xiaweiyi0423/me5412-bedexit-proposal/presentation/video/panels/R6.jpg

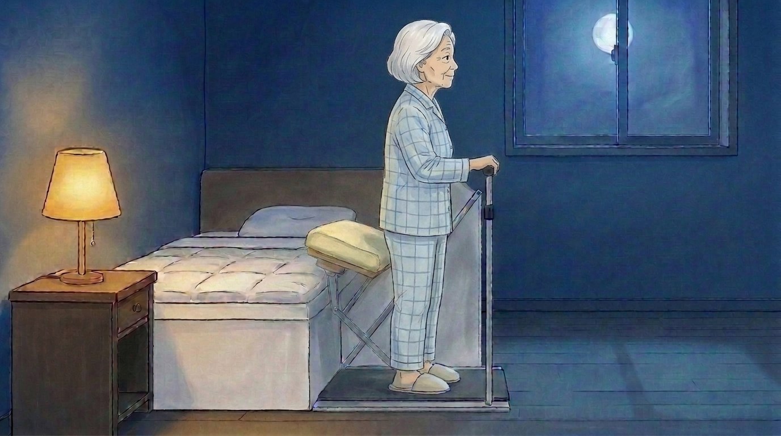
presentation/video/panels/R6.jpg
