xiaweiyi0423/me5412-bedexit-proposal/presentation/video/panels/S9a.jpg

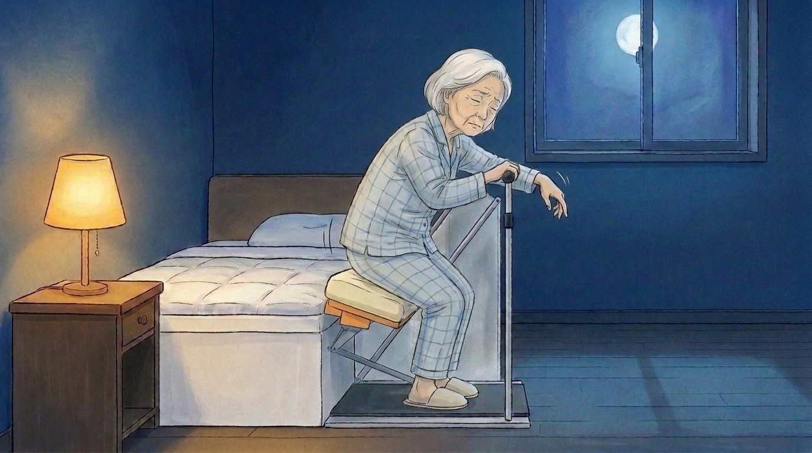
presentation/video/panels/S9a.jpg
