xiaweiyi0423/me5412-bedexit-proposal/README.md

# ME5412 Robotics for Healthcare：夜间床边起身辅助（小组 proposal）

问题：住在家里、还能独立生活但腿部力量下降的老人，夜里从床沿坐→站→站稳→第一步这一段容易出事。

目标用户：从普通高度的床（约 0.42 m）站起来困难或不安全，但从更高的座面、手有扶的地方能站起来；能独立行走或借助助行器行走；能独立坐在床沿、握住扶手、操作按住式开关。不适用于需要完全协助转移的人和中重度认知障碍的人。设计工况：60 kg、1.60 m。

两个候选方案：

- **方案甲 · 动态扶手**：装在床上，平时当床栏；坐到床沿后轻推，扶手转到工作角度，承重时锁死。只作为对照。
- **方案乙 · 床边起身台（已定）**：床不改造，台架和床固定（床垫下钩板或床腿夹）。老人坐在床沿、脚踩台架踏板，往前挪到与床齐平的短座板上；握紧横杆握把上的“起”开关后，座板**竖直**升到 0.66 m，L 形扶手随座板升高。
  - 速度跟着人走：速度 = k ×（推力上限 − 座板测到的力），封顶为个人最快速度。推力上限约为体重的一半，人要自己承担一部分体重。
  - 松手或出现任何故障，立即停住并制动；只有确认有人坐着才下降；离座后座板停在原高度、保持水平，万一坐回去能接住人。
  - 座板、踏板下各 4 个测力单元（压力中心），横杆测力；各传感器的竖直力之和与体重对不上就锁住。

核心模型结论（2D 准静态坐→站线性规划，effort = 最吃力关节用掉的力量比例；范围覆盖四种手臂假设和两种脚下空间假设）：

| 情形 | 结果 |
|---|---|
| 起身台升到 0.66 m vs 抬高床（0.58 m）+ 扶手 | 低 13–20% |
| 起身台升到 0.66 m vs 低床（0.42 m）撑床垫 | 低 26–40% |
| 不用手：0.66 m vs 0.58 m | 低 16–22% |
| 起身台只升到 0.60 m vs 抬高床 | 差不多（−5% 到 +4%） |

“脚下空间”指脚跟至少在髋前多远：`compare_v11` 对起身台用 8 cm、对床用 10 cm（17–20%）；`heel_sensitivity_v12` 把起身台也改成 10 cm（13–16%）。

所以起身台存在的理由是：只在起身那一刻，升到固定床设不到的高度。

## 第 12 版设计改动（2026-10-26）

- 取消座板前倾，改为竖直升降。一个推杆驱动的四连杆只有一个自由度，倾角由高度决定，做不到“离座后停在高处、座板水平”；而模型本来就没有计入前倾的好处，数字不变。
- 台架和床固定。不固定时，前后方向只能承受约 178 N（设计载荷 177 N，安全系数 1.0），扶手高位侧向约 129 N。人完全在台架上（坐在座板上、脚踩踏板）时，手上的力是内力；人的重心横向要偏出约 0.5 m 才会侧翻，而座板半宽只有约 0.22 m。载荷工况按安全系数 1.5 校核。
- 控制规则改为：松手即停、有人坐着才降，速度随座板卸载自适应，握把式开关（至少一只手）。
- 报告中的降幅写成范围（见上表）。

## 第 13 版（2026-10-26，按六角度审计修订）

审计报告在 `presentation/audit/`。这一版对方案的改动：

- **起步计算**（`model/calc_v13/seat_support.py`）：起身模型加入座板向上托人的力。推力上限 0.5 倍体重时，在 0.42 m 起步的 effort 为 0.155–0.166，低于在 0.66 m 离座的 0.233–0.251；上限 0.3 时起步反而更吃力，所以可设范围收窄到 0.4–0.6。座板托力为 0 时逐个高度复现 v12 结果。
- **目标人群按能力定义**：离座高度由用户能力决定（effort 0.25 的人约在 0.62–0.64 m 离座）；抬高床站不起来、起身台能站起来的人，effort 约 0.23–0.29（另一种手臂假设为 0.25–0.30）。
- **控制器 v13**（`model/calc_v13/controller_v13.py`）：力之和自检只在离开床面后的运动中做；取消空载复位，座板空着时留在原高度，回床时坐上去按“降”；坐在高处无操作 20 s 下降（17 s 提示音）；两柱高差 > 5 mm 锁定；最快速度 1.5–3 cm/s；“人已离开”改为座板 < 5% 体重且脚离开踏板。12 个场景，其中压床垫、迈下踏板两个场景在 v12 规则下误锁。
- **固定方式**：按 1112 N 设计，床架夹为主，床垫下钩板只定位。
- **13.1（Gemini 审计 v13 后，`page/v13/audit/`）**：起步省力的前提是上身基本坐直（前倾 ≥ 20° 时起步 effort 0.23–0.27，和离座差不多）；留出速度余量后推力上限改为 0.5–0.6；回床改为先按住“降”把空座板降到回床高度（默认床面）再坐；横杆按带正负号的竖直分力计入自检；“有人坐着”加迟滞（0.40 / 0.15 倍体重）；带人下降按住才动；两柱不同步时锁死；立柱移到 L 形扶手转角，开口一侧敞开。仿真 15 个场景。
- 方案网页 v13：`page/rise_station_v13.html`（新链接发布，由 `page/v13/build.py` 从 `page/v13/template.html` 生成）。

## 目录

```
page/
  bedexit_proposal.html   最终网页（单文件，直接用浏览器打开）
  build_v12.py            先运行 build_v11.py，再按第 12 版设计修改输出 → bedexit_proposal.html
  build_v11.py            读 v10_body.html + 模型数据 → bedexit_proposal.html、v11_body.html
  build_v10.py            上一版构建脚本（build_v11 会读取其中的 CSS 片段；它本身依赖 archive/v9_body.html）
  v10_body.html           build_v11 的输入
  v2_template.html, v3_extra.css   页面头部和样式
  archive/                更早的构建脚本、中间版本和截图脚本
model/
  model.py                坐→站准静态模型（scipy HiGHS 线性规划）
  compare_v11.py          低床 / 抬高床 / 方案甲 / 方案乙，四种手臂假设，按图纸几何 → compare_v11.json
  heel_sensitivity_v12.py 起身台也按床的脚下空间（脚跟在髋前 10 cm）重算 → heel_sensitivity_v12.json
  seat_height_v11.py      座高 0.40–0.70 m 扫描（横杆按设计位置）+ 敏感性 → seat_height_v11.json
  export_explorer_v10.py  方案甲扶手位置热力图数据 → explorer_v10.json
  tipping_v11.py          台架不固定时的倾翻：设计载荷 177 N → tipping_v11.json
  calc_v12/               第 12 版设计的计算起点（英文图，可直接放进 slides）
    lift_sizing.py        座板下空间、几种机构（剪叉水平推 / 剪叉斜推 / 单节推杆 / 双三节升降柱）的推杆力和行程
    stability.py          人完全在台架上时各姿态的合重心；人部分离开时拉扶手的承载力和固定件压紧力
    controller_sim.py     状态机 + 速度规则 v = k(F_cap − F_seat)，8 个场景仿真；用 graphviz 自动画状态图
  compare_v10.py, seat_height_v10.py, tipping_v10.py   上一版（扶手位置自由优化）
  archive/                更早的脚本和结果（含已弃用的“手上最多 10% 体重”假设）
docs/
  prior-art-bed-exit-assist.md   现有技术和文献检索
plan/
  plan.html               组内分工页（单文件，直接用浏览器打开）：每个角色要说明什么、建议做法、资料、示意图
  figs.py                 生成分工页里的示意图（侧视图、受力图、执行器、倾翻）→ figs.json；图已嵌入 plan.html
```

注意：`compare_v11.json` 里的键 `none57` 实际是 0.58 m 的床（`int(0.58*100)` 等于 57）。

## 复现

```bash
pip install numpy scipy
cd model
python compare_v11.py         # 约 2 分钟，多进程
python heel_sensitivity_v12.py
python seat_height_v11.py
python export_explorer_v10.py
python tipping_v11.py
cd calc_v12 && python lift_sizing.py && python stability.py && python controller_sim.py && cd ..
cd ../page
python build_v12.py           # 生成 bedexit_proposal.html
```

## 模型的主要假设与局限

- 2D 侧视、准静态，只分析离座那一瞬间；受试者模型为 60 kg、1.60 m，关节力量是假设值。
- “手臂弱”用四种方式表示：手力上限 25% 体重（以 Schultz/Alexander 1992 的实测为锚）、肩肘力量只剩 50%、只剩 35%、手臂正常（手力上限 30% 体重）。
- 床垫按刚性计算，对两种床的基线有利。
- 结果对脚下空间的假设敏感（见上表）。
- 没有包括起身的动态过程、往前挪 25–30 cm 的代价，以及阈值的实测校准；这些列入局限与后续工作。本项目只做概念、设计和仿真，不做实物和实验。

截至 2026-10-26。
