xiaweiyi0423/me5412-bedexit-proposal/presentation/audit/audit_report.md

# 汇报 slides 和讲稿审计报告（Gemini 4 六角度 + Claude 复核）

审计对象：`presentation/slides/*.html`（21 页 slides 和讲稿备注）、`presentation/tools/talk_guide.html`（讲稿指南）。日期 2026-10-26，10/27 见老师之前。

## 结论

1. 整体结构、叙事和数字出处都扎实：六个角度都认为主线清楚；脚本核对的 20 多个数字和模型输出一致（见 `consistency_check.md`）。
2. 最大的问题不在“没做完”，而在**各角色的拼接处**：控制规则、传感自检、起身模型和使用流程各自成立，放在一起有几处互相矛盾。最严重的两处会被懂行的人直接问住：
   - **“力之和对不上就锁住”在正常使用中会误触发。** 座板只有 14 cm 深，人刚坐上时大腿压在床垫上；站起后一只脚还在踏板上时，力之和也只有约半个体重。按代码，这两种情况都会锁住。
   - **“0.66 m 才是价值所在”这条论证缺了一环。** 速度规则要求人先把座板力降到 0.5 倍体重以下座板才会升，这一步在 0.42 m 有多吃力没有算过；而仿真里的正常用户在 0.61 m 就离座了，第 7 页又说 0.60 m 和抬高床差不多。
3. 使用流程只讲了“起床”这一半：**站起后怎么走出台架、助行器放哪、回来怎么上床**都没讲，第 13 页的文字和状态机图在这里还互相矛盾。
4. 老师邮件里点名要的 **CAD 模型和运动动画**还没有，而讲稿指南的“时间紧版本”把第 9 页运动演示删掉了。

## 怎么读这份报告

- 每条问题标了来源角度（A–F，见文末）和**核实结果**：
  - **已核实**：回到 slides 原文、代码或模型输出确认成立。
  - **部分成立**：问题存在，但 Gemini 的说法有夸大或细节错误，已注明。
  - **未核实**：合理，但需要组里判断或查资料。
- Gemini 的原始输出在 `gemini_<角度>.md`，被驳回的意见见文末。

---

## 一、10/27 见老师前（明天）值得做的事

这些不需要改计算，只需要改几句话或准备回答。

| # | 做什么 | 为什么 |
|---|---|---|
| 1 | 第 13 页“有人坐着才降”卡片：删掉“座板上没人时不动”，改成“人离开台架 5 s 后空载慢慢降回床面；途中有人踩上就停”。 | 现在的文字和同页状态机图（`STANDING_HOLD → RESET_EMPTY`）直接矛盾。**已核实**（E3、B4、D、F3）。 |
| 2 | 第 21 页加一问：“回床和走出台架的流程，需要在主 slides 里讲吗？” | 这是六个角度里被提到最多的空白（见二-4、二-5）。先问老师要不要讲、讲到什么程度，免得在 11/3 前被追问。 |
| 3 | 第 21 页第 4 问拆开，先问**正式展示时长**。 | 19 页、约 16 分钟只是组里自定的目标；5 人交接和动画播放还要 1–2 分钟（E6）。时长决定后面删哪些页。 |
| 4 | 第 21 页的问法从“够不够？”改成“我们计划这周补 X 和 Y，作为终稿是否符合您的预期？” | 开放式的“够不够”容易让老师顺口加活，最后一周加活风险大（E7）。属于建议，**未核实**。 |
| 5 | 准备“t = 0 握紧开关时座板怎么开始动”的回答（见二-2）。 | Gemini 扮演老师时把它列为最想问的 3 个问题之一（D）。 |

---

## 二、11/3 前最该改的 10 项（按严重度）

### 1. 【高】“各力之和与体重对不上就锁住”会在正常使用中误锁 — 已核实

- **来源**：A5、B2、C4、D3、F1（五个角度都提到），加代码核实。
- **机制**：`controller_sim.py` 里，只要座板上有人或踏板受力超过 0.3 倍体重，就检查“座板 + 踏板 + 横杆”的竖直力之和，偏离体重超过 15% 就进入 LOCKED。实际使用中至少有两个时刻这个和必然对不上：
  - 刚坐上时：座板只有 14 cm 深（`lift_sizing.py` 的 `SEAT_DEPTH = 0.14`），大腿和部分臀部还压在床垫上，这部分重量不经过任何传感器。
  - 站起后迈步时：一只脚已经踩在地上、一只脚还在踏板上，踏板受力约半个体重，仍超过 0.3 的门槛，检查继续生效，和只有约 0.5 倍体重。
- **为什么仿真没暴露**：仿真里 `F_feet = BW − F_seat − F_bar`，即假设体重全部落在台架上。
- **怎么改**：自检只在“座板已离开床面、人完全在台架上”的抬升阶段做；或者和“坐定时的基线”比较而不是和体重比较；加持续时间过滤，避开坐回时的冲击峰值。第 12、13 页的说法同步修改。

### 2. 【高】核心论证缺一环：起步要先卸掉多少体重、多吃力，没有算 — 部分成立

- **来源**：A1、B1、D2、F6，加一致性检查第 1 条。
- **机制**：速度规则 v = k ×（推力上限 − 座板力）意味着，只有座板力降到推力上限（0.5 倍体重）以下，座板才会升；如果 2 s 内降不下来，状态机停住（代码里的 `stall_t`）。仿真假设人坐着时座板承担约 0.8 倍体重（`controller_sim.py` 的 `s0 = 0.79`），按这个假设，人必须先在 0.42 m 把约 0.3 倍体重转到脚和手上。第 7 页的 effort 只算了“完全离座那一刻”，没算这一步。
- **它和 0.61 m 的问题连在一起**：同一条规则让人能站起时座板就停住，所以座板升多高取决于人在哪里能离座。仿真里的正常用户在 0.61 m 就离座了（`controller_sim.json`），而第 7 页说 0.60 m 的省力和抬高床差不多。仿真的用户模型是假设的，不能证明真实用户在 0.61 m 离座，但这两页放在一起，提问者一眼就能连起来。
- **Gemini 说过头的地方**：B 和 D 称之为“启动死锁”，B 还说“能卸掉一半体重就不需要这台机器”。这不对：坐着把一部分重量移到脚上，比完全离座容易得多（0.42 m 完全离座的 effort 是 0.39）。真正的问题是**没算过**，不是**一定不行**。
- **怎么改**：
  1. 用现有 2D 起身模型加一个约束“座板最多承担 0.5 倍体重”，算 0.42 m 到 0.66 m 各高度下的 effort。这是成本最低、信息量最大的一步：如果整段都不高于 0.23，论证就闭环了；如果起步段更吃力，就要改推力上限的设定（例如起步段允许更高）。
  2. 第 7 页或第 18 页把 13–20% 说成“升到 0.66 m 时”的收益，并说明实际收益取决于离座高度。
  3. 讲稿指南补上“t = 0 时座板怎么开始动”的回答。

### 3. 【高】只讲了起床，没讲回床 — 已核实

- **来源**：B4、C2、D（最想问的问题 1）、E3、F3。
- **事实**：第 6 页“一次完整的使用”在“站稳”就结束。状态机里人离开台架 5 s 后座板空载降回床面（`RESET_EMPTY`）。从洗手间回来时，人面对的是一块 0.42 m 高、14 cm 深的窄座板和一个 0.66 × 0.80 m 的台架。是绕开台架上床，还是坐上座板再往后挪回床上，slides 里没有交代。
- **怎么改**：第 6 页加第 6 步“回床”，或在讲稿指南里准备回答。C 角度提了一个值得考虑的方案：人离开时座板留在高位，回来时坐上高座板（省膝盖的力），再按“降”回到床面。但这和“空载复位”以及夜里走动时的绊倒风险有取舍，需要组里决定。**未核实**哪种更好。

### 4. 【高】站起后怎么走出台架、助行器放哪 — 已核实

- **来源**：C1、E2，加 `stability_top.png` 俯视图核实。
- **事实**：俯视图里 L 形扶手沿一侧（y = −0.28 m）和身前（x ≈ 0.69 m，从 y = −0.28 延伸到 +0.13 m）布置。人站在中间时，正前方被横杆挡住，只能往开口一侧斜着或横着走出去，还要跨下踏板。第 4 页把“借助助行器行走”列为目标用户，但哪里放助行器、怎么从扶手换到助行器，没有讲。
- **说过头的地方**：C 说“三面封闭的笼子”。实际上开口一侧和前方开口一角都是敞开的，但动线确实别扭。
- **怎么改**：画一张俯视动线图（站起 → 从开口侧走出 → 助行器位置）。如果要改设计，可以考虑横杆可旋开，或开口侧加长。偏瘫用户的健侧在哪边、扶手能否左右对调安装（F4④），也可以在同一张图里交代。

### 5. 【高】CAD 模型和运动动画缺失；“时间紧版本”删了第 9 页 — 已核实

- **来源**：D1、E2。
- **事实**：老师邮件第 4 条要求“展示 CAD 模型和运动动画”。现在所有配图都是 2D 侧视示意图，第 9 页是待补。`build_guide2.py` 里的 `SHORT` 列表不含 `motion`，也就是时间紧时第 9 页被删掉。
- **为什么重要**：这是老师唯一点名要“展示”的东西；而且没有 CAD，角色 4 的真实质量复核和 FEA 都没法做。
- **怎么改**：把第 9 页加回时间紧版本；时间紧时可以把第 6 页和第 9 页合成一页（用 CAD 动画讲五步）。封面或第 6 页放一张 3D 轴测图，让听众一开始就知道它长什么样（E2）。

### 6. 【中】固定方式口径不一：床垫下钩板，还是 2 kN 的床腿夹 — 已核实

- **来源**：B6、D4、F4②。
- **事实**：第 6 页写“床垫下的钩板或床腿夹”；第 11 页正文说压紧力 90–180 N 就到安全系数 1.5，同页小字又说按 ADA 扶手标准 1112 N 设计时固定件要约 2 kN、需要床腿夹。两个设计载荷都出现了，但没说按哪个设计。
- **怎么改**：在第 11 页写明设计载荷选哪个、为什么，并据此定固定方式。如果按 ADA 的 1112 N，钩板就不够（靠床垫自重压住的钩板能提供的力远小于 2 kN，这一点是推断，未计算）。

### 7. 【中】图里的字太小，第 10 页“每根”和“两根合计”对不上 — 已核实

- **来源**：E1、E5、D5，截图核实。
- **事实**：第 13 页状态机图的转移条件、第 14 页 8 个小图的坐标轴，在 1920×1080 截图里只有十来个像素高，投影后后排看不清。讲稿指南只标了第 10、14 页要重画，漏了第 11、13 页。第 10 页文字说“每根推约 0.23 kN”，图里绿线画的是两根合计（约 0.45 kN），图例小字写着 `total of both`。
- **怎么改**：第 13 页重画成只含核心状态的大字版，完整转移表放附录；第 14 页主 slide 只放 2–3 个典型场景，8 个放附录；第 10 页图改成单根力，或在讲稿里说明。

### 8. 【中】第 7 页的图和讲稿对不上 — 已核实

- **来源**：E4、A3、F2。
- **事实**：标题写“四种起身方式”，图里有 5 根柱子；第 5 根“起身台，脚下空间按床算 0.24”讲稿没提。“动态扶手（组里最初的方案）”在第 7 页之前从没介绍过。
- **深一层的问题（部分成立）**：起身台 0.23 用的是“脚跟在髋前 8 cm”，床用的是 10 cm。A 和 F 质疑：座板下有升降柱，第 15 页还要用裙板封住座板下方，起身台的脚下空间凭什么比床更好？这需要一张尺寸图回答。如果答不出，主 slide 用两边都按 10 cm 算的结果（13–16%）更稳。
- **怎么改**：主 slide 删掉第 5 根柱子或在讲稿里一句话解释；“动态扶手”加一个半句话的注释；8 cm 的依据放附录。

### 9. 【中】速度和推力上限的数字口径 — 已核实

- **来源**：一致性检查第 3 条和小不一致表、D2。
- **事实**：
  - 第 14 页个人最快速度“1.5–4 cm/s”，但讲稿指南引用的推杆空载速度只有约 3.26 cm/s，带人更慢。4 cm/s 做不到。
  - 推力上限：第 4 页“约半个体重”，第 10 页选型按 0.6 倍，第 14 页可设 0.3–0.6 倍，仿真用 0.5 倍。
  - 讲稿指南说“每根实际负载约 300 N”，第 10 页是 0.23 kN。
- **怎么改**：速度上限改成不超过 3 cm/s（或换更快的柱型）；统一写成“默认 0.5 倍体重，可设 0.3–0.6 倍，选型按 0.6 倍校核”。

### 10. 【中】有人坐在高处时“10 s 没操作就自动下降”，和“按住才动”的原则要讲清楚 — 部分成立

- **来源**：B3、F7。
- **事实**：代码里这条只在座板升高时生效（`self.h > H0`），所以第 6 页“握住握把，想坐多久都行”（在床面高度）并不矛盾，F 说的冲突不成立。但是：人升到一半头晕、松手停住，10 s 后座板会在没有指令的情况下带人下降。这是有意的安全设计（晕倒时把人降低），还是违反“按住才动”的非预期运动，两种看法都说得通。
- **怎么改**：在第 13 页说明为什么这样设计，并考虑加提示音、延长等待时间。状态机图上把条件写成 `seat raised + 10 s no input`，免得被误读。

### 其他值得处理的（中、低）

| 问题 | 来源 | 核实 | 建议 |
|---|---|---|---|
| 往前挪 25–30 cm 和“防滑座面、低挡边”互相掣肘；现在的回答“这是最大的不确定”太被动 | A2、C3、F4① | 部分成立 | 讲清挪动时手扶哪里借力；不要编造座板尺寸来缩短挪动距离（见驳回意见） |
| 两根升降柱不同步时怎么检测、怎么停，风险页没有 | B5、F4③ | 未核实 | 风险页或第 8 页加一句“同步偏差超过阈值即停” |
| 中文转英文后文字会变长，19 页放不下；英文版要删掉所有“待补”和第 21 页 | D5、E6、E7 | 合理推断 | 先定时长，再决定删哪些页 |
| 按住开关可能要持续 8–25 s（仿真慢速用户 25 s 才离座），握力弱的手会累；状态灯在握把上会被手挡住 | C5 | 部分成立（时长来自仿真） | 考虑整个握把感应，状态灯移到视线内 |
| 第 14 页没提已有的加速度限制 | F5 | 部分成立：代码里有 `a_max = 0.05 m/s²`，但没有力信号滤波 | 讲稿里补半句 |
| 0.66 m 是按 1.60 m 身高定的；最高高度也可以按人设定 | A4 | 未核实（Gemini 给的人体尺寸未核对） | 第 14 页的“个人设置”里加一项最高高度 |
| LOCKED 状态允许慢速下降，不检查是否有人坐着，和“有人坐着才降”不完全一致 | Claude 读代码发现 | 已核实 | 第 13 页注明“锁定时只允许按住‘降’慢速下降” |

---

## 三、六个角度各自最突出的发现

| 角度 | 视角 | 最突出的发现 | 原文 |
|---|---|---|---|
| A 核心论证 | 坐→站生物力学审稿人 | 起步段的 effort 没算；脚下空间 8 cm 的假设和机构布置冲突 | `gemini_A_argument.md` |
| B 安全与故障 | 医疗设备安全评审员 | 自检误锁；有人时自动下降；两柱不同步没有对策 | `gemini_B_safety.md` |
| C 真实使用 | 作业治疗师 | 站起后走不出去、助行器没地方放；回床流程缺失 | `gemini_C_real_use.md` |
| D 评分要求 | 任课老师 | CAD 和动画缺失且时间紧版本删了第 9 页；固定件载荷口径不一 | `gemini_D_grading.md` |
| E 现场可讲性 | 第一次听的同学和版面顾问 | 图字太小；第 7 页 5 根柱子和陌生词；第 10 页单根和合计对不上 | `gemini_E_delivery.md` |
| F 答辩拷问 | 最刁钻的提问者 | 逐条评估预备问答；回床、偏瘫健侧、同步方式的回答都偏弱 | `gemini_F_qa.md` |

六个角度之间有一处明显分歧：D（老师）说“第 7 页的模型完美支撑了为什么要升到 0.66 m”，A（审稿人）和 F 认为这条论证缺环。核对代码和仿真后，A 的判断更有依据（见二-2）。

---

## 四、被驳回或需要打折扣的 Gemini 意见

| 意见 | 来源 | 为什么不采纳 |
|---|---|---|
| “座板深约 22–25 cm，只需挪 10–15 cm”，建议把局限页改成 10–15 cm | F4① | 数字是编的：`lift_sizing.py` 里座板深 0.14 m。按这个建议改会引入错误 |
| “主 slides 19 页”算错了 | F7.1 | 没错：21 页去掉附录目录和问题页正好 19 页，讲稿指南合计 15.9 分钟 |
| “如果能在 0.42 m 卸掉一半体重，就根本不需要这台机器” | B1 | 坐着转移一部分重量和完全离座不是一回事；问题是没算，不是一定不行（见二-2） |
| “离开 5 s 后座板降下去，6 s 时头晕坐回会坐空” | B4、D、E3 | 空载复位要求踏板上也没人（人已经离开台架），下降途中有人踩上就停（`RESET_EMPTY → STOPPED`）。风险小；真正的问题是文字和图矛盾、回床流程没讲 |
| “控制律没有加速度限制，会一顿一顿” | F5 | 代码已有加速度限制；只是没有力信号滤波，且 slides 没写 |
| 第 19 页数字 1、2 指着火柴人的臀部和膝盖“看着滑稽” | E5 | 角色 2 负责人体起身模型，指向人体关节是有意的 |
| “配厂家同步控制盒（如 TC15P），偏差 < 2 mm” | F4③ | 型号和精度未经核实，用之前要查厂家资料 |
| D 对第 21 页四个问题的“回答” | D | 这是 Gemini 模拟老师的猜测，不代表老师的真实意见；明天以老师的回答为准 |
| “床垫 20–30 kg，钩板最多一两百牛” | B6 | 量级合理但没有计算；结论（钩板扛不住 2 kN）方向对，具体数字不要直接引用 |

---

## 五、方法和局限

- **模型**：`gemini-4-argon`（Gemini 4 Argon），通过会话代理调用。6 个角度各一次独立调用，输入相同，只有角色说明不同；提示词按要求写得开放，只给角色和关注方向，不列检查项。脚本：`run_audit.py`。
- **输入**：21 页 slides 的文字和讲稿备注、讲稿指南的要点/问答/待补（`build_bundle.py` 抽取）；每页 1920×1080 渲染截图（`render_slides.js`，缩到 1600×900 发送）；7 页带照片的 slides 另附讲稿指南里的真实缩略图；课程背景（老师 10/26 邮件要点、交付要求、README 设计摘要，见 `context.md`）。
- **局限**：
  - 截图里上传的配图（blob）用本地同名计算图替换；示意图和动画只能看到 560×315 的缩略图，所以对示意图细节（例如第 8 页立柱画法）的意见可信度较低。
  - 截图用文泉驿字体渲染，和实际的思源字体字宽略有差别，判断字号时只看量级。
  - Gemini 的意见都经过 Claude 回到原文和代码核对，但“未核实”的建议（设计取舍、产品型号）仍需组里判断。
  - 本次只审计，没有修改 slides 和讲稿。

## 复跑

```bash
SP=<任意临时目录>; mkdir -p $SP/img
python3 presentation/audit/build_bundle.py $SP
node presentation/audit/render_slides.js $SP
python3 presentation/audit/run_audit.py $SP            # 全部六个角度
python3 presentation/audit/run_audit.py $SP B_safety   # 只跑一个
```

模型较慢，单次调用可能要几分钟；脚本用流式接收，单次最长等 30 分钟，失败自动重试 6 次。
