xiaweiyi0423/me5412-bedexit-proposal/presentation/audit/v4/audit_report.md

# 第四轮 Gemini 审计：开放审计 + 针对性核查（2026-10-27）

## 做法

1. **开放审计。** 不给 Gemini 指定角度。它看到的材料包括：
   - slides、讲稿和讲稿指南；
   - 设计网页的文字；
   - 设计总结文档；
   - 产生数字的 13 个模型代码文件。

   同一提示独立跑三次，结果在 `gemini_open_1.md`、`gemini_open_2.md`、`gemini_open_3.md`。工具是 `../run_audit_open.py` 和 `../context_v4.md`。

2. **挑出重点。** 三次都提到、或经核实会改变设计的问题，作为重点。

3. **仔细审计。**
   - 先自己回到代码和数据核实；必要时写新的计算。
   - 再把新计算（`seat_1dof_cantilever3d.py`）和控制器改动单独交给 Gemini 做一次针对性核查（`gemini_focus.md`，工具 `../run_audit_focus.py`）。

## 重点问题和处理

| 问题（出现次数） | 核实 | 处理 |
|---|---|---|
| 单侧悬臂的滑块受力算法过于简化（3/3）；偏载力矩要先经过铰点 1（1/3） | 成立，而且第二点是关键。<br>旧 `forces()` 默认偏载力矩直接到了滑块板，也漏了导轨平面内的力。<br>按关节逐个列三维静力后：铰点 1 要传约 611 N·m 和 3.2 kN。如果它是普通销轴，连杆就要面外受弯，和否掉单侧四连杆的理由一样。 | 新写 `seat_1dof_cantilever3d.py`。<br>结论：铰点 1 用能承受力矩的轴承（薄型交叉滚子轴承，或穿过竖槽、相距约 14 cm 的双轴承），连杆两端用球铰。<br>滑块合力 3.8 kN（原 3.1 kN）。<br>四连杆对比改为和铰点 1 比：约 3 倍（原来写“8 倍”，比错了对象）。<br>改了：slides 选型页和机构页、讲稿、网页第 13 节和新增的第 16 节、CAD 尺寸表。 |
| 载荷只沿座面法向（针对性核查） | 成立。人竖直落到前倾的座板上、或在座板上蹭动，都有沿座面的力。 | 载荷方向加上竖直向下、法向 ± 0.3 倍沿座面，取最不利。<br>丝杠 1.77 → 2.0 kN，连杆 1.31 → 1.6 kN，制动器 ≥ 6.3 N·m。 |
| 悬臂刚度没校核（针对性核查） | 成立。悬臂约 54 cm，根部转 1.5° 外缘就下沉约 14 mm。 | FEA 待补里加变形目标（≤ 5 mm）和组合工况（猛坐 + 拉横杆）。 |
| 控制器没有实现“座板力下降要伴随踏板力上升才提速”（2/3） | 成立。文字（网页第 13 节、第二轮审计报告）写了，代码里只有踏板 ≥ 0.3 倍体重的门槛。人往后靠回床垫时，旧规则座板会升 8 cm。 | 实现：v = k·min(F_cap − F_seat, F_feet − (BW − F_cap) + 0.15 BW)。<br>新增场景“往后靠回床垫”：座板不动。其余场景结果不变。 |
| 自检 15% 会被座面摩擦和小腿、脚跟接触误触发，把人锁在半空（1/3，针对性核查） | 成立。摩擦能让和偏差到座板力的 (1 − cos φ) + 0.5 sin φ，16° 时约 17%。 | 分级处理：15–35% 只限速并语音提示，第一档容差随座板力和倾角放宽；> 35% 才锁定。<br>带人下降时出现提示也减半速；踏板力先滤波。<br>16 个场景都落到安全状态。 |
| 应急拨杆“给家属用、老人等人来”说不通：控制器坏了，自动呼叫也没了（1/3） | 成立，是我们自己回答里的逻辑漏洞。 | 拨杆改到横杆与立柱拐角下方、带翻盖：坐着够得到，又不在握把下面。需要 CAD 和真人核对。 |
| 网页第 9、12 节和总结 5.2 节残留旧做法（握把旁拨杆、底座称重、空载复位、10 cm/s）（3/3） | 成立。第 9 节是交给 CAD 的清单，会误导。 | 第 9 节改成现行做法；第 12 节各行加“已改”标注；总结文档开头加阅读说明；代码注释同步改。 |
| 81 人体重都是 60 kg、关节力量相同（2/3） | 属实。 | 讲稿、网页第 16 节说明：个子之间的比较不可信。但 effort 是比值，同一个人在不同方案之间的比较不受体重缩放影响。 |
| 最吃力的时刻在放手那一下，分区坐垫不改变它（1/3） | 成立：放手 effort 中位 0.262、最差 0.362；托着那段最差约 0.26。 | 讲稿补上回答。 |
| “体重”用个人设置值：设错会让互锁失效或起步困难（针对性核查） | 成立。 | 讲稿、网页写明风险；建议每次离座站稳时用踏板 + 横杆核对体重，差得多就提示更新（未仿真）。 |
| 对照项“普通销轴时连杆侧向力”的算式错误（针对性核查） | 成立：原来是 \|Mx\| / Δz，Δz 趋近 0 时会发散。 | 改为力矩模长除以 x–z 平面距离（下限估计）：5.2 kN。 |

## 没有照做的

- **松手时也按加速度斜坡减速**（针对性核查）：松手即停是第一条安全规则；3 cm/s 下立即制动，冲击很小。
- **摔倒模型的座板后缘按倾角修正**（open_2）：影响约 0.6 cm，比臀部本身的尺寸小。
- **把控制仿真里手上的 60 N 改成 0.25 倍体重**（open_2）：仿真只用来检查规则的逻辑，不影响结论。
- **把滑块载荷乘 1.3–1.5 的弹性偏载系数写进计算**（针对性核查）：作为选型建议写在 CAD 尺寸表里，不改算法。
- **讲稿压缩、英文版、CAD、FEA**：都是已知的待补工作，留给 11/3 前。

## 产出

- 新计算：`model/calc_v13/seat_1dof_cantilever3d.py` → `seat_1dof/cantilever3d.json`
- 控制器：`model/calc_v13/controller_seat.py`（16 个场景）
- CAD 尺寸表：`model/calc_v13/seat_1dof_cad_sheet.py`、`cad/build_sheet.py` → `cad/cad_sheet.html`、`cad/travel_table.csv`、`cad/key_poses.csv`
- 网页第 16 节、slides（机构、选型、状态机、速度、风险、验证）、讲稿
