xiaweiyi0423/me5412-bedexit-proposal/page/seat1dof/audit/audit_report.md

# 单自由度坐板 · Gemini 审计综合报告

审计对象：`page/seat_1dof.html`（第四版），以及背后的 `model/calc_v13/seat_*.py`。
- 模型：gemini-4-argon，5 个角度：A 建模与推理、B 机构与结构、C 安全与人因、D 代码与数字、E 老师与答辩。原文在 `gemini_*.md`。
- 复核：Claude 逐条回到代码和网页核对，涉及数字的都用脚本重算。另外自查了两项：夹手间隙和抗倾翻。

## 结论

运动学这条链本身经得住检查：用户集 → 设计曲线 → 四连杆 → 81 人验证。几个看上去严重的代码指控，重算后都不改变结论。

真正的问题出在**机构接进整机以后**，有三件事需要先拍板，再改机构：

1. **放手时座板大多还是前倾的。** 81 人里 64 人放手时座板前倾超过 20°，中位数 24°，只有 5 人低于 15°。此时人往回坐，座面摩擦（布料对坐垫 μ ≈ 0.4–0.5，对应 22–27°）可能拉不住，人会顺坡下滑。单自由度机构的倾角由高度决定，自锁推杆只有 10–30 mm/s，跟不上 0.3–0.5 s 的跌坐。这正是 README 第 12 版改回竖直升降的理由。
2. **扶手怎么动没有定义。** 模型里扶手随髋竖直上升；但四连杆带不动一个竖直升降的扶手。
3. **两侧连杆和立板会挡住回床时腿的转动。** README 13.1 已定“开口一侧敞开”，现在两侧都有连杆，与之冲突。

## 前 10 项（按严重度）

| # | 问题 | 来源 | 复核 | 复核依据 | 处理 |
|---|---|---|---|---|---|
| 1 | 放手时座板仍前倾，坐回会顺坡下滑；“控制器迅速放平”在单自由度加自锁推杆上做不到；与 README 第 12 版冲突 | A3 C1 E1 B5 | 已核实，比 Gemini 说的更普遍 | 放手前倾：中位 24.2°，最大 26.7°，64/81 人 > 20°，76/81 人 > 15° | **需拍板**：把前倾上限压到约 15° 重新综合，或回到竖直升降，或前倾机构加坐回时能自动放平的被动铰；页面上的错误说法已删 |
| 2 | 扶手如何随机构运动未定义；模型按竖直升降的扶手计算 | B4 E7 | 已核实 | `bar_at(hz)` 按髋高竖直上移 | **需拍板**：扶手固定在底座（然后重算费力），或用连杆带动 |
| 3 | 两侧连杆、立板挡住回床时腿的横向转动；与 13.1“开口一侧敞开”冲突 | C3 | 已核实（几何推理） | 立板在 x 22–30 cm、高约 34 cm，在两腿外侧 | **需拍板**：连杆改单侧悬臂（另一侧敞开），或接受“先退回床面再转腿”的流程 |
| 4 | 横管穿过摇杆 A 所在平面，起始位置相撞 | B1 | 已核实 | 横管与摇杆 A 的侧视间隙 −0.1 cm；横管横跨 ±28.5 cm，摇杆 A 在 ±25.5 cm | 设计修改：摇杆 A、B 内外对调（B 在内侧，横管只跨 ±25.5 cm），或横管只连推杆一侧 |
| 5 | 夹手、剪切点：横管–座板底面最小 1.1 cm，横管–立柱 A 3.2 cm，两摇杆平面相距 3 cm，座板与床垫侧面 5 mm | C2 E5 + 自查 | 已核实 | 手指安全间隙一般取 ≥ 25 mm，手 ≥ 100 mm | 设计修改：座板下加整圈软护罩（裙边），护住摇杆、立板、推杆；座板刚性部分后移，与床留 ≥ 15 mm；能拉开的间隙拉到 ≥ 25 mm |
| 6 | 推杆推力计算只用了座板中心的力，漏了转动项；座板上两铰点只距 41 mm，铰点受力大，间隙会被放大成晃动 | B2 D1 | 已核实 | 载荷偏到前缘时推杆 3.6–3.8 kN（中心载荷 2.8 kN）；铰点最大 6.0 kN；0.2 mm 的销孔间隙会让座板晃约 0.6° | 设计修改：重新综合时限定两铰点间距 ≥ 80 mm；推杆按 ≥ 4 kN 静载选型；推力按偏心包络给出 |
| 7 | 座垫：60 kg 坐着下陷 3.9 cm，接近 5 cm 坐垫的压到底点（4 cm）；“空载要比床高 4 cm”的说法错 | B6 C5 C6 E2 | 已核实 | `sitdown`：中硬 38.5 mm；网页原文 | 文字已改为“空载与床垫齐平”；坐垫改 6–7 cm 或双密度，用 100 kg 复算 |
| 8 | 网页数字过时：前倾差写 9°（实为约 12°）、推杆上端写成“末端外侧 60 mm”（实为距 B 点 60% 处、偏置 −30 mm）、页脚数据来源、坐垫一节用的是旧连杆 | D2 D8 E4 | 已核实 | 网页源码和 JSON | 已修正；坐垫一节已用第四版连杆重算，推荐方案托不住 0/3 人，与其他章节一致 |
| 9 | 座板前倾时，座下测力单元测的是法向力，“各力竖直分量之和 = 体重”的自检要按倾角修正 | E3 | 已核实 | 倾角由推杆位置唯一确定 | 交给控制组：用推杆位置换算倾角，修正竖直分量；或把测力单元放在底座下 |
| 10 | “大腿近端 4 cm 最好”部分是模型 4 cm 硬分界造成的；凸圆弧座面“不如平座面”说得过头 | A1 A6 E6 | 部分成立 | 4 cm 点仍按推骨盆算且力臂最大；理想轨迹下圆弧座面 81/81 合格 | 文字已改：可靠的结论是“越靠近坐骨越好”；圆弧座面改为“在我们的综合方法下没找到更好的四连杆” |

其余被核实或部分成立、但不改变结论的问题：
- **横管弯矩。** 推杆在中点推 2.8 kN、跨 0.57 m 时弯矩约 404 N·m；Ø40×4 钢管约 109 MPa，要做校核。
- **推杆需要手动应急下降。** 自锁推杆断电后会停在原位，所以要带手动应急下降。另外，最不利处推杆每走 1.3 mm 髋才升 1 mm，推杆速度要按这个比例给。
- **腿的横向宽度。** 现在按臀宽估算，没有考虑膝外展；建议立板外扩到 |y| ≥ 0.30 m 并加软垫，再用老年人测量数据核对。
- **抗倾翻。** 扶手（x = 0.69 m）在底座前端（0.66 m）之外，100 kg 的人整个挂在扶手上时，压力中心离底座前端只剩 7 cm；侧推约 0.34 倍体重就会翻。底座前端建议伸到 ≥ 0.75 m；台架与床固定后风险更小。
- **体重和肌力不随身高缩放。** 1.75 m 用户费力偏高，部分来自这一点；已写入局限。
- **皮肤剪切。** 前滑的净值很小，但支撑全程皮肤累计受到的剪切位移中位数约 10 cm，最大 13.5 cm；建议坐垫表层用可滑动的面套。

## 被驳回的意见

| 意见 | 来源 | 复核 |
|---|---|---|
| 竖直方案只用了 12 cm 托腿范围、2 cm 前缘圆角，对比不公平 | A4 D3 | 给竖直方案同样的 18 cm 和 3 cm 后重算：23/81 合格，前滑 11.5 cm，坐回余量 −5.1 cm，费力中位 0.273。结论不变。 |
| 前滑指标先负后正会互相抵消，可能漏判 | D4 | 用“从最低点起算的最大反弹”重算：最大 1.8 cm，没有人超过 2 cm。指标定义确有漏洞，但这组结果不受影响；已在报告中补上累计剪切位移。 |
| 支撑过程中的费力可能高于放手时 | A4 | 按真实接触点和力方向重算：支撑段最大费力中位 0.237、最差 0.319，放手时是 0.251 / 0.331。 |
| “到顶回平 4.7° 能接住坐回的人”，应作为卖点 | A3 B7 | 只有放手发生在行程顶端的少数人能用上：81 人中只有 5 人放手时前倾 < 15°。 |
| 坐垫模型用人体轮廓弧长而不是座面长度积分，高估了接触 | D6 | 压缩区内两个表面近乎平行，差别在 cos(几度) 量级，可忽略。 |

## 方法与局限
- 输入：
  - 课程背景（含老师 10/26 要点）、设计总结、网页源码、8 个计算脚本、`model.py` 节选、结果 JSON 摘要；
  - 16 张截图：各节截图，机构在起身 0 / 35 / 70% 时的画面，以及三视图。
  - 每个角度约 13 万输入 token。
- 复核脚本（`audit/checks/`，在 `model/calc_v13` 目录下运行）：
  - `own_checks.py`：夹点间隙、抗倾翻；
  - `verify.py`：横管与摇杆 A、偏心推力和铰点受力、放手时前倾、前滑最大反弹、支撑段费力、推杆速度比、竖直方案公平对比。
  - `verify.json` 是 `verify.py` 的输出。
- Gemini 关于摩擦系数、推杆速度、组织压迫的数字属于常识量级，没有查证文献；结论只用了方向性判断。
