xiaweiyi0423/me5412-bedexit-proposal/docs/prior-art-bed-exit-assist.md

# 现有技术检索：床边起身辅助（2026-10-26，第五轮审计后更新）

检索范围：通过床或座面抬升帮人站起；与床结合的把手（含可移动、自动展开的把手）。来源包括产品页、专利和论文。除另有注明外，每条都打开原页核对过。

## 床 / 座面抬升

| 方案 | 类型 | 家用？ | 怎么帮人站起 | 自动 / 传感 | 来源 |
|---|---|---|---|---|---|
| France Bed 离床支援多姿态床（2020） | 产品（日本） | 是，居家护理 | 床变成椅子，坐在床沿时脚能踩实；「站立姿态」时座面抬起帮助站立 | 一键完成躺→站，没有提到传感。审计称日本护理保险租赁约 ¥1,650/月（10% 自付），「价格高」的说法要谨慎 | https://www.francebed.co.jp/release_pdf/marupoji_200522.pdf |
| EZ Lift Sleep-to-Stand Bed | 产品（美国，约 2,200 美元） | 是 | 一键把人「抬到接近站立」；具体机构未公开 | 遥控器，未提传感 | https://ezliftbed.com/products/ez-lift-sleep-to-stand-bed |
| **UpEasy Seat Assist（Carex）** | 产品，约 120 美元 | 是 | 气弹簧座垫，**不需要电、没有按钮**，老人开始起身时慢慢释放；厂商称提供「70% lift」；用于带扶手的椅子和沙发，页面没提床 | 纯机械，靠起身动作触发 | https://www.1800wheelchair.com/product/upeasy-seat-assist |
| Hill-Rom chair-egress 医院床 | 专利 | 否，医院 | 座面段绕脚端转轴把后端抬起（egress boost）；**没有扶手，也不判断患者状态** | 按钮或触摸屏 | US8640285 |
| 椅式床 + 可收起的站立支撑 | 专利 | 否，医院 | 椅式床两侧的支撑可手动或自动升起，顶端是把手 | 只写「可由传感器、监测电路电子控制」，没有具体规则 | US9265677 |
| **电动如厕抬升座** | 产品 / 专利 | 是 | 座面升高、后高前低倾斜；扶手随座面升并保持水平 | 开关或脚踏 | US6360382（Karding） |
| **家具旁抬升座（1997）** | 专利 | 是 | 放在椅子或沙发旁，人挪到座上，螺杆把座面升到站立高度；立柱带扶手，站起后可当助行器 | 手持开关 | US5619762（Mein）。**思路与方案乙最接近**（挪上去、抬起来、扶手在旁），但靠开关、没有互锁，不在床边 |
| 马桶旁抬升前倾座 | 专利 | 是 | 座面升高并快速前倾，带扶手 | 开关 | US8556347（Fu Burg, 2013） |
| 起身时床垫气囊充气 | 专利 | 否 | 气囊把人顶起 | — | US10238566 |
| Kreg 倾斜站立床 | 专利 | 否 | 整床倾斜约 75°，人从床尾站着离开 | 有限位开关和互锁 | US11458056 |
| 可充气抬升座垫（Mangar Raiser 等） | 产品 / 专利 | 是 | 座垫充气把人抬到站姿；1990 年的专利写明可用于床 | 手动开关；部分专利用压力传感判断「已站起」 | US4905329、US20140346836、US20170071805 |
| Wissner-Bosserhoff 把手控制床高 | 专利 | 医院 / 护理 | 用户坐在床沿，用把手上的开关升降床面 | 无源无线开关 | US10869795 |
| Panasonic 生活支援系统 | 专利 | 椅子 + 机器人 | 根据把手拉力，按比例控制座面前倾速度 | 把手测力、座面测力、相机 | US9962305 |
| **Panasonic 起身辅助系统** | 专利（2015 优先权） | 椅子 | 检测到把手受力后座面升高。实施例 2：要求「把手受力 + 座面受力下降」才升；实施例 7：座面前倾并前移；实施例 9：检测到身体动作就自动开始；实施例 17：把机器人换成测力手杖或肘托 | 把手测力、座面测力、动作传感 | https://patents.google.com/patent/US10022284 |

## 把手

| 方案 | 怎么动 | 来源 |
|---|---|---|
| HealthCraft SuperPole + SuperBar | 落地杆 + 横把手，可旋转，每 45° 自动锁定，「一根始终在你身前的扶手」 | https://www.1800wheelchair.com/product/superbar |
| HealthCraft Smart-Rail、Arcorail | 手动摆出 / 旋转后锁定 | 产品页（未打开核对） |
| Rehastage 床边助手 | 棘轮把手：人起身时可以向外摆、向内锁死，被动跟随；纯机械 | US10272005、EP3085348B1 |
| MIT Handle Anywhere | 机械臂按算出的位置摆放把手 | arXiv 2209.15169 |
| MIT E-BAR（2025） | 可移动的扶杆机器人，帮人坐下、站起，摔倒时弹出气囊 | https://news.mit.edu/2025/eldercare-robot-helps-people-sit-stand-catches-them-fall-0513 |
| KIT 移动把手（JNER 2026） | 起身过程中把手沿轨迹移动：髋部力矩降 >70%，膝部降 >50%，但手上竖直力最高达体重的 60%；受试者为 15 名年轻人 | https://publikationen.bibliothek.kit.edu/1000190346 |

## 老人床高与手力研究

| 研究 | 对象 | 结果 | 来源 |
|---|---|---|---|
| Merryweather et al. 2015, Work 52:707–713 | 12 名 56–90 岁老人（多数行动受限） | 离床（38 cm 对 58 cm 床）：髋部力矩 48.2 vs 27.5 N·m（p = 0.03，完成该分析的有 6 人）；**一半人不借助明显协助，无法从 38 cm 的床上站起**。上床（坐下）：**58 cm 也更省力**，髋部力矩 43.8 vs 58.3 N·m（p = 0.017）。作者认为最佳床高「尚未确定」。力矩为静态建模估算 | https://stacks.cdc.gov/view/cdc/231426/cdc_231426_DS1.pdf |
| Christman et al. 2015, Procedia Manufacturing 3:280–287 | 65 名有跌倒史的老人 | 床高设为小腿长度的 95% / 110% / 125%；起身行走用时：低床 6.3 s，中床 3.9 s，高床 3.7 s | https://stacks.cdc.gov/view/cdc/230760/cdc_230760_DS1.pdf |
| NCOA, Bedroom Safety Tips（2026） | 指南 | 建议床面离地 **20–23 in（0.51–0.58 m）**；经验法则：坐在床沿时脚平踩、膝约 90°；床太高脚踩不实，床太低站起费力 | https://www.ncoa.org/article/bedroom-safety-guide/ |
| Anderson, Boshier, Hanna 2012, Cochrane CD008931 | 1 项整群随机试验（18 个病房，22,036 名患者） | 低床对因跌倒受伤：RR 1.35（95% CI 0.68–2.68），无显著差别；两组因床导致的受伤都是 0；用上低床的不到一半，可能检验力不足 | https://www.cochrane.org/evidence/CD008931_interventions-designed-prevent-healthcare-bed-related-injuries-patients |
| Schultz, Alexander, Ashton-Miller 1992, J Biomech 25(12)（手力数据引自 Alexander 1991） | 11 名不用手站不起来的老年女性 | 双手合力峰值约 159 N（水平 129 N、竖直 82 N），并非严格在离座瞬间测得；**体重原文未报告** | https://deepblue.lib.umich.edu/bitstream/2027.42/29713/1/0000047.pdf |

## 需求侧

日本厚生劳动省 2021 年需求清单把「低成本、小型、简单的坐→站辅助装置」列为居家照护需求，痛点是「护理者无法配合被照护者的动作时机」。来源：https://www.mhlw.go.jp/kaigoseisansei/ns/needs/page/n0022.html

## 结论（第五轮审计后修正）

- **最强的对手是「抬高床」**：用床脚垫把床抬到 0.55–0.58 m，再装床边扶手，成本最低。本组模型显示：
  - 起身台如果只升到 0.60 m，和抬高床差不多（−5% 到 +4%）。
  - 起身台升到 0.66 m 时，比 0.58 m 的床再省 13–20%（四种手臂假设；下端是起身台也按床的脚下空间算），不用手时省 16–22%。
  - 所以起身台存在的理由是：**只在起身那一刻，升到固定床设不到的高度**。
- **「床太高不好」证据很弱**：
  - 坐着时脚要踩实：只有 NCOA 的经验法则和人体尺寸推算支持。
  - 滚下床时落差更大：0.42 → 0.58 m，落差多约 38%。这是物理推断，但低床能减少受伤并没有被证实（见 Cochrane 2012），而且滚下床主要见于认知受损的人。这一条只作次要理由：起身台让床整夜保持低位。
  - Merryweather 的数据里，58 cm 的床连上床都更省力。
- **不构成差别的点**：
  - 「不需要按按钮」：UpEasy 本身就靠起身动作触发。
  - 「握住 + 座面卸载才抬升」、座面前倾前移、不用机器人：Panasonic US10022284 都已出现。
  - 「按把手受力比例调速」：Panasonic US9962305 已出现；我们的“速度 = k ×（推力上限 − 座板测到的力）”要引用它。
  - 「挪上去、抬起来、扶手在旁」：US5619762（1997）已出现。
- **方案乙能诚实宣称的组合**：
  - 用在床边、不换床，只在起身时升到 0.66 m；
  - 台架和床固定，床本身不改；
  - 握把式开关 + 力分布互锁（座板、踏板压力中心，传感器之和与体重校验）；
  - 推力上限和自适应速度是同一条规则，不把人整个推起来；
  - 松手即停、只有确认有人坐着才下降；离座后座板停在原高度、保持水平，接住坐回的人。

## 第五轮补充（2026-10-26）：类似项目、标准、零件、工具

标 ✓ 的已打开原页核对；其他来自调研摘要，引用前请再核对。

### 类似项目

| 项目 | 做了什么 | 我们借鉴什么 | 来源 |
|---|---|---|---|
| Kogami 等，东京大学 ✓ | 辅助椅在臀下抬高座面 160 mm、约 2 s，两个气缸；座下 6 个压力传感器算压力中心，前移超过“静坐均值 + 10 × 标准差”（约 10 mm）就开始抬；3 名健康老人；作者承认抬升太慢，速度应能按人调整 | 压力中心前移作为第二个起身确认条件；评价指标；“速度因人自适应”的出处 | http://robot.t.u-tokyo.ac.jp/~yamashita/paper/B/B233Final.pdf |
| Xin、An、Kurazume，九州大学 2021 | 座面压力中心换算成目标推力，测力反馈控制推臀单元 | “由座面力决定助力”的先例（日文，系数不一致，只借思路） | https://robotics.ait.kyushu-u.ac.jp/kurazume/papers/ROBOMECH21-6.pdf |
| Chugo & Takase | 起身分 4 阶段，抬升阶段力控制、其余位置控制；输出饱和；蜗轮自锁 | 分阶段状态机、力上限、断电自锁 | https://www.intechopen.com/chapters/8624 |
| SEALE，底特律仁慈大学 2010 | 5 名研究生；按住电容传感器才动；限位开关；自锁蜗轮电机 | 安全需求页的结构 | https://asee-ncs.org/wp-content/uploads/2021/12/proceedings/2010/papers/144.pdf |
| UConn 2020 ME Team 26 马桶升降座 | 推杆 + 气弹簧；ANSYS；应变片多工况 | 需求清单和多工况校核的结构 | https://seniordesignday.engr.uconn.edu/seniorprojectpt/senior-design-2020-me-team-26/ |

### 可引用的标准和数字

| 来源 | 数字 | 来源 |
|---|---|---|
| ADA 2010 §609 扶手 | 任意方向 1112 N（250 lbf）；管径 32–51 mm | https://www.corada.com/documents/2010ADAStandards/609 |
| ISO 10535 移位机测试报告 | 全部按住才动；停止距离 < 10 mm；前后 10°、侧向 5° 不倾覆；150% 额定负载 20 min；带载上升约 36 mm/s | https://hmi-basen.dk/en/blobs/testrapporter/71846_9.pdf |
| IEC 60601-2-52 护理床测试报告 | 侧边 2200 N；力矩最大处、≤ 1 m 高度向下 1100 N 不倾覆；2 × 额定负载 1 min | https://hmi-basen.dk/blobs/testrapporter/117460_28.pdf |
| ISO 17966 / EN 12182 | 座面 1.5 × 体重；扶手 950 N；脚托 1200 N；静载 = 额定 × 1.5 | https://www.hmi-basen.dk/blobs/testrapporter/113520_58.pdf |
| Wilson & Nicol | 起身开始约 80% 体重在座面，离座时降到 0 | https://strathprints.strath.ac.uk/8363/1/0217.pdf |
| 同类产品抬升用时 | 马桶升降座 15–20 s；跌倒起身椅 20–30 s | 见调研摘要 |

### 零件

| 零件 | 参数 | 来源 |
|---|---|---|
| TiMOTION TL8 三节升降柱 ✓ | 2000 N；满载 9.6 mm/s、空载 32.6 mm/s；行程 250–750 mm；缩回 ≥ 行程/2 + 150 mm；Ø124 mm；弯矩动态 500 N·m、静态 1000 N·m；只能成对使用 | https://www.timotion.com/en/products/lifting-columns/tl8-series |
| TiMOTION TA6 升降椅推杆 | 6000 N；缩回 ≥ 行程 + 163 mm；占空比 10%；自锁、安全螺母；UL962 | https://mmintercom.com/upload/publish/277/TIMOTION%20DataSheet_TA6-AG.pdf |
| 剪叉推力 | F = W / tanθ；剪叉角 < 15° 不实用 | https://www.firgelliauto.com/blogs/engineering-calculators/scissor-lift-force-calculator-actuator-sizing |

### 结论更新

- 座板下折叠后约 0.30 m 高：单节推杆放不下；两根三节升降柱（如 TL8，缩回约 0.275 m）放得下且推力不放大，建议为主方案；剪叉作对比（齐平附近推杆力放大约 3–4 倍）。
- 稳定性载荷可直接引用 ADA 1112 N、ISO 17966 / EN 12182 的 1.5 × 体重；按 1112 N 设计时必须和床固定（床腿夹）。
