xiaweiyi0423/me5412-bedexit-proposal/model/calc_v13/seat_1dof_summary.md

# 单自由度坐板设计（轨迹规划 → 助力位置 → 坐垫位置 → 机构）

> **怎么读这份文档。** 本文按时间顺序记录第一版到 5.6 版的演进，前面各节是当时的结论，有些已被后面推翻（例如双曲线导轨、30° 前倾、握把旁的拨杆、底座称重、空载复位）。**当前方案以文末 5.2–5.7 节为准**，最新的数字见 5.6–5.7 节和设计网页第 15–16 节。

网页：`page/seat_1dof.html`（由 `page/seat1dof/build.py` 生成）。计算：`seat_1dof_design.py` → `seat_1dof/design.json`。

## 流程与结果

1. **用户集**：81 人 = 身高 1.50/1.60/1.75 m × 臀部厚度 7/9/11 cm × 起身习惯（髋早/匀速/晚前移）× 脚位 25/29/33 cm；驼背（躯干 ≥30°）只在放手点复算费力。
2. **姿势轨迹**：每人髋从床沿前 10 cm 走到踝上方。到髋高 0.70 m 时，髋早前移的人已在 20 cm 以外，竖直坐板（前缘 14 cm）跟不上。
3. **助力位置**：在 1.60 m、一般体型的用户里比较 5 个点，起身 30% 时的费力：
   - 大腿近端 4 cm（臀腿交界）：0.200，最好；
   - 臀部后下方：0.245；
   - 大腿 10 cm：0.225；
   - 不推：0.334。
   结论依赖一个模型假设：交界 4 cm 内的力算作推在骨盆上。
4. **坐垫位置**：每人的理想坐板跟着大腿走，前倾不超过 30°。用 18 位“髋早前移”的候选人各自的曲线去服务全部 81 人，选中曲线来自 H1.50 r0.09 p0.6 xa0.33。三次多项式平滑后，与原曲线的偏差为 2.8 mm / 1.07°。全程前移 14 cm、上升 21 cm、前倾 30.7°。前缘托腿垫覆盖大腿后侧约 18 cm。
5. **机构**：
   - 先试了四连杆：在床前、小腿后的空间内，最好的方案仍有 16 mm 的偏差，没有采用。
   - 采用**双曲线导轨**：坐板支架上两个滚轮，滚轮 1 在 [0.04, -0.06]、滚轮 2 在 [-0.04, -0.2]（坐板坐标，单位 m），各走一条侧板曲线槽，最小曲率半径 [0.083, 0.052] m。
   - 一个电动推杆从底座 [0.0, 0.04] 推滚轮 1：行程 218 mm，长度 334→552 mm。
   - 推杆力：起身（60 kg，坐板推 0.5 倍体重）285–436 N；静载（100 kg，1.5 倍体重）1138–1771 N。静载要靠自锁丝杠承受。
   - 槽的最大法向力 708 N。
6. **验证（81 人）**：

| | 新坐板 | 竖直升降 |
|---|---|---|
| 全部合格 | 80/81 | 24/81 |
| 最大前滑 | 2.1 cm | 11.3 cm |
| 最小坐回余量 | 0.4 cm | -5.3 cm |
| 放手费力 中位 / 最差 | 0.256 / 0.348 | 0.273 / 0.415 |

唯一不合格的是 1.50 m、偏胖、髋早前移、脚 33 cm 这一位：前滑 2.1 cm，只比 2 cm 的合格线多 0.1 cm。

## 局限

- 人体后侧轮廓按刚体处理，骨盆保持直立；骨盆与大腿的受力分界（4 cm）是估计值。
- 起身习惯只有 3 种，需要真实起身动作数据核对。
- 托腿垫的压强和舒适度没有验证。
- 前倾 30° 时人往回坐，要靠控制器放平座面。
- 静力学模型，不含冲击；杆件和槽按静载复核强度。

## 第二版：四连杆藏在座板下 + 坐垫刚度

脚本：`seat_1dof_fourbar.py` → `seat_1dof/fourbar.json`；`seat_cushion.py` → `seat_1dof/cushion.json`；`seat_1dof_page_data.py` → `seat_1dof/page.json`（网页数据）。

**四连杆重新判定为可行。** 上一版要求四连杆精确复刻理想曲线（位置和角度同时对上），所以判定不可行。这次改为：
- 合成时只要求座板中心走对路径，前倾角留一定余量；
- 合成后直接用 81 人的前滑、坐回余量、放手费力来检查。

平座面四连杆的结果：
- 中心路径误差 3.4 mm，前倾角最多差 9°；
- 81/81 合格，前滑最大 1.7 cm，坐回余量至少 +0.4 cm；
- 放手费力中位 0.251、最差 0.331，驼背时中位 0.258。

机构参数：
- 两个底座铰点 A (181, 261) mm、B (253, 282) mm，摇杆长 177 / 208 mm；
- 座板支架上两铰点在 (−26, −250)、(−1, −201) mm（座板坐标）；
- 电机装在 A，转 101.5°；起身时扭矩 44–68 N·m，100 kg 坐下静载时 180–277 N·m；
- 传动角 70–138°；
- 机构占用空间 x 0–25 cm、z 17–47 cm，全部在座板下方；
- 行程延长到 0.66 m（前倾在 0.6 m 左右达到 25°，到顶时回到 17°），多出的约 3 cm 用来补偿坐垫下陷。

**凸圆弧座面没有帮上忙。** 半径 40 / 25 / 18 cm 的圆弧座面，四连杆只能做到 74 / 68 / 78 人合格。原因是四连杆要追的目标变成了圆弧圆心的路径，这条路径比座板中心的路径更难追。

**坐垫刚度**（独立弹簧床模型；81 人 × 起身 15 / 35 / 55 / 70% 四个时刻；坐板推 0.5 倍体重）：
- 越软：峰值压强越低（硬 27 → 软 10 kPa）、合力越靠近骨盆，但下陷越深（1.4 → 6.3 cm）。下陷会吃掉行程，起身到 55% / 70% 时托不住的人数从 8 / 25 增加到 35 / 52；响应时间也从 0.19 s 变慢到 1.1 s。
- 推荐：中硬，约 6 kPa/cm、厚 5 cm，配合行程加到 0.66 m。起身时下陷 2.8 cm，峰值压强 17 kPa，响应时间 0.39 s，托不住的只剩 1 / 9 人。
- 对机构的两点要求：坐着时坐垫下陷约 4 cm，座板未受压时应比床面高出这么多；力跟随控制的增益按这个刚度来定。
- 局限：人体软组织按刚体处理，接触宽度固定为 24 cm；所以压强和下陷的绝对值只能用来比较不同坐垫，具体数值要用样件测。

## 第三版：连杆布置与动力源（`seat_1dof_fourbar2.py` → `seat_1dof/fourbar2.json`）

| 连杆布置 | 合格 | 轨迹误差 | 前倾误差 | 传动角最小 | 占用空间 | 离小腿（同一平面） |
|---|---|---|---|---|---|---|
| 收在起始座板正下方，支架 ≤ 12 cm | 59/81 | 54 mm | 36° | 1° | x −3–14，z 28–49 cm | +13 cm |
| 收在起始座板正下方，支架 ≤ 20 cm | 81/81 | 8 mm | 22° | 8°（接近死点） | x −5–14，z 22–49 cm | +15 cm |
| 支架向前伸 6 cm，支架 ≤ 12 cm | 58/81 | 47 mm | 29° | 11° | x −3–20，z 28–55 cm | +8 cm |
| 第二版（支架深 25 cm） | 81/81 | 3 mm | 9° | 70° | x 0–25，z 17–47 cm | +3 cm |
| 铰点在座板走过的范围内，支架 ≤ 20 cm | 81/81 | 4 mm | 10° | 92° | x −3–29，z 22–52 cm | −0.4 cm |
| **铰点在座板走过的范围内，支架 ≤ 15 cm（采用）** | 81/81 | 9 mm | 11° | 88° | x −3–30，z 27–56 cm | −0.8 cm |

**为什么收不进去。** 座板全程要前移 17 cm、上升 24 cm，摇杆转 70–100° 才能走完，所以摇杆至少约 20 cm 长。把底座铰点限制在起始座板的正下方，就会轨迹偏差大，或者接近死点。座板加长、让支架往前伸也没用，因为瓶颈在摇杆长度，不在座板上两个铰点的间距。

**采用的折中。** 底座铰点放在座板走过的范围内（床沿前 0–30 cm），起身时座板一直盖在连杆上方；支架从 25 cm 浅到 15 cm。
- 这样铰点会落在小腿的前后位置上，所以连杆必须两侧各一套，装在腿的外侧。
- 81 人验证：前滑 ≤ 1.7 cm，坐回余量 ≥ +0.7 cm，放手费力中位 0.251。
- 配中硬坐垫时，起身到 55% / 70% 托不住的分别是 1 / 8 人。

**动力源：两端带转动副的电动推杆**（丝杠式、可自锁、带位置反馈）。
- 不建议在铰点 A 装电机：100 kg 的人坐下时，A 点静载约 397 N·m，需要大速比、能自锁的减速器。
- 推杆装在两套连杆之间的中间平面：下端铰在底座 (125, 40) mm，上端铰在摇杆 B 末端外侧 60 mm 处，两侧摇杆用横管连成一体。
- 行程 209 mm，长度 343 → 552 mm。
- 推力：起身时（60 kg）297–684 N，100 kg 用户约是这个数的 1.7 倍；100 kg 的人坐下静载 1.2–2.8 kN。
- 离小腿最近 7.5 cm。

## 第四版：支撑结构、不进床体、干涉检查（`seat_1dof_layout.py` → `seat_1dof/layout.json`）

**发现的问题。** 第三版在起始位置，座板支架的后铰点位于 x = −2.7 cm、z = 27 cm，伸进了床体。

**新约束。** 床按实心块处理：x < 0 且 z < 0.42 m 的区域都是床。座板后缘 3.5 cm 的软唇边可以搭在床垫上，其余刚性零件全程不得进入床体。在这个约束下重新合成四连杆，结果如下：
- 几何：A (220, 315) mm，B (298, 308) mm；摇杆 200 / 244 mm；座板上两个铰点 (−29, −150)、(−2, −119) mm（座板坐标）。
- 性能：轨迹误差 10.5 mm，前倾误差 11.7°，传动角 64–140°；前倾最大 26.7°，到顶时回到 4.7°。
- 81 人全部合格：前滑 ≤ 1.8 cm，坐回余量 ≥ +0.6 cm，放手费力中位 0.251。配中硬坐垫时，起身到 55% / 70% 托不住的分别是 0 / 3 人。

**支撑结构。**
- 底座：两根贴地纵轨，y = ±0.27 m，x 从 3 cm 到 66 cm；后横梁在 x = 5 cm（推杆底座在这里），前横梁在 x = 66 cm；脚踏板在两轨之间。
- 立板：每侧一块，焊在纵轨上，承载 A、B 两个销轴。摇杆 A 在内侧平面 |y| = 25.5 cm，摇杆 B 在外侧平面 |y| = 28.5 cm。
- 座板支架：左右各一块。
- 推杆：在中间平面，下端铰在后横梁 (5, 5) cm，上端铰在一根连接左右两根摇杆 B 的横管上。行程 168 mm，长度 301 → 469 mm；推力起身时 0.42–0.69 kN（60 kg），静载 1.7–2.8 kN（100 kg，1.5 倍体重）。

**矢状面干涉检查**（全行程，81 人，取各自实际的座板位置）：

| 零件 | 对象 | 最小间隙 |
|---|---|---|
| 刚性零件 | 床、地面 | 0.5 cm（坐着时座板刚性部分与床垫侧面的设计间隙） |
| 推杆 | 床 | 2.0 cm |
| 推杆 | 小腿 / 脚 | 9.2 / 6.2 cm |
| 横管 | 大腿 / 小腿 / 脚 | 2.8 / 11.7 / 24.6 cm |
| 座板支架 | 小腿 / 脚 | 17.6 / 24.8 cm |

**三维说明**（见网页里的正视图和俯视图）：
- 摇杆和立板在腿的外侧。坐姿臀宽假设约为 0.235 × 身高（偏胖 +4 cm、偏瘦 −4 cm），座面以下的腿按外缘比臀宽每侧窄 2 cm 估算；对 1.60 m、一般体型的用户，腿外缘到内侧摇杆还有 7.2 cm。
- 摇杆和座板支架始终在座面以下至少 11 cm，比座板宽的臀部和大腿压不到它们。
- 推杆和横管在正视图上与腿重叠，但这只是投影：它们在腿的后方，侧视图中有上表所列的间隙。

**局限。**
- 横管离大腿只有 2.8 cm，余量偏小，需要在 CAD 里确认，必要时把横管下移。
- 腿的横向宽度是按臀宽估的假设，需要用人体测量数据核对。
- 床按实心块处理；床下有空间的床，限制会更宽松。

## 第五版：前倾上限 15°、固定扶手立杆、单侧斜导轨 + 倾角连杆（`seat_1dof_v5.py`、`seat_1dof_slider.py`、`seat_1dof_v5_checks.py` → `seat_1dof/{v5,slider,v5_checks}.json`）

起因是 Gemini 审计（`page/seat1dof/audit/`）指出第四版有三件事没定：放手时座板前倾中位 24°，往回坐会顺坡下滑；扶手怎么动没有定义；两侧连杆挡住回床转腿。

**三个决定**
1. 前倾上限 30° → 15°。往回坐不滑所需的摩擦系数从 tan 24° ≈ 0.45 降到 tan 15° ≈ 0.27。81 人仍全部合格。
2. 扶手固定在底座上，做成竖直立杆（x 0.69 m，可抓 0.75–1.10 m）。放手费力按立杆上最省力的抓握点计算：中位 0.233（第四版随动横杆 0.251），最差 0.340（第四版 0.331）。
3. 机构比较了三种（都约束座板上两铰点间距 ≥ 80 mm、刚性件离床 ≥ 1.5 cm、全程前倾 ≤ 16°）：

| 机构 | 合格 | 最大前滑 | 最小坐回余量 | 轨迹误差 | 驱动力（100 kg×1.5） | 回床转腿 |
|---|---|---|---|---|---|---|
| 中间平面四连杆 | 55/81 | +7.4 cm | −1.9 cm | 64 mm | 3.4 kN | 连杆与小腿同平面 |
| 两侧四连杆 | 81/81 | +1.9 cm | +1.2 cm | 14 mm | 3.7 kN | 两侧都被挡 |
| **单侧斜导轨 + 倾角连杆（采用）** | 81/81 | +1.9 cm | +2.1 cm | 6 mm | 1.8 kN | 床尾一侧敞开 |

**采用的机构**：座板支架上铰点 1 (8, −89) mm 装在滑块上，沿与竖直成 33.2° 的直导轨走（丝杠驱动，行程 290 mm）；铰点 2 (−23, −220) mm 用 361 mm 的连杆拉到底座铰点 B (393, 149) mm。座板中心前移 17 cm、上升 24 cm；前倾先增后减，最大 15.8°（座高约 0.55 m），到顶 5°。放手时前倾中位 15.1°。丝杠推力：起身 ≤ 442 N（60 kg）/ 665 N（100 kg），静载 ≤ 1776 N；连杆 1017 N；单侧悬臂扭矩 368 N·m。

**结构与安全检查**（`v5_checks.json`）
- 离床：导轨（含滑块余量）1.5 cm，连杆 1.5 cm，座板和支架 2.0 cm，后立柱 1.0 cm（要前移 0.5 cm）。支架离 81 人小腿、脚 ≥ 15.6 cm。
- 夹手点：连杆–前立柱、支架–立柱在侧视图交叉、横向间隔不足 25 mm → 固定护板 + 导轨风琴罩。
- 抗倾翻：底座 x 0.03–0.78 m，y −0.27（床尾）… +0.33 m（床头一侧侧梁外移，才托得住连杆铰点 B）。100 kg 全挂在立杆上侧向余量 12.9 cm；60 kg 的人在 1.06 m 高横推约 276 N 会翻。是否够用取决于和床是否相连。（更正：上一轮脚本把两个横推方向标反了，现已改正并改成不对称底座。）
- 应急下降：丝杠螺母手动快速释放。座板上每 N 压力沿导轨向下 0.6–1.14 N，全行程、任意受力位置都只会下沉；途中前倾 ≤ 15.8°。线性阻尼按 100 kg×1.5 限速 0.1 m/s 时，45 kg 轻坐要 23 s 才降完 → 用恒流（压力补偿）阀，约 2.9 s 全行程。只能手动复位；不做“跌坐自动触发”（正常坐下的载荷本来就最大，会误触发）。

**坐垫**（`CUSH_MECH=slider python3 seat_cushion.py`）：推荐中硬 6 kPa/cm、5 cm、行程到 0.66 m，起身 70% 时 4/81 托不住，下陷中位 3.4 cm，峰值压强中位 20 kPa。
网页第 5 步动画新增坐垫接触区（`seat_1dof_page_data_v5.py` 对每一帧求解：坐板沿机构曲线压坐垫直到 0.5 倍体重）：1411 个时刻中，接触长中位 12 cm（按 24 cm 宽约 290 cm²），峰值压强中位 18、最大 41 kPa；压强最高点中位在臀腿交界往膝 10 cm，只有 2% 的时刻落在骨盆段（≤ 4 cm）。即坐垫的力主要压在大腿近端，与第 3 步“推骨盆最好”的目标有差距；分区坐垫（后硬前软）是改善方向。

**还没收尾**：单侧悬臂（双导轨 / 宽滑块，支架刚度）；侧向稳定；两处剪切夹点护罩；后立柱前移 0.5 cm；恒流阻尼阀与释放手柄位置；15° 下防滑要样件实测摩擦系数。

### 5.1 分区坐垫（`seat_cushion_zoned.py` → `seat_1dof/cushion_zoned.json`）

问题：后硬前软的坐垫能不能把坐板的推力从大腿移到骨盆？同一坐垫模型（独立弹簧床、宽 24 cm、0.5 倍体重），斜导轨实际轨迹，81 人 × 起身 15/35/55/70%。费力按“骨盆段（臀腿交界 4 cm 内）的力帮髋和膝、大腿段的力只帮膝”拆开算（`seat_trajectory.effort` 新增分布载荷输入），手抓固定立杆；托不住的情况按导轨末端还能给的力算。

| 坐垫 | 骨盆段受力占比 15/35/55/70% | 费力 中位 / 最差 | 托不住 | 起身峰值压强 中位/最大 kPa | 坐着峰值压强 kPa |
|---|---|---|---|---|---|
| 均匀 6/6，5 cm（现推荐） | 29 / 2 / 0 / 0 % | 0.210 / 0.285 | 0/324 | 20 / 47 | 22.5 |
| 后 10 / 前 3，分界 -2 cm | 52 / 20 / 0 / 0 % | 0.202 / 0.263 | 1/324 | 16 / 33 | 22.8 |
| 后 15 / 前 2，分界 -2 cm | 67 / 36 / 0 / 0 % | 0.199 / 0.258 | 1/324 | 24 / 47 | 41.0 |
| 后 30 / 前 1，分界 -2 cm | 85 / 67 / 0 / 0 % | 0.187 / 0.284 | 1/324 | 41 / 62 | 76.0 |
| 后 15 / 前 2，分界 0 cm | 72 / 24 / 0 / 0 % | 0.192 / 0.250 | 1/324 | 26 / 47 | 44.5 |
| 后 15 / 前 2，分界 -2 cm，前区顶面低 1 cm | 76 / 48 / 0 / 0 % | 0.192 / 0.264 | 2/324 | 26 / 48 | 44.7 |
| 后 15 / 前 2，分界 -2 cm，前区顶面低 2 cm | 86 / 59 / 2 / 0 % | 0.185 / 0.275 | 3/324 | 29 / 47 | 49.2 |
| 后 15 / 前 2，分界 -2 cm，前区顶面低 3 cm | 95 / 70 / 4 / 0 % | 0.177 / 0.281 | 3/324 | 32 / 47 | 52.2 |

结论
- 前半程能移过去，后半程移不过去。起身中大腿倾角 24° → 35° → 46° → 53°，座板被 15° 上限限制在 12–16°，夹角 12° → 39°；后半程骨盆离开座面，刚度分区推不到它。要推必须让座板跟着大腿倾到 40–50°，与坐回安全冲突。
- 省力真实存在，且与“骨盆段”分界取 3 / 4 / 6 cm 无关（费力 0.184 / 0.185 / 0.183），推断来自压力中心后移、离膝更远，未单独验证。
- 软前区要多走行程：导轨末端加长 3 cm（`slider.json` 的 `rail_ext` 0.06 → 0.09，行程 324 mm，顶 0.688 m，末段后仰 −3.4°）。81/81 仍合格；丝杠静载 1.9 kN；应急下降线性阻尼下最慢 39 s（恒流阀仍必要）。不加长时激进方案 70% 时 19/81 托不住。
- 推荐：后 10 / 前 3 kPa/cm，分界在座板中心后 2 cm，后区厚 5 cm、前区厚 8 cm（骨架前区下沉 3 cm）。费力 0.210 → 0.202、最差 0.285 → 0.263，起身峰值压强 20 → 17 kPa，坐着峰值压强不变（23 kPa）。
- 样件可试：后 15 / 前 2，前区顶面再低 2 cm。费力中位 0.185，起身 15% 时 86% 的力在骨盆段；但坐着峰值压强 49 kPa（均匀坐垫 22.5 kPa），26 个情况比均匀坐垫费力（最多 +0.055，集中在 1.75 m、偏瘦、髋早前移、后半程），需压力垫实测。

## 第五版 5.2：第二轮 Gemini 审计后的修订（`page/seat1dof/audit/v5/`，网页第 12 节）

**说明：**下面的数字取代第五版正文和 5.1 中对应的数字。第五版正文里的行程 290 mm、末端 5°、丝杠 1.67 kN、立杆放手费力 0.233、恒流阻尼等，是当时的结果，保留作为记录。

**设计改动**
- **重新综合斜导轨**（`seat_1dof_slider.py`）：要求升到 0.69 m、末端前倾 0–8°。
  - 结果：铰点 c1 (8, -70) mm、c2 (-24, -182) mm，B (487, 126) mm，连杆 465 mm，导轨与竖直 34.1°，丝杠行程 331 mm；
  - 中心前移 18 cm、上升 27 cm，前倾 ≤ 15.7°，到顶 0.0°；轨迹误差 7.8 mm / 0.8°。
  - 5.1 的“外推旧导轨、末端后仰 −3.4°”弃用。
- **L 形固定扶手**（`seat_1dof_handrail.py`）：横杆在人正前方，握把开关在横杆上，双手从坐到放手只握一个点；求解时排除会让躯干或头碰到横杆的角度。
  - 在 x 0.40–0.70、z 0.80–1.05 的网格上选。规则：高度不超过 0.95 m（常见扶手高度）的位置里，放手费力中位最低者，得 x 0.70、z 0.95 m。
  - 不限高度时最优在 1.05 m，放手更省力约 0.02，但支撑阶段的最大费力上升。
- **机构箱**（`seat_1dof_v5_checks.py`）：床头一侧全封闭（y 0.25–0.36 m）。
  - 箱体侧板上装双导轨（相距 150 mm），每轨两个滑块（相距 150 mm）；滚珠丝杠在两轨之间，电机 + 失电制动器在上端；
  - 支架从毛刷竖槽伸出；两根立柱取消。
- **应急下降**：滚珠丝杠 + 失电制动 + 离心限速（约 0.1 m/s），拉握把旁的拉索拨杆即降，松手即停，不用复位；另配电池慢降。
- **其他**
  - 台架必须和床固定；
  - 座板几何带分区坐垫的前区下沉台阶；
  - 表层改高摩擦面料（μ ≥ 0.5），删掉“可滑动面套”；
  - 体重自检改用底座四角测力；
  - 空载复位（人离开后座板降回齐平）交给控制组。

**代码修正**（审计 D）
- `sitdown()` 按力平衡求解，压到底的刚度计入；
- 坐垫求解的热启动越过目标时从头搜；
- 法向按带台阶的顶面算；
- 托不住的样本按导轨末端状态计入全部统计；
- 丝杠推力计入 10 kg 座板；
- 网页中位数改为标准算法；
- 干涉检查改为逐帧。

**结果**

| 项目 | 结果 |
|---|---|
| 81 人，刚体接触 | 81/81，最大前滑 1.9 cm，最小坐回余量 2.1 cm；放手费力中位 0.272、最差 0.362；支撑中最差 0.26 |
| 81 人，坐垫压下后（推荐分区坐垫，新增一致性检查） | 81/81，最大前滑 1.9 cm，最小坐回余量 5.5 cm；放手原因：托腿垫边界 33、行程 1、走完 47 |
| 竖直升降，同一扶手同一规则 | 19/81，最大前滑 11.5 cm，最小坐回余量 -5.1 cm；放手费力中位 0.294 |
| 分区坐垫（费力中位 / 坐着峰值压强） | 均匀 0.229 / 22.4 kPa；推荐后 10 / 前 3 为 0.218 / 23.1 kPa；激进方案 0.202 / 48.8 kPa，不采用 |
| 丝杠推力 | 起身 ≤ 664 N（100 kg），静载 ≤ 1773 N |
| 悬臂（载荷偏向敞开一侧 10 cm） | 力矩 659 N·m，导轨间力偶 2465 N，滑块间 3639 N，每滑块约 3052 N |
| 离床、离腿 | 机构箱离床 2.1 cm，座板与支架离床 2.1 cm、离小腿和脚 12.1 cm；座板侧缘到箱壁 3 cm |
| 应急下降 | 最轻用户下沉推力 267 N 对阻力 73 N（3.7 倍），全行程 3.3 s，制动 ≥ 5.7 N·m |
| 倾翻 | 人站在地上时，横推 107 N 就翻；固定件拉力按 2282 N 设计（ADA 1112 N × 1.5） |

## 5.3 机构空间、单侧四连杆、和抬高床同口径对比（2026-10-27）

脚本：`seat_1dof_bed_baseline.py` → `seat_1dof/bed_baseline.json`；`seat_1dof_fourbar_oneside.py` → `seat_1dof/fourbar_oneside.json`。网页第 13 节。

**双导轨占不占空间。** 在内存里改 `seat_1dof_v5_checks.housing()` 的参数重算：

| 方案 | 机构箱侧视面积 | 箱顶 |
|---|---|---|
| 双导轨，滑块间距 150 mm（现方案） | 2749 cm² | 0.80 m |
| 单导轨 | 2554 cm² | 0.82 m |
| 双导轨，滑块间距 100 mm | 2589 cm² | 0.76 m |

- 两根导轨在同一块侧板上，箱子横向厚度不变，前后范围也不变。箱子大是因为导轨本身长（约 0.58 m）。
- 第二根导轨去不掉：偏载时绕导轨轴线的扭矩约 370 N·m，15 号滑块的额定扭矩约 0.12 kN·m（第三方样本表）。
- 滑块间距可以减到 100 mm：每个滑块约 4 kN，额定静载约 17–23 kN（两份样本不一致，待查厂家样本）。暂未改设计。

**单侧四连杆（第五版没试过，只试了“中间平面”和“两侧”）。** 约束与斜导轨相同：

| 项目 | 斜导轨（采用） | 单侧四连杆 |
|---|---|---|
| 合格 | 81/81 | 75/81 |
| 最大前滑 | +1.9 cm | +2.7 cm |
| 轨迹误差 | 8 mm | 29 mm |
| 驱动静载 | 1.8 kN | 4.0 kN |
| 机构箱 | 2749 cm²，箱顶 0.80 m | 1450 cm²，箱顶 0.52 m |
| 悬臂支点力 | 每滑块约 3.1 kN | 地面铰点轴承对约 25 kN（轴承间距 80 mm） |
| 连杆应力（60×60×4 方管） | — | 128 MPa |

- 不合格的 6 人都是“髋早前移 + 脚靠前”（xa 0.33）。
- **结论：保留斜导轨。**
  - 主要原因是悬臂：四连杆只能靠座板上两个相距 80 mm 的铰点形成 y 向力偶，再靠连杆面外弯曲把力传到地面铰点；导轨则能把支点在侧板平面里拉开。
  - 箱子小一半是真的。若以后箱顶高度变成硬约束，单侧四连杆是备选。
  - 悬臂按“两铰点力偶 + 铰点弯矩”估算，没有计入箱体侧板的分担，是偏大的估计；但约 8 倍的量级差距不会消失。

**和抬高床同口径对比**：同一 effort 函数、同一 L 形扶手，抬高床取最有利的坐姿和 35 个扶手位置中最好的，比较的是能坐稳 0.58 m 床的 72 人。

| 起身方式 | effort 中位数 |
|---|---|
| 低床 0.42 m | 0.409 |
| 抬高床 0.58 m，L 形扶手 | 0.309 |
| 抬高床 0.58 m，最佳扶手 | 0.297 |
| 坐板放手时 | 0.287 |

- 每人的省力中位数：比低床省 32%（81 人都省）；比抬高床省 5–10%，19/72 人略费力。
- 另有 9 位 1.50 m、臀部厚的用户坐 0.58 m 的床脚踩不实，没有纳入比较。
- 原因：放手时前倾的中位数是 15°，多数人在导轨中段就离开坐垫，髋部只比坐在 0.58 m 床上高约 4 cm（中位数）。
- 旧的“比抬高床省 13–20%”来自竖直升到 0.66 m 的旧模型，作废；幻灯片已改。

## 5.4 防跌比较与坐板控制仿真（2026-10-27）

脚本与输出：

| 脚本 | 输出 |
|---|---|
| `seat_1dof_fall_catch.py` | `seat_1dof/fall_catch.json` |
| `seat_support_slider.py` | `seat_1dof/seat_support_slider.json` |
| `controller_seat.py` | `controller_seat.{json,png}`（全部场景）、`controller_seat_main.png`（slide 用） |
| `seat_1dof_release_height.py` | `seat_1dof/release_z.json` |

**腿一软往回坐，能不能接住。**

判定方法：起身中任一时刻，髋部直着往下落，臀部落点（髋后 4 cm）在座面前缘以内算接住。全程覆盖 81 人。

| 做法 | 接得住的起身阶段（中位 / 最少） | 全程接得住 | 站直时落点到前缘 |
|---|---|---|---|
| 低床 0.42 m，坐在床沿 | 14% / 3% | 0/81 | −24.8 cm |
| 抬高床 0.58 m，坐在床沿 | 15% / 3% | 0/81 | −24.7 cm |
| 抬高床，往里坐 5 cm | 28% / 9% | 0/75 | −24.6 cm |
| 竖直升降座板 | 62% / 24% | 19/81 | −3.8 cm |
| 曲线坐板 | 100% / 100% | 81/81 | +7.5 cm |

- 床的起身轨迹：模型里预设的髋部前移节奏后半段够不着，改为“取脚撑得住的最靠后位置”，这样轨迹覆盖完整的起身过程。
- 第二种摔法：直挺挺往后倒（绕脚踝转）。
  - 床都接得住：抬高床 73/81 全程接得住；
  - 坐板中位 40% 的时刻落在座板上，其余越过座板后缘落到床上，0% 落地，但会碰到后缘，所以后缘要软包。
- 哪种摔法更常见，没有数据。
- **结论**：起身台相对抬高床的主要优势是腿一软时接得住；省力和抬高床相当。

**坐板控制仿真。**

- **用户模型**：1.60 m 参考用户，沿坐板实际轨迹和倾角，扶手是固定 L 形扶手。
  - 在放手处（座高 0.571 m），不靠座板起身需要 effort 0.265；
  - 齐平处开始抬升需要 0.16（推力上限 0.5 倍体重）。
- **规则**：同 v5.3。
  - 没有自动带人下降，也没有空载复位；
  - 抬升中自检：三处力之和（座板力按倾角折算）约等于体重；
  - 人挂在横杆上（> 0.3 倍体重）时限速到 30%；
  - 不再检查双立柱同步。
- **14 个场景都落到安全状态**：
  - 最大发力 0.28 的用户，7.4 s 在 0.57 m 离座；
  - 最大发力 0.24 的用户站不起来：到顶停住，按住“降”回到床面；
  - 晕倒：停住，25 s 时提醒并呼叫家属，座板不动；
  - 断电：用电池按住“降”回到床面；
  - 踏板传感器卡住：锁定，按住“降”慢降。
- **参数修改**：“还坐着”的门槛从 0.15 降到 0.10 倍体重。坐板上的人在起身中途能把座板力降到 0.15；按原门槛，坐偏后重新握紧也不能继续升。

**更正。** 对比页脚注原写“手上最多出半个体重”。模型里两手合计上限是 0.25 倍体重（`HAND_CAP`）；0.5 是座板推力上限。已改。

## 5.5 横杆对夜间进出的阻碍：回床高度与横杆末端（2026-10-27）

用户担心 L 形横杆挡路：夜里回床要绕着走、慢慢坐上去，出去也不方便。按几何量过之后，决定做两件事，第三件写进局限页。

1. **横杆末端做圆头软包，并贴夜光条。** 末端在人回床时的走入路线上，夜里最可能撞到。
2. **回床高度默认 0.50 m，原来是降到与床齐平（0.41 m）。**
   - 回床时按住“降”，空座板停在 0.50 m；人坐上后再按住“降”，降到床面。
   - 刚坐下时的用力指标：0.50 m 为 0.317，齐平为 0.397，约少 20%。
   - 0.50 m 时座板前倾 13.3°。
   - 座板前缘到横杆之间的站立空间：0.50 m 时 0.46 m；齐平时 0.53 m；起身后的典型停位 0.42 m。
   - 控制仿真新增两个场景：return（停在 0.50 m）和 return_flush（回床高度设成床面）。场景共 15 个，都停在安全状态。
3. **横杆仍是固定的（写进局限页）。**
   - 回床时要从床尾一侧侧身走进约 0.46 m 深的空间，助行器进不去。
   - 备选方案是可掀起的翻转横杆。代价有三条：要加锁扣，要加“已锁住”检测，人可能忘了放下。

## 5.6 起身路径只算到约三分之二：修正与重算（2026-10-27）

### 发现

PPT 第三轮审计质疑摔倒的定义，补算第二种摔法时发现了这个问题。

`seat_relative_motion.solve_s` 要求小腿倾角 45° 那一端也有姿势，否则整个放弃。快站直时这一端必然没有姿势，所以每条路径都停在髋高 ≈ 踝高 + 0.71 × 小腿 + 大腿，大约起身的三分之二。

- 42/81 人在路径断掉时还坐在座板上；
- 离座后站直的一段没进入任何检查；
- 床那一侧（`bed_path`）不受影响。

### 修正

- 按几何算出可行的最大倾角作为上端，再二分。
- 机构不变：设计曲线冻结在 `seat_1dof/design_curve_v5.json`。
- 扶手位置不变：`seat_1dof_handrail_recheck.py` 只在选定的扶手位置上重算。

### 重跑

以下脚本都已重跑：

- `seat_1dof_slider.py eval`
- `release_height`
- `bed_baseline`
- `handrail_recheck`
- `vertical_v52`
- `fall_catch`（新增第三种摔法 `knee_*`）
- `seat_support_slider`
- `controller_seat`
- `cushion_zoned track`
- `v5_checks`
- `fourbar_oneside_recheck`
- `page_data_v5`
- 新增 `seat_1dof_bed_thigh.py`

### 主要变化（前 → 后）

- 合格人数：81 → 80（一人差 4 mm）。
- 竖直升降：19 → 11。
- 离座座高：中位 0.557 → 0.566 m，最高 0.663 → 0.680 m。
- 放手 effort：0.272 → 0.262。
- 和抬高床比：
  - 人数 72 → 81；
  - 比抬高床多省 5–10% → 10–14%；
  - 略费力的人 19/72 → 22/81；
  - “9 位矮个用户踩不实”是截断造成的，已删掉。几何结果：1.50 m 的人在 0.58 m 床沿大腿下倾约 41.5°，在 0.42 m 床沿约 14°。
- 腿一软直着落：
  - 坐板全程接得住 81/81 → 52/81；
  - 坐板接得住的阶段中位 100%，每人至少 86%；
  - 只在快站直时有人落在前缘外 2–7 cm；
  - 竖直升降接得住的阶段中位 62% → 43%；
  - 床不变（15%）。
- 第二种摔法（膝软、髋绕膝往后下落）：
  - 坐板中位 73% 的阶段落在座板上，81 人都不落到前面；
  - 床：低床 41%、抬高床 32%。
- 第三种摔法（直挺挺往后倒）：坐板 28% 落在座板上，72% 越过后缘落到床上。
- 座板 / 支架离小腿最近：12.1 → 2.0 cm（站直时，仍不碰）。
- 单侧四连杆：75 → 70/81，站直时连杆碰到小腿（−4 cm）。

### 控制器改动

空座板停在回床高度 0.50 m 后，松开再按住“降”就继续降到床面。原来到不了床面，是一个 bug。

### 审计处理

见 `presentation/audit/v3/audit_report.md`。

## 5.7 第四轮开放审计：单侧悬臂的传力路径、控制器互锁（2026-10-27）

### 做法

- 不给 Gemini 指定角度，给它全部材料和模型代码，独立跑三次（`presentation/audit/v4/gemini_open_*.md`）。
- 把新写的三维静力和控制器改动单独交给它核查一次（`gemini_focus.md`）。

### 三维静力（`seat_1dof_cantilever3d.py`）

旧的 `forces()` 默认偏载力矩直接到了滑块板。实际上座板挂在滑块板上，靠的是铰点 1（绕 y 轴的转动副），所以：

- 铰点 1 要传约 611 N·m 的力矩和 3.2 kN 的力。
  - 双轴承间距 6、8、10、14 cm 时，每个轴承分别约 11.3、8.9、7.4、5.8 kN。
  - 可以改用薄型交叉滚子轴承。
- 如果铰点 1 是普通销轴，铰点 2 至少要有 5.2 kN 的侧向力，连杆会面外受弯，和单侧四连杆是同一个问题。
- 连杆两端改用球铰，只受拉压 1.6 kN。
- 丝杠螺母 2.0 kN（原 1.77 kN，只算了法向载荷），制动器 ≥ 6.3 N·m。
- 每个滑块：垂直侧板方向 3.3 kN，导轨平面内 1.8 kN（原来漏算），合力 3.8 kN。

载荷方向含沿座面法向、竖直向下、法向 ± 0.3 倍沿座面。

和单侧四连杆比：同样 8 cm 间距，四连杆的地面铰点约 25 kN，这里约 8.9 kN。原来拿“每个滑块”去比，比错了对象。

### 控制器（`controller_seat.py`）

1. “卸掉的力要到脚上才提速”原来只写在文字里，代码里没有。现在补上了：

   v = k·min(F_cap − F_seat, F_feet − (BW − F_cap) + 0.15 BW)

   新场景“握着开关却往后靠回床垫”：旧规则座板会升 8 cm，新规则不动。
2. 自检分级：
   - 差 15–35% 时限速并语音提示；第一档容差随座板力和倾角放宽 (1 − cos φ + 0.5 sin φ) 倍座板力；
   - 差 > 35% 才锁定；
   - 带人下降时出现提示也减半速；
   - 踏板力先滤波再用。
3. 应急拨杆改到横杆与立柱拐角下方、带翻盖。原因：控制器坏了，自动呼叫也就没了，老人要能自己够到。

16 个场景都落到安全状态。

### 其他

- 81 人体重同为 60 kg、关节力量相同。所以个子之间的比较不可信；方案之间同一个人的比值不受影响。
- 最吃力的时刻在放手那一下。分区坐垫不改变它。
- 设计网页第 9、12 节的旧做法已加“已改”标注，本文档开头加了阅读说明。
- 5.4 节写的参考用户放手 effort 0.265，路径修正后为 0.247（`seat_support_slider.json`）。

### CAD 尺寸表

- `seat_1dof_cad_sheet.py` → `seat_1dof/cad_sheet.json`、`cad/travel_table.csv`、`cad/key_poses.csv`
- `cad/build_sheet.py` → `cad/cad_sheet.html`

## 第五版 5.8：零件、材料和铰点 1 的做法（`seat_1dof_parts.py` → `seat_1dof/parts.json`）

**说明：**本节取代 5.7 中“铰点 1 用交叉滚子轴承，或相距约 14 cm 的双轴承”。

**铰点 1 改为一对圆锥滚子轴承**
- 型号 32006 X，背对背，沿 y 相距 61 mm，装在 Ø75 的轴承座筒里；座筒焊在 20 mm 滑块板上，穿过内壁竖槽。
- 当量静载 10.8 kN，额定 44 kN。
- 不用交叉滚子轴承的原因：铰点 1 在齐平位离床侧面只有 69 mm。
  - RU85（外径 120）强度够，但离床只剩 9 mm。
  - RU66（外径 95）当量静载约 21 kN，和额定 22.3 kN 几乎相等，不够。

**载荷**
- 新增侧向 ± 0.3 倍设计载荷。
- 活动件质量按零件算：座板侧 6.4 kg，滑块座 8.1 kg。
- 铰点 1 力矩 590 N·m，螺母 2.0 kN，每个滑块 × 1.3 后 6.7 kN（HGH15CA 额定 16.97 kN）。

**截面（手算，应力 ≤ 屈服 / 1.5）**

| 零件 | 截面 / 材料 | 结果 |
|---|---|---|
| 横梁 | 50 × 30 × 4（S355） | 116 MPa，外缘下沉 1.7 mm |
| 铰点 1 轴 | Ø30（42CrMo4） | 208 MPa |
| 滑块板 | S355 20 mm | 190 MPa；15 mm 时 337 MPa，不够 |
| 连杆 | Ø20 × 2，M10 杆端 | — |
| 扶手立柱 | 60 × 60 × 4 | — |
| 横杆 | Ø38 × 4 | — |

座板外缘下沉预算合计 3.8 mm（目标 ≤ 5 mm）；轴承和滑块的刚度是假设值。

**机构箱外廓**
- 按零件实际外形重算，侧视面积 3029 cm²。
- 离床 12 mm（静止件），最近处是铰点 2 在齐平位的杆端。
- 换 M8 杆端可到约 15 mm。

**驱动**
- 同步带改为 1:3，电机只需 0.46 N·m @ 540 r/min。
- 应急下降余量从 2.6 降到 1.6。

**整机质量**
- 估约 80 kg（稳定性原按 45 kg 算），翻倒余量都变大。
- 人不在台上时横推约 150 N 就翻，仍必须和床固定。

**有限元重点（按优先级）**
1. 铰点 1 组件 + 滑块座焊件；
2. 横梁 + 节点板焊缝；
3. 带竖槽的机构箱盒体；
4. 扶手立柱根部和底座。

载荷向量、约束和合格线见 `cad/mechanism.html`（发布为“起身台机构与选型”）和 `cad/cad_sheet.html` 第 10–17 项。

## 第五版 5.9：CAD 合模后的修订（`cad/model/`，CadQuery）

**做了什么**
- 按 v5.7 的零件表建了 40 个零件的参数化三维模型，输出：
  - 每个零件的 STEP（零件坐标）；
  - 总装 STEP（齐平位、顶位）；
  - 23 张自制件三视图（第一角投影，含外形尺寸、关键尺寸表、标题栏）和 1 张总装图；
  - 网页用网格。
- 程序：`cad/model/build_cad.py`；输出：`cad/out/`；发布在“起身台机构与选型”页面第 8b 节。
- 在齐平、中间、顶位三个位置自动查零件干涉。

**合模查出、已改的冲突**
- **丝杠上端的驱动端**（固定支撑 BK12、带轮、失电制动器、限速器）：
  - 冲突：顶位时滑块板会撞上它。原来的二维外廓看不出这一点。
  - 修改：驱动端沿丝杠上移 94 mm；去掉下端浮动支撑，人坐着时丝杠受拉。
  - 代价：机构箱顶从 0.80 升到约 0.89 m，侧视面积 3652 cm²。
  - 电机放到丝杠靠导轨 1 一侧。
- **铰点 1 的两个轴承**：
  - 冲突：原来 A 轴承在滑块板外侧，轴端和锁紧螺母会撞上正后方的滑块。
  - 修改：两个轴承都装进座筒里，间距从 61 mm 改为 45 mm。
  - 结果：当量静载 13.6 kN，额定 44 kN，安全系数 3.2（原 4.1）。
- **B 支座**：底板穿过机构箱内壁和前壁；底板改小，放到箱底板上。
- **侧板 H1**：沿螺母行程开 64 宽、12 深的让位槽。
- **节点板 S8**：内移到 y 204 … 216，厚 12 mm；坐垫和底板在这里局部开槽。
- **称重单元和支臂**：移到 y ±180。

**改后结果**
- 三个位置只剩 3 处轻接触：轴承和轴、摆臂和杆端，都是网格误差级的配合面。
- 座板外缘下沉预算合计 4.0 mm（目标 ≤ 5 mm）。
- 整机估约 85 kg。

## 5.10 防跌倒第 1、2 步：侧向摔倒、离开踏板时摔倒（2026-10-27）

两个检验都是“能否排除”的便宜检验，不是完整分析。数字分别来自 `seat_1dof_lateral.py` → `seat_1dof/lateral.json`、`exit_fall_detect.py` → `seat_1dof/exit_detect.json`。

**第 1 步：侧向摔倒**

模型是准静态的，只看正面（额状面）。量的是“身体被侧向推到多快就会倒”：临界速度 = 重心到支撑边的距离 × √(g / 摆长)，也就是外推重心越过支撑边的条件。结果取 81 人的中位数。

| 情况 | 临界速度（m/s） |
|---|---|
| 坐在 0.42 m 床沿（对照） | 0.91 |
| 坐在 0.58 m 床沿（对照） | 0.98 |
| 起身台：坐着，刚开始 | 0.85 |
| 起身台：坐着最弱处（f ≈ 0.67，髋高 0.73 m） | 0.80 |
| 放开座板，只靠双脚站（床和起身台一样） | 0.47 |
| 坐着 + 双手握横杆（手按力算） | 1.27（放开后 0.90） |
| 横杆加长到 y −0.25（M1），坐着 | 1.20：敞开侧反而略差；还要换 Ø42.4×4 的管 |
| 敞开侧翻下式挡板（M2），坐着 | 2.40；3.5% 的帧根本倒不了 |

- 最弱的时刻是放开座板以后。这和从床上站起来一样，不是起身台带来的。
- 起身台特有的风险是从敞开侧摔下时的落差。坐着时髋部落差中位数 0.63 m，低床 0.41 m、0.58 m 的床 0.57 m；对应落地速度约 3.5 / 2.8 / 3.3 m/s。
- 床头一侧由机构箱挡住（箱壁离座板 3 cm）。
- 待定：用 M2 挡板，还是用座板测力单元发现压力中心侧偏就停、不抬（后者还没仿真）。

**第 2 步：离开踏板时摔倒能否检测**

方法：
- 不加新传感器，只用踏板 4 个测力单元和横杆测力，100 Hz。
- 用合成数据做蒙特卡洛：约 500 次正常离开、约 500 次摔倒（侧倒、前倒、腿软、脚滑、踩一步救回又摔）。
- 检测器两种：逻辑回归（7 个特征）和三条阈值规则。

| 场景 | 误报 5 次 / 100 时的检出率 | 其他 |
|---|---|---|
| 基本情况（逻辑回归） | 98% | AUC 0.996；误报 1 次 / 100 时 90%，10 次时 99.6% |
| 最坏情况（压力中心噪声加倍 + 正常人也快步、踩脚边 + 慢慢倒） | 80% | |
| 三条阈值规则 | 75%（误报 3.9 次 / 100） | |

- 单个信号都分不清，区分度（AUC）最高只有 0.79（压力中心离脚边多近）。
- 几个信号合起来才分得开：卸载时间 0.37 vs 0.54 s，压力中心离脚边程度 0.70 vs 0.24，再加上落地冲击。
- 认出来只能报警（开灯、语音、30 秒无回应呼叫家属），挡不住这一次摔倒。
- 双脚都离开踏板以后再摔，这些传感器看不到，不在本项目范围（需要雷达或可穿戴）。
- 局限：摔倒过程是我们自己生成的，检测器又在同类数据上训练，结果偏乐观。只能说明“现有信号里有区分信息”。
- 继续的条件：志愿者在软垫上做摔倒动作 + 录老人的正常离开，实测检出 ≥ 80%、误报 ≤ 5 次 / 100。

**同时修正**

- 稳定性页按 v5.7 零件估算的台架质量（84.6 kg）重算：
  - 人不在台上时，往床头方向推 156 N 就翻（旧值 107 N 按 45 kg 算）；
  - 固定件拉力 2211 N。
- `parts.json` 中两处旧文字已改：轴承座窗口 60° → 80°；丝杠下端 BF12 → 不支撑。
