xiaweiyi0423/me5412-bedexit-proposal/presentation/audit/context_v4.md

# 课程与交付背景
- 课程：ME5412 Robotics for Healthcare，小组项目（Group 16，5 人，按 5 个角色分工：1 问题与整合、2 模型与几何、3 机构与 CAD、4 结构与安全、5 控制与仿真）。
- 只做概念、设计和仿真，不做实物、不做实验。
- 时间线：10/27 和老师做一次 consultation（用这份中文草稿）；11/3 交一份**英文** slides（同时当报告用）并现场展示。主 slides 精简，设计和分析的细节、更多图、答问备用页放附录，附录不限页数。
- 老师 10/26 对方案邮件的回复要点：
  1. 目标用户的定义清楚；方案可以；只做概念、设计和仿真就够；验证方法够。
  2. 要考虑人坐上去、挪动时重心变化带来的台架稳定性。
  3. 用户界面和操作安全很关键：手握输入，加上压力和力分布传感；抬升速度要能个性化、自适应。
  4. 要展示 CAD 模型和运动动画。
  5. 把机构概念和状态机控制器讲清楚，工作量就够了。
  6. 主 slides 不要太多，细节可以放附录，附录不限页数。
- 讲稿按约 230 字/分钟写；课堂汇报时长约 15 分钟（小组自定目标，课程正式时限未在材料中给出）。

# 当前状态（v5.6，2026-10-27）

材料包括：21 页中文 slides 和讲稿、讲稿指南（每页要点、预备问答、待补）、一个单独的设计网页（15 节，下面附了它的文字）、设计总结文档，以及产生所有数字的 Python 模型代码。

本轮之前已做过三轮针对性审计（分角度），最近一轮还查出了模型 bug：起身路径求解在约三分之二处就停了。修正后重算的结论都已写进材料，见设计网页第 15 节和总结文档 5.6 节。

这一轮不指定角度，请你作为外部审阅者，自己判断什么最重要。
