xiaweiyi0423/me5412-bedexit-proposal/model/calc_v13/seat_trajectory_summary.md

# 坐板轨迹：人与坐板的相对运动（矢状面）

脚本：`seat_relative_motion.py`（计算）、`seat_relative_motion_fig.py`（出图）。结果在 `seat_trajectory/`：
`relative_motion.json`、`stages_typical.png`、`stages_leanfirst.png`、`users_27.png`。

## 1. 什么叫"朝不稳定方向的相对运动"

起身就是把体重移到脚上方；床边起身最怕的是**向后、向下**跌坐，落点在坐板上或坐板外。
所以只要相对运动让下面三件事变坏，就算朝不稳定方向：

| 量 | 定义 | 坏的方向 |
|---|---|---|
| 累计前滑 | 人体接触点相对坐板表面滑过的距离 | **+**：人在座面上往前滑出去。这时摩擦力把人往后拉，正好和起身方向相反，同时皮肤受剪切 |
| 坐回余量 | 坐板前缘到"此刻若坐回，臀部压力中心落点"（髋关节后 4 cm）的水平距离 | **−**：坐回时会落在前缘上或前缘外 |
| 接触长度 | 坐垫压缩 1.5 cm 以内、人体轮廓贴着座面的长度（代表接触面积） | 变短：支撑缩成一条边 |

前滑为 −（坐板相对人往前跑）方向是安全的：摩擦把人往前推，坐板也更多地垫在人下面。代价是接触点会往大腿下方移。

## 2. 结果（27 位用户：身高 1.50/1.60/1.75 m × 脚位 0.25/0.29/0.33 m × 3 种起身习惯）

| 方案 | 往前滑（最大） | 坐回余量（最小） | 放手前接触长度 | 放手时费力（中位 / 最差） |
|---|---|---|---|---|
| V 竖直升降、座面水平（现方案） | **+10.5 cm**（中位 +6.0） | **−3.5 cm** | ~3 cm | 0.267 / 0.378 |
| 1-DOF 曲线，按典型用户拟合 | +8.5 cm | −3.0 cm（6 人 < 0） | ~6 cm | 0.263 / 0.345 |
| 1-DOF 曲线，按"髋最早前移"的用户拟合 | +1.5 cm | +0.3 cm | ~6 cm | 0.309 / 0.413 |
| 同上 + 前缘托腿垫（接受大腿后侧 18 cm 内的接触） | **+1.5 cm** | **+0.3 cm** | ~6 cm | **0.251 / 0.33** |
| 1-DOF，按每人身材和脚位调一次（仍是一个电机） | +6.0 cm | −0.8 cm | ~6 cm | 0.256 / 0.345 |
| 实时跟随（3 自由度 + 传感，理论上限） | 0（全程 ≤ 0） | +2.1 cm | ~6 cm | 0.26 / 0.342 |

"费力"指放手那一刻、不再有坐板支撑时，最吃力关节的力矩占其力量的比例；人放手后可以自由调整姿势继续站起。

**读法**

- **V 的问题确实存在，但取决于起身习惯。**
  - 髋随起身往前移的人（早前移和匀速前移两类）：在座面上往前滑 4–10 cm，坐回余量变负，接触缩到约 3 cm 宽的前缘。早前移的人还会更早失去支撑（髋高最低 0.59 m），放手时的费力也因此最高。
  - 先直上、后前移的人：V 没有这个问题。
  - 也就是说，V 默认用户"直上直下"，这是一个对行为的隐含要求。
- **单自由度够用，关键在怎么拟合曲线。**
  - 让坐板像"粘在大腿上"一样走：前移、上升、前倾，最多 30°。这样同一条曲线下，往前滑基本消失，接触面积保持不变。
  - 只用一条曲线时，按"髋最早前移"的人去拟合。对其他所有人，相对运动都只会落在安全方向（坐板跑到人下面）。
  - 代价：对先直上的人，坐板跑得太靠前，接触点滑向大腿下方，放手提前，费力变差（最差 0.413）。
  - 加前缘托腿垫、把可接受的接触点放宽到大腿后侧 18 cm 后，这个代价消失：27 人的费力中位数 0.251、最差 0.33，比实时跟随还略好。
- **第二、第三自由度能多换来的不多。**
  - 实时跟随的优势只体现在：坐回余量从 +0.3 cm 提高到 +2 cm，以及不需要托腿垫。
  - 代价是要额外的执行器、要测量人体姿态，以及相应的安全逻辑。
- **身高 1.75 m 的用户，放手时的费力在所有方案下都在 0.31–0.34。** 这是行程顶点 0.66 m 相对高个子偏低造成的，任何轨迹都解决不了，要靠行程或起始高度。

## 3. 局限（未验证的假设）

- 人体后侧轮廓是刚性的：臀部是半径 9 cm、以髋为圆心的圆弧，加一条大腿后侧直线。骨盆假设保持直立。实际软组织会让接触面积更大。
- 髋的前移只用了 3 种代表性路径；真实人群的起身轨迹需要动作捕捉数据来核对。
- 托腿垫压在大腿后侧 18 cm 以内是否舒适、压强是否可接受（0.5 BW 分到约 8 × 24 cm²，约 15 kPa）没有验证。
- 放手前那一刻座面前倾约 30°。这时如果人往回坐，要靠摩擦（需要 μ ≳ 0.58）或控制器迅速把座面放平，否则人会顺坡往前下方滑。这部分按团队意见交给控制处理，这里没有计算。
- 静力学模型，不含速度和冲击。

## 4. 建议

1. 结构上用 1-DOF：一个电机，加一条固定曲线（四连杆或导轨加凸轮），让坐板前移、上升、前倾，前倾上限 30°；曲线按"髋最早前移"的用户拟合；坐板前缘做成加长、圆滑的托腿垫。
2. 用 `stages_*.png` 作为汇报的矢状面示意图：对比 V 和 1-DOF 在四个阶段的相对运动。
3. 待验证：托腿垫的压强和舒适度；30° 前倾时坐回的接住策略；用真实起身轨迹核对曲线。

## 5. 补充：允许用户自选最省力姿势时的费力（`seat_trajectory.py`，`seat_trajectory/results.json`）

前面的结果按 3 种固定起身习惯计算。这里换个问法：如果用户总能挑最省力的起身路线，各机构能做到多好？

方法：在"髋高 × 小腿前倾"网格上找一条路线，使全程最吃力时刻的费力最小。路线分两段：先是坐板支撑段，这段的姿势必须是机构够得着、接触点又可接受的；然后放手，自己站起来。

支撑段在搜索时用"推在骨盆上"作为近似。找到路线后，再按机构真实的接触点（骨盆或大腿）和力方向复算一遍，取两者中较大的那个。

样本：27 种情况 = 3 种身高 × 3 种脚位 × 3 种踝背屈上限（20/25/30°）。

| 方案 | 有可行路线的情况 | 费力 中位 / 最差 |
|---|---|---|
| 不升降（只坐床沿 0.42 m） | 27 | 0.401 / 0.474 |
| V 竖直升降（现方案） | 22 | 0.243 / 0.308 |
| V，行程加到 0.72 m | 22 | 0.243 / 0.285 |
| 1-DOF 摆臂 / 斜导轨 + 联动前倾 | 22–23 | 0.242–0.245 / 0.32–0.47 |
| 2-DOF（斜导轨 + 独立前倾） | 27 | 0.239 / 0.313 |
| 3-DOF（前移 + 上升 + 前倾） | 27 | 0.218 / 0.292 |
| 理想（接触点任意，且算作推在骨盆上） | 27 | 0.164 / 0.292 |

**读法**

- 用户能自选最省力姿势时，各机构的费力中位数都在 0.24 左右，3 自由度也只降到 0.22。
  - 所以轨迹和自由度主要影响的是第 1–2 节的相对运动和坐回安全，对费力影响不大。
- 真正拉开差距的是接触点在骨盆还是在大腿：推大腿只帮膝，推骨盆髋、膝都帮。
  - "理想"一行的 0.164 正是假设全程推在骨盆上得到的。
  - 我们用的人体轮廓是刚体，骨盆和大腿的分界线只是人为划的，所以这一点只能作为待验证的方向，不能当结论。
- V 有 5 种情况无可行路线，原因都是脚位靠后（0.25 m）加上踝背屈上限低：坐在座面上时小腿前倾已经超过踝关节活动范围。
  - 这是脚踏板位置的问题，和轨迹无关。
  - 有可行路线的情况增多的方案，是因为座板能往前、往下伸到人更靠前的坐姿下面。
- 最差值里的 0.47 来自这些情况：路线是按"推骨盆"近似选出来的，按真实接触复算后支撑段更吃力。这是近似带来的偏差，不代表这些机构真的差到这个程度。
