xiaweiyi0423/me5412-bedexit-proposal/presentation/audit/consistency_check.md

# 数字一致性检查（Claude 用脚本和源文件核对，不经 Gemini）

对照对象：`presentation/slides/*.html`（slide 文字和 `<aside>` 讲稿）、`presentation/tools/build_guide2.py`（讲稿指南的要点、问答、待补）、`README.md`、`model/compare_v11.json`、`model/heel_sensitivity_v12.json`、`model/calc_v12/*.json` 和 `controller_sim.py`。

## 结论

slides 上的大部分数字都能在模型输出里找到出处，而且换算正确。有 **3 处实质矛盾**和 **3 处小的不一致**。实质矛盾里最重要的是第 1 条：它会削弱“0.66 m 才是起身台的价值”这一核心论证。

## 实质矛盾

### 1. 仿真里的正常用户在 0.61 m 就站起来了，而第 7 页说“只升到 0.60 m 就和抬高床差不多”

- `controller_sim.json`：Normal user 最终高度 **0.611 m**，Slow user 0.606 m，Fast user 0.615 m。三个能站起的场景，座板都没到 0.66 m。
- 第 7 页：“只升到 0.60 m 就和抬高床差不多：省力来自固定床达不到的那段高度。”第 18 页结论：“升到 0.66 m，比抬高床再省 13–20%。”
- 为什么矛盾：速度规则 v = k(F_cap − F_seat) 的含义是，人一旦能把座板卸载到离座，座板就停住。所以座板升多高，取决于人在哪个高度能站起来，而不是固定升到 0.66 m。在这个（简化的）用户模型里，人在 0.61 m 就离座了。按第 7 页自己的说法，这个高度的省力和抬高床差不多。
- 边界：仿真里的用户模型是凭假设写的（`user_capacity` 随高度线性增加），讲稿也说它“只用来检验控制逻辑”。所以这不能证明真实用户会在 0.61 m 离座，但懂行的提问者一眼就能把两页连起来。
- 建议：(a) 讲清 13–20% 是“升到 0.66 m 时”的上限，实际收益取决于人在多高离座；(b) 或者调整仿真用户模型，让“需要 0.66 m 的人”恰好在 0.66 m 附近离座，并在第 14 页说明；(c) 第 7 页加一句“对腿力越弱的人，离座高度越接近 0.66 m，收益越大”。这句是推断，需要用起身模型验证（见第 2 条和 Gemini A 角度第 1 条）。

### 2. “力之和对不上就锁住”在正常使用的起步阶段很可能误触发

- `controller_sim.py`：`sum_tol = 0.15`，即座板 + 踏板 + 横杆的竖直力之和偏离体重超过 15% 就进入 LOCKED。`lift_sizing.py`：`SEAT_DEPTH = 0.14`，座板只有 14 cm 深。
- 第 6 页步骤 2–3：人从床沿往前挪到和床齐平的短座板上，握住握把，“想坐多久都行”。
- 为什么矛盾：座板只有 14 cm 深，人坐在上面时大腿和部分臀部大概率还压在床垫上，这部分重量不经过任何传感器。力之和会明显小于体重，于是在抬升前就锁住。仿真没有暴露这个问题，因为仿真里 `F_feet = BW − F_seat − F_bar`，体重被假设为全部落在台架上。
- 建议：自检只在座板已经离开床面以后做；或者改成和“坐定时的基线”比较，而不是和体重比较。第 12 页和第 13 页的说法要同步修改。（Gemini A 角度第 5 条也指出了这一点，但判为“低”；结合 14 cm 的座深，应该是“高”。）

### 3. 个人最快速度 4 cm/s 超出了讲稿指南里引用的推杆空载速度

- 第 14 页：“最快 1.5–4 cm/s”；仿真 Fast user 用 4 cm/s。
- 讲稿指南第 10 页的回答：“TL8 满载约 9.6 mm/s、空载约 32.6 mm/s……3 cm/s 左右可行。”
- 为什么矛盾：空载最快才约 3.3 cm/s，带人不可能到 4 cm/s。3 cm/s 也是临界值：按满载和空载之间线性插值，每根柱负载约 300 N 时约 2.9 cm/s。
- 建议：把可设上限改成 ≤ 3 cm/s（或注明“需要更快的柱型”），并按厂家力-速度曲线核对。这条已在待补清单里，但第 14 页的 4 cm/s 需要跟着改。

## 小的不一致

| 位置 | A 说 | B 说 | 建议 |
|---|---|---|---|
| 第 10 页 vs 讲稿指南第 10 页问答 | 每根推约 0.23 kN（`lift_sizing.json`：推到上限时每根 226 N） | “每根实际负载约 300 N” | 统一成 0.23 kN，或说明 300 N 包含了什么 |
| 第 4 页设计要求 vs 第 10、14 页 | “推人的力不超过约半个体重” | 推杆按 0.6 × 体重选型；个人设置 0.3–0.6 × 体重 | 写成“默认 0.5 × 体重，可设 0.3–0.6”，并在第 4 页注明 |
| `controller_sim.json` vs `controller_sim.py` | JSON 参数写 `k = vmax / (0.2 BW)` | 代码和讲稿指南是 `vmax / (0.35 BW)` | 改 JSON 生成代码里的标签（不影响 slides） |

## 已核对一致的数字

| slide 上的数字 | 来源 | 核对 |
|---|---|---|
| effort 0.39 / 0.29 / 0.23 / 0.24 | `heel_sensitivity_v12.json` P1 cap25：0.389 / 0.291 / 0.233 / 0.244 | 一致 |
| 比抬高床省 13–20% | 四种手臂假设 × 两种脚下空间：13.2%–19.9% | 一致 |
| 比低床省 26–40% | 26.3%–40.1% | 一致 |
| 不用手 16–22%（README） | `none`：15.7% / 21.8% | 一致 |
| 每根推 0.23 kN、保持 0.49 kN | 226 N / 491 N | 一致 |
| 剪叉起步 1.2–1.7 kN；放大 3–4 倍 | 1239 / 1748 N；2.7–3.9 倍 | 一致（“3–4 倍”略往上取整） |
| 合重心离后边缘 0.13–0.28 m | 0.134–0.282 | 一致 |
| 侧向偏出约 0.5 m 才翻 | 0.523 m | 一致 |
| 不固定时安全系数 0.73–1.0 | 0.73–1.01 | 一致 |
| 压紧力 90–180 N 到 1.5 | 86–182 N | 一致 |
| ADA 1112 N 时固定件约 2 kN | 2052 N | 一致 |
| 拉力 177 N = 30% 体重 | 0.3 × 588.6 N = 176.6 N | 一致 |
| 升 24 cm（0.42 → 0.66 m） | stroke 0.24 | 一致 |
| 主 slides 19 页约 16 分钟 | 讲稿指南合计 15.9 分钟 | 一致 |
| 8 个场景都落到安全状态 | 8 个场景的终态：3 个 STANDING_HOLD、3 个 SEATED、1 个 LOCKED、1 个 STOPPED；“腿力太弱”结束时是 LOWERING（正在带人下降） | 基本一致；“腿力太弱”在仿真结束时还在下降 |
