xiaweiyi0423/me5412-bedexit-proposal/presentation/audit/gemini_D_grading.md

<!-- model: gemini-4-argon; finishReason: STOP; usage: {"promptTokenCount": 42950, "candidatesTokenCount": 3539, "totalTokenCount": 46489, "cachedContentTokenCount": 40723, "promptTokensDetails": [{"modality": "TEXT", "tokenCount": 12150}, {"modality": "IMAGE", "tokenCount": 30800}], "cacheTokensDetails": [{"modality": "TEXT", "tokenCount": 11521}, {"modality": "IMAGE", "tokenCount": 29202}], "candidatesTokensDetails": [{"modality": "TEXT", "tokenCount": 3539}]} -->

作为这门课的老师，看到你们在 10/27 拿出这份结构完整、逻辑清晰的草稿，我是很满意的。你们很好地听取了我在 10/26 邮件里的建议：放弃了不切实际的单自由度前倾方案，老老实实把机构、稳定性和状态机控制做扎实。

但是，如果以 11/3 最终英文汇报和作为报告提交的标准来打分，这份材料目前还有几个**直接导致扣分、在答辩时会被我追问卡壳的硬伤**。我按严重程度从高到低列出来，同时直接回答你们第 21 页的四个问题。

---

### 1. 【严重度：高】CAD 模型与运动动画完全缺失，且在“时间紧版本”中被错误标为“可删”
* **位置**：第 8 页（机构）、第 9 页（运动演示）、第 16 页（验证表）。
* **原文证据**：
  * 第 8、9 页目前只有 2D 火柴人配几何方块的示意图。
  * 第 9 页明确写着“待补：SolidWorks 运动算例动画”，但在讲稿指南的标题栏里，第 9 页被标了 `状态=gap; 时间紧版本删去`。
  * 第 16 页验证表第 4、5 项状态为“进行中（待补 FEA / 真实质量复核）”。
* **为什么是问题（因果与事实）**：
  * **确定事实**：我在 10/26 邮件第 4 条明确要求“要展示 CAD 模型和运动动画”，因为这门课不做实物，CAD 和仿真就是证明你们做过工程设计的唯一证据。
  * **扣分点**：如果 11/3 终稿还是只有火柴人，或者因为汇报时间紧就把第 9 页（运动演示）删了，机构与 CAD 这部分（角色 3）会直接大额丢分。此外，没有 CAD，角色 4 的真实重心复核、固定件具体设计（床垫下钩板还是床腿夹？）和 FEA 就全是空中楼阁。
* **怎么改**：
  1. **绝不能删第 9 页**：把第 9 页改成 `时间紧版本保留`。如果要压缩时间，把第 6 页（火柴人五步图）和第 9 页（CAD 运动动画）**二合一**——直接用 SolidWorks 动画或渲染图展示五步使用过程，省掉第 6 页。
  2. **CAD 必须落地三个细节**：① 两根 TiMOTION TL8 升降柱怎么跟滑架、座板装配；② 随座板一起升的 L 形扶手怎么固定在滑架上、悬臂有多长；③ 台架到底怎么和床固定（把床腿夹或钩板画出来）。

---

### 2. 【严重度：高】自适应速度公式存在控制死锁漏洞：用“座板受力”直接算速度，把推杆自己的顶升力算漏了
* **位置**：第 14 页（速度随人自适应）、第 21 页问题 1。
* **原文证据**：
  * 第 14 页公式：`v = k ×（推力上限 − 座板测到的力）`，讲稿写“人自己卸掉的体重越多，座板上的力越小，座板就升得越快”。
  * 第 10 页写“推到推力上限（0.6 × 体重）”，第 14 页图注写 `force cap 0.5 BW`，README 写“约体重的一半”。
* **为什么是问题（因果与推演）**：
  * **回应第 21 页问题 1**：用简单的代数规则配合个人参数（上限、最大速度）来体现 personalised & adaptive，**这个思路我认可，不需要上复杂的机器学习**。
  * **但物理逻辑上有硬伤（会被我当场问住）**：老人刚坐稳、握紧开关准备起身的瞬间（t = 0），他还没有站起来，也没有拉扶手把半个身子悬空，此时座板测到的力就是他坐着的分担体重（约 70%–80% BW）。如果你们的“推力上限”设在 0.5 BW，那么在起步瞬间：`推力上限 (0.5 BW) − 座板测到的力 (0.8 BW) < 0`！按你们的公式，速度 v = 0，**台架根本不会启动！**
  * **推测与追问**：老人必须先自己用腿和手把座板卸载到 0.5 BW 以下，台架才开始动——但他在 0.42 m 低位恰恰是最发不出力的！更有甚者，一旦推杆开始向上加速顶人，座板和人之间的接触力是会短暂变大还是变小？你们的仿真里之所以能动起来（第 14 页右上角的橙色线在 5 秒时突然从 0.8 降到 0.5），是因为你们在仿真脚本里人为设定了“人在第 5 秒自己卸载了一半体重”。
* **怎么改**：
  1. **理清启动与调速逻辑**：在幻灯片或讲稿里说清楚起步条件。例如：握紧开关且身体前倾（踏板受力增加 / 座板压力中心前移）时，给一个基础起步速度 $v_0$，或者把公式里的阈值设为基线坐姿载荷（如 0.75 BW），而不是 0.5 BW。
  2. **统一全篇数字**：第 4 页/README 说“半个体重（0.5 BW）”，第 10 页推杆计算用“0.6 × 体重”，第 14 页写“0.3–0.6 × 体重”。请在主 slides 里统一成：“默认 0.5 BW（可按人在 0.3–0.6 BW 间调节），结构与推杆选型按最严苛的 0.6 BW 校核”。一句话就能展现工程严谨性。

---

### 3. 【严重度：中】传感器“自检条件”太绝对，一拉扶手或一抬升就会误触发锁定
* **位置**：第 12 页（传感与交互）、第 13 页（状态机）。
* **原文证据**：
  * 第 12 页：“自检：各处竖直力之和应约等于体重，对不上就锁住”。
  * 第 13 页状态机左上角：`any state ---> LOCKED: sensor sum != BW (only slow DOWN allowed)`。
* **为什么是问题（因果与事实）**：
  * **确定事实**：这是一个非常好的安全设计亮点，但如果写得这么绝对，在答辩时我会立刻问两个问题：
    1. **人还半坐在床上时**（第 6 页步骤 1、2），一部分体重在床垫上，台架上三个传感器的竖直力之和肯定小于体重（`sensor sum != BW`）。为什么状态机没在 `IDLE` 或过渡时直接跳进 `LOCKED`？
    2. **横杆测力怎么测？**老人在起身时，手对横杆既可能向下压，也可能向后/向上拉（第 11 页专门算了拉扶手 177 N）。如果横杆只装了单向测力计，或者在升降动态过程中存在惯性力和摩擦力，竖直力之和偏离体重多少算故障？
* **怎么改**：
  * 把第 12 页和第 13 页图上的条件改严谨：**仅在“人已完全转移到座板上（如 `SEATED` / `LIFTING` 状态）”时启用总重自检**，且写成容差带：$\sum F_z \in [0.85, 1.15]\,\text{BW}$。横杆传感器明确写为“双向（拉/压）测力”。

---

### 4. 【严重度：中】稳定性分析：静力框架够了，但漏了“从床沿挪到座板”这最危险的一步
* **位置**：第 6 页（使用步骤 1→2）、第 11 页（稳定性）、第 21 页问题 3。
* **原文证据**：
  * 第 6 页讲稿指南问答：“问：往前挪 25–30 cm，老人做得到吗？答：这是目前最大的不确定……列入局限”。
  * 第 11 页：只分了“人完全在台架上”和“人部分离开时拉扶手”，底部小字写“按扶手标准 ADA 609 的 1112 N 设计时，固定件约 2 kN，需要用床腿夹”，但正文写“压紧力约 90–180 N 就到 1.5”。
* **为什么是问题（因果与事实）**：
  * **回应第 21 页问题 3**：用“合重心投影 + 抗倾覆力矩安全系数 1.5”的静力学分析，对这门课来说**完全够用**，不需要做多体动力学仿真。
  * **但分析场景有缺口**：我在邮件第 2 条专门提醒“要考虑人坐上去、挪动时重心变化带来的台架稳定性”。老人在第 6 页从步骤 1（坐床沿）往前挪 25–30 cm 到步骤 2（上座板）的过程中，手一定会撑或拉身前的横杆，同时臀部对座板后缘产生很大的向前的水平摩擦力/推力。这个“挪动过程”在你们第 11 页右图的 5 个柱子里没有明確体现。
  * 此外，第 11 页正文说固定件只需“90–180 N（可用钩板）”，底部小字又说按 ADA 标准要“2 kN（需用床腿夹）”，听众会困惑你们到底选了哪个设计载荷。
* **怎么改**：
  1. 在第 11 页右图或文字里明确交代：那 5 种外力工况已经覆盖了“从床沿抓扶手往座板上挪动”的过程。
  2. 明确固定件方案：正文中直接敲定“常规工况（30% BW 拉力）需 180 N 锚固力；为防老人跌倒猛拽（极限工况），我们采用**床腿夹 + 床垫下钩板**双重固定”。

---

### 5. 【严重度：中】主 slides 页数偏多、图表字号过小，且即将面临中译英的排版膨胀
* **位置**：全篇（特别是第 2、5、10、11、13、14 页）、第 21 页问题 2 和 4。
* **原文证据**：
  * 主 slides 共 19 页，计划讲 15–16 分钟。
  * 第 10、11、13、14 页的仿真图和工程图已经是英文，但截图里坐标轴和图例字号极小，后排根本看不清（你们自己在讲稿指南里也标了待补）。
* **为什么是问题（因果与事实）**：
  * **确定事实**：11/3 必须交**英文** slides。中文是非常紧凑的语言，一旦把第 3、4、5、7、15、16 页的中文表格和要点翻译成英文，字数和占用的面积会膨胀 30%–50%，现有的排版一定会爆，或者字号被迫缩得很小。
  * **回应第 21 页问题 2 和 4**：
    * **问题 2（机构深度）**：双升降柱为主、剪叉为对比，加上选型计算、力-速度核对、尺寸包络和 CAD 动画，**工作量完全够了**。但必须一句话说清两根柱怎么防卡死（例如：自带霍尔编码器通过厂家控制盒同步 + 滑架导轨刚性连接）。
    * **问题 4（精简与时间）**：15 分钟讲 19 页太赶（平均每页不到 50 秒）。我在邮件第 6 条说过“主 slides 不要太多，细节放附录”。
* **怎么改**：
  * **主 slides 砍到 14–15 页**：
    * 删掉第 2 页（目录页，口头带过即可）。
    * 合并第 6 页和第 9 页（直接用 CAD 动画讲五步使用过程和状态切换）。
    * 把第 5 页（现有方案大表格）精简为第 7 页（方案比较）左侧的引子，完整对比表放附录。
  * **立刻重绘第 10、11、13、14 页的英文图**：字号放大一倍，去掉冗余图例；第 14 页的 8 个小图在主 slide 里只放最核心的 3–4 个（正常、慢/快对比、半途坐回、传感器故障），其余 4 个放进附录。这样观众才能看清你们漂亮的仿真结果。

---

### 现场答辩我最想问你们的 3 个问题（请提前准备）：
1. **关于使用闭环**：“老人站起来去上完厕所回来，座板还停在 0.66 m 的高处（或者因为空载 5 秒自动降回去了？第 13 页状态机写 `seat + footplate empty 5 s -> RESET_EMPTY`）。如果老人回来想直接回床上睡觉，这个占了床边 0.66 × 0.80 m 的台架和 L 形扶手，会不会挡住他上床的路？”（注意：你们第 13 页状态机里有 `RESET_EMPTY` 5秒空载自动复位，但第 6、13 页文字又强调“离座后停在原高度接住人”，这两者是矛盾的！停 5 秒就降下去，那 6 秒后头晕坐回来不就坐空了吗？必须想清楚！）
2. **关于人体工学**：“老人在夜里迷迷糊糊坐起来，要从软床垫往前挪 25–30 cm 坐到一块只有 22 cm 半宽的硬座板上，座板和床垫交界处如果因为床垫下陷卡住屁股怎么办？”
3. **关于速度控制**：“给我讲讲 t = 0 刚握紧开关时，座板受力和速度是怎么从零开始变化的？”

---

### 总体判断与最值得先做的一件事

**总体判断**：这是一份可以冲击 A 档的优秀草稿。问题定义精准，生物力学建模（第 7 页）完美支撑了“为什么要升到 0.66 m”这一核心价值，状态机和安全边界考虑得很周全。目前阻碍你们拿高分的不是思路，而是**工程具象化（CAD/FEA 缺位）**和**控制逻辑里的两处细节自相矛盾（起步死锁、离座保持 vs 5秒空载复位）**。

**最值得先做的一件事**：**今天之内把 SolidWorks 装配体和运动动画做出来（角色 3 牵头，角色 4 配合定下固定件和滑架尺寸）**，用这套真实的 3D 模型替换掉第 1、6、8、9、19 页简陋的 2D 火柴人方块图——这不仅直接满足我的核心给分点，也是角色 4 完成重心复核与 FEA 的唯一前提。
