xiaweiyi0423/me5412-bedexit-proposal/presentation/audit/v4/gemini_open_1.md

<!-- model: gemini-4-argon; finishReason: STOP; usage: {"promptTokenCount": 148738, "candidatesTokenCount": 4987, "totalTokenCount": 153725, "promptTokensDetails": [{"modality": "TEXT", "tokenCount": 125638}, {"modality": "IMAGE", "tokenCount": 23100}], "candidatesTokensDetails": [{"modality": "TEXT", "tokenCount": 4987}]} -->

作为外部审阅者，在通读了你们的全部 slides、讲稿、设计网页、总结文档和 Python 代码后，我必须先肯定：这在一个大学课程项目里是非常少见的扎实工作。你们不仅把几何、静力学、坐垫刚度和状态机串成了一条完整的工具链，而且在经过前几轮审计后，已经把大部分常见的设计漏洞（如单侧偏载、断电自锁、人不在台上的倾翻、路径截断 bug）补上了。

正因为主体框架已经很严密，现在最可能让你们在答辩或终稿里失分的，不再是宽泛的概念问题，而是**代码实现与幻灯片承诺之间的不一致、力学计算里的漏项，以及网页/文档中残留的旧版本自相矛盾**。

以下是我判断目前最重要的 6 个问题，按重要性从高到低排列。

---

### 1. 【严重度：高】控制器代码与汇报核心承诺矛盾：“体重转到脚上才提速”和“启动前自检”根本没写进代码

- **在哪里：**
  - Slide 12（传感与交互）：文字与讲稿。
  - 网页第 13 节（PPT 第二轮审计后改的控制和安全规则）。
  - 代码文件 `model/calc_v13/controller_seat.py` 中的 `Controller.step()` 和 `run()`。
- **原文与代码证据：**
  - Slide 12 写：“4 踏板测力：脚踩实了没有；体重是不是真的转到了脚上”、“自检：空着时查零点”。
  - 网页第 13 节明确写：“速度规则加互锁。速度限在 0 到最快速度之间；**座板力下降要伴随踏板力上升才提速**，人挂在横杆上时限速。”
  - 但看 `controller_seat.py` 第 62–72 行的 `LIFTING` 状态代码：
    ```python
    elif s == "LIFTING":
        if not z["grip"] or bar_mag < P.grip_thr or not z["cop_ok"] or z["F_feet"] < P.feet_thr:
            self.go("STOPPED", "松手或条件不满足：停住并制动")
        else:
            v_cmd = float(np.clip(P.k * (P.F_cap - self.fs_f), 0, P.vmax))
            if z["F_bar"] > P.hang: v_cmd = min(v_cmd, 0.3 * P.vmax); self.limited = True
    ```
    以及第 54 行的自检激活条件：
    ```python
    check = ((self.state == "LIFTING") or (self.state == "LOWERING" and occupied)) and self.h > H0 + 0.03
    ```
- **为什么是问题：**
  - **已确认的事实 1：** 速度公式 `v_cmd = clip(P.k * (P.F_cap - self.fs_f), 0, P.vmax)` 只看座板力 `fs_f` 的下降，**完全没有检查踏板力 `F_feet` 是否相应上升**（只检查了 `F_feet > 0.30 BW` 这个静态门槛）。
  - **已确认的事实 2：** 在你们设计的第 7 个仿真场景 `mattress`（坐上时大腿还压在床垫上 0.2 BW）中，当座板刚开始从 `H0` 抬升时，由于 `self.h <= H0 + 0.03`，三力之和自检 `check` 是**关闭**的。此时如果老人不是靠双腿发力踩踏板，而是把身体往后缩、把重量移回床垫上，座板力 `fs_f` 同样会降到 `0.5 BW` 以下，机器就会误以为老人在发力起身而盲目加速抬升！这直接违背了网页第 13 节的承诺和老师邮件第 3 条对安全互锁的看重。
- **怎么改 / 怎么确认：**
  - 在 `Controller` 里记录进入 `SEATED` 时的基准踏板力 `F_feet_0`，在 `LIFTING` 算速度时，用 `min(P.F_cap - self.fs_f, z["F_feet"] - F_feet_0 + margin)` 或要求 `d(F_feet)/dt` 与 `-d(F_seat)/dt` 匹配；或者把三力之和自检从 `SEATED` 准备进入 `LIFTING` 的那一刻（`h >= H0`）就开启，而不是等到升起 3 cm 以后。改完重跑 `controller_seat.py` 只需 2 秒钟。

---

### 2. 【严重度：高】单侧悬臂滑块的受力计算漏掉了“座板前后偏载（俯仰力矩）”，且力合成方式不符合导轨样本规范

- **在哪里：**
  - Slide 8 讲稿指南、Slide 10（驱动选型）、网页第 5、6 节。
  - 代码文件 `model/calc_v13/seat_1dof_slider.py`（第 83–95 行）和 `seat_1dof_v5_checks.py`（`forces()` 函数，第 95–105 行）。
- **原文与代码证据：**
  - Slide 10：“双导轨、每轨两个滑块：偏载悬臂 659 N·m，每个滑块约 3.1 kN”。
  - 在 `seat_1dof_slider.py` 第 92 行算平面内受力时，代码写的是：
    ```python
    # choose fl so the carriage moment is zero if possible (link takes the rotation)
    fl = -m2(C - X, Fv) / m2(Y - X, uL)
    rest = -(Fv + fl * uL); fs = rest @ d_; fn = rest @ nr
    ```
    算出了导轨平面内的法向力 `fn` 最大为 **2080 N**（网页第 5 节表格：“滑块法向力 2080 N”）。
  - 但在 `seat_1dof_v5_checks.py` 的 `forces()` 里算每个滑块的受力时：
    ```python
    Mx = F * (Y["rail"] - yl); Me = Mx * abs(e[0]); Mn = Mx * abs(nf[0])
    Fr = Me / RAIL_GAP; Fc = Mn / CARR_SPAN
    ... per_carriage_lateral_N=round(Fr / 2 + Fc / 2)
    ```
- **为什么是问题：**
  - **已确认的事实 1（方向与分量搞混）：** `Fr`（2465 N）是两根导轨分担侧倾力矩产生的**垂直于侧板平面（y 方向）**的拉压力；而 `Fc`（3639 N）是同一导轨上两个滑块分担偏航力矩产生的**导轨平面内（nf 方向）**的力。这两个力互相垂直，而且 `Fc` 所在的平面内本来还有 `seat_1dof_slider.py` 算出的 2080 N 平面法向力 `fn`！`forces()` 函数既把互相垂直的 `Fr/2` 和 `Fc/2` 直接标量相加，又把平面内的 `fn = 2080 N`（分到 4 个滑块每个约 520 N）漏掉了。
  - **已确认的事实 2（铰点位置不一致导致的附加俯仰力矩）：** 在 `seat_1dof_v5_checks.py` 的 `carriages()` 函数里，4 个滑块分布中心在 `P1 + 0.075 * e`（即铰点 `c1` 往导轨上方偏移 75 mm 处），而铰点 `c1` 在滑块板下端 `P1`。平面内的力 `fn`（2080 N）和丝杠推力作用在 `P1` 上，对滑块群中心会产生约 $2080\text{ N} \times 0.075\text{ m} \approx 156\text{ N}\cdot\text{m}$ 的俯仰力矩，这会让上下滑块承受一正一负的附加法向力（约 $\pm 520\text{ N}$）。
  - **影响：** 虽然 15/20 号导轨的额定静载荷很大（>15 kN），不会因此颠覆“双导轨可行”的结论，但如果老师或助教懂机械设计、细看你们的自由体图，会立刻发现平面内法向力 2080 N 在滑块校核时凭空消失了。
- **怎么改 / 怎么确认：**
  - 在 `seat_1dof_v5_checks.py` 的 `forces()` 中，明确写出每个滑块的两个正交分量：垂直于侧板的力 $F_y = F_r / 2 \approx 1.23\text{ kN}$，导轨平面内的法向力 $F_n = F_c / 2 + F_{\text{normal, in-plane}} / 4 + \Delta F_{\text{pitch}} \approx 1.82 + 0.52 + 0.52 \approx 2.86\text{ kN}$，合力或等效载荷约 3.1–4.1 kN。这样物理逻辑完全闭合，而且最终数字（约 3–4 kN）几乎不用改。

---

### 3. 【严重度：中】网页与总结文档多处残留旧方案（v5.2），与 Slides（v5.5/v5.6）的核心安全逻辑直接打架

- **在哪里：**
  - 设计网页第 6、9、12 节 vs. 第 13、14 节及 Slides 10、12、13。
  - 设计总结文档 5.2 节 vs. 5.3–5.6 节。
- **原文证据：**
  - **矛盾 A（拉索拨杆位置）：** Slide 10 和网页第 6 节写拨杆在“**立柱侧带护盖**”（防止误触）；但网页第 9 节“交给 CAD / 仿真”的清单第 3 条写：“**拉索拨杆在握把旁**”，第 12 节表格 B3 也写“拉握把旁的拉索拨杆就降”。
  - **矛盾 B（回床与空载自动复位）：** Slide 4、13 反复强调核心安全原则是“**只有人按住‘降’才往下动，不自动下降**”；但网页第 12 节表格 C3 写：“人离开、踏板也空了几秒后，**座板降回与床齐平（空载复位）**”，网页第 12 节末尾“还没收尾的事”第 3 条还在写“控制组：空载复位的条件和时间”。
  - **矛盾 C（底座四角称重）：** Slide 12 明确写“**不用底座称重**：台架和床固定后，一部分力经固定件传给床，底座测不准”；但网页第 12 节表格 B6 写：“**体重自检改用底座四角的测力单元**（对地总反力减去自重）”。
  - **矛盾 D（总结文档开头）：** 设计总结文档第 1–2 页（“流程与结果”）没有任何历史版本提示，直接写“采用**双曲线导轨**……前倾不超过 30°……前倾 30° 时人往回坐，要靠控制器放平座面”。第一次打开这份文档的审阅者会以为你们做的是 30° 双曲线槽。
- **为什么是问题：**
  - 你们在 Slide 20（附录目录）里把“单自由度坐板设计”作为答辩备用材料。如果老师在 consultation 或终稿审阅时点开网页第 9、12 节或总结文档，会看到和主 slides 完全相反的设计决定，显得团队内部信息没有同步。
- **怎么改：**
  - 全局搜索网页和总结文档中的 `握把旁`、`空载复位`、`底座四角`，全部替换或加上“（v5.3 已改为……）”的注记；在总结文档最开头加一行醒目的说明：“本文档按时间顺序记录第 1–5.6 版的演进，当前最终方案见文末 5.2–5.6 节”。

---

### 4. 【严重度：中】生物力学模型里“81 位用户”共用同一个 60 kg 体重和同一套绝对肌力，身高 1.75 m 用户的“高费力”很大程度是模型假象

- **在哪里：**
  - 代码 `model/model.py`（`Subject` 类，第 54–86 行）、`model/calc_v13/seat_1dof_design.py`（`path_of` 等）。
  - 网页第 8 节（81 人验证大表）。
- **代码与数据证据：**
  - 在 `model.py` 中，`Subject(H=H)` 改变了身高 `H`，因此小腿、大腿、躯干长度和重心高度都按 `H` 放大了（力臂变长 $\propto H$），但默认质量 `M: float = 60.0` 和所有关节最大肌力 `knee_ext: float = 75.0` 等**全部是固定常数**。
  - 在 `seat_1dof_design.py`、`seat_1dof_slider.py` 等所有 81 人脚本里，创建用户都是 `Subject(H=H)`，从未传入随身高或胖瘦（`r_b`）缩放的 `M` 或肌力。
  - 看网页第 8 节验证表：1.50 m 用户的放手费力（`effort`）在 `0.07–0.28` 之间；而 1.75 m 用户的放手费力普遍在 `0.28–0.36` 之间。
- **为什么是问题：**
  - **已确认的事实：** 在你们的代码里，一个 1.75 m、偏胖（`r_b = 11 cm`）的人，和一个 1.50 m、偏瘦（`r_b = 7 cm`）的人，体重都是 60 kg，膝关节最大伸展力矩都是 75 N·m。1.75 m 的人费力大，纯粹是因为腿长了 17%、重力力臂大了 17%。
  - 虽然网页第 10、12 节角落里有一句“体重和肌力没有随身高缩放”，但在 Slide 7、8、16 里，你们把“81 人（三种身高 × 三种胖瘦 ×……）”当作覆盖不同体型人群的核心验证证据。如果老师问：“偏胖（11 cm）和偏瘦（7 cm）在力学模型里体重差多少？”答案是“一斤不差，只改了臀部画圆的半径 `r_b`”。这在答辩被追问时会非常被动。
- **怎么改 / 怎么确认：**
  - **最便宜的确认/话术修正：** 在 Slide 16 讲稿指南的问答里（“问：81 个用户是怎么来的？”），不要笼统说“三种胖瘦”，要诚实说明：“这 81 个组合主要是**几何与运动学包络检验**（身高改变各段长度，臀厚改变坐姿髋高和后侧轮廓）；力学上由于关节力矩和体重同比例缩放会互相抵消，我们统一按 60 kg 基准比相对值。”（注：如果把肌力按体重同比例缩放，effort 其实只随身高 H 线性变化，不会随体重变化，把这个物理道理讲出来反而能加分）。

---

### 5. 【严重度：中】待补的 SolidWorks CAD 运动动画和 FEA 是 11/3 终稿的最大交付风险

- **在哪里：**
  - 老师 10/26 邮件要点第 4 条（“要展示 CAD 模型和运动动画”）。
  - Slide 8、9、10、11、16 的“待补”框。
- **证据：**
  - 目前 Slide 1、6、8、9、12、15 的所有图全部是 Python（matplotlib / 2D 坐标投影）生成的示意图。Slide 8 的三维图明确标了“由二维模型的坐标画出，截面尺寸为估计值，不是 CAD”。
  - Slide 8 讲稿指南待补第 2 条甚至有一处文字截断：“FEA：除了应力，算悬臂座板在 150 kg 偏载下外端的下沉（目标 · 角色 4 · 11/3”。
- **为什么是问题：**
  - 距离 11/3 交英文终稿只剩 7 天。你们在算法和 2D 模型上投入了极高的精力（写了几千行 Python），但角色 3（CAD 与运动动画）和角色 4（FEA 与真实质量复核）的交付物在当前 slides 里几乎是空白。
  - 特别是悬臂座板：单侧支撑、悬臂长约 45–50 cm、承受 1500 N 偏载（659 N·m），如果支架截面设计得不够高或箱体侧板太薄，座板外端下沉很容易超过 1–2 cm，这会直接影响你们在 2D 模型里算得极其精细的“前倾角 $\le 15.7^\circ$”和“离床间隙 2.1 cm”。
- **怎么改：**
  - 在 10/27 consultation 后，建议立刻冻结 Python 模型（不要再改轨迹和坐垫代码了），把人力集中到 CAD 建模、SolidWorks Motion 导出视频、以及悬臂支架 + 机构箱侧板的静力 FEA 上。先把 Slide 8 指南里截断的目标写完整（例如：外端竖直下沉 $\le 5\text{ mm}$，折合侧倾角 $\le 0.6^\circ$）。

---

### 6. 【严重度：低】汇报节奏与英文转换：内容密度过高，且有轻微的数据笔误

- **在哪里：**
  - Slide 2（汇报结构）vs. 各页计划时长之和。
  - Slide 14 讲稿指南 vs. 网页第 8 节。
- **证据：**
  - **时长矛盾：** Slide 2 写“主 slides 19 页，约 16 分钟”，背景说明目标约 15 分钟；但把第 1–19 页标注的“计划时长”加起来是 $0.3+0.3+1.0+0.8+1.0+1.0+1.3+1.0+0.7+0.8+1.3+0.9+1.0+1.2+1.0+1.0+0.5+0.5+0.3 = 15.9$ 分钟，且中文讲稿非常紧凑。翻译成英文后，同样信息量的口语耗时通常会增加 15%–20%，5 个人轮流上台交接还会吃掉约 1 分钟，极大概率会超时。
  - **数字笔误：** Slide 14 讲稿指南第 4 个问答写：“参考用户做到这一步的 effort 约 0.16，比放手时（**0.25**）还低”；但网页第 8 节表、第 14 节正文以及 `seat_support_slider.py` 算出的 1.60 m 参考用户（`H1.60 r0.09 p1.0 xa0.29`）放手费力都是 **0.247**（或 `slider.json` 中位数 0.262），网页 5.4 节文档又写成了 **0.265**。
- **怎么改：**
  - 转英文 slides 时，主 slides 的文字量至少要砍掉 30%（尤其是 Slide 6、7、10、15 的大段中文句子，改成短语词组）。
  - 把 1.60 m 参考用户的放手 effort 统一核对为 `0.25`（0.247 四舍五入）并在文档 5.4 节同步改掉 `0.265`。

---

### 总体判断

这是一个**分析深度远超一般本科/硕士课程要求的优秀项目**，尤其是从人体起身轨迹反推单自由度斜导轨机构、再结合坐垫压缩和防跌落三种边界摔法的定量对比，逻辑非常有说服力。

明天（10/27）和老师 consultation 时，这份草稿完全能拿得出手；你们在第 21 页准备的 4 个问题也很准。但在 10/27 到 11/3 的最后一周里，请务必完成三件事：**① 把控制器代码里缺失的“踏板力上升互锁”和“起始位自检”补上；② 清理网页与文档中残留的旧版矛盾说法（拨杆位置、空载复位、底座称重）；③ 停止在 2D Python 模型上继续内卷，全力保住 SolidWorks CAD 动画、悬臂 FEA 和精炼的英文 Slides。**
