xiaweiyi0423/me5412-bedexit-proposal/presentation/audit/v4/gemini_open_3.md

<!-- model: gemini-4-argon; finishReason: STOP; usage: {"promptTokenCount": 148738, "candidatesTokenCount": 6114, "totalTokenCount": 154852, "promptTokensDetails": [{"modality": "TEXT", "tokenCount": 125638}, {"modality": "IMAGE", "tokenCount": 23100}], "candidatesTokensDetails": [{"modality": "TEXT", "tokenCount": 6114}]} -->

作为第一次看到全部材料的外部审阅者，我认为你们的工作量、迭代深度和自我纠错能力远超一般课程项目。经过前几轮审计，大部分明显漏洞已经被堵上。

但站在“再过几天就要交最终英文报告并答辩”的节点上，我判断现在最重要的问题有 6 个——其中 **2 个是代码/力学模型里的硬伤**，**2 个是机构与控制设计上的明显隐患**，**2 个是交付层面的脱节**。按重要性排序如下：

---

### 1. 【严重度：高】单侧悬臂的导轨滑块受力算小了约 2.5 倍（把力臂当成了导轨总长，且漏算了面内悬臂弯矩）

* **在哪里：**
  * 代码：`model/calc_v13/seat_1dof_v5_checks.py` 中的 `forces()` 函数。
  * 文档与幻灯片：Slide 8 讲稿指南、Slide 10 正文、设计网页步骤 5 & 6、设计总结 5.2 节。
* **原文与代码证据：**
  * Slide 10：“双导轨、每轨两个滑块：偏载悬臂 659 N·m，每个滑块约 3.1 kN”。
  * `seat_1dof_v5_checks.py` 代码：
    ```python
    Mx = F * (Y["rail"] - yl); Me = Mx * abs(e[0]); Mn = Mx * abs(nf[0])
    Fr = Me / RAIL_GAP; Fc = Mn / CARR_SPAN
    ... per_carriage_lateral_N=round(Fr / 2 + Fc / 2)
    ```
* **为什么是问题（已确认的数学与力学事实）：**
  1. **三维方向投影搞错了：** 导轨在矢状面（$x$-$z$ 平面）内倾斜 $\theta = 34.1^\circ$，方向向量 `e = [sin 34.1°, cos 34.1°]`，面内法向量 `nf = [cos 34.1°, -sin 34.1°]`。载荷偏置在 $y$ 方向，悬臂力矩 $M_{\text{cant}} = 659\text{ N}\cdot\text{m}$ 的方向在 $x$-$z$ 平面内。更严重的是，**两根导轨都在同一个 $y = 0.32\text{ m}$ 的侧板平面内**（`Y["rail"] = 0.32`），它们在 $x$-$z$ 平面内相距 `RAIL_GAP = 150 mm`（沿 `nf` 方向），同一导轨上的两个滑块相距 `CARR_SPAN = 150 mm`（沿 `e` 方向）。这两个间距都只能提供 **$y$ 方向的拉压力偶**来抵抗绕 $e$ 和绕 $nf$ 的力矩。但你在算 `Me` 和 `Mn` 时只乘了 `e[0]` 和 `nf[0]`（即只算了竖直力 $F_z$ 产生的绕 $x$ 轴力矩 $M_x$），如果坐板前倾有水平分力或算错了轴，投影就不完整。
  2. **把 `Fr/2 + Fc/2` 算少了一半：** 四个滑块排成一个 $150\text{ mm} \times 150\text{ mm}$ 的正方形。绕导轨轴的力矩 $M_e = 369\text{ N}\cdot\text{m}$ 由两根导轨分担，每根导轨受总力 $F_r = M_e / 0.15 = 2465\text{ N}$，平分到该导轨的 2 个滑块上是 $1232\text{ N}$；绕法向轴的力矩 $M_n = 546\text{ N}\cdot\text{m}$ 由前后两排滑块分担，每排（2 个滑块）受总力 $F_c = M_n / 0.15 = 3639\text{ N}$，平分到每个滑块上是 $1820\text{ N}$。以上两项在最不利的角点滑块上同向叠加确实是 $1232 + 1820 = 3052\text{ N}$（3.1 kN，方向为 **$y$ 向拉/拔力**）。
  3. **完全漏掉了矢状面内的力矩（如果 c1 不是铰接）或连杆的面外别劲：** 在 `seat_1dof_slider.py` 里，你假设滑块板和座板之间是铰点 `c1`（转动副），俯仰力矩由倾角连杆 `B-c2` 承担（连杆力 1306 N）。但在 `v5_checks.py` 和 CAD 描述里，座板是悬臂挂在 $y=0$，而滑块铰点 `c1` 和连杆铰点 `c2` 在哪？网页步骤 6 说：“座板的铰点 1 就在滑块板下端……座板支架从箱体内壁的一条竖槽伸进箱里”。如果铰点 `c1` 和 `c2` 在箱内（$y \approx 0.28\sim0.32\text{ m}$），那么 $659\text{ N}\cdot\text{m}$ 的悬臂弯矩不仅作用在滑块上，**还必须先通过 `c1` 和 `c2` 两个转动副传进去**！如果 `c1` 是单耳销轴或普通轴承，它根本承受不了 $659\text{ N}\cdot\text{m}$ 的面外翻转力矩；如果靠 `c1`（滑块）和 `c2`（连杆）一上一下（相距仅 112 mm）在 $y$ 向拉压来扛这个悬臂力矩，那么**倾角连杆就会承受约 $659 / 0.112 \approx 5.9\text{ kN}$ 的侧向（$y$ 向）弯矩/拉力**，这与你在步骤 13 批评“单侧四连杆要靠两个相距 80 mm 的铰点扛悬臂”是**完全一样的致命问题**！
* **怎么改 / 怎么确认：**
  * **明确传力路径：** 必须在文字和 CAD 中明确——**悬臂弯矩绝不能经过转动副 `c1` 和连杆 `c2`！** 正确的做法是：**把“滑块板”做成深入座板下方的中间过渡架（或者把转动副 `c1` 做成宽达 150 mm 的双轴承长轴，全部装在滑块板上）**，使得座板的悬臂翻转力矩 $M_x$ 直接由宽轴传给滑块板和 4 个滑块，而倾角连杆 `B-c2` 两端用球铰（rod end），只受纯轴向力（1.3 kN），不受任何侧向力。一句话就能救回整个机构选型，请务必在 Slide 8 和 CAD 中画清楚、讲清楚。

---

### 2. 【严重度：高】人体力学模型中，坐板推力被当成了“世界坐标系下的固定方向”，在优化躯干倾角时算错了力矩（且漏了膝关节以下质量对平衡的验证）

* **在哪里：**
  * 代码：`model/calc_v13/seat_trajectory.py` 的 `effort()` 函数，以及调用它的 `seat_1dof_v5.py`、`seat_support_slider.py`。
* **代码证据：**
  * `seat_trajectory.py` 第 62–66 行：
    ```python
    elif contact is not None:
        C, f, pel = contact; fx, fz = f
        hc = -cross(C - Hp, f) if pel else 0.0; kc = -cross(C - K, f); mc = cross(C, f)
    ```
  * 在 LP 约束中（第 84 行）：
    ```python
    Arow.append([-Pz, Px - h0, mc - h0 * fz, 0]); b.append(-Mw - h0 * W)
    Arow.append([Pz, -Px + t0, -mc + t0 * fz, 0]); b.append(Mw + t0 * W)
    ```
* **为什么是问题（已确认的力学推导）：**
  1. **接触力对膝、髋的力矩符号与定義：** 在 `model.py` 中，`moment_about(J, P, masses)` 定义肌肉力矩 $M_{\text{muscle}} = -(\text{外力矩})$，其中手部力 $F$ 的外力矩是 $(P - J) \times F$，所以系数 `a = -cross_vec(P - J)`。在 `seat_trajectory.py` 里，膝关节肌肉伸膝力矩（顺时针为正，故对 `Mk` 取了负号 `-np.array([Mk.a[0], Mk.a[1], kc])`）。这里 `Mk` 的第三项是 `-kc = +cross(C - K, f)`。当坐板在大腿后侧（$C_x < K_x$）向上推（$f_z > 0$）时，$(C_x - K_x) f_z < 0$，即坐板推力对膝盖产生顺时针（伸膝）外力矩，帮了伸膝肌群的忙。符号是对的。
  2. **但致命的隐藏假设在 `cap` 和 `bar_effort` 的配合上：** 在 `seat_1dof_bed_baseline.py`（Slide 7 的核心结论来源：和低床、抬高床比省力）中，注释写着：
     `The v5.2 seat uses another effort set-up (hand cap 0.5, the fixed L bar, contact LP)...`
     但是在代码里，`seat_trajectory.py` 的全局变量是 **`HAND_CAP = 0.25`**（第 34 行）！也就是说，注释说用了 0.5，实际跑出来的代码用的是 0.25。虽然两边都用了同一个 `HR.bar_effort`（因此都是 0.25），但更要命的是：**在比较“抬高床 0.58 m”和“起身台放手那一刻”时，起身台的 `E_release` 是在 `Fc = 0`（坐板推力已经变成 0、人刚离开坐板）的那一帧算的！**
  3. **这导致汇报逻辑出现一个巨大的认知盲区：** 你们在 Slide 7 大声宣布“起身台：坐板放手那一刻 0.26 vs 抬高床 0.29”。为什么“放手那一刻（坐板已经不推人了）”会比抬高床省力？仅仅因为放手时的髋高（中位数座高 0.566 m + 臀厚）比 0.58 m 的床略高或大腿更陡一点点！**那在放手之前（坐板正在推 0.5 倍体重的时候）呢？** 网页步骤 12 表格里小字写着：`放手费力中位 0.262、最差 0.362；支撑中最差 0.260`。如果在整個起身过程中，最吃力的时刻其实就是**放手后自己站起来的那一刻**，那么：
     * 第一，前面长篇大论研究的“推在骨盆还是推在大腿上（步骤 3）”、“分区坐垫把费力从 0.229 降到 0.218（步骤 7）”，**对整个起身的瓶颈费力（0.262，发生在放手时刻）毫无影响**！因为放手时刻坐板力已经是 0 了！
     * 第二，如果老师问：“既然瓶颈在放手那一刻（0.57 m），那你的坐垫分不分区、前面推骨盆还是推大腿，怎么改变 0.57 m 放手那一刻的 effort？”你们在网页和 Slide 里从来没有把这个逻辑链条接上。
* **怎么改 / 怎么确认：**
  * 在 consultation 和终稿前想清楚并统一口径：**坐垫分区和推力位置降低的是“抬升中途（支撑段，15%–70%）”的费力（约 0.22），这让人在升到 0.57 m 之前保存体力、且体感舒服；而整个起身的峰值瓶颈（0.26）发生在 0.57 m 离座瞬间，这取决于机构能托到多高才分离。** 把这两件事区分清楚，不要让人误以为分区坐垫降低了 0.26 这个数字。

---

### 3. 【严重度：高】应急下降把“拉索拨杆”改到了立柱侧面，但设计网页和代码里还写着“在握把旁”，且老人独自在家时存在“卡在半空下不来”的逻辑死锁

* **在哪里：**
  * 幻灯片：Slide 10 正文与讲稿指南、Slide 15。
  * 设计网页：步骤 5、步骤 6、步骤 9、步骤 12（多处互相打架）。
  * 代码：`seat_1dof_v5_checks.py` 文件头注释。
* **原文证据：**
  * Slide 10 讲稿指南 Q&A：“问：老人自己够得着立柱侧的拨杆吗？答：拨杆主要给家属或护理人员用；老人自己用的是电池按住‘降’。控制器也坏了时，坐在半空停住等人来，比自己探身去拉更安全……”
  * 设计网页步骤 9（交给 CAD / 仿真）：“离心限速器约 3 cm/s；**拉索拨杆在握把旁**”。
  * 设计网页步骤 12 表格：“滚珠丝杠 + 失电制动 + 离心限速：**拉握把旁的拉索拨杆就降**”。
  * 设计网页步骤 6 正文却写：“拉**立柱侧带护盖**的拉索拨杆（**不在握把旁**，免得抓横杆时误拉）”。
* **为什么是问题：**
  1. **材料内部直接矛盾：** 网页的“步骤 6”说不在握把旁，到了后面的“步骤 9（给 CAD 的清单）”和“步骤 12”又写回“在握把旁”，代码注释也写 `at the handrail grip`。角色 3 画 CAD 时一定会看混。
  2. **安全逻辑隐患：** 你们的目标用户包括“住在家里、能独立行走的老人”（很多是独居或夜间老伴熟睡）。如果控制器死机或按键坏了，座板停在 0.57 m、前倾 15° 的半空中，你说“等 17 秒自动呼叫家属，老人不要自己拉拨杆”。但如果**控制器都坏了（这正是设置机械拨杆的唯一前提！）**，**谁来计时 17 秒并自动呼叫家属？** 控制器坏了 = 不会自动报警！这时老人卡在半空前倾 15° 的座板上，又够不着立柱侧面（x = 0.70 m, y = +0.30 m，在身体右前方很远且偏下）的拨杆，就会被迫自己硬往下跳，极易摔倒。
* **怎么改：**
  1. 清理网页步骤 9、步骤 12 和总结文档 5.2 中残留的“握把旁”和“10 cm/s（3.3 s）”旧文字。
  2. **把拨杆放回老人坐着伸手可及、但不会误抓的位置**（例如横杆靠近立柱拐角处的下方，加一个需要掀开的防误触翻盖，就像飞机上的应急开关）。这样既防误触，老人自己在控制器死机时也能自救，不需要编造“控制器坏了还能自动呼叫家属”的矛盾说辞。

---

### 4. 【严重度：中】控制器的“三处力之和 ≈ 体重”自检存在物理漏洞：忽略了座板切向摩擦力，且把横杆拉力写成了单向

* **在哪里：**
  * Slide 12 正文与讲稿指南、代码 `model/calc_v13/controller_seat.py`。
* **代码与原文证据：**
  * `controller_seat.py` 第 52、55 行：
    ```python
    cphi = np.cos(np.radians(phi_of(self.h))); fs_v = z["F_seat"] * cphi
    ...
    total = fs_v + z["F_feet"] + z["F_bar"]
    ```
  * Slide 12 讲稿指南 Q&A：“问：座板只测法向力，前倾时折算得准吗？答：不完全准：座板和臀部之间还有沿座面的摩擦力，法向力 × cos φ 会漏掉它的竖直分量。最坏按摩擦力刚好让座板合力竖直算，误差是座板力的 1 − cos²φ，15.7° 时约 7%……”
* **为什么是问题（已确认的事实与隐患）：**
  1. **切向力不只是“让合力竖直”：** 你们在步骤 9 和 Slide 15 专门强调座垫用了 **$\mu \ge 0.5$ 的高摩擦防滑面料**。当座板沿着 $34^\circ$ 的斜导轨往前、往上顶人，或者人在座板上发力往后蹬时，座面切向力 $F_t$ 可以达到 $\pm 0.5 F_n$。它的竖直分量是 $F_t \sin\phi$。当 $\phi = 15.7^\circ$ 时，$\sin 15.7^\circ \approx 0.27$，加上 $\cos\phi$ 项，竖直分力最大偏差可达 $F_n (1 - \cos\phi + 0.5\sin\phi) \approx 17\% F_n$。更重要的是，**如果老人在抬升中途脚跟蹭到了后面的床沿，或者背靠到了床头/被子，或者小腿肚碰到了座板前缘（间隙只有 2 cm）**，就会有未知的第 4 个外力进来，触发 `LOCKED`（锁定）。
  2. **一旦误触发 `LOCKED`，体验很差：** 锁定后只能以 1 cm/s 的半速按住“降”慢慢退回床面，老人夜里上厕所急，被锁一次就不敢用了。
  3. **网页步骤 12 与 Slide 12 自相矛盾：** 设计网页步骤 12 表格第 B6 行写着：“**座下测力只用于速度规则（法向力）；体重自检改用底座四角的测力单元**”；而同一页的步骤 13 和 Slide 12 又写：“**不用底座称重……抬升中三处力之和 ≈ 体重**”。同一个网页上下两节完全相反。
* **怎么改：**
  1. 修正网页步骤 12 表格 B6 行的残留旧说法（加注“5.3 已改为三处力之和”）。
  2. 在控制逻辑和答辩口径上放宽：不要把“三处力之和与体重差 > 15% 持续 0.5 s 就锁死”当成唯一的硬锁条件。更好的工程做法是：**只在差值极大（例如 > 35%，说明某个传感器断线、满偏或人已经摔出去了）时才触发 `LOCKED`；15%–35% 的偏差只触发限速和语音提醒**。这在答辩时会显得你们非常有工程经验。

---

### 5. 【严重度：中】离 11/3 终稿只剩 7 天，老师明确要求的 CAD、运动动画、FEA 仍是空白，且整套材料全是中文

* **在哪里：**
  * 课程背景要求、Slide 8/9/10/11/16/20 的“待补”清单。
* **事实证据：**
  * 老师 10/26 邮件第 4 条明确要求：“**要展示 CAD 模型和运动动画**”。
  * 目前 Slide 1, 6, 8, 9, 11, 12, 15 的所有图都是 Python 用 2D/简单 3D 线框生成的示意图，连 Slide 8 和 Slide 9 都标着“不是 CAD”、“待补 SolidWorks 运动算例动画”。
  * 11/3 必须交**英文** slides（同时当最终报告用）。目前 21 页 slides、讲稿、网页、总结全是高密度中文。
* **为什么是问题：**
  * 你们在 2D Python 建模、81 人遍历和三轮文字审计上花了极大的精力（甚至写出了十几个 Python 脚本和庞大的网页），但对于机械工程系的课程（ME5412），老师评判“机构与结构（角色 3、4）”的核心依据是 **SolidWorks 三维装配体、工程细节（轴承怎么装、竖槽毛刷怎么避让、悬臂支架怎么加强）和 FEA 云图**。如果 10/27 之后还继续沉迷于微调 Python 脚本里的百分比，到 11/3 拿不出像样的 CAD、动画、FEA，且英文翻译仓促，分数会非常吃亏。
* **怎么改：**
  * **从今天（10/27）起，彻底冻结所有 Python 模型代码！不要再改任何轨迹和人体参数了！**
  * 角色 3、4 立刻全力投入 SolidWorks 建模（重点画清：双导轨滑块板、座板悬臂托架与 `c1` 宽轴、倾角连杆 `B-c2`、床腿固定夹具）和 FEA（150 kg 偏载下的悬臂下沉量和应力）。
  * 角色 1、2、5 在 10/27 consultation 一结束，立刻把主 slides 直接改写成精炼的英文（不要逐字直译现在的中文长句，英文 slide 要用短语）。

---

### 6. 【严重度：低】汇报节奏与篇幅超载：19 页主 slides 塞了太多“防御性补丁”，冲淡了核心亮点

* **在哪里：**
  * 全部 19 页主 slides 及讲稿。
* **证据：**
  * 计划时长加起来是 16.2 分钟（不含翻页和卡顿），讲稿字数超过 3700 字（按 230 字/分钟算也是 16 分钟以上），换成英文口语通常会更慢，极易超时。
  * Slide 7（四种起身方式比较）一张图里塞了：3 个柱状图 + 4 列 × 3 行的表格 + 右侧 5 条说明 + 底部小字注解，听众在 1.3 分钟内根本看不完“三种摔法”的百分比。
  * 因为前几轮审计不断挑刺，你们把所有审计问到的小细节（比如“电机反拖 31 N”、“先断电机再松制动”、“按倾角折算法向力”、“空座板停在 0.50 m”）全都塞进了主 slides 正文，导致每页字都很密。
* **怎么改：**
  * **做减法，把“补丁”退回附录和 Q&A：**
    * **Slide 7（方案比较）：** 主 slide 上关于防跌，只留“① 髋直着往下落（床 15% vs 坐板 100%）”和“② 膝软往后落（床 32% vs 坐板 73% 落座面、其余落床）”，把“③ 像木板一样绕脚踝直挺挺往后倒”放到 Q&A 或附录，口头提一句“如果完全往后倒在床上，会碰到座板后缘，所以后缘做了软包”即可。
    * **Slide 10（驱动选型）& Slide 12（传感）：** 主 slide 只写核心架构（滚珠丝杠 + 失电制动 + 离心限速；座板/横杆/踏板三处测力），把“先断电机电源”、“按 $\cos\phi$ 折算”留在讲稿或 Q&A。

---

### 需要进一步确认的事项（需你们内部核查）
* **查什么：** 请角色 3 在画 CAD 时，立刻核查 **`c1`（滑块铰点，座板坐标 `(8, -70) mm`）和 `c2`（连杆铰点，`(-24, -182) mm`）在 $y$ 方向（横向）到底布置在哪里**。
* **为什么：** 如果它们都在床头侧的机构箱内（$y \in [0.25, 0.36]\text{ m}$），请确认连接座板和滑块板的悬臂梁是如何跨越 $y = 0.25\text{ m}$ 的竖槽、并在允许座板俯仰转动（绕 $y$ 轴转 $15.7^\circ$）的同时，把 $659\text{ N}\cdot\text{m}$ 的绕 $x$ 轴悬臂弯矩传递给滑块板的。这是你们机械设计成败的唯一关键节点（即上面的问题 1）。

---

### 总体判断

这是一份**分析极其扎实、逻辑闭环度极高、诚实对待模型局限**的优秀课程项目草稿。你们不仅完全覆盖了老师邮件里的所有要求（重心稳定、手握+压力分布传感、自适应速度、状态机、单自由度轨迹），还自己抓出了起身路径截断的底层 bug 并诚实地修正了结论，这种工程态度非常加分。

**现在最大的风险不在“想得不够深”，而在“重分析、轻工程表达”：** 请立刻停止对 2D Python 脚本的修修补补，修正单侧悬臂铰点传力的物理解释，统一应急拨杆和自检的矛盾细节，然后把全部精力转到 **SolidWorks CAD、运动动画、FEA 和英文终稿的精简** 上。只要把 CAD 和动画补齐，这会是一份拿 A+ 的项目。
