xiaweiyi0423/me5412-bedexit-proposal/page/seat1dof/audit/gemini_A_model.md

<!-- model gemini-4-argon, finish STOP, usage {"promptTokenCount": 130468, "candidatesTokenCount": 6508, "totalTokenCount": 136976, "cachedContentTokenCount": 128239, "promptTokensDetails": [{"modality": "TEXT", "tokenCount": 113026}, {"modality": "IMAGE", "tokenCount": 17442}], "cacheTokensDetails": [{"modality": "TEXT", "tokenCount": 111096}, {"modality": "IMAGE", "tokenCount": 17143}], "candidatesTokensDetails": [{"modality": "TEXT", "tokenCount": 6508}]} -->

从**坐→站生物力学建模与推理逻辑**的角度，我对你们的单自由度坐板设计、计算代码和网页进行了审计。以下按严重程度从高到低排列，指出模型假设如何直接制造了部分“核心结论”，以及在汇报中极易被老师问住的逻辑漏洞。

---

### 1. 【严重度：高】“大腿近端 4 cm 是最佳助力点”是人为设置 0/1 阶跃分界线造成的伪影（Artifact）
* **在哪里**：网页步骤 3（助力位置），以及 `seat_trajectory.py` 中的 `effort()` 和 `body_points()` 函数，`seat_1dof_design.py` 的 `assist_job()`。
* **代码与原文证据**：
  ```python
  # seat_trajectory.py
  PELVIS_A = 0.04
  kind_line = np.where(a <= PELVIS_A, 0, np.where(a <= A_MAX, 1, 2))
  ...
  if contact is not None:
      C, f, pel = contact; fx, fz = f
      hc = -cross(C - Hp, f) if pel else 0.0; kc = -cross(C - K, f); mc = cross(C, f)
  ```
  网页步骤 3 结论写：“四个阶段里，最好的位置都是‘大腿近端 4 cm’……结论：助力点放在臀部和大腿交界处（坐骨正下方到大腿近端 4 cm）。”
* **为什么是问题**：
  这是一个典型的**“把建模简化当成了物理规律”**。
  1. 在真实生物力学中，无论外力推在骨盆还是大腿近端，只要在髋关节前方产生向上的力，都会改变大腿段的受力平衡，进而影响髋关节反力和力矩；如果忽略大腿软组织变形，推在大腿上对髋关节力矩的贡献其实只取决于髋关节如何传递载荷。
  2. 而在你们的代码里，用了一个硬性的布尔开关 `pel`（`a <= 0.04`）：当接触点在大腿近端 4.0 cm 时，`pel = True`，外力全部计入髋关节力矩 `hc = -cross(C - Hp, f)`。因为 $a=4\text{ cm}$ 比 $a=0\text{ cm}$（坐骨下方）离髋关节更远、力臂更大，所以算出来的省力效果比坐骨下方还好（0.200 vs 0.235）。而一旦到了 $a=4.01\text{ cm}$，`pel` 突变为 `False`，`hc` 瞬间归零！
  3. 换句话说，“大腿近端 4 cm 最好”完全是因为**它在你们人为划定的 4 cm 悬崖边上蹭到了最大力臂**。如果老师问：“为什么推在大腿 4 cm 比推在坐骨上还省髋关节的力？”你们无法用解剖学解释，因为坐骨结节才是骨盆真正的承重骨点，大腿后侧近端 4 cm 已经是腘绳肌和臀大肌软组织了。
* **怎么改 / 怎么验证**：
  * **改法 1（最诚实、改网页文案）**：不要把“大腿近端 4 cm 最好”当成工程结论。在步骤 3 中直接说明：“骨盆承重区（坐骨附近）能同时帮髋和膝，进入大腿中段后主要只帮膝；4 cm 只是模型里骨盆与大腿的简化分界，平滑过渡后，结论是**越靠近坐骨结节越好**。”
  * **改法 2（改代码）**：把布尔开关 `pel` 改为从 $a=0$ 到 $a=6\text{ cm}$ 的线性衰减权重 $w(a) \in [1, 0]$，即 `hc = -w * cross(C - Hp, f)`。你会发现“4 cm 处的凹坑”立刻消失，最佳点回到坐骨下方（$a \approx 0$）。

---

### 2. 【严重度：高】“81/81 全部合格”与第 7 步“坐垫压缩后托不住、仅 21% 推在骨盆”在同一网页内自相矛盾
* **在哪里**：网页顶部 KPI、步骤 5、步骤 8（验证） vs 步骤 7（坐垫刚度）；代码 `seat_1dof_page_data.py` vs `seat_cushion.py`。
* **代码与原文证据**：
  * 网页开头大字 KPI 和步骤 8 宣称：**“81 / 81 全部指标合格的用户”**，放手费力中位数 0.251。这组数字来自 `track_user()`，使用的是**刚体点接触**（`first_touch` 只要刚体轮廓碰到座面就算完全支撑）。
  * 但紧接着在步骤 7（及 `cushion.json`）里，引入推荐的“中硬坐垫（厚 5 cm）+ 行程到 0.66 m”后，数据显示：
    * `cop_pelvis_share: 0.21`（`cop_a_med_cm: 8.1 cm`）——意味着**79% 的情况下，合力中心落在大腿后侧（中位数 8.1 cm 处），根本没推在步骤 3 所说的“骨盆区（≤4 cm）”**！
    * 在起身 70% 阶段，有 **9/81 人“托不住”**（坐垫下陷吃掉行程，升到顶也压不出 0.5 BW；在 v4 `layout.json` 中也有 3 人托不住）。
* **为什么是问题**：
  逻辑链条断裂。步骤 3 证明“必须推在 ≤4 cm 的骨盆区才省力”，步骤 7 却算出“加上真实坐垫后，压力中心中位数在 8.1 cm，只有 21% 落在骨盆区”；步骤 8 却又退回刚体无下陷模型，宣布“81/81 全部合格，最后支撑髋高 0.69~0.80 m”。
  事实上，坐垫下陷约 2.8 cm，意味着真实放手高度（`release_hz`）会比步骤 8 算出的低约 2.5~3 cm，高个子或晚前移用户的真实放手费力会明显恶化。老师只要把步骤 7 和步骤 8 的表对照看，就会质疑“81/81 合格”的含金量。
* **怎么改 / 怎么验证**：
  * 在步骤 8 和顶部 KPI 中，明确标注“81/81 为刚体几何检验（不计坐垫下陷）”，或者直接把计入中硬坐垫下陷（2.8 cm）后的放手高度与合格率（例如 78/81）报出来。在工程汇报里，78/81 比完美但有漏洞的 81/81 可信得多。
  * 解释清楚为什么 `cop_a_med_cm = 8.1 cm` 是可以接受的：因为对于“髋晚前移”的人，单自由度曲线超前于人体，接触点必然往大腿移（用牺牲一部分髋部省力，换取不前滑和机构单自由度简化）。

---

### 3. 【严重度：高】与主方案 README 的核心安全需求直接冲突（前倾坐回滑脱 vs 离座水平接住）
* **在哪里**：项目 README（第 12 版改动） vs 网页步骤 5、步骤 8、步骤 9。
* **原文与数据证据**：
  * README 明确写：“**取消座板前倾，改为竖直升降。一个推杆驱动的四连杆只有一个自由度，倾角由高度决定，做不到‘离座后停在高处、座板水平’**……离座后座板停在原高度、保持水平，万一坐回去能接住人。”
  * 而在本子设计中，四连杆在行程中段（座面高约 0.52~0.60 m）前倾角高达 **26.7°**（见 `layout.json` `"phi_max": 26.7` 及截图 `05_mech.png` 中 35% 进度时座面前倾 26.5°）。
  * 同时，你们的“坐回余量（catch margin）”定义为：`front_x - (Hp[0] - 0.04)`（`seat_relative_motion.py` 第 108 行），只算了**水平 x 坐标投影**有没有超出座板前缘！
* **为什么是问题**：
  1. **力学上接不住**：当老人在起身中途（比如 35%~60% 进度，此时最容易力竭跌坐）坐回时，单自由度四连杆**卡在 25°~26.7° 的前倾角**。一个 26.7° 的斜面，需要静摩擦系数 $\mu > \tan(26.7^\circ) = 0.503$ 才能不滑（如果算上向下跌坐的冲击动量，需要的摩擦系数更高）。普通居家裤子与坐垫的摩擦系数通常在 0.3~0.45 之间。这意味着即使水平投影余量有 `+0.6 cm`，老人一屁股坐在一个近 27° 的斜坡前缘上，也会**顺着斜坡直接滑到地上**。
  2. **把锅甩给控制器不成立**：网页步骤 9 写“前倾 30° 时如果人往回坐，需要控制器迅速放平座面”。但这是**单自由度机构**！要让座面放平，唯一的办法是让推杆快速缩回（降低高度）。可丝杠自锁推杆的满载缩回速度通常只有 10~30 mm/s，走完 168 mm 行程要 5~15 秒，而老人力竭跌坐只需要 0.3~0.5 秒！控制器在物理上根本来不及通过降高度来放平座面。
* **怎么改 / 怎么验证**：
  * 这是老师在 Consultation 时最可能一针见血指出的安全漏洞（老师邮件第 2、3 点特别强调稳定性和操作安全）。
  * **不要宣称“控制器能迅速放平座面”**（这违反单自由度 + 慢速丝杠推杆的物理事实）。
  * **诚实的辩护逻辑**：
    1. 指出本四连杆设计在行程终点（0.66 m，即真正离座放手的位置）前倾角已经回落到了 **4.7°**（`"phi_end": 4.7`），接近水平！因此**“离座后跌坐”是安全的（4.7° 远小于摩擦角）**。这个亮点你们在网页里居然完全没提，一定要大声讲出来！
    2. 在中途（26.7°）时，老人还没有离座（臀腿一直贴在坐垫上，手握着横杆），此时若停住，靠的是双脚踏板反力 + 手握横杆 + 坐垫摩擦三者共同静平衡，而不是从空中掉下来砸在 27° 斜面上。
    3. 把“坐回余量”的合格线从 `0 cm` 结合斜面倾角做个说明，或者明确规定坐垫表面必须采用高摩擦防滑面料（如硅胶纹理/防滑氯丁橡胶，$\mu \ge 0.6$）。

---

### 4. 【严重度：中】“放手那一刻（Release）”的定义和费力评估忽略了支撑期与放手期的切换断层
* **在哪里**：网页步骤 4、步骤 8；`seat_relative_motion.py` 的 `track()` 和 `summarize()`。
* **代码证据**：
  ```python
  # seat_relative_motion.py
  ok = kind[j] < 2   # kind 2: a > A_MAX (18 cm) or back of buttock
  ...
  if not ok: break
  ```
  `E0_release` 是在上述循环结束前的最后一个 `ok` 点（或者坐板到达 0.66 m 行程终点）处，计算**完全无坐板支撑（`contact=None`）**时的关节费力 `E0`。
* **为什么是问题**：
  1. **只看放手后，不看放手前**：在网页主流程（`seat_1dof_design.py`）中，选曲线和验证 81 人时，**只算了放手那一刻的 `E0_release`**，完全没有校核在坐板支撑阶段（`f = 0` 到 `release`）有没有哪一刻费力比放手时更大！而在你们上一轮的 `seat_trajectory.py`（总结文档第 5 节）里，明明发现过：“按真实接触复算后支撑段更吃力，最差值到 0.47”。这是因为当接触点滑到大腿 15~18 cm 处时，坐板推力只帮膝不帮髋，且法向力向前推人，可能导致支撑段的髋关节或手臂费力反而高于放手点。
  2. **18 cm 断崖式放手**：对竖直升降（V），`A_MAX` 设为了 `12 cm`，而对新坐板设为了 `18 cm`（`seat_1dof_design.py` 第 160 行：`[(u, cv, PAD_AMAX, {}) ...] + [(u, curve_vertical(), 0.12, {}) ...]`）。**给新方案放宽了 6 cm 的接触容差（18 cm vs 12 cm），却和 12 cm 容差的竖直方案同台比合格率（81/81 vs 24/81）**，这在对比实验设计上是不公平的（Confounded comparison）。如果竖直升降也加上 6 cm 圆角托腿垫（你们在 `seat_trajectory.py` 里其实算过 `V deep+bolster`），竖直方案的合格率会大幅上升。
* **怎么改 / 怎么验证**：
  * 在 `track_user()` 中，顺手把支撑段全程的最大费力 `max(Ea_actual, E0_release)` 算出来，确认全行程最大费力真的发生在放手点（或者把全行程最大费力作为指标）。
  * 在对比表旁注明：“竖直方案为现方案（无加长托腿垫，$a \le 12\text{ cm}$）；新方案含前缘托腿垫（$a \le 18\text{ cm}$）”，避免老师质疑你们用了双重标准。

---

### 5. 【严重度：中】“前倾差 11.7° 无害”的结论掩盖了它是如何改变轨迹特性的，且网页文字数字未同步
* **在哪里**：网页步骤 5、步骤 8；`seat_1dof_layout.py` vs `template.html`。
* **原文与数据证据**：
  * 网页步骤 8 正文写：“四连杆走出的轨迹和设计曲线不完全一样（**前倾角最多差约 9°**）”。那是第二版（`fourbar.json`）的数字！到了第四版（`layout.json`），实际采用机构的 `centre_err_mm = 10.5 mm`，`tilt_err_deg = 11.7°`，最大前倾 `26.7°`，到顶时回到 `4.7°`（设计曲线到顶是 `30.7°`！也就是说**在终点处前倾角差了整整 26°，而不是 11.7°**！）。
  * 为什么差了 26° 代码却算出 `tilt_err_deg = 11.7°`？看 `seat_1dof_fourbar.py` 第 88 行：
    ```python
    d = np.hypot(*(Qs[None, :, :] - QT[:, None, :]).transpose(2, 0, 1)); j = d.argmin(1)
    tilt_err_deg = np.abs(ph[j] - PT).max()
    ```
    代码只拿设计曲线 `QT`（最高只到 `0.6285 m`）去匹配四连杆轨迹 `Qs`（最高延长到了 `0.66 m`）的前半段！四连杆在 `0.60 m -> 0.66 m` 这最后 6 cm 行程里，摇杆越过极值点，座板角度从 `26.7°` 迅速回平到 `4.7°`，这一段根本不在 `QT` 的比对范围内！
* **为什么是问题**：
  1. 网页多处文字（如步骤 8 的“差约 9°”、步骤 9 的“前倾 30° 时往回坐”）还停留在旧版本，与图表和 JSON 数据（26.7° 峰值、4.7° 终点、11.7° 误差）对不上。
  2. 更重要的是，**四连杆在顶部从 26.7° 回平到 4.7°，歪打正着解决了一个大问题（顶部放手后座面接近水平，能接住坐回的人），但也带来了一个新问题**：在 0.60 m 升到 0.66 m 的过程中，人的大腿在继续变陡（前倾变大），而座板却在反向回平（前倾变小）！这意味着在这最后 6 cm 里，接触点会加速向座板前缘滚动，前缘托腿垫的局部挤压会加剧。
* **怎么改 / 怎么验证**：
  * 把网页步骤 8 的“9°”和步骤 9 的“30°”更新为第四版真实数据。
  * 把“终点回平到 4.7°”从“轨迹拟合误差”变成你们的**设计卖点**：“我们故意利用四连杆后半程的连杆转角回摆，让座面在支撑中段前倾 26.7° 跟住大腿，而在 0.66 m 顶点自动回平到 4.7°，从而兼顾了中途跟进与顶点水平防跌坐！”——这样解释，原本的拟合误差就变成了精妙的机构设计。

---

### 6. 【严重度：中】“凸圆弧座面不如平座面（74/68/78 vs 81）”是优化器陷入局部最优造成的结论偏差
* **在哪里**：`seat_1dof_summary.md` 第二版总结，`seat_1dof_fourbar.py`。
* **代码与数据证据**：
  * 总结写：“凸圆弧座面没有帮上忙。半径 40/25/18 cm 的圆弧座面，四连杆只能做到 74/68/78 人合格。原因是四连杆要追的目标变成了圆弧圆心的路径，这条路径比座板中心的路径更难追。”
  * 看 `fourbar.json`（及结果摘要 `seat_shapes`）：在理想曲线下（`exact R0.4`、`exact R0.25`），圆弧座面也是 **81/81 合格**，且接触长度从平座面的 `6.0 cm` 增加到了 `7.0 ~ 8.0 cm`！
  * 为什么四连杆（`fourbar R0.4`）掉到了 74/81？看 `seat_1dof_fourbar.py` 的 `cost()` 函数：
    * 对平座面（`R >= 1e2`）：代价函数直接追踪座面中心 `Q`，角度误差权重是 `0.10 * |dphi|`。
    * 对圆弧座面（`R = 0.4`）：代价函数去追踪 `Q - R * n`（座面下方 40 cm 处的虚拟圆心 `Cs`），且差分进化只跑了 `maxiter=220, popsize=15, 3 seeds`。
* **为什么是问题**：
  这是一个**数学建模谬误**：当 $R \to \infty$ 时，圆弧座面在物理上平滑收敛于平座面；如果平座面的四连杆参数 $(A, B, c_1, c_2)$ 直接拿去装上一个微凸的 $R=0.4\text{ m}$ 座面，表现绝不可能突然崩盘。之所以算出来更差，是因为你们把优化目标换成了远在 40 cm 外的曲率中心 $C_s$（放大了角度与位移的耦合非线性），导致短时间运行的差分进化优化器没找到好解！把“优化器没收敛好”归结为“凸圆弧座面在物理上不如平座面”，在学术上是站不住脚的。
* **怎么改 / 怎么验证**：
  * 如果老师不问圆弧座面，主 slides 里干脆不要提“凸圆弧座面不好”，直接用平座面 + 3 cm 前缘圆角即可。
  * 如果放进附录，理由应改为：“理想轨迹下凸圆弧座面能增加 1~2 cm 接触长度，但平座面配圆角托腿垫已能满足 81/81 合格，且加工和铺设测力传感器更简单，故选用平座面。”

---

### 7. 【严重度：中】人体后侧刚体轮廓与“骨盆保持直立”假设低估了起身初期的后滑与剪切
* **在哪里**：网页步骤 1、步骤 2、步骤 9；`seat_trajectory.py` 的 `body_points()`，`seat_relative_motion.py` 的 `body_frame_point()`。
* **代码证据**：
  ```python
  # seat_trajectory.py
  g = np.radians(np.linspace(-90.0, -th, 40))
  arc = Hp + rb * np.stack([np.sin(g), -np.cos(g)], 1)
  ```
  臀部被建成了以髋关节 `Hp` 为圆心、半径 `rb`（7/9/11 cm）的圆弧，且规定骨盆全程不随躯干或大腿旋转（保持竖直）。
* **为什么是问题**：
  1. **解剖学偏差**：真实人体的坐骨结节（Ischial tuberosity）并不以股骨头（髋关节中心）为圆心旋转，它长在骨盆上。当人起身前倾躯干（比如前倾 40°~55°）时，骨盆会伴随发生 15°~25° 的前倾旋转（Pelvic anterior tilt）。骨盆一前倾，坐骨结节就会相对髋关节**向后、向上移动**。
  2. **对结论的影响**：因为你们假设骨盆不转、臀部是以髋为圆心的光滑圆球，所以在模型里大腿抬起时，球面在座板上原地纯滚动，算出来的“前滑（slip）”非常小。如果考虑真实的骨盆前倾，坐骨结节在起身初期会往后蹭，而当座板前倾跟进时，相对滑动量会比刚性圆球模型算出来的 `+1.8 cm` 大。
* **怎么改 / 怎么验证**：
  * 不需要重写解剖模型，但在步骤 9（局限）和口头汇报中，要把“骨盆保持直立”的具体影响讲透：“真实起立中骨盆会随躯干前倾约 15°~20°，这会让坐骨结节略微后移；这其实有利于增大坐回余量，但会增加坐垫表面的剪切变形，因此坐垫表层需要有一定的剪切顺应性。”老师听到这种深度的生物力学反思会非常加分。

---

### 8. 【严重度：低】81 人用户集的构造忽略了“体重与肌力随身高/体型变化”以及“初始坐姿的个体差异”
* **在哪里**：网页步骤 1；`seat_1dof_design.py`、`model.py`。
* **代码证据**：
  * `Subject(H=H)`：无论身高是 `1.50 m` 还是 `1.75 m`，无论臀部是 `偏瘦 7 cm` 还是 `偏胖 11 cm`，体重 `M` 永远固定为 `60.0 kg`，所有关节最大肌力（`knee_ext = 75 Nm`, `hip_ext = 80 Nm`）永远固定不变！
  * `rise()` 中 `hip0 = 0.10`：所有 81 人坐着时，髋关节永远固定在床沿前 `10 cm`。
* **为什么是问题**：
  1. **1.75 m 的人更吃力是因为“杠杆长但力气没变”**：在 `model.py` 中，身高 1.75 m 的人腿长和躯干长按比例放大了 $1.75/1.60 = 1.094$ 倍，重力力臂变长了约 10%，但关节肌力上限却和 1.50 m 的人完全一样（75 Nm）。这就是为什么你们算出 1.75 m 的人费力全在 0.30 以上。如果按生物力学常规缩放（体重 $\propto H^2$ 或 BMI，肌力 $\propto M \cdot H$），或者固定 BMI，身高带来的差异主要是**行程高度不够（0.66 m 对 1.75 m 偏低）**，而不是力臂除以固定肌力。
  2. **初始坐姿 `hip0 = 10 cm` 写死**：偏胖（$r_b = 11\text{ cm}$）、腿长（1.75 m）或脚靠后（$x_a = 25\text{ cm}$）的人，坐在座板上时的自然深度和初始大腿倾角是不同的。把 `hip0 = 10 cm` 写死，导致 `H=1.75, xa=0.25` 的人初始坐姿膝盖极其靠前、小腿初始就已经前倾很大。
* **怎么改 / 怎么验证**：
  * 在 Slides 附录或讲解中说明：“为了剥离肌力假设的干扰、纯粹检验几何尺寸对机构的挑战，81 人测试中将体重除以肌力的比值做了归一化固定；1.75 m 用户费力较高主要反映了 0.66 m 行程上限对高个子用户的几何限制。”

---

### 总体判断与最值得先做的一件事

**总体判断**：
这份单自由度坐板子设计的工作量非常扎实，从用户轨迹包络、助力位置分析、四连杆尺度综合、坐垫弹簧床模型到三维空间干涉检查，逻辑链条完整、可视化水准极高，远超一般研究生课程项目的深度。但目前的薄弱点在于**“把简化模型的边界效应吹成了精确结论”**（如 4 cm 阶跃分界线、81/81 刚体满分、凸圆弧座面无效），以及**“中途 26.7° 前倾坐回滑脱 vs 顶点 4.7° 自动回平”这一关键安全逻辑没有梳理清楚**。

**最值得先做的一件事（准备 10/27 Consultation 和 11/3 汇报）**：
**立刻统一“前倾角与坐回安全”以及“刚体 vs 软坐垫”的叙事口径**：
1. 在网页和讲稿中，把四连杆后半程**“从 26.7° 自动回平到 4.7°”**提炼为核心设计亮点，直接回应 README 中“离座后座板需接近水平以接住跌坐老人”的安全要求，不要再写“靠控制器迅速放平 30° 座面”；
2. 弱化“大腿近端 4 cm 最佳”的绝对表述，改为“推力应尽量落在坐骨与大腿交界区”，并坦诚展示计入中硬坐垫下陷后（78/81 合格）的真实表现。做到这两点，你们的建模与推理在答辩时将几乎无懈可击。
