xiaweiyi0423/me5412-bedexit-proposal/page/seat1dof/audit/gemini_B_mech.md

<!-- model gemini-4-argon, finish STOP, usage {"promptTokenCount": 130445, "candidatesTokenCount": 5713, "totalTokenCount": 136158, "promptTokensDetails": [{"modality": "TEXT", "tokenCount": 113003}, {"modality": "IMAGE", "tokenCount": 17442}], "candidatesTokensDetails": [{"modality": "TEXT", "tokenCount": 5713}]} -->

从机械与结构审稿人的角度来看，这份单自由度坐板的迭代非常扎实（从双导轨到四连杆，再到避开床体与小腿的立体布置），数据链条完整。但正因为你们把几何尺寸、受力和结构布置具体化了，几个**机械原理上的硬伤、受力计算的漏项以及三维空间里的物理干涉**也暴露了出来。

下面是按严重程度排序的审计意见，重点标出了会被老师在答辩时一针见血问住的地方。

---

### 1. 【严重度：高】三维空间里的“幽灵穿过”：连杆 B 的横管直接撞断立板 A
- **位置**：`seat_1dof_layout.py`（第 24 行 `Y` 平面定义、第 147 行 `user_check`），网页“步骤 6：支撑结构与干涉检查”及正视图 `30_svgFront.png`、侧视图 `30_svgSag.png`。
- **证据**：
  - 代码定义横向平面：`Y = dict(seat=0.22, rockA=0.255, rockB=0.285, rail=0.27, act=0.0)`。
  - 电动推杆在正中间（`y = 0`），通过一根横管（cross tube，半径 2 cm）连接左右两侧在外侧平面的摇杆 B（`y = ±0.285 m`）。因此，这根横管是一个横跨 `y = -0.285 m` 到 `+0.285 m` 的实心零件。
  - 与此同时，承载销轴 A 的两块立板（pivot posts）和摇杆 A 位于内侧平面 `y = ±0.255 m`，从地面纵轨（`z = 0.04 m`）一直向上伸到 `A = (0.220, 0.315) m`。
- **为什么是问题（确定的事实）**：
  - 在侧视图（矢状面投影）里，横管中心 `E` 从起始位置大约 `(0.119, 0.254) m` 运动到终点 `(0.260, 0.453) m`。
  - 在运动过程中，当横管经过 `x = 0.220 m` 时，它的高度约为 `z = 0.39 m`，这倒是高于 A 点（`0.315 m`）；**但是，摇杆 A（连接 `A(0.220, 0.315)` 和 `P1`）在上升过程中一直处在 `z = 0.27~0.50 m` 的区域内**！
  - 因为 `0.255 m < 0.285 m`，连接两侧摇杆 B（`±0.285 m`）的横管**必须穿过**摇杆 A 和立板 A 所在的 `±0.255 m` 平面。你们的干涉检查函数 `user_check` 只检查了横管与人腿、床的碰撞，**完全没有检查横管（以及推杆）与四连杆自身内侧构件（摇杆 A、立板 A、座板支架）的碰撞**。看侧视图 `30_svgSag.png`，代表横管的圆圈轨迹直接从摇杆 A 的扫掠区域中间穿了过去。
- **怎么改 / 怎么验证**：
  1. **最简单的改法（对调内外平面）**：把被推杆驱动的摇杆 B 放在**内侧**（`|y| = 0.255 m`），把从动的摇杆 A 放在**外侧**（`|y| = 0.285 m`），并且立板 A 从外侧绕开。这样横管只需横跨 `[-0.255, +0.255]`，完全在摇杆 A 和立板 A 的内侧，永远不会相撞。
  2. 在 `seat_1dof_layout.py` 里补上 3 行代码：检查全行程中点 `E`（半径 2 cm）到线段 `A-P1`（半径 1.5 cm）和线段 `A_base-A`（半径 2 cm）的距离。

---

### 2. 【严重度：高】连杆长度差 6 倍（41 mm vs 244 mm），把铰链力放大了数倍，且虚功法漏算了偏心弯矩
- **位置**：`seat_1dof_fourbar2.py` 第 100–106 行 `actuator_search`，`seat_1dof_page_data.py` 第 38–43 行，`page.json` 中的机构参数。
- **证据**：
  - 选用的四连杆尺寸：摇杆 A `L1 = 199.5 mm`，摇杆 B `L2 = 244.3 mm`，而座板支架上的两个动铰点 `c1 = (-29.1, -149.9) mm`、`c2 = (-1.6, -119.0) mm`，**连杆（coupler）长度 `P1-P2` 只有 `41.3 mm`（4.1 厘米）**！
  - 虚功法计算推杆力：
    ```python
    n_ = rot(sim[i][1]) @ np.array([0.0, 1.0]); Fx = -Fs * n_ + np.array([0, -10 * G])
    dW = -(Fx @ (sim[i + 1][0] - sim[i - 1][0])); dL = Ls[i + 1] - Ls[i - 1]
    out.append(dW / dL)
    ```
- **为什么是问题（确定的事实）**：
  1. **虚功方程漏了旋转项（力矩做功）**：代码假设外力 `Fs` 始终作用在座板中心 `Q`（`sim[i][0]`），所以只算了 `Fx · dQ`。但你们自己在第 4、7 步证明了：对于髋晚前移的用户，接触点会沿着托腿垫往前移到距中心 `8~14 cm` 处；或者 100 kg 的人重重坐下时可能坐在前缘（偏心 `e ≈ 0.085 m`）。当坐板发生转动 `d_phi` 时，偏心力产生的力矩 `M = Fs * e` 会做功 `M * d_phi`！在行程前半段坐板快速前倾（`d_phi/dL` 很大），漏掉这一项会显著低估或高估推杆力。
  2. **41 mm 的超短连杆是机械设计大忌**：座板支架相当于一根长悬臂梁，底端只有相距 `41.3 mm` 的两个销轴 `P1`、`P2` 来抵抗整个座板上的翻转力矩。如果 100 kg 的人（1.5 倍静载 = 1470 N）坐在离 `P1/P2` 水平距离 100 mm 的地方，光是为了平衡这个力矩，`P1` 和 `P2` 两个销轴上就会产生 `1470 N × 100 mm / 41.3 mm ≈ 3560 N` 的内部对顶力，叠加原有载荷后，**单个销轴的剪切力会突破 4~5 kN**。
  3. **间隙放大效应**：连杆只有 41.3 mm，如果 `P1`、`P2` 两个销轴各有常见的 `0.2 mm` 配合间隙（或磨损），座板倾角就会有 `0.4 / 41.3 ≈ 0.01 rad ≈ 0.6°` 的自由晃动，延伸到座板前缘和相连的扶手上就会变成明显的松垮感。
- **怎么改 / 怎么验证**：
  - **立刻补算**：在虚功法里加入力矩项 `dW = -(Fx @ dQ + M_ext * d_phi_rad)`，测试载荷作用在座板后缘和前缘两个极限位置时的推杆力包络线，并写出此时销轴 `A, B, P1, P2` 的最大反力。
  - **优化合成约束**：在 `seat_1dof_fourbar2.py` 里，连杆最小长度被放宽到了 `np.hypot(*(c1 - c2)) < 0.04`（所以优化器刚好卡着下限选了 `0.0413 m`）。如果时间允许，把下限改回 `0.08 m`（像第一版代码那样），哪怕稍微牺牲一点点轨迹误差或支架深度，结构刚度和销轴寿命也会好一倍。

---

### 3. 【严重度：高】推杆经由细长横管单点推两侧，横管受 2.8 kN 弯曲 + 摇杆承受近 100 N·m 扭矩
- **位置**：网页“步骤 6：支撑结构与干涉检查”及 `seat_1dof_layout.py` 第 23 行。
- **证据**：
  - 横管半径 `R_TUBE = 0.02 m`（直径 40 mm），跨度 `L = 2 × 0.285 = 0.57 m`。
  - 推杆在正中间推横管，静载最大推力 `F = 2834 N`。
  - 推杆上端作用点 `E` 并不在摇杆 B 的轴线上，而是：`t = 0.6, o = -0.03 m`（沿着摇杆 B 在 60% 处，再垂直偏置 30 mm）。
- **为什么是问题（确定的事实与力学推算）**：
  1. **横管既是简支梁又是扭力杆**：当中间推杆出力 `2834 N` 时，横管中点承受的弯矩为 $M = \frac{F L}{4} = \frac{2834 \times 0.57}{4} \approx 404\text{ N}\cdot\text{m}$。更糟的是，如果老人坐偏了（比如单侧臀部先坐下，或者单手死死撑住一侧扶手），左右两侧四连杆受力不对称，全部不平衡扭矩都要靠这根横管以及它与摇杆 B 的焊接处传递。
  2. **偏置耳片（`o = -30 mm`）带来的焊接根部撕裂风险**：横管不是直接焊在摇杆 B 的杆身上，而是焊在摇杆 B 侧面伸出 30 mm 的耳片上。单侧高达 `1417 N`（对称时）到 `2000+ N`（偏载时）的力通过这个耳片传给摇杆 B，如果摇杆 B 只是普通扁钢（代码里厚 `24 mm`），单侧悬臂销轴和耳片根部的弯曲应力极高。
- **怎么改 / 怎么验证**：
  - 在网页“步骤 9：交给 CAD / 仿真”或附录里，给出一组哪怕最简单的**材料力学手算校核**（老师要求 Role 4 负责结构与安全）：例如横管选用 $\Phi 40 \times 4\text{ mm}$ 无缝钢管（截面模量 $W \approx 3.7\text{ cm}^3$，在 $404\text{ N}\cdot\text{m}$ 下弯曲应力 $\sigma = M/W \approx 109\text{ MPa}$，选 Q345 钢安全系数约 3.1），证明你们算过而不是随便画了个圆。
  - 建议在 CAD 中将两侧摇杆 B 加上双耳夹持（clevis joint），拒绝单剪悬臂销轴。

---

### 4. 【严重度：高】整台装置与扶手的运动耦合矛盾，以及台架抗倾翻校核缺失
- **位置**：项目 `README.md`（方案乙与第 12 版改动）对比网页 `seat_1dof.html` 全文。
- **证据**：
  - `README.md` 写明：“取消座板前倾，改为竖直升降。一个推杆驱动的四连杆只有一个自由度，倾角由高度决定，做不到‘离座后停在高处、座板水平’……L 形扶手随座板升高。”
  - 但这份网页展示的恰恰是**重新引入前移 18.2 cm + 前倾 26.7° 的单自由度四连杆坐板**！
  - 老师邮件明确要求：“2. 要考虑人坐上去、挪动时重心变化带来的台架稳定性。”
- **为什么是问题（会被老师当场问住的两个致命矛盾）**：
  1. **L 形扶手到底装在哪里？**
     - 在竖直升降方案里，L 形扶手直接固连在座板上跟着竖直升，水平位置不变（`BAR_X = 0.69 m`）。
     - 现在座板变成四连杆驱动，不仅往前走 18.2 cm，中间还**前倾 26.7°**！如果扶手还固连在座板上，扶手立柱也会跟着前倾 26.7°，握把会往前下方栽出去 25 cm 以上，人根本没法扶！
     - 反之，如果扶手不连在座板上（固定在底座上），那 তোমাদের代码 `seat_trajectory.py` 第 45 行 `bar_at(hz): return np.array([BAR_X, min(hz - R_B, TOP) + 0.40])` 算出来的费力就全错了——因为代码里假设扶手是**保持水平姿态、只随髋高纯竖直升高**的！**一个单自由度四连杆机构，怎么同时驱动一个前倾 26.7° 的坐板和一个纯竖直升降的扶手？**
  2. **座板载人前移 18 cm 后的台架抗倾翻**：
     - 底座纵轨从 `x = 3 cm` 到 `x = 66 cm`。坐板前移 18.2 cm 后，座面中心到了 `x ≈ 24 cm`，前缘到了 `x ≈ 32 cm`。
     - 虽然前横梁在 `x = 66 cm`（往前翻有余量），但**往后翻和侧翻呢**？起始坐下瞬间，如果一个偏胖老人（100 kg）坐在座板后半部（`x ≈ 0 cm` 甚至搭在床沿的 `-3 cm` 唇边上），脚还没踩实踏板，此時重心在底座前端支点 `x = 3 cm` 的**后方**！如果不靠床钩死死拉住，台架前端会直接翘起来。
     - 另外，摇杆 B 在外侧 `|y| = 28.5 cm`，已经**超出了**底座纵轨中心 `|y| = 27 cm`。如果人在高处（`z ≈ 1.06 m` 的扶手）施加侧向力，有效倾覆支点是纵轨外缘（`|y| = 29 cm`），这些在网页里只字未提。
- **怎么改 / 怎么验证**：
  - **必须明确扶手的机构方案**：要么声明扶手是固定的双层握把（但这需要修改 `bar_at(hz)` 重算，或者说明误差不大）；要么设计一套由摇杆通过拉杆带动、沿前立柱竖直导轨滑动的联动扶手。绝不能在报告里对扶手怎么动避而不谈。
  - **补一张台架整体抗倾翻的静力学图**：标出纵轨前后端点 `x = 0.03 ~ 0.66 m`、床下钩板的拉紧力/压紧力位置，算出人在坐下、起身、单手侧推扶手三种极限工况下的支反力和安全系数，直接回应老师邮件的第 2 点要求。

---

### 5. 【严重度：中】丝杠自锁的副作用：断电或故障抱死在半空（26.7° 斜坡）时怎么救人？
- **位置**：网页“步骤 5：机构”（选用自锁丝杠推杆）与“步骤 9：待验证”（前倾 30° 时人往回坐，需要控制器迅速放平座面）。
- **证据**：
  - 网页强调：“推杆本身能自锁、断电能停住……100 kg 坐下静载 1708–2834 N 靠自锁承受。”
  - 同时又说：“前倾 30° 时如果人往回坐，需要控制器迅速放平座面，否则会顺坡下滑。”
- **为什么是问题（安全与机构原理矛盾）**：
  1. **丝杠自锁 = 慢速**：能承受 2834 N 静载且自锁的梯形丝杠电动推杆（如常见的 Linak LA31/LA40 医疗推杆），在负载下的线速度通常只有 **15–30 mm/s**。你们的推杆从最高点（或最大倾角 `z = 0.56 m, phi = 26.7°`）退回水平位置，行程需要走约 `100~168 mm`，这意味着**放平座面至少需要 4 到 8 秒钟**！
  2. 人体力不支往回跌坐（sit-back）是一个 **0.3–0.5 秒** 的动态过程。指望自锁丝杠推杆“靠控制器迅速放平座面来接住跌坐的人”，在物理上是绝对不可能做到的。
  3. **断电困人**：如果升到一半（`phi = 26.7°`）停电或控制器死机触发急停锁死，老人卡在一个 27° 的滑梯上，推杆又因为自锁推不动，怎么下来？
- **怎么改 / 怎么验证**：
  - **不要吹嘘“靠控制器迅速放平接住跌坐”**，老老实实承认：由于自锁推杆速度有限（约 20 mm/s），一旦中途停止，座面是靠**高摩擦坐垫面套 + 双手握住前方扶手 + 脚踩防滑踏板**构成的三角支撑来防止老人滑落的；随后老人保持坐姿，按住或触发下降模式，推杆以安全速度（5–6 秒）平稳降回床高。
  - 在机构选型上补充一句：选用带**机械应急快拆 / 手动旋转泄放（Mechanical Emergency Lowering / Quick Release）**功能的医用推杆，断电时护理人员或本人拉动拉环即可缓慢降下。这在医疗机器人课上是非常加分的工程细节。

---

### 6. 【严重度：中】坐垫下陷 4 cm 的“垫高补偿”会毁掉与床齐平的初衷，并改变四连杆工作段
- **位置**：网页“步骤 7：坐垫刚度”底部的黄色提示框，以及 `seat_cushion.py`。
- **证据**：
  - 原文：“坐垫刚度还牵动两个机构参数：一是坐着时会下陷约 4 cm，**座板未受压时的高度应比床面高出这么多**，这样坐上去后才和床面齐平……”
- **为什么是问题（推理漏洞）**：
  1. **老人挪不上去了**：方案的核心前提是老人从床沿**横向/向前平移（scoot）**到坐板上。如果未受压时坐板比床垫高出 4 cm（像一道 4 cm 高的台阶），腿部无力的老人根本无法把屁股平移跨过这道坎！而且床垫本身在人坐床沿时也会下陷 3–5 cm，如果坐板再抬高 4 cm，实际高度差会达到 7–9 cm。
  2. **四连杆不能纯竖直垫高**：除非你把整个底座垫高 4 cm（那样脚踏板也高了 4 cm，脚位全变了；立板和刚性座板也会在 `z = 0.42 m` 以上，但起始位置刚性底板离床只有 0.5 cm），否则如果你是让四连杆沿着轨迹预先升起 4 cm，座板在没坐人时就已经**前移并前倾了约 8°**，不再是水平座面。
- **怎么改 / 怎么验证**：
  - 修改这段话的工程解释：**刚性座板的起始顶面就是和未受压的床垫平齐（或略低 2–3 cm，使 5 cm 厚的坐垫顶面自由状态下与床垫自由顶面平齐）**。人从床沿挪过来时，床垫和坐垫都在受压状态下，两者刚度相近，自然齐平过渡，不需要把机构额外架高 4 cm。这也是为什么你们在行程末端把顶点从 `0.63 m` 延长到 `0.66 m`——补偿是在**终点**多走 3 cm，而不是在**起点**垫高 4 cm。

---

### 7. 【严重度：低】表格与文字的几处数据打架，容易在展示时显得粗糙
- **位置**：网页各节文字与 JSON / 表格对比。
- **证据与问题**：
  1. **前倾角差值**：网页“步骤 8：验证”正文写着“四连杆走出的轨迹和设计曲线不完全一样（前倾角最多差约 **9°**）”，但这是第二版（`prev`）的数字；第四版采用的 `layout` 方案在步骤 5 表格里明明写着前倾误差 **12°**（精确值 `11.7°`），中心路径误差 **11 mm**（精确值 `10.5 mm`）。
  2. **前倾角上限**：网页标题和步骤 9 写“前倾 30° 时如果人往回坐……”，但实际采用的四连杆全行程最大前倾角只有 **26.7°**，到顶（0.66 m）时更是回平到了 **4.7°**！**“到顶时座面自动回到接近水平（4.7°）”明明是你们这个四连杆相对于斜导轨的一个巨大机械优势**（它顺手解决了 README 里担心的“离座后停在高处、座板不水平没法接住人”的问题！），结果你们在验证和局限里还在按旧的 30° 检讨自己。
  3. **离小腿间隙显示为 `— cm`**：在“步骤 5”的连杆布置对比表最后一行（采用的方案），“离小腿（同一平面）”一栏显示为 `— cm`（因为 `page.json` 里设为了 `null`）。虽然你们的本意是“摇杆移到了腿外侧，不在同一平面所以不用填”，但读者看到上面两行是红字的 `-0.4 cm`、`-0.8 cm`，最后一行变成 `— cm`，会以为你们算出来也是负数故意藏起来了。建议直接写成文字 `在腿外侧（横向余量 7.2 cm）`。

---

### 总体判断与最值得先做的一件事

**总体判断**：
这是一个远超普通本科/研究生课程深度的机构综合工作——从 81 人运动学包络、坐垫弹簧床模型，一直推演到四连杆尺度综合、推杆虚功计算和三视图干涉检查，逻辑链条非常漂亮。但目前的设计处在“2D 运动学很完美，3D 结构与系统整合有硬伤”的状态，尤其是**横管穿过内侧摇杆的干涉**和**扶手如何与前倾坐板共存**这两个问题，一旦被懂机械的老师看到三视图，会直接质疑机构的可行性。

**最值得先做的一件事（今天就能改完）**：
**把摇杆 A 和摇杆 B 的内外侧平面位置对调**（让连接推杆横管的摇杆 B 在内侧 `|y| = 25.5 cm`，摇杆 A 在外侧 `|y| = 28.5 cm`），彻底消除横管撞击内侧摇杆/立板的 3D 物理干涉；同时在汇报中**把“四连杆在行程顶点（0.66 m）自动回平到 4.7°”作为核心亮点讲出来**，并明确交代 L 形扶手是固定在底座上还是如何独立引导的。先把这两个物理自洽性漏洞堵上，10/27 的 consultation 就能非常从容。
