xiaweiyi0423/me5412-bedexit-proposal/page/seat1dof/audit/gemini_C_safety.md

<!-- model gemini-4-argon, finish STOP, usage {"promptTokenCount": 130446, "candidatesTokenCount": 5004, "totalTokenCount": 135450, "promptTokensDetails": [{"modality": "TEXT", "tokenCount": 113004}, {"modality": "IMAGE", "tokenCount": 17442}], "candidatesTokensDetails": [{"modality": "TEXT", "tokenCount": 5004}]} -->

作为医疗设备安全评审员兼作业治疗师（OT），我从**临床使用场景、人体工程学和机械安全（IEC 60601-1 医疗电气设备安全标准）**的角度审计了你们的“单自由度坐板”设计。

你们在纯二维矢状面的几何与力学推导上做得非常扎实，页面可视化也很清晰。但是，当把这套裸露的连杆机构放到一个**夜间半梦半醒、下肢无力、穿着宽松睡衣的老人**双腿周围时，存在几个致命的安全与人因漏洞。这也是老师在邮件里特别强调“操作安全很关键”的原因。

以下按重要性从高到低排列我发现的问题：

---

### 1. 【严重度：高】前倾 26.7° 时中途力竭跌坐：单自由度机构天然做不到“迅速放平”，会导致老人顺坡滑落跪地

*   **位置**：
    *   `README.md` 第 12 版改动说明 vs `template.html` 第 9 节（局限与下一步）及 `seat_1dof_layout.py` 结果。
*   **原文/代码证据**：
    *   `README.md`：“取消座板前倾，改为竖直升降。一个推杆驱动的四连杆只有一个自由度，倾角由高度决定，做不到‘离座后停在高处、座板水平’……松手或出现任何故障，立即停住并制动；只有确认有人坐着才下降；离座后座板停在原高度、保持水平，万一坐回去能接住人。”
    *   `layout.json` / 网页第 5 节：采用的单自由度四连杆在座面高约 0.52–0.60 m 时，前倾角达到 **26.7°**（`phi_max: 26.7`）。
    *   `template.html` 第 9 节：“前倾 30° 时如果人往回坐，需要控制器迅速放平座面，否则会顺坡下滑。”
    *   `seat_relative_motion.py` 注释：“with cloth on cushion friction about 0.4-0.5 the slope should stay below about 20-25 deg at the moment of a sit-back.”
*   **为什么是问题**：
    1.  **物理矛盾（事实）**：你们在 README 里自己证明了单自由度四连杆“倾角与高度死锁”，但在这个子设计里又改回了单自由度前倾四连杆，并把安全问题甩锅给控制器去“迅速放平”。**单自由度机构要放平，就必须下降高度！**
    2.  **控制规则冲突（事实）**：控制规则写明“松手即停并制动，只有确认有人坐着才下降”。如果老人在起身到一半（座面高度 0.55 m，前倾 26.7°）时突然头晕或腿软，松手向后跌坐：此时老人还没坐稳，传感器没确认坐好，座板锁死在 26.7° 的陡坡上；就算控制器检测到冲击开始下降，丝杠推杆（自锁型，通常满载速度仅 10–30 mm/s）走完 10 cm 行程来放平座面需要 **3–5 秒**，而人体跌坐滑出只需 **0.3 秒**。
    3.  **临床后果（确定）**：老人夜间穿丝质或纯棉睡裤，摩擦系数 $\mu \approx 0.3\text{–}0.4$（$\arctan(0.4) = 21.8^\circ < 26.7^\circ$）。网页算出的“坐回余量 $\ge +0.6\text{ cm}$”只代表臀部第一落点在座板前缘内侧 6 毫米，碰到 26.7° 的斜面后会立刻像滑梯一样往前下方溜出去，双膝直接跪撞在电动推杆和后横梁上。
*   **怎么改 / 怎么验证**：
    *   **话术与系统对齐**：必须和第 5 角色（控制）统一口径，决不能在汇报时一边说“采用竖直升降”，另一边展示“前倾 26.7° 四连杆”。
    *   **设计修改**：如果坚持用 1-DOF 四连杆，必须在合成时把最大前倾角硬约束在 **18°–20° 以内**（靠高摩擦坐垫面层 $\mu \ge 0.45$ 自锁防滑），或者在座板支架与连杆之间加一个被动单向弹簧铰链/棘轮（向上推人时顺应大腿前倾，一旦承受垂直向下跌坐冲击则压平锁死）。

---

### 2. 【严重度：高】全套运动机构暴露在双腿内外侧，存在极高风险的“剪刀口”夹手、夹肉与睡衣卷入隐患

*   **位置**：
    *   `seat_1dof_layout.py`（全行程干涉检查）、`template.html` 第 6 节（正视图 `30_svgFront.png`、侧视图 `30_svgSag.png`）。
*   **原文/代码证据**：
    *   `layout.json` / 网页第 6 节表格：`tube-thigh`（横管离大腿）最小间隙 **2.8 cm**（出现在 1.50 m 偏胖用户，髋高 0.53 m 时）；`rigid_vs_bed_floor_cm`（座板刚性部分与床垫侧面）仅 **0.5 cm**。
    *   `seat_1dof_layout.py`：摇杆 A 在 $|y|=25.5\text{ cm}$，摇杆 B 在 $|y|=28.5\text{ cm}$，立板焊在底座上，推杆静载力达 **2834 N**，起身推力近 **700 N**。
*   **为什么是问题**：
    1.  **大腿后侧与横管的挤压（事实+推导）**：代码里的 2.8 cm 间隙是按“坐板刚体接触”算的！而在第 7 节你们算出：坐着时坐垫下陷 **3.9 cm**，起身时下陷 **2.8 cm**。此外，老人坐姿时大腿后侧软组织受压会向下、向两侧显著膨出（非刚性圆柱），且夜间常穿宽松睡袍/睡裤。把 **2.8 cm 坐垫下陷** 扣掉后，大腿后侧软组织和衣物实际上已经贴在甚至包裹住那根随摇杆向上摆动的横管上了。
    2.  **两侧四连杆的剪刀口（事实）**：摇杆 A、摇杆 B 与固定立板之间在 $|y|=25.5\text{–}28.5\text{ cm}$ 处形成典型的机械剪刀口（Scissor point）。老人在从床沿挪向座板、或坐回时，双手极易本能地向下摸索抓握座板边缘来稳定身体，手指一伸进座板下方（支架深 15 cm）就会被高达数百牛顿的连杆剪断。
    3.  **座板与床沿的 0.5 cm 缝隙（事实）**：座板刚性底板与床垫侧面仅留 5 mm 间隙，虽有 3.5 cm 软唇边盖在上面，但座板**下降回位**时，如果老人的手、被角或睡衣搭在床沿，会被下拉的座板直接卡进这 5 mm 的刚性缝隙中。
*   **怎么改 / 怎么验证**：
    *   **工程防护（CAD 必加）**：在 CAD 和汇报中明确声明增加**风琴罩/柔性织物防尘防夹裙边（Bellows / Shroud）**，将座板下方到纵轨之间的四连杆、立板、横管和推杆全部罩住，实现物理隔离（符合 IEC 60601-1 运动部件防护要求）。
    *   **结构微调**：将连接两侧摇杆 B 的横管改成**下凹的 U 型横梁**，或者将推杆上铰点往下移（减小 `act["t"]`），把大腿后侧间隙从 2.8 cm 扩大到至少 6–8 cm（扣除坐垫下陷后仍留余量）。

---

### 3. 【严重度：高】缺少完整的“回床（Stand-to-Sit）与夜间二次上下床”人因闭环

*   **位置**：
    *   `README.md` 与 `template.html` 全文（仅模拟了单向 Sit-to-Stand）。
*   **原文/代码证据**：
    *   `README.md`：“只有确认有人坐着才下降；离座后座板停在原高度、保持水平，万一坐回去能接住人。”
    *   `layout.json`：座板升到顶（$z=0.66\text{ m}$）时，中心前移了 $dx = 18.2\text{ cm}$，前倾角 $\phi_{\text{end}} = 4.7^\circ$。
*   **为什么是问题**：
    *   **作业治疗（OT）流程断裂（事实）**：老人夜里起夜去完洗手间回来，面对的是一个**停在 0.66 m 高处、且悬在床沿前方 18.2 cm 处**的座板（见俯视图 `30_svgTop.png` 橙色虚线框）。
    *   **如何坐上去？（推导）**：身高 1.50 m 的老人，腿长（踝到膝+大腿）总共约 $0.79\text{ m}$，臀高根本够不到 0.66 m 高的座面！老人回来时根本坐不上这个高高翘在前面的座板；如果硬爬上去，脚会悬空，极其危险。
    *   **如果先降下来再坐？（推导）**：如果提供按钮让座板先空载降回 0.42 m，那么老人站在脚踏板上操作时，向后下方退回的座板、连杆和立板会不会撞到老人的小腿肚？回床坐下后，由于两侧立板在 $x=20\text{–}32\text{ cm}$ 处（高约 33 cm），老人怎么把双腿抬过立板放回床上躺下？**双腿根本转不回床上去！**
*   **怎么改 / 怎么验证**：
    *   **补充回床状态机**：老师明确要求“把机构概念和状态机控制器讲清楚”。必须定义回床流程：例如老人回来站在踏板上、扶住横杆，按“下降”键将空座板降到适合坐下的高度（或床面高度），坐稳后再松开安全锁转身上床。
    *   **检查回床转腿空间（致命点）**：在俯视图和正视图中，立板高达 33.5 cm（`A[1]=0.315` + 半径 2 cm），挡在床沿前 $x=22\text{–}30\text{ cm}$ 的两侧。老人坐在床沿（$z=0.42\text{ m}$）要把腿旋回床上时，小腿必须抬高超过 34 cm 才能跨过床外侧的那块立板！建议**单侧布置连杆（仅在床头侧/非下床侧装一套粗壮四连杆+扭力管）**，或者确保立板高度绝对低于小腿旋回的路径。如果来不及改机构，必须承认“老人是从座板向后退回床面，再在床面上转腿”。

---

### 4. 【严重度：中】腿部横向宽度假设过于理想化，未考虑老年人坐姿“双腿外展（外八字）”特征

*   **位置**：
    *   `template.html` 第 6 节（`hipB(u)` 函数与正视图 `30_svgFront.png`）。
*   **原文/代码证据**：
    *   `template.html`：`function hipB(u){return 0.235*u.H+2*(u.r_b-0.09)}` ... `legOut=B/2-0.02, rockIn=Y.rockA-z.R_ROCK`。
    *   正文：“座面以下的腿按外缘比臀宽每侧窄 2 cm 画。腿外缘到内侧摇杆的横向间隙 7.2 cm。”
*   **为什么是问题**：
    1.  **人体测量学与生物力学偏差（事实）**：代码假设双腿像两根笔直平行的柱子，外缘比臀部还窄 4 cm（1.60 m 用户臀宽 37.6 cm，算出来双膝外侧宽仅 33.6 cm）。实际上，老年女性（尤其偏胖或有膝骨关节炎者）坐姿臀宽第 95 百分位可达 **42–46 cm**；更重要的是，老人在准备发力起身时，为了扩大支撑面（Base of Support），**双脚和双膝会自然分开（髋外展、外旋），双膝外侧间距往往大于臀宽，达到 40–48 cm**。
    2.  **摩擦与碰撞风险（推导）**：内侧摇杆 A 的内表面在 $|y| = 25.5 - 1.5 = 24.0\text{ cm}$ 处（总净宽 48 cm）。一旦老人起身时膝盖稍微外展，膝关节外侧（腓骨小头，此处有腓总神经浅表经过，极怕受压）就会直接顶在正在旋转的钢制摇杆 A 和立板上，根本没有所谓的 7.2 cm 间隙。
*   **怎么改 / 怎么验证**：
    *   把縱轨和立板的横向位置 $|y|$ 从 27 cm 往外扩到 **30–32 cm**（总宽 60–64 cm，依然比普通助行器窄），并在正视图的内侧立板表面加装软质护垫（Padding）。
    *   在报告中替换掉自创的 `0.235 * H` 公式，直接引用标准老年人体测量数据（如中国/欧美老年人坐姿臀宽及双膝间距 95th percentile）来标定横向净空。

---

### 5. 【严重度：中】坐垫初始高度补偿的逻辑矛盾，以及前缘托腿垫对腘窝血管神经的压迫

*   **位置**：
    *   `template.html` 第 7 节（坐垫刚度）与第 3、4 节（托腿垫 18 cm）。
*   **原文/代码证据**：
    *   `template.html` 第 7 节：“坐着时会下陷约 4 cm，坐板未受压时的高度应比床面高出这么多，这样坐上去后才和床面齐平。”
    *   `template.html` 第 4 节：“对髋晚前移的人，接触点会落到大腿更下方，所以坐板前缘要做成加长的软托腿垫（覆盖大腿后侧 18 cm）。”
*   **为什么是问题**：
    1.  **4 cm 台阶障碍（事实+推导）**：如果未受压时坐垫比床面高出 4 cm（即处在 0.46 m），而老人坐在床垫边缘时，床垫本身还会下陷 3–5 cm（实际臀底高约 0.38 m）。这就意味着老人从床沿往前挪上座板时，**屁股要往上爬一个 7–8 cm 的台阶**！对于下肢无力的老人，往前平移（Scooting）本来就难，还要往上爬台阶是根本做不到的，而且那 3.5 cm 搭在床上的软唇边也会悬空翘起。
    2.  **大腿远端 18 cm 处的压迫（临床经验）**：以 1.50 m 的老人为例，大腿总长 `L_thigh = 0.245 * 1.50 = 36.8 cm`，减去臀部半径 9 cm（或 11 cm），大腿后侧直线段总共只有 **25–27 cm**。接触点推到距离臀腿交界 **18 cm** 处，意味着已经直接顶到了**大腿下 1/3 甚至接近膝窝（腘窝）**的位置！在这个位置集中施加 0.5 倍体重（约 300 N，峰值压强 17–23 kPa），不仅会在腘绳肌腱上造成剧烈酸痛，还会压迫浅表的胫神经和腘静脉。
*   **怎么改 / 怎么验证**：
    *   **修正初始高度逻辑**：不要把机械零点垫高 4 cm。应该让**未受压的坐垫顶面与未受压的床垫顶面齐平（0.42 m）**，因为老人坐在床沿时床垫也在下陷，挪到座板上时坐垫同样下陷，两者刚好平齐过渡；被吃掉的 3–4 cm 行程，靠推杆向下多留 4 cm 行程（代码里的 `pre` 前缀已经算了 3 cm，刚好吻合）来补足。
    *   **修正托腿垫描述**：不要在报告里宣称“托腿垫覆盖大腿后侧 18 cm”。座板总深其实只有 17 cm（`-0.03` 到 `0.14` m），之所以代码算出 `a_max = 17.5 cm`，是因为座板往前跑到了大腿下方。在汇报中应说明：通过坐垫“后硬前软”的分区设计（你們第 7 节算过），让前缘软海绵在接触大腿中下段时大幅让位，把主力承重点留在大腿近端和坐骨下方。

---

### 6. 【严重度：低】前滑（Skin Shear）指标只算了“净位移”，掩盖了来回搓动的皮肤剪切，且未考虑体重上限用户

*   **位置**：
    *   `seat_relative_motion.py` 的 `track()` 函数；`seat_cushion.py` 的负载设定。
*   **原文/代码证据**：
    *   `seat_relative_motion.py`：`slip += float(loc_now[0] - prev["seat_x"])`；网页第 5 节截图显示“累计前滑 `-4.7 cm`”。
    *   `seat_cushion.py`：仅按 60 kg 用户计算坐垫下陷（3.9 cm）和压到底比例（0%），而机构强度校核按 **100 kg** 用户计算。
*   **为什么是问题**：
    1.  **负向滑动也是剪切（事实）**：你们认为 `slip < 0`（坐板相对于人往前跑 4.7 cm）是安全的，但对于老年人脆弱的臀部皮肤，无论是人往前滑 5 cm，还是坐板在屁股下面往前蹭 5 cm，**皮肤和软组织承受的摩擦剪切位移是一样的**。此外，如果先正滑再负滑，代数相加会互相抵消，低估总摩擦行程。
    2.  **100 kg 用户必然压到底（推导）**：中硬坐垫（厚 5 cm，80% 即 4.0 cm 算压到底）在 60 kg 用户坐下时就已经下陷 **3.85 cm**（`sitdown: 38.5 mm`），距离压到底只有 1.5 毫米余量！任何超过 65 kg 的用户坐上去都会直接**压到底（Bottoming out）**，坐骨结节直接硌在钢板上。
*   **怎么改 / 怎么验证**：
    *   如果目标用户体重上限包含到 80–100 kg，推荐坐垫厚度必须从 5 cm 增加到 **6–7 cm**（或采用非线性复合海绵：底层硬防触底、表层软分散压力）。
    *   汇报时把“累计前滑 -4.7 cm”解释为“由于前缘软垫滚动接触，实际为坐垫弹性变形与大腿滚动，而非刚性刮擦”。

---

### 总体判断与最值得先做的一件事

**总体判断**：
这是一份工程计算深度远超普通本科/研究生课程要求的优秀作业，从人体轨迹反推机构合成的逻辑链条非常漂亮。但从医疗设备安全和临床落地的视角看，**它目前是一个“夹在两腿之间的裸露剪刀机”，且单自由度 26.7° 的前倾角与团队在 README 里定下的安全准则（水平接住跌坐、取消前倾）直接冲突**。老师在 10/27 答疑和最终答辩时，极大概率会追问“前倾时坐回去怎么办”和“老人怎么回到床上”。

**最值得先做的一件事（今天就能改完，为 10/27 咨询兜底）**：
**立刻统一团队口径并修改安全边界**：与负责控制和总体整合的同学对齐——如果保留这套 1-DOF 四连杆，**必须（1）在 CAD 与三视图上加画一个包裹连杆和横管的“柔性防夹护罩”，（2）在合成代码中把最大前倾角限制到 $\le 20^\circ$（靠坐垫摩擦即可自锁防滑，彻底解决单自由度无法快速放平的死穴），（3）补画一张“老人回床时如何避开立板把腿放回床上”的说明。**
