xiaweiyi0423/me5412-bedexit-proposal/page/seat1dof/audit/v5/gemini_B_mech.md

<!-- model gemini-4-argon, finish STOP, usage {"promptTokenCount": 198674, "candidatesTokenCount": 6306, "totalTokenCount": 204980, "promptTokensDetails": [{"modality": "TEXT", "tokenCount": 161939}, {"modality": "IMAGE", "tokenCount": 36735}], "candidatesTokensDetails": [{"modality": "TEXT", "tokenCount": 6306}]} -->

作为机械设计审稿人，我重点审查了第五版（含 5.1）的“单侧斜导轨 + 倾角连杆”机构、受力分析、三维空间布置以及应急与传感子系统。

第五版通过引入斜导轨机构，漂亮地解决了上一版的“两侧挡腿”和“前倾角过大”两大痛点，运动学综合非常简洁有效。但当这套机构转化为单侧悬臂的实体结构、并加入 5.1 的加长导轨与分区坐垫后，暴露出几个严重的**机械干涉、结构受力和机构实现漏洞**。这些问题在答辩时极易被机械背景的老师一眼看穿。

以下按重要性和严重度排序列出审计发现的问题：

---

### 1. 【严重度：高】电机安装位置与床体及后立柱发生严重实体干涉（运动学模型漏检）
* **位置**：网页“步骤 5”、“步骤 6”的侧视图（见截图 `05_mech.png`、`06_layout.png`、`30_svgSag.png`）；源码 `template.html` 中的 `railFixed()` 函数；`seat_1dof_v5_checks.py` 中的 `check_bed()`。
* **证据**：
  1. 在 `v5_checks.py` 中，导轨下端坐标 `RAIL[0]` 为 `(3.5, 27.8) cm`，后立柱从 `(3.5, 4.0) cm` 竖直向上连到 `(3.5, 27.8) cm`。代码只检查了 `RAIL` 线段和 `COLUMN` 线段与床（$x<0, z<42\text{ cm}$）的距离，得出导轨离床 $1.5\text{ cm}$、立柱离床 $1.0\text{ cm}$ 的结论。
  2. 但在 `template.html` 的 `railFixed()` 画图函数中，电机（橙色块 `mo`）被画在导轨下端沿着导轨方向再往下延伸 $2\sim 10\text{ cm}$ 的位置：
     `const mo=[[-0.10,-0.026],[-0.02,-0.026]...].map(([a,b])=>[lo[0]+a*e[0]+b*n[0]...])`
  3. 导轨方向向量 `e = [0.548, 0.837]`。电机下端坐标算出来是：$x = 0.035 - 0.10 \times 0.548 = -0.020\text{ m}$（即 **$-2.0\text{ cm}$，深入床体内部 $2\text{ cm}$**），$z = 0.278 - 0.10 \times 0.837 = 0.194\text{ m}$。
* **为什么是问题（事实）**：
  截图 `06_layout.png` 和 `30_svgSag.png` 中可以肉眼清晰看到：**橙色的“电机”块一头直接插进了灰色的“床（实心处理）”里，另一侧与灰色的后立柱完全重叠（穿模）！** 你们在表格里强调“刚性件不进床体”、“后立柱前移 0.5 cm 即可”，但画出来的图里电机直接撞穿了床和立柱。老师看图一眼就能发现这个低级穿模。
* **怎么改**：
  * **结构上**：把电机移到导轨**顶端**（`rail_hi` 位于 $x=27.8\text{ cm}, z=65\text{ cm}$，远离床体且空间开阔），或者采用折返式同步带传动将电机平行布置在导轨后上方；
  * **代码与视图上**：把电机包络盒加入 `v5_checks.py` 的干涉检查中，并修改 `template.html` 中电机块的绘制坐标。

---

### 2. 【严重度：高】单侧悬臂对导轨产生复杂的三维力矩，且偏载估算偏保守；单根导轨滑块极易卡死
* **位置**：`seat_1dof_slider.py` 第 88–103 行；网页“步骤 5”尺寸表及“步骤 11”未收尾事项。
* **证据**：
  1. 代码计算扭矩：`info["torsion_hold100_Nm"] = round(1.5 * 100 * G * 0.25)` $\rightarrow$ $368\text{ N}\cdot\text{m}$。这里假设载荷作用在座板中心（$y=0$），离导轨平面（$y=0.28\text{ m}$）距离取了 $0.25\text{ m}$。
  2. 网页写着：“导轨承受侧翻力矩 $\ge 368\text{ N}\cdot\text{m}$：双导轨或宽型滑块”。
* **为什么是问题（事实 + 工程推理）**：
  1. **偏载力臂算小了**：老人坐在床沿往座板上挪移（transfer）或回床转腿时，重心会偏向床尾一侧（例如 $y = -0.10\text{ m}$）。此时到导轨（$y = +0.28\text{ m}$）的横向力臂是 $0.38\text{ m}$ 而不是 $0.25\text{ m}$，极限静载扭矩会达到 $1471.5\text{ N} \times 0.38\text{ m} \approx \mathbf{560\text{ N}\cdot\text{m}}$。
  2. **导轨承受的是复合力矩，不仅是绕导轨轴线的侧翻（Roll）**：因为导轨倾斜了 $33.2^\circ$，竖直向下的偏心载荷分解到导轨坐标系后，同时产生**绕导轨轴线的横滚力矩 $M_{\text{roll}} = M \sin 33.2^\circ \approx 306\text{ N}\cdot\text{m}$** 和**绕滑块法向轴的偏航力矩 $M_{\text{yaw}} = M \cos 33.2^\circ \approx 468\text{ N}\cdot\text{m}$**。此外，倾角连杆在 $y=0.31\text{ m}$ 平面，与滑块（$y=0.28\text{ m}$）有 $30\text{ mm}$ 偏置，连杆轴力（$1283\text{ N}$）还会附加平面外弯矩。
  3. **丝杠偏载卡死风险**：普通工业直线导轨（如 HIWIN HGR20/25）单滑块的额定静力矩 $M_R, M_Y$ 通常在 $100\sim 300\text{ N}\cdot\text{m}$ 量级，单轨单滑块必死无疑；而且如果支架发生微小的弹性下垂（哪怕 $0.5^\circ$），丝杠螺母就会承受巨大的倾覆力矩，导致梯形自锁丝杠直接卡死（binding）甚至憋停电机。
* **怎么改**：
  * **明确机构构型**：不要只写“双导轨或宽滑块”一笔带过。在 CAD 交接清单中明确采用**上下（或前后）平行布置的双导轨 + 每轨双滑块（共 4 滑块）**结构，或者带外置高刚性导向柱的箱式滑台，将力矩转化为滑块间的纯拉压对偶力（例如两轨间距 $100\text{ mm}$ 时，$560\text{ N}\cdot\text{m}$ 转化为 $5.6\text{ kN}$ 的滑块正压力，20 规格导轨即可轻松承受）。
  * **丝杠解耦**：丝杠螺母与滑块之间必须设计**浮动接头（Floating Coupling / 十字滑块或球面垫圈）**，只传递沿导轨的轴向推力，彻底隔离横向力与倾覆弯矩。

---

### 3. 【严重度：高】“丝杠螺母快速释放 + 恒流阻尼器”在机械上自相矛盾且几乎不可行
* **位置**：网页“步骤 5 驱动和应急”、“步骤 6 应急下降”；`seat_1dof_v5_checks.py` 中的 `emergency()`。
* **证据**：
  网页：“拉下释放手柄，丝杠螺母与滑块脱开，滑块只受导轨约束……用恒流（压力补偿）阀的阻尼器，下沉速度基本不随体重变……复位只能手动：把滑块推回丝杠螺母处重新啮合。”
* **为什么是问题（工程推理）**：
  这个方案在文字上听起来很合理，但在机械设计上有三个致命漏洞：
  1. **带载脱扣锁死（Friction Locking）**：在紧急情况（如断电且 100 kg 老人正坐在座板上）下，滑块通过丝杠螺母承受高达 $1200\sim 1900\text{ N}$ 的轴向力。无论是用插销（Pin）连接螺母与滑块，还是用开合螺母（Split Nut），在近 $2\text{ kN}$ 的正压力下，静摩擦力也有好几百牛，护理人员或老人根本拉不动释放手柄（或者需要极大的杠杆机构）。
  2. **恒流液压阻尼器的挂接悖论**：阻尼器装在哪里？
     * 如果阻尼器**常连在滑块与底座之间**：那么在正常电动升降时，电机每一趟都必须克服恒流阻尼器的阻尼力（设计为托住 $100\text{ kg}\times 1.5$ 的力，即约 $1.8\text{ kN}$）！这会让丝杠推力翻倍，电机完全推不动。
     * 如果阻尼器要等“脱开瞬间”才接入，或者自带单向阀（上升无阻尼、下降有极大阻尼）：那正常电动下降时电机又会被阻尼器顶住。
  3. **手动复位不可操作**：应急下降后，丝杠螺母还停在导轨上方，而连着全宽重型钢支架和座板的滑块（总重估计 $15\sim 20\text{ kg}$）沉到了导轨底端。让护理人员甚至老人弯腰把十几公斤的悬臂滑块沿着 $33.2^\circ$ 的斜轨**徒手往上推回原位**去对准螺母销孔，既不现实，又有极高的松手砸伤风险。
* **怎么改（更专业、低成本的替代方案）**：
  放弃“脱开丝杠螺母 + 外挂液压恒流阻尼器”的复杂设想。在医疗护理床和移位机行业，标准做法是：
  1. **方案 A（最简）**：保留丝杠螺母常啮合，在梯形丝杠末端（或电机后轴）配置**内六角手动摇把接口 / 手轮 + 蓄电池备用电源（UPS）**。断电时由备用电池一键慢降；电路故障时用摇把手动摇下，无需复位机构。
  2. **方案 B（若坚持快速释放）**：改用**滚珠丝杠（非自锁，可逆驱动）+ 断电常闭电磁制动器 + 离心限速器（Centrifugal Brake，像逃生缓降器一样）**。应急时只需拉动机械拉线松开电机尾部的刹车片（力臂长、所需拉力极小），重力反推滚珠丝杠旋转，离心摩擦片自动将转速恒定限制在对应 $0.1\text{ m/s}$ 的线速度；松开拉线即刻恢复刹车，**完全不需要手动推回啮合复位**！

---

### 4. 【严重度：中】5.1 分区坐垫要求“骨架前区下沉 3 cm”，但座板厚度只有 4.5 cm，且改变了机构铰点空间与座板前缘轮廓
* **位置**：网页“步骤 7 分区坐垫”底部说明、“步骤 9 交给 CAD/仿真”；`seat_cushion_zoned.py` 与 `seat_1dof_layout.py`。
* **证据**：
  1. 网页步骤 7：“后区厚 5 cm、前区厚 8 cm……座板骨架在前区要做成下沉 3 cm 的台阶，两区顶面齐平。”
  2. `seat_1dof_layout.py` 中定义座板刚性板厚 `PLATE_T = 0.045`（$4.5\text{ cm}$），铰点 1 位于座板坐标 `c1 = (0.8, -8.9) cm`（在中心前方 $0.8\text{ cm}$，正好处于前区 `x >= -2 cm` 的范围内！）。
* **为什么是问题（事实）**：
  1. **几何与代码不一致**：在 `seat_cushion_zoned.py` 中，作者只是把前区的泡棉厚度变量 `tf` 改成了 `0.08`（后区 `tr = 0.05`），用来放宽“压到底（$0.8 t$）”的阈值，**并没有修改 `seat_polys()` 中的座板和支架包络几何**。
  2. **结构冲突**：原本座板底面在 $z_{\text{local}} = -4.5\text{ cm}$。如果前区海绵往下增厚 $3\text{ cm}$，那么前区海绵底面就已经到了 $z_{\text{local}} = -3.0\text{ cm}$（甚至如果基准面是座板顶面，下沉 $3\text{ cm}$ 意味着前区骨架底面要降到 $-7.5\text{ cm}$）。而滑块铰点 `c1` 在 $z_{\text{local}} = -8.9\text{ cm}$，扣除滑块和销轴耳座高度（约 $3\sim 4\text{ cm}$），**下沉的座板前区台阶会直接撞上滑块铰点 `c1` 的安装耳座**！
  3. **大腿托垫几何矛盾**：步骤 4 强调“座板前缘做成加长的软托腿垫，覆盖大腿后侧 18 cm”，而座板总深才 $17\text{ cm}$（$-8.5\sim +8.5\text{ cm}$），这 $18\text{ cm}$ 的大腿接触是怎么在 $17\text{ cm}$ 深的座板上实现的？（代码中是因为人体轮廓点沿着大腿算 $a\le 18\text{ cm}$，但在座板局部坐标里被限制在 `[-seat.h, seat.h]` 即 $17\text{ cm}$ 宽内，文字表述“覆盖大腿后侧约 18 cm”容易让读者以为座板前缘另外伸出了一块 $18\text{ cm}$ 长的垫子）。
* **怎么改**：
  * 核对座板局部坐标系的基准面定义：明确“座板顶面 $z=0$ 是未受压泡棉顶面，还是刚性底板顶面”。如果泡棉装在刚性板上，坐着时下陷 $5.4\text{ cm}$，未受压泡棉顶面与床齐平（$0.42\text{ m}$），那刚性骨架其实在 $0.37\sim 0.34\text{ m}$ 的高度，需重新确认前区下沉 $3\text{ cm}$ 后与滑块铰点 `c1 (0.8, -8.9) cm` 的净空。
  * 澄清“覆盖大腿后侧 18 cm”的表述：说明座板总长仍为 $17\text{ cm}$，只是在起身过程中接触点最远会滑到大腿距臀腿交界 $18\text{ cm}$ 处，并非座板前缘悬空伸出 $18\text{ cm}$。

---

### 5. 【严重度：中】连杆与前立柱、支架与后立柱存在实体交叉（负间隙），所谓“加固定护板”在几何上无法成立
* **位置**：网页“步骤 6 夹手点表”及俯视图 `30_svgTop.png`；`seat_1dof_v5_checks.py` 中的 `pinch()`；`v5_checks.json`。
* **证据**：
  1. `v5_checks.json` 中：`"连杆—导轨立柱": -4.5`（即 $-4.5\text{ cm}$），`"支架—导轨立柱": -2.5`（即 $-2.5\text{ cm}$）。
  2. 网页夹手点表写着：“连杆扫过前立柱（侧视图交叉，两者横向只隔约 1 cm） $\rightarrow$ 需护罩：立柱外侧加固定护板，或连杆外移到 $|y| \ge 0.34\text{ m}$”。
  3. 网页同样对“支架—导轨立柱（$-2.5\text{ cm}$）”写着：“导轨加风琴罩，立柱与支架之间加固定护板”。
* **为什么是问题（事实）**：
  1. **支架与立柱在同一个横向区间，负间隙意味着真撞上了，不是加护板能解决的**：代码假定导轨在 $y=0.28\text{ m}$，立柱半径 $2.5\text{ cm}$（占据 $y = 0.255\sim 0.305\text{ m}$）。而座板支架必须从座板（$y=0.22\text{ m}$）往外伸到 $y=0.28\text{ m}$ 才能抱住滑块，甚至还要往外伸到 $y=0.31\text{ m}$ 去连接倾角连杆的上铰点 `P2`！这意味着在 $y=0.255\sim 0.31\text{ m}$ 这个区间里，运动支架和固定立柱在矢状面重叠了 $2.5\text{ cm}$。如果不把立柱做成向床头外侧绕行的 C 型结构，支架在升降过程中会**直接把立柱撞断**，根本塞不进什么“固定护板”。
  2. **连杆与前立柱横向仅隔 $5\text{ mm}$**：立柱外表面在 $y = 0.28 + 0.025 = 0.305\text{ m}$，连杆中心在 $y=0.31\text{ m}$（若连杆厚 $20\text{ mm}$，内表面在 $0.300\text{ m}$），两者其实已经发生横向刮擦（$-5\text{ mm}$ 干涉），更没有空间塞入一块有厚度的固定护板。
* **怎么改**：
  * **取消导轨下方的两根直立柱，改为整体式侧立板（Side Gusset Plate）或外置龙门框**：将支撑导轨的立柱移到导轨**背面/外侧**（例如 $y = 0.32\text{ m}$），滑块朝向用户内侧（$y = 0.26\text{ m}$）安装支架，彻底打通支架悬臂的内侧通道。
  * 或者直接采纳你们自己在表格里写的备选方案：把连杆外移到 $y = 0.34\text{ m}$ 并用全封闭外壳包住整个床头侧机构（只留一条滑块伸出槽，配毛刷密封条或风琴罩），这比局部打补丁式的“固定护板”干净得多。

---

### 6. 【严重度：中】座板下的 4 个测力传感器在“单侧悬臂 + 分区厚坐垫 + 倾角变化”下存在严重测量失真与布置冲突
* **位置**：项目 README 方案乙说明；网页“步骤 10 审计表第 9 项”。
* **证据**：
  1. README：“座板、踏板下各 4 个测力单元（压力中心），横杆测力；各传感器的竖直力之和与体重对不上就锁住。”
  2. 网页步骤 10 第 9 项：“座板前倾时座下测力单元测的是法向力，体重自检要修正 $\rightarrow$ 倾角由丝杠位置唯一确定，可查表换算。”
* **为什么是问题（工程推理）**：
  1. **只修倾角 $\cos\phi$ 不够，漏了切向摩擦力**：当座板倾斜 $15^\circ$ 时，防止人顺坡下滑的静摩擦力 $F_t$ 沿着座面方向（在坐回或起身时可达法向力的 $20\%\sim 30\%$）。这个切向力也有竖直分量 $F_t \sin\phi$！单轴测力单元（Load Cell）只测垂直于座板表面的法向力 $F_n$，即使乘以 $\cos 15^\circ$，也会因为漏掉 $F_t \sin 15^\circ$（约占体重的 $5\%\sim 8\%$）导致“竖直力之和 = 体重”的自检误报并锁死机器！
  2. **单侧高刚度悬臂梁会“旁路”或扭曲测力单元读数**：如果把 4 个单轴测力传感器装在刚性座板和悬臂支架之间，由于悬臂支架在承受 $368\sim 560\text{ N}\cdot\text{m}$ 扭矩时会产生挠曲变形，四个传感器会受到极强的寄生弯矩（Parasitic Moment）和侧向剪切力，普通悬臂梁式称重传感器读数会严重漂移。
* **怎么改**：
  * 在网页和报告中明确：4 个座下测力传感器用于测**座面法向合力与压力中心（COP）**以驱动速度自适应控制（$v = k(F_{\text{cap}} - F_n)$ 本来就只需要法向力！）；
  * 而用于安全自检的“总重校核”，建议如上一轮审计所提，**直接将全身总重传感器放在整个底座四角下**，或者将全身自检的容差放宽到 $\pm 10\sim 15\%\text{ BW}$（用来检测“有没有人倒在地上/挂在外面”，而不是做高精度天平称重）。

---

### 7. 【严重度：低】导轨加长 3 cm 后末段座板后仰（$-3.4^\circ$）及角速度加快，网页对负倾角的物理解释有误导
* **位置**：网页“步骤 5 机构文字”及右下图“座板前倾随座板高度”；`seat_1dof_slider.py`。
* **证据**：
  1. 网页步骤 5：“导轨末端为分区坐垫加长了 3 cm：这一段座板继续升到 0.69 m，并略后仰到 $-3^\circ$。后仰时人坐回不会往前滑。”
  2. `slider.json` 中 `tilt_curve`：座面从 $0.65\text{ m}$ 升到 $0.685\text{ m}$（仅 $3.5\text{ cm}$ 高度变化）的过程中，倾角从 $+7.2^\circ$ 急剧反转到 $-3.4^\circ$（变化了 $10.6^\circ$）。
* **为什么是问题（事实 + 推理）**：
  1. **机构接近曲柄滑块的外死点/大角度区**：当滑块沿着导轨走到最高点 $P_1 \approx (24.5, 60.0)\text{ cm}$ 时，连杆拉着 $P_2$ 绕 $B (39.3, 14.9)\text{ cm}$ 旋转。此时滑块继续往上走，而长 $36.1\text{ cm}$ 的连杆已经接近竖直极限，无法再提供足够的向上行程，导致座板后部被连杆死死拉住，前部被滑块强行顶起，产生快速的**向后翻转（Pitch-up）**。
  2. **人机交互隐患**：在起身最后阶段（70% 以后），人体大腿前倾达 $53^\circ$，正在努力把重心往前送（移向脚踝上方）。此时座板不仅不再前倾配合大腿，反而**以较快的角速度往后仰、前缘往上翘**，座板前缘会像铲子一样顶在大腿后侧，把人**往后推（推回床的方向）**！这也是为什么在步骤 7 的分区坐垫表里，后半程会出现多达 26~69 个情况“比均匀坐垫更费力”。
* **怎么改**：
  * 如果决定保留 $324\text{ mm}$ 行程，不要只从“坐回不往前滑”美化这个 $-3.4^\circ$ 的后仰，应在“局限”中坦诚说明：直接延长现有导轨末端会导致连杆拉住座板后部、产生末段后仰（$-3.4^\circ$）；若将 $0.69\text{ m}$ 的加长目标直接放进 `seat_1dof_slider.py` 的差分进化综合函数 `cost()` 里重新优化一次 `c1, c2`（耗时仅几秒钟），完全可以让机构在 $0.69\text{ m}$ 处平滑停在 $+3^\circ\sim +5^\circ$，避免末段反翘。

---

### 总体判断与最值得先做的一件事

* **总体判断**：
  第五版的设计迭代逻辑非常清晰，从“人体运动学 $\rightarrow$ 助力点 $\rightarrow$ 轨迹包络 $\rightarrow$ 单侧滑块连杆综合 $\rightarrow$ 坐垫耦合”形成了一个完整且有深度的工程故事，完全满足甚至超出了 ME5412 课程对概念设计与仿真的要求。目前最大的薄弱点在于**三维结构落地的自洽性**：单侧悬臂的力矩承载、立柱与运动件的穿模干涉、以及电机撞床的画图错误，容易让原本扎实的运动学工作在机械细节上失分。

* **最值得先做的一件事（高回报、低耗时）**：
  **立即修正网页“步骤 5”和“步骤 6”SVG 图中的电机位置与立柱布局（改 `template.html` 中的 `railFixed()` 和 `v5_checks.py` 中的 `COLUMN`）**——把电机移到导轨上端，把支撑立柱移到导轨外侧/后方，消除“橙色电机插进床里、支架和连杆撞穿立柱”的视觉穿模；同时在文字中把“单轨滑块 + 丝杠螺母脱扣”修正为“双导轨四滑块（浮动螺母）+ 滚珠丝杠配电磁制动与离心限速器”。这只需要改几十行代码和文字，就能把所有机械硬伤堵死。
