xiaweiyi0423/me5412-bedexit-proposal/page/seat1dof/audit/v5/gemini_C_safety.md

<!-- model gemini-4-argon, finish STOP, usage {"promptTokenCount": 198664, "candidatesTokenCount": 6986, "totalTokenCount": 205650, "promptTokensDetails": [{"modality": "TEXT", "tokenCount": 161929}, {"modality": "IMAGE", "tokenCount": 36735}], "candidatesTokensDetails": [{"modality": "TEXT", "tokenCount": 6986}]} -->

我是医疗设备安全评审员，同时有临床作业治疗师（OT）的背景。我看完第五版（含 5.1）的设计和网页后，认为你们对第四版审计指出的核心问题响应得非常快、思路也很清晰：把机构挪到单侧腾出转腿空间、把前倾压到 15°、换用斜导轨降低驱动力，这些都是工程上立竿见影的改进。

但从**安全评审和老年人实际使用（人因与临床生物力学）**的角度看，这三次大改（单侧机构、固定立杆、加长导轨配分区坐垫）在解决旧问题的同时，制造了几个新的、甚至更棘手的临床安全漏洞。有几处如果老师在答辩时追问“老人在真实场景里怎么用”，你们现在的代码和文字是圆不过去的。

以下按重要性从高到低排列我发现的问题：

---

### 1. 【严重度：高】固定立杆改在单侧且远在床沿前 69 cm：坐姿根本够不着，且单手侧拉会引起躯干旋转失衡

* **位置**：网页步骤 5、步骤 6（正视图/俯视图 `svgFront`/`svgTop`）、`seat_1dof_v5.py` 中的 `POLE` 与 `pole_effort` 函数。
* **原文与代码证据**：
  * 网页与 JSON：`pole: {x: 0.69, z: [0.75, 1.10]}`；俯视图和正视图中，立杆画在 `y = +0.25 m`（床头一侧）。
  * 代码 `seat_1dof_v5.py`：计算费力时只把 `x=(0.62, 0.69, 0.76), z=0.75..1.10` 代入 2D 模型 `effort(sub, pz, np.array([x, z]))`，**完全没有传入横向偏置（`lateral` 参数）**，且只在“放手时”和“支撑段”算，**没算刚坐下（起身 0%）时手能不能抓到**。
* **为什么是问题**：
  1. **确定事实（几何够不着）**：刚坐在床沿/座板上时（`f = 0`），髋关节在 `x = 0.10 m, z ≈ 0.51 m`。以 1.50 m 的小个子老人为例（`model.py`：躯干长 $0.288 \times 1.5 = 0.432\text{ m}$，全臂长 $(0.186+0.200) \times 1.5 = 0.579\text{ m}$），如果不先大幅度俯身，肩膀在 `(0.10, 0.94)`，到立杆最低握点 `(0.69, 0.75, y=0.25)` 的三维直線距离是 $\sqrt{(0.69-0.10)^2 + (0.75-0.94)^2 + 0.25^2} \approx 0.67\text{ m} > 0.579\text{ m}$（手臂总长）。也就是说，**老人坐在座板上准备按“起”开关时，手根本够不到这根立杆**，除非他先在毫无保护的情况下把上身猛探出去 20 cm。你们在网页步骤 2 和步骤 5 的动画里，代码发现够不着（`if(E)... else...`），就直接画了一根悬空的断手（见截图 `02_posture.png`），但正文里完全没提。
  2. **人因与临床风险（单侧抓握 + 无横杆）**：README 里原方案是“L 形扶手横杆”，双手可以放在身前对称发力。现在改成床头一侧（`y = +0.25 m`）的一根竖直独杆。老人如果用双手抓，靠近床尾的左臂必须横跨整个胸前去抓右前方的杆，身体被迫向床头侧扭转；如果只用右手单手拉，25% 体重的拉力会在水平面产生巨大的旋转力矩。夜里迷糊、下肢无力的老人最怕边起身边扭转，极易向开口侧（床尾）摔倒。
  3. **操作安全冲突**：老师在 10/26 邮件第 3 条专门强调了“手握输入（dead-man switch）很关键”。在竖直圆管上边起身、手还要从 0.75 m 往上滑换握到 1.05 m（否则起身前后半程高度不对），老人怎么一边在圆管上滑手、一边死死按住“起”开关不松开？
* **怎么改 / 怎么验证**：
  * **设计上**：不要用远在 `x = 0.69 m` 的纯竖直独杆。立柱可以从底座 `(0.69, +0.28)` 立起来，但在上部（比如 `z = 0.80–0.90 m`）**向后（朝床方向，到 `x ≈ 0.35–0.45 m`）并向内折出一个 L 形或 U 形水平扶手段**。这样坐着时手一抬就能握住开关，站起来时再往前抓立杆，且双手能对称发力。
  * **计算上**：在 `seat_1dof_v5.py` 中调用 `sts_effort` 时，如果扶手偏在一侧，必须计入横向距离折减手臂展长，并检查 `f = 0`（刚坐上时）全员 81 人的手臂可达性。

---

### 2. 【严重度：高】应急下降的人因盲区：“人在台上怎么拉手柄”与“15.8° 斜坡无动力滑落”

* **位置**：网页步骤 6 `#emergNote`、步骤 11 未收尾事项第 5 条、`seat_1dof_v5_checks.py` 的 `emergency()` 函数。
* **原文与代码证据**：
  * 网页：“拉下释放手柄，丝杠螺母与滑块脱开……在全行程、座板上任意受力位置都朝下，所以座板只会往下沉……下沉途中前倾不超过 15.8°……恒流阀约 0.1 m/s、全行程约 3.2 s。复位只能手动：把滑块推回丝杠螺母处重新啮合。”
  * 未收尾事项：“释放手柄放在哪里（护理人员和用户都够得到）。”
* **为什么是问题**：
  1. **谁来拉、怎么拉（临床场景矛盾）**：README 明确定义目标用户是“住在家里、独立生活的老人”，夜里起夜时**身边是没有护理人员的**。当设备升到一半（比如座高 0.55 m，前倾 15.8°）突然断电或卡死时，老人正处于“半蹲半站、大腿悬空斜靠在 15.8° 的座板上、双手死死抓着前方 0.69 m 处的立杆维持平衡”的极度脆弱姿势。这时候，你让他松开一只救命的手，弯腰去座板底下/侧面摸一个机械快速释放手柄，还要用力拉脱处于 1800 N 载荷下的丝杠螺母——**他一松手就会摔下来，而且机械式螺母在千牛级静载下根本拉不动（或者拉开的瞬间有巨大的机械弹跳冲击）**。
  2. **下沉途中的滑落风险**：正常升降时，老人是脚蹬地、手拉杆，主动配合座板。而应急下降是老人已经体力不支或慌乱，整个人瘫坐在座板上。座板在 3.2 秒内边往后退（`dx = -17 cm`）边保持最高 **15.8° 的前倾角**往下沉。老人的脚还踩在前面的踏板上，座板带着屁股往后下方撤，而座面又是往前倾斜 15.8° 的——老人极容易在后退下沉的过程中直接顺着 15.8° 的斜坡从座板前缘滑脱到地板上。
  3. **手动复位不切实际**：座板加支架重约 10 kg，脱开后沉到底。一个腿脚不便的独居老人，怎么蹲到地上把十几公斤的悬臂滑块沿着 33° 斜导轨往上推、再对准丝杠螺纹咔哒一声扣回去？
* **怎么改 / 怎么验证**：
  * **改方案（强烈建议，也更符合机电课要求）**：既然丝杠要自锁，不如采用**带断电抱闸（常闭电磁制动器）的滚珠丝杠/高效梯形丝杠 + 小型备用电池（或超级电容）**，或者用液压/气弹簧支撑配合常闭电磁阀（按钮/拉索开启阀门泄压慢降）。这样“应急下降”只需要在扶手手边放一个受保护的红色大按钮或鲍登线（自行车刹车线）拨杆，老人手不离开扶手就能触发；而且也不存在“丝杠螺母脱开后老人推不回去”的问题。
  * 如果坚持用机械脱开：手柄必须通过**拉索（Bowden cable）引到扶手握把旁边**，绝对不能放在导轨或座板下；并且要在报告里算清楚带载脱开所需的拉手力。

---

### 3. 【严重度：高】回床转腿通道的隐藏陷阱：座板停在 0.69 m 高处，老人怎么坐回 0.42 m 的床上？

* **位置**：网页步骤 6 俯视图 `svgTop`、README、以及第 5.1 节导轨加长。
* **原文与代码证据**：
  * README：“只有确认有人坐着才下降；离座后座板停在原高度、保持水平，万一坐回去能接住人。”
  * 网页步骤 6 俯视图：“回床时人坐在床沿把腿转向床尾，腿扫过的区域（虚线扇形）在座面高度以上没有任何零件。”（图上画了一个以 `(0.05, 0)` 为圆心、半径 52 cm 的绿色扇形，直接扫过整个座板所在区域）。
  * 第 5.1 节：导轨加长 3 cm 后，座板升到顶时 `top = 0.688 m`，前移 `17.1 cm`，末段倾角 `-3.4°`（后仰）。
* **为什么是问题**：
  1. **确定事实（空间完全冲突）**：俯视图的图注说“回床时人坐在床沿把腿转向床尾”，并且把绿色扇形画在了 `x = 0 ~ 0.57 m, y = 0 ~ -0.52 m` 的区域。但是！老人上完厕所回来，**座板还停在床沿正前方（`x = -0.03 ~ 0.31 m, y = -0.22 ~ +0.22 m`）！** 它占住了床沿整整 44 cm 的宽度。
  2. **人因流程走不通**：老人夜里从卫生间走回来，面对的是一个升在半空中（离地 0.65–0.69 m，比普通餐桌还高一点）、或者即使降回 0.42 m 也挡在床沿外 14 cm 的座板。
     * **情况 A（按 README，离座后座板停在高处）**：座板停在 0.66–0.69 m 高。一个 1.50 m 的老人（髋高才 0.72 m），根本没法把屁股抬到 0.69 m 高的座板上去“坐下再降下来”；如果他想绕过座板直接坐到床尾的床沿上，座板和底座占了床边 60 cm 宽、78 cm 深的地方，他得在床尾侧跨越或绕开 4 cm 高的底座纵梁和脚踏板，极易绊倒。
     * **情况 B（老人先坐回高处的座板，让机器降回 0.42 m，再转腿回床）**：这也是个死胡同——你们在步骤 8 表里算过，像 `H1.60 p2.5` 这样的人，放手时座板才升到約 0.55 m，此时座板**前倾 15.8°**！老人回来时怎么往一个前倾 15.8° 的斜坡上坐？反过来，如果座板在他离座后自己升到顶（0.688 m，后仰 -3.4°）去等他，那他又够不着坐上去。
* **怎么改 / 怎么验证**：
  * **必须把“回床（Bed Entry）状态机和动作流程”补齐**，老师在 10/26 邮件第 5 条明确要求“把机构概念和状态机控制器讲清楚”。
  * 最安全的临床流程是：老人起身离座、双脚离开踏板后，座板在原地等待几秒（防立刻跌坐）；确认人走远后，**座板自动降回 0.42 m（与床齐平、水平 0°）待机**。老人上完厕所回来，像坐普通椅子一样坐到 0.42 m 的水平座板上，然后把屁股往后挪 10 cm 到床垫上，最后向床尾敞开侧转腿上床。
  * 如果采用这个流程，就要修改 README 里“离座后停在原高度”的说法（或者加一个“回床按键”让座板先降下来），并承认：**回床时老人必须踩上 4 cm 高的底座/踏板再坐下**——底座边缘必须做斜坡过渡（beveled ramp）并贴夜光防滑条，防止夜里踢脚绊倒（trip hazard）。

---

### 4. 【严重度：中高】坐回 15.8° 斜坡的防滑计算过于乐观：漏算了“向后坐下的水平冲量”和“可滑动面套”的自相矛盾

* **位置**：网页步骤 9“待验证”、步骤 10、步骤 11 第 1 条和表格最后一行。
* **原文与代码证据**：
  * 步骤 11：“放手后人往回坐，座板前倾 φ 时，沿座面向下的分力与压力之比是 tan φ……15° 只要 ≥ 0.27。”
  * 步骤 11 表格最后一行：“皮肤剪切：中位 10.2 cm、最大 14.1 cm，**坐垫表层仍建议用可滑动面套**。”
* **为什么是问题**：
  1. **直接自相矛盾**：为了防止老人在起身失败往回坐时从 15.8° 的座板上滑下去，你们要求坐垫与衣物的摩擦系数 $\mu \ge 0.27$（如果考虑安全系数 1.5，需要 $\mu \ge 0.40$）；但在同一张表的最后一行，为了减少 10–14 cm 的皮肤剪切，你们又建议“坐垫表层用可滑动面套（low-friction slip cover）”。在康复工程里，低摩擦防剪切面套的 $\mu$ 通常在 $0.15\text{–}0.20$ 左右——**一旦用了滑动面套，老人在 15° 座板上坐回时必滑无疑**。
  2. **物理模型漏项**：$\mu \ge \tan 15.8^\circ \approx 0.28$ 只是**纯竖直轻放**在斜面上的静力学下限。人起身到一半没力气往回跌坐时，重心不仅往下掉（竖直冲击力 $1.5\text{–}2.0\text{ BW}$），而且膝盖一软，大腿还会推着座板产生滑移；更重要的是，老人的丝绸/化纤睡裤（夜间起床的真实穿着！）在普通 PU 皮革或海绵布套上的动摩擦系数经常只有 $0.20\text{–}0.25$。
* **怎么改 / 怎么验证**：
  * **删掉“可滑动面套”的建议**。对于每天只用几秒钟的起身辅助台（而不是一坐几小时的轮椅），10 cm 的衣物-座面相对移动根本不会造成压疮；相反，跌坐滑脱是致命的。应当改用**高摩擦防滑表层（如带纹理的氯丁橡胶或硅胶防滑垫，$\mu \ge 0.5$）**，让滑移发生在宽松睡裤与皮肤之间，或靠坐垫表层海绵的剪切变形吸收前 2 cm 的位移。
  * 在网页上明确写出：考虑睡衣材质和坐回动载，坐垫表面设计指标定为 $\mu \ge 0.5$，前缘托腿垫微微上翘或做成防滑凸起。

---

### 5. 【严重度：中】单侧悬臂受偏载时的侧倾（Roll）与滑块卡死风险未做人因评估

* **位置**：网页步骤 5、步骤 11 未收尾事项第 1 条、`seat_1dof_slider.py`。
* **原文与代码证据**：
  * `seat_1dof_slider.py`：`info["torsion_hold100_Nm"] = round(1.5 * 100 * G * 0.25)`（得出 368 N·m）。
  * 步骤 11：“100 kg 猛坐时导轨要承受约 368 N·m 的侧翻力矩，座板支架也是悬臂……支架的下垂和刚度要在 CAD 里算。”
* **为什么是问题**：
  1. **力臂算小了（偏载工况）**：代码中算 368 N·m 用的是座板中心（`y = 0`）到导轨平面（`y = 0.28 m`）的距离 `0.25 m`。但老人从床上往座板上挪、或者回床往床尾侧转腿时，臀部重心会偏到床尾侧（比如 `y = -0.10 m` 甚至 `-0.15 m`）。这时悬臂力臂不是 0.25 m，而是 $0.28 - (-0.12) = 0.40\text{ m}$，**扭矩会达到 $580\text{ N}\cdot\text{m}$**。
  2. **人因安全感（侧倾角）**：哪怕金属支架不断，只要悬臂端（床尾侧，`y = -0.22 m`）在人坐上去时往下弹性变形或因导轨间隙下沉 **5–8 mm**（对应约 $1^\circ\text{–}1.5^\circ$ 的横向侧倾），老人在感官上就会觉得“椅子往没扶手的那边塌了”，引发强烈的坠落恐惧和防御性肌紧张。
  3. **丝杠与滑块伴生卡死（Binding）**：单根导轨上的单个滑块（長 9 cm，见代码 `carriage` `[-0.045, 0.045]`）承受 368–580 N·m 的倾覆力矩，滚珠滑块两端的等效法向力高达 $368 / 0.09 \approx 4.1\text{ kN}$。这不仅会让丝杠承受弯矩，还会在应急下降脱开螺母时，因为巨大的导轨摩擦阻滞力导致滑块卡死不下沉（你们在 `emergency()` 里算下沉力时完全没算导轨受倾覆力矩后的摩擦阻力！）。
* **怎么改 / 怎么验证**：
  * 在文字和图里明确：**必须使用上下（或前后）双导轨 + 四滑块结构，或者滑块跨距拉长到 $\ge 150\text{ mm}$**，并且丝杠用浮动接头（只传轴向力、不承受倾覆弯矩）。
  * 在 `emergency()` 的下沉验算中，补一句说明：滚珠直线导轨摩擦系数 $\mu \approx 0.005$，即使在 5 kN 倾覆反力下摩擦力也只有约 25 N，小于最轻用户下沉推力（$45\times 0.8\times 9.81\times 0.43 \approx 152\text{ N}$），所以不会卡死——把这笔账算出来，老师会非常认可。

---

### 6. 【严重度：中】侧向抗倾翻与项目主设定冲突：横推 276 N 就翻，到底连不连床？

* **位置**：网页步骤 6 抗倾翻表及图注、步骤 11 未收尾事项第 2 条、README。
* **原文与代码证据**：
  * README 第 12 版：“台架和床固定。不固定时……扶手高位侧向约 129 N。”
  * 网页步骤 6：“60 kg 的人约 276 N（约 28 kg 力）就会翻……这是‘底座加人’自身的抗翻能力，起身台和床是否连在一起会改变结论，需要和整机一起核。”
* **为什么是问题**：
  * **确定事实（前后矛盾）**：README 里全组已经拍板“台架和床固定”，而且老师 10/26 邮件第 2 条专门叮嘱“要考虑人坐上去、挪动时重心变化带来的台架稳定性”。结果到了子设计网页里，又退回去按“独立不连床”算，还留下一句“是否够用取决于和床是否相连”的悬念。
  * **临床危险工况漏算**：你们算的 276 N 是“人已经双脚踩在底座踏板上（人的 60 kg 帮着压住底座）”。但**最危险的时刻是老人刚站直、迈出第一步离开踏板，或者从卫生间回来还没踩上踏板，脚在地板上、手却用力扶/拽了一下 1.06 m 高的立杆**！这时候底座上只有设备自重 40 kg，没有人的体重压着。按你们的公式算：向床尾侧推翻只需要 $40 \times 9.81 \times (0.27 + 0.08) / 1.06 \approx \mathbf{130\text{ N}}$（仅 13 kg 力），向床头侧推翻只需要 $40 \times 9.81 \times (0.33 - 0.08) / 1.06 \approx \mathbf{92\text{ N}}$（不到 10 kg 力）！老人回床时伸手一扶立杆，整个 40 kg 的铁架子就会朝他迎面砸下来。
* **怎么改 / 怎么验证**：
  * 别再摇摆了，**直接锁定“台架必须与床架刚性拉结（床腿夹或床垫下压板）”**。在步骤 6 抗倾翻一节中把“人不在踏板上、单手扶立杆（仅靠 40 kg 自重）”的 92 N 算出来，作为**为什么必须固定在床上**的铁证！这样既呼应了 README，又完美回答了老师邮件的第 2 点。

---

### 7. 【严重度：中】剩下的两处剪切夹点（-4.5 cm 和 -2.5 cm）就在床头侧立杆下方，简单“加护板”会干涉运动

* **位置**：网页步骤 6 夹手点表（`#pinchTable`）、`seat_1dof_v5_checks.py`。
* **原文与代码证据**：
  * `v5_checks.json`：`"pinch_cm": {"连杆—导轨立柱": -4.5, "支架—导轨立柱": -2.5}`。
  * 网页处理方案：“立柱外侧加固定护板，或连杆外移到 |y| ≥ 0.34 m；导轨加风琴罩，立柱与支架之间加固定护板。”
* **为什么是问题**：
  * 间隙为负值（-4.5 cm 和 -2.5 cm）意味着在侧视图上，这两个零件是**完全交叉扫过的（剪刀口，scissoring action）**。
  * 机械结构上，座板支架是从内侧（`y = -0.22..+0.255`）伸过来抱住滑块（`y = +0.28`）的，而导轨立柱也在 `y = +0.28` 托着导轨上下两端。你不可能在两个必须在同一空间连接的地方“塞一块固定护板”而不撞上支架。
  * 从人因上看，床头一侧正是老人躺着伸手摸眼镜/水杯、或者坐着时右手自然下垂的地方。一旦手指伸进连杆与前立柱之间，丝杠 1900 N 的推力通过连杆放大后是标准的断指剪切机。
* **怎么改 / 怎么验证**：
  * 既然整个传动机构（导轨、丝杠、电机、两根立柱、倾角连杆）全都在床头一侧（`y = +0.25 ~ +0.33 m`）的窄盒子里，最彻底、最符合医疗器械标准（IEC 60601-1 机械防护）的做法不是东贴一块护板西贴一块，而是**把床头侧整套机构装进一个全封闭的薄型立式外壳（shroud/casing）里**，只在内侧壁开一条竖直窄槽（配毛刷条或风琴帘）让座板悬臂支架伸出来。这样所有剪切点一次性全部物理隔离。

---

### 8. 【严重度：低】分区坐垫在 5 cm 厚度下几乎压到底，且台阶分界处会对大腿根产生局部棱边压迫

* **位置**：网页步骤 7 分区坐垫、`seat_cushion_zoned.py`。
* **原文与代码证据**：
  * 推荐方案（后 10 / 前 3，前区厚 8 cm、后区厚 5 cm）：`sitdown: {sink_mm: 54.0, bottom: false, p_peak_kPa: 22.8}`；起身时 `sink_mm` p90 达到 `62.2 mm`，最大 `64.9 mm`。
  * 样件可试方案（后 15 / 前 2，前区顶面低 2 cm）：坐着峰值压强 `49.2 kPa`。
* **为什么是问题**：
  1. 推荐方案坐着时下陷 `54.0 mm`（发生在 8 cm 厚的前区，接近 64 mm 的压到底线），而 5 cm 厚的后区在起身时的压陷也经常逼近 40 mm（`0.8 * t`）。如果换一个 80–100 kg 的用户，坐上去的瞬间后区就会直接触底（bottom out），骨盆直接磕在那个“前区下沉 3 cm 的座板金属骨架台阶”上。
  2. 独立弹簧床（Winkler 模型）没有相邻弹簧的剪切耦合，所以算出来的压强在分界处（`x = -2 cm`）是一个干净的跳变（见截图 `21_cush_z1_15pct.png` 中压强曲线的尖峰）。在真实人体上，两块刚度相差 3–7.5 倍的海绵拼在一起，外加底下金属骨架有个 3 cm 的直角台阶，老人的坐骨结节或大腿根部压在分界线上会有明显的“硬棱感”。49 kPa（约 368 mmHg）虽然只是短时承受，但对老年人脆弱的皮下组织已经会引起明显的压痛，导致老人不敢往后坐实。
* **怎么改 / 怎么验证**：
  * 坚持采用温和的推荐方案（后 10 / 前 3，23 kPa），**放弃 49 kPa 的激进方案**（收益只有 0.017 的费力降低，却有 26 个工况变差和翻倍的压强，临床上得不偿失）。
  * 在 CAD 要求里注明：座板骨架的 3 cm 台阶必须做成斜坡过渡，且两区海绵采用斜切粘接（scarf joint）加一层 1 cm 整体高弹面层覆盖，消除分界硬棱。

---

### 总体判断与最值得先做的一件事

**总体判断**：
第五版在运动学和机构精简上做得非常漂亮，单侧斜导轨方案完全立得住脚。但目前的设计把注意力全放在了“起身那几秒的矢状面轨迹”上，而在**“人怎么握扶手、怎么回床坐下、断电怎么自救、人没踩上踏板时架子会不会被拽翻”**这四个完整的临床使用闭环上存在明显的安全漏洞。11 月 3 日答辩时，机械系的老师看机构，医疗机器人方向的评审一定会问这四个场景。

**最值得先做的一件事（今天就能改完，对答辩帮助最大）**：
**把“固定竖直独杆 + 离座停在高处”改成“带向后延伸水平握把的 L 形扶手 + 离座后自动回落待机 + 扶手边的拉索/按钮式应急慢降”**，并在网页第 6 步补算一句“人站在地上伸手拉立杆时（无体重压底座）仅需 92 N 就会拉翻台架，因此台架必须与床固定”。这一下就能同时堵住“坐姿手够不着”、“单手拉扭转”、“回床被高座板挡路”、“独居老人拉不到底下的释放柄”和“侧翻矛盾”五个最大的问题。
