xiaweiyi0423/me5412-bedexit-proposal/page/seat1dof/audit/v5/gemini_E_teacher.md

<!-- model gemini-4-argon, finish STOP, usage {"promptTokenCount": 198609, "candidatesTokenCount": 5595, "totalTokenCount": 204204, "promptTokensDetails": [{"modality": "TEXT", "tokenCount": 161874}, {"modality": "IMAGE", "tokenCount": 36735}], "candidatesTokensDetails": [{"modality": "TEXT", "tokenCount": 5595}]} -->

站在课程老师和答辩最刁钻提问者的角度，我先给一个定调：**你们的平面运动学和坐垫接触建模做得非常扎实，但把这套机构放到三维空间、接上控制系统和真实的人体操作后，出现了几个致命的“系统级脱节”。** 

对照老师 10/26 邮件里的明确要求（台架稳定性、手握输入与传感安全、状态机控制器、CAD与动画、主 slides 精简），第五版虽然解决了上一轮的三个问题，却在“改扶手”和“改单侧机构”时挖了新的大坑。

以下是按重要性排序的审计问题、答辩追问及修改建议：

---

### 1. 【严重度：高】单侧竖直立杆让人无法单手发力，且破坏了操作界面（UI）与整机逻辑
* **位置**：网页第 5 步、第 6 步（`06_layout.png` 正视图/俯视图），以及 `seat_1dof_v5.py` 的 `POLE` 定义、`model.py` 的 `_sts_one`。
* **证据**：
  1. 在 `06_layout.png` 正视图和俯视图中，扶手被改成了一根立在**床头一侧**（$x = 0.69\text{ m}, y = +0.25\text{ m}$）的竖直圆杆。
  2. 但在 `seat_trajectory.py` 的 `effort()` 计算中，手部最大出力能力写的是 `HAND_CAP = 0.25`（0.25 倍体重，60 kg 即 147 N），关节力矩上限用的是 **`2 * sub.sh_flex`、`2 * sub.el_flex`（双臂力量之和）**。
  3. 项目 README 明确规定：“握紧**横杆握把**上的‘起’开关……握把式开关（至少一只手）”。
* **为什么是问题（确定的事实与因果）**：
  * **力学与人因脱节**：一根偏在身体右侧 25 cm 的竖直立杆，老人怎么用两只手同时发力？如果左手跨过胸前去抓右侧立杆，不仅左臂力臂极差，还会产生把身体往右侧拧的躯干扭矩；如果只用右手单手抓，那模型里按“双臂关节力矩上限（`2 * sub.sh_flex`）”算的费力就完全不成立（单手力量减半，上肢可能先超限）。更糟糕的是，在没有横杆的情况下，要在光滑的竖直圆管上往下压/往后拉出 150 N 的力，手必须死死攥紧管子靠摩擦力防滑，而目标用户是虚弱老人，根本握不住。
  * **UI 无处安放**：老师特别强调“手握输入很关键”。以前是固定高度的横杆握把，上面有按住式开关（Dead-man switch）。现在变成了 $0.75\text{--}1.10\text{ m}$ 任意高度可抓的竖直光杆，你的“起”开关装在哪里？总不能让老人在 35 cm 长的管子上到处摸开关，或者做一根 35 cm 长的条形微动开关吧？
* **老师会怎么问**：
  > “看你们的俯视图，扶手只有床头一侧的一根竖管。老人起身时是单手抓还是双手抓？如果是单手，为什么代码里肩膀和手肘的力矩上限乘了 2？而且你在竖管上让人怎么操作按住式开关？手出汗往下一滑，开关松了急停，人岂不是直接闪了腰？”
* **更好的回答 / 怎么改**：
  * **改设计（最推荐）**：不要用单纯的竖直立杆！在床头一侧立柱的基础上，在 $z \approx 0.85\text{--}0.95\text{ m}$ 处向内（$-y$ 方向，即人胸前）悬臂伸出一根**固定横杆（或带多个高度横档的梯形扶手）**。横杆末端（$y \approx 0$）既不会挡住床尾一侧回床转腿（因为转腿在座面高度 $0.42\text{ m}$ 附近，而横杆在 $0.9\text{ m}$ 高处，人在坐姿转腿时头和胸在床沿上方，只要横杆在 $x=0.69\text{ m}$ 就完全碰不到），又能恢复双手抓握、向下撑压和固定握把开关的所有优点。

---

### 2. 【严重度：高】新旧对照组“双重标准”，导致核心省力结论失真
* **位置**：网页抬头 KPI（`00_header.png`）、第 8 步验证表（`08_check.png`）、第 10 步审计笔记（`10_audit.png`），以及 `seat_1dof_page_data_v5.py` 第 108 行 `vertical=D["check"]["vertical"]`。
* **证据**：
  * 网页到处在比：“放手费力中位数：新坐板 **0.233** vs 竖直升降 **0.273**”。
  * 第 8 步表格下方小字承认：“竖直升降一列仍是旧的对照数据（手抓随座板升降的扶手）”。
  * 第 10 步小字写着：“固定在底座上，做成竖直立杆……重算后放手费力中位 **0.233**，比随动横杆的 **0.252** 还低。”
* **为什么是问题（确定的事实）**：
  * 这违反了控制变量法的基本科学原则。新坐板比竖直升降省力（0.233 vs 0.273，降了 0.040），里面有一半的功劳（0.252 → 0.233，即 0.019）是因为**把随动横杆换成了允许在 0.75–1.10 m 寻找最优抓握点的固定立杆**！如果给竖直升降方案也配上同样的固定立杆，它的费力也会大幅下降。拿“新坐板+新扶手”去打“旧坐板+旧扶手”，在答辩时会被认为是在凑数字。
* **老师会怎么问**：
  > “你们说新机构把放手费力从 0.273 降到了 0.233。但你们同时改了扶手。如果我保持竖直升降坐板不变，只把扶手也改成你们现在的固定立杆，费力是多少？新机构本身到底贡献了多少？”
* **怎么改**：
  * 在 `seat_1dof_v5.py` 里用 `pole_effort`（固定立杆）把 `curve_vertical()` 的 81 人重跑一遍（只需几行代码、几秒钟），更新 `vertical` 对照列的数据。哪怕差距变小了（因为核心优势本来就是防前滑 1.9 cm vs 11.3 cm 和防坐空 +2.1 cm vs -5.3 cm，而不是那点放手费力），也比被老师当场抓出对比不公要强得多。

---

### 3. 【严重度：高】传感器闭环与状态机缺失：座板前倾 + 悬臂扭转 + 海绵迟滞，怎么测力、怎么防误判？
* **位置**：网页第 7 步、第 10 步第 9 项，对照老师邮件要求 3（压力与力分布传感、自适应速度）和要求 5（状态机控制器）。
* **证据**：
  1. README 规定：“速度 = $k \times (\text{推力上限} - \text{座板测到的力})$……座板、踏板下各 4 个测力单元（压力中心），横杆测力；各传感器的竖直力之和与体重对不上就锁住。”
  2. 第 10 步表格第 9 项写：“倾角由丝杠位置唯一确定，可查表换算”。
  3. 第 7 步新增了前 8 cm 软海绵 + 后 5 cm 硬海绵，且座板在单侧 $368\text{ N}\cdot\text{m}$ 扭矩下工作。
* **为什么是问题（事实与工程推理）**：
  * **切向摩擦吞掉分力**：当座板前倾 15° 时，人为防下滑，臀部对坐垫不仅有法向力 $N$，还有沿座面向下的静摩擦力 $f_s$。如果你只在座板和支架之间装单轴（法向）测力单元，你只能测到 $N$，测不到 $f_s$。那么真实竖直力 $F_z = N \cos\phi - f_s \sin\phi$ 就永远算不准，“竖直力之和 = 体重”的安全自检一定会报错锁死！
  * **单侧悬臂卡死测力单元**：座板支架悬臂承受 $368\text{ N}\cdot\text{m}$ 的翻滚力矩，普通单轴称重传感器（Load cell）极怕侧向力和弯矩，装在座板下会产生严重的寄生读数。
  * **离座判定与海绵回弹打架**：前区海绵厚 8 cm、下陷高达 5–6 cm。人起身加速往上走时，海绵回弹有粘弹性滞后，且“速度 = $k(F_{\text{cap}} - F_{\text{seat}})$”本身就是看到力变小就加速追上去。控制器怎么区分**“人在正常起身（我要加速追上去托他）”**和**“人已经站起来离座了（我要立刻停下保持当前高度，不能一直追到 0.69 m 顶死）”**？网页里完全没有状态机（State Machine）的切换条件。
* **老师会怎么问**：
  > “老师邮件里明确要看状态机和传感器融合。现在你们座板前倾 15°，人衣服和坐垫有切向摩擦力，单向测力传感器怎么算出真实的竖直力来做体重自检？另外，按你们的速度公式，力越小速度越快，那人刚离开座面的瞬间力变成 0，座板岂不是以最大速度往上猛冲？”
* **更好的回答 / 需要补的材料**：
  * **传感器位置回答**：把“体重自检”的 4 个测力传感器移到**整机底座四个角与地面之间**！这样不管座板怎么倾、连杆怎么传力、手怎么抓，整机对地的总竖直反力减去自重永远等于人的真实体重，彻底绕开内力耦合与倾角换算。座板下只用薄膜压力阵列垫（Pressure mat，正好呼应老师要求的“压力和力分布传感”以及你们第 5 步画的接触压强分布！）来测接触面积和法向合力，用于控制速度。
  * **补状态机图（必须在主 slides 里有一页）**：画出状态机：`[Idle/Seated]` →（握把开关按下 & 底座总重=体重 & 座面有压力）→ `[Lifting (Force-following)]`。切换出 `[Lifting]` 的条件必须区分：
    1. 松开开关 → `[Paused/Hold]`；
    2. **脚踏板承重 > 90% 体重 且 座面接触面积/压力 < 阈值**（证明人已站稳离座，而不是正在起身中）→ `[Standby Hold]`（立即停止丝杠，不再往上追，留在原高度防跌坐）；
    3. 在 `[Standby Hold]` 下检测到座面压力突增 → 确认有人坐回，允许按键进入 `[Lowering]`。

---

### 4. 【严重度：中高】导轨加长 3 cm 导致末端后仰 $-3.4^\circ$，引发“硬前缘硌大腿”和高度超标
* **位置**：网页第 5 步（`05_mech.png` 右下角倾角曲线）、第 7 步 5.1 节，以及 `slider.json`（`top: 0.688`, `phi_end: -3.4`）。
* **证据**：
  * 为了配合 5.1 的软前区坐垫，你们把导轨末端延长了 3 cm（`EXT` 从 0.06 改到 0.09），座板中心最高升到 **0.688 m**，此时前倾角从 $+15.8^\circ$ 一路掉头变成了 **$-3.4^\circ$（向后仰）**。
  * 网页第 5 步正文辩解说：“后仰时人坐回不会往前滑”。
  * 但第 7 步紧接着说：起身到 70% 时，人的大腿倾角高達 **$53^\circ$**！
* **为什么是问题（确定的事实与几何冲突）**：
  * 当高个子用户在起身末段（座板接近 $0.688\text{ m}$）还靠在座板上时，他的大腿是往前下方倾斜 $53^\circ$ 的，而你的座板居然在**往后仰（$-3.4^\circ$）**！两者夹角高达 $56.4^\circ$。这会导致座板像一个翘起的铲子，只有最前端的边缘顶在大腿后侧（看截图 `21_cush_z2_70pct.png`，压强在 18 cm 处出现了一个极尖锐的 30 kPa 刺峰！）。
  * 如果这个高个子用户在 $0.68\text{ m}$ 处力竭往回坐，座板停在 $0.688\text{ m}$ 且后仰，他的臀部还没碰到座板中心，大腿后侧就会先重重地砸在翘起的座板前缘上。
* **老师会怎么问**：
  > “看第 5 步右下角的图，座板升到 0.66 m 以上时角度变成了负的（后仰 3.4°），而且截图 21 里 z2 坐垫在 70% 时压强曲线裂成了两半，大腿远端有个巨大的尖峰。为什么会这样？后仰的座板顶着 53° 的大腿，不会硌伤人吗？”
* **更好的回答 / 怎么改**：
  * **为什么裂成两半**：在 `21_cush_z2_70pct.png` 中，5 cm 处的小尖峰是硬后区（15 kPa/cm）与软前区（2 kPa/cm）交界处的台阶造成的，18 cm 处的大尖峰是因为座板前区压缩超过了 6.4 cm（$0.8 \times 8\text{ cm}$），触发了代码里的**压到底惩罚（`50 * k`，即直接顶到了底下的硬钢板）**！
  * **怎么改**：这就是为什么**绝对不能选 z2（激进方案）**，甚至连导轨加长 3 cm 都要谨慎。如果答辩被问到，要立刻指出：“这正是我们仿真发现的边界效应——导轨不能无限延长，因为单侧连杆机构的圆弧约束会让延长段发生后仰（$-3.4^\circ$）；同时 z2 方案在 70% 处把前区海绵压穿触底了（所以有尖峰）。因此我们最终推荐的是折中的 z1 方案，并且在实际控制器里可以把软上限设在 $\phi \ge 0^\circ$（约 $z=0.67\text{ m}$）处停止。”

---

### 5. 【严重度：中】单侧悬臂 368 N·m 扭矩的机械常识漏洞与“应急释放手柄”的人因盲区
* **位置**：网页第 5 步尺寸表、第 6 步应急下降说明（`06_layout.png`）、第 11 步未收尾事项（`11_v5.png`）。
* **证据**：
  1. 网页写：“单侧悬臂扭矩 $368\text{ N}\cdot\text{m}$……导轨用双导轨或宽型滑块”。
  2. 网页写：“拉下释放手柄，丝杠螺母与滑块脱开，滑块只受导轨约束……座板上每 1 N 的压力，沿导轨向下的推力是 0.43–1.23 N……只会往下沉”。
* **为什么是问题（机械工程事实）**：
  * **滑块静力矩与摩擦力矩自锁（Binding）**：一根中心距几厘米的普通宽型滑块（如 HIWIN HGW20/25），其额定滚动力矩 $M_R$ 通常只有 $100\text{--}300\text{ N}\cdot\text{m}$。承受 $368\text{ N}\cdot\text{m}$（还没乘安全系数！）的偏心弯矩时，滑块内部滚珠会产生极大的接触正压力，极易发生**偏载卡死（Binding/Jamming）**。你在 `emergency()` 里算的“每 1 N 压力产生 0.43 N 沿导轨向下的力”是**理想无摩擦、无倾覆力矩**的虚功！实际上加上 $368\text{ N}\cdot\text{m}$ 偏载力矩带来的导轨摩擦阻力后，45 kg 的老人坐在上面拉下释放柄，滑块很可能会因为偏载摩擦力直接卡在导轨上不下沉！
  * **带载脱开丝杠螺母的力学矛盾**：人在跌坐或卡在半空时，丝杠螺母上正承受着 $500\text{--}1900\text{ N}$ 的轴向死载荷。你让一个坐在上面的虚弱老人手动去拉脱一个承受着上千牛顿压力的开合螺母（Split nut）？摩擦力会大到根本拉不动，除非是过死点凸轮机构（Over-center latch）。
* **老师会怎么问**：
  > “你们把机构全放单侧，算出来 368 N·m 的翻滚扭矩。你们查过几号直线导轨能抗住这个扭矩还不卡死吗？如果在这么大的偏载扭矩下，老人拉应急手柄，滑块被别住滑不下来怎么办？而且丝杠压着上千牛的力，老人手拉得动那个脱开机构吗？”
* **更好的回答 / 怎么改**：
  * **关于导轨抗扭**：不要说“宽型滑块”，在机械设计上这是外行话。标准做法是**拉开距离的双导轨（或主导轨 + 侧向支承滚轮）**：在床头侧立板上，上下（或内外）布置两根间距 $\Delta d = 150\text{ mm}$ 的平行导轨（或一导轨一滚轮槽），把 $368\text{ N}\cdot\text{m}$ 的纯扭矩转化为两根导轨上一拉一压的纯径向力 $F = 368 / 0.15 \approx 2.45\text{ kN}$。径向力 2.5 kN 对任何 15/20 号导轨来说都是小菜一碟（额定动载荷都在 10 kN 以上），且彻底消除了滑块偏载卡死的风险！
  * **关于应急释放**：回答老师时明确说明，快速释放不是去硬拔受压的螺纹，而是采用**滚珠丝杠 + 蜗轮蜗杆电机 + 电磁失电制动器（或棘轮偏心释放销）**，或者滑块与螺母外套之间用**过死点连杆锁扣（Over-center toggle latch）**，机械增益 > 20:1，只需 < 20 N 的力即可解锁，且手柄装在床头侧扶手立柱旁（老人左手/右手顺手一拨的位置）。

---

### 6. 【严重度：中】网页可读性与 Consultation / 最终汇报的呈现问题（对照老师要求 4 和 6）
* **位置**：网页整体结构（步骤 1–11）、第 4 步表格（`04_seat.png`）、第 5 步接触区放大图（`21_cush_*.png`）、第 6 步正视图（`30_svgFront.png`）。
* **问题诊断**：
  1. **网页把“设计历史账”和“当前最终方案”混在一起，外人看得很累**：比如第 4 步右边的表格（`04_seat.png`），标题叫“候选曲线比较”，结果小字写着“这张表是第四版（30°上限）选曲线时的比较”；第 7 步上半部分花大篇幅讲均匀坐垫并标了绿色“推荐”，括号里又写“（5.1 改为下面的分区坐垫）”；最后还有第 10 步审计、第 11 步修订。作为开发日志很好，但如果明天（10/27）拿这个给老师做 consultation，或者直接转成 11/3 的英文 slides，老师会觉得逻辑反复横跳。
  2. **新加的接触区放大图（`21_cush_*.png`）有两个视觉困惑**：
     * 左边的放大窗口（`窗口宽 30 cm`）里，橙色的坐板是刚体未变形轮廓，肉色的大腿直接**穿模（陷进）**了橙色坐板里，上面盖了一条红色粗线。不仔细读图注的人会以为“怎么大腿骨头切进钢板里了？”（因为你没把未受压的 5 cm / 8 cm 海绵轮廓画出来，只画了底板或把整个坐板画成实心块）。
     * 右边的压强分布图，横轴是“沿身体后侧，距臀腿交界 (cm)”，左绿右白分界在 $4\text{ cm}$。但坐垫本身的分界是在**座板中心后 2 cm**。读者在看 `z1` 和 `z2` 的双峰压强曲线时，不知道曲线上那个突变折角到底是因为走出了骨盆区，还是因为跨过了坐垫的软硬分界线。
  3. **正视图（`30_svgFront.png`）里的扶手立杆画得像“锯齿尺”**：因为用了粗虚线（`stroke-dasharray: 6 4`, `stroke-width: 0.03*s`），立杆在正视图里变成了一串密集的横向灰色小方块，非常像梯子或标尺，而且正好和导轨滑块重叠在一起，视觉上极易混淆。
  4. **老师明确要求的 CAD 模型还没有影**：网页全是 2D 矢量图（SVG），虽然画得很精美，但老师邮件第 4 点明确要求“**要展示 CAD 模型和运动动画**”。

---

### 总结判断与最值得先做的一件事

**总体判断**：
这套单自由度坐板的**运动学综合与坐垫力学分析已经达到了远超本科/硕士课程项目的深度**，81 人全覆盖的论证闭环非常漂亮。目前的软肋完全在于**“单侧化改造”带来的三维工程后遗症**（单侧立杆没法双手发力/装开关、单侧滑块抗扭、倾角与力传感器的耦合），以及网页里残留的版本迭代痕迹。

**最值得先做的一件事（在 10/27 找老师 consultation 之前）**：
**把那个“光秃秃的床头侧竖直立杆”改成“从床头侧立柱伸向人正前方的固定高度横杆（带按住式开关握把）”，并用一行文字定下“双导轨上下拉开 15 cm 抗扭 + 底座四角测力做体重自检”的方案。** 只要把这三句话补齐，明天老师能问住你们的所有物理与控制死穴就全被堵上了；随后由角色 3（机构与 CAD）立刻按第 9 步的尺寸表把三维 CAD 装配体建出来，准备 11/3 的英文汇报。
