xiaweiyi0423/me5412-bedexit-proposal/presentation/video/pulse/README.md

# 床边起身台 · 脉动版（技术向短片）

**成片：`bedexit_pulse.mp4`**（46 秒，1080p30，无旁白；中文字幕为主，每个镜头的主标题下面一行灰色英文小字，小标签不配英文；有配乐和音效）

这一版和 v3（鹤的故事）并列，作为另一种风格：不讲故事，不煽情，按产品发布会的节奏讲清楚：问题是什么、产品是什么、凭什么这样设计、人怎么用。设计过程只用画面带过，不讲推导。

只有一处“心理描写”，并在片尾呼应：
- **雨夜（0:08）**：起不来以后，冷蓝色的房间、窗外下雨。他想站起来，眼前浮现一个淡淡的“站着的自己”和一条通往那里的虚线；髋部那条青色的线只走到一半就塌下来，碎成水珠落下去，接上窗外的雨（雨也是一条条落下的线）。人低着头坐回床沿。
- **呼应（0:40）**：同一扇窗、同一张床、同一个机位，床边多了起身台。握紧开关，他站起来，髋部这次画出一条完整的线；雨停，窗外天亮。然后人和床淡出，只留起身台；镜头拉远转成 3/4 视角并缓慢旋转，深色网格背景，一束顶部冷白光打亮样机，地面每拍从起身台脚下扩散一圈光环（青色为主、每第四拍一圈琥珀色），鼓点同时回来；那条青色的起身线留在空中，片名在左上。

视觉母题是**点和线**：开场人由关节点连成，起身时髋部画出一条线；轨迹段里座板跟着大腿走、81 条线铺开、导轨和连杆从轨迹里长出来。

背后的事实（片中不讲，答辩时可用）：
- 81 个人 = 3 种身高 × 3 种体型 × 3 种起身习惯 × 3 种脚的位置；
- 每人一条线：座板贴在大腿下面随大腿转（倾角不超过 30°），座板中心走过的路；
- 设计曲线是从候选里**挑**出来的：每条都拿给 81 个人试，选最吃力的人也够用的那条（“1.50 m、先前倾、脚放得远”那位）。

- **节奏**：配乐 120 BPM，每拍 0.5 秒，镜头切换、零件落位和文字出现都对在拍点上。
- **画面**：
  - 全部由代码生成，没有用 AI 生成的画面；
  - 装置用 CAD 零件（`cad/out/mesh.json`）按真实运动学驱动；
  - 人物是扁平的标识小人，姿态来自起身模型（参考用户 1.60 m）。
- **配色**：深色段落讲结构和运动，浅色段落讲问题和用法；青色代表机构，琥珀色代表握把开关。全片只用这一套颜色，片尾也不换色（曾试过多巴胺色光晕，评审认为像潮玩、破坏医疗设备的可信感，已撤掉）。问题段用偏暗的冷灰底，避免从黑底切过去时刺眼。

| 时间 | 段落 | 内容 |
|---|---|---|
| 0:00 | 开场 | 关节点按拍出现，连成人；起身时髋部画出一条线；字幕只有“夜里，老人从床沿站起来”（“线”只用画面表达，不写成字）|
| 0:04 | 问题 | 床低 → 站不起来；床高 → 脚踩不实 |
| 0:08 | 雨夜 | 失落：站不起来的线碎成雨；字幕“平时，和床一样低。起身时，跟着你升起来。”；片名重拍时雨停住 |
| 0:11 | 片名 | 床边起身台 / BED-EXIT SEAT |
| 0:13 | 轨迹 | 座板跟着大腿走（人起身，座板托着走）→ 座板怎么走，按 81 种身体算出来（81 条线 + 设计曲线；数字 81 从 0 计到 81，下面一枚小标签“身高 1.50–1.75 m”，停留约 2 秒）|
| 0:17 | 轨迹 | 只用一条导轨 + 一根连杆（座板沿曲线上下一趟，导轨和连杆亮出；小标签“轨迹误差 ≤ 8 mm”）|
| 0:19.5 | 轨迹 | 不是直上直下，而是一路贴着大腿：“直上直下”和“斜导轨 + 倾角连杆”两张大图并排循环；标题下一行琥珀色字带过三种四连杆（会碰小腿、回床挡腿，或受力太大）|
| 0:22 | 结构 | CAD 零件按 16 分音符快速拼装（8 组）；“一个电机，一个自由度”，铰点画圆圈、滑块画方块，一行字“3 个铰点 + 1 个滑块 = 1 个自由度”；两条关键标签：“双导轨 + 滚珠丝杠：扛住偏载”“握把开关：握紧才升” |
| 0:26 | 床边（手绘 3D） | 一条条线从画面外飞来，落成一张线稿的床；一条青线从床沿出发，镜头跟着它爬上斜导轨到握把开关，起身台在它身后从线稿填成实物；标注“机构全在床头一侧”；“床尾一侧敞开，回床时腿能转过去”配地面排线、手绘箭头，以及一个半透明人形从床上转身、把腿从床尾一侧放下来、最后坐在床沿；镜头推到斜 30° 的 2.5D 角度，背景同时淡成深色网格。这一帧和下一段第一帧是同一个机位、同一个姿势，所以两段接成一个连续镜头，人接着从床沿挪上座板 |
| 0:29.5 | 起身四步（2.5D → 2D） | 01 挪上座板（2.5D，半透明立体人形）· 02 握紧开关（握把随拍发琥珀色脉冲，镜头转到正侧面变 2D）· 03 一起起身（轨迹、每拍座板残影、前移 / 上升 / 前倾箭头；座板旁一条水平虚线和座面线，实时读数“前倾 N°”；副标题“托住臀部和大腿，人不往前滑”）· 04 松手即停（座板被框住、STOP，音乐抽空，只留电磁抱闸的“咔哒—咚”）|
| 0:36 | 传感 | 起身之前，四处确认：座下测力、横杆测力、握把开关、踏板测力；人坐在座板上、手扶横杆，准备起身；当前这个点亮、之前的变暗；最后右侧三行“握紧才升 / 松手即停 / 失电制动”。最后 0.7 秒是转场：镜头缓到雨夜的机位，一个光点在墙上画出窗框，窗里下起雨，线框人形填成实心；雨声提前 0.5 秒进来。这一段最后一帧就是下一段第一帧 |
| 0:40 | 呼应 + 结尾 | 同一扇窗、同一张床，用起身台站起来，完整的线；雨停、天亮；人和床淡出，只留起身台在深色网格上旋转，顶部冷白光，每拍一圈光环；片名 +“帮老人自己，从床边站起来” |

“松手即停”那一拍（0:34.5），音乐整段静音约 1.5 秒，只留低沉的电磁抱闸声（“咔哒—咚”），用声音表现“稳稳停住”；不用高频提示音，避免像医院报警。

## 和设计一致的地方
- 座板前倾不超过约 15°。
- 人离开座板后，座板停在放手的位置，不会把人推下去，也不会自己回落。
- 握紧才升、松手就停。
- 传感点与幻灯片“传感与交互”一页一致。
- 设计过程的数据都来自 `model/calc_v13/seat_1dof/`（page.json、v5.json、fourbar_oneside.json），和幻灯片“机构设计”三页是同一套数字；五种机构的淘汰理由与“选机构”一页一致。
- 采用的机构有 3 个转动副 + 1 个移动副，可以看作把四连杆的一根杆换成导轨（滑块）；它不是四个铰链的四连杆。片中在结构段直接画出 3 个铰点和 1 个滑块。
- 片中只出现 3 个数字，都来自同一套模型：81 种身体（身高 1.50–1.75 m）、轨迹误差 ≤ 8 mm、起身时的实时前倾角（最大约 15.6°，人离开座板时约 12.9°）。
- 人物头部按模型画（头心在肩上方约 12 cm，半径约 8.5 cm），和扶手横杆保持至少 5 cm 间隙；上一版看起来“撞头”是画法问题，已改。

## 文件
| 路径 | 内容 |
|---|---|
| `bedexit_pulse.mp4` | 成片 |
| `styleframes.jpg` | 6 张效果图 |
| `src/pulse.html`、`src/pulse.js` | 画面（three.js + Canvas），`renderAt(t)` 逐帧绘制 |
| `src/prep_design.py` | 把设计过程数据打包成 `design.js`、`design_demo.js`（5 个示例用户的起身姿态和对应座板位置） |
| `review_gemini.md` | Gemini 对剧本的意见和我们的处理 |
| `src/render.js` | Playwright 逐帧截图 |
| `src/music.py` | 配乐和音效合成（numpy/scipy，不用采样） |
| `src/music_rain.py` | 雨夜和片尾呼应两段的声音（雨声、孤单的下行音、“叹气”般的上扬又落下的音、雨停后的大调和弦），拼进主配乐 |
| `src/music_ctx.py` | 床边镜头 3.5 秒的声音（线飞入的划空声、床合拢的和弦、线爬导轨的上行音、碰到开关的“叮”），插到 25 秒处 |
| `src/music_merge.py` | 合并后“起身四步”6.5 秒的声音（每步一个落点、握把的拨弦音、上升音、三个箭头音、电磁抱闸声） |
| `src/music_v11.py` | 46 秒版：在 16 秒处插入 1 拍和弦（81 停留），把传感段换成 4 秒，结尾鼓点减弱、雨声提前进入 |
| `review_director_notes.md` | 一份导演视角的点评和逐条处理 |
| `src/encode.sh` | 帧 + 音频 → mp4（响度 −14 LUFS） |

重新生成：
1. 在 `src/` 放好 `three.min.js`（three r150，`https://cdn.jsdelivr.net/npm/three@0.150.1/build/three.min.js`）、`data.js`（运行 `python3 prep_data.py`，从 page.json、`cad/travel_table.csv`、`cad/out/mesh.json` 重建；原来的 prep.py 没有提交）和字体目录 `fonts/`（在 `src/fonts/` 里运行 `python3 ../get_fonts.py`）。
2. 运行 `python3 prep_design.py`，再运行 `node render.js video 0 1380`（断点续渲：已存在的帧会跳过，改了画面要先删掉对应帧）。
3. 运行 `python3 music.py music_core42.wav`，再运行 `python3 music_rain.py music_core42.wav music.wav`（把雨夜和呼应两段音乐拼进去，得到 44.5 秒版本，存为 music_v6_445.wav），最后运行 `python3 music_ctx.py music_v6_445.wav music.wav`（插入床边镜头的 3.5 秒，得到 music_v9_49.wav），最后运行 `python3 music_merge.py music_v9_49.wav music.wav`（把运动段和用法段的声音换成合并后的四步，得到 44 秒，存为 music_v10_44.wav），最后运行 `python3 music_v11.py music_v10_44.wav music.wav`（得到 46 秒）。
4. 运行 `./encode.sh`。

## 英文版
**`bedexit_pulse_en.mp4`**（46 秒，同一条音轨）：画面、时间、动画都和中文版相同，英文是主字幕，画面里没有中文。
- `pulse.js` 有语言开关：`pulse.html?lang=en`（或 `window.LANG='en'`）。英文文本在 `ENT`（按字幕 id）和各数组的 `L(zh, en)` 里，个别位置微调在 `ENP`。默认仍是中文，中文渲染逐像素不变。
- 渲染：`node render.js video 0 1380 --lang=en --out=<帧目录>`（可分 4 段并行）；编码时视频用新帧，音频直接从 `bedexit_pulse.mp4` 复制。
- 片段和静帧在 `presentation/assets_en/`（`clip_motion_en.mp4`、`clip_sensing_en.mp4`、`still_*_en.jpg`），截取方式和 `assets_v6` 的中文版相同。

## 待确认
- 音效和配乐都是代码合成的，没有人耳试听过，请戴耳机听一遍。
