xiaweiyi0423/me5412-bedexit-proposal/presentation/slides_en/NOTES_TIMING.md

# English notes — speaking time (slides cover … fall_side)

Estimate: spoken words ÷ 130 words/min. Chinese reference: note characters ÷ 230.

| Slide | Note words | Est. min (EN) | Chinese est. min |
|---|---:|---:|---:|
| cover | 33 | 0.25 | 0.23 |
| film (46 s film + one spoken line) | 6 | 0.81 | 0.83 |
| agenda | 27 | 0.21 | 0.19 |
| problem | 95 | 0.73 | 0.67 |
| prior | 98 | 0.75 | 0.64 |
| whynot | 145 | 1.12 | 1.00 |
| mech_path | 99 | 0.76 | 0.74 |
| mech_select | 84 | 0.65 | 0.54 |
| mechanism | 120 | 0.92 | 0.86 |
| motion | 67 | 0.52 | 0.48 |
| stability | 135 | 1.04 | 0.99 |
| sensing | 101 | 0.78 | 0.67 |
| statemachine | 128 | 0.98 | 0.90 |
| risk | 83 | 0.64 | 0.57 |
| fall_side | 109 | 0.84 | 0.73 |
| **Total** | **1330** | **11.00** | **10.04** |

Total ≈ 11.0 min for these 15 slides including the 46 s film (≈ 10.2 min of speech). The Chinese notes for the same slides come to ≈ 10.0 min.
