xiaweiyi0423/me5412-bedexit-proposal/presentation/video/STORYBOARD.md

# 床边起身台 · 概念短片分镜（约 70 s，1920×1080，30 fps）

故事：凌晨三点，一位奶奶要起床去洗手间。先看她从低床站起来有多吃力；再看起身台怎么帮她：挪上座板 → 握杆按开关 → 座板托着她慢慢起来 → 中途头晕松手，座板停住接住她 → 站稳后走开。
基调：安静、温暖、夜里的暖光；不煽情，不出现任何屏幕文字（文字由剪辑统一加）。
**画风（用户决定）：动画，不用写实。** 温暖的风格化三维动画短片质感：圆润造型、简化材质、夜里暖色台灯光；奶奶是亲切的动画角色，每个镜头同一造型。

## 统一设定（所有 AI 画面必须一致）
- **人物**：中国老奶奶，约 78 岁，偏瘦，短的灰白头发，浅蓝色棉质格子睡衣，赤脚或穿浅色拖鞋。动作缓慢、谨慎。
- **房间**：普通家庭卧室，夜里；床头一盏暖黄小台灯是主光；木地板；双人床较低（床垫面约 42 cm 高），白/浅灰床品；背景简洁。
- **装置（起身台）**：落地放在床的长边，紧贴床沿，不是放在床头柜上。参照 CAD 截图：
  - 座板：一块带软垫的座板（米黄色坐垫），平时上表面和床垫面齐平，紧挨床沿向外伸出，人从床沿往前挪 10–20 cm 就坐在它上面；
  - 机构箱：在座板靠床头的一侧，一个竖立的半透明 / 浅灰色斜顶箱体，高约 0.9 m，里面隐约可见斜导轨；
  - L 形扶手：底座前端一根竖直立柱（约 1 m 高），顶部一根水平横杆伸到人的正前方，横杆上有握把开关（小灯）；
  - 脚踏板：人脚下的一块深色踏板（底座）；
  - 床尾一侧是敞开的。
- **座板怎么动（关键，不能画错）**：起身时座板**往前、往上、微微前倾**（最多约 15°），一直托在臀部和大腿下面，跟着大腿走；不是竖直升降，也不是把人弹起来。速度很慢（全程约 10 秒）。人松手，座板立刻停住。
- 参考图：`/home/user/me5412-bedexit-proposal/presentation/assets_v57/3d_a_shell.png`（外形），`3d_c1_flush.png` / `3d_c2_mid.png` / `3d_c3_top.png`（座板三个位置），`/home/user/me5412-bedexit-proposal/presentation/animations/seat_step1.png` … `seat_step5.png`（人和座板的姿势，二维示意）。

## 分镜（时长为目标值）
| # | 来源 | 时长 | 画面 | 旁白（中文） |
|---|---|---|---|---|
| S1 | AI | 5 s | 黑暗卧室，床头电子钟 03:07 发着微光（钟面数字可以有），镜头慢慢移到床上，奶奶醒来、慢慢坐起。 | 凌晨三点，她要起来去洗手间。 |
| S2 | AI | 7 s | 普通低床（这一镜**没有**起身台）：她坐在床沿，双手撑床垫想站起来，起到一半腿发软、晃了一下，又重重坐回床上。 | 床太低，腿没力气。最难的，就是从床沿站起来的那一下。 |
| S3 | 图形 | 3 s | 片名卡：“床边起身台”，黑底，柔光。 | （无） |
| S4 | AI | 6 s | 同一间卧室，起身台在床边，座板和床面齐平；镜头缓慢推近，暖光。 | 平时，它和床一样低。 |
| S5 | AI | 6 s | 奶奶坐在床沿，往前挪了一点，臀部移到座板上；脚踩在踏板上。 | 往前挪一点，就坐上了座板。 |
| S6 | AI | 5 s | 特写：双手握住身前的横杆，拇指按住握把上的开关，一个琥珀色小灯亮起。 | 双手握住身前的横杆，按住开关。 |
| S7 | AI | 8 s | 中景侧面：她身体前倾，座板托着她往前、往上、微微前倾地升起，她慢慢站起来。 | 座板跟着她的大腿，往前、往上、微微前倾，一路托着她。 |
| S8 | 模型动画 | 9 s | 透视（X 光）转场：深色背景，侧视；人体剪影 + 座板沿真实轨迹上升，导轨、连杆发光；座板中心轨迹被一条亮线画出来；数字：前移 18.5 cm · 上升 27.4 cm · 前倾 ≤ 16°。 | 她卸掉多少体重，座板就升多快——座板、踏板和横杆里的测力单元，一直在感受她用了多少力。 |
| S9 | AI | 6 s | 起身到一半，她闭眼、晃了一下，手松开横杆；座板停住；她顺势坐回座板上，被稳稳接住。 | 一松手，它就停；头一晕坐回去，座板还在身后接着。 |
| S10 | AI | 6 s | 她站稳，松开横杆，从踏板上迈下来，走向门口的小夜灯；座板停在原处。 | 站稳了，再走。 |
| S11 | 图形 | 5 s | 结尾卡：“平时和床一样低 · 起身时一路托着 · 松手就停”，下方 “ME5412 Robotics for Healthcare · Group 16”。 | 床边起身台——让夜里的每一次起身，都有东西托着。 |

剪辑规则（由主会话完成）：AI 画面右下角标“AI 生成动画（概念示意）”；S8 标“按设计尺寸的模型动画”；中文字幕；配音 + 轻音乐；AI 片段自带的声音只保留很轻的环境声或去掉。

## 修订（用户：不必写实，二维三维切换更自然）
- S1、S2、S10：AI 生成的**二维手绘插画动画**（故事开头和结尾）。
- S4–S7、S9、S10a：自己的 three.js **三维**场景（CAD 网格 + 由模型姿态驱动的风格化人偶），真实机构轨迹。
- 转场：S4 由扁平侧视蓝图“立”成三维；S7 末尾转回正侧面、压平成 S8 的 X 光二维；S9 再“立”回三维。
- S8 优先用三维引擎里的 X 光版本（与 S7 无缝衔接），matplotlib 版作备选。

## 修订 2（用户：漫画形式；人体三维不要；时长压短，约 48 s）
| # | 形式 | 时长 | 旁白 |
|---|---|---|---|
| S1 | 二维手绘（AI） | 4 s | 凌晨三点，她要起床。 |
| S2 | 二维手绘（AI） | 5.5 s | 床太低，最难的是站起来那一下。 |
| S3 | 片名卡 | 2.5 s | — |
| S4 | 三维装置登场（无人），末尾压平成钢笔速写 | 5 s | 平时，它和床一样低。 |
| K5 | 动态漫画 | 4 s | 往前挪一点，就坐上了座板。 |
| K6 | 动态漫画 | 3.5 s | 握住横杆，按住开关。 |
| K7 | 动态漫画（翻页式起身） | 6 s | 座板跟着大腿，往前、往上，一路托着她。 |
| S8 | 二维 X 光蓝图 | 6.5 s | 她卸掉多少体重，座板就升多快。 |
| K9 | 动态漫画 | 5 s | 一松手就停，坐回去也接得住。 |
| K10a | 动态漫画 | 2.5 s | 站稳了，再走。 |
| S10 | 二维手绘（AI） | 4 s | （无） |
| S11 | 结尾卡 | 5 s | 床边起身台，让夜里的每一次起身都有依靠。 |

## 修订 3（用户：X 光人体也吓人 → 机构用漫画形式展示，和人体连接）
- K7 和 S8 合并为一页漫画 K78（约 9.5 s）：左大格是 AI 漫画奶奶起身翻页（R1–R6），右侧放大镜小格是代码画的手绘机构动画（只画机构，不画人），两格用漫画放大引线连起来，座板状态同步。
- 小格里座板停在放手高度 0.57 m，计数器到放手时的值；小字注明全行程 18.5 cm / 27.4 cm / ≤ 16°。
- 旁白：N7 + N8 连读（座板跟着大腿……；她卸掉多少体重，座板就升多快）。

## 修订 4（用户：要有想象力；不展示数据）——贯穿意象：墙上的影子
台灯把她的影子投在墙上；座板托起她时，起身台的影子变成一只温柔的大手托住她的影子。机构讲“怎么托”，影子讲“被托住的感觉”。全片不出现任何数字。

| # | 形式 | 约时长 | 旁白 |
|---|---|---|---|
| S1 | 二维手绘视频 | 4 s | 凌晨三点，她要起床。 |
| S2 | 二维手绘视频 | 4.5 s | — |
| K2 | 漫画夸张：床沿像悬崖 | 3 s | （N2 跨 S2–K2）从床沿到站直，只有半米，却是夜里最远的一段路。 |
| S3 | 片名卡（水彩） | 2.5 s | — |
| S4 | 速写 → 三维装置（无人）→ 压平成速写 | 5 s | 平时，它和床一样低，安安静静。 |
| K5 | 漫画 | 3.5 s | 往前挪一点，就坐上了。 |
| K6 | 漫画「咔哒」 | 3 s | 握住横杆，按住开关。 |
| K78 | 漫画翻页起身 + 墙上影子手 + 机构放大镜小格 | 10 s | 座板跟着她的腿……托着她。／她快一点…… |
| K9 | 漫画「晕…」「停」+ 影子手心 | 5 s | 一松手就停。坐回去，还有它接着。 |
| K10a | 漫画 | 2.5 s | 站稳了，再走。 |
| S10 | 二维手绘视频（走廊） | 3.5 s | — |
| KE | 漫画：天亮，她安睡，座板和床一样低 | 3.5 s | — |
| S11 | 结尾卡 | 4.5 s | 床边起身台——夜里起身，有它托着。 |

## 修订 5（用户：抓细节、抓环境；“手托”不好 → 找回年轻时的自己）
意象：她自己站起来，像年轻时一样。现实里的她始终是老人；只有墙上的影子和床头的老照片是年轻的她（25 岁，麻花辫）。
- 铺垫 KD：床头柜特写（闹钟 03:07、老花镜、水杯、药盒、年轻时的老照片）+ 月光下的拖鞋。音效：滴答。
- K78：起身翻页 R1、R2 → Y3–Y6（墙上是年轻的她，同步轻快地站起来）+ 机构放大镜小格；说明框“她自己，慢慢站了起来”。
- K9：头晕松手“停”，坐回；墙上年轻的影子也安静坐下（Y9）。
- KE：天亮，阳光照在老照片上，她安睡带笑，座板和床一样低。
- 结尾卡：平时和床一样低 / 起身由她做主 / 松手就停 / 让她，自己站起来。
- 音效：滴答、咔哒、轻嗡、拖鞋脚步、鸟叫。旁白 N7、N11 改。

## 修订 6（用户：抓神态；机构像什么、一帧一帧变成什么；不用数据、不冰冷）
- 机构的形象：仙鹤（导轨=鹤颈，连杆=鹤腿，座板随鹤首往前上扬起；松鹤延年；crane 双关）。备选：摇椅、海浪。
- K78 放大镜小格：先是精确的手绘机构在动（滑块滑、连杆转、坐垫贴腿），再一帧帧长出羽毛 → 水墨仙鹤扬颈站直（M2m–M5m）。
- 墙上影子成“皮影戏双人舞”：她的影子是年轻的自己，机构的影子是扬颈的仙鹤（Y3–Y6、Y9）。
- 神态特写 F_worry / F_struggle / F_curious / F_press / F_rise / F_proud / F_sleep 穿插。
- N7：座板跟着她，像一只仙鹤，慢慢扬起脖子——她自己，站了起来。

## 修订 7（用户选定：善意的回响 + 零件大拆大卸；参考 Gemini 4 评审 presentation/video/review_gemini4.md）
故事：许多年前，她在雪地里扶起过一只受伤的鹤；如今，鹤陪她自己站起来。鹤始终是站在地上的陪伴者：不飞走、不驮她、不在她身下（避开“驾鹤西去”）。
删去：悬崖、红章“停”、“晕…”、年轻的影子、放大镜变鹤、麻雀。照片用暖色，不用黑白。
| # | 约时长 | 画面 | 旁白 |
|---|---|---|---|
| S1 | 4 | 醒来 03:07 | 凌晨三点。 |
| KD | 5 | 担心的脸 → 床头老照片（年轻的她扶起丹顶鹤）→ 照片“活”过来，雪花飘 | 许多年前，她在雪地里，扶起过一只受伤的鹤； |
| S2 | 5 | 低床起身失败 | 如今，从床沿到站直，成了夜里最难的一段路。 |
| S3 | 3 | 片名（宣纸暖光） | — |
| S4 | 3.5 | 速写 → 三维卧室 → 速写 | — |
| S_crane | 8 | 零件大拆大卸 → 拼成丹顶鹤（按钮=丹顶）→ 低头致意 → 收回成起身台 | （末尾）平时，它和床一样低，安安静静。 |
| K5 | 4 | 挪上座板 | 往前挪一点，就坐上了。 |
| K6 | 3.5 | 握杆按键“咔哒” | 握住横杆，按住开关。 |
| K78 | 11 | 起身翻页；墙上鹤影在她身侧扬颈 | 它像一位老朋友，慢慢扬起脖颈——／她快一点…… |
| K9 | 5.5 | 松手 → 按钮灯灭、座板停住 → 坐回，鹤影半蹲护持 | 一松手，就稳稳停住；坐回去，也有它接着。 |
| K10a | 3 | 站稳迈下 | 站稳了，再走。 |
| S10 | 3 | 走廊夜灯 | — |
| KE | 5 | 天亮，阳光照在老照片上 | 曾经，她扶起过一只鹤； |
| S11 | 5 | 结尾卡 | 如今，它陪她，自己站起来。 |
零件→鹤：丹顶=琥珀按钮；头=电机+制动器；喙=倾角连杆；颈=斜导轨+丝杠；身=坐垫+滑块板；翼=两块侧板；尾=黑色 L 形扶手；腿=两根底座纵梁；落脚=脚踏板。
注意（纠正 Gemini 的一处）：坐回时座板不会后退或下降，只是停住接住（只有按住“降”才往下动）。
