xiaweiyi0423/me5412-bedexit-proposal/presentation/video/review_gemini35flash.md

model gemini-3.5-flash video=True

这是一份直接、有建设性的专业评审意见。

---

### 1. 现在的片子哪里“怪”？

核心问题在于：**“符号过载，逻辑脱节”**。

*   **具体镜头与意象解析（第 20–38 秒）：**
    1.  **分镜信息打架（第 30 秒）：** 画面左侧是老人的现实姿态，背景影子里叠加了“年轻的她 + 仙鹤”，右侧放大镜格里又是“机械结构变水墨鹤”。**一个画面里塞了 4 层不同时空/性质的意象**，观众不知该看机构演示，还是看情感隐喻。
    2.  **影子逻辑相悖：** 影子里展示“年轻的她”站立，但年轻女人并不需要仙鹤辅助；老人现在是因为高龄/体弱站不起来，这种对比反而强化了“衰老的无力感”，破坏了产品带来的尊严感。
    3.  **仙鹤出现得太硬：** 仙鹤在中国传统中极具美感，但片中机械突然变成水墨仙鹤，既没有交代“为什么是仙鹤”（缺乏前因），又像为了强行贴合“国风/养老”符号而硬加的元素。

---

### 2. 故事方向对比与明确推荐

*   **方案 a / b 评价：** 
    *   **a（送树枝）与 b（送花）：** 均偏向儿童童话，缺少现实共鸣。“树枝/花”与“帮老人托起身体”的物理力学及心理支撑感毫无关联。
*   **方案 c（你提出的“年轻扶起伤鹤，老了鹤陪伴站立”）评价：**
    *   **优点：** 具有极强的**因果逻辑**与**情感回报感**（“善意的回响”），将“扶起”这一核心动作贯穿一生，非常具有诗意和力量感。
    *   **缺点：** 50 秒内若要完整交代“冬日湿地救鹤”的闪回，易导致信息量过大；如果直接让机械“变形”成鹤，画风容易偏向科幻/变形金刚，破坏温馨氛围。

#### 【资深导演推荐：方案 D（方案 c 的精炼版）】
**无需复杂的救鹤闪回，聚焦于“双手”与“姿态的重叠”：**
*   **情节：** 
    1.  **开篇：** 深夜起身艰难。
    2.  **隐喻切入（2秒极简闪回）：** 记忆中年轻的她，曾温柔地在湿地里**双手扶起**一只受伤展翅的仙鹤（画面定格在“双手扶托”的姿态）。
    3.  **现实映照：** 画面切回现在，老人双手握住起身台的横杆，按下按键。起身台上升的轨迹、侧板的张开、导轨的倾斜，在灯光下**自然投影出一只侧立支撑、缓缓展翅的仙鹤影子**。
    4.  **情感升华：** 影子不是年轻的她，而是**如今的她与仙鹤重叠**。它像一位老友人，用翅膀贴心地托住她的身体。
*   **推荐理由：** 删繁就简，保留了 c 方案最核心的“扶起”因果，同时摒弃复杂的科幻变形，把仙鹤保留在**光影与动态拟物**层面上，最自然也最动人。

---

### 3. 装置零件拆解与仙鹤解剖学对应（自然拟物方案）

如果要将机构机械自然地拟物化（利用**光影/结构展开**过程），对应关系建议如下：

| 仙鹤部位 | 机械部件对应 | 拟物原理与视觉表现 |
| :--- | :--- | :--- |
| **丹顶（头顶）** | **握把上的琥珀色按钮** | 点睛之笔。按压发亮时，如同仙鹤头顶的一点朱红。 |
| **鹤喙 & 头** | **横杆与顶端电机/制动器箱体** | 横杆为喙，顶部控制箱为头部，构筑起上方稳定的抓握点。 |
| **鹤颈（优雅姿态）** | **竖直扶手立柱 + 倾角连杆** | 随着起身升起，细长的连杆与立柱形成拉伸的角度，如同仙鹤扬起脖颈。 |
| **躯干与羽翼** | **座板坐垫（米黄）+ 两块半透明侧板** | 米黄色坐垫为鹤身；两块侧板在上升过程中随斜导轨张开，如同**半合拢的翅膀在向上护持**。 |
| **鹤腿（支柱）** | **斜导轨（34°）+ 滚珠丝杠** | 细长强韧，斜向 34° 伸展的姿态与仙鹤站立准备起飞时的后腿角度完全一致。 |
| **鹤爪（根基）** | **底座与脚踏板** | 稳稳抓紧地面，给予老人安全感。 |

---

### 4. 必须避开的中国文化“雷区”

在中国传统文化中，仙鹤虽代表长寿，但与老人在夜间、病榻结合时，**极易触碰“驾鹤西去”（暗示去世）的禁忌**。

*   **画面绝对不能出现：**
    1.  **仙鹤带人飞走：** 切勿出现仙鹤拉着老人、或者老人的灵魂/影子跟着仙鹤飞向夜空/白光的镜头。
    2.  **冷色调阴间氛围：** 避免过冷、飘渺的纯蓝/纯白迷雾背景，这像魂魄出窍。
    3.  **突然脱离地面的悬空感：** 老人的脚必须全程或最终**稳稳踩在脚踏板/地面上**。
*   **正确做法：** 
    *   仙鹤的角色永远是**“地面上的陪伴者与支撑者”**，而非“带离者”。
    *   影片结尾必须**明确过渡到清晨阳光（晨光熹微、鸟鸣）**，老人独自走进温暖的客厅或阳台，展现“生机与长寿”，彻底破除暗喻。

---

### 5. 完整旁白修改案（配音时长：约 50 秒）

**基调：** 缓慢、温润、如叙家常，富有沉静的力量感。

---

**（00:00 - 00:12｜黑夜·困局）**
凌晨三点，黑夜正深。
从床沿到站直，不过半米，
却是她此刻，最远的一段路。

**（00:13 - 00:23｜闪回·契约）**
*（画面：极简线条闪过年轻时她双手扶起飞鸟，切回当下握紧横杆，琥珀按钮微微发光）*
许多年前，她曾温柔地扶起过生命；
如今，这份温柔，在黑夜里如期而至。

**（00:24 - 00:38｜起身·拟物）**
*（画面：上升过程，墙上光影如仙鹤舒展翅膀托举座板）*
握紧，微倾。
它如仙鹤抬颈，优雅伸展，
顺着大腿的起伏，安稳地将她托起。
快一点，慢一点，松手即停——
节奏，全由她自己做主。

**（00:39 - 00:49｜保护·站立）**
*（画面：老人短暂停顿，机构稳稳承接；随后脚踏实地，独立迈步）*
哪怕一时眩晕，也有这份依托牢牢接住。
站稳了，再从容迈步。

**（00:50 - 00:57｜天亮·主题）**
*（画面：晨光照进房间，老人安睡或独立站在窗前，旁白出品牌/主题名）*
床边起身台——
不替代她的力量，只守护她的尊严。
让她，自己站起来。
