xiaweiyi0423/me5412-bedexit-proposal/presentation/video/review_gemini4.md

作为动画导演兼编剧，我直接给结论：**你的诊断非常精准，你提出的方案（c）和修改方向整体上是对的，但在“叙事体量”和“意象克制”上还有三处硬伤，必须砍掉或调整，否则会从“怪”变成“满”。**

下面逐一直接回答，并严格挑出你当前方案里的问题。

---

### 1. 现在的片子哪里“怪”？（具体到镜头与意象）

核心病根：**三个互不统属的隐喻在 10 秒内打架，且缺乏前因。**

1. **00:05 床头相框（伏笔落空）**：给了年轻时的单人照特写，观众以为故事和“青春/故人”有关，但后面突然蹦出仙鹤，照片没起到任何叙事勾连作用。
2. **00:11 悬崖意象（调性断裂）**：床沿突然变成万丈深渊，这是极其惊悚的恐怖片/焦虑症视觉语言，和后面温情的水墨仙鹤画风完全割裂。
3. **00:28–00:38 视觉超载与逻辑打架（最“怪”的地方）**：
   - **空间与生理怪异**：左格里，墙上的鹤影正好叠在老人的臀部与后腰处，长长的鹤嘴从她胸前穿出去，像身体里长出一只鸟，视觉上不舒服。
   - **双重隐喻冲突**：墙上的影子变成了“年轻扎马尾的她 + 仙鹤”，右边放大镜里又是“冷冰冰的机械连杆强行渐变成写实水墨仙鹤”。观众在短短 6 秒内要处理：**老人、年轻影子、鹤影、机械结构、水墨真鹤**五个图层。
   - **隐喻选错本体**：右格把“斜导轨上升”比作“仙鹤扬起脖子”，但实际上座板是在托举臀部，机械结构硬套动物解剖结构（滑块还在鹤胸口滑动），看起来像把鹤钉在标本架上，产生了机械恐怖谷效应。
4. **00:40 红章“停”（画风跳戏）**：在蓝调夜景里突然盖一个鲜红的公文章“停”，像交通宣传片或搞笑漫，瞬间破坏了深夜的静谧感。
5. **00:49 窗台麻雀**：前面大讲仙鹤，最后窗台落了一只小麻雀，意象不统一。

---

### 2. 故事方向对比（a / b / c / 升级版 d）

- **(a) 鹤送树枝**：**淘汰**。树枝对应的是“拐杖”，是外力支撑；且在文化里缺乏典故，像随便编的童话。
- **(b) 鹤送花**：**淘汰**。花是易碎、观赏性的，人不可能“靠着一朵花站起来”，物理逻辑和产品核心（托举、稳定）完全脱节。
- **(c) 你的方案（雪地扶鹤 → 如今鹤陪她起）**：**目前三个里最好**。好在动作同构——**“扶稳，但让对方靠自己的力量站起来”**，精准命中产品卖点（人机共融、自己做主、松手即停）。

**【严格挑错你的方案 c】**
你在 57 秒的功能概念片里，既要加“3秒雪地闪回”，又要加“零件拆解重组成鹤、低头致意、再收回”，还要讲完所有产品功能——**太满了，会喧宾夺主，变成奇幻神话片。**
具体有三个问题：
1. **闪回太具象会抢戏**：如果塞进一段“年轻姑娘在雪地救鹤”的动态戏，观众会以为这老太太以前是自然保护区护林员，注意力被拉到“人和野生动物的报恩故事”上，削弱了普世的衰老共鸣。
2. **“爆炸图重组变鹤 + 低头致意”违背了你自己的克制原则**：底座、立柱、导轨全拆散飞起来拼成一只鹤，还要做拟人动作“低头致意”，这依然是变形金刚/机甲变身的逻辑，和“平时安安静静、不打扰”的产品气质相悖。
3. **“鹤影单腿站立”对应错了**：00:40 她头晕坐回，需要的是**千钧一发的稳固托底**。丹顶鹤“单腿独立”在视觉上是纤细、孤傲、考验平衡感的，无法传递“稳稳接住、绝对安全”的厚重感。

**【更好的方案 d（导演推荐版：轻闪回 + 呼吸重影）】**
- **不加独立闪回镜头，用“一张照片 + 一句旁白”完成前史**：00:05 看床头时，相框里就是**年轻的她在芦苇雪地里，双手虚扶着一只刚站稳的鹤**（照片局部微动1.5秒即可，像记忆泛起）。省下时间留给呼吸感。
- **不把机器炸碎重组，而是“原位抽离重影”**：斜导轨本来就是34°，不需要大拆大卸。零件只在原位轻轻错位展开半寸（像深呼吸），线条以斜导轨为轴，自然晕染叠化出一只**收翅伫立的折纸/水墨几何鹤**，与起身台原位重合。
- **头晕坐回时**：鹤影不是单腿站，而是**微张双翼、稳稳半蹲托住她**（护巢/托举姿态）。

---

### 3. 零件拆解与鹤身部位的最佳对应（修正你的方案）

**【挑错你的对应】**
你把“两条腿 = 扶手立柱 + 滚珠丝杠”放在一起是不对的！
在你的三维结构里，**滚珠丝杠和斜导轨是平行重合的（34°斜向）**，而**扶手立柱是垂直的（90°）**。如果丝杠当一条腿、立柱当另一条腿，这只鹤的两条腿是劈叉成三角形的；而且如果斜导轨当脖子（向上），丝杠当腿（向下），它们本来是一体的，拆开后空间运动轨迹会非常乱。

**【更自然、符合原机几何结构的对应方案】**
保持机器原有的**“右高左低、34°斜向”**姿态，让鹤**面向右侧（朝向床外/站立方向）**，几乎不用大幅搬移零件就能自然成鹤：

*   **丹顶（点睛之笔）** ＝ **握把上的琥珀色按钮**（唯一的一点暖橙色光晕，移至最高处）。
*   **头（鹤首）** ＝ **顶部电机与制动器壳体**（位于斜导轨最顶端，敦实小巧）。
*   **喙（鹤嘴）** ＝ **细长的倾角连杆**（从顶部向前斜伸出去，线条锐利修长）。
*   **颈（修长鹤颈）** ＝ **34°斜导轨 + 滚珠丝杠（合二为一）**（丝杠的螺纹刚好形成水墨鹤颈的纹理与骨骼感，34°仰角完美对应仙鹤昂首的弧度）。
*   **身体（胸腹与背部）** ＝ **米黄色座板坐垫 + 滑块板**（温润的米黄色对应鹤白羽的主体，斜切面即鹤背）。
*   **双翼（护翼）** ＝ **机构箱的两块半透明侧板**（在身体两侧微微张开15°，半透明材质如蝉翼/宣纸羽翼，拢在座板两侧）。
*   **黑色尾羽（垂尾）** ＝ **黑色横杆握把**（移至坐垫左后方斜垂，丹顶鹤收翅时尾部刚好是醒目的黑色羽簇）。
*   **双腿（长腿）** ＝ **两根竖直的扶手立柱管**（或是立柱主杆与内部套管一前一后微错开，笔直修长，垂直立于地面）。
*   **足与大地（落脚处）** ＝ **白色底座与脚踏板**（化作水面涟漪或薄雪地面，稳稳生根）。

---

### 4. 中国文化雷区与画面禁忌（生死红线！）

在中国老年产品中，“鹤”是一把双刃剑（既是“松鹤延年”，又是“驾鹤西去”）。为了**绝对避开“去世/送终”的联想**，必须严格执行以下 6 条视觉铁律：

1. **严禁“展翅高飞 / 破窗飞走”**：整支片子里，鹤**绝对不能离开地面飞向天空**。鹤的脚必须像起身台的底座一样，死死钉在地板上。结尾窗外也不要有飞远的鹤，改成晨光即可。
2. **严禁“骑跨”视觉**：这就是为什么00:30原片很忌讳——墙上的鹤影千万不能再叠在老人的胯下或臀部正下方（像骑鹤上天）。**鹤影必须移到老人的身侧偏前（扶手立柱的位置），与她是“并肩扶持”关系，绝不是“坐骑”关系。**
3. **严禁“向西（向左）走入白光/云雾”**：走道镜头（00:46），老人走去的方向必须是温暖的橙色人间烟火光（夜灯），不能是刺眼的白光；片头片尾字幕底图那团像“魂魄/祥云”的橙色烟雾（00:14, 00:53）建议改成**温暖的台灯光晕或宣纸水彩晕染**。
4. **严禁在老人照片上做黑白/灰调处理**：00:05 床头的年轻照片，哪怕是老照片，也必须带**暖棕/淡彩（米黄与暖红）**，绝不能做成黑白框照（夜里床头放黑白照极像遗像）。
5. **去掉悬崖（00:11）和红章“停”（00:40）**：床边变万丈深渊太不吉利（像掉下黄泉）；红章像判词。
6. **老人不能闭眼被抬起**：起身全过程，老人的眼睛要看向前方，双脚始终踏实在脚踏板上，强调生命力与自主权。

---

### 5. 全新旁白（约 55 秒，无数据、温暖克制）

**【修改说明】**
- 砍掉了原片“只有半米”这种说明书式的尺寸词。
- 把“扶鹤”的前史融进开头，让仙鹤的出现名正言顺，首尾形成完整的文学闭环。
- 语速放慢，留白给呼吸和音乐。

> **【完整新旁白】**
> 凌晨三点。
> 许多年前，她在雪地里，扶起过一只受伤的鹤；
> 如今，从床沿到站直，成了夜里最难的一段路。
>
> **（片名：床边起身台）**
>
> 平时，它和床一样低，安安静静。
> 往前挪一点，就坐上了。
>
> 握住横杆，按住开关。
> 它便如故友一般，慢慢扬起脖颈——
> 她快一点，它就快一点；她慢下来，它也跟着慢。
> 一松手，就稳稳停住；哪怕坐回去，也有它托着。
>
> 站稳了，再走。
>
> 曾经，她扶起过一只鹤；
> 如今，它陪她，自己站起来。

---

### 6. 最终推荐版：逐镜分镜表（总长 58 秒）

| 镜号 | 时长 | 画面（钢笔淡彩+温暖水彩风） | 旁白 / 字幕 | 声音设计（SFX / BGM） |
| :--- | :--- | :--- | :--- | :--- |
| **01** | 00:00-00:04 (4s) | 蓝色静谧的卧室。凌晨 03:07，老奶奶醒来，掀开被子一角，望着床边发怔。 | **旁白**：凌晨三点。 | 夜色环境音，极轻的被褥摩擦声。单音钢琴轻轻落下。 |
| **02** | 00:04-00:08 (4s) | **【特写推镜】** 床头柜暖灯亮起。旁边相框里是一张淡彩旧照：年轻的她在雪地芦苇间，双手虚扶着一只刚站起来的丹顶鹤（照片里的雪花与鹤羽微动1秒）。 | **旁白**：许多年前，她在雪地里，扶起过一只受伤的鹤； | 清脆的一声台灯拉绳声“咔哒”，伴随一声悠远极轻的鹤鸣泛音。 |
| **03** | 00:08-00:13 (5s) | **【中景】** 奶奶坐在低矮的床沿，双手撑膝，用尽力气想站起来，腿一软又跌坐回床沿。**（去掉原片悬崖，改为床沿在深蓝阴影里显得格外低陷孤立）**。 | **旁白**：如今，从床沿到站直，成了夜里最难的一段路。 | 沉重的呼吸声，床垫下陷的闷响。弦乐低音进入。 |
| **04** | 00:13-00:16 (3s) | 深蓝底色上，一圈温暖的琥珀色台灯光晕晕开，浮现书法衬线字体。 | **字幕**：床边起身台<br>Bedside Sit-to-Stand Seat | 温暖的木管乐过渡。 |
| **05** | 00:16-00:22 (6s) | **【核心镜：拆解变鹤】**（详见下方逐秒设计）。床边起身台静立，零件如呼吸般轻舒展，线条晕染成一只收翅伫立的折纸水墨鹤，向床沿微低头，随即收回成与床齐平的起身台。 | **旁白**：平时，它和床一样低，安安静静。 | 宣纸舒展的沙沙声，极轻柔的机械精密啮合声，融合成一声温润的金属风铃音。 |
| **06** | 00:22-00:26 (4s) | **【漫画双格】** 左格：奶奶从床沿自然往外平移半步；右格特写：稳稳坐上米黄色软垫，双脚平踩在脚踏板上。 | **旁白**：往前挪一点，就坐上了。 | 衣料摩挲声，踏实落座的轻柔声。 |
| **07** | 00:26-00:29 (3s) | **【特写】** 苍老的手握住黑色横杆，拇指按下琥珀色按钮，按钮亮起呼吸般的暖光。 | **旁白**：握住横杆，按住开关。 | 清脆温和的按键音“嗒”。 |
| **08** | 00:29-00:38 (9s) | **【单幅大画格，去掉右格放大镜】** 座板沿34°斜轨缓缓前倾上托。**墙上只有现在的她，与身侧前方的鹤影并肩**。鹤影随着斜导轨的上升慢慢扬起长颈，仿佛用背部和双翼托着她的起身轨迹。右下角小格：奶奶从容微笑的脸。 | **旁白**：它便如故友一般，慢慢扬起脖颈——<br>她快一点，它就快一点；她慢下来，它也跟着慢。 | 极安静的低频电机柔音，大提琴与钢琴如水流般上扬，节奏完全跟随她的动作。 |
| **09** | 00:38-00:44 (6s) | **【双格递进】** 左格：奶奶起身到一半微感头晕，拇指一松，琥珀灯灭，座板瞬间稳稳停住（**去掉红章“停”**）；右格：她顺势往后一靠，座板温柔退回半寸稳稳托住她，墙上的鹤影微张双翼呈半蹲护持状。 | **旁白**：一松手，就稳稳停住；哪怕坐回去，也有它托着。 | 音乐轻顿，一声极其沉稳的制动锁止声（安心感），随后弦乐温暖包裹。 |
| **10** | 00:44-00:49 (5s) | 奶奶缓过神，再次按住开关，完全站直。双脚稳稳踩在地板上，松开扶手，迈步走出卧室，走向走廊尽头温暖的夜灯。 | **旁白**：站稳了，再走。 | 稳健、踏实的拖鞋脚步声，一步一步。 |
| **11** | 00:49-00:54 (5s) | **【清晨】** 金色晨光洒进卧室。奶奶安详地熟睡，起身台安静地守在床边，与床齐平。晨光刚好照亮床头那张“雪地扶鹤”的旧相框（**窗台不画鸟**）。 | **旁白**：曾经，她扶起过一只鹤； | 清晨微风声，温暖明亮的钢琴尾奏。 |
| **12** | 00:54-00:58 (4s) | 画面叠化为温暖的宣纸米色光晕，浮现定版字幕。 | **旁白**：如今，它陪她，自己站起来。<br>**字幕**：平时和床一样低 / 起身由她做主 / 松手就停<br>**让她，自己站起来** | 余音绕梁，温暖收束。 |

---

### 7. 专项设计：第 05 镜“拆解变鹤”逐秒动作表（共 6 秒）

**美术与动态总则**：
拒绝“变形金刚式”的碎裂与硬拼。采用**“钢笔建筑速写 + 宣纸折纸 + 淡彩晕染”**风格。零件移动幅度控制在 **5–15 厘米** 的“微呼吸”范围内，保持整体重心在原地不动。

*   **第 1 秒（00:16–00:17）｜静立与微光唤醒**
    *   画面从三维白模渐变为温暖的钢笔淡彩线稿，起身台静静立在床边。
    *   扶手上的**琥珀色按钮**率先亮起一点暖光，像心脏跳动了一下。
*   **第 2 秒（00:17–00:18）｜呼吸式微展开（原位错位）**
    *   整体机构像吸了一口气，沿着 34° 斜轴轻轻向上舒展：
    *   两块**半透明侧板**向两侧微张开 15°，化作两片半透明的折纸羽翼；
    *   **黑色横杆**向后下方轻旋滑落至坐垫尾端，化作一簇墨色垂尾；
    *   **扶手立柱**向下稳稳扎入底座，线条拉长成一双笔直的鹤腿。
*   **第 3 秒（00:18–00:19）｜昂首成鹤（水墨叠化）**
    *   **34°斜导轨与丝杠**向上轻扬，淡墨顺着金属导轨晕开，化作修长的鹤颈；
    *   **顶部电机壳**化作鹤首，**琥珀色按钮**落于头顶化作一抹丹砂（丹顶），**细长的倾角连杆**向前轻点，化作修长的鹤喙；
    *   **米黄色坐垫**柔化成饱满的鹤身白羽。一只几何折纸感与水墨感兼具的丹顶鹤，双脚稳稳立在底座上（绝不离地）。
*   **第 4 秒（00:19–00:20）｜低首致意（建立连接）**
    *   这只立在床边的“折纸机械鹤”，朝着床沿的方向，极其克制、温顺地**微微俯首（前倾约 10°）**——这既是故友的致意，也正好预示了座板“前倾托举”的机械轨迹。
*   **第 5–6 秒（00:20–00:22）｜归位守候**
    *   水墨羽翼与线条如潮水般向内收拢、贴合，顺滑地退回成严谨、温和的工业产品形态。
    *   米黄色座板轻轻落回最低点，与床垫表面严丝合缝地齐平，安静等待奶奶坐上来。
