xiaweiyi0423/me5412-bedexit-proposal/model/calc_v13/pelvic_push_summary.md

# 臀部后靠垫与前倾座板：模型验证（2026-10-26）

脚本：`pelvic_push.py`，结果：`pelvic_push.json`。模型同 `seat_support.py`（2D 准静态，髋、膝、肩、肘），新增：

- 靠垫：从身后水平往前推的力，最多 0.05 / 0.10 / 0.15 倍体重，作用在髋下方 5 cm（臀部、骶骨）或髋上方 10 cm（腰部）。
- 前倾座板：座板托力带一个往前的分量（tan 倾角），无摩擦。

无靠垫、无倾斜时复现原结果（0.66 m 离座 0.233，0.42 m 起步 0.155）。effort = 最吃力关节用掉自身最大力量的比例。
P1 = 手上 ≤ 25% 体重；P2 = 肩肘力量 ×0.5。

## A. 离座那一刻（座板不再托人）

| 座高 | 无靠垫 P1 / P2 | 臀部 0.10 | 臀部 0.15 | 腰部 0.10 | 腰部 0.15 |
|---|---|---|---|---|---|
| 0.58 m | 0.291 / 0.334 | 0.252 / 0.304 | 0.242 / 0.287 | 0.261 / 0.311 | 0.259 / 0.311 |
| 0.62 m | 0.258 / 0.297 | 0.225 / 0.279 | 0.207 / 0.259 | 0.242 / 0.284 | 0.235 / 0.272 |
| 0.66 m | 0.233 / 0.251 | 0.202 / 0.218 | 0.181 / 0.195 | 0.211 / 0.219 | 0.195 / 0.211 |

推臀部在每个高度都比推腰部更省力。0.10 倍体重（约 59 N）的臀部推力在 0.66 m 让离座省 13%；在 0.62 m 加推力，比不加推力升到 0.66 m 还省力。

## B. 离座以后：从半蹲到站直（0.66 m 离座，横杆停在离座时的位置）

| 髋高 | 0.75（离座） | 0.77 | 0.79 | 0.81 | 0.83（接近站直） |
|---|---|---|---|---|---|
| 无靠垫 P1 | 0.233 | 0.215 | 0.191 | 0.162 | 0.103 |
| 臀部 0.10 P1 | 0.201 | 0.171 | 0.145 | 0.116 | 0.058 |
| 无靠垫 P2 | 0.251 | 0.232 | 0.205 | 0.174 | 0.111 |

离座后越往上越省力：最难的是离座那一下，不是站直。

## C. 上身前倾固定在 30° 以上（粗略代替驼背），靠垫推力固定为 0.10 倍体重

| 情况 | 无靠垫 | 推臀部 | 推腰部 |
|---|---|---|---|
| P1，离座时 | 0.242 | 0.210 | 0.231 |
| P1，起身一半 | 0.232 | 0.214 | **0.246（更吃力）** |
| P2，离座时 | 0.296 | 0.283 | **0.316（更吃力）** |
| P2，起身一半 | 0.306 | 0.291 | **0.335（更吃力）** |

- 上身前倾时，离座后不会越来越轻松（P1 0.242 → 0.232，P2 0.296 → 0.306）：瓶颈在髋部扛着前倾的上身。
- 推腰部让前倾的人更吃力，推臀部仍有帮助但幅度小（−5% 到 −13%）。
- 有靠垫往前推时，前倾的人要用手往后拉横杆才能平衡（手的水平力变成负值）：松手就可能被推向前方。
- 上身直立时推腰部也会把足底压力中心推到离脚尖 4 cm 的约束边界（无靠垫时 5.8 cm）。

## D. 前倾座板（起步时，座板最多托 0.5 倍体重）

| 倾角 | 0° | 5° | 10° | 15° |
|---|---|---|---|---|
| 坐直起步 P1 / P2 | 0.155 / 0.166 | 0.155 / 0.163 | 0.152 / 0.164 | 0.148 / 0.162 |
| 前倾 ≥ 20° 起步 P1 / P2 | 0.229 / 0.267 | 0.222 / 0.259 | 0.214 / 0.251 | 0.207 / 0.242 |

前倾座板只在起步阶段起作用，而且收益小（坐直时几乎为 0；习惯性前倾时约 −10%）。离座那一刻座板不再受力，准静态模型里倾斜不可能改变最难的那一步。可能的动态好处（借惯性、带动骨盆前转）不在模型里。

## 局限

- 准静态，没有动态、平衡控制和踝关节；推力被当成可以精确控制的水平力。
- 靠垫的作用点高度相对髋固定；真实靠垫在人起身时会沿身体滑动。
- “驼背”只用躯干前倾角下限粗略代替，没有改脊柱形状和质心分布。
