xiaweiyi0423/me5412-bedexit-proposal/presentation/audit/gemini_A_argument.md

<!-- model: gemini-4-argon; finishReason: STOP; usage: {"promptTokenCount": 42968, "candidatesTokenCount": 3444, "totalTokenCount": 46412, "cachedContentTokenCount": 40741, "promptTokensDetails": [{"modality": "TEXT", "tokenCount": 12168}, {"modality": "IMAGE", "tokenCount": 30800}], "cacheTokensDetails": [{"modality": "TEXT", "tokenCount": 11539}, {"modality": "IMAGE", "tokenCount": 29202}], "candidatesTokensDetails": [{"modality": "TEXT", "tokenCount": 3444}]} -->

从“坐→站生物力学建模与核心论证逻辑”的审稿人角度来看，你们用一个简单的 2D 准静态模型抓住了“座高是决定关节力矩的第一要素”这一物理本质，并用来指导方案取舍（放弃动态扶手、转向升降座面），这个大方向非常扎实。

但在从“模型数字”走向“工程方案结论”的推理链条中，存在几处明显的**物理矛盾、代价漏算和假设黑箱**。如果在答辩时被懂行的老师追问，很容易被问住。按严重程度排序如下：

---

### 1. 【高】生物力学模型与控制策略在物理上直接打架（核心论证自相矛盾）
* **在哪里**：第 7 页（模型结论）vs 第 4、10、14 页（控制规则与推力上限）。
* **原文证据**：
  * 第 7 页讲稿：“算**离座那一刻**最吃力的关节用掉了自己最大力量的几成……起身台升到 0.66 m 是 0.23……比抬高床再省 13 到 20%。”（此时假设座高 $h = 0.66\text{ m}$，且臀部刚要离开座面，座面支持力 $F_{\text{seat}} \approx 0$）。
  * 第 14 页控制规则：“$v = k \times (\text{推力上限} - \text{座板测到的力})$……个人设置：推力上限 $0.3\text{–}0.6 \times \text{体重}$。”第 4 页要求：“推人的力不超过约半个体重：辅助，不把人整个抬起。”
* **为什么是问题**：
  * **确定的事实**：如果推力上限设为 $0.5 \times \text{体重}$，那么座板在从 $0.42\text{ m}$ 往上走的过程中，**只要它还在升，老人就必须自己用腿和手承担至少 $0.5 \times \text{体重}$ 的垂直力**（再加上动态控制所需的卸载量）。
  * **因果推导**：在 $0.42\text{ m}$ 的低位，老人要想让座板动起来，他的膝关节和髋关节就必须先发出能撑起大半个体重的力矩！而你们在第 7 页算“起身台省力”时，只算了座板**已经升到 $0.66\text{ m}$ 且完全离座那一瞬间**的受力，完全忽略了在 $0.42\text{ m} \to 0.66\text{ m}$ 抬升途中老人为配合“推力上限”所承受的关节负荷。换句话说：如果老人腿力弱到在 $0.42\text{ m}$ 处撑不起 $60\%\text{–}70\%$ 的体重，按第 14 页的控制律，座板根本不会升，他永远到不了 $0.66\text{ m}$；如果他能撑起，那他在最低位时就已经承受了巨大的关节力矩，第 7 页宣称的“0.23 的低 effort”就不再是全过程的最大吃力值。
* **怎么改**：
  1. 在第 7 页或附录中，补充一条曲线或说明：**在“座板分担 $50\%$ 体重”的条件下，人在 $0.42\text{ m}$ 处的关节 effort 是多少？** 只要证明“在 $0.42\text{ m}$ 处自己承担半个体重的 effort”依然小于或等于“在 $0.66\text{ m}$ 处自己承担全部体重（离座瞬间）的 effort（0.23）”，这条逻辑链就彻底闭环了。
  2. 如果算出来在 $0.42\text{ m}$ 处承担半个体重比 $0.66\text{ m}$ 离座还吃力，就必须把推力上限调高（例如起步时允许承担 $70\%\text{–}80\%$ 体重，随高度上升递减），或者修正第 14 页的公式说明。

---

### 2. 【高】为换取 13–20% 的起身省力，引入了“往前挪 25–30 cm”的新任务，但未评估其生物力学代价与几何畸变
* **在哪里**：第 6 页（使用流程与问答备注）、第 8 页（机构空间）、第 17 页（局限）。
* **原文证据**：
  * 第 6 页步骤 2：“往前挪上和床齐平的短座板”；讲稿指南问答：“问：往前挪 25–30 cm，老人做得到吗？答：这是目前最大的不确定。”
  * 第 6 页图 1、图 2 及第 9 页动画截图（1/5）：火柴人坐在床沿时，由于身前横着一块宽约 $25\text{–}30\text{ cm}$ 的座板和下方的升降柱机构箱，小腿被迫向前斜伸，脚踩在很远的踏板上。
* **为什么是问题**：
  * **确定的事实**：正常从床沿（或抬高床 $0.58\text{ m}$）起身，人直接坐在床沿，脚可以自然收到膝盖正下方甚至微向后收。而用了你们的起身台，老人在步骤 1（坐在床沿）时，膝盖后方（腘窝）与踏板之间隔着整个机构区（第 8 页左图紫色“机构区”），脚根本收不回来；他必须用双手撑床垫、靠核心和上肢力量把臀部往前平移 $25\text{–}30\text{ cm}$ 跨过床沿与座板的交界。
  * **审稿人质疑（代价与收益倒挂）**：为了在坐→站（Sit-to-Stand）阶段省 $13\text{–}20\%$ 的腿力，却在前面强加了一个对上肢、核心稳定性和臀部摩擦极其严苛的“坐姿前移（Seated Scooting）”动作。对于半夜刚醒、腿软且可能有体位性低血压的老人，往前挪动半个臀部深度的距离，跌落或卡在床沿与硬座板缝隙里的风险，可能远大于那 $13\%$ 的省力收益。
* **怎么改**：
  1. **不能只把“挪动是否可行”丢给第 17 页的局限**。既然第 6 页已经画出了几何关系，至少要在讲稿或附录里给出**坐姿前移的力学/几何解释**：比如老人此时双手已经可以扶住台架的侧边扶手（L 形扶手的侧段）往前提拉身体，而不是干撑软床垫往前挪。
  2. 修改第 6 页图 1 和第 9 页图 1/5 的示意图：明确标出座板的前后深度到底是多少（例如只有 $20\text{ cm}$），并让老人在步骤 1 时手就已经搭在侧扶手上借力挪动。

---

### 3. 【中】“脚下空间（Heel Clearance）”的几何定义与机构布置存在冲突，且在汇报中成了黑箱
* **在哪里**：项目 README、第 7 页（方案比较）、第 8 页（机构侧视图）。
* **原文证据**：
  * README：“‘脚下空间’指脚跟至少在髋前多远：`compare_v11` 对起身台用 8 cm、对床用 10 cm（17–20%）；`heel_sensitivity_v12` 把起身台也改成 10 cm（13–16%）。”
  * 第 7 页条形图：“起身台 0.66 m：0.23；起身台，脚下空间按床算：0.24。”
  * 第 8 页左图：座板正下方是紫色的“机构区”（装双升降柱），机构区正前方才是绿色的“脚的空间”。
* **为什么是问题**：
  * **确定的事实**：坐→站生物力学中，脚跟越往后收（越靠近臀部/髋关节投影），重心前移距离越短，膝关节力臂越小，起身越省力。
  * **逻辑矛盾**：在第 8 页左图里，座板正下方被立柱和底座占满了（紫色区域），脚只能放在紫色区域前方的绿色区域里；而普通床（尤其是用床脚垫抬高到 $0.58\text{ m}$ 的床）床沿下方往往是空的，脚跟反而能往床底收。为什么你们的模型里假设起身台的脚跟能比床收得更近（$8\text{ cm}$ vs $10\text{ cm}$）？这与第 8 页的机械布局是反着的。
  * 此外，第 7 页スライド上突然出现一行“起身台，脚下空间按床算 0.24”，但讲稿里**只字未提**，听众看图会一头雾水，不知道什么叫“脚下空间按床算”。
* **怎么改**：
  1. **统一采用保守数字**：既然起身台座板下方有立柱挡着脚跟，脚下空间绝不可能比床更好。建议在主 slides（第 7 页）直接删掉 $8\text{ cm}$ 的乐观假设，**只放同为 $10\text{ cm}$ 的公平对比结果（即 0.24 vs 0.29，省力约 13–16%）**，既消除了机械干涉的质疑，又省去了在主汇报里解释“脚下空间”的时间。
  2. 在第 8 页左图上标出具体尺寸：髋关节中心在哪、立柱前表面在哪、脚跟极限位置在哪，证明 $10\text{ cm}$ 的脚跟位置不会踢到升降柱。

---

### 4. 【中】0.66 m 的身高适应性边界未交代（把 1.60 m 的单点结论当成了普适结论）
* **在哪里**：第 4 页（用户定义）、第 7 页（模型结论）。
* **原文证据**：
  * 第 4 页：“设计工况 $60\text{ kg}$、$1.60\text{ m}$……只在起身时升到约 $0.66\text{ m}$。”
  * 第 7 页：“只升到 $0.60\text{ m}$ 就和抬高床差不多：省力来自固定床达不到的那段高度。”
* **为什么是问题**：
  * **确定的事实**：人体测量学中，$1.60\text{ m}$ 身高的人，小腿加足高（腘窝高）大约在 $0.38\text{–}0.40\text{ m}$，大腿长约 $0.38\text{–}0.40\text{ m}$。当座面升到 $0.66\text{ m}$ 且臀部还在座板上、脚还踩在踏板上时，髋关节高度约 $0.66\text{ m}$，这意味着大小腿几乎已经被拉直了（见第 1 页和第 6 页步骤 4 的火柴人）。
  * **推测与反例**：如果用户身高是 $1.52\text{ m}$（老年女性中非常普遍），在座面升到 $0.66\text{ m}$ 之前，她的双脚就已经被悬空吊起来了（或者大腿被座板前缘死死顶住）；反之，如果用户身高是 $1.72\text{ m}$，对他而言固定床垫高到 $0.60\text{ m}$ 脚也能踩实，那 $0.66\text{ m}$ 带来的额外收益就没有这么大。
* **怎么改**：
  * 不需要重做复杂模型，只需在第 7 页或第 14 页补充一句非常体现工程严谨性的话：**“0.66 m 是针对 1.60 m 身高的上限（约为小腿长的 1.6 倍）；实际使用时，最高抬升高度和速度一样，在安装时按老人的身高（腿长）设定上限。”** 这样既解释了 $0.66\text{ m}$ 的由来，又完美呼应了老师要求的“personalised（个性化）”。

---

### 5. 【低】“自检：各处竖直力之和等于体重”在静坐和起身时会被床垫分流破坏
* **在哪里**：第 12 页（传感与交互）、第 13 页（状态机）。
* **原文证据**：
  * 第 12 页：“自检：各处竖直力之和应约等于体重，对不上就锁住。”
  * 第 13 页状态机图：`sensor sum != BW` 直接从 `any state` 跳进 `LOCKED`。
* **为什么是问题**：
  * **确定的事实**：座板是很短的“短座板”（紧贴床沿）。老人在刚挪上去（步骤 2、3）或者往回坐（步骤 5）时，大腿后侧、臀部后缘甚至后背很可能还挨着软床垫，或者手撑在床垫上。
  * **因果**：只要有一部分重量被床垫分担了，台架上“座板 + 踏板 + 横杆”的竖直力之和就会明显小于体重（比如只有 $70\%\text{ BW}$）。按第 13 页的状态机，机器会误判为传感器故障，直接进入 `LOCKED` 锁死。
* **怎么改**：
  * 把第 12、13 页的判据表述修改得符合力学实际：不要写死“在任何状态下各力之和等于体重”，改为**“离床抬升后（座板高于床面，人与床脱离接触），各传感器竖直力之和应与坐定基线一致（允许动态误差 $\pm 15\%$）；或采用双通道冗余校验传感器失效”**。

---

### 总体判断与最值得先做的一件事

**总体判断**：
这份材料结构非常清晰，工程闭环意识很强（从问题、建模、选型、稳定到状态机和验证表一气呵成），完全达到了课程高分汇报的骨架标准。目前的薄弱点不在于工作量不够，而在于**角色 2（起身模型）与角色 3/5（机构空间、推力上限控制）在接口上存在几处物理假设的错位**。

**最值得先做的一件事**：
立刻让角色 2 和角色 5 对一下账——**把“座板最多出半个体重的推力”代入到 2D 起身模型里，算一下老人在 $0.42\text{ m}$ 刚起步时的关节 effort 是多少**，并在第 7 页把“脚下空间”统一成和床一样的 $10\text{ cm}$。把这几句话补进讲稿或附录，你们的核心立论就无懈可击了。
