xiaweiyi0423/me5412-bedexit-proposal/presentation/audit/gemini_B_safety.md

<!-- model: gemini-4-argon; finishReason: STOP; usage: {"promptTokenCount": 42934, "candidatesTokenCount": 3280, "totalTokenCount": 46214, "cachedContentTokenCount": 40707, "promptTokensDetails": [{"modality": "TEXT", "tokenCount": 12134}, {"modality": "IMAGE", "tokenCount": 30800}], "cacheTokensDetails": [{"modality": "TEXT", "tokenCount": 11506}, {"modality": "IMAGE", "tokenCount": 29201}], "candidatesTokensDetails": [{"modality": "TEXT", "tokenCount": 3280}]} -->

作为医疗设备与个人护理机器人的安全评审员，我重点审查了你们在老师特别强调的“操作安全、力传感、自适应速度、状态机、稳定性”五个维度的逻辑闭环。

你们的汇报框架非常清晰，但从安全工程和故障逻辑来看，有几处**底层物理逻辑矛盾**和**控制死锁漏洞**。如果在答辩时被老师或评委顺着公式和状态图往下深究，很容易当场被问住。

以下按重要性从高到低排列：

---

### 1. 自适应速度公式存在启动死锁：老人坐在上面根本升不起来
- **严重度：高**
- **位置**：第 14 页（速度随人自适应）、第 4 页（设计要求 2）
- **原文证据**：
  - 第 14 页公式：`v = k ×（推力上限 − 座板测到的力）`，“个人设置：推力上限 0.3–0.6 × 体重”，“人往回坐，座板力超过上限，速度自然变成 0”。
  - 第 14 页右图（仿真曲线）：所有场景在初始静坐时，橙线（seat load / BW）都在 0.85 左右。
- **为什么是问题**：
  - **确定的事实**：当老人坐在齐平的座板上（0.42 m）准备起身时，臀部承受约 80%–85% 的体重。此时“座板测到的力”（0.85 BW）远大于你们设定的“推力上限”（0.3–0.6 BW）。代入你们的公式，括号内为负数（速度截断为 0）。这意味着老人握紧“起”开关后，**必须先靠自己的腿和手发力，把臀部抬离座面、卸掉至少 25%–55% 的体重，电机才会开始动**。
  - **因果与推测**：这与第 3、4、7 页的立项前提直接冲突——目标用户正是因为“在 0.42 m 低位发不出这么大的力”才需要起身台。如果他能在 0.42 m 靠自己卸掉近一半体重，他根本不需要这台机器。至于第 14 页的仿真图为什么能升起来，是因为你们在仿真输入里硬编码了一个“假定人自己在第 5 秒顺利把座板力卸到 0.5 BW 以下”的时间函数，掩盖了这个死锁。
- **怎么改**：
  - 把“启动/低位辅助阶段”和“高位跟随阶段”分开，或者修改控制律：例如起步时给一个基础慢速（如 1 cm/s）先帮人突破最吃力的 0.42–0.50 m 区间（推杆实际出力由电机电流限制兜底），随着座面升高、人更容易发力时，再切换到按卸载量加速的跟随模式；或者将公式中的基准力改为“初始静坐座板力（~0.85 BW）”而非“0.5 BW”，只要人开始发力卸载（哪怕只卸掉 10% BW），座板就开始慢速响应。

---

### 2. “竖直力之和 = 体重”的自检规则在真实物理下会频繁误触发 LOCKED（锁死）
- **严重度：高**
- **位置**：第 12 页（传感与交互）、第 13 页（状态机）、第 15 页（风险和对策）
- **原文证据**：
  - 第 12 页：“自检：各处竖直力之和应约等于体重，对不上就锁住”。
  - 第 13 页状态机图：`any state --[sensor sum != BW (only slow DOWN allowed)]--> LOCKED`。
- **为什么是问题**：
  - **确定的事实**：这个等式 $F_{\text{座板}} + F_{\text{踏板}} + F_{\text{横杆}} \approx BW$ 只有在**人100%处于台架上、且处于静态（无加速度）**时才成立。
  - **因果**：在你们定义的正常使用流程（第 6 页）中，有三个必然阶段这个等式不成立：
    1. **坐上/挪动阶段（步骤 1→2）**：老人臀部一半在床垫上、一半在座板上，脚在踏板上。此时床垫分担了重量，传感器总和远小于体重。按第 13 页的 `any state` 规则，老人还没坐好，机器就直接进 `LOCKED`（红灯锁死）了。
    2. **动态起身/往回坐阶段**：人加速向上或頭晕重重坐回时（你们在第 11 页提到坐回冲击是 2–3 倍体重），由于惯性力（$ma$），竖直力之和会瞬间远大于体重，直接触发 `LOCKED`。
    3. **离座走出阶段（步骤 5）**：人站稳迈出第一步，一只脚踩在房间地面上、一只脚在踏板上，总和变成半个体重，机器又会误判为传感器故障而锁死，无法正常进入 `RESET_EMPTY`。
- **怎么改**：
  - 严格限定这条自检的生效状态和容差：不能是 `any state`，**只能在 `SEATED`（确认完全坐稳、准备抬升前）的静态窗口期内做一次总重核对**，或者在 `IDLE` 空载时做零点自检（各传感器应为 0）。在运动和转移过程中，应靠双通道冗余或单传感器超量程/断线检测来防失效，而不是靠总和恒等于体重。

---

### 3. “10 秒无操作自动下降”与“随时可停、想坐多久都行”存在人机安全冲突
- **严重度：高**
- **位置**：第 6 页（方案）、第 13 页（状态机）
- **原文证据**：
  - 第 13 页状态机图：从 `STOPPED` 到 `LOWERING` 的转移条件是 `occupied and (DOWN or 10 s no input)`；从 `SEATED` 到 `LOWERING` 的条件也是 `DOWN (seat raised) or 10 s no input`。
  - 第 6 页文字：“3 握住握把，想坐多久都行”；第 3 页提到 22% 的老人有体位性低血压，需要缓一缓。
- **为什么是问题**：
  - **确定的事实**：如果老人在抬升到一半（例如 0.55 m）时感到头晕，松开开关停下喘口气（进入 `STOPPED`），或者升到顶后坐着缓一缓。按照状态机，只要他 10 秒钟不按开关，座板就会在**没有他主动指令的情况下自动开始往下掉（`LOWERING`）**。
  - **因果**：对于体位性低血压头晕通常需要几十秒恢复的老人，10 秒后脚下或臀下突然自动移动，极易引发恐慌和二次跌倒。这直接违反了医疗设备“非预期运动（Unintended motion）”的安全禁忌，也和你们主打的“按住才动（Hold-to-run）”原则自相矛盾。
- **怎么改**：
  - 删掉有人状态下的 `10 s no input` 自动下降逻辑。只要座板上有人（`occupied`），**必须由人主动按“降”开关（或握把反向操作）才允许下降**。超时自动复位只应该在**空载**（`STANDING_HOLD` 无人保持一段时间后）时触发。

---

### 4. 回床（Bed Return）流程缺失，且高处“空载自动复位”造成夜间返床踏空风险
- **严重度：中**
- **位置**：第 6 页（一次完整的使用）、第 13 页（状态机图）
- **原文证据**：
  - 第 13 页状态机图：`STANDING_HOLD --[seat + footplate empty 5 s]--> RESET_EMPTY --[flush]--> IDLE`。
  - 第 6 页和第 13 页反复强调：“离座后座板停在原高度、保持水平，坐回去也接得住”。
- **为什么是问题**：
  - **确定的事实**：两个问题叠加：
    1. 状态机图里写了人离开踏板 5 秒后（`empty 5 s`），座板就会自动降回 0.42 m（`RESET_EMPTY`）。如果老人站起来后在床边站了 6 秒（或者往前迈了一步离开踏板去拿助行器），突然头晕往后一坐，他以为座板还在 0.66 m 接住他（如你们讲稿所吹嘘的），实际上座板已经在往下走了或者已经降到底了，导致**踏空重摔**。
    2. 老人去完洗手间回来怎么上床？如果座板已经降回 0.42 m，L 形扶手也降到了最低位，而且整个直径 0.66×0.80 m 的台架挡在床长边，老人要怎么越过短座板坐回床上？整份材料只讲了“起床”，完全没提“回床”。
- **怎么改**：
  - 第一，把 5 秒空载复位改长（比如离开 1–2 分钟，或者走远后再降），或者在下降过程中配有明显的蜂鸣/灯光提示。
  - 第二，在第 6 页或预备问答里补一句“回床怎么用”：老人从洗手间回来时，座板已在齐平位（或停在高位先接住老人，老人按“降”坐回 0.42 m），再向后挪回床垫。这恰恰能体现你们“有人坐着才降”的双向价值。

---

### 5. 双升降柱不同步卡死（Racking）与机械防夹的传感器滞后
- **严重度：中**
- **位置**：第 8 页（机构）、第 10 页（推杆选型）、第 11 页（稳定性）、第 15 页（风险）
- **原文证据**：
  - 第 8 页讲稿指南问答：“两根柱怎么同步？答：可以用厂家控制器做同步（升降柱带霍尔信号输出）”。
  - 第 11 页：老人会侧向偏倚、单手拉侧边扶手。
  - 第 15 页：防夹靠“控制缝宽，座板下用伸缩裙板封住；边缘触感开关”。
- **为什么是问题**：
  - **因果**：老人偏瘫或单侧发力时，两根立柱受力极不均匀（一侧受压、一侧甚至受拉或受较大弯矩）。如果其中一根柱的霍尔传感器丢步或单柱卡阻，两根柱出现高度差，座板就会瞬间倾斜，把老人往侧向掀翻。此外，第 12 页的自检（测力单元装在座板下、立柱上方）是**测不到立柱下方的夹手/夹异物力**的（因为夹住异物是立柱外壳和底座之间的力，或者座板下降时被异物顶住——在空载复位时座板上没人，测力单元在座板与立柱之间，只有座板边缘压到异物且顶起座板才会产生负值）。
- **怎么改**：
  - 在第 8/10 页和第 15 页风险表中加半句话：**两柱同步偏差超过阈值（如 > 5 mm）立即停机锁死**；空载下降复位（`RESET_EMPTY`）时，如果座板测力单元测到**负向力（座板被下方异物顶住）**或电机电流异常升高，立即停止并回退。

---

### 6. “床垫下钩板”扛不住你们算出来的极端载荷（前后矛盾）
- **严重度：低**
- **位置**：第 6 页（方案）、第 11 页（稳定性）
- **原文证据**：
  - 第 6 页正文：“用床垫下的钩板或床腿夹和床固定”；第 8、9、12、15 页的所有配图画的都是紫色的“床垫下钩板”。
  - 第 11 页底部小字：“按扶手标准 ADA 609 的 1112 N 设计时，固定件约 2 kN，需要用床腿夹”。
- **为什么是问题**：
  - **确定的事实**：普通单人床垫重约 20–30 kg（200–300 N），插在床垫下的一块钩板，靠床垫自重压住能提供的竖直抗拔力最多也就一两百牛，根本不可能提供 2 kN（约 200 公斤）的抗倾覆力。你们在第 11 页小字里自己推翻了前面所有图里画的“床垫下钩板”。
- **怎么改**：
  - 统一口径：主推**床腿夹（Bed-frame clamp）或绕过床架的绑带（Securing strap）**作为标准固定方式，把图里的图注从“床垫下钩板”改成“床架固定夹/绑带”，避免评委指着图问“床垫怎么压得住 2000 N”。

---

### 总体判断与最值得先做的一件事

**总体判断**：
这份材料的结构、视觉表达和工程工作量在课程项目中属于上乘，紧扣了老师的邮件要求。但在控制与安全部分，存在**“为了把故事讲圆而简化物理规律，导致控制公式和状态机经不起极端工况推敲”**的问题。好在这些都是逻辑和规则层面的问题，不需要重做 CAD，只需要在 10/27 找老师 consultation 前把公式和状态切换条件改严谨即可。

**最值得先做的一件事**：
**立刻修改第 13 页的状态机转换条件和第 14 页的速度公式解释**——把 `any state` 下的体重总和自检改为“仅在静坐准备阶段自检”，删掉有人时的 `10 s no input` 自动下降，并修正速度公式在初始静坐（座板力 > 0.5 BW）时的启动死锁问题。把这三处逻辑漏洞堵上，你们的“控制与安全”章节就真正站得住脚了。
