xiaweiyi0423/me5412-bedexit-proposal/presentation/audit/gemini_C_real_use.md

<!-- model: gemini-4-argon; finishReason: STOP; usage: {"promptTokenCount": 42935, "candidatesTokenCount": 2991, "totalTokenCount": 45926, "cachedContentTokenCount": 40708, "promptTokensDetails": [{"modality": "TEXT", "tokenCount": 12135}, {"modality": "IMAGE", "tokenCount": 30800}], "cacheTokensDetails": [{"modality": "TEXT", "tokenCount": 11507}, {"modality": "IMAGE", "tokenCount": 29201}], "candidatesTokensDetails": [{"modality": "TEXT", "tokenCount": 2991}]} -->

作为一名经常去老人家里做夜间防跌和床边转移评估的作业治疗师（OT），我非常认可你们抓住了“床高两难（坐着要低、起身要高）”和“体位性低血压需要停留支撑”这两个非常真实的痛点。

但如果把这个设备放到真实的老人卧室里，顺着“夜里醒来→起床→站稳→迈步去厕所→回来上床”的完整动线走一遍，有几个致命的环节被机械和控制的逻辑掩盖了。以下是按重要性排序的问题审计：

---

### 1. 站起来之后怎么走出去？“身前横杆”和“助行器”把人困在了台架里
* **严重度：高**（会在答辩时被直接问住，动摇方案的机械布局）
* **位置与证据：**
  * 第 4 页（目标用户）：“能独立行走，或借助助行器行走”。
  * 第 6 页（方案）：“L 形扶手（侧边一段 + 身前横杆）跟着座板一起升”；配图 5 显示老人站立时，身前有一根竖直立柱和水平横杆挡在正前方。
  * 第 11 页（稳定性）左图（俯视图）：清晰画出底座长 0.80 m、宽 0.66 m，黑色粗线表示的 L 形扶手包围了底座的**前侧和右侧**，后侧是床和座板。
* **为什么是问题：**
  * **确定的事实：** 根据第 11 页的俯视图和第 6 页的侧视图，老人站在踏板上时，身后是 0.66 m 高的座板，身前是横杆，右侧是侧边扶手。他唯一的出口是**向左侧横着挪步（侧移）**走出底座。
  * **临床与场景推演：** 
    1. 腿力弱、刚睡醒且可能头晕的老人，侧向跨步是最容易绊倒的动作（还要跨下具有一定厚度的测力踏板边缘）。
    2. 你们明确把“用助行器（walker）的人”列为目标用户。如果出口在侧面，助行器只能停在台架左侧；但老人站在台架里时，必须先松开面前的横杆、侧身跨出踏板，才能去够助行器——这中间会出现极其危险的“无支撑空白期”。更糟的是，床边放了一个 $0.66 \times 0.80\text{ m}$ 的大台子后，普通的卧室通道根本塞不下展开的助行器。
* **怎么改：**
  * **改设计（推荐）：** 在 CAD 阶段把身前的横杆改成**可向外旋开（swing-away）并带锁扣的门式结构**，或者改为**双侧平行扶手（中间留出往前走和放助行器的通道）**。
  * **改表述（若来不及大改 CAD）：** 在第 6 页明确画出“第 6 步：侧步走出 / 衔接助行器”的俯视动线，并在第 4 页把目标用户收窄为“室内能扶墙/手杖行走，或助行器停在敞开侧的老人”，千万不要让听众觉得老人站在一个三面封闭的笼子里结束动作。

---

### 2. 上完厕所回来怎么躺回床上？状态机把“回床”做成了高危动作
* **严重度：高**（暴露设计只考虑了“出床”单向流程，忽略了完整的夜间闭环）
* **位置与证据：**
  * 第 6 页标题写着“一次完整的使用”，但 5 步到“站稳”就结束了，完全没提怎么回床。
  * 第 13 页（状态机）图中：`STANDING_HOLD` 之后，只要 `seat + footplate empty 5 s`（离座且离开踏板 5 秒），就会进入 `RESET_EMPTY`，然后回到 `flush`（降回与床齐平的 0.42 m）。
* **为什么是问题：**
  * **确定的事实：** 老人去趟洗手间回来（肯定超过 5 秒），此时座板已经自动降回了 0.42 m 的低位，挡在床沿正前方（深 25–30 cm）。
  * **临床与场景推演：** 老人回来要上床，面临两个选择：
    1. **绕过台架从床尾/另一侧上床：** 但床边只有 1.9–2.0 m 长，台架占了 0.80 m，剩下的位置要么靠近枕头要么靠近床尾，且没有扶手，老人坐下去时因为床低（0.42 m）极易发生“失控跌坐（plopping）”。
    2. **直接往台架上坐，再退回床上：** 因为座板已经降回 0.42 m，老人必须直接往一个**只有 0.42 m 低、且只有 44 cm 宽（半宽 0.22 m）的窄硬板**上坐！你们在第 3 页刚证明了老人无法控制自己在低位起坐，在黑暗中对准一个窄板往下坐，坐偏滑落的风险极高（你们在第 11 页讲稿也承认“更现实的风险是人从窄座板上滑下来”）。
* **怎么改：**
  * **改控制逻辑（零成本，最有效）：** 修改第 13 页状态机的 `RESET_EMPTY` 逻辑！不要在人走开 5 秒后就降回 0.42 m。**人离开去厕所期间，让座板一直停在 0.66 m（或微降到 0.58 m）的高位等待！** 等老人从厕所回来，直接扶着高扶手、坐在高座板上（省力、安全、不用深蹲），然后按“降”键，由机器慢速把他降回 0.42 m，最后他再往后退回柔软的床上躺下。
  * 在第 6 页加上一句：“去洗手间期间座板保持高位；回来坐稳后，按键慢速降回床高再躺下”，这会让你的设计瞬间从“半截子工程”变成“真正懂老人的闭环设计”。

---

### 3. 从软床垫往前“挪 25–30 cm”到硬座板上，在生物力学上是个悖论
* **严重度：中**（你们自己意识到了，但准备的 Q&A 回答太单薄，容易被追问）
* **位置与证据：**
  * 第 6 页步骤 2：“往前挪上和床齐平的短座板”；预备问答：“问：往前挪 25–30 cm，老人做得到吗？答：这是目前最大的不确定……列入局限”。
  * 第 15 页（安全对策）：“从窄座板滑落 → 防滑座面；开口一侧低挡边”。
* **为什么是问题：**
  * **确定的事实：** 你们给座面加了“防滑座面”和“低挡边”（第 15 页），却要求老人坐在上面完成 25–30 cm 的向前平移（第 6 页）。
  * **临床与场景推演：** 老人怎么在坐姿下往前挪 30 cm？只有两种办法：一是**用双手撑起屁股往前跳（scooting）**，但这需要极强的上肢三头肌和核心力量，且他身后是下陷的软床垫，根本撑不起来；二是**左右扭动骨盆往前蹭（weight-shifting）**，但此时老人的大腿被你们第 15 页设计的“防滑座面”和“低挡边”卡住，且夜间老人多穿宽松睡裤或纸尿裤，高摩擦力的防滑面会把裤子扯住，导致根本挪不动，或者皮肤受剪切力擦伤。
* **怎么改：**
  * **解决自相矛盾：** 第 15 页的座面材质不能简单写“防滑座面”。要改成“**单向纹理或低摩擦过渡边缘 + 坐定后靠骨骼贴合（微凹座面）防滑**”，并说明老人挪动时可以**抓握前方的横杆借力往前拉（pulling to scoot）**——但注意，这要求横杆在低位时距离床沿不能太远（身高 1.60 m 的老人坐床沿时手臂前伸极限约 50–55 cm，请在 CAD 里核对这个尺寸！）。

---

### 4. “各传感器竖直力之和 = 体重”的自检规则，在实际使用中会频繁误锁死
* **严重度：中**（控制逻辑过度理想化，工程与临床常识冲突）
* **位置与证据：**
  * README 及第 12 页（传感与交互）：“自检：各处竖直力之和应约等于体重，对不上就锁住”。
  * 第 13 页（状态机）：`sensor sum != BW -> LOCKED`。
* **为什么是问题：**
  * **确定的事实：** 测力单元只装在座板、踏板和横杆上，**床垫上没有传感器**。
  * **临床与场景推演：** 
    1. 老人刚从床沿往前挪到短座板上时（状态从 `IDLE` 切到 `SEATED`），他的**屁股后半部分、或者大腿后侧很可能还搭在床垫边缘上**，甚至一只手还撑在床垫上保持平衡。此时床垫分担了 10%–30% 的体重，台架上的传感器总和绝对小于体重（BW）。如果这时候系统判定 `sensor sum != BW` 直接进 `LOCKED`（锁死），老人就再也用不了了。
    2. 老人夜里起床前后的体重本身就会变（比如刚排空膀胱、冬天披了一件厚睡袍、或者手里拿着尿壶/拐杖）。
* **怎么改：**
  * 在第 12 页和第 13 页中，把“各处竖直力之和约等于体重”修正为：**“在抬升离座阶段（大腿已离开床垫），总力应在预设体重的合理宽容度内（如 80%–115%），用于检测传感器卡死或断线故障”**，不要在静坐准备阶段（`SEATED`）用总体重去锁死机器。

---

### 5. “松手即停 + 握紧才升”对虚弱老人的手部负担与视觉反馈盲区
* **严重度：低**（细节瑕疵，改掉能加分）
* **位置与证据：**
  * 第 12 页：“握把式‘起’开关：握紧才升、松手就停……反馈：握把上的状态灯”。
  * 第 14 页：慢速用户抬升过程需要约 15–20 秒（看仿真图横轴，从 5 秒升到 22 秒）。
* **为什么是问题：**
  * **确定的事实：** 老人需要持续握紧开关长达 15 秒以上，同时手还要用力拉扶手支撑身体；状态灯装在握把上。
  * **临床与场景推演：** 很多高龄老人伴随手部骨关节炎或握力减退，一边发力拉扶手、一边保持手指按压微动开关 15 秒，很容易中途手指发抖松开，导致机器突然急停（产生顿挫感，破坏起身节奏）。另外，既然手握住了握把，**手掌就把握把上的状态灯挡住了**，而且老人起身时眼睛是看着前方或脚下的，不会低头看手里的灯。
* **怎么改：**
  * 第 12 页补充一句：“开关采用**大面积轻触式握把传感（只要手握住横杆发力即导通，无需手指额外抠按）**，并加入 0.2 秒防抖滤波避免手抖急停；状态灯移至横杆正前方视野内，并配轻柔提示音”。

---

### 总体判断与最值得先做的一件事

* **总体判断：** 这是一份工程逻辑非常严密、切入点也很聪明的课程设计汇报，完美回应了老师邮件里的所有技术要求。但在“真实使用动线”上，你们目前只把老人当成了一个“在二维平面里从坐到站的火柴人”，忽略了他**站起来怎么走出去、上完厕所怎么坐回来**的三维空间与操作闭环。
* **最值得先做的一件事：** **立刻修改第 13 页状态机的自动复位逻辑和第 6 页的使用流程**——改为“人离座去洗手间时，座板保持在 0.66 m 高位等待；人回来坐上高座板后，再按键带人慢速降回床面高度”。这不需要重做任何力学计算，只需改几行仿真代码和两页 PPT 文字，却能一举解决“回床难、窄板低位坐下危险”的最大临床漏洞！
