xiaweiyi0423/me5412-bedexit-proposal/presentation/audit/gemini_E_delivery.md

<!-- model: gemini-4-argon; finishReason: STOP; usage: {"promptTokenCount": 42935, "candidatesTokenCount": 4204, "totalTokenCount": 47139, "cachedContentTokenCount": 40708, "promptTokensDetails": [{"modality": "TEXT", "tokenCount": 12135}, {"modality": "IMAGE", "tokenCount": 30800}], "cacheTokensDetails": [{"modality": "TEXT", "tokenCount": 11507}, {"modality": "IMAGE", "tokenCount": 29201}], "candidatesTokensDetails": [{"modality": "TEXT", "tokenCount": 4204}]} -->

我是第一次听你们汇报的工科研究生同学。从现场听众的接收效率和投影版面的角度来看，你们的逻辑骨架非常清晰（结论先行、前后呼应），但目前有几个硬伤会让听众在现场“看不清、想不通、对不上”。我按重要性从高到低梳理了以下 7 个问题：

---

### 1. 【高】核心数据图表和流程图的字号极小，教室后排在投影上完全不可读
- **位置**：第 10 页（推杆选型）、第 11 页（稳定性）、第 13 页（状态机）、第 14 页（速度自适应）。（注：讲稿指南里你们已经意识到了第 10、14 页，但漏掉了同样严重的第 11、13 页，以及第 8 页左图、第 12 页左图和第 19 页左图的微小标注）。
- **原文证据**：
  - 第 13 页的状态机图由 Graphviz 直接生成，横向极宽，节点内的文字（如 `STANDING_HOLD`）和连线上的条件（如 `grip switch + hand on bar + feet on plate + COP ok`）在全屏截图里只有几个像素高。
  - 第 14 页右侧塞了 $4\times2$ 共 8 张子图，双纵轴标签（`height (m)`, `seat load / BW`）和底部图例极小。
  - 第 11 页左图的 6 行图例和右图的 5 行纵轴英文标签（如 `Grab-bar level load, sideways high (0.88 m)`）密密麻麻。
- **为什么是问题**：
  - **确定事实**：这些图表里的文字字号远小于幻灯片正文字号的三分之一。在教室投影仪上，除了第一排，没人能看清字。
  - **因果推测**：当你们在讲第 13 页“状态机”或第 14 页“黑线是高度、橙线是受力”时，听众会本能地去眯眼辨认图上的小字，导致长达一两分钟不听你们说话；看不清又会带来挫败感，直接拉低对你们工程展示能力的评价。
- **怎么改**：
  - **第 13 页（状态机）**：不要直接贴代码生成的原始图。用 PPT 形状或绘图工具重画，把布局从“扁长条”改为紧凑的“两行网格”，只保留 6-7 个核心状态，连线上的条件提炼成 2-4 个大字（详细转移条件表放附录）。
  - **第 14 页（8 场景仿真）**：主 slide 上只放 **2 到 3 个最典型的场景**（例如：1. 正常起身、2. 抬升中往回坐、3. 断电/故障），把图放大三倍，直接在曲线上用大号箭头标出“座板高度”“座板受力”。全部 8 个场景的完整大图放进附录。
  - **第 10、11 页**：重出 matplotlib 图，把 `fontsize` 调大到至少 16–18 pt，把长图例移到图外或直接标在柱子/曲线旁。

---

### 2. 【高】全程只有 2D 侧视火柴人，听众对设备的三维形态（如“L 形扶手”“短座板”）建立不起空间概念
- **位置**：第 1 页、第 6 页、第 8 页、第 9 页、第 12 页、第 15 页。
- **原文证据**：
  - 第 6 页文字写着：“台架靠在床的长边，用床垫下的钩板或床腿夹和床固定；L 形扶手（侧边一段 + 身前横杆）跟着座板一起升。”
  - 但从第 1 页到第 19 页的所有配图，全部是纯 2D 侧视截面图（火柴人 + 一根竖线 + 一根横线）。直到第 11 页左图才突然出现一个极小的俯视框（写着 `Bed`、橙色 `Seat plate` 和黑色折线 `L-shaped rail`）。
- **为什么是问题**：
  - **确定事实**：在 2D 侧视图里，“身前横杆”和“侧边扶手”是重合或无法区分的；“短座板有多短、人怎么从床沿挪上去、脚踏板在哪里、台架怎么避开床腿”在侧视图里也缺乏空间感。
  - **因果推测**：第一次听的同学在前 10 分钟里脑子里会一直转一个问题：“这东西到底长什么样？人下床的时候不会被身前的横杆挡住吗？”（因为在 2D 图里人看起来像是被关在栏杆里面）。这个问题不解决，后面讲力学和传感器时听众都在凭空想象。同时，老师在邮件中也明确要求“展示 CAD 模型”。
- **怎么改**：
  - 在 **第 1 页（封面）** 和 **第 6 页（一次完整的使用）**，必须放一张 **3D 轴测图（CAD 渲染图或带床的 3D 简图）**。
  - 让听众在第 1 分钟就看清三件事：① 它怎么贴在床边；② 为什么座板是“短”的；③ L 形扶手哪边开口、人站起来后从哪边走出去。

---

### 3. 【中】“起身后再怎么回床上睡觉？”——使用闭环缺失，且与状态机描述互相打架
- **位置**：第 6 页（一次完整的使用） vs 第 13 页（状态机）。
- **原文证据**：
  - 第 6 页展示了 1 到 5 步，第 5 步停在：“站稳；座板停在原高度，坐回去也接得住”。
  - 第 13 页状态机图里有一条分支：`STANDING_HOLD` $\xrightarrow{\text{seat + footplate empty 5 s}}$ `RESET_EMPTY` $\xrightarrow{\text{flush}}$ `IDLE`。
  - 但第 13 页下方的文字卡片和讲稿都在强调：“只有确认有人坐着才下降，座板上没人时不动”。
- **为什么是问题**：
  - **确定事实**：slides 里存在两处矛盾/空白。第一，文字说“座板上没人时不动（不降）”，但状态机图里明明画了“离开 5 秒后空载复位（下降到齐平）”。第二，没有任何一页讲老人去完洗手间回来怎么上床。
  - **因果推测**：作为听众，我看到第 6 页停在 0.66 m，马上会想：“那老人上完厕所回来，面对一个 0.66 m 高的台子，怎么坐回 0.42 m 的床上？”如果按状态机图说的“离开 5 秒自动降回 0.42 m”，那老人万一在踏板外站了 6 秒头晕往回坐，岂不是一屁股坐空摔倒（违背了你们“停在原高度接住人”的卖点）？这在答辩时极易被老师或同学一针见血地问住。
- **怎么改**：
  - 统一逻辑并在第 6 页或第 13 页用一句话讲清楚闭环：例如，人离开后座板到底降不降？如果为了接住人一直停在 0.66 m，那老人回来时是先高坐上去、再按“降”回到床面吗？如果 5 秒自动降，怎么防止第 6 秒坐空？把第 13 页的文字和状态机图改一致。

---

### 4. 【中】第 7 页“方案比较”存在概念跳步，且条形图里突然冒出讲稿没解释的条目
- **位置**：第 7 页（四种起身方式比较）。
- **原文证据**：
  - 页面标题写“四种起身方式比较”，但左侧条形图画了 **5 根柱子**，第 4 根是“起身台 0.66 m（0.23）”，第 5 根是“起身台，脚下空间按床算（0.24）”。
  - 讲稿全文没有提第 5 根柱子，也没有解释什么叫“脚下空间按床算”。
  - 讲稿突然冒出一句：“组里最初想的动态扶手也差不多（0.39）”，而在前面的第 1–6 页里，从来没有介绍过什么是“动态扶手”。
- **为什么是问题**：
  - **确定事实**：只有看了你们内部 README 的人才知道“动态扶手是方案甲”以及“脚下空间指脚跟在髋前 8 cm 还是 10 cm”。现场听众没有看 README。
  - **因果推测**：听众看到图表上有 5 根柱子而标题写“四种”，且冒出“动态扶手”和“脚下空间按床算”两个陌生词，讲稿又不解释，会在现场产生疑惑，分散对核心结论（0.66 m 比 0.58 m 省力 13–20%）的注意力。
- **怎么改**：
  - **做减法**：主 slide 的条形图只保留最核心的 **3 根或 4 根柱子**（低床 0.42 m、动态扶手［注明：仅加床边扶手不升高］、抬高床 0.58 m + 扶手、起身台 0.66 m）。
  - 把第 5 根柱子（脚下空间敏感性分析 0.23 vs 0.24）移到附录，主页面上少掉一个费解的概念，视觉和听觉都会清爽很多。

---

### 5. 【中】多处“口头/文字说有，图上却画反了或找不到”，图文打架
- **位置**：第 8 页（机构）、第 10 页（推杆选型）、第 11 页（稳定性）、第 19 页（分工）。
- **原文证据**：
  - **第 8 页**：真实缩略图里，“两根同步立柱”的示意图中，两根灰色立柱中间画了一根**紫色的T形中间推杆**；而第 10 页和第 19 页的图里，紫色推杆是画在立柱里面的。听众看第 8 页会误以为双立柱方案需要在正中间外挂一根推杆。
  - **第 10 页**：文字和讲稿说“双升降柱：60 kg 时**每根**推约 0.23 kN、保持约 0.49 kN”，但左图绿线画在 **0.46 kN 和 0.98 kN** 的位置（图例小字写着 `total of both`）。听众听着“0.23”，眼睛看着图上的“0.5”，第一反应是你们算错了。
  - **第 11 页**：文字说“人完全在台架上……**6 个姿态**的合重心离后边缘 0.13–0.28 m”，但左图俯视图里，算上橙色座板上的点和外面的点，颜色相近且重叠，一眼数过去只有 4–5 个圆点加 2 个方块，而且讲稿没解释圆点和方块分别代表什么。
  - **第 19 页**：讲稿说“按装置的部分来分……左图上的数字就是每个人负责的位置”，但左图里标签 **1** 和 **2** 分别指着火柴人的**臀部**和**膝盖**（人体关节），并不是装置的一部分，看着有点滑稽。
- **为什么是问题**：
  - **确定事实**：图文之间的数值口径（单根 vs 两根总和）和视觉表意不一致。
  - **因果推测**：工科听众和老师对数字和机械结构图非常敏感，图文对不上会让人怀疑部分组员之间没有对齐数据。
- **怎么改**：
  - 第 8 页：把“两根同步立柱”示意图中间那根紫色竖杆去掉，改成两根立柱各自内置驱动的样式。
  - 第 10 页：把左图纵轴统一成“单根推杆力”或者在讲稿里明确说“图上绿线是两根柱加起来的总力，约 0.5 和 1.0 kN，分到每根柱只有一半”。
  - 第 19 页：给 1 和 2 换个不指在火柴人屁股和膝盖上的表达方式（或者框出整个人体-台架交互区）。

---

### 6. 【中】时长预算和英文转换风险：19 页算上 5 人交接和动画播放，11/3 极易超时或讲得太赶
- **位置**：全局 & 第 2 页（汇报结构）。
- **原文证据**：
  - 第 2 页写：“主 slides 19 页，约 16 分钟”。各页计划时长加总为 15.9 分钟。
  - 背景说明：11/3 最终交付的是**英文** slides 并现场展示，目前中文讲稿按 230 字/分钟写；且有 5 名组员分角色。
- **为什么是问题**：
  - **确定事实**：15.9 分钟是纯念稿的理想时间，没有计入：① 5 个人上台切换麦克风/翻页器的时间（至少损耗 1–1.5 分钟）；② 第 9 页和第 15 页等待动画播放完毕的时间；③ 翻页停顿。
  - **因果推测**：把 230 字/分钟的高密度中文直接翻译成英文后，词数通常会膨胀，且非母语者的英文汇报语速如果保持同样信息量，听众很难跟上（尤其是 0.3 分钟一页的封面/目录/分工，平均 18 秒翻一页）。此外，你们在第 21 页才问老师“展示时间多长合适”，万一老师说正式汇报只有 10 或 12 分钟，19 页根本讲不完。
- **怎么改**：
  - 你们在每页标题旁已经很聪明地标了“时间紧版本保留/删去”（保留版共 10 页，约 10.1 分钟）。建议在 10/27 问清老师正式时长后，如果只有 12–15 分钟，主动将主 slides 压缩到 **13–15 页**（例如把第 2 页目录删掉或口头带过；把第 8、9、10 页的三页机构合并为两页；把第 17 页局限和第 18 页结论合并）。
  - 写英文讲稿时，字数要比现在的中文直译砍掉 20%–30%，用短句。

---

### 7. 【低】向老师提问的第 21 页，漏掉了对“已完成改动”的展示策略，且问题略显被动
- **位置**：第 21 页（想请老师确认的问题）及多页上的 `[待补]` 框。
- **原文证据**：
  - 第 21 页问老师：“1. ‘人卸掉多少体重，座板就升多快’……是您说的 personalised and adaptive 吗？ 2. 机构做到……够不够？ 3. 稳定性……够不够？”
  - 第 9、10、11、15、16 页上都有显眼的虚线框或文字写着 `待补`。
- **为什么是问题**：
  - **确定事实**：10/27 是 consultation（咨询答疑），不是正式评分，所以放 `待补` 和第 21 页是完全合理的。但是，11/3 交的英文 slides 是**同时当最终报告用**的。
  - **因果推测**：在 10/27 沟通时，如果每翻一页都看到一个大大的 `待补` 框（尤其是第 9 页几乎半页都是待补框），会让老师觉得完成度偏低。另外，第 21 页连问三个“够不够”，容易引导老师顺口加活（比如“那你们再加个动态倾翻仿真吧”），而在 10/27 到 11/3 只有一周时间的情况下，加活是非常危险的。
- **怎么改**：
  - 10/27 沟通时，把第 21 页的提问方式从开放式的“够不够？”改为**确认边界式**：“基于您在邮件里的建议，我们已经完成了状态机和 8 场景仿真（第 13-14 页），接下来一周我们将集中精力补齐 **SolidWorks 运动动画** 和 **1.5 倍体重的静力 FEA**。在 11/3 截止前，这两项作为最终交付物是否符合您的预期？”——这样既展示了你们听取了邮件意见，又锁死了最后一周的工作量。
  - 11/3 正式版务必删掉所有 `待补` 字样、第 20 页的“有材料/待补”状态列，以及第 21 页。

---

### 总体判断与最值得先做的一件事

**总体判断**：
这份汇报材料的**故事线和工程逻辑非常扎实**——从“床高两难”切入，用定量模型证明“0.66 m 起身台”存在的必要性，再到双立柱选型、固定防倾翻、自适应速度控制，最后用需求验证表收尾，环环相扣，远超普通课程作业的平均水平。目前的短板主要在**视觉传达的最后一公里**：缺 3D 具象图、核心图表字太小、局部图文数据口径没对齐。

**最值得先做的一件事**：
**在转成英文版之前，先画出一张清晰的 3D CAD 轴测图放到第 1 页和第 6 页，并把第 10、11、13、14 页的四张核心大图（选型、稳定性、状态机、仿真曲线）按投影大字号标准重新绘制/裁剪。** 这两件事做完，整份 slides 的专业度和现场可读性会立刻提升一个档次。
