xiaweiyi0423/me5412-bedexit-proposal/presentation/video/pulse/review_gemini.md

# Gemini 对脉动版剧本的意见（gemini-3.1-pro-preview，一次调用，约 3k token）

提问原文见 review_gemini_script.txt。

1. **“选机构”替换方案**：
**方案A（轨迹重合度）**：用“线”对比。画面中保留理想的白色设计曲线。五个机构同时运动，前四个画出的实际轨迹线（灰线）与白线明显偏离或相交（代表碰腿），第五个的青色轨迹线与白线完美重叠并发光。耗时4拍。
**方案B（受力与干涉点）**：用“点”呈现。前四种机构运动到特定位置时，在缺陷处亮起警示性的“红点波纹”——如连杆与人体小腿干涉处、铰点受力过大处。第五种机构全程亮起青色顺滑线，无红点。耗时4拍。

2. **结构/节奏修改建议**：
- **前置片名**：将0:10的片名移到0:04前。痛点之后直接接“找线找点”的硬核设计，避免情绪断档。
- **调整“用法”顺序**：把 0:34“用法”移到 0:22“结构”之前。让观众先看产品整体怎么用，再去剖析内部零件和运动细节。先宏观后微观，认知更流畅。
- **压缩零件拼装**：0:22的CAD拼装长达6秒（12拍）容易拖沓，建议压缩至6-8拍，重点突出核心的导轨和连杆即可。

3. **工科视角的严谨性问题**：
- **“81条线合成一条”**：一条固定曲线不可能适配81种不同体型的最优轨迹，直接说“一条设计曲线”有夸大嫌疑。建议加小字注记“加权优化的通用轨迹”或“包络均值”。
- **“松手即停”的物理冲击**：静音1.5秒强调急停，但在载人设备中瞬间急停会带来巨大的惯性冲击，极易导致老人前倾摔倒。建议视觉或文字上补充“阻尼缓冲”或改为“松手平稳制动”。

## 我们的处理
- 选机构不用叉：改成三个条件逐条筛，不满足的退到灰色（采纳，并和它的“轨迹重合度”思路合并）。
- 拼装压缩：6 秒改 4 秒（采纳）。
- “81 条线合成一条”说法：改成“挑一条：每条都拿给 81 个人试，选最吃力的人也够用的那条”，这才是模型实际的做法（采纳并纠正）。
- 片名前移、用法移到结构前：没采纳，先讲问题和设计过程、再看实物，工程叙事更顺。
- 松手急停有惯性冲击：不成立。最快速度只有 1.5–3 cm/s，停下来几乎没有冲击。

---

# 第二次：Gemini 看了第 4 版成片（含音轨，gemini-3.1-pro-preview，一次调用，约 6k token）

提问原文见 review_gemini_v4_prompt.txt。

**1. 观众视角**
能一眼看懂产品是辅助起身台，核心优势（贴合人体轨迹、安全制动）传达清晰。但有两处信息过载：**0:18“比过五种结构”**，5个结构瞬间同框且字太小，根本看不清差异；**0:36“四处测力”**，4个标注同时弹出，眼睛不知道看哪，字幕停留太短。

**2. 配乐与音效**
整体听感很棒！120 BPM 的节奏感极佳，合成音色干净饱满，没有廉价感或刺耳的高频，卡拍精准。
**“松手即停”（0:34）的静音处理极其惊艳！** 音乐戛然而止配合清晰的机械制动音效，不仅打破了听觉惯性，更完美地放大了“绝对安全”这一核心卖点，是全片的神来之笔。

**3. 最值得改的 5 处（按优先级）**

*   **TOP 1 (0:18) 删繁就简，优化结构对比**
    *   **改法**：舍弃展示5种，只对比“垂直升降”与“最终方案（斜导轨+倾角连杆）”。两者并排，画面停留至少 4 拍（2秒），让观众看清最终方案如何“最贴合”。
*   **TOP 2 (0:36) 测力点依次亮起**
    *   **改法**：不要四个标签同时砸脸。配合人体的动作，依次高亮：臀部坐下亮“座下测力” -> 手放上去亮“握把测力” -> 脚踩下亮“踏板测力”，每个标签配合清脆的“滴”声音效，各停留 1 拍。
*   **TOP 3 (0:14) 具象化“81种身体”的计算过程**
    *   **改法**：曲线不要一秒全出。让这 81 条半透明轨迹以扫尾特效快速、分批地“画”出来（耗时约 2 拍），最后加粗高亮那条平均基准线，体现“算出来”的科技感。
*   **TOP 4 (0:20) CAD 爆炸图分层标注**
    *   **改法**：引线和文字避免一瞬间全出，显得杂乱。建议按机械组装逻辑（底座 -> 导轨 -> 连杆/滑块），分 3 次“啪-啪-啪”卡点弹出文字标签，增强机械节奏感。
*   **TOP 5 (0:04-0:06) 增加火柴人微表情动作**
    *   **改法**：“床低”站不起来时，让火柴人身体前倾并伴随 2 次轻微的上下颤动（挣扎感）；“床高”时，悬空的双脚前后晃动 1 拍。用视觉直观表现痛点。

## 我们的处理
- 0:17.5 五种结构太密：改成“直上直下”和我们的方案两张大图并排循环，另起一行小字带过三种四连杆。
- 0:20 拼装标签太快：拼装时不出标签；拼完后按拍出三条关键标签（导轨+丝杠、电机·失电制动、握把开关）。
- 0:14 81 条线一下子全出：改成分批画出（约两拍）。
- 0:36 测力点：它说“同时弹出”不准确（原本就是每拍一个，它大概是按每秒一帧抽样看的），但“不知道看哪”成立：改成当前这个亮、之前的变暗。
- 0:04 火柴人挣扎：已经有两次前倾尝试，没改。
- 它把设计曲线叫“平均基准线”不对，设计曲线是挑出来的，不是平均。
- 配乐评价（节奏干净、不刺耳、静音处理有效）：保留，没改。
