xiaweiyi0423/me5412-bedexit-proposal/presentation/audit/v4/gemini_open_2.md

<!-- model: gemini-4-argon; finishReason: STOP; usage: {"promptTokenCount": 148738, "candidatesTokenCount": 5293, "totalTokenCount": 154031, "promptTokensDetails": [{"modality": "TEXT", "tokenCount": 125638}, {"modality": "IMAGE", "tokenCount": 23100}], "candidatesTokensDetails": [{"modality": "TEXT", "tokenCount": 5293}]} -->

作为第一次看到你们全部材料的外部审阅者，我先说第一印象：你们的工作量和闭环程度远超一般的研究生课程项目，尤其是主动修正路径截断 bug 并重算全部结论的诚实度，非常加分。

正因为前几轮已经把表面问题改得很干净，现在剩下的问题大多藏在**代码的力学公式里、控制逻辑的边界上、以及新旧文档未对齐的缝隙里**。以下是我认为最重要的 6 个问题，按严重度排序。

---

### 1. 【严重度：高】单侧悬臂的导轨/滑块受力计算，把法向力（倾覆力矩）当成了侧向力，且方向分解写反了

*   **在哪里**：`model/calc_v13/seat_1dof_v5_checks.py` 的 `forces()` 函数；Slide 8、Slide 10；设计网页步骤 5、步骤 6；设计总结文档 5.2 节。
*   **代码与原文证据**：
    ```python
    # seat_1dof_v5_checks.py -> forces()
    Mx = F * (Y["rail"] - yl); Me = Mx * abs(e[0]); Mn = Mx * abs(nf[0])
    Fr = Me / RAIL_GAP; Fc = Mn / CARR_SPAN
    out[name] = dict(..., per_carriage_lateral_N=round(Fr / 2 + Fc / 2))
    ```
    网页与 Slide 10 原文：“偏载悬臂 659 N·m，每个滑块侧向力约 3.1 kN”。
*   **为什么是问题**：
    1.  **已确认的几何与静力学事实**：座板载荷是竖直向下的（沿 $z$ 轴），横向偏心距是沿 $y$ 轴的（$\Delta y = Y_{\text{rail}} - y_l$）。因此悬臂力矩 $\mathbf{M} = \mathbf{r} \times \mathbf{F}$ 是一个**纯绕 $x$ 轴（前后方向）的力矩** $M_x$。
    2.  **方向分解写反了**：导轨在矢状面（$x$-$z$ 平面）内倾斜，与竖直方向夹角 $\alpha = 34.1^\circ$。导轨方向单位向量为 $e = (\sin\alpha, \cos\alpha)$，矢状面内垂直导轨的方向为 $n_f = (\cos\alpha, -\sin\alpha)$。但你们的力偶臂是在“导轨安装板平面”（即包含导轨轴线 $e$ 和横向 $y$ 轴的平面）内展开的！垂直于这个安装板平面的法向是 $n_f$。
        *   两根平行导轨在 $n_f$ 方向相距 150 mm（`RAIL_GAP`）。要让两根导轨产生绕导轨轴线 $e$ 的抵抗力矩 $M_e$，导轨承受的必须是**垂直于安装板的法向拉压力（即 $n_f$ 方向）**，而不是平面内的侧向力！
        *   同一导轨上的两个滑块沿 $e$ 方向相距 150 mm（`CARR_SPAN`）。当它们承受垂直于安装板（$n_f$ 方向）的相反法向力时，产生的力矩方向是 $\mathbf{e} \times \mathbf{n}_f$（平行于 $y$ 轴），根本无法平衡绕 $x$ 轴的力矩！要平衡 $M_x$ 在 $n_f$ 方向的分量 $M_n$，两个滑块承受的必须是沿 $y$ 轴的侧向力。
        *   此外，你们在代码里直接把两个正交方向的力相加：`Fr / 2 + Fc / 2 = 3052 N`，并统称为“侧向力（lateral force）”，这在矢量力学上是错误的（一部分是法向拔出力/压入力，一部分是侧向力，而且四个滑块同时分担，每个滑块的分力应当除以 2 还是 4 需要画自由体图严格联立）。
*   **怎么改 / 怎么确认**：
    *   花 15 分钟画一个滑块板的三维自由体图（坐标轴取：导轨方向 $e$、矢状面法向 $n_f$、横向 $y$）。外力是竖直力 $F_z$ 和绕 $x$ 轴的力矩 $M_x$，先投影到 $(e, n_f, y)$ 坐标系：
        $$M_e = M_x \sin\alpha, \quad M_{nf} = M_x \cos\alpha$$
    *   分别写出 4 个滑块在 $n_f$ 方向（法向拉压）和 $y$ 方向（侧向）的反力平衡方程。算清每个滑块的法向力 $F_{nf}$ 和侧向力 $F_y$（大约在 1.2–1.8 kN 量级，15/20 号导轨依然完全扛得住，结论不会垮，但数字和概念必须改对，否则机械背景的老师一眼就会看穿）。

---

### 2. 【严重度：高】控制器“速度随人自适应 + 横杆防挂人”逻辑与生物力学优化模型互相打架

*   **在哪里**：`model/calc_v13/seat_trajectory.py` 的 `effort()`；`model/calc_v13/controller_seat.py` 的 `Controller.step()` 与 `run()`；Slide 12、Slide 14。
*   **代码与原文证据**：
    *   在生物力学模型 `seat_trajectory.py` 中，手臂力上限为 `HAND_CAP = 0.25`（0.25 BW），脚底最小受力 `MIN_FEET = 0.30`（0.30 BW），座板推力上限 `CAP = 0.50`（0.50 BW）。LP 优化器为了最省力，会让手向下压横杆或向上拉横杆。
    *   但在控制仿真 `controller_seat.py` 的 `run()` 中，正常起身的场景硬编码了手只出极小的力：
        ```python
        if hands: F_bar = -ev["pull"] * BW if ev.get("pull") else (ev["hang"] * BW * e if ev.get("hang") else 60.0)
        ```
        也就是说，参考用户（60 kg，BW = 588.6 N）在控制器仿真里手只出了 **60 N（约 0.10 BW）**，但在查表函数 `min_seat(h, c)` 背后调用的 `seat_support_slider.py` 却是允许手出到 **0.25 BW（147 N）** 算出来的最小座板力！
    *   更麻烦的是 Slide 13/14 和网页步骤 13 写的规则：
        *   网页步骤 13：“速度规则加互锁……**座板力下降要伴随踏板力上升才提速**，人挂在横杆上时限速。”
        *   但看 `controller_seat.py` 第 68 行：
            ```python
            v_cmd = float(np.clip(P.k * (P.F_cap - self.fs_f), 0, P.vmax))
            if z["F_bar"] > P.hang: v_cmd = min(v_cmd, 0.3 * P.vmax); self.limited = True
            ```
            代码里**根本没有实现“座板力下降伴随踏板力上升才提速”**！只写了 `F_feet > 0.30 BW` 的门槛和 `F_bar > 0.30 BW` 的限速。
*   **为什么是问题**：
    1.  **文不对码（已确认事实）**：网页声称实现了“踏板力上升才提速”的互锁，但代码里没有。如果老师在答辩时问：“你们怎么在公式里体现踏板力上升才提速？”你们指着 $v = k(F_{\text{cap}} - F_{\text{seat}})$ 会答不上来。
    2.  **物理隐患（推论）**：如果一个虚弱的老人双手向上拉横杆（比如 `pullup` 场景，`F_bar = -0.2 BW`），根据竖直力平衡 $F_{\text{seat}}\cos\phi + F_{\text{feet}} + F_{\text{bar}} = \text{BW}$，向上拉横杆会让 $F_{\text{bar}}$ 为负，这意味着在同样的踏板力下，**向上拉横杆反而会让座板力 $F_{\text{seat}}$ 变大**（或者让人把力转移到手拉横杆上而不是脚上）。你们在 `pullup` 场景里硬编码了 `F_seat` 不随拉力变化，直接用 `F_feet = BW - F_seat*cphi - F_bar` 补齐了差额，掩盖了真实的力分配耦合。
*   **怎么改 / 怎么确认**：
    *   **最便宜的改法（改文字）**：把设计网页步骤 13 里的“座板力下降要伴随踏板力上升才提速”改成和代码一致的表述：“踏板受力必须大于 0.3 倍体重才允许抬升，且横杆下压力超过 0.3 倍体重时限速至 30%”。
    *   如果要在控制公式里真正体现老师要求的“力分布传感自适应”，其实把速度公式从 $v = k(F_{\text{cap}} - F_{\text{seat}})$ 改成直接奖励脚部承重（例如基于 $F_{\text{feet}}$ 和 $F_{\text{seat}}$ 的差值）会更物理，但距离 10/27 沟通太近，建议先统一文字口径。

---

### 3. 【严重度：中】人体生物力学模型（81 人）中，所有身高（1.50 m – 1.75 m）和胖瘦的人，体重全部写死为 60 kg，关节肌力也全部写死为同一常数

*   **在哪里**：`model/model.py` 的 `Subject` 类；`model/calc_v13/seat_1dof_design.py` 的 `path_of()` 等所有调用 `Subject(H=H)` 的地方。
*   **代码证据**：
    ```python
    # model.py
    @dataclass
    class Subject:
        M: float = 60.0          # kg
        H: float = 1.60          # m
        knee_ext: float = 75.0   # 固定常数 N m
        ...
    # seat_1dof_design.py 等所有脚本
    sub = Subject(H=H)           # 只传了 H，从未传 M 或缩放肌力！
    ```
*   **为什么是问题**：
    1.  **已确认事实**：你们在网页步骤 10/12 的“未收尾事项”里诚实地写了一句“体重和肌力没有随身高缩放”。但在 Slide 7、Slide 8、Slide 16 和网页验证表（步骤 8）里，观众看到的是：“1.50 m · 偏瘦”的放手费力是 `0.191`，“1.75 m · 偏胖”的放手费力是 `0.345`。
    2.  **误导性因果**：在你们的模型里，1.75 m 的人之所以费力（0.345 vs 0.191），**唯一的原因是他的腿和躯干更长（力臂 $\propto H$），而体重还是 60 kg、关节最大肌力还是 75 N·m**！同样，“偏瘦（臀厚 7 cm）”和“偏胖（臀厚 11 cm）”在模型里体重也完全一样（都是 60 kg），区别仅仅是坐着时髋关节离座面高了 4 cm！
    3.  如果老师或审稿人看到表格里有“身高 × 胖瘦”的组合，自然会以为你们考虑了体重变化。一旦被问到“偏胖的用户你们设了多少公斤？”，回答“也是 60 公斤”会非常尴尬。
*   **怎么改 / 怎么确认**：
    *   **立刻能做的说明修正**：在 Slide 7、Slide 16 的备注和网页步骤 1/8 中明确说明：“81 人参数化目前仅改变几何尺寸（身高缩放杆长、臀部厚度改变髋高和后侧轮廓），无量纲 effort 按同一单位体重与肌力基准比值计算”。
    *   **便宜的代码检查**：在线性规划里，如果体重 $M$ 和关节肌力 $T_{\max}$ 按同一比例缩放（即单位体重的肌力不变），无量纲 effort 是**完全不变**的！你们只需要算一句话放到 Q&A 里：“我们的 effort 本质上是归一化力臂指标；如果肌力与体重成正比缩放，effort 数值完全不变；如果偏胖者体重增加 20% 而肌力不变，只需把表中的 effort 直接乘以 1.20 即可。”——这样一句话就能把“漏写了体重缩放”变成“有意识的无量纲化处理”。

---

### 4. 【严重度：中】三份材料（Slides、设计网页、总结文档）之间存在多处直接冲突的“残留设定”

你们经历了 v4 → v5 → v5.1 → v5.2 → v5.3 → v5.6 的快速迭代，导致网页前几节和总结文档里留下了与最终方案（Slides）直接矛盾的说法。如果把这些作为附录或网页交给老师，会造成很大困惑：

| 冲突点 | Slides（当前最终口径） | 设计网页 / 总结文档中的矛盾原文 | 在哪里 |
| :--- | :--- | :--- | :--- |
| **1. 应急拨杆装在哪里？** | “拉**立柱侧带护盖**的拨杆”（讲稿指南明确说：给家属用，不在握把旁免得误拉） | 网页步骤 9：“拉索拨杆**在握把旁**”；总结文档 5.2：“拉**握把旁**的拉索拨杆即降”；`v5_checks.py` 注释：“with a cable lever **at the handrail grip**” | 网页步骤 9、总结文档 5.2、`v5_checks.py` |
| **2. 体重自检用什么传感器？** | “**不用底座称重**（和床固定后底座测不准）……抬升中**三处力之和 ≈ 体重**”（Slide 12） | 网页步骤 12 表格（B6 E3）：“座下测力只用于速度规则；**体重自检改用底座四角的测力单元**”；总结文档 5.2：“**体重自检改用底座四角测力**” | 网页步骤 12、总结文档 5.2 |
| **3. 人离开后座板会不会自动复位？** | “**只有人按住‘降’才往下动，不自动下降**；离座后座板停住接人”（Slide 4、13） | 网页步骤 12 表格（C3）：“人离开、踏板也空了几秒后，**座板降回与床齐平（空载复位）**”；总结文档 5.2：“**空载复位（人离开后座板降回齐平）**” | 网页步骤 12、总结文档 5.2 |
| **4. 应急下降时间与速度** | 离心限速 **3 cm/s**，全行程约 **11 s**，阻力余量 **2.6 倍**（Slide 10、网页步骤 6） | 总结文档 5.2 节表格：“离心限速（约 **0.1 m/s**）……最轻用户下沉推力 267 N 对阻力 73 N（**3.7 倍**），全行程 **3.3 s**” | 总结文档 5.2 |

*   **为什么是问题**：因为网页和总结文档是顺着时间线往下追加小节的（5.2 写了一套，5.3 又推翻了 5.2），读者从头往下读会先读到已经被废除的设计（比如网页步骤 9 的“交给 CAD / 仿真”清单是直接给队友看的，上面还写着“拉索拨杆在握把旁”！）。
*   **怎么改**：全局搜索“握把旁”、“底座四角”、“空载复位”、“3.3 s”，把网页步骤 9、步骤 12 和总结文档 5.2 里的过时描述清理掉，或者在 5.2 开头加粗标明“已被 5.3 覆盖”。

---

### 5. 【严重度：中】防跌模型（`seat_1dof_fall_catch.py`）里的几何穿透：直接把座板前移了 17 cm 减出后缘，忽略了倾角，也没有考虑身体其他部位撞击机构

*   **在哪里**：`model/calc_v13/seat_1dof_fall_catch.py` 的 `backward()` 和 `knee()`；Slide 7；网页步骤 14、15。
*   **代码证据**：
    ```python
    # seat_1dof_fall_catch.py
    r = good[i] if i < len(good) else good[-1]; zt = r["seat_top"] + rb; rear = r["front_x"] - 0.17
    ```
*   **为什么是问题**：
    1.  **小问题（几何近似）**：座板傾角为 $\phi$（最大 $15.7^\circ$）时，水平投影长度是 $0.17 \cos\phi \approx 0.164\text{ m}$，而且后缘高度比前缘高 $0.17 \sin\phi \approx 4.6\text{ cm}$，座板中心高度 `seat_top` 也不是后缘高度。
    2.  **真正需要警惕的物理问题（推论）**：在第二种摔法（膝软往后落）和第三种摔法（直挺挺往后倒）中，你们算出有 27% 到 72% 的阶段“臀部越过座板后缘落到床上，0% 落地”。但是，当座板升到 $0.57\text{ m}$ 高、前移了约 $15\text{ cm}$ 时，座板和床沿之间有一道高出床面 $15\text{ cm}$ 的硬台阶！如果人绕脚踝或膝盖往后倒，臀部就算越过了座板后缘落到 $0.42\text{ m}$ 的床上，**人的大腿后侧、尾骨或后背会直接砸在这块升起的座板上（或者大腿被卡在 $0.57\text{ m}$ 的座板上，屁股悬空在床面上方）**！
*   **怎么改 / 怎么确认**：
    *   你们已经在 Slide 7 上写了“往后摔会碰座板后缘 → 后缘软包”，这很有预见性。但建议在讲稿指南 Q&A 中更诚实一点：不要把“72% 越过后缘落到床上”包装得像完全安全一样，而是坦承：“当座板升起后，如果发生整体向后倾倒（摔法 ③），座板确实会成为臀部回落到低床面路径上的障碍物；除了后缘做大圆角高厚软包外，这也是为什么我们要求双手始终握住前方横杆，限制向后仰倒的幅度。”

---

### 6. 【严重度：低–中】课程交付与汇报层面的两个现实风险（10/27 沟通前需注意）

1.  **Slide 6 和 Slide 9 的文字极小且信息过载**：
    *   看截图：Slide 6（一次完整的使用）5 张小图顶部的状态框字号极小，投影仪上后排绝对看不清；Slide 8 左边的三维示意图引线字也很小；Slide 7 塞了两个图表加右侧 5 条结论，计划时长只有 1.3 分钟（约 300 字），听众还没看懂“三种摔法”是什么就翻页了。
    *   **怎么改**：Slide 6 小图里的三行灰字删掉，只留“状态：已坐上 / 抬升 / 站立保持”大字；Slide 7 表格里如果竖直升降不跑 ② ③（写着 `—`），不如在口头聚焦讲“① 髋直着落”和“② 膝软往后落”，把表格简化。
2.  **距离 11/3 终稿只剩 7 天，老师明确要求的 CAD 与运动动画目前全是 Python 2D/3D 草图**：
    *   老师 10/26 邮件第 4 条明确要求：“要展示 CAD 模型和运动动画”。你们在 Slide 6、8、9、21 上都很诚实地标了“不是 CAD，待补 SolidWorks 动画”。
    *   **需要确认的风险**：角色 3 和角色 4 的工作高度耦合（FEA 悬臂变形、真实质心倾翻复核都在等角色 3 的 SolidWorks 模型），而且还要把 21 页中文高密度 slides + 附录全部翻译成地道的英文。如果 10/29 前 CAD 装配体出不来，后面角色 4 的 FEA 和英文排版会全部卡死。建议在今天（10/27）内部定死 CAD 冻结的死线（不求螺栓细节，先把导轨、滑块板、连杆、悬臂支架、箱体和 L 扶手的大块几何建出来跑通运动算例）。

---

### 总体判断

这是一个**思考深度极佳、工程迭代逻辑非常扎实**的课程设计项目。你们没有停留在画一个概念壳子，而是真正用参数化人体模型去逼出了单自由度轨迹、坐垫刚度分区、偏载悬臂和防跌边界的物理矛盾，这在课程汇报里会非常出彩。

去见老师（10/27 Consultation）之前，最紧迫的不是再写新代码，而是：
1. **修正 `v5_checks.py` 里悬臂力矩分解的力学错误**（问题 1）；
2. **清理网页和文档里与最终方案打架的旧设定**（问题 4），并准备好解释“81 人体重与肌力无量纲化”的口径（问题 3）；
3. **集中火力把 SolidWorks 装配体、运动动画、悬臂 FEA 和英文精简版做出来**。只要把这几块补齐，这就是一份拿满分的标杆级终稿。
