xiaweiyi0423/me5412-bedexit-proposal/page/seat1dof/audit/gemini_E_teacher.md

<!-- model gemini-4-argon, finish STOP, usage {"promptTokenCount": 130416, "candidatesTokenCount": 6707, "totalTokenCount": 137123, "promptTokensDetails": [{"modality": "TEXT", "tokenCount": 112974}, {"modality": "IMAGE", "tokenCount": 17442}], "candidatesTokensDetails": [{"modality": "TEXT", "tokenCount": 6707}]} -->

作为课程指导老师兼答辩时最刁钻的评委，我非常赞赏你们在运动学合成、81人参数化遍历以及网页可视化上投入的巨大工作量。但是，如果你们拿着这份材料直接上台，**我会在前 5 分钟内把你们问住**。

因为你们在解决“起身时怎么跟住臀部”这个问题时，创造出了几个**直接违背你们自己在 README 中写下的安全红线**的物理死穴，而且把最危险的环节推给了“让控制去解决”，但机构本身根本不给控制器留活路。

以下是按严重程度排序的审计问题、我会在答辩时怎么问你们，以及你们必须如何修改或回答。

---

### 1. 【严重度：高】“前倾 26.7° 时脱力坐回”的物理死锁 —— 1-DOF 机构 + 自锁丝杠根本无法“迅速放平”

*   **位置**：网页《步骤 9：局限与下一步》的“待验证”卡片；`seat_trajectory_summary.md` 第 3 节；`seat_1dof_layout.py` 中的机构轨迹结果（`phi_max: 26.7`, `phi_end: 4.7`）。
*   **原文/代码证据**：
    *   README 第12版改动：“*取消座板前倾，改为竖直升降。一个推杆驱动的四连杆只有一个自由度，倾角由高度决定，做不到‘离座后停在高处、座板水平’，万一坐回去能接住人。*”
    *   网页步骤 9：“*前倾 30° 时如果人往回坐，需要控制器迅速放平座面，否则会顺坡下滑*”。
    *   `page.json` / `layout.json`：座板在上升中段（约 $z=0.52\sim 0.60\text{ m}$）前倾角高达 **26.7°**，直到最顶端 $z=0.66\text{ m}$ 才回平到 **4.7°**。
*   **为什么是致命问题（刁钻提问）**：
    > **老师提问**：“你们在 README 里刚向我证明过 1-DOF 做不到高处水平接人，现在又改回 1-DOF 前倾了。请告诉我：当老人升到一半（比如髋高 0.58 m，座面前倾 26°）突然腿软坐回时，你的状态机怎么救他？网页说‘靠控制器迅速放平座面’——但这是一个单自由度机构！倾角 $\phi$ 是高度 $z$ 的严格函数。想在 $0.58\text{ m}$ 放平座面，唯一的方法是要么把座板降回床面（$0.42\text{ m}$），要么升到最顶（$0.66\text{ m}$）。更糟的是，你们选了**自锁丝杠电动推杆**（行程 168 mm），常见自锁推杆满载速度也就 $10\sim 30\text{ mm/s}$，走完行程要 5 到 10 秒！人跌坐下来只需要 0.3 秒，你拿什么‘迅速放平’？人砸在 26.7° 的斜坡上（$\tan 26.7^\circ = 0.503$），普通裤子对坐垫的摩擦系数也就 $0.4\sim 0.5$，老人会直接顺着座面滑到地上！”
*   **事实与因果**：
    1. 确定事实：单自由度意味着位置和姿态锁死，不存在独立放平的自由度；丝杠自锁推杆的速度决定了它绝对不可能在跌落时间内（$<0.5\text{ s}$）大幅改变高度来回平。
    2. 逻辑崩塌：你们算出“最小坐回余量 $+0.6\text{ cm}$”，这只是证明臀部能碰到坐板前缘，但碰上的是一个 **26.7° 的滑梯**，根本接不住人。
*   **怎么改 / 怎么回答**：
    *   **立刻删掉网页步骤 9 里“需要控制器迅速放平座面”这句外行话**，这在机械原理上是错的，控制组同学看到会崩溃。
    *   **补算与修改**：
        1. **表面高摩擦设计**：明确座面（特别是前缘托腿垫）采用高摩擦防滑硅胶/纹理聚氨酯表面（实测对织物静摩擦系数 $\mu_s \ge 0.65 > \tan 26.7^\circ = 0.50$），并在防滑垫前缘做微微上翘的梨形鞍鼻（pommel/lip）机械阻挡。
        2. **修正状态机逻辑（回应老师要求 3 和 5）**：如果在半途（大倾角区）检测到松手或坐板力突增（跌坐），控制器**绝不能盲目停死在 26.7°**，而是如果力传感器确认人全重压回且手仍在握把上，应以最大安全速度平滑下降回水平位；或者利用连杆在 $z=0.66\text{ m}$ 处回平到 $4.7^\circ$ 的特性，说明只有在接近站立、倾角已经回落（$<15^\circ$）时人才会真正脱离座面。

---

### 2. 【严重度：高】坐垫预抬高 4 cm 导致“未坐上时与床出现 4 cm 台阶” —— 怎么从床沿挪过去？

*   **位置**：网页《步骤 7：坐垫刚度》底部的黄色提示框（`#cushNote`）；`seat_cushion.py` 的 `sitdown()`。
*   **原文/代码证据**：
    *   网页步骤 7：“*坐垫刚度还牵动两个机构参数：一是坐着时会下陷约 4 cm，**坐板未受压时的高度应比床面高出这么多**，这样坐上去后才和床面齐平*”。
    *   README：“*老人坐在床沿、脚踩台架踏板，**往前挪到与床齐平的短座板上***”。
*   **为什么是问题（刁钻提问）**：
    > **老师提问**：“你们的操作流程是老人先坐在床沿（$0.42\text{ m}$），然后往前挪（scoot forward）到短座板上。现在你们说为了补偿坐垫下陷，空载时座板要比床面高出 $4\text{ cm}$（也就是 $0.46\text{ m}$）。请问一个连站都站不起来的虚弱老人，屁股怎么从 $0.42\text{ m}$ 的软床垫上，**往上翻越一个 $4\text{ cm}$ 高的台阶**挪到你的座板上？而且你的四连杆起点定死在 $z=0.42\text{ m}$，代码里的 `pre` 只是往下延了 $3\text{ cm}$ 给数学搜索用，硬件上这 $4\text{ cm}$ 到底是谁来升、什么时候升？”
*   **事实与因果**：
    *   如果机械零点设在 $0.46\text{ m}$，老人往前挪时会撞上坐垫后缘台阶，根本坐不上去。
    *   如果机械零点设在 $0.42\text{ m}$（泡沫顶面 $0.42\text{ m}$），人坐上去下陷 $3.9\text{ cm}$，髋部初始高度就变成了 $0.381 + r_b$，比你们前面步驟 1~6 所有刚体轨迹计算假设的 $0.42 + r_b$ 低了整整 $4\text{ cm}$！
*   **怎么改 / 怎么回答**：
    *   **把这件事变成“状态机控制器”的一个亮点状态（Pre-load / Leveling State）**：
        *   **状态 0（待机/移乘）**：推杆处于最底端，**未受压的坐垫顶面与床垫齐平（$0.42\text{ m}$）**（即刚性座板底板在 $0.37\text{ m}$）。老人可以毫无阻碍地从床沿平移到座板上。
        *   **状态 1（承重找平）**：坐板下 4 个测力传感器检测到老人坐稳（竖直力达到如 $>30\%\text{ BW}$）但还未按“起”按钮，或者刚按下按钮的前 $1\text{ s}$，推杆先走前 $4\text{ cm}$ 的压缩补偿段，把下陷的臀部托回 $0.42\text{ m}$ 基准高，然后再进入正式曲线轨迹。
    *   需要在 CAD 和四连杆合成里验证：座板刚性面从 $0.37\text{ m}$ 升到 $0.66\text{ m}$ 是否会撞床（目前 `seat_1dof_layout.py` 里刚性座板起始在 $0.42\text{ m}$）。如果不改连杆，就老老实实承认床垫本身在人坐床沿时也会下陷 $3\sim 4\text{ cm}$，所以两者在未受压时同高（$0.42\text{ m}$），受压后也同高（约 $0.38\text{ m}$），不需要空载高出床面 $4\text{ cm}$！**后一种解释最简单、最符合真实物理，直接改网页文案即可。**

---

### 3. 【严重度：高】对老师核心要求的回应缺失：倾覆稳定性、传感器力平衡与状态机被前倾座板打破

*   **位置**：对比老师 10/26 邮件要求（第 2、3、5 点）与整个 `seat_1dof.html` 网页。
*   **原文/代码证据**：
    *   老师要求 2：“*要考虑人坐上去、挪动时重心变化带来的台架稳定性。*”
    *   老师要求 3：“*手握输入，加上压力和力分布传感；抬升速度要能个性化、自适应。*”
    *   README：“*座板、踏板下各 4 个测力单元，横杆测力；**各传感器的竖直力之和与体重对不上就锁住**。速度 = $k \times (\text{推力上限} - \text{座板测到的力})$。*”
    *   代码 `seat_cushion.py`：座板前倾 $\phi$ 时，座板法向力是倾斜的（`n = rot(phi) @ [0, 1]`）。
*   **为什么是问题（刁钻提问）**：
    > **老师提问 1（传感器与控制）**：“你们 README 里说用座板下的 4 个单轴测力单元（load cells）测力，并且‘各传感器竖直力之和等于体重’来做安全校验，还用座板力算自适应速度。但那是针对**水平座板**设计的！现在你的座板前倾了 **26.7°**，装在座板下面的传感器测到的是**法向力 $F_n$** 还是竖直力 $F_z$？当座板前倾 26.7° 时，$\cos 26.7^\circ = 0.893$，还有 $\sin 26.7^\circ = 45\%$ 的水平推力分量 $F_x$ 以及切向摩擦力！你们的体重校验公式怎么写？速度公式 $v = k(F_{\text{cap}} - F_{\text{seat}})$ 里的 $F_{\text{seat}}$ 用哪个力？”
    >
    > **老师提问 2（台架稳定性）**：“我邮件里专门要求考虑重心变化带来的台架稳定性。现在你们把固定铰点 A、B 往床前挪到了 $22\sim 30\text{ cm}$，座板更是往前伸到了 $x = 32\text{ cm}$。如果台架和床的连接松脱了，或者老人在最高点往前扑，整个台架绕前横梁（$x=66\text{ cm}$）或后横梁（$x=3\text{ cm}$）的抗倾覆力矩是多少？网页里为什么一个字都没提？”
*   **怎么改 / 怎么验证**：
    *   **补齐传感器几何变换（给角色 5 控制组）**：因为是 1-DOF 机构，推杆自带位置反馈 $L_{\text{act}}$，通过四连杆正运动学可以实时唯一确定座板倾角 $\phi(L_{\text{act}})$。因此，控制器读取座板法向力 $F_n$ 后，可通过 $F_{z,\text{seat}} = F_n \cos\phi(L_{\text{act}}) + F_t \sin\phi$（或将 4 个测力传感器装在**底座纵轨与地面之间**，直接测全机对地总竖直反力！）来完美解决倾角带来的测力耦合。**强烈建议在答辩时说：4个测力单元装在台架底座四个角下（或座板下配合推杆位置编码器做 $\cos\phi$ 修正）。**
    *   **补齐稳定性校核数字（给角色 4 结构组）**：在网页《步骤 6》或 Slides 附录里加三行计算：底座前后跨度 $x \in [0.03, 0.66]\text{ m}$，人坐上、挪动、升到最高点（COM 最靠前/靠后）时，总重力+手部内力的地面压力中心（CoP）始终在 $[0.10, 0.55]\text{ m}$ 之间，距离前后倾覆边至少有 $11\text{ cm}$ 余量；再加上床腿夹/床垫钩板的双重固定。

---

### 4. 【严重度：中】网页与代码存在三处直接的数字矛盾和断层，评委细看会质疑数据真实性

*   **位置 1：坐垫研究用的是旧连杆（v2），而网页主推的是新连杆（v4 `layout`）**
    *   **证据**：`seat_cushion.py` 第 23 行写死读取了 `fourbar.json`（即 v2 连杆，支架深 25 cm，无防撞床约束），其轨迹终点在 `0.6285` 和 `0.66`。因此网页《步骤 7》表格和黄色结论框写着：“*加了 3 cm 行程后，起身到 55% / 70% 时托不住的人数从 12 / 36 降到 **1 / 9***”。但是，在 `seat_1dof_layout.py`（第 157 行）用真正采用的 v4 连杆重跑坐垫后，实际结果（见文末 JSON `mechanism.summary.cushion_lost` 和 `seat_1dof_summary.md` 第四版）是 **`"0.55": 0, "0.7": 3`（即 0 / 3 人）**！
    *   **后果**：同一个网页里，步骤 7 说 1/9 人托不住，总结文档第四版说 0/3 人，而且步骤 7 里的 `顶 0.63 m` 让人莫名其妙（前面一直说最高 0.66 m）。
    *   **修复**：让 `seat_cushion.py` 改用 `layout.json` 的轨迹重跑，或者在网页步骤 7 明确更新为新机构的 **0 / 3 人**。

*   **位置 2：网页步骤 8 正文说“前倾角最多差约 9°”，但表格里写的是“12°”**
    *   **证据**：`template.html` 第 225 行写死硬编码文本：“*四连杆走出的轨迹和设计曲线不完全一样（前倾角最多差约 9°）*”。那是第二版（v2）的数字！在《步骤 5》的连杆布置表格最后一行（采用方案 `layout`），前倾误差明明写着 **12°**（准确值 `11.7°`），轨迹误差 **11 mm**（准确值 `10.5 mm`）。
    *   **修复**：把 `template.html` 第 225 行的硬编码 `9°` 改为动态读取 `D.mech` 或直接改为 `12°`。

*   **位置 3：网页页脚写错了数据来源**
    *   **证据**：`template.html` 第 255 行页脚写着：“*数据来源：`model/calc_v13/seat_1dof_design.py` → `seat_1dof/design.json`*”。但 `design.json` 里存的是已经废弃的“双曲线导轨槽”方案！网页真正注入的是 `seat_1dof_page_data.py` 生成的 `page.json`（综合了 `layout.json`、`fourbar2.json`、`cushion.json`）。
    *   **修复**：更新页脚说明，避免老师顺着文件名去查代码时以为你们还在用导轨槽。

---

### 5. 【严重度：中】机械与安全隐患：双摇杆外置形成四个“剪刀口（Pinch Points）”，且单推杆中置驱动横管存在受扭变形

*   **位置**：网页《步骤 6：支撑结构与干涉检查》及截图 `30_svgFront.png`、`30_svgSag.png`。
*   **原文/代码证据**：
    *   摇杆 A 在 $|y| = 25.5\text{ cm}$，摇杆 B 在 $|y| = 28.5\text{ cm}$，距离大腿外侧只有 $7.2\text{ cm}$（对偏胖用户只有 $5.2\text{ cm}$）。
    *   推杆在中间平面 $y=0$，推力高达 $2834\text{ N}$（100 kg 静载），推在一根长达 $2 \times 28.5 = 57\text{ cm}$、半径仅 $2\text{ cm}$（`R_TUBE = 0.02`）的横管中点上，横管再带动两侧的外摇杆 B。
*   **为什么是问题（刁钻提问）**：
    > **老师提问 1（夹手/卷入风险）**：“老人夜里起床穿着宽松的睡袍或睡裤，坐下时手还可能习惯性往座板两侧摸。你们把两套四连杆和立板裸露在座板两侧下方仅 $11\text{ cm}$、离腿仅 $5\sim 7\text{ cm}$ 的地方。摇杆 A 和摇杆 B 在差 $3\text{ cm}$ 的两个平面内交错摆动 $96^\circ$，这就是两把大剪刀！怎么防止睡衣卷进去或者夹伤手指？”
    >
    > **老师提问 2（结构弯曲与卡死）**：“一根推杆在正中间（$y=0$）用 $2.83\text{ kN}$ 的力推一根 $57\text{ cm}$ 长的横管，横管两端挂在 $y=\pm 28.5\text{ cm}$ 的摇杆 B 上。算过这根横管中点的弯矩吗？$M = FL/4 = 2834 \times 0.57 / 4 \approx 404\text{ N}\cdot\text{m}$！而且如果老人坐偏了（重心偏向一侧），左右两套四连杆受力不对称，全靠这根细横管抗扭来同步左右摇杆 B，算过它的扭转角和应力吗？”
*   **事实与因果**：
    *   确定事实：三脚架/简支梁受集中载荷 $2834\text{ N}$，跨度 $0.57\text{ m}$，弯矩高达 $404\text{ N}\cdot\text{m}$。如果用外径 $40\text{ mm}$、壁厚 $3\text{ mm}$ 的普通圆钢管，截面模量 $W \approx 3.0 \times 10^{-6}\text{ m}^3$，弯曲应力 $\sigma = M/W \approx 135\text{ MPa}$，加上偏载扭矩很容易接近普通结构钢屈服极限或产生明显弹性挠度，导致两侧连杆不同步。
    *   确定事实：横管离大腿后侧最近只有 **$2.8\text{ cm}$**（见步骤 6 表格 `tube-thigh: 2.8 cm`）。如果老人大腿软组织下垂（模型假设大腿是刚性圆柱！），大腿后侧的肉会直接蹭到这根正在移动的横管。
*   **怎么改 / 怎么验证**：
    *   **加防护罩（Shroud / Bellows）**：在 CAD 模型和汇报中明确说明，两侧的立板与四连杆机构外侧及内侧均有固定防护壳包裹（因为摇杆只在 $|y| \in [24, 30]\text{ cm}$ 的窄槽内运动，非常容易做全包外壳），座板下方加风琴布帘，彻底消除夹手和睡衣卷入隐患。
    *   **横管下移或加粗校核（给角色 3、4）**：把推杆推动的横管连接点从摇杆 B 的 60% 处（`t=0.6`）往底座铰点 B 靠近一点，或者把横管改为矩形截面梁/双管桁架，并在结构安全部分放一页 $404\text{ N}\cdot\text{m}$ 的弯扭合成校核，直接堵住老师的嘴。同时把横管离大腿的 $2.8\text{ cm}$ 间隙扩大到 $5\text{ cm}$ 以上。

---

### 6. 【严重度：中】生物力学模型的“4 cm 骨盆分界线”假设过于武断，撑不起步骤 3 的精确排序

*   **位置**：网页《步骤 3：助力位置》；`seat_trajectory.py` 第 28 行 `PELVIS_A = 0.04` 及 `effort()` 第 51 行。
*   **原文/代码证据**：
    *   `hc = -cross(C - Hp, f) if pel else 0.0`（其中 `pel = (a <= 0.04)`）。
    *   也就是说：只要接触点在臀腿交界前 $4.0\text{ cm}$ 以内，代码中该力对髋关节产生 100% 的力矩帮助；一旦到了 $4.1\text{ cm}$（比如候选点 4“大腿 10 cm”），代码中 `hc = 0.0`，**突然变成对髋关节完全没有矩作用**（只帮膝盖）！
*   **为什么是问题（刁钻提问）**：
    > **老师提问**：“在自由体受力图（FBD）里，大腿和骨盆是通过髋关节铰接的。不管坐板推在坐骨上还是推在大腿上，这个外力都会通过股骨传到髋关节反力上！为什么在你的代码里，推在大腿 $4\text{ cm}$ 处能帮髋关节省力，推在大腿 $4.1\text{ cm}$ 处髋关节力矩项 `hc` 直接归零？你们网页步骤 3 得出结论说‘大腿近端 4 cm 费力 0.200 最好，大腿 10 cm 变差’，这难道不是你们自己写的 `if a <= 0.04` 这个阶跃函数制造出来的人工假象（artifact）吗？”
*   **事实与因果**：
    *   在刚体静力学中，如果把“躯干+骨盆”切出来做隔离体（`moment_about(Hp, P, upper)`），只有直接作用在骨盆（坐骨结节）上的外力才进入该隔离体的力矩平衡方程；作用在大腿（股骨）上的力只进入“躯干+骨盆+大腿”对膝关节的平衡方程（帮膝不帮髋）。
    *   但是，人体臀大肌和软组织跨越了髋关节，从推坐骨过渡到推股骨是一个连续的软组织传力过程，而且大腿近端 $4\text{ cm}$ 处实际上已经是股骨近端/软组织，由于前倾力臂比坐骨下方更大，代码把它当成 100% 刚性连在骨盆上，才算出了“点 3（大腿 4 cm）比点 2（坐骨下方）还省力”的反直觉结论。
*   **怎么改 / 怎么回答**：
    *   你们在网页黄色框里已经很诚实地写了“*这条结论依赖一个模型假设……不是测出来的*”，这很好。
    *   **答辩话术升级**：当老师问起时，不要强调“4 cm 比坐骨好”，而是说：“从生物力学原理看，推骨盆（髋膝双助）优于推大腿远端（仅助膝）。由于软组织包裹，坐骨结节前方约 $4\text{ cm}$ 内的受压主要由骨盆承担。这一定性规律决定了我们的设计目标是**让坐板跟住臀部、防止接触点滑向大腿中远端**；至于后来的坐垫弹簧床模型（步骤 7），我们已经用连续压力分布和压力中心（CoP）替代了单点接触假设。”

---

### 7. 【严重度：低】汇报与可读性问题：这是给 10/27 答疑用的好网页，但离 11/3 的英文展示还差关键转换

*   **位置**：整体网页结构与课程交付要求对比。
*   **问题诊断**：
    1.  **与主方案（README）人格分裂**：README 第 12 版明确写着“*取消座板前倾，改为竖直升降*”，而这个网页通篇在讲为什么竖直升降不行（81人只有24人合格）、为什么要做单自由度前倾四连杆。10/27 找老师 consultation 时，必须先用一句话交代清楚：“**这是我们在 v12 竖直升降基础上做的 v13 升级/对比研究，想请老师拍板我们最终用竖直还是四连杆。**”否则老师会觉得你们组内角色 2 和角色 3 没对齐。
    2.  **信息密度过高，缺少系统级视图**：网页把“坐板子系统”讲得极其透彻，但**扶手（L形扶手/横杆）是怎么跟着这个四连杆动的？** 网页动画里那个黑点（横杆 `bar`）还在按竖直升降时代的公式 `min(hz - R_B, TOP) + 0.40` 纯竖直往上飘（见 `template.html` 第 285 行 `const bar=[D.consts.bar_x, Math.min(Hp[1]-0.09, D.consts.top)+0.40]`）！如果扶手连在座板上，座板前倾 26.7° 时扶手也会往前下方栽倒 26.7°；如果扶手不连在座板上，扶手怎么升？**动画里扶手在纯竖直上升，座板在沿曲线前倾上升，这在机械上是怎么由“一个电机”实现的？！**（这绝对会被老师一眼看穿！）

---

### 总结判断与最值得先做的一件事

*   **总体判断**：
    这份单自由度四连杆坐板的设计展现出了远超本科/研究生课程常规水准的计算深度与交互可视化能力，“从 81 人姿态包络 → 选最不利曲线 → 四连杆运动综合 → 避障与坐垫耦合”的工程逻辑链条非常漂亮。但是，**它目前是一个“孤立的平面机构学杰作”，在与整机系统（扶手联动、传感器测力方向、30°斜坡防滑、状态机慢速自锁推杆）结合时存在严重的物理接口断裂。**

*   **最值得先做的一件事（在 10/27 见老师前必须搞定）**：
    **立刻想清楚并统一“扶手（横杆）到底连在哪里”以及“26.7° 前倾时跌坐怎么防滑”这两个物理死穴。**
    *   如果扶手是固定在台架立柱上不升降（或用平行四边形连杆保持水平），立刻改掉动画里按旧公式瞎飘的黑点；
    *   同时把网页里“靠控制器迅速放平座面”和“空载坐板比床高 4 cm”这两句自曝其短的话改掉（改为“高摩擦防滑鞍面 $\mu \ge 0.65$”和“床垫与坐垫受压同步下陷，空载齐平”）。只要补上这两个洞，你们在 10/27 的答疑中就能无懈可击。
