xiaweiyi0423/me5412-bedexit-proposal/page/v13/audit/gemini_E_reader.md

<!-- model: gemini-4-argon; finishReason: STOP; usage: {"promptTokenCount": 77995, "candidatesTokenCount": 4865, "totalTokenCount": 82860, "promptTokensDetails": [{"modality": "TEXT", "tokenCount": 54164}, {"modality": "IMAGE", "tokenCount": 23831}], "candidatesTokensDetails": [{"modality": "TEXT", "tokenCount": 4865}]} -->

以第一次看这份网页的工科研究生（或刚接手整合工作的组员）的视角来看，这份第 13 版网页的骨架非常扎实：问题定义、交互流程、模型支撑、状态机、故障仿真一应俱全。但正因为信息密度高，网页里几处**图文矛盾、数字打架、概念未解释**的地方会直接卡住读者的理解，甚至在 consultation 时被老师一眼盯上。

以下按重要性从高到低排列我发现的问题：

---

### 1. 【严重度：高】回床交互的图文严重矛盾：手到底扶横杆还是扶侧扶手？传感器怎么触发？

* **在哪里**：网页 `#night`（一晚上的往返）的第 2、9、10、11 步（见截图 `step_02.png`、`step_09.png`、`step_10.png`、`step_11.png`），以及脚本 `STEPS` 数组和 `seated()` 函数。
* **原文与代码证据**：
  * **文字描述**：第 2 步“手拉**横杆**借力”；第 9 步“扶着**横杆**坐下”；第 10 步“按一下‘降’，双手扶**横杆**”；第 11 步“手推**横杆**，身体往后挪回床垫”。
  * **画面与代码（事实）**：在 `seated = L => ({..., W:[0.40, 0.58+L]})` 和 `P.scoot` 中，火柴人手腕的横坐标 `W.x` 都在 `0.36 ~ 0.40 m`，高度在侧扶手附近；而前横杆在 `BX = 0.69 m`。所以在侧视图上，火柴人的手根本没有够到前面的横杆，而是搭在侧面的水平杆上，甚至第 9、10 步手是悬空朝下的。
  * **更糟的是传感器黄点（事实）**：第 9、10 步 `sens:["seat","bar","feet"]`，侧视图右上角前横杆顶端的传感器亮起了黄点（表示正在受力），但火柴人的手离那个黄点有差不多半米远！
* **为什么是问题**：
  1. **直接误导读者**：读者看第 9、10 步时，看到人的手没碰前横杆，前横杆的传感器却亮了，会以为图画错了或者传感器装在侧杆上。
  2. **掩盖了真实的人机工程学漏洞（因果推导）**：为什么画图的人在 `seated()` 里不把手画到 `0.69 m` 的前横杆上？因为当髋部在 `0.11 m`、座面升高后，如果人不大幅前倾，手臂总长（上臂 `0.298` + 前臂 `0.32` = `0.618 m`）去够 `x=0.69 m, z=0.82+L` 的前横杆会非常勉强。在回床往下坐（第 9 步）和往后挪回床（第 11 步）时，人还能不能抓到前横杆？“降”按钮到底装在前横杆握把上，还是侧扶手上？网页完全没交代。
* **怎么改**：
  1. 明确交代按钮和握把位置：如果坐着时手自然搭在**侧扶手**上，“降”按钮就应该在侧扶手前部，或者明确说明第 9、10 步手扶的是侧扶手。
  2. 如果坚持全程扶前横杆，修改 `seated(L)` 和 `P.scoot` 的手腕坐标 `W` 为 `[0.69, 0.82+L]` 并让躯干合理前倾；如果改为扶侧扶手，就把传感器黄点位置或文字说明改过来，做到图文一致。

---

### 2. 【严重度：高】“谁受益”核心读写面板与仿真结果的数字直接打架（0.63 m vs 0.62 m，0.23 在图表上显示“站不起来”）

* **在哪里**：网页 `#why`（为什么升高、谁受益）右侧交互面板（截图 `03_why.png`）对比 `#sims` 第 1、2 个场景（截图 `05_sims.png`）及 `#night` 第 5 步。
* **原文与代码证据**：
  * **证据 A（0.63 m vs 0.62 m）**：在 `#why` 面板默认滑块 `effort = 0.25` 下，大字显示：“在起身台上离座的高度 **约 0.63 m**”（见截图 `03_why.png`）。紧接着往下滚到 `#sims` 第一个图“典型目标用户（最多用到 effort 0.25）”，副标题写着“座面 **0.62 m** · 离座 **0.62 m**”，`#night` 第 5 步也写“典型用户约 **0.62 m**”。
    * *原因（事实）*：网页前端 `seatOffHeight()` 把“座板力 ≤ `0.01` BW”当成离座（在 `0.62 m` 的 `0.021` 和 `0.64 m` 的 `0.0` 之间插值得到 `0.6305 m`）；而后端 Python 控制器 `controller_v13.py` 把 `< 0.05` BW（`seatoff_thr = 0.05 * BW`）持续 0.3 s 当成离座，所以在 `0.619 m` 就停了。
  * **证据 B（effort = 0.23 的悖论）**：正文和仿真第 2 个场景都说“最弱的目标用户（0.23）”能在 `0.66 m` 离座。但在网页 `#why` 里，如果读者把滑块拉到 `23`（`c = 0.23`）：
    1. 因为 `so66 = E.seatoff.P1[12] = 0.233`，代码判断 `c < so66`（`0.23 < 0.233`）为真，命中 `zone = 0`！
    2. 面板会亮起“**站不起来 (< 0.23)**”，文字变成：“**升到 0.66 m 仍站不起来……这类人不在目标人群里**”！
* **为什么是问题**：这是典型的“前端一套算法、后端一套算法、四舍五入又一套”导致的自相矛盾。读者或老师只要动一下那个交互滑块拉到 0.23，网页就会当场自己打脸（正文说 0.23 是最弱目标用户，交互工具说 0.23 站不起来、不在目标人群里）。
* **怎么改**：
  1. 统一前后端的离座判据：把网页 `seatOffHeight` 里的阈值 `const thr = 0.01` 改成和控制器一致的 `0.05`（或者说明控制器在 `< 5%` 体重时判为离座），这样 `effort = 0.25` 时前后端算出来的都是 `0.62 m`。
  2. 修复滑块在 `0.23` 处的边界判断：在 `readout()` 中用四舍五入后的值比较（例如 `const so66_r = Math.round(so66 * 100) / 100`），或者把 `0.66 m` 在 `c=0.23` 时的 `min_seat = 0.010` 视为已离座，避免滑到 `0.23` 时弹出“站不起来”。

---

### 3. 【严重度：中】“最弱用户 / 站不起来的人”两个仿真场景暴露了控制逻辑的盲区，且和网页文字描述相反

* **在哪里**：网页 `#why` 的 `readout()` 文字、`#sims` 的第 2 个场景（`weakest`）和第 4 个场景（`tooweak`）（见截图 `05_sims.png`），以及 `controller_v13.py`。
* **原文与代码证据**：
  * **场景 4（`tooweak`，effort 0.20）**：网页 `#why` 写的是：“升到 0.66 m 仍站不起来。**控制器会在到顶后停住**，等他按‘降’或 20 s 后带他降回床面（仿真‘站不起来的人’）。” 但看截图 `05_sims.png` 的第 4 张图，座高黑线只升到 **0.62 m**（`max_height: 0.623`）就折返了，根本没到 `0.66 m` 的顶！而且状态条变成橙色（STOPPED）是因为仿真脚本在 `t = 24 s` 硬编码了 `sitback=24.0` 和松手，并不是因为“到顶停住”。
  * **场景 2（`weakest`，effort 0.23）**：在 `0.66 m` 时，模型算出的最小座板力是 `0.01 BW`（大于 0）。为什么仿真里他能触发 `< 0.05 BW` 离座？因为控制器把 `< 5%` 体重就当成离座。可一旦进入 `STANDING_HOLD`，仿真脚本第 127 行写着 `if C.state == "STANDING_HOLD" and trying: frac = 0.0`——也就是说，代码**强行把他的座板力归零了**，而在生物力学模型里，`0.23` 的人在 `0.66 m` 其实还差一点点力气（`0.233`）才能完全离开座板。
* **为什么是问题**：仔细看仿真图的读者会奇怪：“为什么站不起来的人在 0.62 m 就放弃了，不是说升到 0.66 m 才到顶吗？” 如果老师追问“为什么 `tooweak` 没升到 0.66 m”，你们就得解释这是因为 `0.20` 的人在底部的座板力接近 `0.425 BW`，离上限 `0.5 BW` 太近，速度太慢（约 0.6 cm/s），21 秒还没升到顶人就累垮了——这反而暴露出**按线性比例调速时，越弱的人升得越慢、被消耗的时间越长**（`weakest` 要升 12.7 s，`strong` 只要 4.6 s）。
* **怎么改**：
  1. 在 `#why` 和 `#sims` 中诚实说明：`effort = 0.20` 的人因为卸载能力差，抬升速度极慢，在升到顶之前（约 0.62 m）体力不支坐回；如果把他的推力上限调高到 `0.6 BW`，才能升得更快。不要写“控制器在到顶后停住”这种与仿真图不符的话。
  2. 考虑在讨论中提一句这个物理矛盾：能力越弱的人越需要升到高处，但在 `v = k(F_cap - F_seat)` 下他们升得最慢、维持发力的时间最长，这就是为什么需要把 `F_cap` 设为可调（对弱者调到 `0.6 BW`）。

---

### 4. 【严重度：中】两处关键机械構造在网页正文里突然冒出来，没有任何图解或铺垫

作为第一次看网页的工科读者，我在读前半部分时对这台机器的几何印象完全来自 `#night` 的侧视图和俯视图。但读到后面时，突然冒出两个前面图里根本看不懂的特征：

1. **“紫色横条”是什么？床架夹又在哪？**
   * **在哪里**：`#night` 侧视图（截图 `step_01.png`）床垫下方有一条显眼的紫色横条（代码 `fill:"var(--plate)"`），但图例只写了“橙色 = 座板；黄点 = 正在受力的传感器”，完全没提紫色是什么。直到读到 `#structure` 才知道以前有个“床垫下的钩板（只定位）”，而真正承受 1112 N 的主角是“**床架夹**”——可侧视图里只有紫色的钩板，根本没有画床架夹！
2. **“左右可换装”的 L 形扶手怎么换？侧扶手到底升不升？**
   * **在哪里**：`#control` 参数表最后一行和 `#changes` 审计第 5 条写：“扶手可左右换装，按偏瘫的健侧安装。” 另外 README 说“L 形扶手随座板升高”。
   * **为什么困惑**：
     * 看侧视图（`step_01` 到 `step_05`），前立柱（`x=0.69`）底部一直插在踏板上，上半截随座板伸长；水平侧杆（`z=0.64+L`）后端连在 `x=0`（床沿处）随着座板一起升高，但 `x=0` 处并没有画竖直导轨或立柱！那这根侧杆的后端是怎么悬空升到 `0.84 m` 高的？
     * 俯视图里 L 形扶手是由“靠内侧的侧杆 + 靠床尾的前横杆”组成的。如果“左右换装”指的是换到床的另一侧（左边床沿 vs 右边床沿），还是指在台架上把开口朝向从床尾换到床头？读者完全想不出来。
* **怎么改**：
  1. 在 `#night` 侧视图图例里加上“紫色 = 床垫下定位板（床架夹在床侧梁处）”，或者直接在侧视图床框上画一个床架夹的示意块。
  2. 在侧视图 `x=0 ~ 0.07` 处把连接座板和侧扶手后端的竖直滑架画出来，别让侧扶手后端悬空。
  3. 把“扶手左右可换装”写清楚一两句话：“台架可用于床的左侧或右侧（L 形扶手对称重装，使开口始终朝向床尾 / 助行器一侧）”。

---

### 5. 【严重度：中】多处关键术语和缩写第一次出现时没有解释或缺少主语

组员自己天天讨论觉得理所当然的词，外人第一次看会一头雾水：

1. **“手上 ≤ 25% 体重” vs “肩肘力量 ×0.5”**（`#why` 图表图例与按钮，截图 `03_why.png`）：
   * 读者看到这两个切换按钮时是懵的：为什么要在这两个毫不相干的词之间二选一？其实查了 `seat_support.py` 的 `ARMS = {"P1 cap25": (1.0, 0.25), "P2 arm x0.5": (0.5, 0.30)}` 才明白：
     * 方案 P1 是“肩肘关节力量取默认值（×1.0），但双手合力上限设为 25% 体重”；
     * 方案 P2 是“双手合力上限放宽到 30% 体重，但肩肘关节力量减半（×0.5）”。
   * 网页按钮只写了半句话，读者根本不知道选第二个按钮时手力上限变成了 30%，也不知道选第一个时肩肘力量是 ×1.0。
   * **怎么改**：在 `#why` 正文或折叠框外面加一句简短说明：“为检验结论对手臂假设的敏感度，对比两种保守假设：① 手力受限（双手 ≤ 25% 体重，上肢力量正常）；② 上肢力量受限（肩肘力量减半，双手 ≤ 30% 体重）。”
2. **“推力上限 0.5 倍体重”的主语容易误解**：
   * 读者第一次在 `#why` 读到“先把座板上的力降到推力上限（默认 0.5 倍体重）以下”时，直觉会想：“升降柱额定推力不是 2 kN × 2 = 4 kN 吗？怎么推力上限才 30 kg（0.5 倍体重）？”
   * **怎么改**：第一次出现时写明是“**控制器设定的助力上限**（即座板最多帮人托起 0.5 倍体重，其余需人自己发力转移到脚和手上）”，区分开“软件控制上限”和“推杆硬件额定推力”。
3. **仿真图里的英文缩写 `1 BW`**（`#sims`，截图 `05_sims.png`）：
   * 正文全中文（“倍体重”），唯独 12 张仿真图的纵轴和鼠标悬停提示突然写 `1 BW`、`0.50 BW`，全页没有任何地方解释 `BW = Body Weight（倍体重）`。直接把纵轴标签改成 `1×体重` 或在导语里注明 `（1 BW = 1 倍体重）`。

---

### 6. 【严重度：低】几处阅读体验与排版细节问题

1. **置顶导航栏在锚点跳转/截图时遮挡正文**（见截图 `03_why.png`、`04_control.png`、`05_sims.png`）：
   * 截图里非常明显：`nav.top` 浮动在半空中，直接把 `#why` 的标题“为什么要升到 0.66 m”切掉了一半，把 `#control` 三条核心规则的标题“握紧才升，松手即停”等全部盖住了！虽然这可能是长截图拼接脚本导致的，但如果真机滚动定位也有这个问题，说明 `section { scroll-margin-top: 60px }` 不够或者 `position: sticky` 的容器层级有问题。去现场给老师看之前务必在浏览器里自己点一遍顶部导航栏确认。
2. **“一晚上的往返”俯视图文字重叠**（见截图 `step_06.png`、`step_07.png`、`step_08.png`）：
   * 第 6、7、8 步俯视图里，棕色的行动轨迹虚线直接穿过了“**开口一侧 ↓**”这几个字，甚至第 6 步代表人身体的椭圆直接压在“开口一侧”四个字上面，糊成一团。
   * **怎么改**：把 `drawTop()` 里“开口一侧 ↓”的文字坐标 `TY(0.49)` 往左或往下移一点，避开人走动的中线。
3. **网页结构把“v12 → v13 修订记录”放得太重，缺少对“装置本体”的一图总览**：
   * 对老师和组员来说，第 13 版改了什么很重要；但对一个第一次看这个方案的读者（或 11/3 评委）来说，在 `#problem` 和 `#night` 之间其实缺了一个最基础的**“这台装置长什么样、由哪几部分组成”的 30 秒概览**（比如：14×44 cm 短座板 + 两根三节升降柱 + 80×66 cm 踏板 + L 形随动扶手 + 9 个测力点）。现在读者必须从 11 个步骤的动态字里行间自己拼凑这台机器的尺寸和传感器分布（比如 README 里提到了“座板、踏板下各 4 个测力单元，横杆测力”，但网页正文从头到尾都没介绍传感器是怎么布置的，上来就讲“压力中心在安全区”、“力之和自检”！）。

---

### 总体判断与最值得先做的一件事

**总体判断**：这份网页的逻辑深度和闭环程度远超一般本科/研究生课程设计，尤其是用生物力学模型直接驱动状态机仿真的做法非常漂亮。它目前的问题不在于“没做够”，而在于**迭代太快留下的接口错位**（前端插值 vs 后端阈值、新改的回床文字 vs 旧的火柴人手部坐标、删掉了旧版介绍导致传感器布置等基础信息缺失）。

**最值得先做的一件事（10/27 见老师前只需 20 分钟）**：
**立刻修好 `#why` 右侧交互面板的阈值（问题 2）和 `#night` 侧视图火柴人的手部位置（问题 1）。** 把 `template.html` 里的 `const thr = 0.01` 改为 `0.05` 并修正 `0.23` 的边界判断，消除 `0.63 m vs 0.62 m` 和滑到 `0.23` 提示“站不起来”的自相矛盾；同时对齐第 9–11 步手扶位置与传感器亮灯位置，避免在给老师演示交互网页时当场露怯。
