xiaweiyi0423/me5412-bedexit-proposal/page/seat1dof/audit/v5/gemini_A_model.md

<!-- model gemini-4-argon, finish STOP, usage {"promptTokenCount": 198669, "candidatesTokenCount": 5266, "totalTokenCount": 203935, "promptTokensDetails": [{"modality": "TEXT", "tokenCount": 161934}, {"modality": "IMAGE", "tokenCount": 36735}], "candidatesTokensDetails": [{"modality": "TEXT", "tokenCount": 5266}]} -->

以下是从**坐→站生物力学与简化建模**角度对第五版（含 5.1）方案及网页的审计报告。按重要性和严重度排序：

---

### 1. 【严重度：高】坐垫刚度引入后，主验证指标（81/81 合格、前滑、坐回余量、放手时机）与坐垫模型脱节

* **位置**：
  * 网页第 5 步（`#mech`）、第 7 步（`#cushion`）、第 8 步（`#check`）及页首 KPI。
  * 代码：`seat_1dof_slider.py` 中的 `V5.user_job`（调用 `seat_relative_motion.track`），以及 `seat_cushion_zoned.py`。
* **证据**：
  1. 在 `seat_relative_motion.py` 的 `track()` 中，前滑、坐回余量和放手高度（`release_hz`）全都是按**无下陷的刚体接触**（`gap <= 0` 的单点初接触）算出来的。且一旦接触点超出大腿 `A_MAX = 18 cm`（`ok = kind[j] < 2`），代码立即 `break` 判定放手。
  2. 但在第 7 步和 5.1 的坐垫模型（`seat_cushion_zoned.py`）中，为了压出 $0.5\text{ BW}$ 的力，推荐的分区坐垫下陷中位数达 $4.9\text{ cm}$，导轨为此专门加长了 $3\text{ cm}$，座板必须沿着斜导轨**继续往上前移一大段**。
  3. 在 `cushion_zoned.json` 中，推荐分区坐垫在全身体的接触压力中心 `cop_a_cm` 最大已达 $25.6\text{ cm}$，压强大值点 `peak_a_cm` 90% 分位数在 $21.5\text{ cm}$、最大达 $28.5\text{ cm}$（见截图 `21_cush_z1_70pct.png` 和 `21_cush_z2_70pct.png`，接触区一直延伸到大腿 $20\text{ cm}$ 处）。
* **为什么是问题（确定的事实）**：
  **两套模型的前提互相矛盾。** 
  第一，刚体模型规定接触点超过大腿近端 $18\text{ cm}$ 就不能接受（防止压迫腘绳肌，立即放手）；但坐垫模型在算起身 55% 和 70% 时，把这一条规则关掉了——座板为了凑够 $0.5\text{ BW}$，直接沿着导轨追上去，把力实实在在地压在了大腿 $20\sim 28\text{ cm}$ 的区域上。
  第二，座板为了压缩软前区而沿着 $33.2^\circ$ 的导轨多走几厘米时，座板相对大腿向膝盖方向滑移，且座板倾角也在变（在导轨末端甚至后仰到 $-3.4^\circ$）。然而，网页第 8 步宣称的“81/81 合格、最大前滑 $+1.9\text{ cm}$、放手费力 $0.233$”却完全是在**没有坐垫下陷、也不走完这多出的 3 cm** 的刚体假设下算的。如果按坐垫真实压下后的座板位置重算，放手时机、滑移量和有效支撑高度都会改变。
* **怎么改或验证**：
  在 `seat_cushion_zoned.py` 中加上 `a <= 18 cm` 的舒适区限制（或者诚实说明软托腿垫允许接触到 $25\text{ cm}$）；并且用坐垫压到 $0.5\text{ BW}$ 时的**实际座板姿态**去复核 81 人的前滑、坐回余量和放手高度，不能一边给导轨加长 $3\text{ cm}$ 走末端，一边还拿刚体接触点的指标当最终结论。

---

### 2. 【严重度：高】单侧扶手 + 单侧推力的双倍偏心，在 2D 矢状面模型中按“双手对称发力”计算

* **位置**：
  * 网页第 5 步、第 6 步正视图/俯视图（`#svgFront`、`#svgTop`）、第 11 步。
  * 代码：`seat_trajectory.py` 的 `effort()` 函数，`seat_1dof_v5.py` 的 `pole_effort()`。
* **证据**：
  1. 俯视图和 `v5_checks.py` 明确写道：扶手立杆只在**床头一侧**（$x = 0.69\text{ m}, y = +0.25\text{ m}$）。老人在起身时，这是一个偏在身体右侧（或左侧）25 cm 的单根立柱。
  2. 但 `seat_trajectory.py` 的 `effort()` 里，上肢质量和关节肌力上限写的是：
     `(C_ua, 2 * sub.m_uarm), (C_fa, 2 * sub.m_farm)`，以及 `2 * sub.sh_flex, 2 * sub.sh_ext, 2 * sub.el_flex, 2 * sub.el_ext`。手部最大拉力 `HAND_CAP = 0.25 * BW`。
* **为什么是问题（确定的事实 + 生物力学推理）**：
  1. **运动学与肌力高估（事实）**：原 `model.py` 里至少还有一个 `lateral` 参数用来折减侧向抓握时的手臂平面可达长度，并且区分了单手/双手（`n_arms`）。到了 `seat_trajectory.py`，侧向折减被完全丢掉，直接按双手在正中矢状面（$y=0$）抓握、两只手臂同时输出 100% 肌力来算。实际上老人要双手去抓一根偏在一侧 $25\text{ cm}$ 的竖杆，远端那只手必须横跨胸前，不仅可达范围大幅缩水，还会产生很大的躯干旋转力矩；如果只用近端单手抓，肩肘肌力上限只有代码里的一半（`1 * sub.sh_flex`）。
  2. **与单侧悬臂叠加（推理）**：第五版把导轨也放在床头一侧（$y = +0.28\text{ m}$），座板向床尾侧悬臂。当老人坐上去时，座板支架下垂变形会向床尾侧（$-y$）倾斜，把人往开口侧推；而老人唯一能扶的立杆却在床头侧（$+y$）。这两个侧向不对称叠在一起，老师在答辩时一定会问：“立杆偏在一侧，你的 2D 模型怎么算手上的力？”
* **怎么改或验证**：
  在 `effort()` 中把 `model.py` 的 `lateral = 0.25` 可达性折减加回来，并按单手（`n_arms = 1`）或折减后的双手肌力重算一次 `E0_release`，作为保守下限放进网页或附录，主动交代单侧立杆对上肢费力的影响。

---

### 3. 【严重度：中】固定立杆的费力优化允许老人在起身的每一帧“瞬移”抓握高度，且忽略了立杆水平拉力的倾翻

* **位置**：
  * 网页第 5 步、第 8 步、第 11 步（“放手费力按立杆上最省力的抓握点计算：中位 0.233，比第四版随动横杆 0.251 还低”）。
  * 代码：`seat_1dof_v5.py` 的 `pole_effort()`、`user_job()`，以及 `seat_1dof_v5_checks.py` 的 `tipping()`。
* **证据**：
  1. `seat_1dof_v5.py` 第 147 行：`pole_effort` 对 `POLE["z"]`（$0.75\dots 1.10\text{ m}$）和 `POLE["x"] = (0.62, 0.69, 0.76)` 双重循环取最小值！（注意：网页上说立杆固定在 $x = 0.69\text{ m}$，但算 `E0_release` 时代码其实允许手在 $x = 0.62, 0.69, 0.76\text{ m}$ 三个水平位置里挑最省力的，这与 `seat_cushion_zoned.py` 只固定 `x = 0.69` 不一致）。
  2. 在 `user_job`（算支撑段 `E_supported_max`）和 `seat_cushion_zoned.py` 中，对起身的每一个时刻（15%、35%、55%、70%），代码都在 `zb in (0.85, 0.95, 1.05)` 中重新挑一个最省力的高度。
  3. 在 `v5_checks.py` 的 `tipping()` 中，校核立杆抗倾翻只算了竖直向下的力：`[(100 * G, 0.69, 0.25)]`。
* **为什么是问题（确定的事实）**：
  1. **不可能在承重时换手**：老人双手正用最大 $0.25\text{ BW}$ 的力拉住立杆协助起身，而且按 README 控制规则“松手即停（握把式死人开关）”。老人不可能在起身 15% 到 70% 的半途松开开关去立杆上换一个抓握高度。真正的固定立杆约束应该是：**同一个人在整个起身过程（从坐到放手）只选定一个固定的 $(x, z)$ 抓握点**。现在逐帧挑最优高度，把固定立杆算成了“随身体自动调节高度的扶手”，高估了它的省力效果（这也是为什么固定立杆反而比第四版随动扶手费力更低的原因之一）。
  2. **倾翻校核漏了向后的水平拉力**：LP 模型里手在立杆高度（最高 $1.10\text{ m}$）是可以向后拉的（$F_x < 0$，上限 $0.25\text{ BW}$）。当老人在床沿还没有完全踩上踏板、或者刚开始起身往后拉立杆时，$1.10\text{ m}$ 高处的水平拉力产生的倾翻力矩非常大，但 `tipping()` 只算了竖直挂在立杆上的力。
* **怎么改或验证**：
  - 修正 `seat_1dof_v5.py` 中 `POLE["x"] = (0.69,)`，去掉多余的 $0.62$ 和 $0.76$；
  - 对每个用户，固定一个从坐姿到放手都能构型可达的抓握高度 $z_b$，重算 `E_supported_max` 和 `E_release`；
  - 在 `tipping()` 中补上立杆在 $z = 1.0\text{ m}$ 处承受水平向后拉力（$0.25\text{ BW}$）时的前后倾翻余量。

---

### 4. 【严重度：中】分区坐垫“省力机制”的物理解释不完整：忽略了前倾角变化和摩擦缺失带来的水平推力分量

* **位置**：
  * 网页第 7 步 5.1 节（`#zoneProse`）：“省力是真的，但主要不是因为‘推在骨盆上’……比较合理的推断是：压力中心往后移、离膝更远，同样 0.5 倍体重对膝的帮助更大。这一点还没单独验证。”
  * 代码：`seat_trajectory.py` 的 `effort()`，`seat_cushion_zoned.py` 的 `load()`。
* **证据**：
  1. 在 `seat_cushion_zoned.py` 的 `load()` 中，坐垫微元力的方向为 `nrm = nl @ Rm.T`，即**严格沿座板顶面的外法线方向**（对于平座面，就是向前上方倾斜 $\phi$ 角：$\mathbf{f} = (\sin\phi, \cos\phi)$）。
  2. 在 `seat_trajectory.py` 的 `effort()` 中，膝关节力矩系数 `kc = -cross(C - K, f)`。设接触点 $C$ 在大腿后侧距膝盖距离为 $L_k$，大腿倾角为 $\theta$，座板倾角为 $\phi$。
* **为什么是问题（生物力学推导）**：
  网页说“这还没单独验证”，其实看一眼代码里的力矩公式就能完全算清楚，而且里头藏着一个需要注意的模型假象：
  1. **为什么对分界线不敏感**：在起身中段，瓶颈关节往往是膝关节（或者手部力可以帮助平衡髋关节力矩）。由于接触力 $\mathbf{f}$ 垂直于座板（倾角 $\phi$），而大腿倾角为 $\theta$，力 $\mathbf{f}$ 对膝关节的力臂并不是距膝距离 $L_k$，而是 $L_k \cos(\theta - \phi)$（再加一点大腿厚度项）。当压力中心往髋部移动 $\Delta a = 3\text{ cm}$ 时，对膝盖的减荷力矩直接增加 $\Delta a \cdot F \cos(\theta - \phi)$，所以只要压力中心后移，无论算不算进骨盆段，膝盖都会省力。
  2. **座板位置改变带来的倾角变化**：分区坐垫（前软后硬）在后半程为了凑够 $0.5\text{ BW}$，座板必须比均匀坐垫**沿着导轨多走几厘米**。看 `tilt_curve` 图（截图 `05_mech.png` 右下）：座板在 $z = 0.55\text{ m}$ 之后前倾角 $\phi$ 是迅速减小的（从 $15.8^\circ$ 降到 $-3.4^\circ$）。也就是说，同一时刻下，分区坐垫因为下陷深、座板走得更远，它的座板前倾角 $\phi$ 比均匀坐垫**更小（更接近水平）**！
  3. **无摩擦假设的副作用**：在无摩擦模型里，座板前倾 $\phi$ 时，给人的力是向前上方的（$F_x = F\sin\phi > 0$）。这个向前推的水平分力虽然帮人往前走，但在关于膝关节求矩时（膝盖在接触点右上方，$C_z < K_z$），向前的力 $F_x > 0$ 反而会产生**屈膝方向（不利）**的力矩！当座板走到导轨末端、$\phi$ 变小甚至变成负值（后仰）时，力变成了纯竖直向上甚至略向后上方，对膝盖和重心平衡反而更有利。
  4. 同样在 5.1 节，网页提到激进方案有“26 个情况比均匀坐垫更费力（集中在 1.75 m、偏瘦、髋早前移、后半程）”，却没解释原因。真正的原因正是：这些人在 70% 阶段用激进坐垫时**托不住（`lost = True`，见 JSON 中 `lost: 3`）**，座板撞到了导轨尽头，推力掉到了不足 $0.5\text{ BW}$，自然比能托住 $0.5\text{ BW}$ 的均匀坐垫更费力。
* **怎么改或验证**：
  在网页 5.1 节把两件事直接写明白，不要留模糊的“推断、未验证”：（1）直接写出膝关节力臂随压力中心后移而增大；（2）明确指出那 26 个变差的情况主要是因为后半程下陷过大导致行程用尽、推力不足 $0.5\text{ BW}$，或是座板位置变化引起的法向力方向变化。这样推理链就彻底闭环了。

---

### 5. 【严重度：中】放手防滑判据（$\mu \ge \tan 15^\circ \approx 0.27$）忽略了人体已处于大腿陡倾姿态的切向力与坐回冲击

* **位置**：
  * 网页第 9 步（`#limits`）、第 10 步、第 11 步（“放手后人往回坐，座板前倾 $\phi$ 时，沿座面向下的分力与压力之比是 $\tan \phi$……15° 只要 $\ge 0.27$”）。
* **证据**：
  网页第 11 步第 7 条待办虽然诚实地补了一句“$\tan \phi$ 只是静力学下限，人坐回时的冲击没算”，但在正文第 10 步和第 11 步开头，都把“$\tan 15^\circ \approx 0.27$”作为“问题 1 已解决（绿色标签）”的核心定量依据。
* **为什么是问题（生物力学推理）**：
  把防滑条件简化成斜面上的木块（$\mu \ge \tan\phi$），隐含假设是**作用在座板上的外力是纯竖直向下的**。但老人放手或力竭往回坐的那一刻：
  1. 大腿倾角已经在 $40^\circ\sim 53^\circ$，如果老人是因为腿软（膝伸肌力竭）坐回，小腿和大腿折叠，臀部轨迹是**向后下方**运动的；但如果老人是在前倾加速过程中手滑脱，重心还在往前走，碰撞力就有向前的水平分量。
  2. 更关键的是，人坐在前倾 $15^\circ$、且大腿向下倾斜 $45^\circ$ 的座面上时，臀部并不是一个平面木块，大腿的重量通过髋关节拉扯骨盆，如果双脚踩地位置靠前（如脚位 $33\text{ cm}$）且膝盖伸展受阻，地面对脚的反作用力是向前推的，或者在“托腿垫”区域（大腿倾角 $45^\circ$）接触时，真实接触界面并不是 $15^\circ$ 的座板平面，而是被压成楔形的软坐垫表面（局部倾角介于 $15^\circ$ 和 $45^\circ$ 之间）。
* **怎么改或验证**：
  在网页第 10 步表格第 1 行的“已解决”旁边，建议措辞放稳妥一点：从“已解决”改为“大幅缓解（倾角减半至 $\le 15.8^\circ$，静摩擦需求降至 $0.28$）”，并在口头汇报时准备好应对老师的追问：“如果真坐回去还是滑怎么办？”（标准答案：座板前缘有 $R=3\text{ cm}$ 的软包边，且分区坐垫后区下陷 5 cm、前区厚 8 cm，压缩后会形成一个“后低前高”的凹坑/兜底效应，这比单纯靠表面摩擦系数 $\mu$ 更可靠——甚至你们可以直接在模型里算一下坐垫压缩后的局部切线角，作为加分项）。

---

### 6. 【严重度：低】网页第 8 步与竖直升降方案的对照基准不一致（扶手与高度双双变化）

* **位置**：
  * 网页页首 KPI、第 8 步验证表（`#check`）。
  * 代码：`seat_1dof_page_data_v5.py` 第 100 行：`check=dict(design=users, vertical=D["check"]["vertical"])`。
* **证据**：
  网页第 8 步表格小字注写了：“费力为放手那一刻的值（手抓固定立杆）……竖直升降一列仍是旧的对照数据（手抓随座板升降的扶手）。”同时，第五版斜导轨因为加长了 $3\text{ cm}$，最高点升到了 `top = 0.688 m`（见 JSON），而旧的 `vertical` 对照数据最高点是 `0.66 m`。
* **为什么是问题（确定的事实）**：
  页首大字 KPI 直接把 `0.233`（新坐板）和 `0.273`（竖直升降）放在一起对比，读者和老师第一眼会以为这 $0.040$ 的费力下降全是“斜导轨曲线坐板”带来的。但实际上这里混进了三个变量：（1）竖直 vs 斜导轨曲线；（2）随动横杆 vs 固定立杆（多点寻优）；（3）最高点 $0.66\text{ m}$ vs $0.688\text{ m}$。在科学建模审计中，这种控制变量不唯一的对比很容易被挑刺。
* **怎么改或验证**：
  在 `seat_1dof_v5.py` 里顺手用同样的固定立杆（`pole_effort`）跑一遍竖直升降方案，更新 `vertical` 列的 `E0_release`，只需几行代码，就能做到完全公平的同基准对比。

---

### 总体判断与最值得先做的一件事

* **总体判断**：
  第五版（及 5.1）的工作非常扎实，针对上一轮审计的痛点给出了清晰的工程演进逻辑；特别是 5.1 节对分区坐垫“为什么前半程能移过去、后半程移不过去（大腿倾角 vs 座板倾角）”的几何分析，物理直觉准确、图表直观，是非常亮眼的课程展示素材。目前主要的薄弱点在于**新增的子模型（弹簧床坐垫、3 cm 导轨加长、单侧固定立杆）与原有的主验证流程（刚体接触滑移、2D 双手对称 LP）之间存在割裂**。
* **最值得先做的一件事**：
  **统一“手扶固定立杆”和“坐垫下陷后位置”的计算口径**：固定每个用户的抓握高度（不允许起身中途换手）并计入单侧立杆的横向距离折减，同时检查坐垫压下 $4\sim 6\text{ cm}$ 后（导轨走到 $0.69\text{ m}$ 段）是否仍满足前滑 $\le 2\text{ cm}$ 和大腿接触区 $\le 18\text{ cm}$ 的要求。把这处逻辑缝合好，整个建模链条在答辩时就无懈可击了。
