xiaweiyi0423/me5412-bedexit-proposal/presentation/audit/v3/audit_report.md

# PPT 第三轮 Gemini 审计：核实与处理（2026-10-27）

## 审计做法

- **对象**：v5.5 的 21 页 slides 和讲稿。v5.5 的改动包括：
  - 防跌对比；
  - 坐板控制仿真；
  - 机构三维图；
  - 回床高度 0.50 m；
  - 横杆末端软包。
- **方式**：六个角度，原文在 `gemini_*.md`：
  - A 论证；
  - B 安全；
  - C 真实使用；
  - D 评分老师；
  - E 现场听众；
  - F 答辩提问。
- **工具**：
  - 打包：`../build_bundle_v2.py`；
  - 截图：`../render_slides.js`；
  - 运行：`../run_audit_v3.py`；
  - 背景：`../context_v3.md`。背景里列出了第二轮已改的内容，并要求只找新问题、检查改动有没有落实。
- **原则**：每条意见先回到代码和数据核实，确认是问题才改。不对的建议单独列出。

## 最重要的发现：起身路径只算到约三分之二（审计间接引出）

### 怎么发现的

A 和 F 质疑“腿一软时髋部直着往下落”这个定义对床不公平：真实的膝软会让髋往后退。为此补算第二种摔法（小腿不动、髋绕膝往后下落）。

算的时候发现：坐板的路径都停在髋高约 0.69 m（1.50 m 用户）就结束了，没有到站直。

### 原因

`seat_relative_motion.solve_s` 在小腿倾角 −15° 到 45° 之间二分。它要求 45° 这一端也有姿势，否则整个放弃。

但快站直时，小腿前倾 45° 会让膝盖太低，大腿够不到髋，这一端必然没有姿势。

于是每条路径都停在 髋高 ≈ 踝高 + 0.71 × 小腿 + 大腿，大约起身的三分之二（f = 0.62–0.69）。

### 影响

- 81 人里有 42 人在路径断掉时还坐在座板上。对他们来说，“离座”其实只是“路径到头”。
- 离座以后站直的那一段，没有进入防跌、干涉、离座高度等任何检查。
- 床那一侧用的是另一个函数 `bed_path`（求不到时取最近的可行姿势），一直算到站直，所以床的数字基本对。

### 修正

- 按几何算出可行的最大小腿倾角作为上端，再二分。
- 机构保持不变：
  - 斜导轨和连杆当初是对着设计曲线综合的，这条曲线冻结在 `model/calc_v13/seat_1dof/design_curve_v5.json`；
  - 只重算各项检查。
- 第一次重跑时，设计曲线也跟着变了，机构的连杆从 0.46 m 变成 0.99 m。这一步已撤回，改为冻结曲线。
- 扶手位置（x 0.70、z 0.95）也是设计决定，保持不变。只在这个位置上重算 81 人（`seat_1dof_handrail_recheck.py`），没有重新搜索。

### 修正前后

| 项目 | 修正前 | 修正后 |
|---|---|---|
| 不前滑、坐回接得住 | 81/81 | 80/81（没过的那位差 4 mm） |
| 竖直升降 | 19/81 | 11/81 |
| 离座座高：中位 / 最高 | 0.557 / 0.663 m | 0.566 / 0.680 m |
| 放手 effort 中位 | 0.272 | 0.262 |
| 和抬高床同口径比较 | 72 人，再省 5–10%，19/72 略费力 | 81 人，再省 10–14%，22/81 略费力 |
| 腿一软直着落，坐板全程接得住 | 81/81 | 52/81（中位 100% 的阶段，每人至少 86%） |
| 站直时落点距座板前缘 | +7.5 cm | +1.0 cm |
| 竖直升降：接得住的阶段中位 | 62% | 43% |
| 座板 / 支架离小腿最近 | 12.1 cm | 2.0 cm（仍不碰） |
| 单侧四连杆 | 75/81 | 70/81，站直时连杆离小腿 −4 cm（会碰到） |
| 按坐垫压下后的位置复核 | 81/81 | 81/81 |

“9 位矮个用户坐 0.58 m 床脚踩不实”也是路径截断造成的，已删掉，换成几何结果：

- 1.50 m 的人坐在 0.58 m 床沿、脚踩地，大腿往下倾约 41.5°（37–48°），接近半站着；
- 坐 0.42 m 床时约 14°。

### 三种摔法（81 人，整个起身）

| 摔法 | 低床 | 抬高床 | 曲线坐板 |
|---|---|---|---|
| ① 髋直着往下落：接得住的阶段中位 | 14% | 15% | 100%（每人 ≥ 86%） |
| ② 膝软、髋绕膝往后下落：落在座面上的阶段中位 | 41% | 32% | 73%；81 人都不会落到座板前面 |
| ③ 直挺挺往后倒 | 都接得住 | 都接得住 | 28% 落在座板上，72% 越过后缘落到床上 |

**结论改口。** 原来说“坐板全程接得住、床只在刚起身时接得住”，现在改为两点：

- 坐板几乎不让臀部落到支撑面前面。直着落时，只有快站直时 29/81 人落在前缘外 2–7 cm。
- 往后摔时会碰座板后缘，后缘必须软包。

床在 ① ② 里大半个起身过程接不住。

## 其他核实后修改的

| 意见（来源） | 核实 | 处理 |
|---|---|---|
| 设计要求第 6 条“只有确认有人坐着才下降”和回床时空座板下降矛盾（B1、C3、D3、F3） | 成立。第 4、16、18 页都还是旧说法。 | 改为“只有人按住‘降’才往下动，不自动下降”。 |
| 空座板停在 0.50 m 以后怎么继续降（F3 追问） | 成立，而且发现了一个 bug：控制器里再按住“降”，空座板仍停在 0.50 m，到不了床面。 | 改为松开再按住时继续降到床面。15 个场景重跑，仍都落到安全状态；另做了单步检查。 |
| 状态机图里抬升没有“推不动 / 到顶”出口（F3） | 控制器里有（推力上限下 2 s 不动，或到顶 4 s 仍未离座，就停住），但图上漏了。 | 图上补上。 |
| 应急下降断电后靠什么限速到 3 cm/s（B2、F2） | 成立。设计里有离心限速器，但 slides 和讲稿里没写。 | 选型页、风险页、讲稿补上“丝杠轴上的离心限速器”。讲稿说明 104 N 阻力只用来确认最轻的人能启动下降。 |
| “最轻用户 267 N”和 45 kg 对不上（F2） | 不矛盾：45 kg × 座板承担 0.75 倍体重 × 最不利位置的推力系数 0.56，再加座板自重分量。 | 讲稿补上算法。 |
| 自检的体重从哪来；座板只测法向力，漏了摩擦力的竖直分量（B3、D5、F1） | 成立，但幅度被高估。最坏误差是座板力的 1 − cos²φ，15.7° 时约 7%；前倾大时座板力已小，折到总体重上只有 2–3%，低于 15% 容差。 | 体重改为在个人设置里输入（slide 上写明）。讲稿补上误差估计。 |
| 起步时座板力大于上限，速度为 0（D5） | 这是有意的设计。参考用户把座板力压到 0.5 倍体重的 effort 约 0.16，低于放手时的 0.25。 | 讲稿补上回答。 |
| 坐在床上够不着横杆，只能空手往前挪（C2） | 部分成立。髋在床沿或往里 5 cm：81 人前倾 ≤ 30° 都够得着；往里 10 cm：54/81。 | 第 6 页步骤改为“坐到床沿、握住横杆，再拉着横杆挪上座板”。 |
| 第 6 页步骤图 1、2 显示座面 0.44 m、前倾 6°（F4） | 成立。那是座板已经在推人时的位置。另外第 5 张“站稳”其实还在座板上，原因同样是路径截断。 | 步骤图 1、2 画成与床齐平。路径补全后，第 5 张和动画画到真正站直。 |
| 验证表第 4 条和设计要求第 4 条对不上（E1） | 成立。验证表漏了“速度跟着人走、可按人设定”。 | 补上这一行；“机构放得下”改成不编号的补充行。 |
| 残留旧数字（A5、B6、C6、D4、E3、F4） | 成立：局限页讲稿“二三十厘米”、附录“8 个场景”、讲稿待补“14 个场景”、对比页“最佳扶手”、机构页讲稿“约 18 厘米”。 | 全部改掉：“扶手放最优处”、18.5 / 27.4 厘米。 |
| 稳定性页“底座 x 3–78 cm”和“沿床长 65 cm”看似矛盾（E3） | 不矛盾，两个是不同方向。 | 脚注写明方向。 |
| 握着开关不动时老人不知道原因（C5） | 成立。 | 反馈加一句语音说明原因。这是一个小的设计补充，请组里确认。 |
| 空座板下降遇阻只靠电机电流检测（B5） | 部分成立。 | 改为电机电流或座板测力突变即停。 |
| 拨杆老人自己够不着（C4） | 成立。 | 讲稿写明：拨杆主要给家属用；老人自己用电池按住“降”。 |
| 固定件 2.3 kN 和床被拉动（B4、D5、F6） | 2.3 kN 是结构设计载荷，不是常见拉力。 | 讲稿补上：整体抗滑约 300 N；加防滑垫；备选做法是底板压在床腿下。 |
| 悬臂座板的刚度（F7） | 成立，没算过。 | 待补 FEA 加一项：150 kg 偏载下外端下沉 < 3 mm。 |
| 机构页右上小图字太小（E2） | 成立。 | 重画成宽幅、大字、两句话。 |

## 没有照做的

- **A2“座板 + 横杆 + 踏板构成防滑闭环”**：横杆挡不住臀部往前滑，这样说会夸大。只在讲稿里说明静摩擦条件和“手还握着横杆”，冲击和睡衣打滑写进局限。
- **C1“回床改为直接坐床沿”**：作为一种用法写进讲稿（空座板可降到床面）。主流程仍是 0.50 m 回床高度，因为坐下更省力。
- **E5 / E6 讲稿压缩、英文表格排版**：留到英文版再做。
- **D1 / D2 CAD、FEA、英文附录**：仍是待补，属于 11/3 前的主要工作。

## 没有重跑的（仍用修正前的路径）

以下结果是 5.2 之前的历史步骤，页面上作为过程记录保留，没有用于现在的结论：

- `design.json`（第一版设计步骤）；
- `cushion.json`；
- `v5.json`（四连杆比较）；
- `layout.json`；
- 扶手位置的网格搜索。
