xiaweiyi0423/me5412-bedexit-proposal/presentation/audit/v2/audit_report.md

# PPT 第二轮 Gemini 审计：核实与处理（2026-10-27）

## 审计做法

- **对象**：坐板改为主方案后的 21 页 slides 和讲稿。
- **方式**：六个角度，分别是
  - A 论证；
  - B 安全；
  - C 真实使用；
  - D 评分老师；
  - E 现场听众；
  - F 答辩提问。
- **审计原文**：`gemini_*.md`。
- **工具**：
  - 打包：`../build_bundle_v2.py`（讲稿要点、问答从已发布的讲稿里解析）；
  - 运行：`../run_audit_v2.py`；
  - 背景材料：`../context_v2.md`。
- **处理原则**：每条意见先回到代码和数据核实，确认是问题才改。审计里有说错、或建议本身不对的，单独列在“没有照做的”一节。

## 核实后修改的

| 意见（来源） | 核实 | 处理 |
|---|---|---|
| 底座四角称体重自检，和“台架与床固定”冲突，会误锁（B1、C4、F1） | 成立。固定以后，部分竖直力经固定件传到床上；人刚坐上时腿还压着床垫。<br>`controller_v13.py` 原来用的是“座板 + 踏板 + 横杆”三处力之和，只在抬升中检查，不受固定件影响。是 5.2 版改成底座称重，才引入了这个冲突。 | 取消底座称重。<br>自检改为两层：空载时查零点；抬升中三处力之和（座板力按倾角折算）≈ 体重，差超过 15% 且持续 0.5 s 才锁定。<br>改了：传感页、状态机页、风险页、讲稿、坐板网页第 13 节。 |
| 停住后“10 秒没有操作就自动带人下降”，违背“按住才动”（B2、F5） | 成立。旧状态机图（calc_v12）写的是 10 s；v13 仿真里是 17 s 提示、20 s 下降。 | 带人下降只能靠按住“降”。坐着很久不动时，只提醒并呼叫家属。 |
| 人走开 5 s 后座板自动降回齐平：用助行器的人走得慢；座板后缘可能夹到被子或手（C1、B5） | 成立。5.2 版加了这条“空载复位”；v13 控制器本来没有。 | 取消。空座板只在按住“降”时动；回床时自己按住，把空座板降到齐平。 |
| 速度规则：人挂在横杆上、或座板倾斜时，座板力下降会被误判为“站起来了”而提速（B4、F1） | 部分成立。<br>倾斜本身的影响只有几个百分点（cos 15.7° = 0.963）。<br>“挂在横杆上”是真风险。 | 速度限在 0 到最快速度之间。<br>座板力下降时，必须同时看到踏板力上升才提速；横杆受压过大时限速。<br>速度页改为“推力上限 0.5–0.6 × 体重，最快 1.5–3 cm/s”（与 v13 一致）。 |
| 应急拨杆贴着握把，容易误拉；限速 10 cm/s 是正常速度的 3–6 倍；控制器还在出力时，机械松闸会和电机顶牛（B3、C5、F6） | 成立。 | 改为：<br>1. 先用电池，按住“降”慢降；<br>2. 控制器也坏了，再拉立柱侧带护盖的拨杆：第一段行程先断开电机电源，再松开制动；<br>3. 限速改为 3 cm/s。<br>`seat_1dof_v5_checks.emergency()` 已重算：全程 11 s。 |
| 电机被反拖的阻力没算（F6） | 成立。 | 按电机 0.05 N·m、皮带 1:1、不用减速器估算，约 31 N。<br>总阻力 104 N，余量从 3.7 倍降到 2.6 倍。<br>需要按电机样本核对。 |
| 床垫下压板拉不住 2.3 kN（B5） | 成立。 | 固定件只锁在床架或床腿上。 |
| 丝杠被偏载别弯、卡死（F2） | 设计里已有浮动接头（5.2 版第 12 节），但 slides 和讲稿里没写。 | 选型页问答里补上：<br>- 丝杠装在两根导轨之间；<br>- 螺母通过浮动接头只传轴向推力；<br>- 要核对滑块的许用力矩。 |
| 前倾数字写法不一致：15°、15.7°、16°（D3、E4） | 成立。 | 统一写成“全程不超过 16°（最大 15.7°）”；讲稿里的问答改用 tan 16°。 |
| 速度页仿真图还是竖直升降版本（0.66 m）（D2、F7） | 成立。 | 速度页标明是旧版图，并加“待补：按坐板轨迹和新规则重跑”（角色 5）。 |
| 状态机图字太小，而且是旧规则（E2） | 成立。 | 用 matplotlib 重画成中文、大字号，规则用新的（`seat_statemachine.png`）。 |
| 没有三维 / 俯视图，看不出怎么走出去、怎么回床（C1、C3、D1、E1、F4） | 成立。 | 新画了俯视图（`seat_top.png`），放在稳定性页。<br>图中有：床、底座、机构箱、座板齐平位和顶位、L 形扶手、站起后走向床尾一侧的路线、助行器位置、回床路线。<br>CAD 仍然待补。 |
| “往前挪 25–30 cm”（A2、C2、D 追问 1） | 这是旧方案的数字，不成立。<br>现在的座板从床沿内 3 cm 到床沿外 14 cm，和床齐平。 | 改成“约 10–20 cm，取决于原来坐得多靠里”。<br>补上两点：床垫边缘会压陷（机构在齐平位以下有 3 cm 行程可用）；挪动时希望滑、起身时希望不滑，这对矛盾写进了局限页。 |
| 第 7 页：“导轨上段没用来托人”，以及 0.69 m 行程的理由（A1、F3） | Gemini 的读法说过了头，我原来的措辞也说过了头。<br>新算的 `seat_1dof_release_height.py`：离座时座高中位 0.557 m，90% 的人低于 0.615 m，最高 0.663 m，没有人到 0.69 m。<br>Gemini F 建议说“离座后座板继续升到 0.69 m，当防跌护垫”，这不对：按状态机，离座后座板就停住。 | 对比页改成：“床不用垫高，也能达到抬高床的省力效果；比低床省 32%；和抬高床相当”，并给出离座高度。<br>讲稿问答写明：顶上约 3 cm 是余量，可以再缩短。 |
| 19/72 人比抬高床略费力，原因没解释（A3、F3） | 查了，原因成立：<br>- 13/19 是髋部晚前移（p = 2.5），12/19 是脚靠后（xa = 0.25）；<br>- 差得很小：中位 0.011，最多 0.03；<br>- 这是和“每人最有利的扶手位置”比的；和同一副扶手比，只有 5 人略差。 | 写进对比页和讲稿。 |
| 第 1 条设计要求和“部分达成”的定位（A 总体） | 采纳 A 的建议：把要求写成实际想达到的目标。 | 要求 1 改为“床保持低位、脚踩得实；起身省力达到抬高床的水平；座板跟着大腿走”。<br>验证表拆成 1a、1b，两项都标“初步完成”。 |
| 内部痕迹：“旧版 13–20% 已作废”“坐板网页第 13 节”“1′”（D4、E3） | 成立。 | 从 slides 和讲稿正文里删掉，只保留在讲稿问答里，以备被问到。 |
| 附录目录同一行重复了 5 遍（A5、D4、E5） | 成立。原因是 `update_slides_v52.py` 的替换不幂等，每跑一次就多追加一行。 | 修了脚本逻辑，并清理掉重复行。 |
| 第 5 页写“不用机器人”（A5） | 成立。 | 改为“单自由度机构”。 |
| 60 kg 和 100 kg 口径不一致（E4） | 成立。 | 用户页写明：起身模型以 60 kg、1.60 m 为基准；结构按 100 kg × 1.5 校核。 |
| 偏瘫用户左右手的问题（C5） | 成立。 | 用户页问答补上：机构箱和立柱在床头一侧，要按健侧手和床的方向选左右镜像安装。 |

## 没有照做、或只记录的

| 意见 | 原因 |
|---|---|
| A1、F3 建议改轨迹，让上段保持 15° 继续托大腿 | 前倾大于 15–16° 和坐回防滑冲突（5.1 节）。只作为下一步要权衡的问题记录，不改。 |
| F5：坐回瞬间失重，被当成离座 | v13 已经有：离座要持续 0.3 s，座板力做了约 2 Hz 低通滤波。在讲稿问答里说明，不改。 |
| C1：空载复位延时 5 s → 15–30 s | 空载复位整条规则已取消，这条不再适用。 |
| D5、E5：转英文、缩短时长、合并几页 | 是交付和排版问题，不在这次修改范围。留给小组 11/3 前统一处理。 |
| E2：第 6 页小图里的状态文字太小 | 正式版换 CAD 图时一起处理。 |
| E5：第 3 页标题“叠”字显示成乱码 | 原文是正常的“叠”字。是本地渲染时缺少 Noto Serif SC 字体造成的，不是内容错误。 |
| CAD 三维装配图和运动动画（D1） | 是硬性交付物，仍待补（角色 3）。稳定性页的俯视图只能起过渡作用。 |
| 控制仿真重跑（D2） | 待补（角色 5）。需要用坐板轨迹、倾角，以及上面这些新规则重新跑。 |

## 发布

- **Slides**：v14。改了 13 页，新上传 3 张图（状态机、俯视图、传感器）。删除了本次被替换、已无引用的 2 张图。
- **讲稿**：v6。
- **坐板网页**：v10。第 13 节加入：离座高度、控制和安全规则的修改、应急下降的新数字。
