xiaweiyi0423/me5412-bedexit-proposal/presentation/audit/context_v3.md

# 课程与交付背景
- 课程：ME5412 Robotics for Healthcare，小组项目（Group 16，5 人，按 5 个角色分工：1 问题与整合、2 模型与几何、3 机构与 CAD、4 结构与安全、5 控制与仿真）。
- 只做概念、设计和仿真，不做实物、不做实验。
- 时间线：10/27 和老师做一次 consultation（用这份中文草稿）；11/3 交一份**英文** slides（同时当报告用）并现场展示。主 slides 精简，设计和分析的细节、更多图、答问备用页放附录，附录不限页数。
- 老师 10/26 对方案邮件的回复要点：
  1. 目标用户的定义清楚；方案可以；只做概念、设计和仿真就够；验证方法够。
  2. 要考虑人坐上去、挪动时重心变化带来的台架稳定性。
  3. 用户界面和操作安全很关键：手握输入，加上压力和力分布传感；抬升速度要能个性化、自适应。
  4. 要展示 CAD 模型和运动动画。
  5. 把机构概念和状态机控制器讲清楚，工作量就够了。
  6. 主 slides 不要太多，细节可以放附录，附录不限页数。
- 讲稿按约 230 字/分钟写；课堂汇报时长约 15 分钟（小组自定目标，课程正式时限未在材料中给出）。

# 当前设计（v5.5，2026-10-27；取代早先“竖直升降”的版本）

小组的用户决定：单自由度“曲线坐板”是主方案，竖直升降降为对比；扶手是固定在底座上的 L 形扶手（床头一侧立柱 + 人身前的水平横杆，握把开关在横杆上）；应急下降用滚珠丝杠 + 失电制动 + 离心限速。

- 机构：床头一侧封闭机构箱里，座板支架上一个铰点装在沿斜导轨（与竖直成 34°）走的滑块上，另一个铰点用一根倾角连杆拉到底座，构成“3 个转动副 + 1 个移动副”的四杆（曲柄滑块类）。导轨 1 是驱动的移动副（电机 → 约 1:1 皮带，只为把电机折到丝杠旁 → 滚珠丝杠 → 浮动接头 → 滑块板）；第二根导轨和多出的滑块只承担悬臂力矩。座板中心前移 18.5 cm、上升 27.4 cm，前倾先增后减、全程不超过 16°（最大 15.7°），到顶 0.69 m 时 0°。轨迹误差 8 mm。床尾一侧敞开，回床时腿能转过去。机构页已有去掉人体的三维示意图（matplotlib 画的，不是 CAD）。
- 为什么不竖直升：二维模型 81 位用户（身高 1.50/1.60/1.75 m × 臀厚 × 起身习惯 × 脚位），同一 L 形扶手：竖直升降 19/81 不前滑（≤ 2 cm）且坐回接得住；曲线座板 81/81。
- 省力（同一 effort 模型、同一 L 形扶手、同一批 72 位能坐稳 0.58 m 床的用户；effort = 最吃力关节用掉自身最大力量的比例，2D 准静态，两手合计最多 1/4 体重）：低床 0.42 m 0.41；抬高床 0.58 m 0.30；起身台坐板放手那一刻 0.29。比低床省 32%，比抬高床只省 5–10%，19/72 人略费力（差 ≤ 0.03）；另有 9 位矮个用户坐 0.58 m 的床脚踩不实。放手时座高中位 0.557 m，最高 0.663 m，没有人用到 0.69 m。
- 防跌（v5.4 新增，现在是方案的主要价值）：定义“腿一软、髋部直着往下落，臀部落点（髋后 4 cm）还在座面前缘以内”为接住。81 人：曲线坐板起身全程都接住（81/81，站起时落点还在前缘内 7.5 cm）；抬高床只在起身前约 15% 接得住（0/81 全程，站起时臀部在床沿外约 25 cm）；低床 14%；竖直升降中位 62%（19/81 全程）。另一种摔法（直挺挺往后倒、绕脚踝转）：床都接得住；坐板中位 40% 落在座板上、60% 越过座板后缘落到床上，0 落地，所以座板后缘要软包。哪种摔法更常见没有数据。
- 驱动与结构：丝杠推力起身 ≤ 664 N（100 kg），猛坐静载 ≤ 1773 N，行程 331 mm；座板悬臂、载荷偏向敞开一侧 10 cm 时力矩 659 N·m，用双导轨 × 每轨两滑块，每滑块约 3.1 kN。机构箱侧视约 2749 cm²、顶高 0.80 m；双导轨只多占 7%。
- 曾比较的四连杆：座板正下方（55/81）；两侧各一套（81/81，但挡腿、两个同步推杆）；只放床头一侧（75/81、误差 29 mm、推力 4.0 kN、箱子小一半，但地面铰点轴承约 25 kN）。保留斜导轨。
- 稳定性：人在台上时手拉扶手是内力，翻不了；人站在地上扶横杆时台架只有自重约 45 kg，107 N 就会拉翻，所以台架必须锁在床架或床腿上（固定件约 2.3 kN）。
- 传感：座板下测力（法向，按倾角折算）、横杆测力、握把开关、踏板测力。不用底座称重（和床固定后测不准）。自检：空载查零点；抬升中三处力之和 ≈ 体重，差超过 15% 持续 0.5 s 才锁定，锁定后只能按住“降”慢降。
- 控制规则（v5.3–5.5）：松手或任何故障立即停住并制动；只有按住“降”才往下动（空座板也一样），没有自动下降、没有人走开后的自动复位；坐着很久不动（17 s）只提醒、呼叫家属；人挂在横杆上（横杆力 > 0.3 体重）时限速到 30%；“还坐着”门槛 0.10 体重。离座后座板停在放手处接人。回床：按住“降”，空座板停在回床高度（默认 0.50 m，比齐平 0.41 m 高 9 cm，坐下 effort 0.317 对 0.397，约省两成），坐上后再按住“降”降到床面。控制仿真（按坐板轨迹，v5.4）15 个场景（典型、最弱、强壮、太弱、坐偏后、晕倒、床垫、迈步离开、拉扶手、挂横杆、压力中心偏、回床 0.50 m、回床齐平、踏板传感器卡住、断电）都停在安全状态。
- 应急下降：先用电池按住“降”；控制器也坏了，再拉立柱侧带护盖的拉索拨杆，第一段行程先断开电机电源（STO），再松开制动；限速 3 cm/s（全程 11 s）；电机反拖约 31 N，余量 2.6。
- 夜间进出（v5.5）：L 形横杆末端做圆头软包、贴夜光条；横杆固定，回床要从床尾一侧侧身走进座板前缘与横杆之间约 0.46 m 深的空间，助行器进不去——已写进局限页，备选是可掀起的翻转横杆（要锁扣和“已锁住”检测，可能忘了放下）。
- 所有结果来自二维模型和静力计算，没有实物和实测；CAD、FEA、SolidWorks 运动动画还在做。坐板设计的详细推导在一个单独的设计网页（14 节），slides 是汇报用的精简版。

# 之前的审计
这是第三轮审计。第二轮（同样六个角度）提出、已经改掉的主要问题：底座称重与和床固定冲突；停住后自动下降；人走开后空座板自动复位；挂横杆被误判为站起来；应急拨杆贴着握把、限速太快、和电机顶牛；床垫下压板拉不住；前倾数字不一致；速度页仿真图是旧版（现已按坐板重跑）；没有俯视图和三维图；“往前挪 25–30 cm”是旧数字。请检查这些改动是否真的落到了每一页和讲稿里、有没有引入新的矛盾，再找新的问题。不必重复已经解决的问题。
