xiaweiyi0423/me5412-bedexit-proposal/presentation/audit/context_v2.md

# 课程与交付背景
- 课程：ME5412 Robotics for Healthcare，小组项目（Group 16，5 人，按 5 个角色分工：1 问题与整合、2 模型与几何、3 机构与 CAD、4 结构与安全、5 控制与仿真）。
- 只做概念、设计和仿真，不做实物、不做实验。
- 时间线：10/27 和老师做一次 consultation（用这份中文草稿）；11/3 交一份**英文** slides（同时当报告用）并现场展示。主 slides 精简，设计和分析的细节、更多图、答问备用页放附录，附录不限页数。
- 老师 10/26 对方案邮件的回复要点：
  1. 目标用户的定义清楚；方案可以；只做概念、设计和仿真就够；验证方法够。
  2. 要考虑人坐上去、挪动时重心变化带来的台架稳定性。
  3. 用户界面和操作安全很关键：手握输入，加上压力和力分布传感；抬升速度要能个性化、自适应。
  4. 要展示 CAD 模型和运动动画。
  5. 把机构概念和状态机控制器讲清楚，工作量就够了。
  6. 主 slides 不要太多，细节可以放附录，附录不限页数。
- 讲稿按约 230 字/分钟写；课堂汇报时长约 15 分钟（小组自定目标，课程正式时限未在材料中给出）。

# 当前设计（v5.3，2026-10-27；取代早先“竖直升降”的版本）

小组这一轮做了三个用户决定：单自由度“曲线坐板”改为主方案，竖直升降降为对比；扶手改为固定在底座上的 L 形扶手（床头一侧立柱 + 人身前的水平横杆，握把开关在横杆上）；应急下降用滚珠丝杠 + 失电制动 + 离心限速（握把旁拉索拨杆，拉住才降、松手即停，另有电池慢降）。

- 机构：床头一侧封闭机构箱里，座板支架上一个铰点装在沿斜导轨（与竖直成 34°）走的滑块上，另一个铰点用连杆拉到底座；一个电机（滚珠丝杠）。座板中心前移 18.5 cm、上升 27.4 cm，前倾先增后减、最大 15.7°（≤ 16°），到顶 0.69 m 时 0°。轨迹误差 8 mm。床尾一侧敞开，回床时腿能转过去。
- 为什么不竖直升：二维模型 81 位用户（身高 1.50/1.60/1.75 m × 臀厚 × 起身习惯 × 脚位），用同一 L 形扶手：竖直升降 19/81 不前滑（≤ 2 cm）且坐回接得住；曲线座板 81/81。按坐垫压下后的座板位置复核也是 81/81。
- 省力（同一 effort 模型、同一 L 形扶手、同一批 72 位能坐稳 0.58 m 床的用户；effort = 最吃力关节用掉自身最大力量的比例，2D 准静态）：低床 0.42 m 0.41；抬高床 0.58 m 0.31（最佳扶手位置 0.30）；起身台坐板放手那一刻 0.29。比低床省约 32%（每个人都省），比抬高床只省 5–10%，19/72 人略费力；另有 9 位 1.50 m、臀部厚的用户坐 0.58 m 的床脚踩不实。原因：多数人在座板前倾最大（约 15°）时就离开坐垫，髋只比坐在 0.58 m 床上高约 4 cm。早先“比抬高床省 13–20%”来自竖直升到 0.66 m 的旧模型（手上最多 25% 体重、扶手随座板升），已作废。
- 驱动与结构：丝杠推力起身 ≤ 664 N（100 kg），猛坐静载 ≤ 1773 N，行程 331 mm；座板悬臂、载荷偏向敞开一侧 10 cm 时力矩 659 N·m，用双导轨（相距 150 mm）× 每轨两滑块（相距 150 mm），每滑块约 3.1 kN。机构箱侧视约 2749 cm²、顶高 0.80 m；双导轨只多占 7%（两根导轨在同一侧板上）。
- 曾比较的四连杆：座板正下方一套（碰小腿，55/81）；两侧各一套（81/81，但挡住回床转腿、两个同步推杆）；只放床头一侧一套（75/81、误差 29 mm、推杆静载 4.0 kN、箱子小一半，但偏载靠两个相距 8 cm 的铰点扛，地面铰点轴承约 25 kN）。保留斜导轨。
- 坐垫：分区（后硬 10 kPa/cm、前软 3 kPa/cm），前半程把力移到骨盆段，后半程移不过去（座板前倾受 15° 防滑上限限制）。高摩擦纹理面料。
- 稳定性：人在台上时手拉扶手是内力，翻不了；人站在地上扶横杆时台架只有自重约 45 kg，107 N 就会拉翻，所以台架必须和床固定（固定件按 ADA 1112 N × 1.5 设计，约 2.3 kN）。
- 传感与控制：座板下测力（法向力，用于速度规则和是否坐正）、横杆测力、握把开关、踏板测力；体重自检用底座四角测力。松手即停；带人下降需确认有人坐着；离座后座板停在放手处接人，人走开、踏板空了几秒后空载复位到与床齐平。
- 所有结果来自二维模型和静力计算，没有实物和实测；CAD、FEA、SolidWorks 运动动画还在做。
- 坐板设计的详细推导在一个单独的设计网页（13 节），slides 是汇报用的精简版。
