xiaweiyi0423/me5412-bedexit-proposal/presentation/audit/v3/gemini_A_argument.md

<!-- model: gemini-4-argon; finishReason: STOP; usage: {"promptTokenCount": 40501, "candidatesTokenCount": 3945, "totalTokenCount": 44446, "promptTokensDetails": [{"modality": "TEXT", "tokenCount": 17401}, {"modality": "IMAGE", "tokenCount": 23100}], "candidatesTokensDetails": [{"modality": "TEXT", "tokenCount": 3945}]} -->

作为懂坐→站（Sit-to-Stand, STS）生物力学和简化建模的审稿人，我首先肯定你们在第三轮修改中的诚实和进步：发现曲线坐板在省力上只比抬高床好 5–10% 后，果断放弃了原本虚高的省力主张，把核心价值转向**“低床脚踩实 + 起身防跌（接得住）”**。同时，上一轮关于底座称重、自动复位、电机反拖等工程硬伤在页面上基本已清理干净。

但是，当你们把整台复杂电动设备的存在理由压在**“81/81 全程接得住 vs 床只接得住 15%”**这根柱子上时，这条核心论证链在生物力学和几何逻辑上出现了几个非常致命的漏洞。以下是按重要性排序的审计意见：

---

### 1. 【高】“腿一软直着往下落”违背下肢运动学，导致“床只接得住 15%”成为一个稻草人对比
*   **位置**：第 7 页（slide 正文、底部小字、讲稿、问答）、第 16 页、第 18 页。
*   **原文证据**：第 7 页底部定义：“起身中任一时刻髋部直着往下落，臀部落点（髋后 4 cm）在座面前缘以内算接住”；正文：“站起来后臀部在床沿外约 25 cm，床接不住……抬高床 0.58 m：15%（0/81）”。
*   **为什么是问题**：
    *   **确定的物理/生物力学事实**：人从床沿站起来时，脚是踩在地上的，小腿通过踝关节与地面相连，大腿通过膝关节与小腿相连。当人站立或半蹲时“腿一软”（膝、髋伸肌失力），在重力作用下膝盖弯曲，大腿必然绕着膝关节向后下方旋转。除非双脚突然穿入地下，或者小腿骨瞬间缩短，否则**髋关节在几何上根本不可能“直着往下落”（即保持水平坐标 $x$ 不变）**。真实的“腿一软”（buckling）必然伴随着髋部和臀部显著向后移动（朝床的方向退回去）。
    *   **因果与误导**：你们用“髋部直着往下落”算出了床在起身后 85% 的阶段都接不住人，这是因为你们把人在站立位的髋部坐标直接竖直投影到了地面。但实际上，因为曲线坐板跟着大腿前移了 18.5 cm，它在“直着下落”的假设下占尽了便宜；而如果按真实的下肢连杆回折来算，人在半起立时腿一软，臀部本来就会往后坐回床沿，床能接住的比例会远高于 15%。更有甚者，如果人在较高位置腿软、臀部往后退，**已经前移并升高的刚性座板反而可能因为位置太靠前而顶在大腿后侧或把臀部往后弹向床与座板之间的缝隙**。在懂生物力学的评委面前，这个“100% vs 15%”的核心卖点会被瞬间证伪。
*   **怎么改**：
    1.  **改算法（最优，工作量小）**：你们已经有二维三连杆（小腿-大腿-躯干）模型了。不要让髋部“直着往下落”（$\Delta x = 0$），而是假设在当前姿态下膝关节屈曲、小腿略后退恢复到坐姿角度，算出此时髋部真实的回落轨迹，看臀部落在哪里。
    2.  **如果来不及重算，必须改表述（底线）**：把“腿一软往回坐”改成**“垂直瘫软极限测试（假设脚不承重、髋部纯竖直下坠）”**，并在第 7 页明确承认：“真实腿软屈膝时髋部会往后退，轨迹介于‘纯竖直下落’和‘往后倒’之间；即便往后退，升起的座板也比低矮的床面离臀部更近，能大幅减少自由落体冲击距离（见第 2 条）。”

### 2. 【高】把“落在座面前缘内 7.5 cm”等同于“接得住”，忽略了最高 15.7° 前倾斜面的滑落风险
*   **位置**：第 7 页（正文及问答）、第 10 页（右图）、第 15 页（滑落风险与右图）。
*   **原文证据**：第 7 页：“臀部落点还在座面前缘以内 7.5 cm……81/81 接得住”；第 10 页右图显示座面高度在 0.52–0.60 m（正是放手和易发头晕的区间）时，**座板前倾角高达 14°–15.7°**；第 15 页右图显示站立保持时座板前倾 13°，状态框写“坐垫接触 12 cm”。
*   **为什么是问题**：
    *   **确定的事实**：成年人的坐骨结节到臀部后缘加上大腿根部，要坐稳通常需要至少 12–15 cm 的水平支撑面。第 7 页说站起后落点在座面前缘以内“7.5 cm”，且定义臀部落点在髋后 4 cm——这意味着**髋关节中心实际上只落在座面前缘以内 3.5 cm 处**！
    *   **推论与力学后果**：一个头晕或腿软的老人，带着向下的动量，屁股边缘只搭住一块**向前倾斜 13°–15.7°** 的斜板前缘 7.5 cm（髋中心仅 3.5 cm）。在冲击瞬间，重力的切向分力加上大腿前侧完全悬空产生的顺时针翻转力矩，极易让人顺着这块 15° 的斜板直接滑铲到地上。第 15 页问答里用静摩擦 $\mu > \tan 16^\circ \approx 0.29$ 来辩解是不成立的，因为人体臀部软组织和宽松睡裤之间存在巨大的内部剪切滑移（internal shear），布料表面再防滑，人也会从裤子里往前出溜。把“边缘搭上 7.5 cm 的 15° 斜坡”定义为 100% 接得住，过于乐观。
*   **怎么改**：
    *   在讲稿和第 7 页、第 15 页中把话收回来：不要只说“落在前缘内 7.5 cm 就接住了”，要说明**“座板接住臀部 + 双手握住正前方横杆挡住前滑 + 脚在踏板上”三者共同构成防跌闭环**（即座板负责提供竖直支撑、吃掉下坠能量，前方的 L 形横杆负责提供水平阻挡防止人顺着 15° 斜面滑出去）。
    *   如果机构允许，建议探讨：当检测到人离座进入“站立保持”状态后，能否或是否需要让座板倾角略微回平（哪怕单自由度做不到，也应在局限页提一句“单自由度机构在离座高度仍有 13° 前倾，坐回时依赖高摩擦面料和前方横杆防滑”）。

### 3. 【中】“往后直挺挺倒”时，升起的刚性座板成了横在床沿前的台阶（60% 越过座板后缘）
*   **位置**：第 7 页（右下角正文及问答）、第 15 页。
*   **原文证据**：第 7 页：“往后直挺挺倒时床也接得住；坐板 40% 落在座板上、其余越过座板后缘落到床上，都不落地 → 后缘软包”。
*   **为什么是问题**：
    *   **确定的几何事实**：当座板升到放手位置（中位 0.56 m，最高 0.66 m）并前移约 15–18 cm 时，它比 0.42 m 的床面高出了 **14 到 24 cm**，而且座板底下是刚性的金属悬臂托架和测力单元。
    *   **因果后果**：你们算出来有 60% 的情况臀部会“越过座板后缘落到床上”，并把这个算作“0 落地”的安全结果。但在三维物理空间里，如果一个老人的屁股越过了高高翘起的座板后缘、掉进低 20 cm 的床面上，他的**大腿后侧、膝窝或尾骨/下背部必然会重重地砸在这块高出床面 20 cm 的座板后缘上**，或者身体被卡在座板后缘与床面形成的“台阶”上。这根本不是贴一条“后缘软包”就能化解的——原本没有这台机器时，人往后倒会平缓地倒在柔软的宽床垫上；有了这台机器，反而有 60% 的概率撞上一块悬在半空的硬板边缘。
*   **怎么改**：
    *   首先检查这“60% 越过座板后缘”是怎么算出来的：如果人在站立位双手还握着前方 x=70 cm 的横杆，手臂长度限制了他根本不可能像自由倒立摆一样绕脚踝直挺挺倒回床上。如果考虑手拉横杆，人往后倒时髋部是不会退那么远的。
    *   在汇报中不要主动夸大“绕脚踝直挺挺像木板一样往后倒（ankle inverted pendulum）”这种极端的生物力学模型——老年人在双脚踩地、双手扶杆时极少发生膝髋完全锁死的纯刚体后仰。重点讲：**因为双手握着前方的横杆，哪怕失稳也是屈膝下坐（落在座板上），而不会松手像木板一样越过座板砸向床面**。

### 4. 【中】努力度（Effort）对比中隐藏了“19/72 人更费力”的反例，且忽略了“挪动 10–20 cm + 侧身挤进 0.46 m”的体能代价
*   **位置**：第 6 页、第 7 页、第 11 页、第 17 页。
*   **原文证据**：
    *   背景材料说明：“比抬高床只省 5–10%，19/72 人略费力（差 ≤ 0.03）”，但第 7 页 slide 上只写了“省力：比低床省 32%；和抬高床相当（再省 5–10%）”，只字未提有 26% 的人反而更费力。
    *   第 7 页图注写：“低床 0.42 m + L 扶手：0.41；抬高床 0.58 m + **最佳扶手**：0.30；起身台：0.29”。
    *   第 6 页问答和第 17 页：用之前要先在防滑面料上往前挪 10–20 cm；回床要侧身走进 0.46 m 深的空间，助行器进不去，坐下后还要在防滑座板上往后挪回床。
*   **为什么是问题**：
    *   **口径不一致（事实）**：第 7 页讲稿说“同一个模型、同一副扶手”，但图上文字却写抬高床配的是“最佳扶手”，低床配的是“L 扶手”。如果扶手位置不同，这就不是严格的控制变量对比。
    *   **局部优化 vs 全程代价（生物力学逻辑）**：你们的模型只算了“离座那一瞬间”的下肢/手臂静力 effort（0.29 vs 0.30）。但是，抬高床（0.58 m + 扶手）是**零准备动作**的——老人转个身就能起，回来一屁股就能坐下。而用你们的起身台，一个虚弱、夜里迷糊、甚至要用助行器的老人，每次起床和回床要多付出三个高难度动作代价：① 在高摩擦系数（$\mu \ge 0.5$）的垫子上把屁股往前硬挪 10–20 cm；② 回床时把助行器丢在外面，单手扶杆侧身螃蟹步挤进 0.46 m 的窄缝；③ 降到床面后再从高摩擦垫子上往后硬挪回床垫。对于那 72 个本来就能坐稳 0.58 m 抬高床的用户（甚至其中 19 人用起身台还略费力），这些额外动作的体能消耗和跌倒风险，很容易抵消掉那“0.01 的 effort 优势”。
*   **怎么改**：
    *   **修正第 7 页图表文字**：把“抬高床 0.58 m + 最佳扶手”统一改成“同一 L 扶手”（以符合你们背景里说的同一扶手口径），并补上一句诚实的说明：“72 人中位 effort 从 0.30 降到 0.29（52 人更省力，19 人差值在 0.03 以内），另有 **9 位矮个子用户（1.50 m）在 0.58 m 床上双脚悬空踩不实**，必须用低床 + 起身台。”——**把那 9 个矮个子用户亮出来**，这才是抬高床绝对做不到、而你们能做到的硬核证据！
    *   **在防跌价值上换一个更站得住脚的物理量**：哪怕不看“落点在不在前缘内”，当人在离座瞬间（比如髋高 0.60 m）腿一软，抬高床的座面如果只有 0.42–0.58 m 且在身后，人下坠的距离长、冲击大；而起身台的座板是**贴着大腿一路跟上来的（距离臀部只有几厘米）**，人一旦卸力，座板速度立刻归零并原地托住，**把“自由落体下坠变成零距离静坐”**。这个能量/冲击上的优势，比争论水平方向那几厘米的落点要牢靠得多。

### 5. 【低】前几轮审计的遗留口误：第 17 页讲稿仍残留“往前挪二三十厘米”，第 20 页附录仍是“8 个场景”
*   **位置**：第 17 页讲稿备注、第 20 页表格。
*   **原文证据**：
    *   第 17 页 slide 文字已改为“挪上座板约 10–20 cm”，但**讲稿备注**里写的还是：“往前挪二三十厘米对老人是否可行，也还没有验证。”
    *   第 14 页正文和讲稿都已更新为“按坐板轨迹仿真 15 个场景”，第 14 页待补写的是“全部 14 个场景”，而第 20 页附录目录里写的还是“**8 个仿真场景**的逐个说明”。
*   **为什么是问题**：确定的文字前后矛盾，上台照念讲稿或老师看附录目录时会立刻发现版本没对齐。
*   **怎么改**：把第 17 页讲稿改为“往前挪十到二十厘米”；把第 14 页待补和第 20 页附录统一改为“15 个仿真场景”。

---

### 总体判断与最值得先做的一件事

**总体判断**：
这份材料在工程完整度、控制安全闭环和坦诚度上已经达到了很高的课程汇报水准，前两轮的硬伤基本肃清。现在的薄弱点集中在**第 7 页的核心生物力学论证**：用“髋部纯竖直下落（$\Delta x = 0$）”这个不合常理的几何假设，制造了“床只接得住 15%、坐板 100%”的悬殊对比，同时低估了臀部只搭住 15.7° 斜板前缘 7.5 cm 时的滑落风险。

**最值得先做的一件事**：
**立刻重写第 7 页关于“接得住”的力学解释（哪怕不重跑代码，也要改掉口径）**：不要再把宝全押在“髋部直着往下落时水平坐标差几厘米”上，而是强调**“垂直落差与冲击能量”**——在起身中途腿软时，固定床面远在臀部后下方，人会经历一段失控下坠；而曲线坐板全程贴着大腿根部同步上升，人一旦发软卸力，座板瞬间停住，**在几乎零落差的位置直接把人托住**，配合正前方的固定横杆阻挡前滑。同时把“9 位矮个子用户在 0.58 m 床上脚踩不实”直接写进第 7 页 slide 正文，这样你们相比“垫高床”的不可替代性就彻底立住了。
