xiaweiyi0423/me5412-bedexit-proposal/presentation/audit/v3/gemini_D_grading.md

<!-- model: gemini-4-argon; finishReason: STOP; usage: {"promptTokenCount": 40475, "candidatesTokenCount": 3659, "totalTokenCount": 44134, "promptTokensDetails": [{"modality": "TEXT", "tokenCount": 17375}, {"modality": "IMAGE", "tokenCount": 23100}], "candidatesTokensDetails": [{"modality": "TEXT", "tokenCount": 3659}]} -->

作为这门课的老师（评分人），对照我 10/26 给你们发的邮件要求和 11/3 的最终交付标准，我对你们改版（v5.5 曲线坐板）后的整套材料做了审阅。

先给一个正面的肯定：把“竖直升降”改成“斜导轨+连杆的单自由度曲线坐板”，并用 81 位虚拟用户的防滑和防跌（“腿一软接得住”）来论证这个改动，是一个非常漂亮、有说服力的工程迭代。我邮件里要的**稳定性分析、手握+力分布传感、状态机、自适应速度**，你们在逻辑上都对上了。

但是，如果这套材料按现在的样子翻译成英文在 11/3 交上来，以下几个地方会直接导致**扣分、被当场问住，或者让我觉得你们组内各改各的、没有通读统稿**。按严重程度排序如下：

---

### 1. 【严重度：高】硬性交付物缺失：没有真正的 CAD 模型、运动动画和结构校核（直接扣分项）
*   **在哪里**：第 8 页（机构）、第 9 页（运动演示）、第 10 页（驱动选型）、第 11 页（稳定性）、第 16 页（验证）、第 19 页（分工）。
*   **原文证据**：
    *   第 8 页小字：“三维图由二维模型的坐标画出……不是 CAD”。
    *   第 9 页红框：“待补：SolidWorks 运动算例动画”。
    *   第 10 页红框：“待补：按厂家样本选定滚珠丝杠、直线导轨和制动器型号”。
    *   第 16 页状态列：要求 4（FEA）和要求 5（真实质量复核）仍标为“进行中”。
    *   第 19 页左图：直接是一个灰色的占位框，写着`[图] 起身台侧视图，标出五个角色各自负责的部分`。
*   **为什么是问题（事实）**：我在 10/26 邮件第 4 条明确要求“**要展示 CAD 模型和运动动画**”。对于一个 5 人组、不做实物的机械/医疗机器人课程设计，Python/Matplotlib 画的方块图在 10/27 沟通时完全可以接受，但在 11/3 终稿中**不能算作完成了机械设计**。尤其你们现在是“单侧悬臂座板 + 659 N·m 偏载力矩 + 2282 N 床架锁紧力”，如果角色 3 和角色 4 拿不出真正的 SolidWorks 装配体（含滑块板、双导轨、悬臂托架、毛刷槽、床架夹具）和基本的 FEA 应力云图，你们在机构与结构这一大块（占 2/5 分工）会直接失分。
*   **怎么改**：11/3 前必须把第 8、9、19 页的占位图/示意动画全部替换成 SolidWorks 渲染图和 Motion 动画截图/视频，并把第 16 页的两个“进行中”变成带具体数字（最大应力、安全系数、CAD 质量质心）的“已完成”。

---

### 2. 【严重度：高】全英文交付 + 既是现场 PPT 又是最终报告：目前缺少“真附录”，且翻译排版工作量被低估
*   **在哪里**：整套幻灯片（第 1–20 页），尤其是第 20 页（附录目录）和所有图表内嵌文字。
*   **原文证据**：第 20 页目前只是一张“附录目录”表格，写着“有材料 / 待补”，后面并没有挂上真正的附录页；第 1、6、8、9、10、11、12、13、14、15 页的所有图片里的标签（如“座面高度”、“状态：已坐上”、“床尾一侧敞开”）全都是中文。
*   **为什么是问题（事实 + 推测）**：11/3 要求交一份**英文** slides，而且**这份 slides 同时当报告用**。我在邮件第 6 条说“主 slides 不要太多，细节可以放附录，附录不限页数”，前提是**附录页必须真的存在于你交上来的那份 PDF/PPT 文件里**！你们提到的“单独的 14 节设计网页”，如果不在提交的 slides 附录里，评分时我是看不到的（或不算正式提交物）。此外，把所有 Python 生成的图表重新改成英文标签、把第 13 页复杂的中文状态机流程图重画成英文且字号不爆框，非常花时间。
*   **怎么改**：
    1. 立刻把 Matplotlib/Python 画图脚本里的中文全部改成英文，重新导出图片。
    2. 把“14 节设计网页”里的核心推导、参数表、81 人仿真、15 个控制场景大图、完整风险表、FEA 图，全部排版成真正的英文 Appendix Slides（比如第 21 页到第 45 页），附在主 slides 后面一起提交。

---

### 3. 【严重度：中】“安全与控制逻辑”存在一处自相矛盾：人在台上到底能不能按“降”？
*   **在哪里**：第 4 页（设计要求）、第 16 页（验证）、第 18 页（结论） **VS** 第 11 页（讲稿指南问答）、第 13 页（状态机）、第 15 页（风险对策）。
*   **原文证据**：
    *   第 4 页要求 6：“**只有确认有人坐着才下降**”；第 16 页要求 6：“有人坐着才降”；第 18 页结论：“有人坐着才降”。
    *   第 13 页状态机右上角回床路径：“回床：按住‘降’，**空座板降到回床高度（默认 0.50 m）停住**，坐上去；再按住‘降’降到床面”。
    *   第 15 页讲稿指南：“**空座板只在按住‘降’时动**”。
*   **为什么是问题（事实）**：这是改版后留下的逻辑冲突。如果严格执行第 4 页的“只有确认有人坐着才下降”，那老人夜里上完厕所回来，面对升在 0.57 m 甚至 0.66 m 的空座板，他是**按不动“降”**的，根本坐不上去！你们在第 13 页状态机里其实已经想明白了（允许空座板按住“降”降到 0.50 m），但第 4、16、18 页的总结文字没有同步改过来。作为老师，我在看状态机和设计要求对照表时，一眼就会抓住这个漏洞问你们。
*   **怎么改**：把第 4、16、18 页的“只有确认有人坐着才下降”，统一改成：“**只有按住‘降’才下降（无自动下降）；空载下降先停在 0.50 m 接人，确认坐稳后才能继续降回床面**”。

---

### 4. 【严重度：中】上一轮修改未彻底落实，讲稿与 PPT 文字存在多处数字打架
你们在背景里说已经改掉了旧数字，但实际上**讲稿（备注）和附录目录里还残留着上一版的旧词**。如果上台照着讲稿念，听众看着屏幕上的字会觉得你们自己都没搞清楚数据：
1.  **“往前挪多远”没改干净**：
    *   **证据**：第 17 页（局限）slide 文字已经改成了“**挪上座板约 10–20 cm**”，但同一页的**讲稿（备注）**里赫然写着：“**往前挪二三十厘米对老人是否可行，也还没有验证**”。（背景里明确说“往前挪 25–30 cm 是旧数字”）。
    *   **怎么改**：删掉第 17 页讲稿里的“二三十厘米”，改成“十到二十厘米”。
2.  **控制仿真场景数量打架（15 个 vs 14 个 vs 8 个）**：
    *   **证据**：第 14 页正文和第 16 页正文都写“**仿真 15 个场景**”；但第 14 页的**讲稿指南·待补**写着“把全部 **14 个场景**的图放进附录”；到了第 20 页（附录目录）表格里又写着“**8 个仿真场景**的逐个说明”。
    *   **怎么改**：统一核对到底是几个场景（如果是 15 个，把第 14 页待补和第 20 页表格全部改成 15）。
3.  **第 18 页（结论）的讲稿还是旧逻辑**：
    *   **证据**：第 7 页讲稿指南明确说，比抬高床“再省 5–10%”已经不是核心卖点，核心卖点是“全程接得住（81/81 vs 0/81）”。结果到了第 18 页结论页，**讲稿（备注）**还在念：“和把床垫高到 0.58 米相比只多省 5% 到 10%……坐回去也接得住”，完全没提第 18 页 slide 上写的重点“起身全程腿一软都接得住（81/81，床只在刚起身时接得住）”。
    *   **怎么改**：重写第 18 页讲稿，严格贴合 slide 上的三块文字。

---

### 5. 【严重度：中】我（作为老师）在现场答辩最想追问、而你们目前回答还不够硬的 3 个工程问题
（这也是对你们第 21 页“想请老师确认的问题”的直接回应）：

1.  **关于稳定性（回应第 21 页问题 3）**：
    *   **问题**：第 11 页表格第一行“100 kg 猛坐座板后缘（1.5 倍体重），**离后边缘还有 4 cm**”。
    *   **为什么会被问**：4 cm 的稳定裕度在工程上非常窄！而且你们所谓的“1.5 倍体重”是静载放大系数。当合重心仅仅是水平力矩平衡算出来的“压在底面内 4 cm”时，一旦老人往后坐带一点水平向后的动量（冲量），或者床垫边缘高弹性把人往外顶，4 cm 很容易突破。虽然你们说“和床固定了”，但你们的固定件只算了“人站在地上拉横杆（向床外拉）”的拉力（2282 N），如果人猛坐后缘导致台架**向床内/后方倾翻**，或者固定件是软连接（比如第 11 页待补里写的“**绕床架的对拉带**”），带子只抗拉不抗压、还有弹性伸长，台架还是会晃动甚至磕碰床架。
    *   **怎么改**：明确固定件必须是**刚性夹具（床腿/床架刚性锁紧）**，不能用软质的“对拉带”；并在第 11 页说明锁紧床架后，倾翻力矩由床架共同承担，消除“只剩 4 cm”带来的不安全感。
2.  **关于传感自检（第 12、13 页）**：
    *   **问题**：“抬升中三处力（座板、踏板、横杆）之和 ≈ 体重，差超过 15% 持续 0.5 s 才锁定”。
    *   **为什么会被问**：第一，这个“体重”是哪来的？你们既然取消了底座称重，人刚坐上座板时脚还在地板上或腿搭在床垫上，系统在哪一刻、怎么测出准确的个人基准体重？第二，老人起身初期，小腿肚往往还贴靠在床垫边缘，或者一只手习惯性地撑了一下床垫——这随便就会分走 15%（比如 60 kg 的人分走 9 kg）的力，那机器岂不是天天报错进入“锁定”状态？
    *   **怎么改**：在讲稿或问答里明确“基准体重是在老人双脚踩上踏板、双手握杆、臀部离开床垫进入‘已坐上’稳态时的三处力之和（或预设个人参数）”；并说明为什么老人不会撑床（因为双手必须握住前方的横杆开关和测力区才能启动）。
3.  **关于个性化与自适应速度（回应第 21 页问题 1）**：
    *   **问题**：$v = k \times (F_{\text{limit}} - F_{\text{seat}})$。
    *   **我的评价**：这个导纳控制（Admittance Control）变体**完全符合**我邮件里说的 personalised and adaptive（参数可按人设 = personalised，速度随实时发力变 = adaptive）。但我在现场会问：**如果一个老人腿力真的不够（比如你们仿真里发力 0.24 的那个用户），他拼命发力，座板上的力 $F_{\text{seat}}$ 还是大于你们设的 $F_{\text{limit}}$（0.5~0.6 倍体重），按照公式 $v=0$，机器岂不是一动不动？**（注：你们背景里说“0.24 的用户站不起来，座板到顶后停住”，如果他连把座板力减到 0.5 以下都做不到，座板是怎么“到顶”的？）
    *   **怎么改**：核对第 14 页的控制公式和仿真逻辑——人在刚坐稳还没站起来时，座板承受约 70%~80% 的体重，如果 $F_{\text{limit}}$ 设在 0.5~0.6 倍体重，那么公式算出来一开始 $v$ 就是 0，老人必须先靠自己在低位硬撑卸掉 20%~30% 体重，机器才肯动！这违背了“低位最难发力、最需要机器帮一把”的初衷。请角色 5 检查代码里的真实阈值定义，把公式里的物理量在 slide 上写准确。

---

### 6. 【严重度：低】细节瑕疵
*   **第 3 页引用年份**：講稿指南待补里写着核对原文，注意看第 3 页截图里写的是 `Merryweather 等 2015`，确保英文终稿引用格式统一。
*   **时间控制**：计划时长加起来约 15.6 分钟，19 页主 slides 节奏很紧凑，千万不要在前面背景和方案比较（第 1–7 页目前占了 6.7 分钟，接近一半时间！）超时，导致后面我最关心的**机构 CAD 和控制状态机**没时间讲。建议压缩第 3、5 页的讲述时间。

---

### 总体判断与最值得先做的一件事

**总体判断**：
这是一份**概念迭代非常扎实、安全逻辑严密、直击痛点**的优秀课程设计草稿，对老师邮件的回应度达到了 85% 以上；但它目前还停留在“完美的二维数学模型和文字规则”阶段，距离 11/3 拿高分的终稿，差在**三维工程落地（CAD/FEA）**和**全英文报告级排版（含完整附录）**这两口气上。

**最值得先做的一件事**：
今天沟通完后，**角色 3 和角色 4 立刻停下文字润色，全力把 SolidWorks 三维装配体、运动动画和关键件 FEA 做出来**；同时**角色 5 核对第 14 页速度公式在起步阶段（座板受力 > 0.6 体重时）为什么能动起来**，并把所有 Python 图表一键重出为英文版。
