xiaweiyi0423/me5412-bedexit-proposal/presentation/audit/v3/gemini_E_delivery.md

<!-- model: gemini-4-argon; finishReason: STOP; usage: {"promptTokenCount": 40414, "candidatesTokenCount": 3564, "totalTokenCount": 43978, "promptTokensDetails": [{"modality": "TEXT", "tokenCount": 17314}, {"modality": "IMAGE", "tokenCount": 23100}], "candidatesTokensDetails": [{"modality": "TEXT", "tokenCount": 3564}]} -->

作为第一次听你们汇报的工科同学，先说一句公道话：你们前两轮改得很彻底，底座称重、自动下降、前倾角、速度仿真图这些大坑全都填上了，整个故事线（痛点 $\rightarrow$ 方案与防跌价值 $\rightarrow$ 机构与抗偏载 $\rightarrow$ 状态机与安全 $\rightarrow$ 验证闭环）非常清晰，视觉风格也很统一干净。

但从**现场听众的眼睛和耳朵**来看，材料里还有一些“一眼看不清”、“前后对不上”以及“一翻译成英文就会爆表”的隐患。按重要性从高到低排在下面：

---

### 1. 【严重度：高】设计要求与验证表编号“串台”，且核心卖点漏进了验证表
* **位置**：第 4 页（目标用户和设计要求） vs. 第 16 页（需求 $\rightarrow$ 验证 $\rightarrow$ 结果）。
* **原文证据**：
  * 第 4 页的设计要求第 4 条是：“**4. 抬升速度跟着人走，并能按人设定**”（讲稿里还特意强调：“后面每一部分都对应其中几条，最后我们会用一张表逐条检查”）。
  * 到了第 16 页检查表，第 4 条突然变成了：“**4. 机构放得下、推得动、撑得住**”。而原本的第 4 条（速度随人自适应、可按人设定）在验证表里彻底消失了（只剩第 2 条验证了推力上限）。
* **为什么是问题**：
  * **确定的事实**：前后两页的“第 4 条”根本不是同一件事。而且老师在 10/26 邮件第 3 点专门点名要求“抬升速度要能个性化、自适应”，你们在第 14 页花了大篇幅做，结果到了第 16 页总结验证成果时反而漏掉了。听众和老师对照看时会觉得你们的工程闭环（V-model）是硬凑的。
* **怎么改**：
  * 把第 4 页的第 4 条与第 16 页完全对齐。最简单的做法：在第 16 页把“速度随人走、可按人设定”合并进第 2 条（变成“2. 推力不超过半个体重，速度随人自适应且可按人设定”），或者把表格扩成 7 行，让第 4 页和第 16 页的编号 1–7 严丝合缝。

---

### 2. 【严重度：高】多张核心配图的标注字号极小，投影仪上后排完全无法阅读
* **位置**：第 8 页右上图、第 11 页右图（俯视图）、第 13 页状态机图、第 14 页右侧三张仿真曲线图、第 6/9/15 页动画框内右上角文字。
* **原文证据（看截图）**：
  * **第 8 页右上图**（竖直 vs 曲线对比）：小人头顶的红字/绿字、中间的灰字说明、底部的灰色小字，在 1080p 截图里已经糊成一团，投影出来绝对看不清。
  * **第 11 页俯视图**：橙色虚线旁边的“回床：按住‘降’……”、绿线旁边的文字、以及底座虚线框里的字，字号大概只有正文的 1/3。
  * **第 13 页状态机**：箭头上的触发条件（尤其是右下角“自检不过……”那一大段）字太碎太小。
  * **第 14 页仿真图**：双 Y 轴的坐标轴标签（特别是右侧浅棕色的“座板受力（×体重）”）、横轴数字和底部图例都很小。
* **为什么是问题**：
  * **确定的事实**：这些图里的字远小于幻灯片正文字号。
  * **必然结果**：现场汇报时，听众为了看清你图上写的字，会眯着眼睛找细节，直接停止听你讲课。而且你们 11/3 要交的英文版是**同时当报告用**的，老师批改时看不清图字会很扣分。
* **怎么改**：
  * **第 8 页右上图**：删掉图里所有长句子，只留大号的 `竖直：前滑 11.5 cm ❌` 和 `曲线：前滑 0.9 cm ✔`。
  * **第 11 页俯视图**：把长句说明（如回床步骤）移到图外或只留嘴上讲，图内只留大号粗体路标（如 `① 起身下台`、`② 回床路线`）。
  * **第 13 页状态机**：箭头上只写 2–4 个词的简写（如 `力之和误差 >15%`），详细条件放在讲稿或附录。
  * **第 14 页仿真图**：重新导出 matplotlib 图，把 `fontsize` 至少调大 1.5 倍，去掉三个子图重复的 Y 轴标签（只留最左边或标题说明）。

---

### 3. 【严重度：中】旧版本残留错误（“25–30 cm”、“14/8 个场景”）没删干净
* **位置**：第 8 页讲稿、第 11 页、第 14 页讲稿指南、第 17 页讲稿、第 20 页正文。
* **原文证据**：
  1. **挪动距离打架**：第 17 页 slide 上已经改成了“挪上座板约 **10–20 cm**”，但同一页的**讲稿备注**里还写着：“往前挪**二三十厘米**对老人是否可行，也还没有验证”（这是上一轮审计指出的旧数字，slide 改了但讲稿忘了改）。
  2. **仿真场景数量三个数打架**：第 14 页和第 16 页正文写的是“**15 个场景**”；第 14 页的讲稿指南待补写的是“把全部 **14 个场景**的图放进附录”；第 20 页（附录目录）表格第 6 行写的又是“**8 个仿真场景**的逐个说明”。
  3. **底座尺寸算术错误**：第 11 页底部小字写“底座 x **3–78 cm**”，$78 - 3 = 75\text{ cm}$；但同一页俯视图底部双向箭头标的是“台架沿床长占 **65 cm**”，讲稿里也念“65 厘米”。
  4. **四舍五入反向了**：第 8 页 slide 写“前移 **18.5 cm**”，讲稿却念“前移约 **18 厘米**”（第 11 页俯视图也标了“18 cm”），18.5 四舍五入应该是 19 cm 或直接念 18.5 cm。
* **为什么是问题**：
  * **确定的事实**：口头念的数字和屏幕上写的数字不一样，或者前后页数字矛盾。现场听众一旦发现你嘴上说“二三十厘米”、屏幕上写“10–20 cm”，注意力马上会被拉去算账，怀疑你们数据的严谨性。
* **怎么改**：
  * 全局搜索替换：把第 17 页讲稿改为“十到二十厘米”；把第 14 页指南和第 20 页附录目录统一改为“15 个仿真场景”；核对第 11 页底座到底是 `x 3–68 cm`（长 65 cm）还是长 75 cm；第 8 页讲稿直接念“18.5 厘米、27.4 厘米”。

---

### 4. 【严重度：中】第 7 页（方案比较）概念密度过高，听众在 1.3 分钟内反应不过来
* **位置**：第 7 页（四种起身方式比较）。
* **原文证据**：
  * 这一页同时抛出了两个完全不同的评价指标：① `effort`（0.41 vs 0.30 vs 0.29，基于 **72 人**）；② `腿一软往回坐时臀部还落在座面上的起身阶段占比`（14% vs 15% vs 62% vs 100%，还附带 `0/81`、`19/81`、`81/81` 另一套数字，基于 **81 人**）。右侧还加了“两手最多 1/4 体重”和“往后直挺挺倒 40% vs 60%”的补充说明。
* **为什么是问题**：
  * **确定的事实**：一页之内出现了两套分母（72 人 vs 81 人）、两种百分比（阶段占比 62% vs 人数占比 19/81）、两种摔倒模式（直着往下落 vs 直挺挺往后倒）。
  * **合理推测**：作为第一次听的同学，看到“0.29”和“100% (81/81)”放在同一张条形图样式的版面里，光理解“15% 是指前 15% 的路程接得住，而不是 15% 的人接得住”就要花掉半分钟，根本来不及听清后面关于直挺挺往后倒的解释。
* **怎么改**：
  * **做减法**：把指标 ② 的条形图标题简化成大白话，或者只保留最直观的**人数比例**（`全程接得住的人数：0/81 vs 0/81 vs 19/81 vs 81/81`），把“前 14% / 15% / 62% 阶段”放到讲稿或括号里。
  * 在页面底部注脚加半句话解释为什么上面是 72 人、下面是 81 人（`注：81 人中有 9 位矮个用户在 0.58 m 床上脚踩不实，故①仅比其余 72 人`），免得听众心里犯嘀咕。

---

### 5. 【严重度：中】转成英文加换人交接后，15 分钟的时长目标极可能会超时
* **位置**：全篇（第 2 页写“主 slides 19 页，约 16 分钟”，但各页计划时长加起来是 15.9 分钟）。
* **原文证据**：
  * 统计第 1 到 19 页的讲稿总字数，大约在 **3650 个汉字**左右。按你们设定的 230 字/分钟算，纯念稿不喘气就要 **15.8 分钟**。
  * 第 9 页（运动演示）还要现场播放并解说 SolidWorks 动画；5 个组员上台还要经历 4 次交接换人。
* **为什么是问题**：
  * **确定的事实**：3650 字的中文翻译成英文后，大约是 **2400–2700 个英文单词**。正常工科学生的英文汇报语速大约是 130–140 words/min，光念完这些内容就需要 **18–20 分钟**。加上动画播放和 5 人切换，现场必然超时被老师打断。
* **怎么改**：
  * 在 11/3 翻译成英文 slides 时，**讲稿必须砍掉 20%–25% 的字数**。比如第 8 页不必在台上详细解释“什么是 3 转动副 + 1 移动副”，指着图说“滑块走斜线、连杆拉住底面，两点定下轨迹”就够了；第 13 页讲稿后半段关于“自检 15% 持续 0.5 秒”的内容已经在第 12 页和第 15 页出现过三次，第 13 页可以完全不念。

---

### 6. 【严重度：低】翻译成英文后，表格页的排版会撑爆页面
* **位置**：第 5 页（现有方案）、第 15 页（风险和对策）、第 16 页（验证表）。
* **原文证据（看截图）**：
  * 这三页的中文表格目前行距适中，但每格都是完整的中文句子（例如第 15 页对策列有 35–45 个汉字/行）。
* **为什么是问题**：
  * **确定的事实**：同样的意思，英文字符长度通常是中文版面宽度的 **1.5 到 1.8 倍**。如果直接照译，第 15 页和第 16 页的表格要么字号缩到看不见，要么溢出页面底部。
* **怎么改**：
  * 转英文时改用电报式短语（Telegraphic style），用符号代替连词（例如把“机构全封闭，支架从毛刷竖槽伸出；座板侧缘到箱壁 3 cm”写成 `Enclosed box w/ brushed slot; 3 cm seat-to-wall clearance`）。

---

### 7. 【严重度：低】几处细节的视觉重复与占位符
* **位置**：第 1、6、9、15 页的配图；第 19 页的占位框。
* **原文证据**：
  * 第 1 页封面、第 6 页第 3 步、第 9 页动画、第 15 页右图，用的是**同一个二维火柴人模型**的截图（第 15 页右图甚至和第 6 页第 5 步一模一样）。
  * 第 19 页（分工与贡献）左图目前还是灰底文字占位框 `[图] 起身台侧视图……`。
* **为什么是问题**：
  * 同一张火柴人图反复出现 4 次，会让听众觉得视觉疲劳、素材不够。第 15 页讲的是夹手、滑落、断电、拉翻等 6 个风险，右边却占了近一半面积放了一张已经在第 6 页看过的“站立保持”图，浪费了宝贵的版面空间。
* **怎么改**：
  * 等 11/3 做出 CAD 后，把第 1 页封面和第 19 页分工图换成漂亮的 **CAD 渲染图**；第 15 页删掉右侧重复的火柴人图，把空间让给左边的风险表格（正好解决英文翻译后表格太挤的问题）。

---

### 总体判断与最值得先做的一件事

**总体判断**：
这是一份完成度很高、逻辑非常严密的课程设计汇报草稿。上两轮暴露的硬伤（力传感器冲突、自动复位危险、数据打架）已经全部修好，对于 10/27 的老师沟通（Consultation）来说完全够用，甚至超出预期。目前剩下的问题主要集中在**视觉可读性（图内字太小）**、**前后页细节核对（编号与残留旧数字）**以及**向最终英文版过渡时的篇幅控制**。

**最值得先做的一件事**：
在明天见老师之前，花 10 分钟**把第 4 页和第 16 页的“设计要求编号”对齐，并顺手改掉讲稿里残留的“二三十厘米”和“8/14 个场景”**；见完老师开始做最终英文版时，第一件事是**把第 8、11、13、14 页配图里的字号放大一倍并精简文字**。
