xiaweiyi0423/me5412-bedexit-proposal/presentation/audit/v2/gemini_C_real_use.md

<!-- model: gemini-4-argon; finishReason: STOP; usage: {"promptTokenCount": 37467, "candidatesTokenCount": 3128, "totalTokenCount": 40595, "promptTokensDetails": [{"modality": "TEXT", "tokenCount": 14367}, {"modality": "IMAGE", "tokenCount": 23100}], "candidatesTokensDetails": [{"modality": "TEXT", "tokenCount": 3128}]} -->

作为一名常年去老人家里做转移评估的作业治疗师（OT），我平时看设备不只看它升起来那几秒钟，而是看老人半夜迷迷糊糊醒来、掀被子、坐起、上设备、站立、迈步拿助行器、去厕所、再走回来躺下的**整条动线**。

你们在工程上很诚实（比如主动承认比垫高床只多省 5–10% 的力），这非常好。但如果把这台机器真搬进老人卧室，有几个在二维侧视图里看不见、但在真实三维生活里会直接导致老人用不了或摔倒的“卡点”。按严重程度排序如下：

---

### 1. 站起来之后怎么走出去？“L形扶手 + 助行器 + 踏板台阶”把人困在台上了
- **严重度：高**
- **位置：** 第 4 页（目标用户）、第 6 页（使用流程）、第 8 页（机构图）、第 11 页（底座尺寸）。
- **原文证据：**
  - 第 4 页目标用户写明：“能独立行走，或借助助行器行走”。
  - 第 6 页和第 8 页图：人正前方 x = 70 cm 处是水平横杆和立柱，床头侧是高 0.80 m 的封闭机构箱，脚下是一块有厚度的底座踏板（x 从 3 到 78 cm）。
- **为什么是问题：**
  - **确定的事实：** 你们的示意图全是二维侧视图（人在里面站起来就结束了）。但在三维空间里，老人站稳后（第 6 页第 5 步）：后方是刚升起来的座板，床头侧是机构箱，正前方是横杆和立柱。**他只能往床尾那一个方向侧着走出去。**
  - **临床事实与推测：** 如果这位老人需要用助行器（Walker），助行器放哪儿？只能放在床尾侧的地上。老人站在底座踏板上，必须先松开正前方的横杆，原地转身 90 度面向床尾，跨下底座踏板（哪怕只有 2–3 cm 高，对夜里刚起床的老人也是一个极易绊脚的台阶），再去抓助行器。在这个转身和下台阶的瞬间，如果他松开横杆去拿助行器，手边是有支撑空档的；更糟的是，第 13 页写“踏板空了 5 秒座板就自动下降复位”，如果老人用助行器走得慢，脚刚下踏板、屁股还没完全移开座板上方，座板就开始动了。
- **怎么改：**
  - 在第 6 页（使用流程）和第 17 页（局限）里，明确画出或说明**俯视动线**：老人怎么从设备上走下来、助行器停放在哪个位置、底座踏板边缘必须做斜坡过渡（bevelled edge）防绊倒。
  - 状态机（第 13 页）的“空载复位”延时从 5 秒延长到至少 15–30 秒，确保用助行器的老人已经彻底离开设备区域。

---

### 2. 第一步“从床沿再往前挪 25–30 cm”与“高摩擦面料”自相矛盾，且极易卡在缝隙里
- **严重度：高**
- **位置：** 第 6 页（第 1 步及问答）、第 15 页（风险对策）、第 16 页（验证表）、第 17 页（局限）。
- **原文证据：**
  - 第 6 页讲稿与问答：“坐在床沿，往前挪一点，坐上一块和床齐平的座板”、“问：往前挪 25–30 cm，老人做得到吗？答：这是目前最大的不确定。”
  - 第 15 页风险对策：“高摩擦面料（$\mu \ge 0.5$）”；第 16 页：“机构箱离床 2.1 cm”。
- **为什么是问题：**
  - **确定的事实：** 老人平时睡在床中间，半夜起来先翻身坐到床沿，这已经消耗了一半体力。你们要求他接着再往前平移 25–30 cm，把屁股从软床垫挪到硬座板上。同时，为了防滑，你们把座板做成了 $\mu \ge 0.5$ 的高摩擦纹理面料，而且为了够着 70 cm 外的横杆，手是往前拉的，没法撑在屁股两边把身体架起来挪。
  - **临床事实与推测：** 腿力弱、核心差的老人往前挪屁股（scooting），靠的是滑动。高摩擦面料会直接咬住他的睡裤，让他根本挪不动，或者睡裤被扯住、只有皮肤往前滑（产生剪切力，容易磨破老年人的脆弱皮肤）。另外，床垫边缘是很软的，人坐上去会塌陷 3–5 cm，这就导致所谓的“和床齐平（0.42 m）”在实际坐上去时，座板比塌陷的床垫高出一截，中间还有 2.1 cm 的缝，老人的屁股等于要“翻越”一个高摩擦的台阶才能坐上座板。
- **怎么改：**
  - 在第 6 页问答或第 17 页局限里，不要只说“老人做不做得来还不确定”，要直接指出这个工程矛盾：**挪上去需要低摩擦、升起来需要高摩擦**。可以提出一个改进方向（哪怕作为 Future Work）：比如座板表面用单向滑布（像临床移位滑布那样，往前滑顺畅、往后/往下止滑），或者说明座板初始高度需要比空载床垫略低 2–3 cm，以匹配人坐下后床垫的下陷量。

---

### 3. 回床躺下是个盲区：高 80 cm 的机构箱挡在床头侧，怎么躺回枕头上？
- **严重度：中**
- **位置：** 背景材料、第 6 页（使用流程）、第 8 页（机构）、第 13 页（状态机问答）。
- **原文证据：**
  - 第 6 页：“机构全部装在床头一侧的封闭箱里，床尾一侧敞开，回床时腿能转过去。”
  - 第 13 页问答：“问：人回来时座板在高处怎么坐？答：……座板自动降回和床齐平，回来时像坐普通椅子一样坐上去。”
  - 背景材料：“机构箱侧视约 2749 cm²、顶高 0.80 m”。
- **为什么是问题：**
  - **确定的事实：** 你们只解决了“怎么站起来”，对“上完厕所怎么回床睡觉”只字未提（只在问答里提了一句“像坐普通椅子一样坐上去”）。
  - **临床事实与推测：** 如果老人回来时坐在你们的座板上（离床沿还有二三十厘米远），他怎么回到床上？他必须往后退（retro-scooting）25–30 cm 才能退回床垫上——这对老人来说比往前挪更难，因为身后没有借力点，横杆在正前方只能往后推，但脚下是空的或踩在踏板上。
  - 如果他不坐座板，直接从床尾侧坐在床垫上，那么问题来了：床头一侧紧贴着你们这个深 75 cm、高 80 cm 的大铁箱子。老人只能坐在偏床尾的位置，把腿甩上床后，人离枕头还有大半米远，还得在床上费力地往床头蹭。
- **怎么改：**
  - 在第 6 页或附录里把“回床流程”补齐：明确老人从厕所回来是直接坐床尾侧的床沿（绕开座板），还是坐上座板再后退。如果是直接坐床沿，需要说明机构箱沿床长方向占了多少宽度（y 方向尺寸是 -27 到 +38 cm，总共 65 cm 宽），证明它装在床头柜位置后，剩下的床边足够老人直接坐上床并躺回枕头。

---

### 4. “底座四角测体重自检，对不上就锁住”在真实家庭环境里会天天误报锁死
- **严重度：中**
- **位置：** 第 12 页（传感与交互）、第 13 页（状态机）、第 15 页（风险对策）。
- **原文证据：**
  - 第 12 页：“5 底座四角测力：总重减去台架自重应约等于体重，对不上就锁住。”
  - 第 11 页：“台架必须和床固定（床腿夹或床垫下压板）。”
- **为什么是问题：**
  - **确定的事实：** 这是一个典型的实验室理想假设。你们既要求台架与床**刚性固定**（承受 2282 N 拉力，第 11 页），又要求底座四角测力单元精确测出“台架自重 + 人体重”（第 12 页）。在力学上，一旦台架和床固定连接（尤其是用床垫下压板或夹紧床腿），床架就会分担很大一部分竖直载荷（静不定结构），底座四角根本测不出真实体重！
  - **临床事实与推测：** 就算改成不传递竖直力的固定方式，在真实家里：老人的被子垂下来搭在台架上、老人坐着时一条腿还搭在床沿没完全放上踏板、或者一只手撑在床垫上、冬天多穿了厚棉袄、甚至家里铺了地毯，都会让四角测出来的重量和预设体重差出好几公斤。如果“对不上就锁住”（进入 LOCKED 状态），老人半夜三点被锁在半空中或者抬不起来，这设备第二天就会被家属扔掉。
- **怎么改：**
  - 马上修改第 12、13、15 页关于“底座四角测体重”的说法！老师要是看穿了“和床固定后没法测准总重”这一点，现场就会被问住。
  - 改为：四角测力只用来做**粗略的在位/离位检测和防倾翻监测**（比如确认四角都有正压力、没有一侧翘起），或者把传感器自检改为“空载时各传感器零点漂移自检（tare check）”，不要去跟老人的精确体重做比对。

---

### 5. 夜里摸黑找开关、单侧悬臂对偏瘫患者的不对称限制
- **严重度：低**
- **位置：** 第 4 页（问答）、第 6 页、第 10 页（应急下降）。
- **原文证据：**
  - 第 4 页问答：“问：偏瘫的人能用吗？答：开关一只手就能用……所以不排除。”
  - 第 8 页：“机构全装在床头一侧的封闭箱里，床尾一侧敞开。”
  - 第 10 页：“应急下降：拉握把旁的拨杆，制动松开……松手即停。”
- **为什么是问题：**
  - **确定的事实：** 机构箱固定在床头侧、扶手立柱也在床头侧，这意味着这台机器是**分左右手版本（Left-side / Right-side of bed）**的。如果老人睡在床的右侧，机构箱在他的左手边；如果他是左侧偏瘫，好手在右边（床尾侧），他用右手死死拽住悬空的横杆末端时，会对单侧立柱产生巨大的扭矩；而且回床转腿的方向也是固定的。
  - **推测：** 夜里断电或机器卡死时，老人本来就慌，可能还头晕，让他一边站不稳、一边去摸握把旁边的机械拉索拨杆并一直拉住（10 cm/s 其实挺快的，3 秒就到底了，老人在黑暗中下坠会吓一跳），操作负担太重。
- **怎么改：**
  - 在第 4 页问答里对偏瘫患者说得严谨一点：“轻度偏瘫可用，但需根据健侧手和床位方向选择左/右镜像安装版本。”
  - 第 10 页应急下降：既然已经有备用电池（背景材料提到了“另有电池慢降”），优先用电池按原开关慢降；机械拨杆改成护理人员/家属在侧面操作的应急释放，不要让惊慌的老人在上头自己拉闸下坠。

---

### 总体判断与最值得先做的一件事

**总体判断：**
这份材料在机械结构计算和坦诚对比上做得非常扎实，故事线也很清晰。但你们太沉浸在“二维侧视图里的起身那几秒”，忽略了老人在真实卧室里的**前后衔接动线**（怎么挪上去、站起来怎么绕开扶手走出去、怎么躺回床上）以及**真实家庭环境对传感器的干扰**。这些问题一旦被有临床或人因背景的评委追问，很容易暴露出“纸上谈兵”。

**最值得先做的一件事：**
**先把第 12–15 页里“底座四角测体重自检”的逻辑改掉，并在第 6 页（或附录）加一张简单的俯视图，画清楚“床—起身台—助行器—人走出去和回床的路线”。** 改掉体重自检能救你们免于一个致命的力学矛盾（与床固定后测不准体重 + 家居干扰误锁机）；加上俯视动线图则能直接证明你们真正想清楚了老人在夜里是怎么用这台机器的。
