xiaweiyi0423/me5412-bedexit-proposal/presentation/audit/v2/gemini_D_grading.md

<!-- model: gemini-4-argon; finishReason: STOP; usage: {"promptTokenCount": 37513, "candidatesTokenCount": 3692, "totalTokenCount": 41205, "promptTokensDetails": [{"modality": "TEXT", "tokenCount": 14413}, {"modality": "IMAGE", "tokenCount": 23100}], "candidatesTokensDetails": [{"modality": "TEXT", "tokenCount": 3692}]} -->

作为这门课的老师，手边拿着我 10/26 给你们发的邮件要求，看着你们 10/27 改完“曲线坐板”后的这份草稿，我先给一个定心丸：**你们把竖直升降改成单自由度曲线坐板（斜导轨 + 倾角连杆）的决定非常正确，工程直觉很好；在第 7 页坦承“比抬高床只多省 5–10%”也是我非常赞赏的学术诚实。**

但是，距离 11/3 交英文终稿只剩一周，这份材料里目前有几个**严重的交付缺口**和**改方案后没擦干净的旧数据**。如果不解决，现场展示时会被我直接追问甚至扣分。下面按重要性排序列出。

---

### 1. 【严重度：高】硬性交付物（CAD 与运动动画）完全缺失，且在主 slides 里没有留对位置

* **在哪里**：第 8 页（机构）、第 9 页（运动演示）、第 19 页（分工）、第 20 页（附录目录）。
* **原文证据**：
  * 我在 10/26 邮件第 4 条明确要求：“**要展示 CAD 模型和运动动画**”。
  * 目前第 6、8、9 页全是 Python 二维火柴人示意图；第 9 页写着“待补 SolidWorks 运动算例动画”；第 19 页是一个灰色占位框`[图] 起身台侧视图`；第 11、16、20 页标着 FEA 和真实质量复核“待补”。
* **为什么是问题（直接扣分项）**：
  * **确定事实**：现在没有任何三维 CAD 截图。不仅没做完，更糟的是**主 slides 的版面规划里根本没有给“三维 CAD 结构展示”留位置**——第 8 页放的是二维运动学对比，第 9 页放的是动画。
  * **因果推导**：你们采用了“床头单侧悬臂 + 双导轨四滑块（抗 659 N·m 偏载力矩）+ 滚珠丝杠 + 失电制动 + 握把拉索 + 床体固定件”的复杂机械结构。如果 11/3 终稿里我只看到二维火柴人，看不到双导轨怎么布置在同一块侧板上、悬臂支架长什么样、怎么和床固定，机械设计部分会直接大额失分。
* **怎么改**：
  1. **主 slides 第 8 页或拆出一页**：必须放一张清晰的 **SolidWorks 三维 CAD 轴测图 + 机构箱内部爆炸图/剖视图**，标出双导轨、四个滑块、倾角连杆、滚珠丝杠、电磁制动器和床体固定夹具。
  2. **第 9 页**：换成 SolidWorks 运动动画（GIF 或视频），保留二维火柴人接触压强图在旁边做对照。
  3. **第 19 页**：用渲染好的完整 CAD 侧视图替换那个灰色占位框。

---

### 2. 【严重度：高】改用“曲线坐板”后，角色 5 的控制器仿真还停留在旧版“0.66 m 竖直升降”数据，前后打架

* **在哪里**：第 14 页（速度随人自适应）右侧仿真图，对比第 4、5、8、10 页。
* **原文证据**：
  * 第 4、5、10 页都已更新为新方案：座板最高升到 **0.69 m**（0.42 m + 上升 0.274 m）。
  * 但第 14 页右侧的 8 宫格仿真图里，第 4 个子图标题赫然写着：**`Weak user (cannot stand even at 0.66 m)`**（腿力太弱，升到 0.66 m 也站不起来），且曲线平顶高度确实停在 **0.66 m**。
  * 同时，第 12 页讲稿强调：“座板会前倾，座板下的单向测力单元只测垂直于座面的力”，但第 14 页速度公式写的是 `v = k × (推力上限 - 座板测到的力)`，图例写的是 `force cap 0.5 BW`。
* **为什么是问题（会被当场问住）**：
  * **确定事实**：角色 2/3 把方案改成了最高 0.69 m 的斜升前倾座板，但角色 5 的控制仿真图没有跟着重跑，直接把旧版（竖直升到 0.66 m）的图贴上来了。
  * **因果推导**：作为评分老师，我一眼看到 0.66 m 就会知道你们组内数据没对齐。接着我会追问：**“你们第 12 页刚说座板前倾最高 15.7°，法向力不等于竖直力；那第 14 页仿真里的 `seat load` 到底是法向力还是竖直力？座板一边升一边倾斜，这个力是怎么耦合进仿真的？”** 如果答不出，说明控制仿真和机构模型是脱节的。
* **怎么改**：
  1. 角色 5 必须按新的最高高度 **0.69 m** 和新的座板倾角曲线重跑这 8 个场景，改掉子图标题里的 `0.66 m`。
  2. 在第 14 页统一明确：公式里的“座板测到的力”就是座板测力单元测得的**法向推力 $F_n$**（这在物理上很合理，因为传感器就装在座板下测法向力，不需要换算成竖直力），把口径圆回来。
  3. 顺手解决第 14 页讲稿指南里提到的“图里英文字太小”的问题，重画时直接放大字号。

---

### 3. 【严重度：中】“前倾角上限”在多页之间数字打架（15° vs 15.7° vs 16°），且讲稿和画面不一致

* **在哪里**：第 7、8、10、15 页的文字、配图与讲稿指南。
* **原文证据**：
  * 第 8 页配图左上角写：`前倾 ≤ 15.7°`；右下角正文写：`前倾 ≤ 16°`。
  * 第 10 页右图绿带标注：`机构综合时的上限 16°`。
  * 第 15 页正文写：`放手时座板前倾不超过 16°`；但**同一页的讲稿指南**却写：`前倾 ≤ 15°`、“问：座板前倾 15°，坐回时会不会滑下来？答：tan 15° ≈ 0.27”。
* **为什么是问题**：
  * **确定事实**：初始防滑设计要求可能是 15°，后来机构综合（单自由度连杆逼近）做出来实际峰值是 15.7°，于是正文放宽写成了 16°，但讲稿指南和问答没改过来。
  * **因果推导**：这种一页写 15°、一页写 16° 的细节瑕疵，会削弱你们在工程严谨性上的得分。而且第 15 页说“**放手时**座板前倾不超过 16°”也不准确——从第 6 页图 5 和第 15 页右图看，1.60 m 用户放手站稳时（高 0.61 m）前倾是 **13°**，15.7° 是**全行程的最大值**（出现在高 0.56 m 处）。
* **怎么改**：
  * 全文统一口径：**“全程最大前倾角 15.7°（设计上限 16°）”**。把第 15 页正文改成“全程座板前倾不超过 16°”，并把讲稿指南里的 15° 全部同步更新。

---

### 4. 【严重度：中】几处版面与编译低级错误，直接影响汇报观感

* **在哪里**：第 7 页、第 8 页、第 13 页、第 20 页。
* **原文证据**：
  1. **第 7 页底部灰字 & 第 8 页第 4 条**：残留了内部沟通文字——`旧版此页的 13–20% 来自竖直升到 0.66 m 的旧模型，已作废`、`（坐板网页第 13 节）`。
  2. **第 8 页右图**：小字密密麻麻，字号极小，现场投影在教室后排绝对看不清。
  3. **第 13 页状态机图**：从 `any state` 指向 `LOCKED` 的虚线箭头上，两行英文字 **`sensor sum != BW` 和 `(only slow DOWN allowed)` 叠印在了虚线上**，且整张图字号偏小。
  4. **第 20 页附录目录**：最后五行**连续重复了五遍完全一样的文字** `单自由度坐板设计（81 人、机构、坐垫、干涉、两轮审计） 角色 2、3 有材料`。
* **为什么是问题**：
  * **确定事实**：这些都是草稿合成时的失误。10/27 跟我 consultation 时看到“旧版已作废”没问题，但如果留在 11/3 的英文终稿里（Remember：终稿同时充当你们的书面最终报告！），会显得非常粗糙。
* **怎么改**：
  * 11/3 终稿删掉所有“旧版作废”、“坐板网页第 X 节”的内部备注；修复第 13 页状态机图的文字重叠并放大节点；放大第 8 页右图的标注；把第 20 页重复的 5 行拆成具体的 5 页附录标题（如：附录 8 81人姿态与防滑包络、附录 9 机构尺度综合、附录 10 分区坐垫模型、附录 11 悬臂偏载与四连杆对比）。

---

### 5. 【严重度：低】全英文终稿的语言转换与时长控制风险

* **在哪里**：整套幻灯片（尤其是第 1、6、8、9、12、15 页的生成图片，以及讲稿时长）。
* **原文证据**：
  * 交付要求：11/3 交**英文** slides 并现场展示。
  * 目前第 1、6、8、9、10、12、15 页里的配图内嵌了大量中文标注（如“状态：抬升”、“座面 0.46 m”、“床”、“倾角连杆”、“丝杠推力”）。
  * 第 2 页写“约 16 分钟”，但把各页计划时长加起来是 **16.9 分钟**（已经超过你们自定的 15 分钟目标）。
* **为什么是问题**：
  * 正文翻译成英文很容易，但**代码生成的图片和动图里的中文图例**经常被遗忘，或者最后关头来不及重新生成。另外，非母语同学讲英文通常比中文慢 15–20%，中文 17 分钟的稿子换成英文很容易讲到 20 分钟被我打断。
* **怎么改**：
  * 今天开始，所有代码出图（Python/MATLAB）和 CAD 标注一律直接改用英文生成；把主 slides 控制在 15–16 页以内（比如第 19 页分工可以和第 1 页封面合并，或者放进附录前最后一页不单讲），把演讲时长压回 13–14 分钟。

---

### 作为评分老师，先直接回答你们第 21 页的 4 个问题，并追问 2 个问题

**对你们第 21 页四个问题的回复（10/27 Consultation 意见）：**
1. **关于速度规则（问题 1）**：`v = k × (F_cap - F_seat)` 结合个人可调的 `F_cap` 和 `v_max`，**完全符合**我邮件里要求的 "personalised and adaptive"。这个设计很简洁，把推力限制和自适应调速合二为一了，保持即可。
2. **关于曲线坐板方向（问题 2）**：**完全认可**。用 81 人模型证明竖直升降只有 19/81 合格、单自由度斜导轨能做到 81/81，这是很有说服力的工程迭代。深度做到选型计算 + 尺寸估算 + CAD 模型与运动动画，工作量完全够了。
3. **关于稳定性分析（问题 3）**：用准静态合重心、倾翻力矩 + 床体固定件（1.5 倍安全系数）做分析**够了**。但必须补上一点：**和床怎么固定（床腿夹还是床底压板）必须在 CAD 里画出来**，不能只停留在“2282 N”这个数字上。
4. **关于待补项优先级（问题 4）**：最优先补 **CAD 三维装配图 + 运动动画**（我邮件点名要的），其次是**关键受力件（悬臂支架/固定件）的基础 FEA**。

**11/3 现场汇报时，我最想追问你们的两个问题（请提前准备到附录里）：**
1. **“往前挪 25–30 cm 的可用性悖论”**：你们在局限页承认老人需要从床沿再往前挪 25–30 cm 才能坐上座板。但看着第 6 页的图，座板是塞在大腿下面的——**为什么人坐在床沿时，不能直接坐在座板上，非要往前挪 25–30 cm？是因为机构箱（宽 2749 cm²）挡住了，还是因为踏板和横杆太靠前？** 这一点在三维空间里到底是怎么摆放的，请用 CAD 俯视图/侧视图向我解释清楚。
2. **“比抬高床只省 5–10%，凭什么这么贵？”**：你们很诚实地算出来比 0.58 m 抬高床只多省 5–10% 的力。如果评委问：“既然省力差不多，那给矮个子老人买一张 0.42 m 的床 + 旁边装一个普通固定 L 形扶手，他是不是也能防滑、坐回接得住？” **注意：你们第 7 页只比了“低床+扶手”的省力（省 32%），第 8 页只比了“竖直升降 vs 曲线座板”的防滑（19/81 vs 81/81）**。要把这两句话串成闭环：**低床不滑但站不起来（差 32%），高床省力但矮个子脚悬空（9/81）且起身初段没托举，竖直升降会前滑坐空（62/81），只有曲线起身台能同时满足这三点。**

---

### 总体判断与最值得先做的一件事

* **总体判断**：这是一份**分析深度扎实、逻辑闭环、态度诚实**的高分苗子作品（在概念建模、81 人包络分析、状态机与速度律结合上做得比多数小组都深），但目前处于**“计算很丰富、三维工程落地（CAD/动画）是空白”**的半成品状态，且留有方案切换后的版本残留。
* **最值得先做的一件事**：**立刻集中火力由角色 3 和角色 4 把 SolidWorks 三维 CAD 装配体（含双导轨悬臂箱、L 扶手、床固定件）和运动动画做出来**，放进主 slides 第 8–9 页，同时让角色 5 把第 14 页的仿真高度从 0.66 m 更新到 0.69 m。这两件事做完，你们的终稿就稳了。
