xiaweiyi0423/me5412-bedexit-proposal/presentation/audit/v2/gemini_E_delivery.md

<!-- model: gemini-4-argon; finishReason: STOP; usage: {"promptTokenCount": 37467, "candidatesTokenCount": 2947, "totalTokenCount": 40414, "promptTokensDetails": [{"modality": "TEXT", "tokenCount": 14367}, {"modality": "IMAGE", "tokenCount": 23100}], "candidatesTokensDetails": [{"modality": "TEXT", "tokenCount": 2947}]} -->

作为第一次听你们汇报的同班工科研究生，同时也从版面和观众接收信息的角度，我帮你们挑出了最影响现场效果、最容易让听众（和老师）皱眉或走神的问题。按重要性从高到低排列如下：

### 1. 【严重度：高】全程只有 2D 纸片人侧视图，听众根本想象不出“单侧悬臂、床头封闭、床尾敞开”的三维空间关系
*   **位置**：第 1、6、8、9、12、15 页配图及讲稿。
*   **证据**：第 6 页写“台架靠在床的长边……机构全部装在床头一侧的封闭箱里，床尾一侧敞开，回床时腿能转过去”；第 8 页讲“偏载悬臂”；第 11 页写“底座 x 3–78 cm、y -27 … +38 cm”。但**整套 slides 里所有的图都是完全一样的 2D 侧视图**（X-Z 平面）。
*   **为什么是问题**：
    *   **确定事实**：在 2D 侧视图里，“床头一侧”和“床尾一侧”是完全重叠的，座板看起来就是由底下的杆子正正地撑着，根本看不出它是“悬臂”挂在侧面的箱子上，也看不出床的长边在哪、人回床时腿怎么“转过去”。
    *   **推测因果**：听众在听第 6、8、10、11 页时，脑子里一直在费力做三维空间重构。你讲“偏载 659 N·m”、“y 方向 -27 到 +38 cm”时，听众因为没有建立起三维概念，会直接放弃理解这一段，导致你们在结构抗偏载和稳定性上的硬核工作白费。
*   **怎么改**：在还没有完整 SolidWorks CAD 之前（比如 10/27 见老师时），**必须在第 6 页或第 8 页放一张简单的三维轴测草图或俯视图（Top View）**，哪怕是用 PPT 方块拼出来的或者手绘扫描的都行，标出：床、床头、床尾、机构箱、悬臂座板、L 形扶手和人转腿的方向。11/3 正式版直接换上带床的 CAD 轴测渲染图。

### 2. 【严重度：高】关键图表字号极小，在教室投影上等于“盲图”
*   **位置**：第 6、8、13、14 页的截图。
*   **证据**：
    *   第 13 页（状态机）：整张状态机图里充满了 8–10 pt 的英文条件（如 `grip switch + hand on bar + feet on plate + COP ok`），在页面上只占中间窄窄一条。
    *   第 14 页（速度自适应）：右侧一张图塞了 8 个子图（2×4 矩阵），坐标轴、标题（如 `Weak user (cannot stand even at 0.66 m)`）和底部图例小如蚊子腿（讲稿指南自己也承认了这一点）。
    *   第 6 页（五步连环画）和第 8 页右图：小图里的状态框文字和“前滑 +11.5 cm”等说明文字极小。
*   **为什么是问题**：
    *   **确定事实**：普通教室投影下，坐第三排以后的听众（包括打分的老师）绝对看不清这些字。
    *   **推测因果**：听众看不清但又想看清时，会眯着眼睛找字，从而完全漏听演讲者嘴里在讲什么。老师在邮件里特别强调“把状态机控制器讲清楚”，如果状态机图看不清，这一核心得分点会大打折扣。
*   **怎么改**：
    *   **第 13 页**：用 PPT 原生形状重画状态机！只画 8 个大色块写大号状态名，箭头上只写最简短的 2–4 个词（如“松手/故障”、“握紧+踩实”），把完整代码生成图放进附录。
    *   **第 14 页**：主页只放 **2 到 3 个最典型的场景**（比如：1. 正常起身、2. 半路头晕往回坐、3. 断电），上下叠放并把字号拉大三倍；完整的 8 场景大图放附录（第 20 页本来就有这一项）。
    *   **第 6、8 页**：删掉第 6 页五张小图内部自带的“状态：已坐上……”微缩文本框；把第 8 页右图里的对比数字拎出来，做成图上方的大号标签。

### 3. 【严重度：中高】把上一版汇报的“历史包袱”写进正文和讲稿，严重干扰初次听众
*   **位置**：第 7 页（方案比较）、第 8 页（机构）、第 16 页（验证表）。
*   **证据**：
    *   第 7 页底部小字：“旧版此页的 13–20% 来自竖直升到 0.66 m 的旧模型，已作废”，且**讲稿里特意念了一遍**：“我们之前的版本写比抬高床省 13 到 20%，那是竖直升降旧模型的数字，这次按同一口径重算后不成立，我们改掉了。”
    *   第 8 页右底小字：“（坐板网页第 13 节）”。
    *   第 16 页表格编号：“1”、“1′”（讲稿念作“新增的一行是……”）。
*   **为什么是问题**：
    *   **确定事实**：这些内容是写给“看过你们旧版草稿或内部网页的人”看的，而不是给 11/3 现场听众看的。
    *   **推测因果**：第一次听汇报的同学和助教根本不知道什么“旧版 13–20%”或“坐板网页第 13 节”。你在台上专门花 15 秒解释“我们上一版算错了，这一版改了”，不仅浪费宝贵的汇报时间，还会让听众一头雾水，甚至觉得你们现在的模型是不是也随时会作废。
*   **怎么改**：
    *   10/27 和老师沟通时口头提一句即可；**在正式 slide 正文和讲稿里，彻底删掉关于“旧版已作废”、“网页第 13 节”、“新增一行 1′”的所有表述**。
    *   第 16 页直接按 1 到 7 正常编号（或把 1 和 1′ 合并成一条需求的两项指标）。

### 4. 【严重度：中】前后核心数字打架，容易在 Q&A 被一眼抓包
*   **位置**：第 4、7、8、10、15 页。
*   **证据**：
    *   **最高高度**：第 4 页要求“升到约 0.69 m”，第 10 页横轴到 0.69 m；但第 7 页讲稿说“多数人在座板前倾最大（约 15°）时就离开坐垫，那时髋只比坐在 0.58 m 床上高约 4 cm；导轨上段没用来托人”，第 6 页和第 15 页图里“站立保持”状态写的却是“座面 0.61 m”。
    *   **前倾角上限**：第 7 页写“约 15°”，第 8 页左图写“≤ 15.7°”、正文写“≤ 16°”，第 15 页 slide 写“不超过 16°”，但第 15 页的讲稿指南却写“前倾 ≤ 15°”。
    *   **载荷体重**：第 4 页写“设计工况 60 kg”，第 10、11 页算丝杠和倾翻全部用“100 kg（1.5 倍体重）”。
*   **为什么是问题**：
    *   **确定事实**：同一份材料里对同一个物理量出现了两三个不同数字。
    *   **推测因果**：工科听众对数字很敏感。看到前倾角一会儿 15°、一会儿 16°，高度一会儿 0.69 m、一会儿 0.61 m 就不用了，会怀疑你们 5 个组员各自改了参数没对齐。
*   **怎么改**：全组统一口径。前倾角统一写成“≤ 16°（峰值 15.7°）”；第 4 页把“设计工况 60 kg”改成“生物力学基准 60 kg / 1.60 m；结构与安全校核按 100 kg 重载用户”；在第 8 页或第 10 页明确补半句话解释：“导轨总行程可升至 0.69 m（照顾高个子），1.60 m 典型用户在 0.61 m 即可离座”。

### 5. 【严重度：中】11/3 最终交付是英文版，目前中文极为紧凑的排版在转英文后会全面爆版，且语速时长过于理想化
*   **位置**：全局（特别是第 2、5、15、16 页表格，以及讲稿时长）。
*   **证据**：
    *   背景说明：“11/3 交一份**英文** slides（同时当报告用）并现场展示……讲稿按约 230 字/分钟写；课堂汇报时长约 15 分钟”。
    *   第 2 页写“约 16 分钟”，但各页计划时长加起来是 15.9 分钟（且第 3 页在 10/27 之后还要转成英文讲）。
    *   **附带明显笔误**：第 3 页大标题截图里，“三件事**叠**在一起”的“叠”字渲染成了错字/重叠字（看着像“蠢”或乱码）；第 20 页附录目录最后五行把“单自由度坐板设计……”一模一样复制粘贴了 5 遍。
*   **为什么是问题**：
    *   **确定事实**：中文一分钟念 230 字是新闻联播级别的紧凑语速，如果中间有 5 个人交接话筒、播放第 9 页动画、翻页停顿，16 分钟的稿子现场绝对会讲到 18–20 分钟。而且一旦翻译成英文，同等信息量的英文字符长度通常比中文长 30%–50%，英语非母语口头汇报的速度也会比中文慢。
    *   **推测因果**：如果等 10/27 见完老师才开始翻译英文，第 5、15、16 页的密集表格字号会被迫缩得更小，且 15 分钟内根本讲不完。
*   **怎么改**：
    *   立刻修掉第 3 页标题的乱码字和第 20 页重复 5 次的表格行。
    *   既然英文 slides 要“同时当报告用”，主页上的文字必须比现在再精简 30%（用短词组代替完整句子），把省出来的空间留给英文排版。
    *   把总计划讲稿时长压缩到 **12–13 分钟**（留出 2–3 分钟给 5 人换人、播动画和英文降速缓冲）。例如第 17 页（局限）和第 18 页（结论）可以合并，第 19 页（分工）贴在封面或结论页角落即可，不用单独讲一页。

---

### 总体判断与最值得先做的一件事

**总体判断**：
这份汇报的**逻辑骨架和工程诚实度非常出色**——特别是敢于承认“比抬高床只省 5–10%，核心价值在于不前滑和坐得稳”，而且每一页标题都是直给结论（Action Titles），比大多数研究生汇报都好懂。但它目前的短板在于**“视觉传达配不上工程深度”**：全篇缺乏 3D 空间表达，控制和仿真的核心图表字小到无法阅读，且带有太多内部迭代的痕迹。

**最值得先做的一件事**：
在 10/27 见老师前，**立刻画一张简单的三维示意图放到第 6 页（把台架、床头箱子、悬臂座板、床的相对位置画出来），并把第 13 页（状态机）和第 14 页（速度仿真）的图重画放大**。这三张图一改，老师和听众能在 5 秒内看懂你们的机构空间布局和控制核心，汇报效果会立竿见影地提升一个档次。
