xiaweiyi0423/me5412-bedexit-proposal/page/v13/audit/gemini_C_real_use.md

<!-- model: gemini-4-argon; finishReason: STOP; usage: {"promptTokenCount": 77985, "candidatesTokenCount": 3824, "totalTokenCount": 81809, "promptTokensDetails": [{"modality": "TEXT", "tokenCount": 54154}, {"modality": "IMAGE", "tokenCount": 23831}], "candidatesTokensDetails": [{"modality": "TEXT", "tokenCount": 3824}]} -->

作为一名负责居家老人防跌和转移评估的作业治疗师（OT），我非常欣赏你们在第 13 版中真正去思考了“老人怎么出去、怎么回来”的全流程，并且诚实地把最大的不确定性写进了网页。

但是，如果我今天去一位腿力只能达到你们定义的目标区间（连 0.58 m 的床都站不起来）的老人家里，评估这套设备能不能装，我会立刻叫停。因为**为了配合你们的机械尺寸，你们要求老人在夜间迷糊的状态下，完成好几个比“从床上站起来”危险得多、也难得多的杂技动作。**

以下是我从真实使用场景出发，按严重程度排序找出的核心问题：

---

### 1. 【严重度：高】回床第 9 步：“盲坐”高处 14 cm 深的窄座板，且触发门槛高达 40% 体重，极易发生“滑落卡陷”事故

*   **位置**：网页 `#night` 第 9 步（`step_09.png`）、`#risk` 风险表第 7 条、以及控制器代码 `controller_v13.py` 的 `Params` 类（`self.seated_thr = 0.40 * self.BW`）。
*   **原文与代码证据**：
    *   第 9 步说明：“座面约 0.62 m，像坐高凳……未验证：座板只有 14 cm 深；坐得太靠后会越过后缘，滑向低 0.2 m 的床垫。座板后缘要不要加软挡边，待定。”
    *   代码：`occupied = z["F_seat"] > P.seated_thr`（即座板受力必须大于 24 kg，状态机才认为“有人坐上”）。
*   **为什么是问题**：
    *   **确定的事实（人体尺寸与物理）**：14 cm 大约只有成年人一个手掌长。一个 1.60 m 的老人，大腿加臀部前后深约 45 cm。当座板停在 0.62–0.66 m 高处时，人的脚只能用脚尖踮着踏板，必须把屁股“往高处撅”才能蹭上座板前缘。而座板后方紧挨着一个深达 20–24 cm 的“悬崖”（低处的床垫）。
    *   **确定的事实（控制逻辑漏洞）**：老人在摸索着往高凳上蹭时，绝不可能一下子把 40% 的体重（24 kg）全压在短短 14 cm 的板子上。如果她只挂住了 30% 体重，控制器依然处于 `EMPTY_HOLD`，此时她按“降”键，座板会进入 `EMPTY_MOVE`（一旦受力超过 5% 就立即停住），根本无法带她下降！
    *   **临床推论**：老人在夜里看不清，为了触发你们的传感器或者为了坐稳，势必会往后多坐一点。一旦骨盆重心越过这 14 cm，屁股会直接掉进后方低 20 多厘米的软床垫里，而大腿根和膝盖窝还挂在 0.62 m 高的硬座板上，身前 0.69 m 处还有横杆挡着——这在居家护理中是典型的**高风险剪切伤与卡陷（Entrapment）姿势**，老人自己根本爬不出来。加“软挡边”完全解决不了问题，反而会在第 11 步（往后挪回床上）时变成把屁股卡住的门槛。
*   **怎么改**：
    *   **改流程（最推荐）**：放弃“人离开后座板停在高处等她回来坐”的设计。人离开后座板留在原处可以，但回床时（第 8 步），让老人扶住横杆站在床前，**先按一下“空座降”把座板降回与床齐平（0.42 m）**，然后直接一屁股坐到宽敞的“座板+床垫”平面上。从站立缓降到 0.42 m 是离心收缩（顺着重力），只要手有横杆拉着，比克服重力站起来容易得多，也比盲瞄 14 cm 的高空窄条安全百倍。
    *   **如果坚持高处坐回**：必须把高处识别入座的阈值 `seated_thr` 从 `0.40 BW` 大幅下调（例如 `0.15–0.20 BW`），只要屁股挨上就能按“降”。

---

### 2. 【严重度：高】起床第 1–2 步：几何空间自相矛盾——人在床沿时横杆在 84 cm 远，手根本够不着，且小腿被升降柱死死顶住

*   **位置**：网页 `#night` 第 1、2 步（`step_01.png`、`step_02.png`），源码 `P.edge` 和 `P.scoot` 姿态数据，以及 `#structure`（脚下空间）。
*   **原文与代码证据**：
    *   第 2 步说明：“手拉横杆借力，往前挪 25–30 cm，坐到和床齐平、深 14 cm 的座板前缘。”
    *   源码几何参数：床沿在 `x = 0`，立柱外壳和座板占 `x = 0` 到 `0.14 m`，横杆在 `BX = 0.69 m`。在 `P.edge`（第 1 步坐床沿）中，髋部 `H = [-0.15, 0.51]`，肩部 `S = [-0.12, 0.97]`，手腕 `W = [0.10, 0.64]`。
    *   `model.py` 中 1.60 m 老人的总臂长：`L_uarm + L_farm = (0.186 + 0.200) * 1.60 = 0.618 m`。
*   **为什么是问题**：
    *   **确定的事实（几何计算）**：第 1 步老人坐在床沿时（`H = -0.15 m`），横杆在 `x = 0.69 m`，两者水平距离高达 **0.84 m**！哪怕老人把躯干前倾 30°，肩膀到横杆的距离依然超过 0.65 m，大于她 0.618 m 的手臂极限长度。也就是说，**坐在床沿时，她连横杆的边都摸不到**（这也是为什么你们在 `step_01.png` 和 `step_02.png` 里只能画她扶着侧面的连杆，而文字却写“手拉横杆借力”）。
    *   **确定的事实（物理干涉）**：当老人坐在床沿（髋在 `-0.15 m`）准备往外挪时，她的双腿垂下床沿，小腿正好处于 `x = 0` 到 `0.15 m` 的空间。而这个空间被你们的**两根升降柱和伸缩裙板（`x = 0` 到 `0.14 m`）完全占满了**！为了不撞上立柱，她必须把小腿往前踢到 `x > 0.14 m` 以外（膝盖几乎要伸直悬空），在这个脚踩不实、手又够不着前横杆的姿势下，靠双手在光滑的侧杆上“撸”着把 60 kg 的屁股从软床垫上往前拖 30 cm——对于一个连 0.58 m 床都站不起来的虚弱老人，这是绝对不可能完成的动作。
*   **怎么改**：
    *   **坦白修正文字与图纸**：第 1、2 步绝不能写“手拉横杆借力”，必须改成在**侧扶手（`x = 0.15 ~ 0.35 m` 处）设置专门的垂直抓握柱或防滑凸起**，让老人在床沿能够得着、拉得住。
    *   **重新评估立柱位置**：在“还没验证的地方”第 3 条里，不要只写“量手到横杆的距离”，必须加上“检查坐床沿时小腿与座板下立柱外壳的干涉”。更现实的做法是把两根升降柱移到座板**左右两侧**（与侧扶手合体），把座板正下方掏空，让老人在床沿就能把脚自然收回。

---

### 3. 【严重度：高】离开第 6 步 & 回床第 8 步：“囚笼效应”——进出通道仅宽 20 cm，且要求在踏板上做 90° 旋转

*   **位置**：网页 `#night` 第 6、8 步（`step_06.png`、`step_08.png`），源码 `drawTop` 函数。
*   **原文与代码证据**：
    *   第 6 步说明：“一只手扶横杆端部的立柱，另一只手去拿停在开口一侧的助行器，侧身迈下踏板。待 CAD 核对：横杆端部到台架边缘只有约 0.20 m 的空当……”
    *   `drawTop` 代码：座板前端 `x = 0.14 m`，前横杆及立柱在 `x = 0.69 m`，开口侧的立柱在 `y = 0.13 m`（踏板边缘在 `y = 0.33 m`）。
*   **为什么是问题**：
    *   **确定的事实**：仔细看 `step_06.png` 的俯视图：老人的身体后面是床和高起的座板（`x = 0.14`），左边是封闭的侧扶手（`y = -0.28`），前面是横杆（`x = 0.69`），**右前方还立着一根支撑横杆的立柱（`x = 0.69, y = 0.13`）**！所谓“开口一侧”，其实被这根立柱挡住了一大半，只剩下座板前缘（`x = 0.14`）和立柱（`x = 0.69`）之间的侧向空隙，以及立柱外侧那 20 cm 的边角。
    *   **临床推论**：用助行器的老人步态特点是底盘宽、不会单脚旋转（Pivot），转身必须靠小碎步，且最忌讳“侧身螃蟹步跨台阶”。现在你们要求她在离地 4 cm 的踏板上，夹在座板和前立柱之间，先原地转 90°，再侧身迈下 4 cm 的台阶，同时单手放开横杆去够外面的助行器——**助行器如果停得近，就会堵住她迈下踏板的脚；如果停得远，她就得悬空探身去抓未锁刹车的助行器。**
*   **怎么改**：
    *   **砍掉开口侧的地面立柱**：前横杆不应该靠开口侧的地面立柱支撑。应该做成**从封闭侧（靠床头侧）伸出的粗壮悬臂 L 形扶手**（既然已经装在刚性滑架上并随座板升降），把开口侧从 `x = 0.14` 到 `0.80` 彻彻底底敞开，让助行器可以直接贴到踏板边，老人转 45° 就能双手扶上助行器。

---

### 4. 【严重度：中】回床第 11 步：把腿收上床时，4 cm 高、80 cm 深的金属踏板和夹具成了磕碰脚踝的隐患

*   **位置**：网页 `#night` 第 11 步（`step_11.png`），`#problem` 范围界定。
*   **原文证据**：第 11 步：“手推横杆，身体往后挪回床垫，把腿收上床。”
*   **为什么是问题**：
    *   **确定的事实**：台架装在床的长边，踏板从床沿往外延伸 0.80 m，宽 0.66 m，高约 4 cm（源码画图是 1.3 cm，但文字写“约 4 cm”）。
    *   **临床推论**：老人挪回床垫后要躺下，必须把双腿从床边荡上床（Swing legs up）。正常床边是空的，小腿可以自然画弧线收上床。但现在床沿正下方横着深 14 cm 的硬质座板、刚性滑架、床架夹，再往下是高 4 cm 的金属踏板，侧面还有 L 形扶手杆。老人往后躺倒、抬腿转向床尾的过程中，脚后跟和小腿肚极易重重磕在座板前缘、侧扶手或踏板边缘上（老年人皮肤薄，极易造成皮肤撕裂伤 Skin Tear）。
*   **怎么改**：
    *   在 `#risk` 风险表或 CAD 细节里明确加上：**座板前缘、侧边缘及夹具外露处必须包覆至少 2 cm 厚的闭孔泡棉/软胶圆角**；同时在 CAD 中校核台架在床长边方向的位置，确保不会挡住双腿向床尾方向摆动的轨迹。

---

### 5. 【严重度：低】网页排版与视觉呈现的硬伤（会直接影响老师阅读和截图放进 Slides）

*   **位置**：网页截图 `03_why.png`、`04_control.png`、`step_04_dims.png`、`step_06.png`~`step_08.png`。
*   **具体证据**：
    1.  **粘性导航栏遮挡正文（`03_why.png`、`04_control.png`）**：顶部 `nav.top` 在滚动或截长图时，直接盖在了 `#why` 的大标题“为什么要升到 0.66 m，谁真正受益”上，以及 `#control` 的三栏核心规则文字上，导致字重叠无法阅读。
    2.  **侧视图尺寸标注与文字重叠（`step_04_dims.png`）**：勾选“标出尺寸”后，底部尺寸线 `踏板 0.80 m` 的文字掉出了画框底部被裁掉一半；`脚跟 ≥ 髋 + 0.08` 和 `立柱外壳止于此` 挤在深色块上看不清。
    3.  **俯视图轨迹线压字（`step_06.png`~`step_08.png`）**：虚线箭头直接穿过“开口一侧 ↓”和“助行器”的文字。
*   **怎么改**：
    *   修改 CSS 中 `section` 的 `scroll-margin-top` 或截图脚本（截图时把 `nav.top` 设为 `position: static`），修复 `drawDims` 和 `drawTop` 中文字的 `y` 坐标偏移。

---

### 总体判断与最值得先做的一件事

**总体判断**：
这份方案在**生物力学建模和状态机控制逻辑**上做得非常扎实，第 13 版对“传感器误锁”和“起步发力验证”的修补完全能够应付工程类课程的拷问。但在**人机交互与人体工程学（真实转移流程）**上，为了迁就“床外附加座板”的构型，创造出了“往前盲挪 30 cm”和“往后盲坐 14 cm 高凳”两个在临床上极不现实、甚至危险的动作。如果老师有医疗康复背景，一定会在“一晚上的往返”这一节把你们问住。

**10/27 见老师前最值得先做的一件事**：
**立刻修改回床流程（第 8–10 步）和扶手支撑构型**：把回床改成“人回来站在床前，先按按钮把空座板降回床面高度，再直接坐下”；并在将要画的 CAD 模型里，把开口侧的地面立柱去掉（改为封闭侧悬臂支撑），同时在侧扶手靠近床沿处加上供第 1 步抓握的垂直辅手。这三处改动不需要重写底层的数学模型，却能让整个“夜间往返”的故事在真实场景下瞬间变得合理、安全、立得住脚。
