xiaweiyi0423/me5412-bedexit-proposal/page/v13/audit/gemini_D_grading.md

<!-- model: gemini-4-argon; finishReason: STOP; usage: {"promptTokenCount": 78010, "candidatesTokenCount": 4539, "totalTokenCount": 82549, "promptTokensDetails": [{"modality": "TEXT", "tokenCount": 54179}, {"modality": "IMAGE", "tokenCount": 23831}], "candidatesTokensDetails": [{"modality": "TEXT", "tokenCount": 4539}]} -->

作为 ME5412 的授课老师，我看完了你们的第 13 版方案网页、力学模型和状态机仿真代码。客观地说，你们在建模深度（LP 起身模型扩展）、控制逻辑的自洽性（修复 v12 的误锁漏洞）和工程诚实度上，已经远超这门课的平均水平。

但是，对照我 **10/26 发给你们的邮件要求** 和 **11/3 的最终交付标准**，这份材料里还有几个会直接导致扣分的硬缺口、几处力学和代码上的隐蔽漏洞，以及在真实老人使用场景下站不住脚的设定。以下按严重程度排序列出：

---

### 1. 【严重度：高】邮件明确要求的“CAD 模型和运动动画”完全缺失（直接扣分项）
* **位置**：网页 `#night`（“一晚上的往返”）、`#structure`（“结构与固定”）、`#open`（“还没验证的地方”第 1、2 条）。
* **原文证据**：`#night` 导语写着“尺寸是初定目标值，示意图不是 CAD”；`#open` 承认“CAD 模型和运动动画（11/3 必须）……待做”、“FEA（11/3 必须）……待做”。
* **为什么是问题**：
  这是确定的事实。我在 10/26 邮件第 4 条明确要求“要展示 CAD 模型和运动动画”，并且是 5 人小组中角色 3（机构与 CAD）和角色 4（结构与安全）的核心工作量。现在离 11/3 只有一周，网页上只有 2D 简笔画，连初版 3D 装配图都没有。更重要的是，你们在文末承认有很多空间干涉问题（如开口侧只剩 0.20 m 怎么迈步、两根直径 124 mm 的升降柱怎么塞进 14 cm 深的座板下、床架夹怎么夹）全靠“待 CAD 核对”。如果在 11/3 的主 slides 里拿不出完整的 CAD 装配、机构运动动画和关键受力件（滑架、床架夹）的 FEA，角色 3 和 4 的分数会直接大打折扣。
* **怎么改**：
  角色 3 和 4 必须立刻停下文档修饰工作，全速出 CAD 和动画。不需要精细到每颗螺丝，但必须画出：① 两根 TiMOTION TL8 升降柱 + 刚性滑架 + 14 cm 座板 + L 形扶手的完整包络；② 床架夹与标准床侧梁的连接结构；③ 座板从 0.42 m 升到 0.66 m 的机构动画（直接录屏放进主 slides）。

---

### 2. 【严重度：高】“挪动 25–30 cm”与“坐上高处 14 cm 窄座板”存在极高跌倒风险，且违背邮件第 2 条稳定性要求
* **位置**：网页 `#night` 第 2 步（`step_02.png`）、第 9 步（`step_09.png`），以及 `#open` 第 3、4 条。
* **原文证据**：
  * 第 2 步：“手拉横杆借力，往前挪 25–30 cm，坐到和床齐平、深 14 cm 的座板前缘……未验证：往前挪 25–30 cm 对目标用户是否可行，是目前最大的不确定。”
  * 第 9 步：“回床 · 坐上停在高处的座板……座板只有 14 cm 深；坐得太靠后会越过后缘，滑向低 0.2 m 的床垫。”
* **为什么是问题**：
  我在邮件第 2 条特别提醒：“要考虑人坐上去、挪动时重心变化带来的台架稳定性。”你们只算了“台架会不会翻”（机器稳定性），却忽略了**“人会不会翻/滑落”**（人体稳定性）。
  1. **起床挪动（事实+生物力学常识）**：你们的目标用户是下肢无力、连从 0.58 m 床沿都站不起来的老人。让他们在柔软下陷的床垫上，光靠手臂拉 0.55 m 外的横杆把臀部往前硬挪 25–30 cm，极易因摩擦力或核心力量不足而滑倒在床沿与座板之间。
  2. **回床盲坐（设计漏洞）**：为了省掉空载复位，你们让座板整夜停在 0.62–0.66 m 的高处。老人半夜从厕所回来，背对座板盲坐在一个**只有 14 cm 深**（不到成年人臀深的一半）、且**后方悬空落差达 20–24 cm** 的高台边缘。只要往后坐偏 5–8 cm，臀部就会直接从座板后缘滑落，摔进低处的床垫里，造成严重的脊柱或髋部冲击。
* **怎么改**：
  1. **回床流程必须改**：回答你们在 `#open` 第 7 条问我的问题——**我不接受座板整夜停在高处让老人盲坐**。14 cm 太窄，高处盲坐太危险。回床应该是：老人走回来，手扶横杆，按一下握把上的“降”，让空座板先自动降回 0.42 m（与床齐平），老人直接坐到与床面连成一体的宽大平面上（哪怕坐偏也是坐到床垫上，绝对安全），或者取消高处坐人。这与“没人时不自己动”不冲突，因为这是**老人主动按了按钮**才动的。
  2. **座板深度与挪动距离**：在 CAD 中 перевірте（核对）为什么座板只能做 14 cm 深？如果座板后缘能做成一块延伸压在床垫上的薄过渡板（防夹手同时增加承托面积），老人就不需要精准挪动 25–30 cm。

---

### 3. 【严重度：高】控制器“力之和自检”方程存在物理漏洞，老人一旦用双手向上拉横杆就会误锁死机
* **位置**：Python 代码 `model/calc_v13/controller_v13.py` 的 `Controller.step()` 函数（第 52 行）及 `run()` 函数（第 127、140 行）；以及 `seat_support.py` 第 61 行。
* **代码证据**：
  * `controller_v13.py` 第 52 行：`total = z["F_seat"] + z["F_feet"] + max(0.0, z["F_bar"])`，紧接着判断 `abs(total - P.BW) / P.BW > P.sum_tol`（偏差 > 15% 持续 0.5 s 就 `LOCKED`）。
  * `controller_v13.py` 第 140 行：仿真中硬编码了 `F_bar = 60.0`（即假设手永远向下压横杆 60 N），然后凑出 `F_feet = BW - F_seat - F_bar`。
  * 但在你们自己的生物力学模型 `seat_support.py` 第 61 行中，手力边界是 `bounds = [(-2000, 2000)] * 2`，且网页 `#night` 第 2 步明确写着“手**拉**横杆借力”。
* **为什么是问题**：
  这是确定的物理和代码矛盾。由人体竖直方向静力平衡：$F_{\text{seat}} + F_{\text{feet}} + F_{\text{bar,z}} = BW$（定义手向下压横杆、横杆向上托人为正；手向上拉横杆、横杆向下拉人为负）。
  你们的代码写成了 `max(0.0, z["F_bar"])`。如果老人在起身时不是向下撑横杆，而是**向上拉横杆**（或者向前水平拉横杆，导致竖直分力 $F_{\text{bar,z}} < 0$，比如 $-100\text{ N}$），那么为了平衡，座板和踏板测到的竖直力之和 $F_{\text{seat}} + F_{\text{feet}}$ 就会等于 $BW + 100\text{ N} \approx 1.17\,BW$。此时代码里的 `max(0.0, F_bar)` 会把负力截断为 0，算出来的 `total` 变成 $1.17\,BW$，直接触发 `> 15%` 的力之和报错，把正在起身的老人**锁死在半空中（LOCKED）**！
  你们之所以在 12 个仿真里没发现这个 bug，是因为你们在 `controller_v13.py` 里根本没有读取 `seat_support.py` 算出来的真实手部竖直分力 `Fz`，而是强行假定老人永远向下按压 `F_bar = 60.0 N`！
* **怎么改**：
  1. 明确横杆测力传感器的测量维度：必须测量**竖直方向分力 $F_{\text{bar,z}}$**（带正负号），把第 52 行的 `max(0.0, z["F_bar"])` 改为直接相加代数和 `z["F_seat"] + z["F_feet"] + z["F_bar_z"]`。
  2. 检查 `seat_support.py` 优化出的最优解里，`Fz` 到底是正是负（是撑还是拉），并把这个真实的 `Fz` 传给 `controller_v13.py`，重新跑仿真。

---

### 4. 【严重度：中】邮件要求的“压力中心（COP）传感”和“用户界面（UI）”只停留在口头，控制仿真直接作弊设为 `True`
* **位置**：`controller_v13.py` 第 133、146 行；网页 `#control` 和 `#night`。
* **代码与原文证据**：
  * 我在 10/26 邮件第 3 条强调：“用户界面和操作安全很关键：手握输入，加上压力和力分布传感”。
  * 网页 `#control` 写着：“四个条件同时满足才升：握把式‘起’开关、手在横杆上、双脚踩实踏板、**压力中心在安全区**。”
  * 但打开 `controller_v13.py` 第 133 和 146 行，所有 12 个场景里写的都是：`cop_ok=True`！整份代码和网页里，连“安全区是多少毫米/厘米”、“座板和踏板下各 4 个传感器怎么算 COP”的公式或阈值都没有定义。
* **为什么是问题**：
  作为老师，看到邮件里点名要求的“力分布传感/压力中心”在代码里被硬编码成 `cop_ok=True`，我会认为你们在应付差事。此外，你们在状态机里引入了“握把式‘起’开关”、“降”按钮、“升/降”空座按钮、17 秒提示音、状态灯，但在整份网页里**没有一张图展示握把长什么样、按钮怎么排布**，刚醒的迷糊老人怎么在黑夜里分清哪个是死人开关（握紧起）、哪个是点按开关（降）？
* **怎么改**：
  1. 在控制表（`#setT`）和代码里补上 COP 的真实物理定义：例如，踏板长 80 cm、宽 66 cm，4 个测力单元算出的足底 $\text{COP}_x$ 必须落在脚跟到脚尖的安全区间内（如距离前缘 $>10\text{ cm}$），座板 $\text{COP}_x$ 不能过于靠前或靠边（防滑落），并在仿真里加一个“坐偏/重心不稳导致 `cop_ok=False` 暂停抬升”的动作。
  2. 在 CAD 部分专门画一个**握把 UI 特写图**：标出左/右手握持区、触发式“起”开关（一握即触）、独立内凹的“降”按键和指示灯。

---

### 5. 【严重度：中】力学模型的手臂假设与机械结构冲突（单侧 L 形扶手 vs 双手对称发力模型）
* **位置**：`model/calc_v13/seat_support.py` 第 28–31 行；网页 `#night` 俯视图（`step_01.png` 至 `step_11.png`）。
* **原文与代码证据**：
  * `seat_support.py` 第 30–31 行：`2 * sub.m_uarm`、`2 * sub.sh_flex`，即完全沿用 2D 矢状面**双手对称握持**正前方横杆的假设。
  * 但看网页 `#night` 的俯视图，扶手是一个**单侧 L 形结构**：一根侧边杆沿着床沿伸出来，在距离髋部前方 `0.55 m` 处折弯成一根横杆。
* **为什么是问题**：
  1. **可达性矛盾**：当老人坐在床沿（第 1 步，`x = -0.15 m`）要往前挪时，那根横杆在 `x = +0.69 m` 处，距离老人的髋部足足有 **0.84 m**！1.60 m 身高的老人手臂总长（上臂 `0.186H` + 前臂手 `0.20H`）只有 **0.62 m**。老人坐在床沿时根本够不到前面的横杆，只能单手拉侧边杆！因此第 2 步说的“手拉横杆借力往前挪”在几何上是不可能的。
  2. **刚度问题**：L 形扶手只在靠床内侧有一根立柱支撑（或者在前端 `0.69 m` 处有一根细长立柱直通踏板，侧视图里有画但文字完全没提这根前立柱怎么跟座板一起升降！）。如果横杆要跟着座板一起升降（网页说“L 形扶手随座板升高”），那侧视图里那根插在踏板最前端（`x = 0.69 m`）的竖直立柱是怎么伸缩的？那里面难道还有第三根升降柱吗？
* **怎么改**：
  这是机构概念（邮件第 5 条要求讲清楚的核心）的大漏洞！
  1. 澄清扶手结构：如果扶手装在座板下的刚性滑架上随座板一起升，它就是一个悬臂长达 0.55 m 的 L 形管，前端不能固定死在地面踏板上（否则升不起来），除非前端立柱是一根随动的套筒导轨。必须在 CAD 中把这个连接画清楚，并在 FEA 中校核老人在 0.55 m 悬臂端猛拽 1112 N 时的弯矩和扭矩！
  2. 修正第 2 步描述：坐在床沿时够不到前横杆，老人拉的是**侧扶手**往前挪，坐上座板后才换手握前横杆。

---

### 6. 【严重度：低】网页排版出现严重重叠 Bug，以及向最终英文 Slides 转化的鸿沟
* **位置**：网页截图 `03_why.png` 顶部、`04_control.png` 中上部；以及课程交付要求。
* **图像证据**：
  * 看截图 `03_why.png`：标题“为什么要升到 0.66 m，谁真正受益”被粘性导航栏（Sticky Nav）遮挡切割成了半截字。
  * 看截图 `04_control.png`：三栏规则（“握紧才升”、“有人坐着才带人降”、“没人时不自己动”）的标题和第一行字，被导航栏“问题和用户 一晚上的往返……”完全压住重叠，根本没法读。
* **为什么是问题**：
  网页 CSS 的 `scroll-margin-top` 或截图脚本在滚动截屏时出了问题。虽然 10/27 只是内部 consultation，但这种版面穿帮会影响阅读体验。更关键的是：**11/3 要求提交的是精简的英文主 slides + 英文附录**（见邮件第 6 条和交付背景）。你们现在花大量精力把中文网页做到了第 13 版，信息密度极大，但如果直接把这些密密麻麻的中文表格和 9 状态图塞进 15 分钟的英文 PPT 里，现场汇报一定会超时且听众看不清。
* **怎么改**：
  10/27 咨询结束后，**不要再改这个中文 HTML 网页了**！立刻切入英文 Slides 制作：主 slides 控制在 12–15 页以内（每页 1 个核心结论 + 1 张大图），把 12 个仿真场景中的 9 个、参数演变表、v12/v13 对比、文献细节全部移进 Appendix（附录不限页数，留着答辩防身）。

---

### 我在 10/27 咨询或 11/3 答辩时最想问你们的 3 个问题（请提前准备）：
1. **关于机构悬臂与同步**：“你们说 L 形扶手和座板装在同一个刚性滑架上一起升降，横杆在座板前方 0.55 m。当老人失衡用 1112 N 的力拽这根横杆时，这会在升降柱滑架上产生超过 $600\text{ N}\cdot\text{m}$ 的倾覆力矩。TiMOTION TL8 升降柱允许承受这么大的偏心弯矩吗？需不需要外置导轨？”
2. **关于速度控制律的物理体验**：“你们的抬升速度公式是 $v = k(F_{\text{cap}} - F_{\text{seat}})$。老人在起身过程中，身体重心在动，座板受力 $F_{\text{seat}}$ 会不断波动，这会不会导致升降柱的速度一顿一顿的（忽快忽慢），反而把老人晃晕？”（提示：代码里虽然加了 `a_max = 0.05` 的加速度限制，但在 slides 里要讲清楚这个平滑滤波机制）。
3. **关于断电与死机救援**：“如果两根立柱不同步（高差 $>5\text{ mm}$）触发了 `LOCKED`，座板已经是歪的、卡死了，你们的状态机却写着‘锁定后只能按住降慢降’。如果机械卡死或者单柱编码器坏了，再往下驱动岂不是把滑架彻底掰断？”

---

### 总体判断与最值得先做的一件事

* **总体判断**：这是一个思考非常扎实、控制逻辑闭环、直面自身缺点的优秀工程方案（尤其欣赏你们用扩展 LP 模型定量回答了“起步需要多少力”，并用状态机仿真排除了压床垫误锁）。在理论建模和控制架构上，你们已经拿到了 A 级的底子；但**机械结构实现（CAD/FEA）和人机工程细节（挪动与盲坐安全）目前严重滞后**，成了拉低总分的短板。
* **最值得先做的一件事**：**立刻冻结网页文本，让角色 3 和角色 4 在 48 小时内把三维 CAD 装配图（含床架夹、升降柱、L 形扶手导轨）和坐姿人体模型建出来**——只有把 1.60 m 的假人放进三维模型里，你们才能真正向我证明“老人手够得着横杆、脚放得进 8 cm 空间、迈得出 20 cm 出口”。
