xiaweiyi0423/me5412-bedexit-proposal/presentation/audit/v3/gemini_B_safety.md

<!-- model: gemini-4-argon; finishReason: STOP; usage: {"promptTokenCount": 40413, "candidatesTokenCount": 3248, "totalTokenCount": 43661, "promptTokensDetails": [{"modality": "TEXT", "tokenCount": 17313}, {"modality": "IMAGE", "tokenCount": 23100}], "candidatesTokensDetails": [{"modality": "TEXT", "tokenCount": 3248}]} -->

作为医疗设备与个人护理机器人的安全评审员，我首先肯定你们在第三轮修改中的巨大进步：去掉了“底座称重”、“久坐自动下降”和“离座自动复位”，补上了三处合力自检和应急拨杆先断电（STO）的逻辑，控制安全比上一版扎实了很多。

但从严苛的操作安全和故障逻辑来看，新改动引入了几个**首尾矛盾的漏洞**，且在机械应急、防夹和床体固定上仍有会被老师一问就倒的薄弱点。以下是按重要性排序的审计意见：

---

### 1. 【严重度：高】设计要求与回床控制逻辑直接冲突（“有人坐着才降” vs “空座板按住下降”）
* **位置：** 第 4 页（设计要求 6）、第 16 页（验证表要求 6）、第 18 页（结论），对比第 11 页（回床问答）、第 13 页（状态机图及文字）。
* **原文证据：**
  * 第 4、16、18 页均明确写着设计要求是：**“只有确认有人坐着才下降”** / **“有人坐着才降”**。
  * 但第 13 页状态机右上角画着：从“空座板停住”状态，**“回床：按住‘降’，空座板降到回床高度（默认 0.50 m）停住，坐上去”**。
* **为什么是问题（确定的事实）：** 这是明显的逻辑自相矛盾。离座后座板停在最高可达 0.66 m 的位置，老人回来时臀部根本坐不上去，**必须**先在空载状态下把座板降到 0.50 m。如果严格执行第 4 页“只有确认有人坐着才下降”的要求，老人回床时将永远无法把高处的空座板降下来（系统死锁）；反之，既然状态机允许空座板下降，第 4、16、18 页写的硬性安全要求就是错的。
* **怎么改：** 立即统一口径。把第 4、16、18 页的“只有确认有人坐着才下降”全部改为：**“只有按住‘降’才下降（不自动降）；空载下降自动停在 0.50 m 接人，确认坐稳后才允许继续降回床面。”**

---

### 2. 【严重度：高】应急机械下降的“3 cm/s 限速”在图文和问答中全部漏掉了限速器
* **位置：** 第 8 页（机构三维图）、第 10 页（驱动选型及问答）、第 15 页（风险表）。
* **原文证据：**
  * 项目背景说明里写明：“应急下降用滚珠丝杠 + 失电制动 + **离心限速**”。
  * 第 10 页和第 15 页正文及讲稿说：“控制器坏了，拉带护盖的拨杆：先断电机电源，再松制动，**限速约 3 cm/s**”。
  * 第 10 页问答算账：“最轻的用户沿导轨的下沉推力约 267 N；阻力约 104 N（丝杠、导轨、毛刷，加电机被反拖的阻力约 31 N）……是 2.6 倍”。
* **为什么是问题（确定的事实 + 物理推论）：** 
  1. **事实缺失：** 全部 21 页 slides、讲稿和三维机构图里，**没有任何一处提到“离心限速器（或阻尼器）”**。
  2. **物理灾难：** 既然拨杆第一段行程已经“切断了电机电源（STO，电机绕组开路，没有电磁制动）”，且松开了机械抱闸，滚珠丝杠又是高效率不自锁的。此时如果一个 100 kg 的老人坐在上面（沿导轨下沉推力近 600 N），而机械静阻力只有 104 N，剩下的近 500 N 净推力会让座板**加速自由下落**，瞬间砸到底，根本不可能停留在“3 cm/s”！
* **怎么改：** 
  * 在第 8 页三维图和第 10 页选型文字中，明确补上**“丝杠轴端装有离心摩擦限速器（或旋转涡流阻尼器）”**，或者说明拨杆切断电源的同时将**电机三相绕组短接（能耗制动阻尼）**。
  * 在第 10 页问答中说明：104 N 是启动静摩擦阻力（保证最轻的人能启动下降），一旦动起来，速度达到 3 cm/s 时由离心限速器/绕组短接提供与体重匹配的动态阻尼力。

---

### 3. 【严重度：高】自检逻辑漏洞：座板倾角最高 15.7°，没有水平力传感，三处力之和不可能等于体重
* **位置：** 第 12 页（传感与交互及问答）、第 13 页（状态机自检条件）、第 14 页（速度自适应）。
* **原文证据：**
  * 第 12 页：“1 座板下测力（法向力）……按座板倾角折算”、“自检：抬升中三处力之和 ≈ 体重”。
  * 第 12 页问答：“它测的是垂直于座面的力。丝杠编码器知道当时的倾角（最大 15.7°），控制器把它折算成竖直方向；倾角带来的误差只有几个百分点，自检容差是 15%。”
* **为什么是问题（确定的力学事实）：**
  * 当座板前倾 $\theta = 15.7^\circ$ 时，人之所以没有滑下去（你们在第 15 页问答里自己算了），是因为坐垫提供了沿座面向上的**静摩擦力 $F_f = N \tan\theta \approx 0.28 N$**。
  * 人体在竖直方向的力平衡是：$F_{\text{座板竖直}} = N \cos\theta + F_f \sin\theta$。
  * 如果座板下只装了单轴（法向 $N$）测力单元，不测切向摩擦力 $F_f$，仅靠 $N \cos\theta$ 去算竖直力，在准静态不滑时就会漏掉 $F_f \sin\theta$（约 $7.5\%$ 误差）；而在老人发力起身、大腿往前蹬座板或往回坐的动态瞬间，切向摩擦力剧烈变化，单靠法向力折算的竖直力误差会直接突破 15%，导致**正常起身时频繁误触发“传感器故障锁定”**。
* **怎么改：** 
  * **方案 A（改硬件表述）：** 在第 12 页说明座板支架与滑块连接处采用**竖直方向的单轴测力传感器**（直接测竖直分力，机械解耦，不用管倾角和摩擦），或者用三轴/双轴力传感器。
  * **方案 B（改算法表述）：** 如果坚持用法向测力，第 12 页问答必须改成按包含摩擦的平衡公式折算（或将抬升中的动态自检容差放宽到 20%–25%，仅在静止状态用 15% 校核）。

---

### 4. 【严重度：中】台架与床固定需承受 2.3 kN（约 230 kg）水平拉力，但未评估“把床拉动或拉坏”的二次风险
* **位置：** 第 11 页（稳定性）、第 15 页（风险表）。
* **原文证据：**
  * 第 11 页：“人站在地上，在横杆高度拉或推台架……107 N 就翻”、“和床固定后，固定件需要的拉力 2282 N”、“待补：固定件锁在床架或床腿上”。
* **为什么是问题（确定的事实 + 风险推论）：** 
  * 你们把防倾翻完全寄托在“锁在床架/床腿上承受 2282 N 拉力”。但目标场景是普通居家环境（第 4 页），普通家用木床架的侧板或单根床腿在离地几十厘米处承受 230 kg 的横向冲击拉力，极易发生**木床架断裂**；或者如果是轻质床架放在木地板上，整张床会被拉着滑动，台架依然会晃动。
  * 此外，台架底座压在地上、上部死死锁在床架上，当人坐上床垫和座板时，床架变形而台架不变形，固定件会承受额外的附加内力（这正是你们第 12 页放弃底座称重的原因）。
* **怎么改：** 
  * 在第 11 页和第 17 页（局限/适配）中补充：固定件采用**贴地面的床腿根部抱箍 + 穿底拉带（拉对侧床腿）**，把 2.3 kN 的力降到底面高度（大幅减小倾翻力矩，不掰断床腿，只受水平剪切），并在底座和床脚加防滑垫。

---

### 5. 【严重度：中】防夹手/夹脚的逻辑缺口：空座板下降遇阻检测过慢，且遗漏“座板下方的脚部空间”
* **位置：** 第 15 页（风险和对策）、第 13 页（状态机）。
* **原文证据：**
  * 第 15 页：“座板后缘软包，下降遇阻（电机电流升高）即停”。
* **为什么是问题（确定的事实）：**
  1. **用电机电流测遇阻太迟钝：** 你们用的是滚珠丝杠传动（设计推力高达 1773 N）。当座板下降夹到老人的手指、猫狗或床单被褥时，丝杠把阻力缩小到电机端，等电机电流明显升高时，座板边缘可能已经产生了上百牛顿的挤压，软包也挡不住骨折风险。
  2. **传感器放着没用：** 你们明明在座板下装了高灵敏度的测力传感器（第 12 页）！在“空座板按住下降（降到 0.50 m）”阶段，座板本该是零载荷；如果下降中碰到障碍物，座板向上的力会变成负值（或减小），用座板测力传感器检测遇阻比电机电流快得多、灵敏得多。
  3. **有人坐着下降时的夹脚风险：** 当老人坐在座板上从 0.50 m 降回 0.42 m 时，如果老人的另一只脚或拖鞋不小心伸到了座板或悬臂托架正下方，此时座板上本来就有体重，电机电流和座板测力都分不清是体重还是夹到了脚。
* **怎么改：** 
  * 第 15 页对策改为：空载下降遇阻由**“座板测力传感器检测到反向托力 + 电机电流双判断”**即停；有人坐着下降时，依靠**“踏板力分布确认双脚都在踏板安全区内”**（第 12 页已有踏板测力）才允许降到底，并在座板底面加防夹触边（或全包围风琴罩）。

---

### 6. 【严重度：低】细节与前后文不一致（残留的旧文字和数据）
* **位置与证据：**
  1. **第 17 页（局限）讲稿备注：** slide 正文已经改成了“挪上座板约 10–20 cm”，但下面的**讲稿备注里还写着：“往前挪二三十厘米对老人是否可行，也还没有验证”**（这是上一轮审计指出的旧数字，讲稿忘了改）。
  2. **第 20 页（附录目录）对比第 14 页（速度自适应）：** 第 14 页正文写“按坐板轨迹仿真 **15 个场景**”，讲稿指南待补写“把全部 **14 个场景**的图放进附录”，而第 20 页附录目录上却写着“**8 个仿真场景**的逐个说明”。三个地方三个数字（15、14、8）。
  3. **第 13 页（状态机）被困风险：** 状态机规定“自检不过 → 锁定 → 只能按住‘降’慢降”。但如果故障恰恰是**“降”按钮本身损坏（双通道不一致或断路）**，老人坐在半空就会被彻底锁死在上面（用不了电池下降，只能去够立柱侧面的机械拨杆，而坐着够立柱侧面可能够不着或失去平衡）。
* **怎么改：** 
  * 修正第 17 页讲稿的“二三十厘米”为“十到二十厘米”；统一第 14、20 页的仿真场景数量为“15 个”。
  * 在第 13 页问答中备一句：若“降”按钮本身失效，长按“起”按钮不松手超过 5 秒（或床头盒上的独立备用降按钮）可触发故障慢降。

---

### 总体判断与最值得先做的一件事

**总体判断：**
这份材料在经过两轮迭代后，状态机和传感方案已经非常贴合老师“操作安全与自适应控制”的要求，直击医疗护理机器人的痛点。目前的薄弱点不再是顶层方向错误，而是**新增的回床逻辑、斜座板力学与原有安全规则之间产生了没对齐的缝隙**。

**最值得先做的一件事：**
在今天与老师 consultation 之前，**立刻修改第 4、16、18 页关于“有人坐着才降”的文字表述（问题 1），并在第 10 页讲稿中补上“离心限速器 / 电机绕组短接阻尼”（问题 2）**。这两处一个是明显的页面前后打架，一个是物理上的自由落体漏洞，改掉只需要 5 分钟，但能避免在现场被老师一眼抓出硬伤。
