xiaweiyi0423/me5412-bedexit-proposal/presentation/audit/v3/gemini_C_real_use.md

<!-- model: gemini-4-argon; finishReason: STOP; usage: {"promptTokenCount": 40414, "candidatesTokenCount": 3593, "totalTokenCount": 44007, "promptTokensDetails": [{"modality": "TEXT", "tokenCount": 17314}, {"modality": "IMAGE", "tokenCount": 23100}], "candidatesTokensDetails": [{"modality": "TEXT", "tokenCount": 3593}]} -->

作为一名经常去老人家里做床边转移评估的作业治疗师（OT），我看到你们在这一轮修改中做了很多非常关键的安全改进——特别是去掉了自动下降、改用曲线座板接人、增加了和床固定。

但当我把整套动作放在**凌晨两点、老人被尿意憋醒、脑子迷糊、腿脚发软**的真实场景里走一遍时，发现从“醒来挪上座板”到“回来躺下”的闭环里，还有几个极其危险或根本做不出来的环节，以及两处材料前后的直接冲突。以下是按重要性排序的问题清单：

---

### 1. 回床流程反人性且高危：放弃助行器、侧身钻窄缝、在半空傾斜座板上“往后退”
* **严重度：高**
* **在哪里：** 第 11 页（俯视图及问答）、第 13 页（状态机及讲稿）、第 17 页（局限页）。
* **原文证据：**
  * 第 11 页问答：“回来要从床尾一侧侧身走进座板和横杆之间约 0.46 m 深的空间，助行器进不去，最后一两步扶着横杆走。”
  * 第 13 页讲稿：“回床时按住‘降’，空座板先停在 0.50 米这个回床高度，人坐上去……坐稳后再按住‘降’，带着人降到床面，往后挪回床上，腿向床尾一侧转上床。”
  * 第 10 页图表：座面高 0.50 m 时，座板前倾角约为 **12°–13°**。
* **为什么是问题：**
  * **确定的事实：** 你们在第 4 页定义目标用户包括“借助助行器行走”的老人，且第 15 页设定座板采用“高摩擦面料（$\mu \ge 0.5$）”。
  * **因果与推导：** 老人夜里上完厕所回来，往往比去的时候更累。现在的回床设计要求老人做一连串高难度动作：
    1. **弃用助行器盲走：** 在离座板还有一两步时把助行器丢在外面，单靠侧手扶着横杆，“侧身螃蟹步”钻进 0.46 m 宽的死胡同。对需要助行器的老人来说，放开助行器转身的那一刻就是跌倒高发期。
    2. **操作繁琐且站着等：** 钻进去后不能直接坐，因为座板停在离座时的 0.56–0.66 m 高处。老人必须先单手扶稳、另一手按住“降”等空座板降到 0.50 m。尿急或腿软的老人夜里根本没耐心站着等机器复位。
    3. **往斜坡上坐：** 0.50 m 高度时座板并非水平，而是**前倾约 13°**（见第 10 页右图）。让老人往一个向前倾斜的板子上坐，臀部极易顺着斜坡往前滑脱。
    4. **最致命的“往后挪”：** 降到床面后，座板深约 17 cm，上面是高摩擦防滑面料。老人怎么从这块防滑板上“往后挪”回床垫？起身时往前挪，人可以用脚踩地往后蹬；但回床时要**往后挪**，老人双手握着身前的横杆（只能往前拉，推不上力），双脚在身前地面，屁股底下是防滑布，后面还有床垫边缘凸起——**在生物力学上，虚弱老人几乎不可能把屁股往后平移 20 cm 退回床上**，更别提一边往后退一边把腿向床尾甩上床了。
* **怎么改：**
  1. **重新审视回床路径：** 为什么老人回床一定要坐上座板？普通床高 0.42 m，老人完全可以直接在“床尾敞开处”坐在床垫边缘上床（坐下顺着重力，远没有起身难，只要手能扶着立柱或横杆慢降即可）。如果回床根本不需要坐上座板，只需在床尾坐床沿，那“往后挪”和“钻 0.46 m 窄缝”的死结就解开了大半。
  2. 如果坚持用座板回床，必须在第 17 页局限里坦白承認：**0.50 m 处有 13° 前倾角不利于坐下**，以及**防滑面料上往后退回床垫缺乏发力支点**。
  3. 明确空座板从何处操作下降：老人站在助行器旁（窄缝外）能不能按到“降”？如果横杆末端也有下降键，老人可以在助行器里看着座板降好，而不是钻进去罚站干等。

---

### 2. 起身第一步“空手挪臀”：身前横杆距离太远，老人还没够着扶手就可能摔下床
* **严重度：高**
* **在哪里：** 第 6 页（步骤 1、2 及问答）、第 11 页（俯视图）。
* **原文证据：**
  * 第 6 页文字：“1 坐在床沿，挪上和床齐平的座板；2 双手握住身前横杆”。
  * 第 6 页问答：“人从床沿往前挪到臀部在座板上，大约 10–20 cm……横杆在人正前方 x 70 cm、高 0.95 m，81 位模拟用户坐着都够得着。”
* **为什么是问题：**
  * **确定的事实：** 床沿在 $x = 0$，横杆在 $x = 70\text{ cm}$、高 $0.95\text{ m}$。老人刚从被窝坐起来时，臀部在床沿内侧（$x < 0$）。
  * **因果与推导：** 身高 1.50 m–1.60 m 的老人，手臂长只有约 50–55 cm。当他还坐在床垫上（还没挪上座板）时，距离 $x=70\text{ cm}$、高近 1 米的横杆超过 70 cm，**根本够不着横杆**！这意味着第 6 页写的顺序是完全真实的：老人必须**先在没有任何扶手可抓的情况下**，撑着软床垫把屁股往床外悬空处的座板上挪 10–20 cm，挪到位了，手才能勉强够到身前 70 cm 的横杆。夜里迷迷糊糊往床沿外挪屁股却没东西抓，极易直接滑下床头栽在横杆上。此外，头顶床头一侧紧贴着一个 0.80 m 高的硬邦邦的机构箱（离床仅 2.1 cm），老人半夜翻身坐起甩腿时，手肘、肩膀或小腿很容易撞在这个大铁箱子上。
* **怎么改：**
  * 在第 11 页俯视图和第 8 页三维图上，**把 L 形扶手沿着床头立柱往回延伸一段（或加一个床沿抓握把手）**，让老人还在床上坐着时手边就有东西抓，抓稳了再往座板上挪。
  * 机构箱朝向床上的一侧（床头侧）必须注明加装防撞软包，防止夜里翻身磕碰。

---

### 3. 安全逻辑自相矛盾：设计要求写“只有有人坐着才下降”，但回床却要求“空座板按住下降”
* **严重度：高（必然被老师或评委问住的逻辑硬伤）**
* **在哪里：** 第 4 页（设计要求 6）、第 16 页（验证表要求 6）、第 18 页（结论） vs. 第 11、13 页（回床流程）。
* **原文证据：**
  * 第 4 页：“6. 只有确认有人坐着才下降；离座后座板停住接人”
  * 第 16 页：“6 有人坐着才降；离座后停住接人”
  * 第 18 页：“安全：松手即停、有人坐着才降……”
  * 第 13 页状态机图及讲稿：“空座板停住 → 回床：按住‘降’，空座板降到回床高度（默认 0.50 m）停住……空座板也只在按住‘降’时才动。”
* **为什么是问题：**
  * **确定的事实：** 前后文直接冲突。如果严格执行第 4、16、18 页的“只有确认有人坐着才下降”，那么老人站起来走开后（座板停在 0.57 m 空载状态），哪怕回来按破了“降”键，座板也绝对不能动！这样老人根本无法回床。反过来，既然第 13 页允许空座板按住“降”往下走，那第 4、16、18 页写的“有人坐着才降”就是一句假话（应该是上个版本留下的残余未改净）。
* **怎么改：**
  * 立即统一第 4、16、18 页的表述，将“只有确认有人坐着才下降”改为**“只有人按住‘降’才下降（不自动下降）”**。

---

### 4. 应急下降拉索拨杆的位置：晕倒或力竭坐在半空的人根本够不着、拉不动
* **严重度：中**
* **在哪里：** 第 10 页（驱动选型及讲稿）、第 15 页（安全风险表）。
* **原文证据：**
  * 第 10 页：“如果控制器也坏了，拉立柱侧面带护盖的拨杆，第一段行程先切断电机电源，再松开制动器……一松手就停。”
* **为什么是问题：**
  * **确定的事实：** 立柱在底座最前方（约 $x = 70\text{ cm}$ 处）且偏向床头一侧。拨杆带护盖，且需要持续拉住 11 秒（松手即停）。
  * **因果与推导：** 什么时候需要用这个拨杆？老人被卡在半空（比如座高 0.55 m），且机器断电+控制器死机。此时老人坐在半空前倾的座板上，如果他已经头晕或力竭，你要他探身往前下方够到 $x=70\text{ cm}$ 立柱侧面的护盖、掀开护盖、用力拉住机械抱闸拉索（松开失电制动器的弹簧通常需要不小的拉力）并保持前倾姿势整整 11 秒——这在人体工程学上是做不到的，一探身重心前移就从前倾的座板上栽下去了。
* **怎么改：**
  * 明确说明这个机械应急拨杆放在**座板侧下方手边**（或横杆靠近手握处的侧面），或者在讲稿中明确定义：**该机械拨杆主要供家属或护理人员在设备死机时施救使用**，老人自己一人时停在半空等待救援比自己盲目拉机械闸往下滑更安全（这和你们第 13 页“晕倒停住不自己降，等家属来”的逻辑刚好一致）。

---

### 5. 状态机死锁隐患：坐偏或脚没踩实，老人握紧开关时机器“装死”，夜里不知所措
* **严重度：中**
* **在哪里：** 第 12 页（传感与交互）、第 13 页（状态机）、第 14 页（问答）。
* **原文证据：**
  * 第 13 页状态机图：从“已坐上”到“抬升”的条件是“握紧开关 + 手在杆上 + 脚踩实 + 坐正”。
  * 第 15 页：“压力中心偏出安全区就不抬”。
* **为什么是问题：**
  * **因果与推导：** 老人半夜迷迷糊糊往外挪，十有八九屁股没挪正（比如还有一半压在床垫上，座板受力不够或压力中心偏后），或者一只脚还在床沿下没踩上踏板测力区。此时老人双手握紧“起”开关，机器因为不满足“坐正+脚踩实”而毫无反应。在黑暗中，没有屏幕提示，老人只会觉得“机器坏了”，于是要么拼命捏开关，要么松开手尝试自己硬站起来导致跌倒。虽然第 12 页提了一句“握把上的状态灯”，但老人低头起身时根本不会仔细分辨指示灯颜色代表“没坐正”还是“脚没放好”。
* **怎么改：**
  * 在第 12 页交互反馈中加上一句贴合老人的设计：**当握紧开关却因姿势不对不启动时，握把给微弱震动或轻声语音/蜂鸣提示（如“请再往前坐一点”）**，而不是只靠状态灯。这在课堂展示时会非常体现你们对老年用户的体察。

---

### 6. 上一轮审计残留未改净的地方（细节穿帮）
* **严重度：低（但很容易改，不改显得粗糙）**
* **在哪里：** 第 17 页（局限页讲稿）、第 20 页（附录目录）。
* **原文证据：**
  1. 第 17 页 Slide 上已经改成了“挪上座板约 10–20 cm”，但**第 17 页讲稿备注**里依然写着：“往前挪**二三十厘米**对老人是否可行，也还没有验证。”（这是上一轮指出的旧数字，讲稿忘了同步改）。
  2. 第 14 页正文和讲稿都说仿真了 **15 个场景**（待补写着 14 个场景），但**第 20 页附录目录**里依然写着：“**8 个仿真场景**的逐个说明”。
* **怎么改：** 把第 17 页讲稿里的“二三十厘米”改成“十到二十厘米”；把第 20 页的“8 个”改成“15 个”。

---

### 总体判断与最值得先做的一件事

**总体判断：**
这版方案在工程安全和生物力学建模上比之前扎实得多，“曲线座板全程兜底防坐空”的卖点非常清晰，足以拿高分。目前最大的软肋在于**“只把老人送下了床，没想好老人怎么安全回床”**——回床流程在真实居家环境里几乎无法独立完成，且造成了Slide前后文关于“空载能否下降”的直接矛盾。

**最值得先做的一件事：**
**马上修改第 4、16、18 页中“有人坐着才降”的冲突表述（改为“只有按住才降”），并重新理顺“回床”话术：** 在明日和老师沟通（或最终汇报）时，坦诚说明老人回床可以直接从床尾敞开处坐回低床沿（因为坐下顺重力，0.42 m 床沿扶着横杆就能坐），座板只需在人站稳时或上床后按住按钮降回齐平位即可；把“停在 0.50 m 坐上再降、再往后挪回床”降级为备选辅助模式，从而避开“在防滑斜坡上往后退”这个最大的实操漏洞。
