xiaweiyi0423/me5412-bedexit-proposal/presentation/audit/v2/gemini_A_argument.md

<!-- model: gemini-4-argon; finishReason: STOP; usage: {"promptTokenCount": 37536, "candidatesTokenCount": 4346, "totalTokenCount": 41882, "promptTokensDetails": [{"modality": "TEXT", "tokenCount": 14436}, {"modality": "IMAGE", "tokenCount": 23100}], "candidatesTokensDetails": [{"modality": "TEXT", "tokenCount": 4346}]} -->

这份汇报材料最让人赞赏的地方是**诚实**——你们在统一口径重算后，发现比 0.58 m 的抬高床只多省 5–10% 的力，没有掩盖数据，而是承认并试着把价值转向“平时坐得低、起身有托、防滑接人”。

但从生物力学建模和工程论证的角度看，这个转向目前停留在“口头找补”，**核心推理链断成了两截**：一边承认“机构上段没用上、几乎不比垫高床省力”，另一边却继续按 0.69 m 的全行程去做庞大的单侧悬臂结构、选型和需求定义。如果不在逻辑上把这根链条接上，答辩时会被老师一针见血地问住。

以下按重要性排序，指出真正影响得分和说服力的问题：

---

### 1. 【严重度：高】“导轨上段没用来托人”直接动摇了 0.69 m 行程和庞大机构的存在理由

*   **位置**：第 4 页（设计要求 1）、第 7 页（正文与问答）、第 8 页（机构）、第 10 页（选型）、第 16 页（验证表）。
*   **原文证据**：
    *   第 7 页：“比抬高床：只省 5–10%；72 人里 19 人反而略费力。原因：多数人在座板前倾最大（约 15°）时就离开坐垫，那时髋只比坐在 0.58 m 床上高约 4 cm；导轨上段没用来托人。”
    *   第 10 页右图（座板前倾随座面高度变化曲线）：前倾角在座面高度约 **0.55–0.56 m** 时达到峰值 15.7°，之后一路下降，到 0.69 m 时回到 0°。
    *   第 4 页要求 1 仍写着：“起身时座板跟着大腿升到约 0.69 m”。
*   **为什么是问题**：
    *   **确定事实**：你们的模型已经证明，老人在座面高度 0.56 m 左右（即前倾最大处）臀部就已经离开座板了。从 0.56 m 到 0.69 m 的这 13 cm 行程（占总上升行程 27.4 cm 的近一半），座板是在**空载追赶或者干脆脱开**。
    *   **工程代价（因果链）**：为了实现这“没用来托人”的上半段行程，你们付出了实打实的工程代价——丝杠行程做到 331 mm，导轨长 0.58 m，导致床头一侧的机构箱顶高达 0.80 m、侧视面积 2749 cm²（见第 8 页问答）。
    *   **致命追问**：听众马上会问：“既然人在 0.56 m 就离座了，为什么还要升到 0.69 m？如果只升到 0.58 m，和一个简单的床脚垫高块（几百块钱、零故障）有什么本质区别？”同时，第 16 页验证表里把“比现有办法省力”标为“部分达成”，这等于自己承认核心目标没完全立住。
*   **怎么改**：
    你们必须在两条路里选一条，把逻辑闭环：
    1.  **改需求定位（最快、最稳）**：把第 4 页和第 16 页的第 1 条设计要求从“比现有所有办法（含垫高床）省力”改为**“在不垫高床（保留 0.42 m 坐姿脚踩实）的前提下，达到甚至略优于 0.58 m 高床的省力效果，并提供高床做不到的全程防滑与防跌托举”**。同时明确解释 0.56 m 之后的上段行程是干什么用的——要么说明它是给高个子（1.75 m）或极弱用户托举用的，要么说明它是为了升上去实现“站立保持（Standing Hold）”，在人站稳但头晕时贴近臀部当高靠座接人。如果上段连这两个作用都没有，就应该直接缩短行程、把箱子做小。
    2.  **改轨迹**：如果是因为 0.56 m 之后座板角度往回平（从 15.7° 降回 0°）导致座板脱离大腿，那就修改连杆铰点，让上段保持 15° 前倾继续托着大腿往上走。

---

### 2. 【严重度：高】“往前挪 25–30 cm 上座板”这个前置动作，可能比“起身”本身还难、还危险

*   **位置**：第 6 页（一次完整的使用，图 1 及预备问答）、第 17 页（局限）。
*   **原文证据**：
    *   第 6 页讲稿：“坐在床沿，往前挪一点，坐上一块和床齐平的座板……”
    *   第 6 页问答：“问：往前挪 25–30 cm，老人做得到吗？答：这是目前最大的不确定。我们用姿态几何检查能不能放下，是否可行列入局限和后续实测。”
*   **为什么是问题**：
    *   **生物力学事实**：因为要求“床不改造”，座板只能拼在床沿外侧。老人要从床垫挪到座板上，骨盆必须向前平移 25–30 cm（几乎是一整块座板的深度）。在臀部不离开座面的情况下往前挪（Scooting），需要手臂支撑卸载体重、核心肌群控制平衡、髋部交替前移。对于“从 0.42 m 床站不起来、夜里刚醒、有体位性低血压风险”的老人，在没有两侧护栏、跨越床垫（软）和座板（硬）交界缝隙的情况下往前挪 30 cm，**极易在还没握稳开关前就直接从座板前缘滑跪到地上，或者卡在床与座板的缝隙里**。
    *   **对比反例**：如果选择“垫高床 + 床边扶手”，老人醒来翻身坐起，屁股就已经在床沿了，完全不需要这 25–30 cm 的高风险平移。你们为了省掉那 5–10% 的起身力（或为了迁就矮个子），引入了一个未建模、未验证的高风险前置动作。只把它丢在第 17 页“局限”里轻描淡写一句，绝对过不了懂临床或生物力学的审稿人这一关。
*   **怎么改**：
    *   在 **第 6 页（概念）** 和 **第 15 页（风险）** 正面解决这个转移过程，不能只说“不知道老人做不做得到”：
        1.  明确说明**怎么扶着挪**：挪动时老人双手是扶在床头一侧的机构箱顶面，还是已经够得着前方的 L 形横杆？（第 6 页问答说横杆在 x=70 cm，坐在床沿还没挪出来时手够得着吗？需要给出几何验证）。
        2.  说明**床与座板交界处怎么防卡陷**：床垫边缘是软的，人压在床沿时床垫下陷 3–5 cm，如果座板固定在 0.42 m，座板后缘就会比压陷的床垫高出一截“台阶”，老人根本挪不过去。必须说明座板初始高度是按**压陷后的床沿高度**设定的，且与床垫零缝隙紧贴。

---

### 3. 【严重度：中高】模型逻辑冲突：用“开环预设人体动作”去评测“力控自适应机构”，造成“19/72 人更费力”和传感器失真

*   **位置**：第 7 页（省力计算）、第 8 页（81 人轨迹合格）、第 12 页（传感）、第 14 页（速度控制）。
*   **原文证据**：
    *   第 7 页：“比抬高床：只省 5–10%；72 人里 19 人反而略费力。”
    *   第 8 页图注：“同一位髋早前移的用户……座板只能竖直上来，髋已经走到座板前面：只托住臀部后缘，人往前滑”。
    *   第 12 页问答：“座板下的单向测力单元只测垂直于座面的力，算不准竖直方向的体重”。
    *   第 14 页：“v = k ×（推力上限 − 座板测到的力）……个人设置：推力上限 0.3–0.6 × 体重”。
*   **为什么是问题**：
    这里有两个明显的建模与控制耦合漏洞：
    1.  **为什么有 19 个人用了机器反而比自己从 0.58 m 床站起来更费力？**（第 7 页）。在真实的力控辅助中，如果座板还在往上托人，怎么会比没有座板更费力？**合理推测**：你们的 2D 模型是先给 81 个用户预设了固定的运动学轨迹（髋怎么走、躯干怎么倾），然后把座板轨迹硬套上去算弹簧压缩和离座瞬间。对于那 19 个人，预设的起身轨迹在离座那一刻正好处于一个力学不利的姿态（比如重心还没移到脚掌上方，座板却因为轨迹限制提前脱开了）。同样，第 8 页批判“竖直升降只有 19/81 合格”，也是假设人机械地按原习惯往前冲、不等座板升起。如果人握着扶手，等竖直座板升到 0.58 m 再往前倾身站起（就像坐升降马桶一样），根本不会往前滑。如果老师问：“人为什么不能等座板升起来再往前倾？”你们整个批判竖直升降的立论就会动摇。
    2.  **第 14 页的速度公式存在余弦误差和摩擦力干扰**：第 12 页你们刚承认“座板前倾时，单向测力单元只测垂直于座面的法向力，算不准竖直体重”，第 14 页马上用 $v = k \times (\text{推力上限} - F_{\text{座板}})$，并且把推力上限设为 $0.3\text{–}0.6 \times \text{体重}$。当座板前倾 15.7° 且大腿与高摩擦座垫产生很大剪切力时，单向法向力传感器不仅漏掉了 $\sin(15.7^\circ)$ 的切向分量，还容易受倾覆力矩（大腿压在座板前缘）引起的导轨/铰点摩擦卡滞影响。
*   **怎么改**：
    *   **解释清那 19/72 人**：在第 7 页备注或附录中明确说明，为什么 19 人略费力（例如：这 19 人是高个子或特定脚位，在当前统一的导轨曲线下离座偏早；如果对他们调整扶手位置或控制器推力上限即可消除）。
    *   **补强“为什么人不能等竖直座板升起再前倾”**：在第 8 页问答里加一句生物力学解释——当座面升高而脚还在原地时，如果髋部不跟着前移，膝关节和踝关节会被迫处于极不自然的拉伸位置（或者大腿被座板前缘顶住），老人本能地会顺着膝盖方向往前移髋，因此座板必须跟着前移。
    *   **修正第 14 页公式表述**：说明由于单自由度机构位置（丝杠编码器）已知，座板倾角 $\theta(s)$ 是已知的确定函数，控制器的“座板测到的力”可以除以 $\cos\theta$ 折算回竖直辅助力，这只需要写半行字就能体现机电建模的严谨性。

---

### 4. 【严重度：中】防滑与接人论证的自我矛盾：一边说“后半程力移不过去”，一边说“全程托住、坐回接得住”

*   **位置**：设计背景说明（坐垫）、第 6 页（图 4、5）、第 9 页（讲稿）、第 15 页（风险表及问答）。
*   **原文证据**：
    *   背景说明：“坐垫：分区（后硬 10 kPa/cm、前软 3 kPa/cm），前半程把力移到骨盆段，后半程移不过去（座板前倾受 15° 防滑上限限制）。”
    *   第 9 页讲稿：“可以看到前半程推在臀部和大腿根部，后半程推在大腿上。”
    *   第 15 页问答：“问：座板前倾 15°，坐回时会不会滑下来？答：静力学上摩擦系数大于 $\tan 15^\circ \approx 0.27$ 就不滑；考虑坐回冲击和滑的睡衣，面料按 $\mu \ge 0.5$ 的高摩擦纹理面料选……”
*   **为什么是问题**：
    *   **接触力学矛盾**：前半程把支撑力移到骨盆（坐骨结节）是对的；但到了后半程，大腿角度变陡（约 30°–45°），而座板被锁死在 15° 以内，这意味着**臀部已经悬空，只有大腿中段或远端压在座板前缘上**（从第 6 页图 5 和第 15 页配图的红色接触条也能看出来，人臀部后面是空的，红条在大腿下）。如果力只推在大腿远端（靠近膝盖），这在生物力学上不仅很难帮髋关节伸展，反而会把人往后推（阻碍重心前移到脚上）。
    *   **坐回滑落风险低估**：第 15 页用 $\mu > \tan 15^\circ \approx 0.27$ 来证明坐回不滑，这是把人当成了一个没有水平速度、没有关节的木块放在斜面上。实际上，老人在离座后因头晕失力往回坐（Sit-back）时，骨盆是向后下方砸落在前倾 15° 的斜面上，同时双脚在前面顶着地面，大腿会沿着斜面产生很大的向下切向力。更重要的是，**高摩擦座垫面料防不住丝绸/棉质睡裤与老人松弛皮肤之间的相对滑动**（裤子粘在座垫上，肉在裤子里往前滑）。
*   **怎么改**：
    *   不要在第 9 页强调“后半程推在大腿上”，而是如实说：“在离座前，分区坐垫保证合力始终作用在臀部和大腿近端（靠近髋关节）；一旦大腿抬起超过 15°，人已经进入离座站立阶段，座板停在此处作为近身护盾。”
    *   第 15 页问答谈到防滑时，除了面料摩擦系数 $\mu \ge 0.5$，加上一句几何解释：**“L 形扶手横杆就在身前、踏板固定了双脚，小腿和膝盖前方受空间约束，即使睡衣打滑，人也不会从 15° 的座板上溜到地上，而是被横杆和腿部几何姿态卡住。”** 这样比单纯吹嘘面料摩擦系数要可信得多。

---

### 5. 【严重度：低】用词与细节瑕疵（容易引起不必要的误会）

*   **位置**：第 5 页（现有方案表格最后一行）、第 20 页（附录目录）。
*   **原文证据**：
    *   第 5 页对 Panasonic 专利的比较：“不同：用在床边、**不用机器人**”。
    *   第 20 页附录目录：“单自由度坐板设计（81 人、机构、坐垫、干涉、两轮审计）”连续重复粘贴了 5 行。
*   **为什么是问题**：
    *   这门课叫 *ME5412 Robotics for Healthcare*（医疗健康机器人）。你们在 slides 里写自己的方案“不用机器人”，虽然本意可能是说“不用多自由度串联机械臂”，但直接写“不用机器人”会让授课老师哭笑不得。
    *   第 20 页连续 5 行一模一样的文字，显得粗心（虽然知道你们是指有 5 页关于坐板设计的附录，但应该标出每一页具体的子主题）。
*   **怎么改**：
    *   第 5 页改为：“不同：用在床边、**单自由度紧凑机构（无需复杂多轴机械臂）**”。
    *   第 20 页把那 5 行分别标上子标题（如：1/5 81人姿态模型、2/5 机构综合与四连杆对比、3/5 分区坐垫与摩擦、4/5 空间干涉与悬臂受力、5/5 敏感性复核）。

---

### 总体判断与最值得先做的一件事

**总体判断**：
这份工作扎实度远超一般本科/研究生课程项目——有清晰的 81 人参数化人体几何模型、有同一口径下的诚实证伪与修正、有从运动学到导轨滑块受力的完整传递链。目前最大的软肋不是“算得不够多”，而是**当模型算出“比垫高床只多省 5–10% 力、且人在 15°（0.56 m）就离座”之后，你们没有及时修正需求定义和工程话术**，导致后面的长行程机构与前面的生物力学结论在打架。

**最值得先做的一件事（今天和老师沟通前就能改完）**：
重写 **第 4 页（设计要求 1）**、**第 7 页（方案比较结论）** 和 **第 16 页（验证表第 1 行）** 的核心表述：
不要再把“比 0.58 m 垫高床更省力”当成目标（从而给自己打一个难看的“部分达成”），而是把目标正式定义为：**“破解固定床高的死结——在保持 0.42 m 低床安全坐姿（81/81 脚踩实，而高床有 9 人踩不实）的前提下，提供等同于 0.58 m 高床的省力效果（比低床省 32%），并消除高床或竖直升降无法解决的起身前滑与头晕坐空风险（81/81 接得住）。”** 同时明确交代 0.56 m 以上的导轨行程是为了照顾高个子用户及实现高位的“站立保持”防跌接人。只要把这个逻辑扣死，你们的“5–10%”就不再是缺陷，而是严谨建模下的合理边界。
