xiaweiyi0423/me5412-bedexit-proposal/presentation/audit/v2/gemini_B_safety.md

<!-- model: gemini-4-argon; finishReason: STOP; usage: {"promptTokenCount": 37466, "candidatesTokenCount": 3352, "totalTokenCount": 40818, "promptTokensDetails": [{"modality": "TEXT", "tokenCount": 14366}, {"modality": "IMAGE", "tokenCount": 23100}], "candidatesTokensDetails": [{"modality": "TEXT", "tokenCount": 3352}]} -->

这份汇报材料在工程诚实度上表现很好（如主动承认新模型下比抬高床只省力 5–10%，没有夸大数据），控制与安全框架也响应了老师对“握把输入、力传感、状态机、稳定性”的要求。

但从**医疗与护理设备安全评审**的角度看，你们为了解决某些问题引入的新设计（如“底座四角测力自检”、“和床固定”、“10 秒无操作自动下降”），在物理逻辑和异常工况下存在严重的自相矛盾和漏掉的致命风险。以下是按重要性排序的核心问题：

---

### 1. 【严重度：高】“和床固定”与“底座四角测力自检”在物理上直接冲突，会导致系统在正常使用时频繁锁死
* **位置**：第 11 页（稳定性）、第 12 页（传感与交互）、第 13 页（状态机）。
* **原文证据**：
  * 第 11 页：“台架必须和床固定，固定件按扶手的设计载荷…大约需要 2282 N 的拉力。”
  * 第 12 页：“5 底座四角测力：总重减去台架自重应约等于体重，对不上就锁住”；问答备注：“底座四角测的是对地总力，减去台架自重就是体重，和座板倾角、手怎么用力都无关。”
  * 第 13 页状态机图：`any state` 只要满足 `sensor sum != BW` 就跳入 `LOCKED`（锁定）。
* **为什么是问题**：
  * **确定的力学事实**：一旦台架和床刚性固定（床腿夹或床垫下压板），台架在力学上就不再是独立支撑体，而是与床形成了超静定结构。当人坐在座板上偏载（659 N·m 悬臂力矩）或拉扯扶手时，固定件会承受很大的内力和弯矩，其中的**竖直分力会直接传给床，从而分流或增加底座四角对地的压力**。
  * **确定的日常场景事实**：老人从床沿往前挪动坐上座板的过程中，以及刚坐稳时，臀部或大腿后侧很可能还压在床垫边缘（人体重量由床和起身台共同分担）。此时底座测到的力必然远小于预设的个人体重（BW）。
  * **后果**：按照第 13 页的状态机（`any state` 下重量不等就锁死），老人每次从床上挪向座板的一瞬间，或者在抬升中拉扶手导致固定件吃力时，系统就会判定“传感器失效”并进入 `LOCKED` 状态，设备根本无法正常使用。
* **怎么改**：
  1. **改状态机触发时机**：绝对不能在 `any state`（尤其是刚坐上、挪动、施力拉扶手时）做总重等于预设体重的硬校验。
  2. **改自检逻辑**：传感器防失效自检应该在**空载待机（IDLE）**时检查四角以及座板、踏板传感器的零点漂移；在有人负载时，只能用“座板法向力投影 + 踏板力 + 横杆力 ≈ 底座四角增量（允许较大固定件分流裕度）”做粗略的合理性互锁，而不是死卡预设体重 BW。

---

### 2. 【严重度：高】状态机在异常停机（STOPPED）后“10 秒无操作自动下降”，违反医疗设备“按住才动”铁律，且对晕厥老人极度危险
* **位置**：第 13 页（状态机）、第 14 页（速度随人自适应）。
* **原文证据**：
  * 第 13 页状态机图：从 `STOPPED` 到 `LOWERING` 的转换条件写着 `occupied and (DOWN or 10 s no input)`；讲稿写：“按住‘降’，或坐着一段时间没有操作，才带人慢慢降”。
  * 第 14 页右侧仿真图第 6 个场景（`Faints: lets go mid-lift`）：可以看到老人在第 10 秒晕倒松手，进入 `STOPPED`（棕色条），第 20 秒时系统自动进入 `LOWERING`（深黄色条）把座板降了下去。
* **为什么是问题**：
  * **确定的事实**：你们在第 4、5、12 页反复强调安全原则是“按住式开关（Hold-to-run）”，但这里却设计了一个“无人按键、仅靠延时就自动启动机械运动”的逻辑。
  * **因果与风险推测**：当老人在抬升中途因体位性低血压头晕、喘息，甚至如仿真场景所写“晕倒松手（Faints）”时，他正处于姿态失控、瘫软在座板和横杆之间的高危状态（手脚可能已经滑出正常位置，垂在座板边缘或床沿间隙）。此时机器在没有任何指令的情况下突然自己往下降、座板角度发生改变，极易导致昏迷或无力的老人从座板上滚落、卡在横杆与座板之间，或夹伤肢体。对于清醒但只是想停下来歇口气、缓一缓头晕的老人，10 秒钟后座板突然自己塌下去，也会造成严重的惊吓和二次失稳。
* **怎么改**：
  * **删掉 `or 10 s no input` 的自动下降逻辑**。在有人占用（`occupied`）时，保持 `STOPPED` 抱死状态才是最安全的静态支撑。
  * 下降必须严格由人为意图触发：要么老人缓过来后自己按住“降”按钮，要么由被警报叫来的家属操作（或拉应急慢降拨杆）。如果老人晕倒（松手且座板仍有大载荷超过 10 秒），系统应该做的是**触发声光报警求助**，而不是自己乱动。

---

### 3. 【严重度：高】机械应急拨杆位置不合理，且缺少“带电故障时切断电机出力”的电气互锁
* **位置**：当前设计背景说明、第 10 页（推杆选型）、第 15 页（风险和对策）。
* **原文证据**：
  * 背景说明：“握把旁拉索拨杆，拉住才降、松手即停”。
  * 第 10 页讲稿：“滚珠丝杠…加一个失电常闭制动器…应急时拉握把旁边的拨杆，制动器松开，人的重量把座板慢慢压下去，离心限速器把速度限在每秒 10 厘米左右”。
* **为什么是问题**：
  * **因果 1（误触与惊吓）**：把机械解抱闸的拉索拨杆放在“握把旁边”。老人在夜里摸黑、头晕或腿软抓握横杆时，极易误抓或误抠这个拨杆。一旦误拉，制动器直接机械松开，座板以 10 cm/s 的速度（这是你们设定的正常最大升降速度 1.5–4 cm/s 的 **2.5 到 6 倍**！）突然下坠，老人会以为机器塌了而本能地死抓不放，导致一路坠到底。
  * **因果 2（机电对抗风险）**：第 15 页说该对策应对“断电、卡住”。如果是断电，松开失电制动器没问题；但如果是**控制器死机或传感器卡住导致电机仍在往上顶（或处于伺服位置保持状态）**，此时单靠拉索强行机械掰开制动器，电机扭矩会和人的重力以及制动器直接对抗，不仅降不下来，还可能烧毁电机或造成机械冲击。
* **怎么改**：
  1. **补充电气互锁**：明确说明拉动应急拨杆的最初行程会触发一个物理微动开关（常闭触点断开），**直接硬件切断电机驱动器的电源（STO / 急停回路）**，然后再机械松开抱闸。
  2. **改善人机位置与速度**：应急拨杆不应紧贴日常发力的主握把，应加防护盖或设在立柱侧面（带夜光标识），防止抓握横杆时误触；同时重新评估 10 cm/s 对老人是否过快（建议限速在 3–5 cm/s 以内）。

---

### 4. 【严重度：中】单点力传感器控制速度，忽略了“身体前倾挤压横杆”造成的测力失真与飞车风险
* **位置**：第 12 页（传感与交互）、第 14 页（速度随人自适应）。
* **原文证据**：
  * 第 12 页：“1 座板下测力（法向力）：坐上了没有、坐正了没有（压力中心）；推了多少力（速度规则）”。
  * 第 14 页：“`v = k × (推力上限 − 座板测到的力)`。人卸掉多少体重，座板就升多快”。
* **为什么是问题**：
  * **确定的事实**：要同时测“压力中心（CoP）”和“法向总力”，座板下不能只是一个单点测力单元，至少需要 3–4 个测力传感器阵列（图文表述需统一）。
  * **异常工况推演（重点）**：公式假设“座板测到的力变小 = 人靠自己的腿站起来了”。但在两种常见异常下，座板力也会急剧变小：
    1. 老人腿没劲，但他双手死死握住开关，整个上半身往前扑、挂在身前的横杆上（或肚子顶在横杆上）。此时体重转移到了横杆上，座板法向力减小。
    2. 座板升到前倾 15.7° 时，老人虽然没滑下座板，但产生较大的沿座面向前的剪切分力，导致垂直于座面的**法向力**减小。
    在这两种情况下，老人其实根本没站稳，但控制器看到座板法向力变小，会误以为“人自己发力卸荷了”，从而**加速向上顶推座板**，把处于失衡边缘的老人往前上方猛推。
* **怎么改**：
  * 在第 12 页和第 14 页讲清楚：**既然装了踏板测力（4号）和横杆测力（2号），为什么速度公式里不用？**
  * 最稳妥的改法：把速度自适应规则加上互锁条件——只有当“座板力减小”**同时伴随“踏板受力相应增加”**（证明重量是真正转移到了脚上，而不是挂在扶手上或悬空）时，才允许按公式提速；如果横杆承受了过大的向下/向前载荷，应限制抬升速度或暂停。这也会让你们布置的 5 组传感器在逻辑上真正形成闭环，而不是摆设。

---

### 5. 【严重度：中】座板与床垫之间的动态剪切/挤压风险未纳入风险表，固定件形式存在安全隐患
* **位置**：第 11 页（稳定性）、第 15 页（风险和对策）、第 16 页（验证）。
* **原文证据**：
  * 第 15 页：“夹手、夹腿：机构全封闭在床头一侧的箱里…座板侧缘到箱壁 3 cm（大于 25 mm）。”
  * 第 16 页：“机构箱离床 2.1 cm”。
  * 第 11 页：“固定件的具体形式（床腿夹或床垫下压板）…固定件需要的拉力 2282 N”。
* **为什么是问题**：
  * **漏掉的剪切区**：第 15 页只考虑了座板和机构箱的间隙，完全漏掉了**座板后缘与床沿之间的动态间隙**。当座板从 0.69 m 降回 0.42 m（尤其是人走开后的 `RESET_EMPTY` 自动复位，或带人下降时），座板后缘会紧贴着床沿往下、往后运动。如果此时床上的被子、床单垂下来，或者同床伴侣的手搭在床沿，甚至老人回床坐下时手扶在床沿上，就会形成直接的剪切和卷入。
  * **固定件可行性事实**：第 11 页提到用“床垫下压板”承受 2282 N（约 230 公斤）的拉力。普通家用床垫仅重 20–40 公斤且是软的，压板插在床垫下受 2282 N 的水平/斜向拉力会直接被抽出来或把床垫掀翻，根本不可能提供这么大的锚固力。
* **怎么改**：
  * **第 15 页（风险表）**：在“夹手、夹腿”一条中，补充“座板后缘与床垫间隙的防夹”（例如：座板后缘软包缓冲、下降遇阻/电机电流异常立即停机回退）。
  * **第 11 页（固定件）**：删掉“床垫下压板”这种抗拉能力极弱的说法，明确固定件必须锁紧在**床框硬质结构或床腿**上，或采用绕过整个床架的对拉绑带（类似医用床边护栏的标准固定方式）。

---

### 总体判断与最值得先做的一件事

**总体判断**：
这份材料展示了扎实的工作量和诚实的工程态度，但在“安全与控制逻辑”上存在**模块间各自为政**的问题——负责结构稳定性的同学加了“和床固定”，负责传感的同学写了“底座测重等于体重”，负责状态机的同学写了“10秒不动自动降”和“单看座板力调速”，这几条凑在一起在真实物理世界里会互相打架，甚至制造新的危险。由于老师明确把“操作安全、力分布传感、状态机”列为核心考察点，这些逻辑漏洞在答辩时非常容易被一眼看穿。

**最值得先做的一件事（今天内完成）**：
在 10/27 找老师 consultation 之前，**由角色 4（结构安全）和角色 5（控制仿真）立刻对齐并修改第 12、13、14 页的控制逻辑图与表述**：
1. 删掉 `STOPPED` 状态下“10 秒无输入自动下降”的危险规则；
2. 修正“底座四角测力 != 体重就随时锁死”的规则（改为待机零点自检 + 运动中结合踏板力的合理性检验），消除与“床体固定件分流载荷”的物理冲突。这两处改完，你们的安全逻辑就基本立于不败之地了。
