xiaweiyi0423/me5412-bedexit-proposal/page/v13/audit/gemini_B_safety.md

<!-- model: gemini-4-argon; finishReason: STOP; usage: {"promptTokenCount": 78019, "candidatesTokenCount": 4799, "totalTokenCount": 82818, "promptTokensDetails": [{"modality": "TEXT", "tokenCount": 54188}, {"modality": "IMAGE", "tokenCount": 23831}], "candidatesTokensDetails": [{"modality": "TEXT", "tokenCount": 4799}]} -->

作为个人护理机器人（ISO 13482）和医用电气设备（IEC 60601）的安全评审员，我重点审查了 `controller_v13.py` 的代码实现、网页上的状态机逻辑，以及第 13 版新增的回床流程。

第 13 版修复了第 12 版“压床垫误锁”和“迈步误锁”两个明显漏洞，方向是对的。但深入看代码和物理场景，**有几个核心安全声明在物理和代码上并不成立，仿真脚本里也存在为了跑通场景而“喂假数据”的作弊行为**。以下是按重要性排序的问题清单：

---

### 1. 【高】“两根立柱不同步时按‘降’慢降”在物理上是危险的，且仿真篡改了故障数据

* **位置**：`controller_v13.py` 的 `Controller.step`（第 102–103 行）与 `run`（第 157 行）；网页 `#sims` 的“两根立柱不同步”卡片（截图 `05_sims.png` 右下角）。
* **代码与网页证据**：
  * 代码第 60 行：检测到 `sync_err > 0.005`（5 mm）时进入 `LOCKED`。
  * 代码第 102–103 行：在 `LOCKED` 状态下，`if z["down"] and z["power"]: v_cmd = -P.v_down * 0.5`。
  * 网页仿真图“两根立柱不同步”显示：在 8.5 s 锁死后，14 s 时座高从 0.51 m 平滑地降回了 0.42 m。
* **为什么是问题**：
  1. **物理与安全漏洞（事实）**：网页在 `#structure` 中写明“座板和扶手装在同一个刚性滑架上”。两根升降柱出现 > 5 mm 的高差，原因无非是：① 一根柱子卡死或电机断路；② 一根柱子的霍尔传感器丢步。在刚性滑架已經别住（甚至歪斜）的情况下，如果不做单柱纠偏，而是直接给两根柱子下发相同的下降指令（`v_cmd = -0.01`），要么卡死的柱子不动、另一根继续降导致**滑架彻底掰弯或把老人掀翻**；要么机械咬死引发电机过流。
  2. **仿真作弊（事实）**：为什么仿真图里座板能顺利降回 0.42 m？因为第 157 行写的是：`sync_err=0.008 if (ev.get("sync_fault") and t >= ev["sync_fault"]) else 0.0`，而控制器只用单一变量 `self.h` 积分速度。仿真根本没有模拟两根柱子的独立位置，而是一边让 `sync_err` 恒等于 8 mm，一边让座板完美水平下降。
* **怎么改**：
  * **控制规则**：把 `LOCKED` 拆分为两类，或者针对不同步故障（`SYNC_FAULT`）采取**硬锁死（禁止任何直驱下降）**，报警提示用户从侧边扶着横杆站起或挪回床垫（0.51 m 离床垫落差仅 9 cm）；或者明确写“降”指令在此时是**闭环纠偏模式**（只降较高的那一根柱子，直到高差回到 < 2 mm 再同步慢降）。
  * **仿真修改**：如果保留“纠偏慢降”，在仿真里用 `h_left` 和 `h_right` 两个变量演示高差消除后再同步下降；如果改为硬锁死，把 `sync` 场景里的 `down_from=14.0` 删掉，让座板停在 0.51 m。

---

### 2. 【高】力之和自检（Weight-sum check）存在正负号与矢量漏洞：往上拉横杆就能绕过故障或引发误锁

* **位置**：`controller_v13.py` 的 `Controller.step`（第 48、56 行）；`seat_support.py`；网页 `#control`。
* **代码证据**：
  * `controller_v13.py` 第 48 行：`total = z["F_seat"] + z["F_feet"] + max(0.0, z["F_bar"])`
  * 第 56 行：`ready = z["grip"] and z["F_bar"] > P.grip_thr ...`（`grip_thr = 20.0` N）
* **为什么是问题**：
  1. **物理方向混淆（事实）**：准静态平衡方程是 $F_{\text{seat},z} + F_{\text{feet},z} + F_{\text{bar},z} = BW$，其中 $F_{\text{bar},z}$ 是**横杆对人手向上的支撑力**（即人向下压横杆时为正，向上拉横杆时为负）。但在起床前半段（身体前倾），老人往往是**向后/向上拉横杆**借力的（见网页 `#night` 第 2 步“手拉横杆借力”，以及 `seat_support.py` 中允许 $F_z < 0$ 和水平力 $F_x$）。
  2. **控制逻辑矛盾（事实）**：
     * 如果 `F_bar` 测的是**竖直向下压的力**（向下为正）：当老人向后/向上拉横杆时，$F_{\text{bar}} \le 0$，此时第 56 行的 `z["F_bar"] > 20.0` 根本不满足，**台架会拒绝启动或中途急停**！而且一旦向上拉（$F_{\text{bar},z} < 0$），脚和座板的力之和会**大于体重**（$F_{\text{seat}} + F_{\text{feet}} = BW - F_{\text{bar},z} > BW$），代码中 `max(0.0, z["F_bar"])` 把负值截断为 0，如果拉力超过 15% 体重（而模型允许手部力达到 25%–30% 体重！），自检就会**正常使用误锁**。
     * 如果 `F_bar` 测的是**手部合力大小** $\|\mathbf{F}_{\text{bar}}\|$（永远为正）：那么把水平拉力 $F_x$ 加进竖直重力平衡方程里，物理量纲和方向完全是错的。
     * **仿真掩盖了这个问题**：在 `run()` 第 147 行，作者硬编码了 `F_bar = 60.0`（約 0.1 BW 向下压），然后倒推出 `F_feet = BW - F_seat - F_bar`，用恒等式满足了自检，完全脱离了 `seat_support.py` 算出的真实手部三维/二维力矢量。
* **怎么改**：
  * **明确传感器定义**：横杆传感器必须测**竖直分力 $F_{\text{bar},z}$**（双轴测力或仅测竖直剪切力），且**不能用 `max(0.0, F_bar)` 截断负值**，直接带符号求和：`total = F_seat_z + F_feet_z + F_bar_z`。
  * **修改 `ready` 条件**：判断“手在横杆上”已经有握把按压开关 `grip` 了；如果要用力传感器做双通道校验，应判断合力的模长 $|\mathbf{F}_{\text{bar}}| > 20\text{ N}$，而不是竖直向下的分力。

---

### 3. 【高】新的回床流程：坐上高处 14 cm 窄座板，不仅有滑落风险，还会触发控制器状态死锁/振荡

* **位置**：网页 `#night` 第 8–10 步（截图 `step_08.png` 至 `step_10.png`）；`controller_v13.py` 第 61–73、89–98 行。
* **代码与网页证据**：
  * 网页第 9 步：“座面约 0.62 m……座板只有 14 cm 深；坐得太靠后会越过后缘，滑向低 0.2 m 的床垫。”
  * `controller_v13.py`：进入 `SEATED` 需要 `F_seat > 0.40 * BW`（第 47、89 行）；在 `LOWERING` 中一旦 `not occupied`（即 `F_seat <= 0.40 * BW`）立即跳到 `STOPPED`（第 96 行）；在 `SEATED` 中只有 `F_seat < 0.05 * BW` 且脚离开踏板才退回 `EMPTY_HOLD`（第 66–67 行）。
* **为什么是问题**：
  1. **人机工程与安全风险（高确定性推论）**：让夜里刚上完厕所、疲惫的老人，在背对床的情况下，去瞄准一个高出床面 20–24 cm、只有 14 cm 深（差不多一拃宽）的悬空窄板坐下，风险极高。为了怕掉进后面的落差坑里，老人本能会**只敢浅浅地搭在座板前缘**，同时双手死死撑住横杆、双腿在踏板上绷紧。
  2. **控制状态死胡同（代码事实）**：
     * **情况 A（落在 5%–40% 盲区）**：老人浅坐在座板边缘，座板受力只有 0.30–0.38 BW（其余重量在脚和横杆上）。此时 `occupied` 为 `False`，状态机一直卡在 `EMPTY_HOLD`。此时老人去按“降”（`down=True`），看看代码第 90–94 行会发生什么：因为 `F_seat`（0.35 BW）大于 `seatoff_thr`（0.05 BW），控制器既不进 `SEATED`，也不进 `EMPTY_MOVE`，**按“降”完全没反应**！
     * **情况 B（下降途中抖动急停）**：假设刚坐下时冲击力让 `F_seat` 超过了 0.40 BW，进入了 `SEATED` 并按“降”进入 `LOWERING`。下降开始后老人本能地用脚踩踏板稳住身体，`F_seat` 一旦跌破 `0.40 BW`（比如降到 0.38 BW），第 96 行 `if not occupied: self.go("STOPPED")` **瞬间触发急停**！而且代码里没有任何迟滞区间（Hysteresis），在 0.40 BW 附近会频繁卡停。
     * **情况 C（高处没有 COP 检查）**：抬升时要求 `cop_ok`（压力中心在安全区），但**高处坐下按“降”时（第 69、95 行）完全没有检查 `cop_ok`**！如果老人半边屁股悬空坐在高处按“降”，台架会照常启动运动。
* **怎么改**：
  1. **代码逻辑（必改）**：
     * 给 `occupied` 加迟滞（Schmitt trigger）：进入 `SEATED` 用 `> 0.35 BW`，但在 `SEATED` 或 `LOWERING` 中维持“有人坐着”的门槛降到 `> 0.15 BW`（只要没离座就算有人），避免下降途中因脚分担重量而急停。
     * 在 `LOWERING` 的触发和保持条件里加上 `cop_ok`（座板压力中心未严重偏出边缘），一旦坐歪在边缘，语音/灯光提示“请往里坐稳”，不启动盲降。
  2. **流程备选方案（应付老师提问）**：网页开放问题第 7 条已经提到“10/27 问老师座板整夜停在高处是否可接受”。在安全评审看来，**更好的设计是：人回来站在床边地上，按一下扶手外侧的“回床准备”键（或按住“降”），让空座板先降到 0.48–0.50 m（只比床高 6–8 cm），再坐上去**。这样既比 0.42 m 容易坐，又消除了 24 cm 的高空悬崖落差。

---

### 4. 【中】“有人坐着按一下‘降’就自动降到底”违反了个人护理机器人的 Hold-to-run（按住才动）安全原则

* **位置**：网页 `#control`（“按‘降’或坐着 20 s 没有操作……带人降到床面”）、`#night` 第 10 步（“按一下‘降’”）；`controller_v13.py` 第 69、95 行。
* **代码证据**：
  * `run()` 第 137 行：`down=4.5 <= t < 5.0`（只按了 0.5 秒）。
  * `Controller.step()` 第 69 行：在 `SEATED` 状态，`elif z["down"] and self.h > H0 + 1e-3: self.go("LOWERING")`；而在 `LOWERING` 状态（第 95–98 行），**完全不检查 `z["down"]` 是否松开，也不检查手是否握在横杆上**，直接一路降到 `H0`。
* **为什么是问题**：
  * 座板从 0.66 m 降回 0.42 m 的过程中，座板后方与床垫之间、座板下方与护罩之间存在**剪切和挤压区（Pinch point）**。网页 `#risk` 第 9、13 条也承认了“夹手、夹脚”和“夹在座板和床垫之间”的风险。
  * 如果采用“点按一下就自动降到底（One-touch latch）”，老人在 10 秒的下降过程中如果手滑落到座板和床垫缝隙里，或者被子/衣服卷入，**松开手并不能让机器停下**（因为下降不要求握住握把，也不要求按住按钮）！这与老师邮件第 3 条强调的“手握输入、操作安全很关键”以及 README 里的“松手即停”背道而驰。
* **怎么改**：
  * **正常回床下降也改为“按住‘降’（或握住握把）才降，松手即停”**。既然起床能握住开关 9–12 秒，回床坐着按住开关 10 秒完全没有负担。
  * 唯一允许不按按钮自动下降的特例，是 `20 s 无操作超时（防晕倒滞留高处）`，且在这个自动下降模式下，不仅有 17 s 提示音，还必须启用更严格的阻力/力偏差检测（一旦碰到异物使座板力突变立即停机）。

---

### 5. 【中】仿真里的另外两处逻辑缺陷：晕倒场景“带病起跳”，压力中心（COP）安全门形同虚设

* **位置**：`controller_v13.py` 的 `Controller.step`（第 79–88 行）与 `run`（第 147–156 行）。
* **代码证据**：
  1. **晕倒后误入 `STANDING_HOLD`**：在 `LIFTING` 状态（第 73–74 行），一旦松手（`not z["grip"]`），立即跳入 `STOPPED`。到了下一个周期进入 `STOPPED`（第 81 行）：`elif z["F_seat"] < P.seatoff_thr and z["F_feet"] > P.feet_thr: self.go("STANDING_HOLD")`。注意：**如果老人在座板刚卸力（`< 5% BW`）的瞬间手滑脱或向前栽倒，控制器在 `STOPPED` 里居然不看时间，一帧之内就会跳进 `STANDING_HOLD`（认为老人已经安全站稳了）**，从而彻底绕过了 `STOPPED` 里的 20 秒超时自动下降救援！仿真里的 `faint` 场景之所以没暴露这个 bug，是因为第 121 行写了 `sc("faint", ..., release=9.0, sitback=9.0)`，在松手的同一毫秒让座板受力瞬间跳回了 `0.79 BW`。
  2. **`cop_ok` 永远为 `True`**：代码第 137 行和第 154 行，所有 12 个场景都硬编码了 `cop_ok=True`。网页和老师邮件都把“压力中心（COP）与力分布传感”作为核心安全卖点，但控制器仿真里甚至没有一个场景测试过 `cop_ok=False`（例如坐偏、身体侧倾时停止抬升）。
* **怎么改**：
  * 删掉 `STOPPED` 状态里第 81 行跳往 `STANDING_HOLD` 的捷径（或者要求 `grip` 恢复且持续 0.3 s 才能进 `STANDING_HOLD`）。因故障/松手进入 `STOPPED` 后，决不能自动判定为“站立成功”。
  * 在 `SCEN` 里把某个次要场景（或者在附录里）加上一个 `cop_fault` 脉冲测试，证明 `cop_ok=False` 能立刻触发制动。

---

### 6. 【低】速度控制器的瞬态行为：到顶硬截断与速度不连续

* **位置**：`controller_v13.py` 第 77、82、104–105 行。
* **代码证据**：
  * 第 77 行：`if self.h >= H1 - 1e-4: v_cmd = 0.0`
  * 第 105 行：`self.v = v_cmd if v_cmd == 0.0 else self.v + dv`
* **为什么是问题**：
  * 第 104 行算了最大加速度限制 `dv = np.clip(..., -a_max*DT, a_max*DT)`，但第 105 行写着：**只要 `v_cmd == 0.0`，无视减速度限制，速度在 0.02 秒内直接清零**！对于急停（松手）这可以解释为电磁抱闸动作；但对于正常升到 0.66 m 到顶（比如 `weakest` 用户）或者人慢慢往回坐使 `F_seat` 刚巧触及 `0.5 BW`，机器不做平滑减速而是直接抱死急停，会把站在高处的老人晃倒。
  * 另外，在 `STOPPED` 状态（第 82 行），恢复抬升要求 `grip_edge`（必须先松开手再重新握紧）。如果老人只是因为脚下重心晃了一下（`cop_ok` 闪断了 0.1 秒）导致进入 `STOPPED`，手一直死死攥着握把，台架就会一直停在那儿不动，直到老人反应过来“要先松手再捏一次”。这需要在界面提示上说明（比如握把震动或指示灯闪烁提示重握）。

---

### 总体判断与最值得先做的一件事

**总体判断**：
第 13 版在控制架构上比第 12 版成熟很多，状态机划分、传感器自检窗口期（高于床面 3 cm 才检）和起身模型的联动都很有说服力，完全达到了 ME5412 课程对概念与仿真的要求。但目前代码里存在**物理符号矛盾（横杆拉力 vs 压力）**、**高处回床的阈值死区**，以及**不同步故障下强行双柱下降**这三个会被细心评委一眼看穿的硬伤。

**最值得先做的一件事（10/27 见老师前就能改完）**：
打开 `controller_v13.py`，花 20 分钟把 **问题 1、2、3 的代码逻辑修好**：① 把 `F_bar` 的力之和自检改为带正负号的竖直分力，并用真实力平衡驱动仿真；② 给 `occupied` 加上迟滞区间（进入 `0.35 BW`，保持 `0.15 BW`），消除高处坐下和下降途中的卡死风险；③ 修正 `sync` 不同步锁死后的处理逻辑。同时准备好向老师请教：**“回床时是让座板停在 0.62 m 高处让人直接坐，还是先一键降到 0.48 m 再坐更安全？”** 这会显得你们对个人护理机器人的安全边界思考得非常透彻。
