xiaweiyi0423/me5412-bedexit-proposal/model/calc_v13/controller_seat_all.png

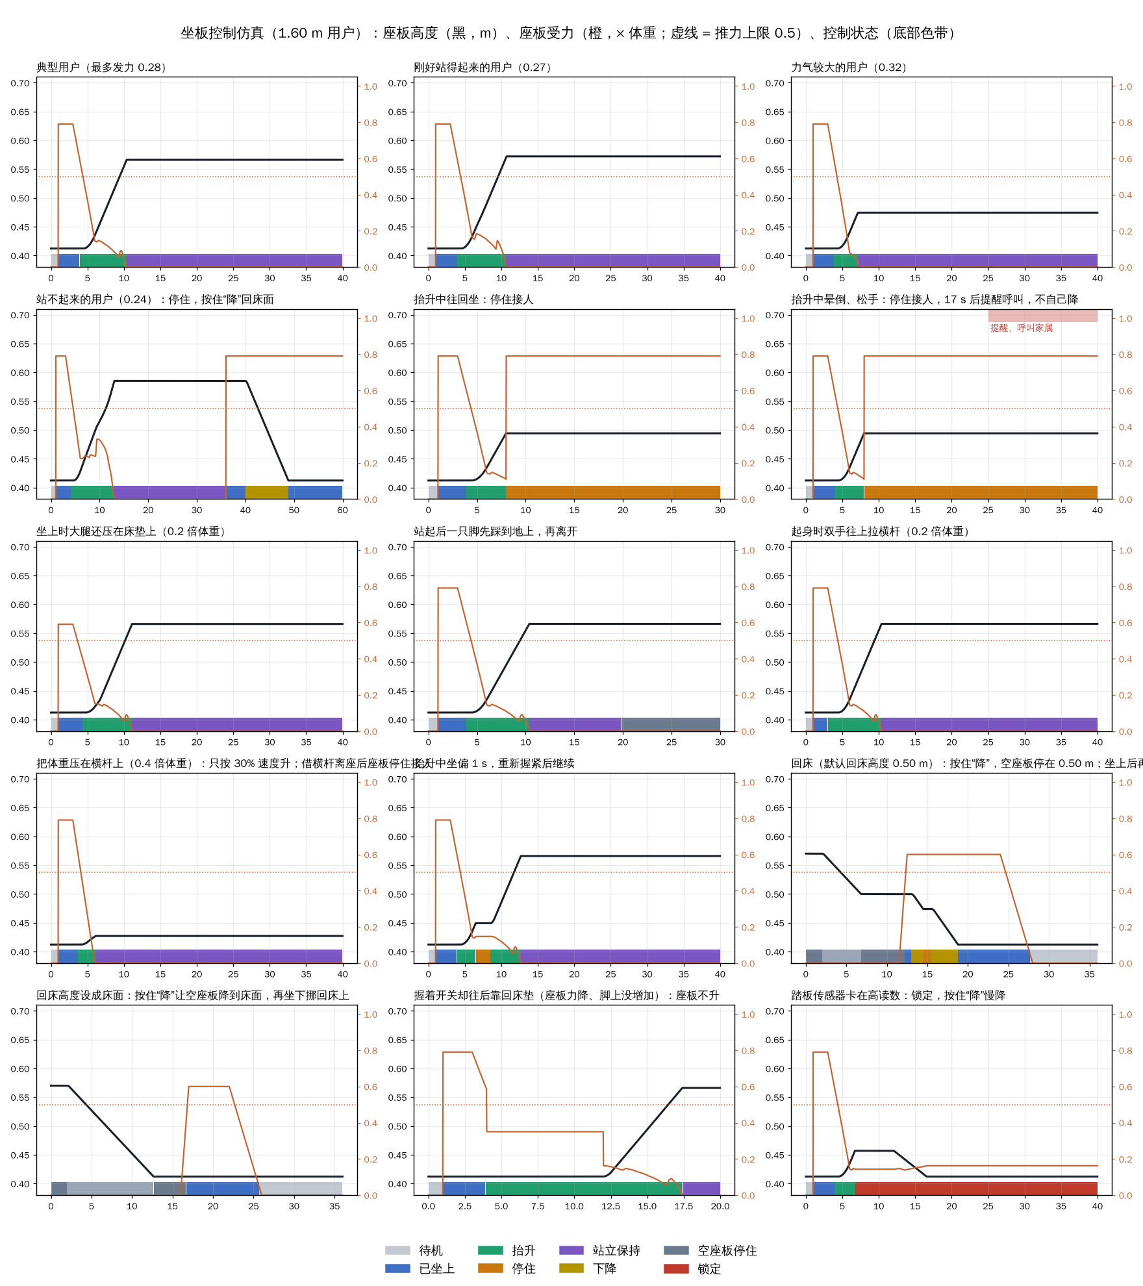
model/calc_v13/controller_seat_all.png
