xiaweiyi0423/me5412-bedexit-proposal/model/calc_v13/controller_seat_main.png

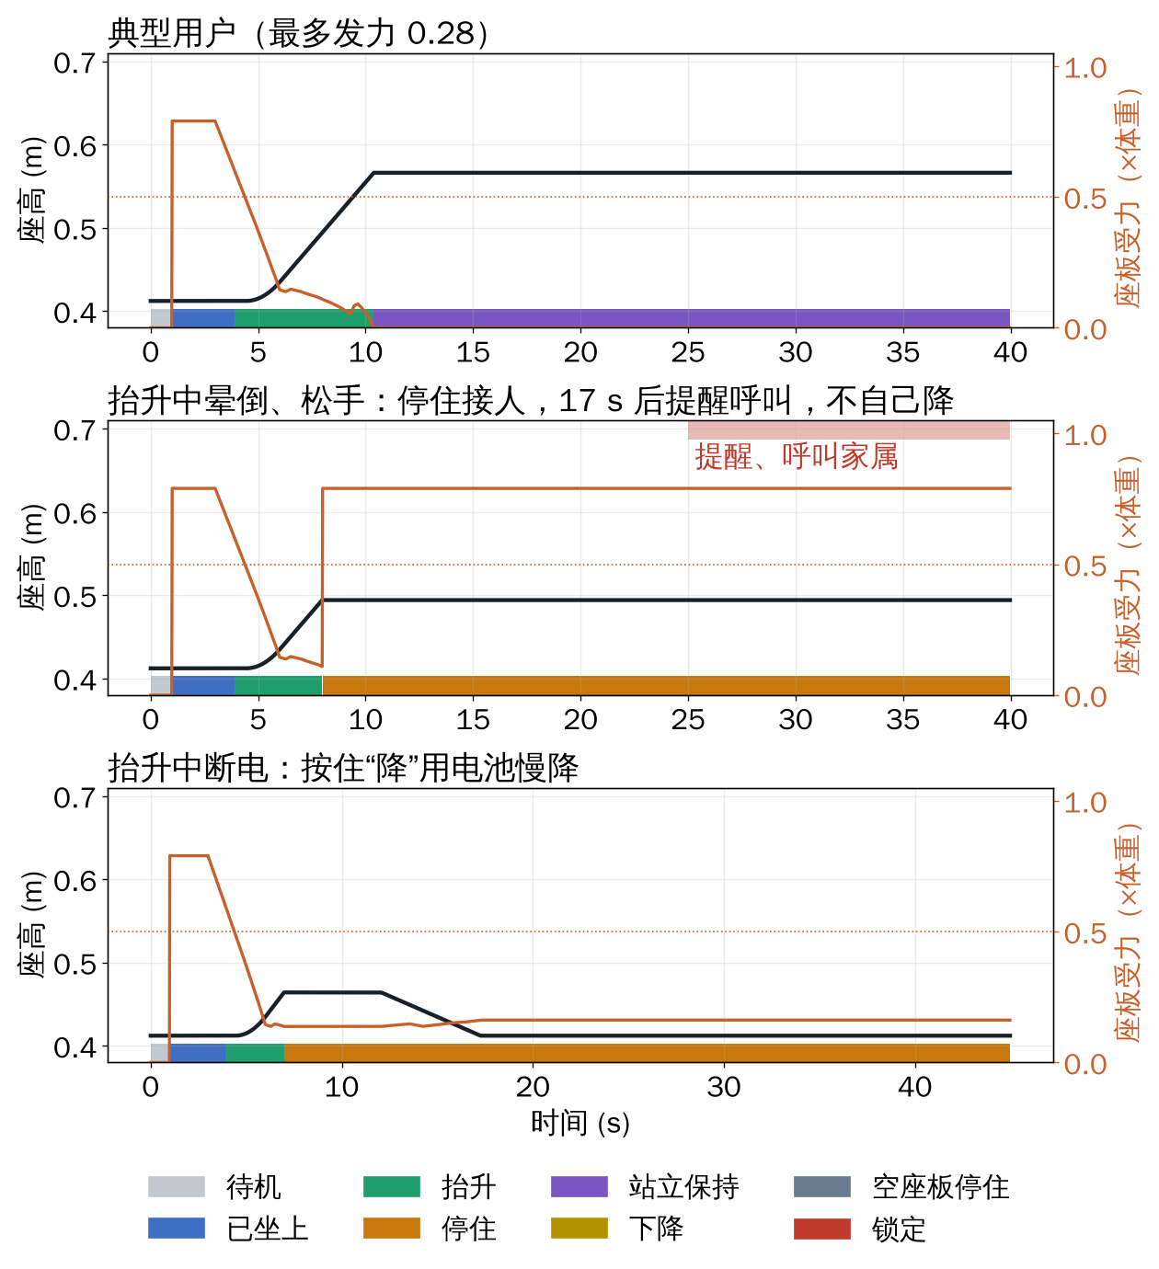
model/calc_v13/controller_seat_main.png
