xiaweiyi0423/me5412-bedexit-proposal/model/calc_v13/controller_v13.png

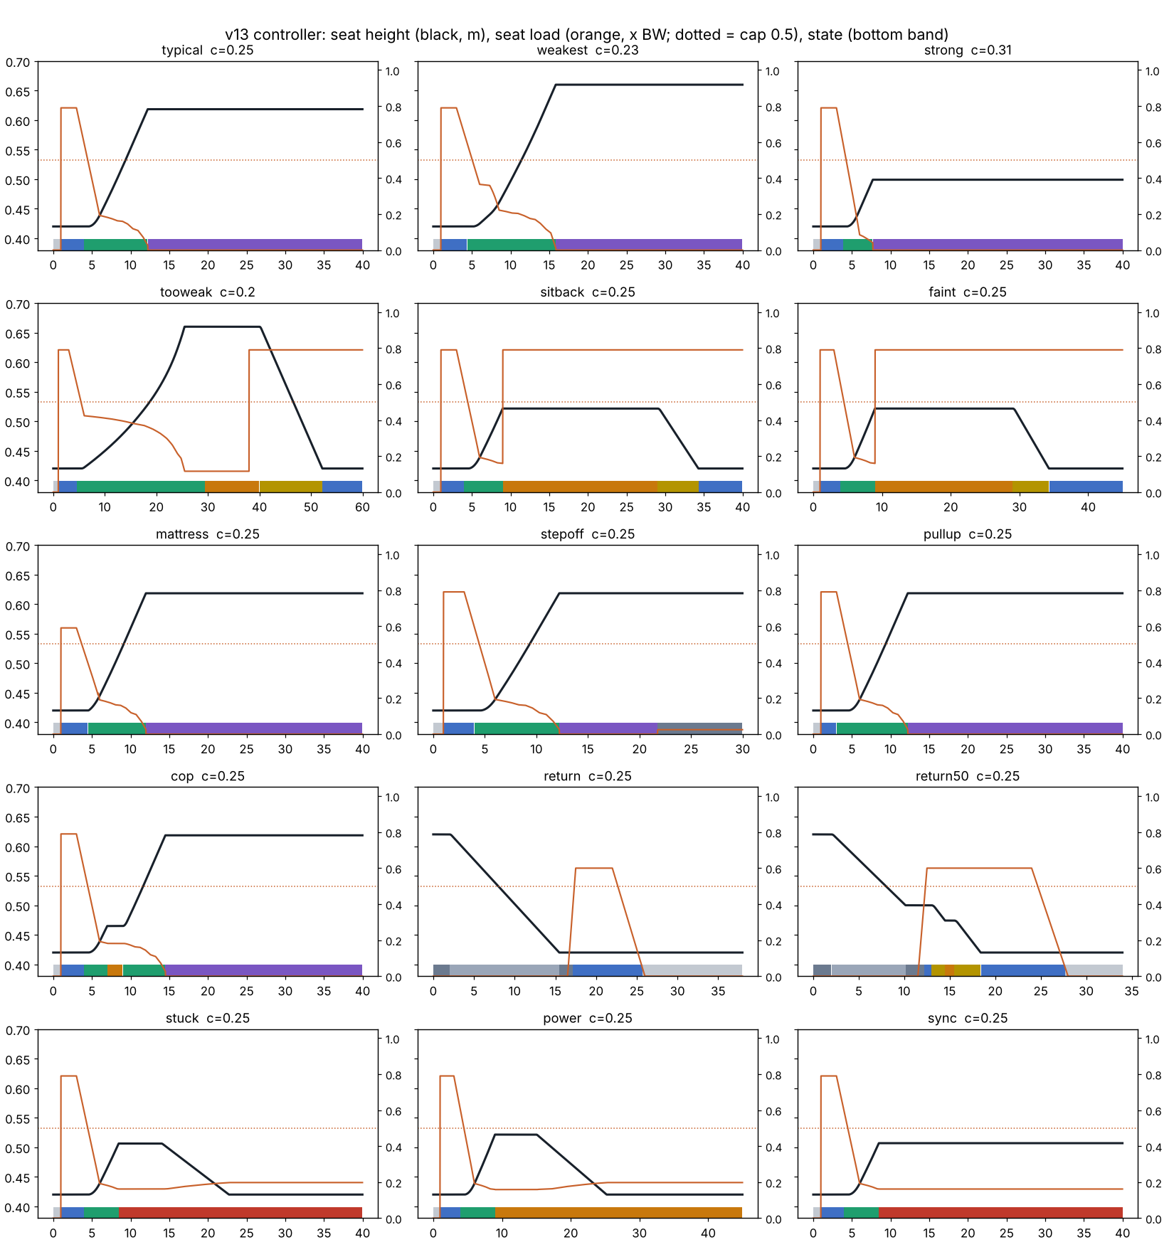
model/calc_v13/controller_v13.png
