xiaweiyi0423/me5412-bedexit-proposal/model/calc_v13/seat_1dof/lateral.png

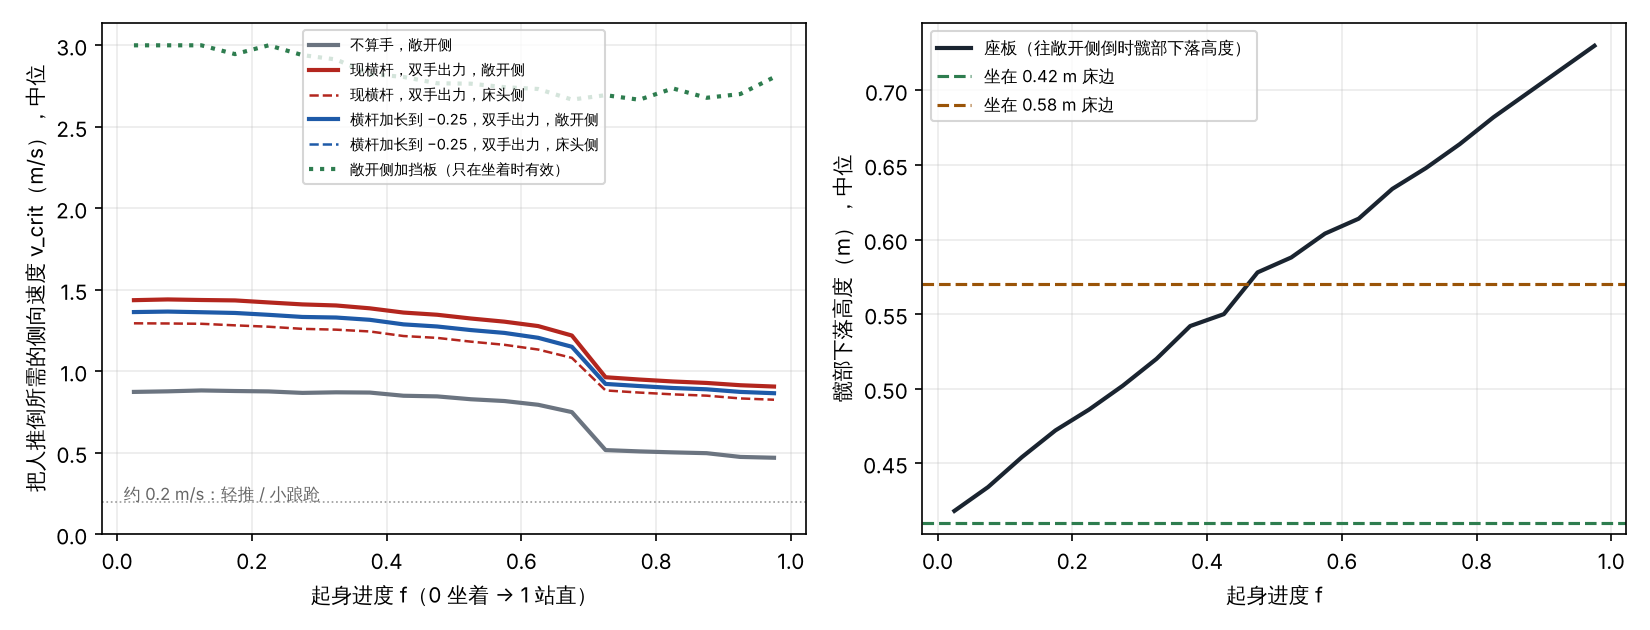
model/calc_v13/seat_1dof/lateral.png
