xiaweiyi0423/me5412-bedexit-proposal/model/calc_v13/seat_trajectory/stages_leanfirst.png

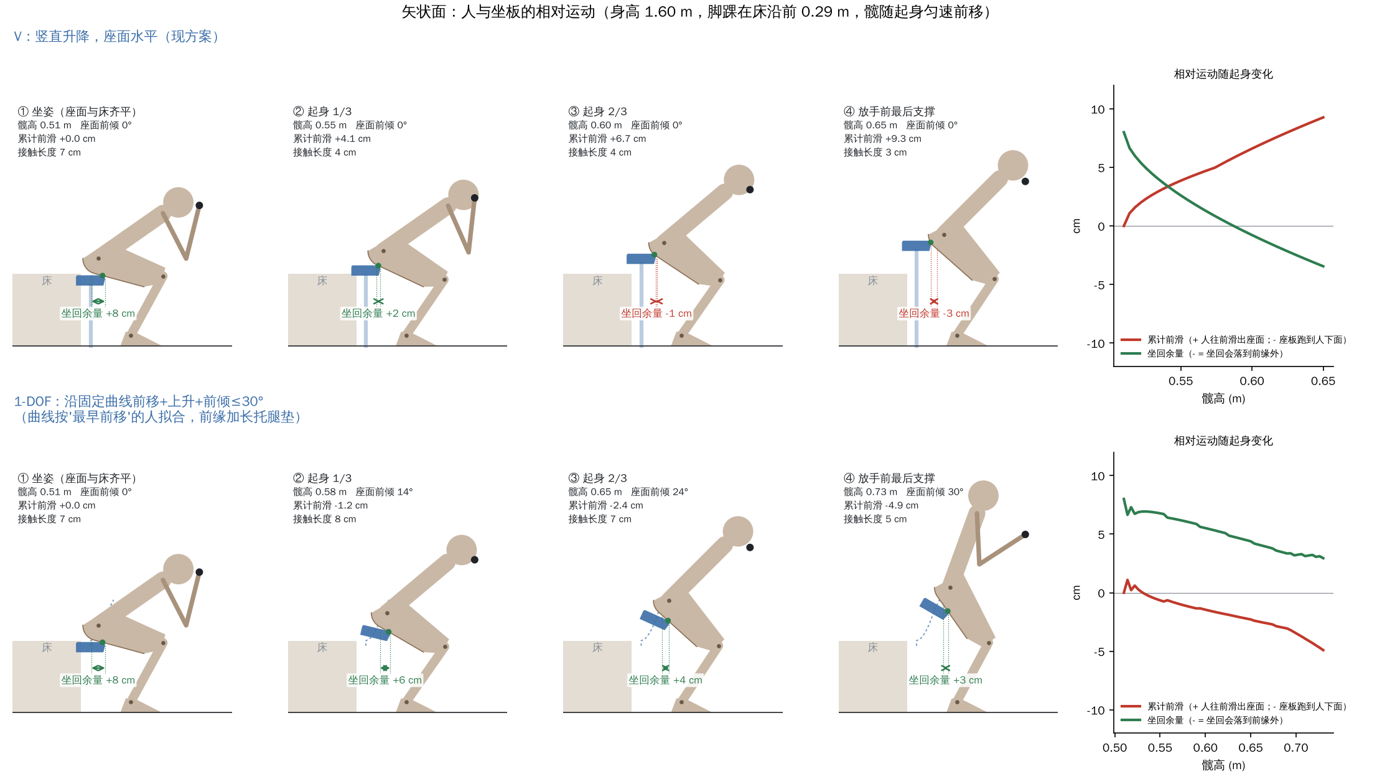
model/calc_v13/seat_trajectory/stages_leanfirst.png
