xiaweiyi0423/me5412-bedexit-proposal/presentation/animations/mech_3d.png

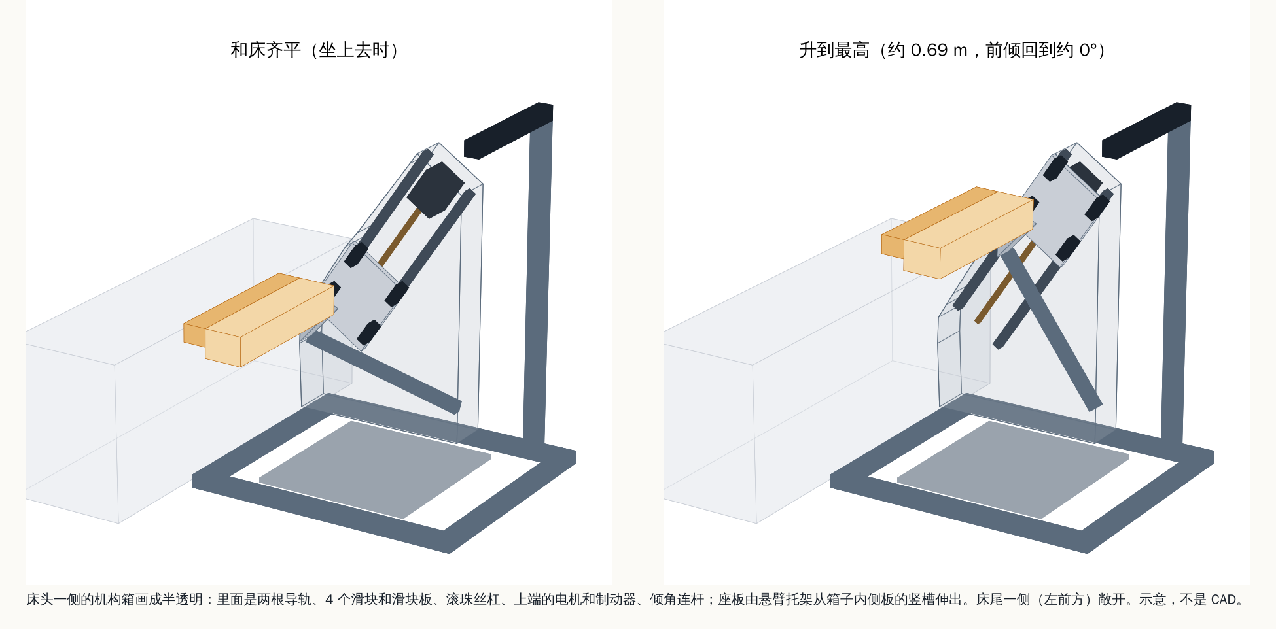
presentation/animations/mech_3d.png
