xiaweiyi0423/me5412-bedexit-proposal/presentation/animations/mech_3d_slide.png

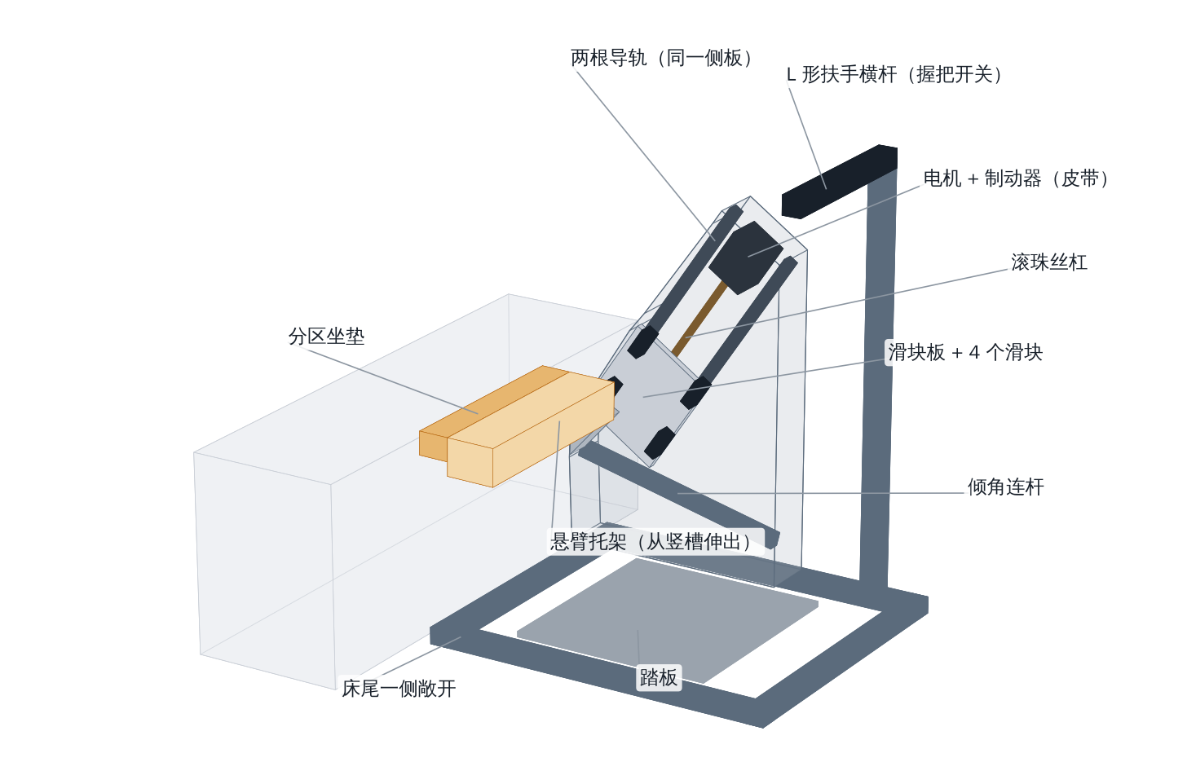
presentation/animations/mech_3d_slide.png
