xiaweiyi0423/me5412-bedexit-proposal/presentation/animations/mech_motion.gif

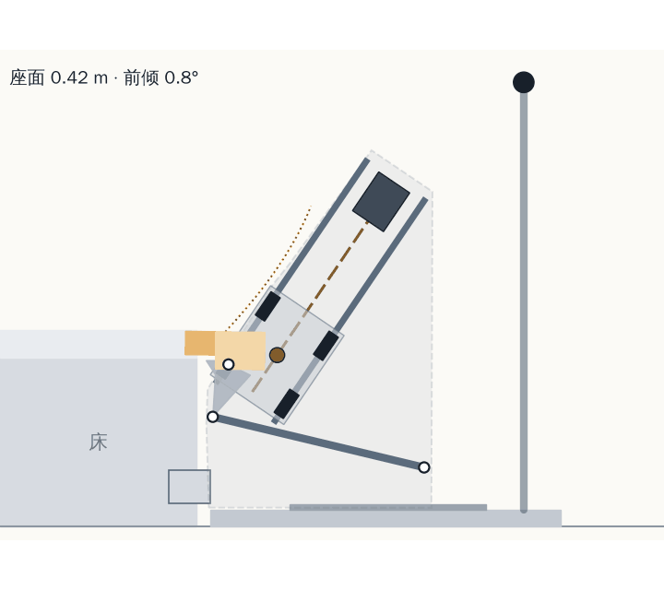
presentation/animations/mech_motion.gif
