xiaweiyi0423/me5412-bedexit-proposal/presentation/animations/mech_side.png

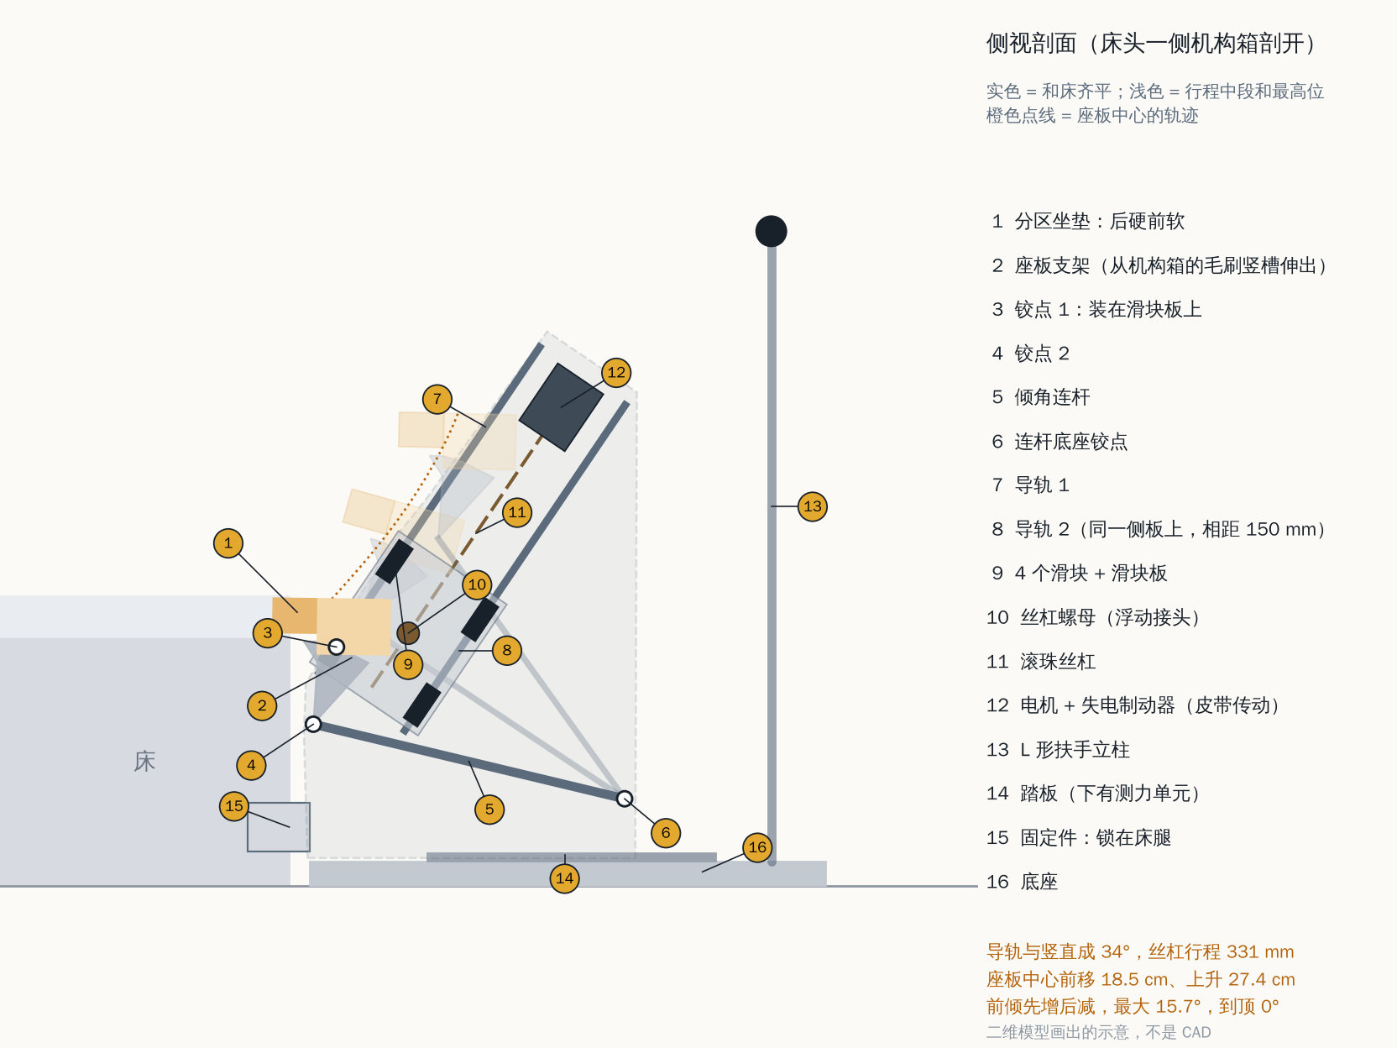
presentation/animations/mech_side.png
