xiaweiyi0423/me5412-bedexit-proposal/presentation/animations/safety_sitback.gif

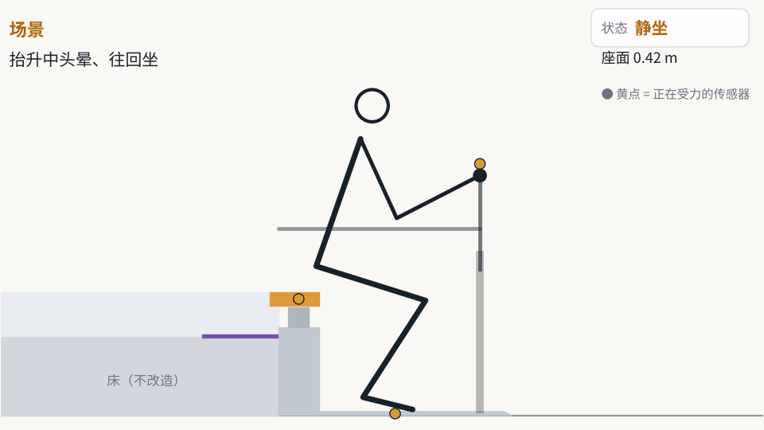
presentation/animations/safety_sitback.gif
