xiaweiyi0423/me5412-bedexit-proposal/presentation/animations/seat_rise.gif

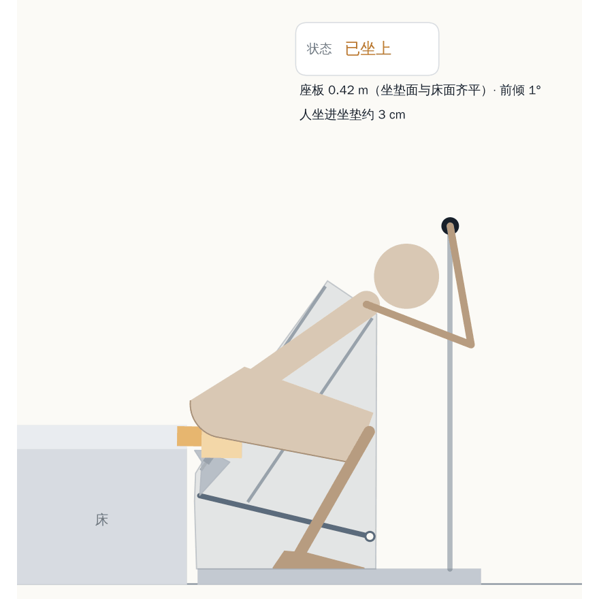
presentation/animations/seat_rise.gif
