xiaweiyi0423/me5412-bedexit-proposal/presentation/animations/seat_rise_mid.png

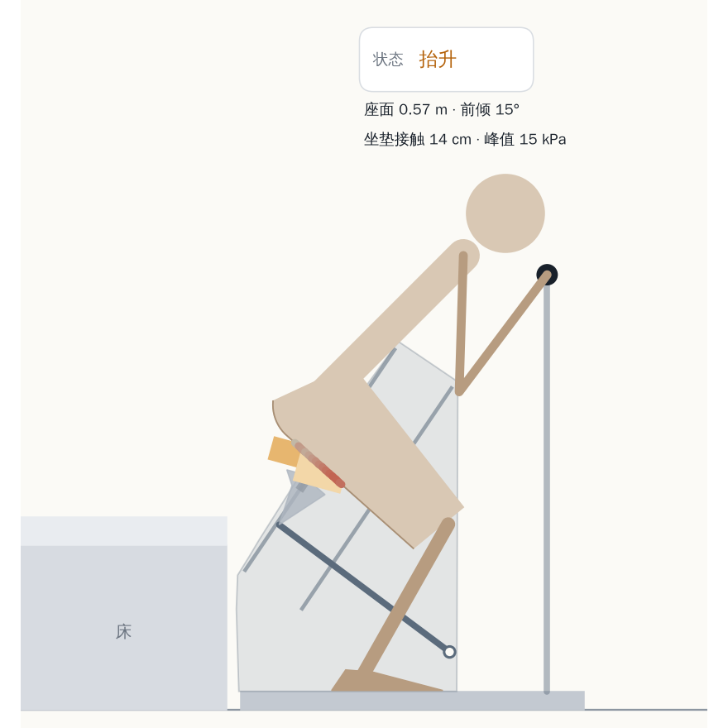
presentation/animations/seat_rise_mid.png
