xiaweiyi0423/me5412-bedexit-proposal/presentation/animations/seat_rise_nobubble_en.gif

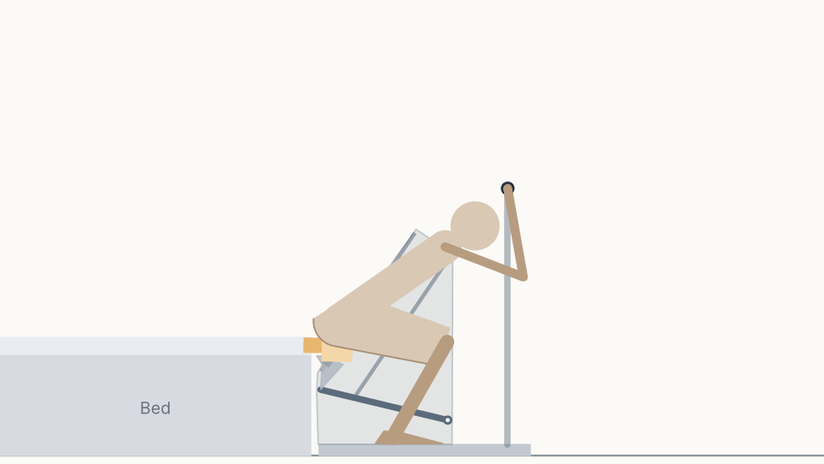
presentation/animations/seat_rise_nobubble_en.gif
