xiaweiyi0423/me5412-bedexit-proposal/presentation/animations/seat_sensors.png

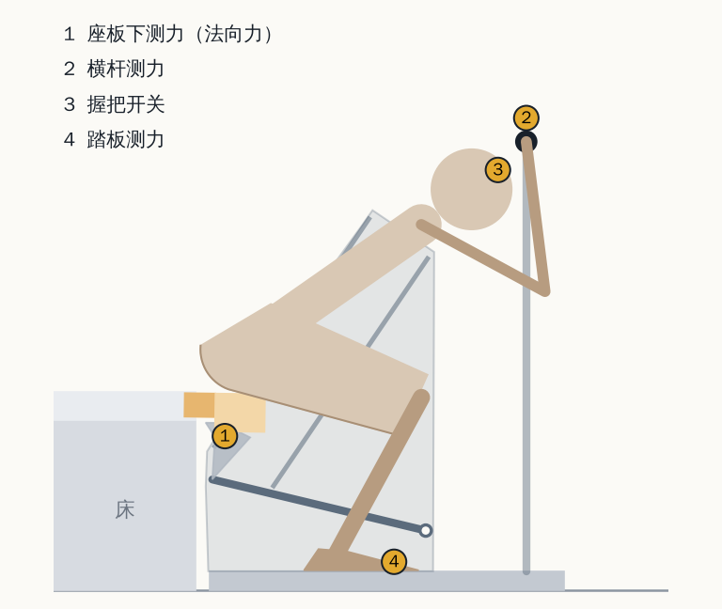
presentation/animations/seat_sensors.png
