xiaweiyi0423/me5412-bedexit-proposal/presentation/animations/seat_top.png

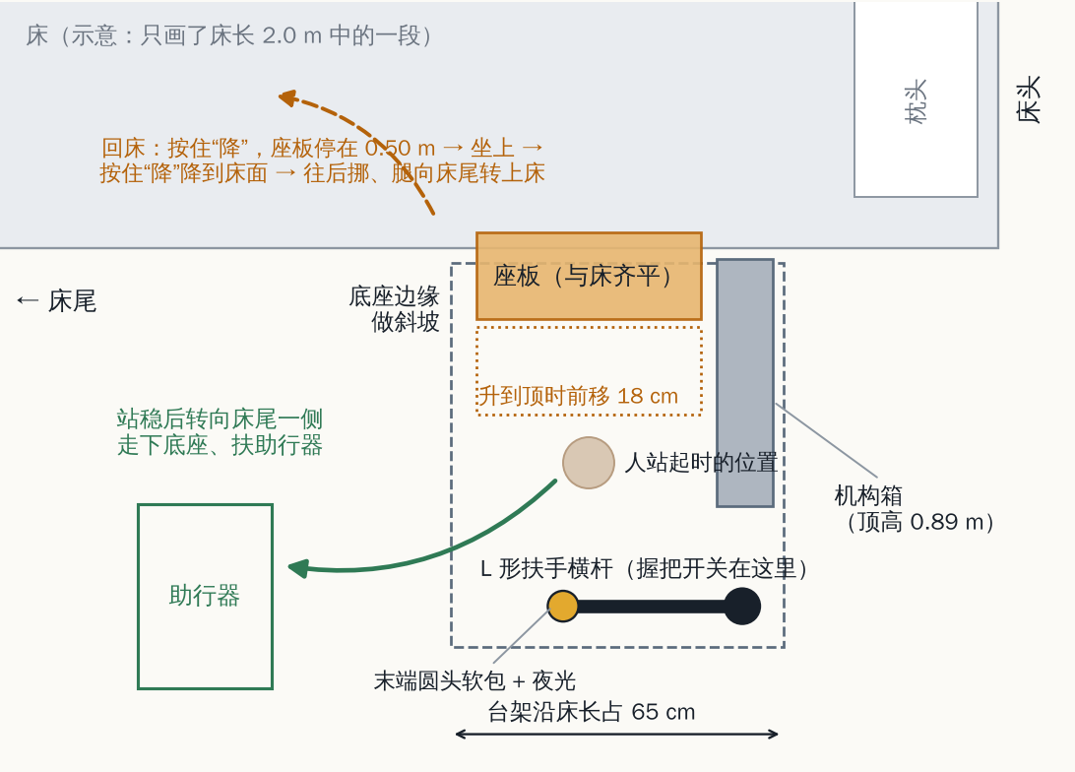
presentation/animations/seat_top.png
