xiaweiyi0423/me5412-bedexit-proposal/presentation/animations/seat_vs_vertical.png

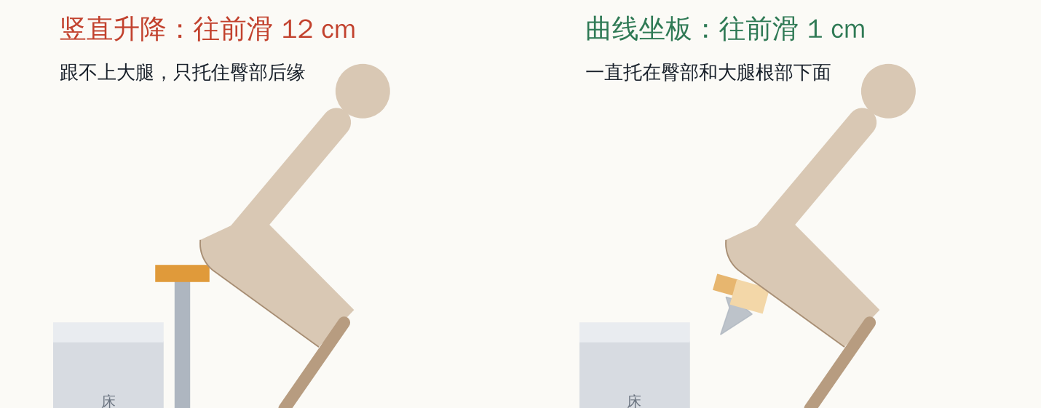
presentation/animations/seat_vs_vertical.png
