xiaweiyi0423/me5412-bedexit-proposal/presentation/animations/use_sequence.gif

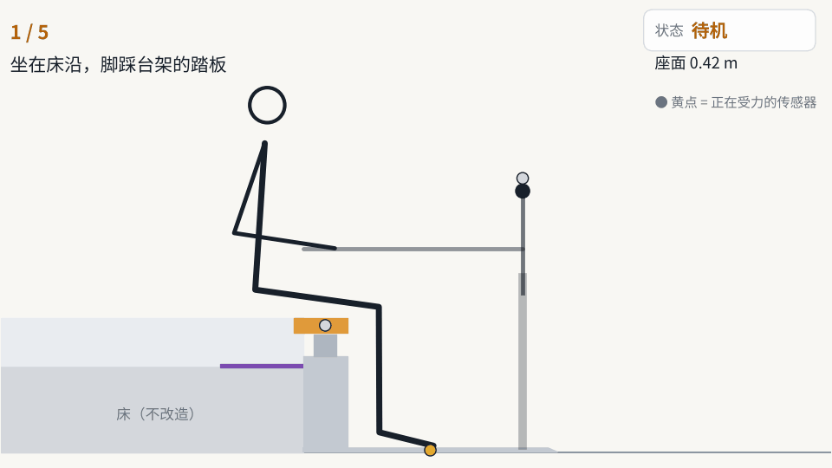
presentation/animations/use_sequence.gif
