xiaweiyi0423/me5412-bedexit-proposal/presentation/assets_en/ctrl_seat_main_en.png

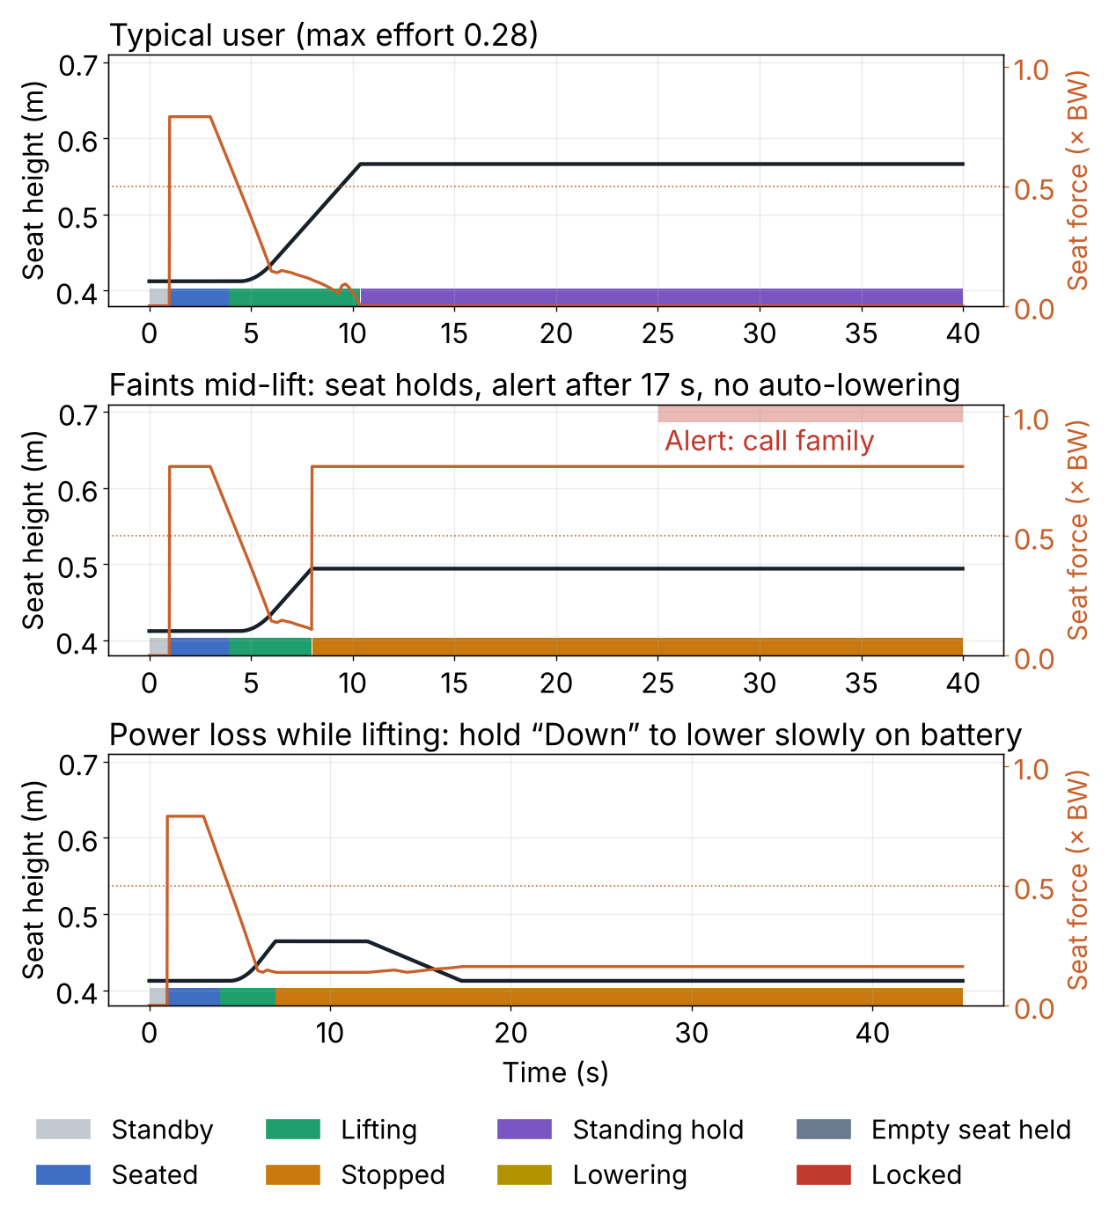
presentation/assets_en/ctrl_seat_main_en.png
