xiaweiyi0423/me5412-bedexit-proposal/presentation/assets_en/dw_C1_slide_en.png

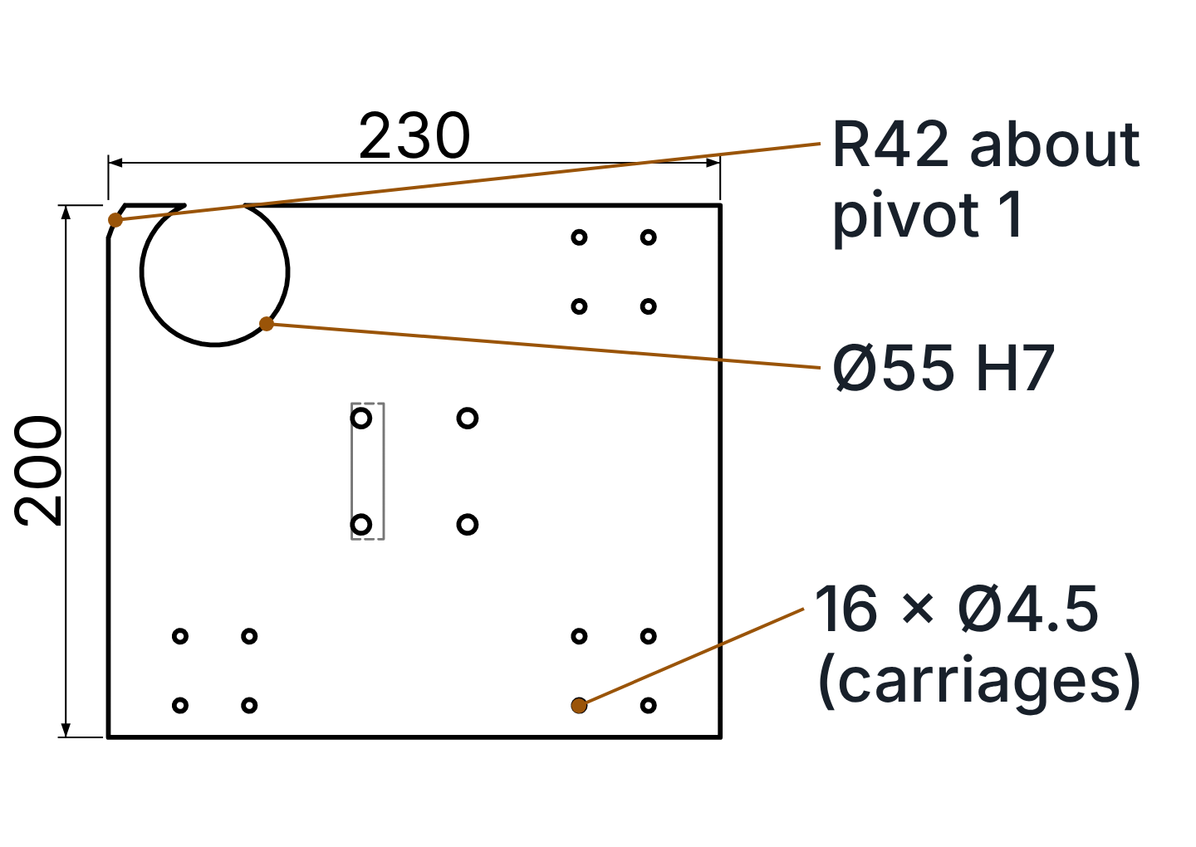
presentation/assets_en/dw_C1_slide_en.png
