xiaweiyi0423/me5412-bedexit-proposal/presentation/assets_en/dw_S7_en.png

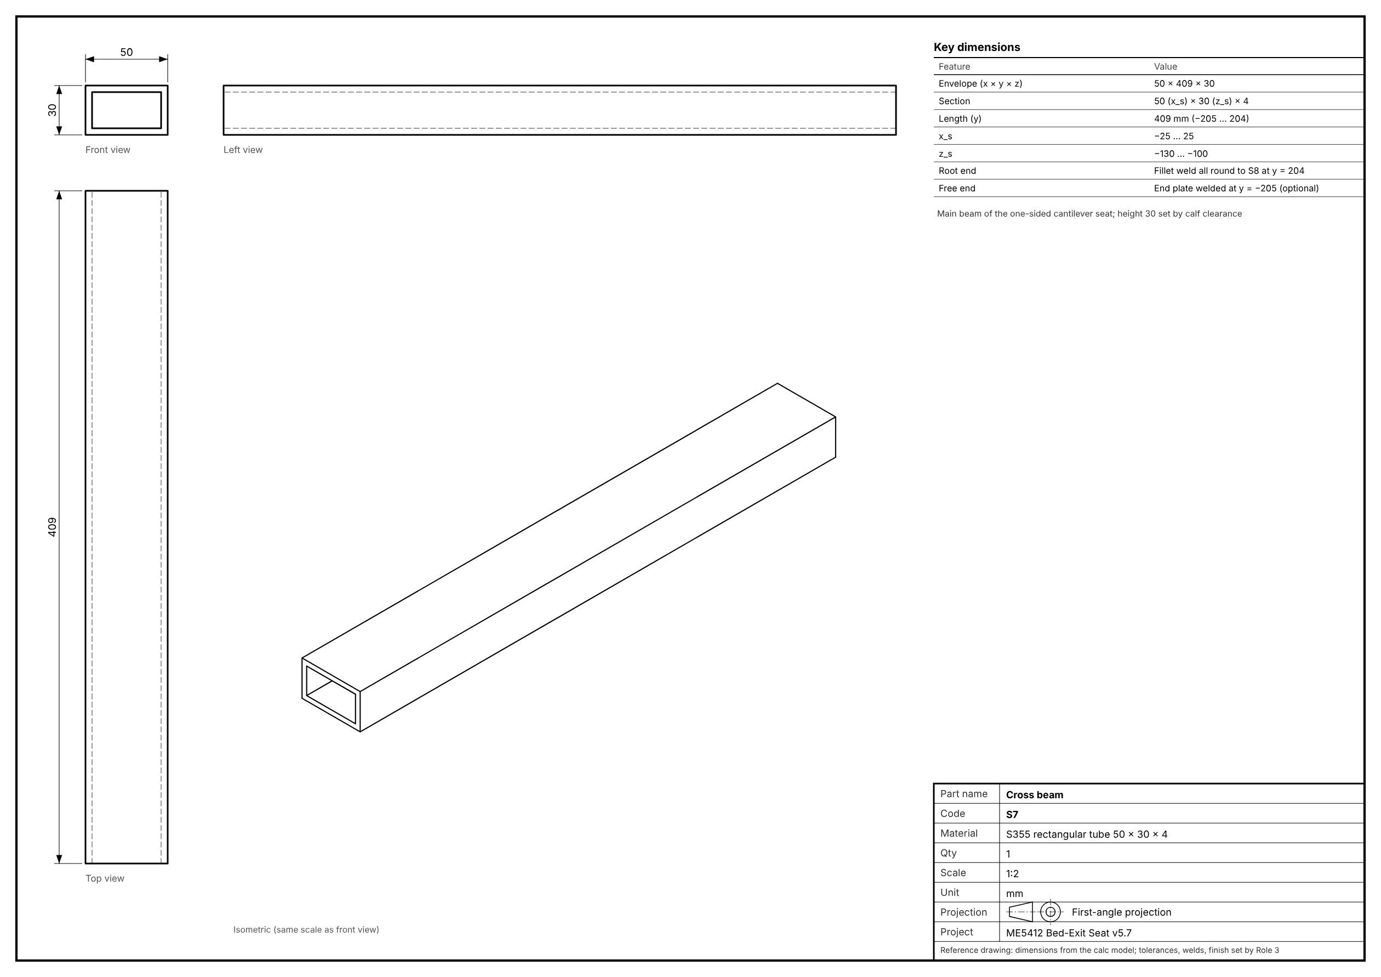
presentation/assets_en/dw_S7_en.png
