xiaweiyi0423/me5412-bedexit-proposal/presentation/assets_en/fig_fea_rail_en.png

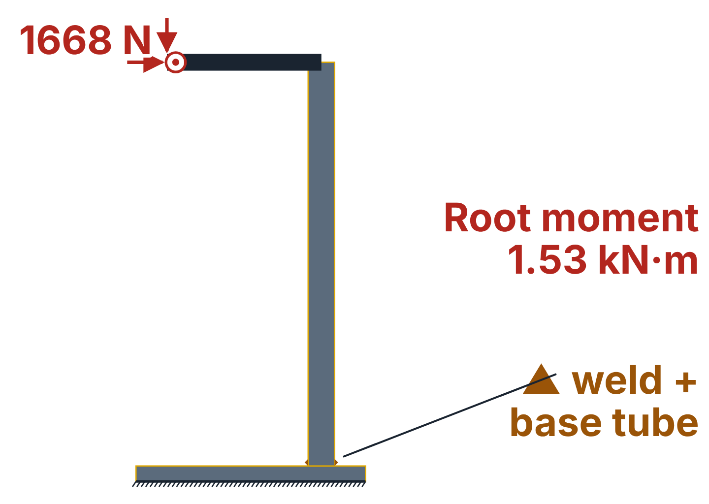
presentation/assets_en/fig_fea_rail_en.png
