xiaweiyi0423/me5412-bedexit-proposal/presentation/assets_en/md_candidates_en.png

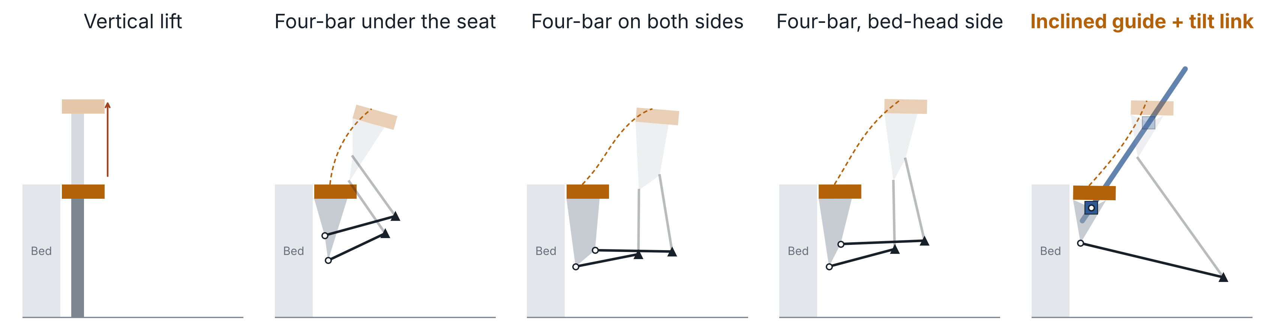
presentation/assets_en/md_candidates_en.png
