xiaweiyi0423/me5412-bedexit-proposal/presentation/assets_en/still_sensing_en.jpg

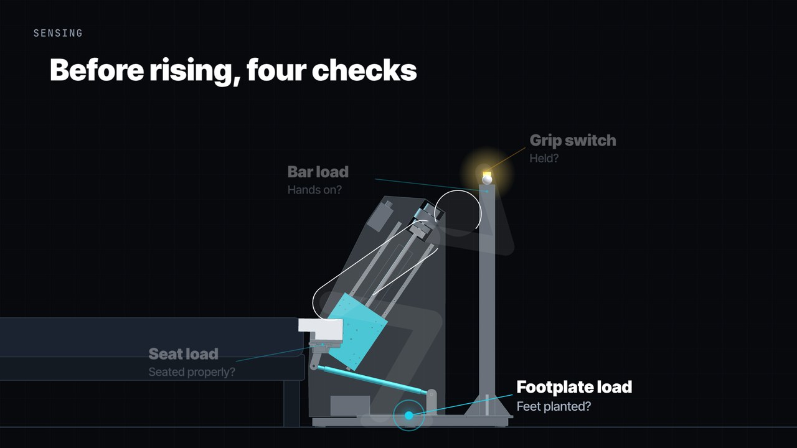
presentation/assets_en/still_sensing_en.jpg
