xiaweiyi0423/me5412-bedexit-proposal/presentation/assets_v57/3d_c1_flush.png

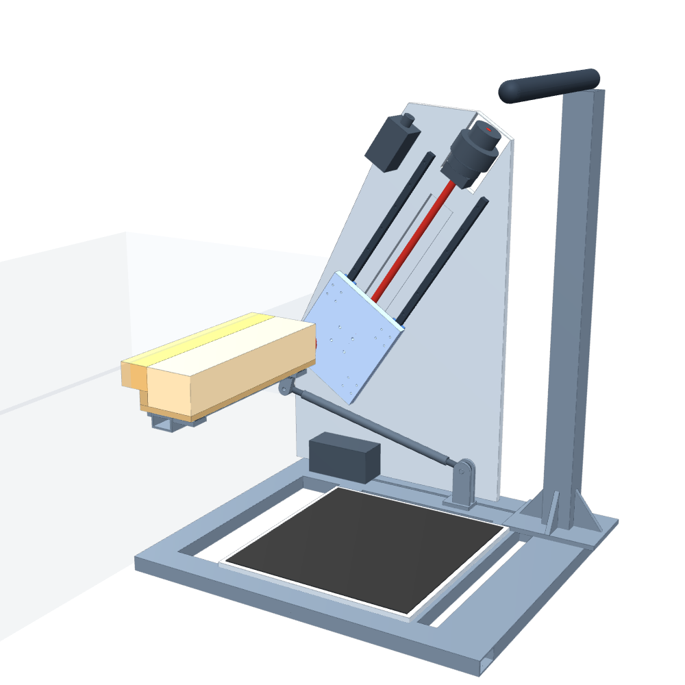
presentation/assets_v57/3d_c1_flush.png
