xiaweiyi0423/me5412-bedexit-proposal/presentation/assets_v57/3d_c2_mid.png

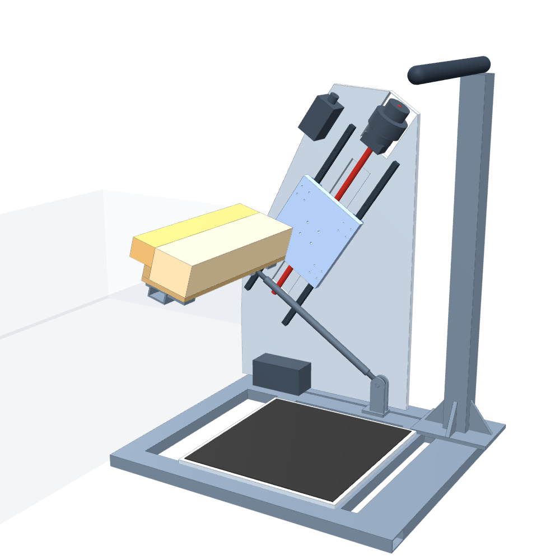
presentation/assets_v57/3d_c2_mid.png
