xiaweiyi0423/me5412-bedexit-proposal/presentation/assets_v57/3d_d_joint.png

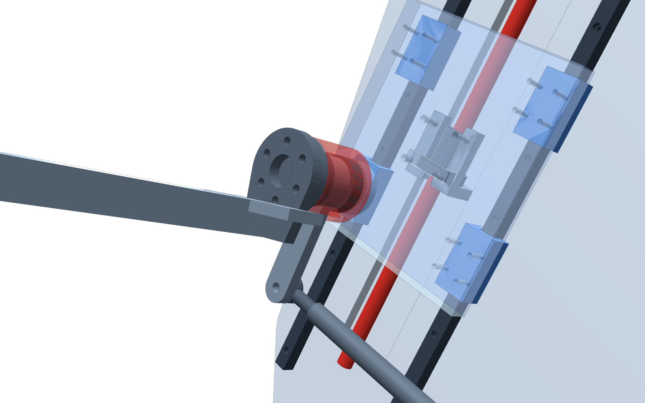
presentation/assets_v57/3d_d_joint.png
