xiaweiyi0423/me5412-bedexit-proposal/presentation/assets_v57/cmp_effort.png

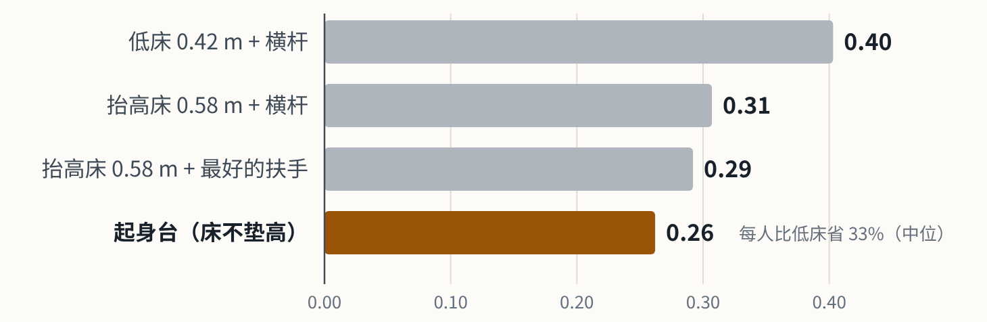
presentation/assets_v57/cmp_effort.png
