xiaweiyi0423/me5412-bedexit-proposal/presentation/assets_v57/cmp_fall_knee.png

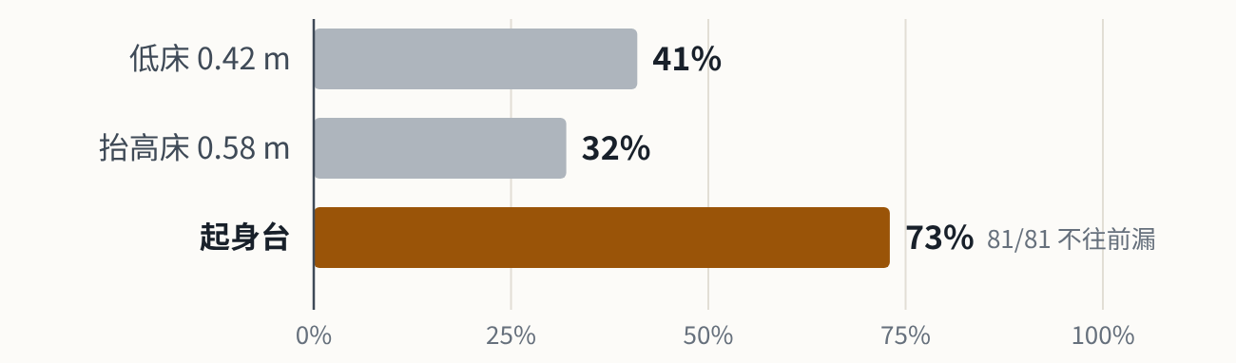
presentation/assets_v57/cmp_fall_knee.png
