xiaweiyi0423/me5412-bedexit-proposal/presentation/assets_v57/dw_J1.png

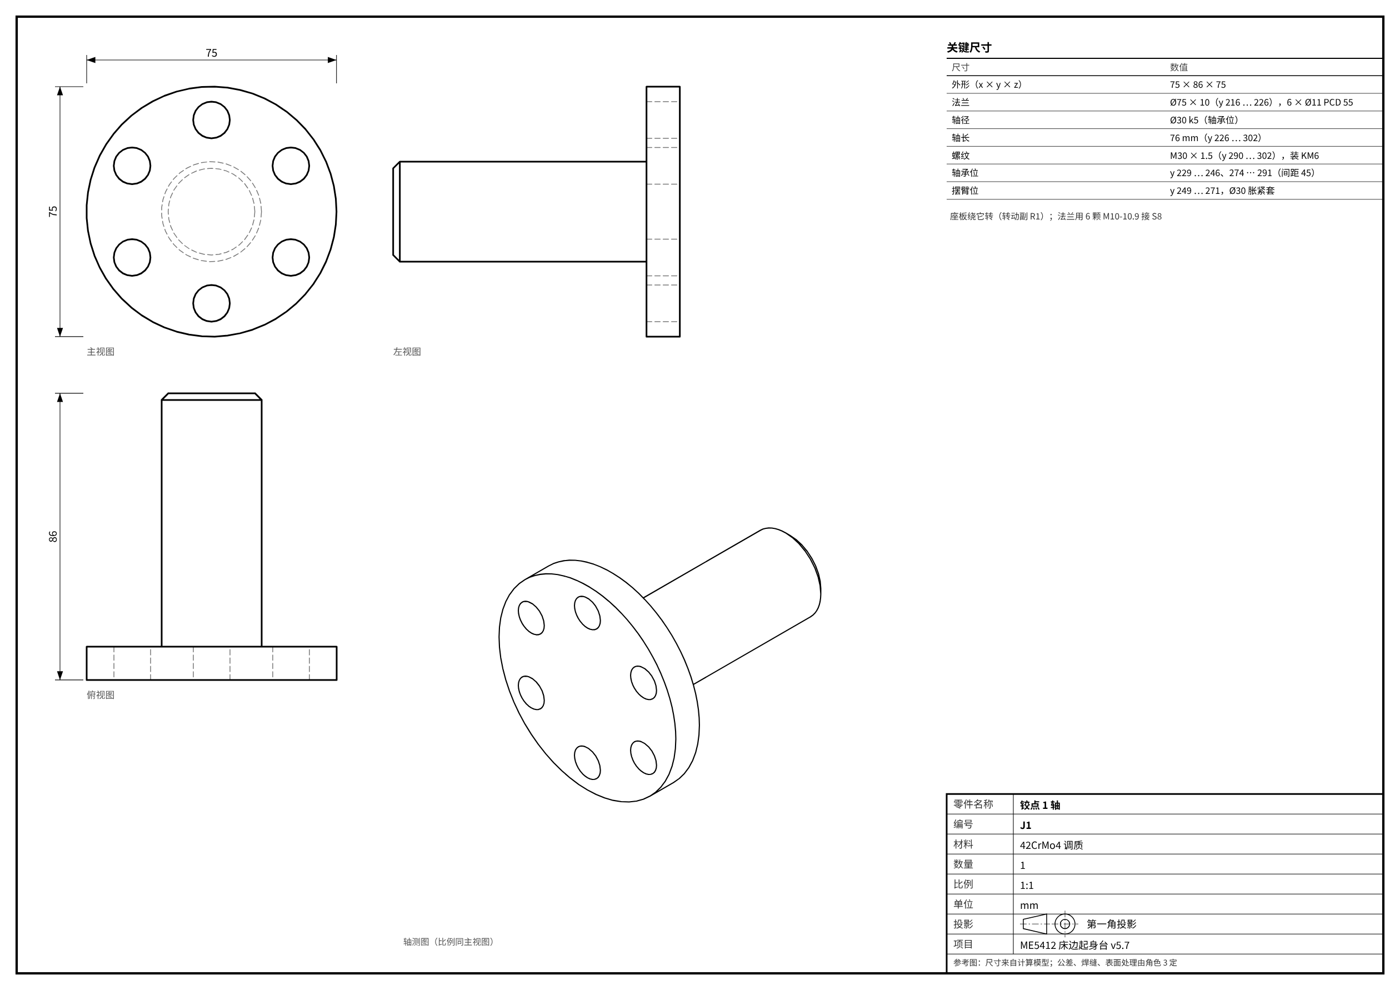
presentation/assets_v57/dw_J1.png
