xiaweiyi0423/me5412-bedexit-proposal/presentation/assets_v57/dw_S7.png

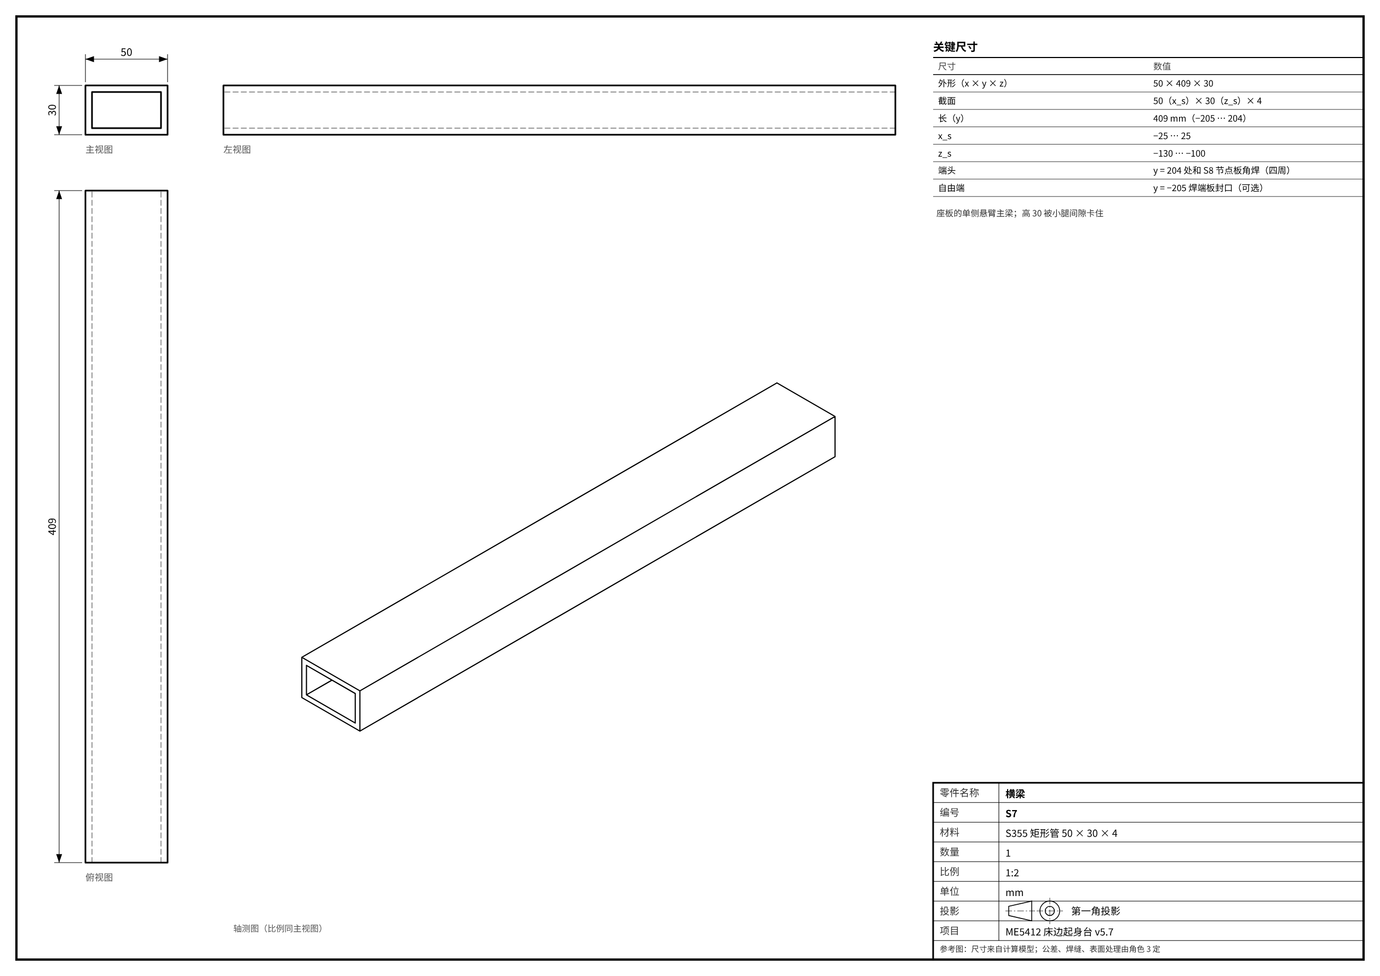
presentation/assets_v57/dw_S7.png
