xiaweiyi0423/me5412-bedexit-proposal/presentation/assets_v57/fig_fea_c1.png

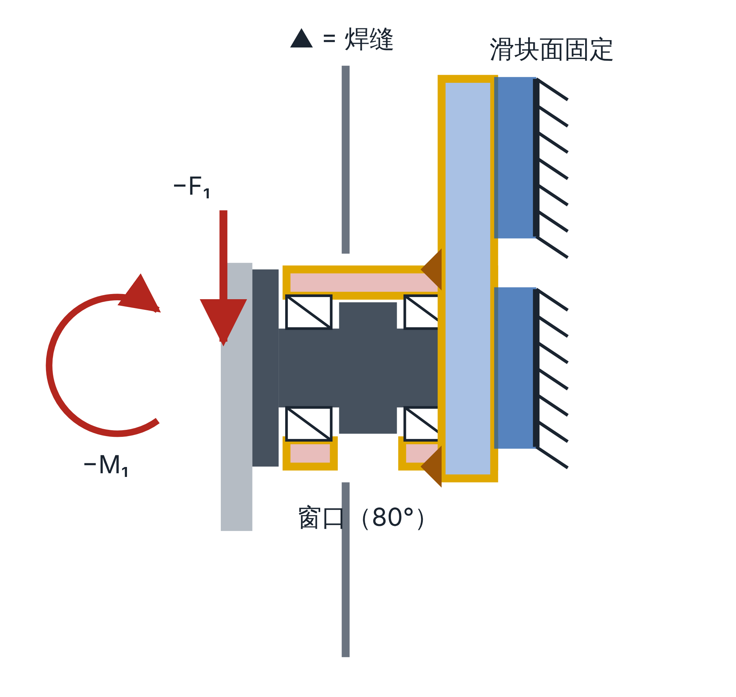
presentation/assets_v57/fig_fea_c1.png
