xiaweiyi0423/me5412-bedexit-proposal/presentation/assets_v57/md_synthesis.png

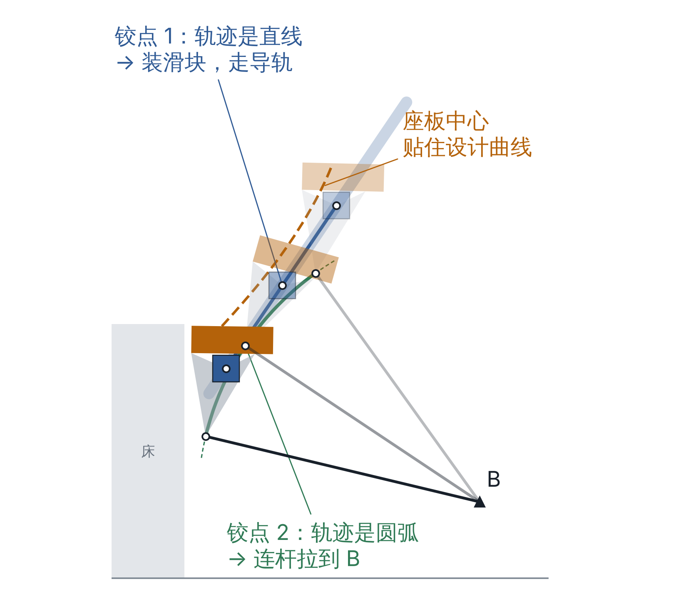
presentation/assets_v57/md_synthesis.png
