xiaweiyi0423/me5412-bedexit-proposal/presentation/assets_v57/md_target.png

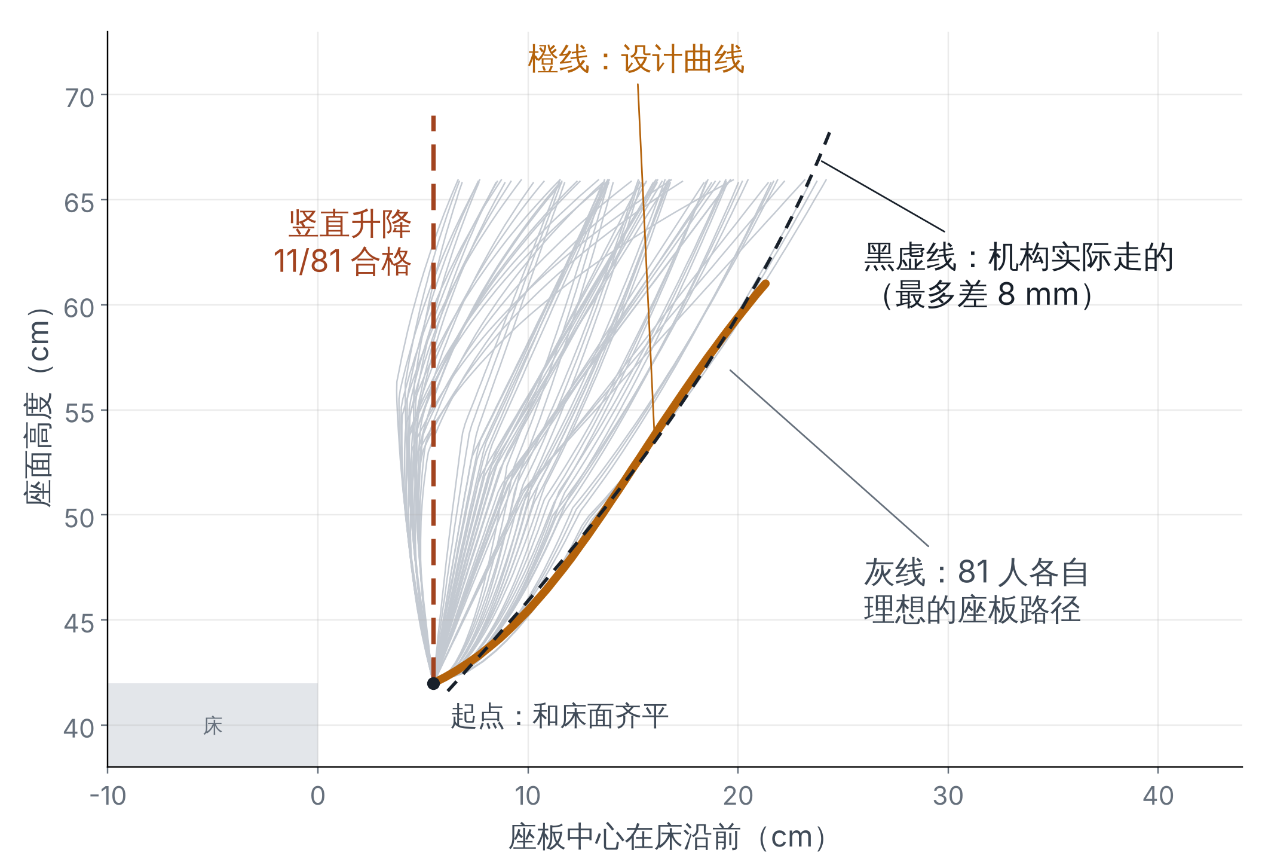
presentation/assets_v57/md_target.png
