xiaweiyi0423/me5412-bedexit-proposal/presentation/assets_v57/seatpage_envelope.png

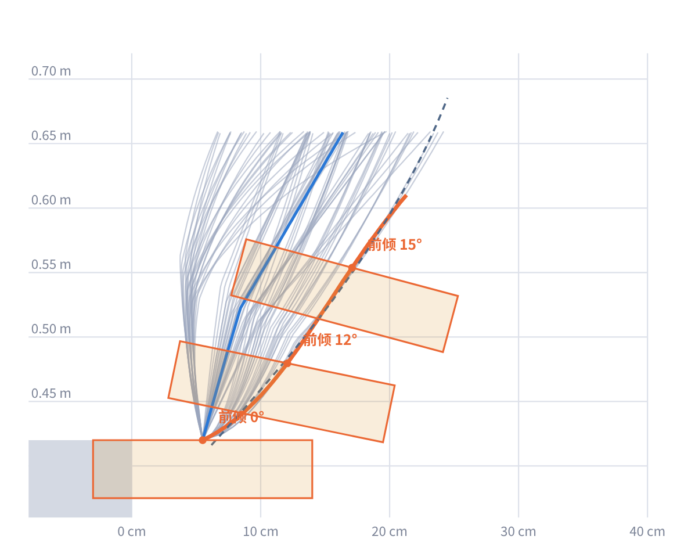
presentation/assets_v57/seatpage_envelope.png
