xiaweiyi0423/me5412-bedexit-proposal/presentation/assets_v57/seatpage_hip_paths.png

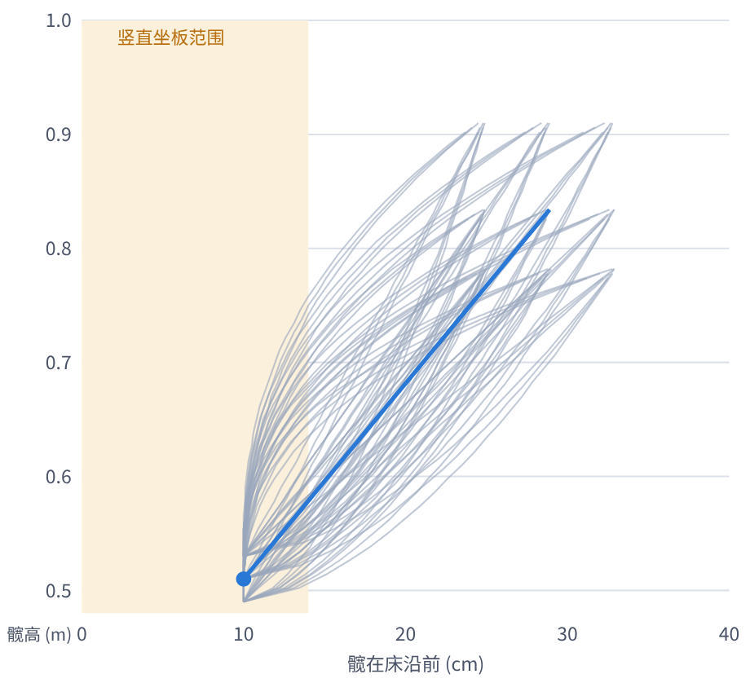
presentation/assets_v57/seatpage_hip_paths.png
