xiaweiyi0423/me5412-bedexit-proposal/presentation/video/crane_pose.jpg

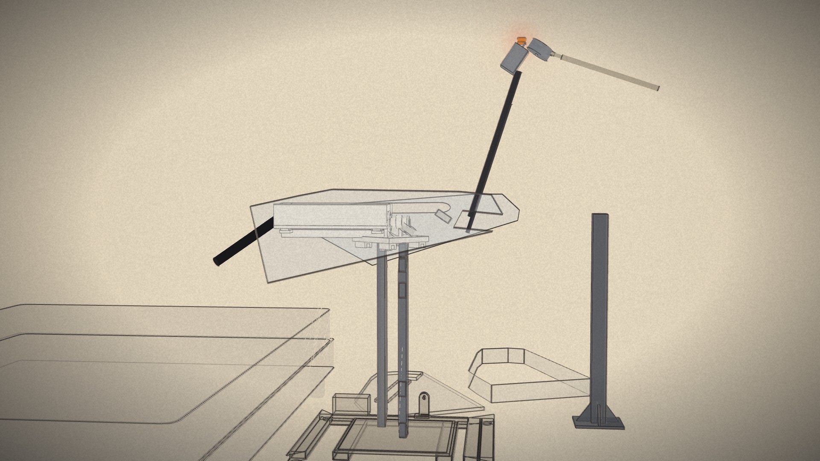
presentation/video/crane_pose.jpg
