xiaweiyi0423/me5412-bedexit-proposal/presentation/video/crane_silhouette.jpg

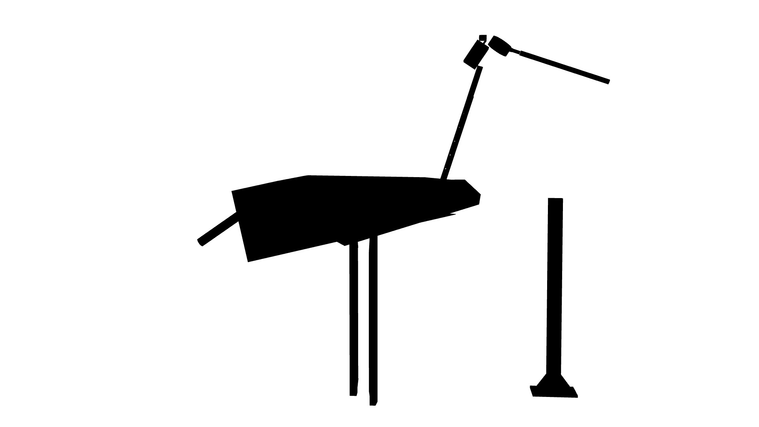
presentation/video/crane_silhouette.jpg
