xiaweiyi0423/me5412-bedexit-proposal/presentation/video/mech_refs/M1.jpg

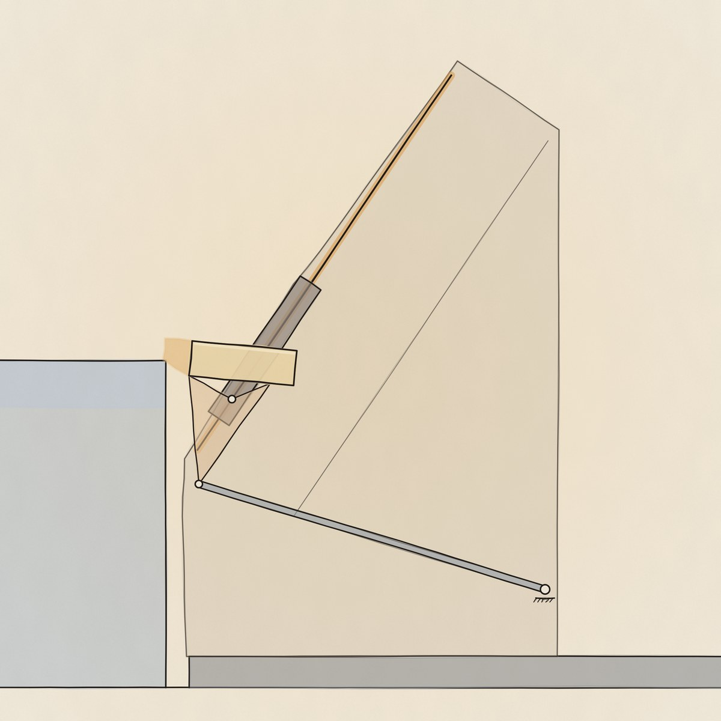
presentation/video/mech_refs/M1.jpg
