xiaweiyi0423/me5412-bedexit-proposal/presentation/video/panels/C1.jpg

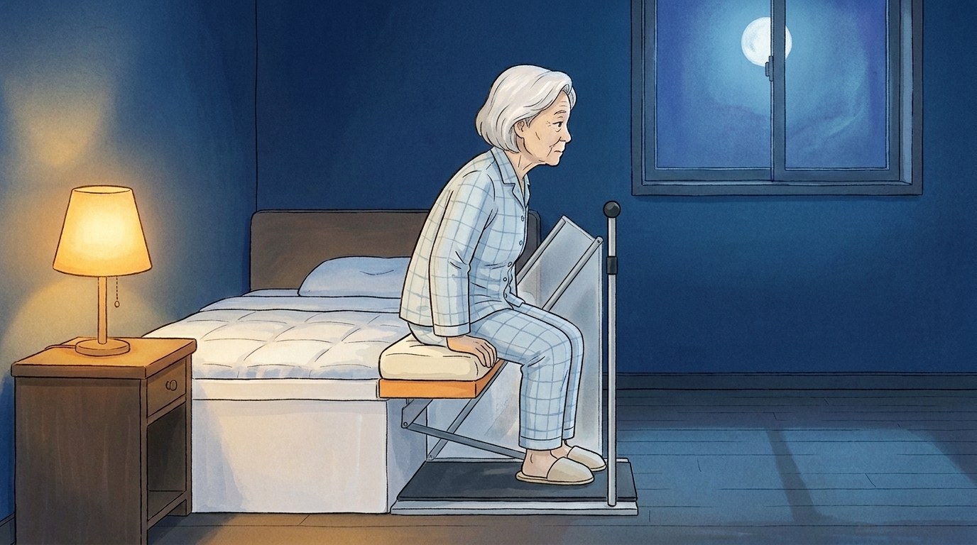
presentation/video/panels/C1.jpg
