xiaweiyi0423/me5412-bedexit-proposal/presentation/video/panels/C3.jpg

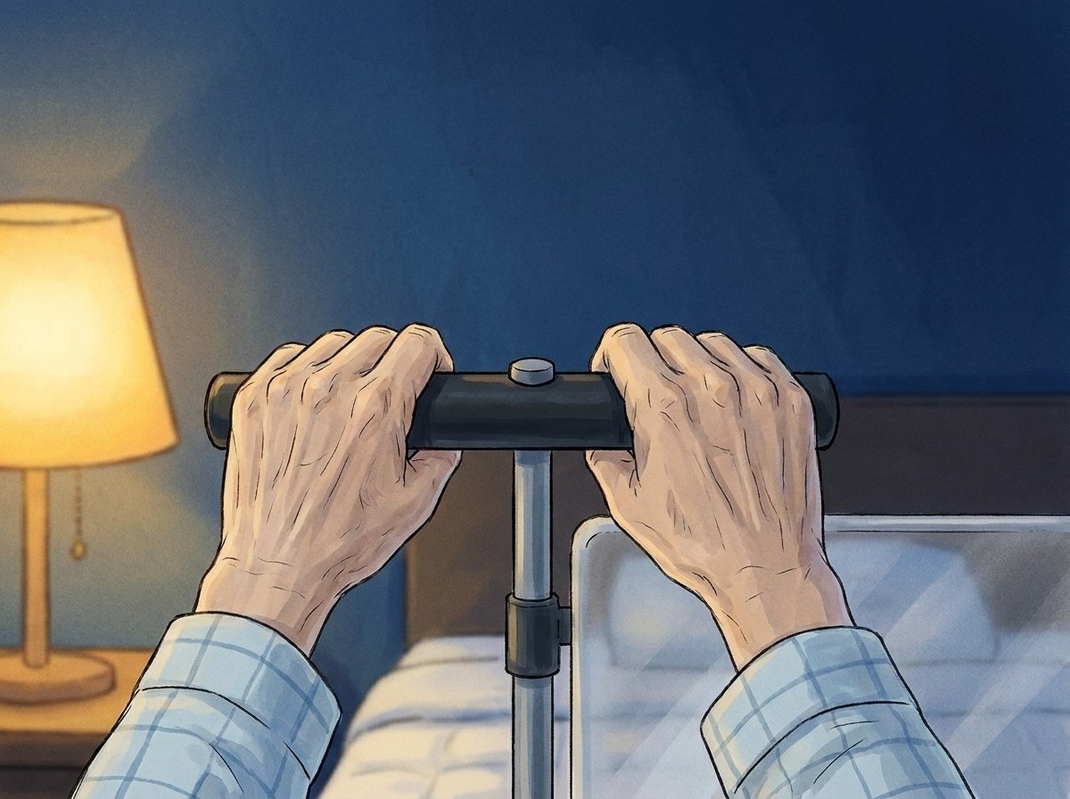
presentation/video/panels/C3.jpg
