xiaweiyi0423/me5412-bedexit-proposal/presentation/video/panels/D1.jpg

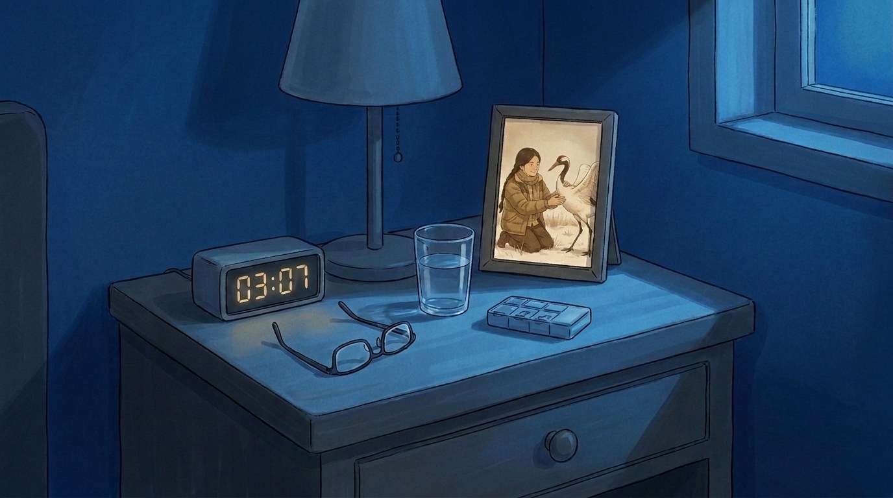
presentation/video/panels/D1.jpg
