xiaweiyi0423/me5412-bedexit-proposal/presentation/video/panels/D2.jpg

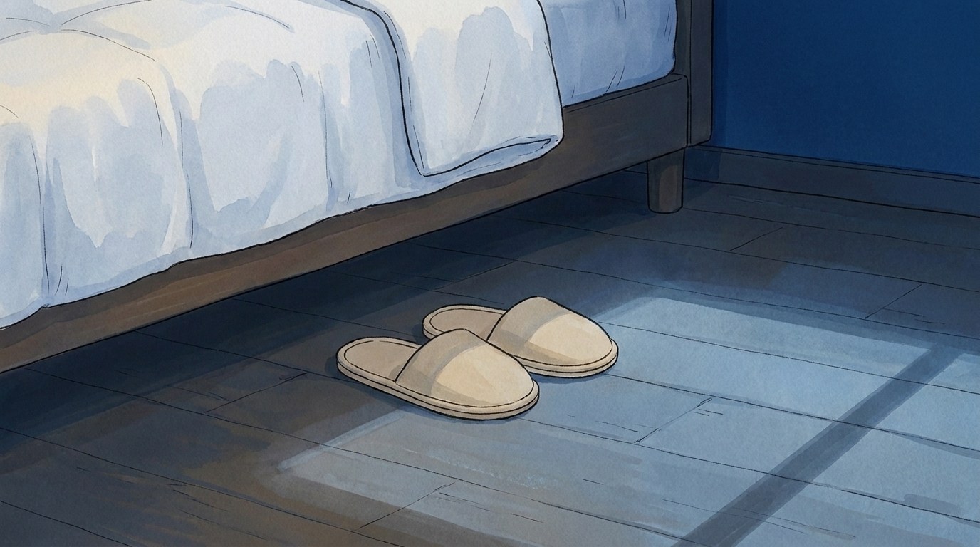
presentation/video/panels/D2.jpg
