xiaweiyi0423/me5412-bedexit-proposal/presentation/video/panels/E1.jpg

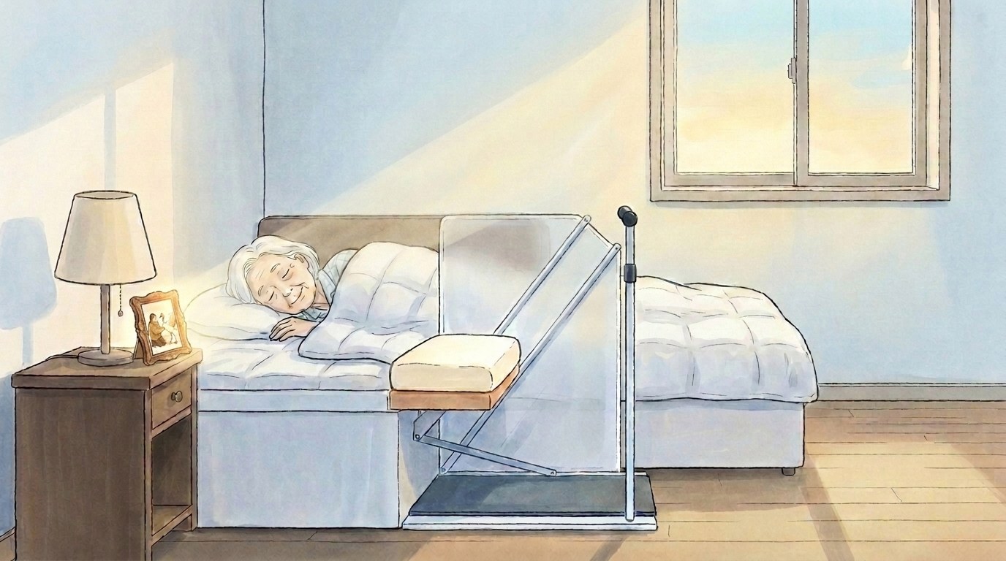
presentation/video/panels/E1.jpg
