xiaweiyi0423/me5412-bedexit-proposal/presentation/video/panels/F_press.jpg

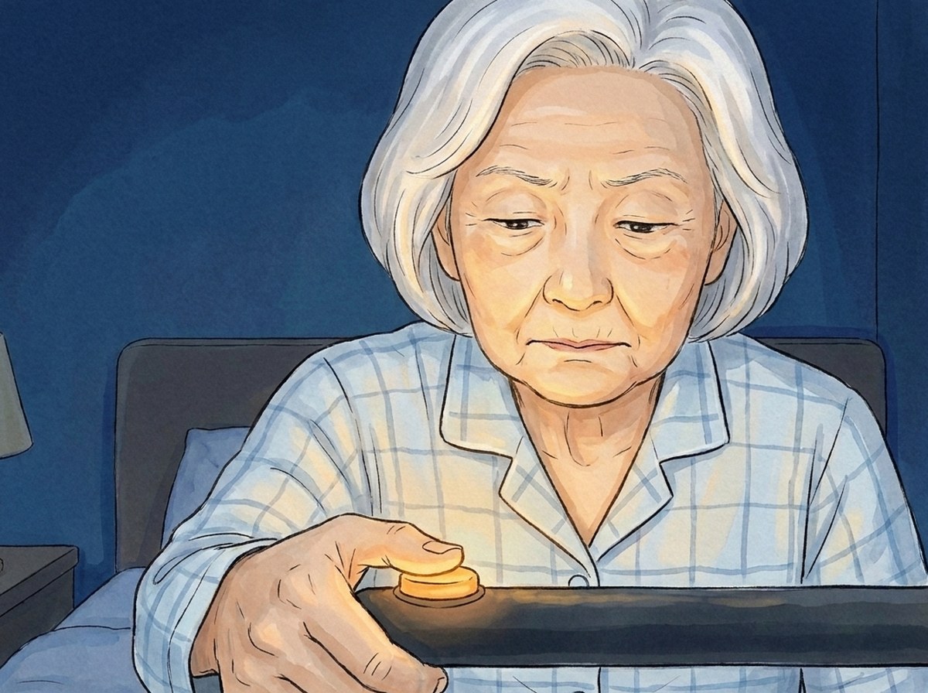
presentation/video/panels/F_press.jpg
