xiaweiyi0423/me5412-bedexit-proposal/presentation/video/panels/F_rise.jpg

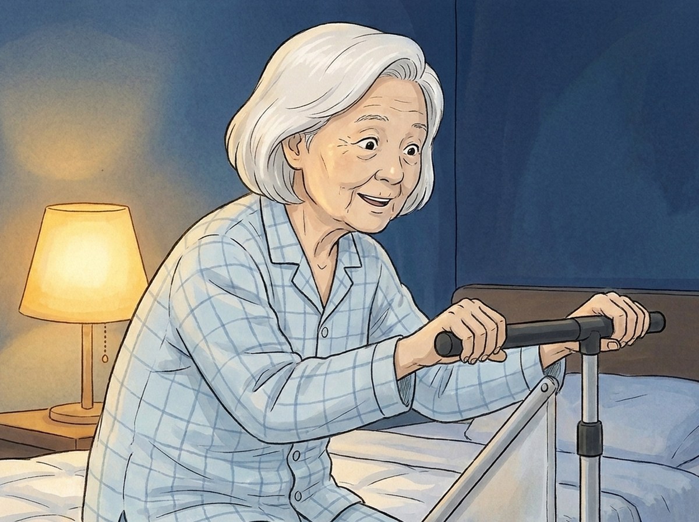
presentation/video/panels/F_rise.jpg
