xiaweiyi0423/me5412-bedexit-proposal/presentation/video/panels/F_sleep.jpg

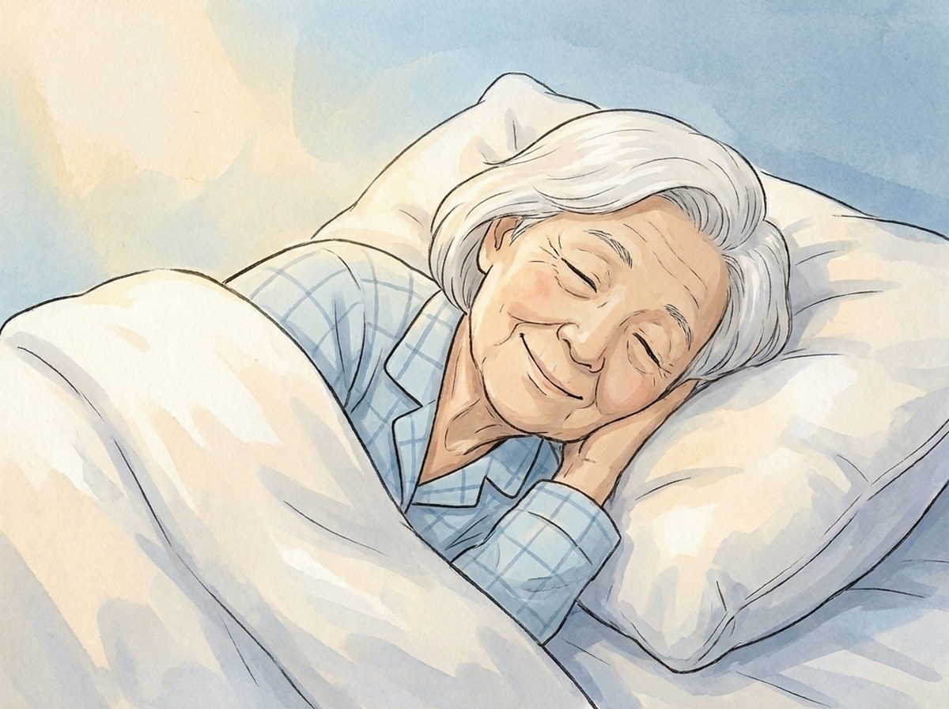
presentation/video/panels/F_sleep.jpg
