xiaweiyi0423/me5412-bedexit-proposal/presentation/video/panels/F_struggle.jpg

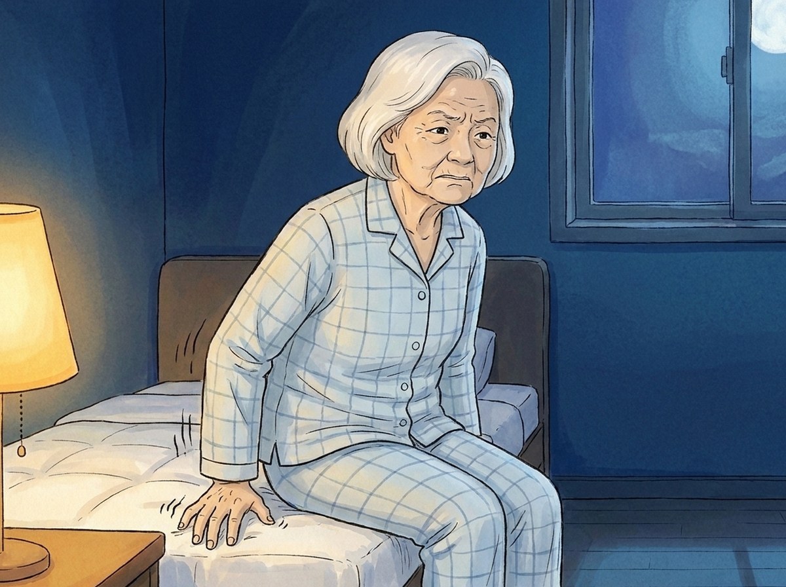
presentation/video/panels/F_struggle.jpg
