xiaweiyi0423/me5412-bedexit-proposal/presentation/video/panels/G2.jpg

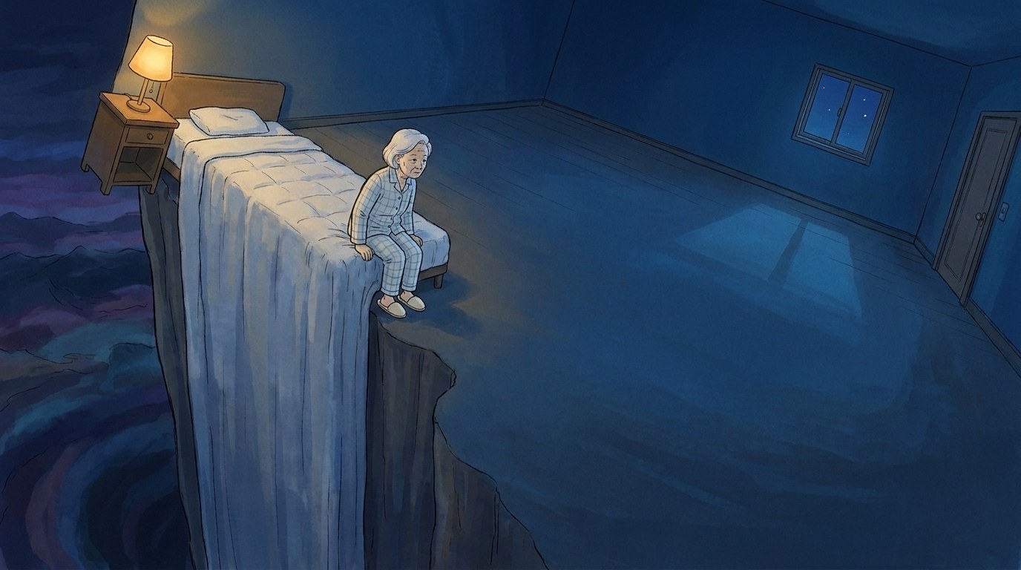
presentation/video/panels/G2.jpg
