xiaweiyi0423/me5412-bedexit-proposal/presentation/video/panels/M4m.jpg

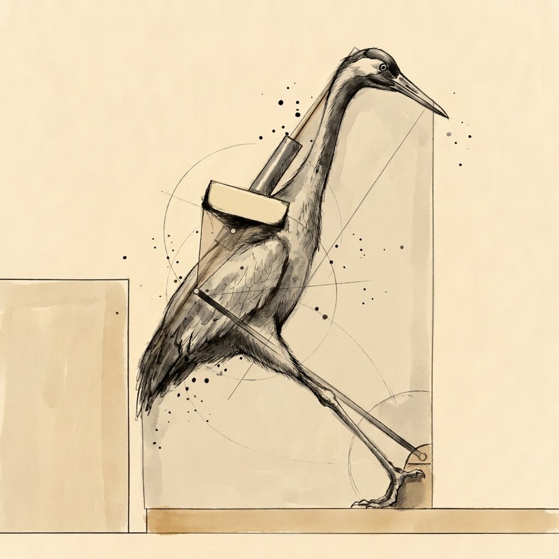
presentation/video/panels/M4m.jpg
