xiaweiyi0423/me5412-bedexit-proposal/presentation/video/panels/P_photo_4x5.jpg

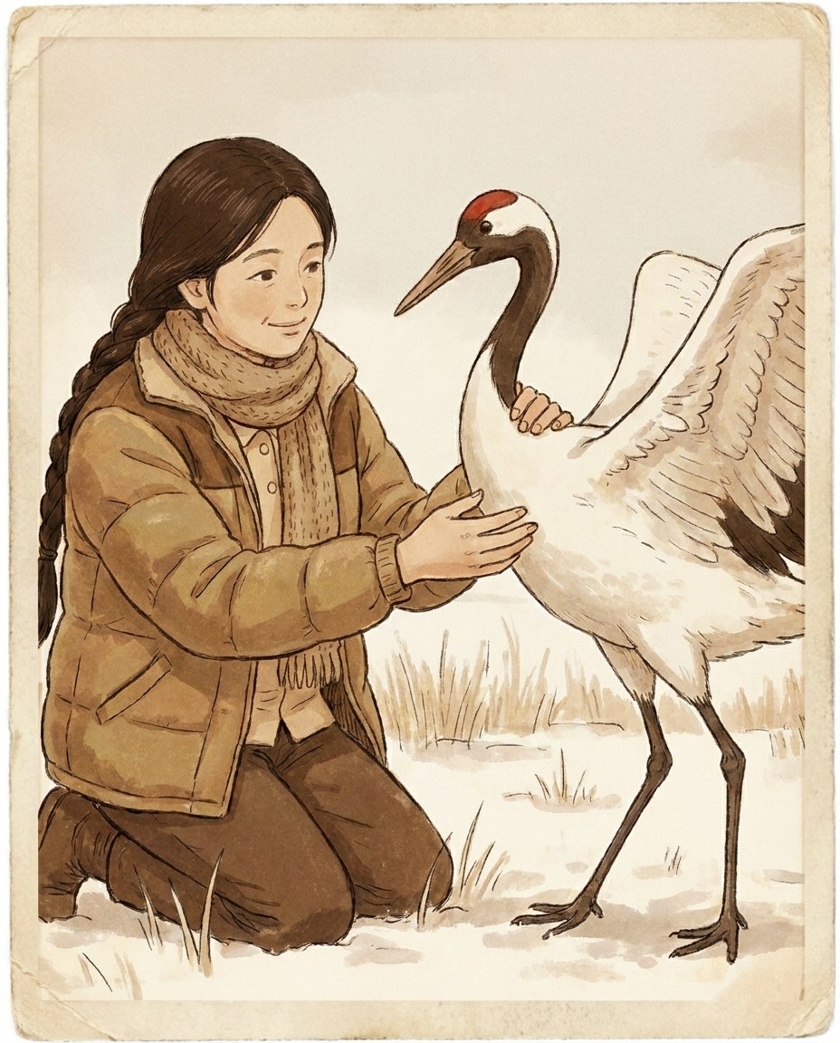
presentation/video/panels/P_photo_4x5.jpg
