xiaweiyi0423/me5412-bedexit-proposal/presentation/video/panels/S9b.jpg

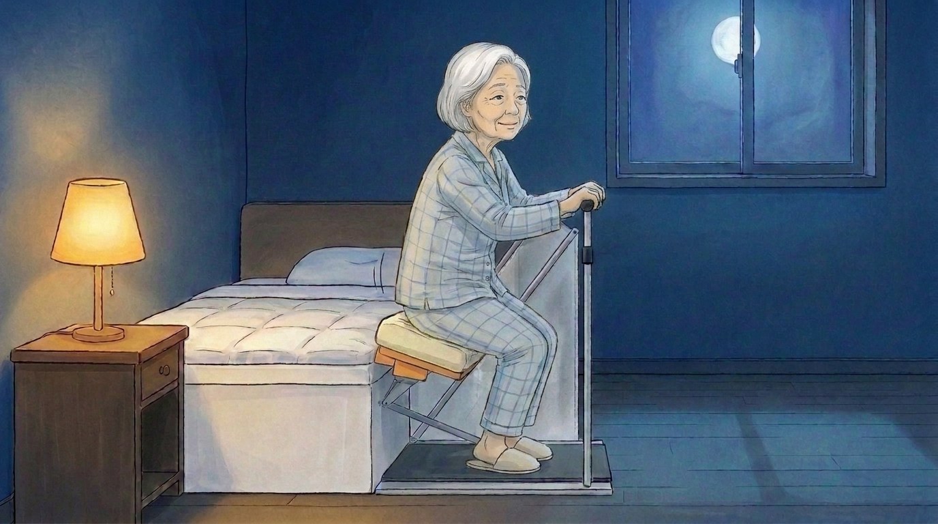
presentation/video/panels/S9b.jpg
