xiaweiyi0423/me5412-bedexit-proposal/presentation/video/panels/W3.jpg

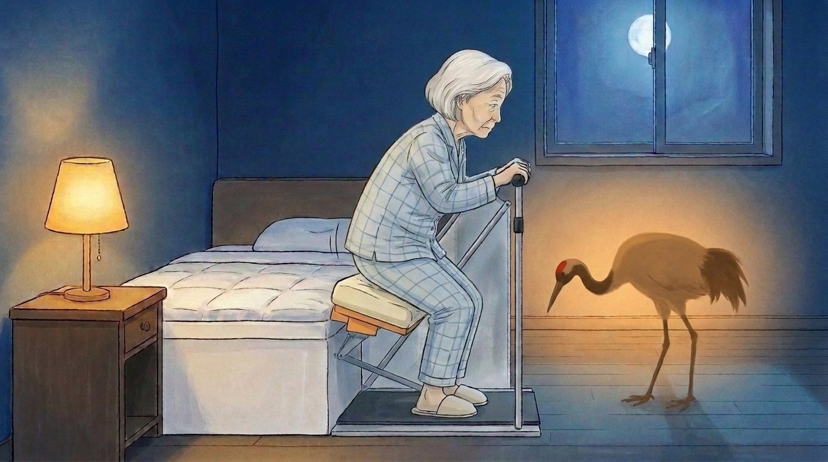
presentation/video/panels/W3.jpg
