xiaweiyi0423/me5412-bedexit-proposal/presentation/video/panels/W4.jpg

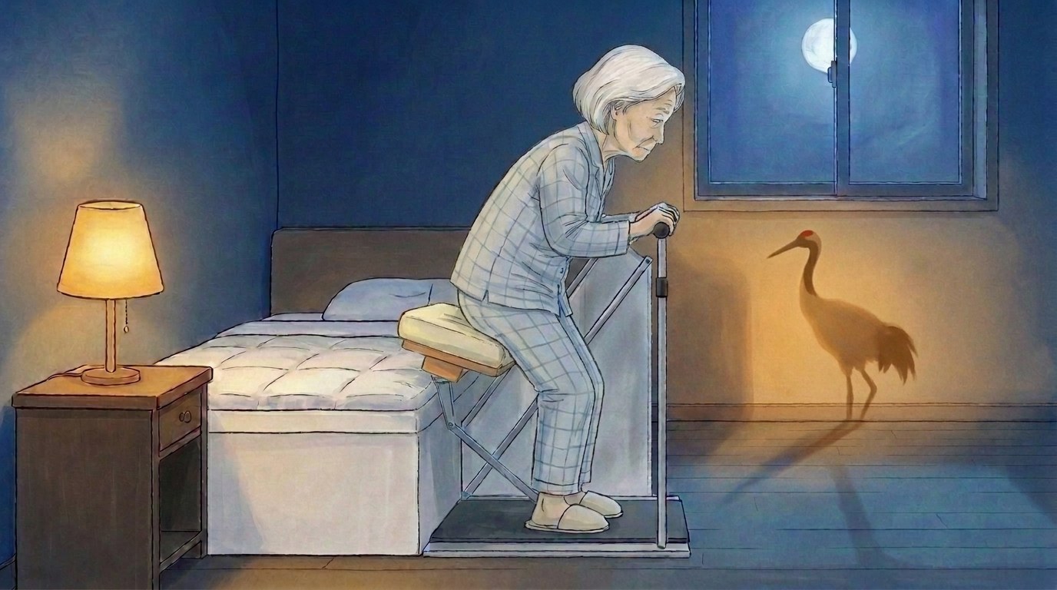
presentation/video/panels/W4.jpg
