xiaweiyi0423/me5412-bedexit-proposal/presentation/video/panels/Y5.jpg

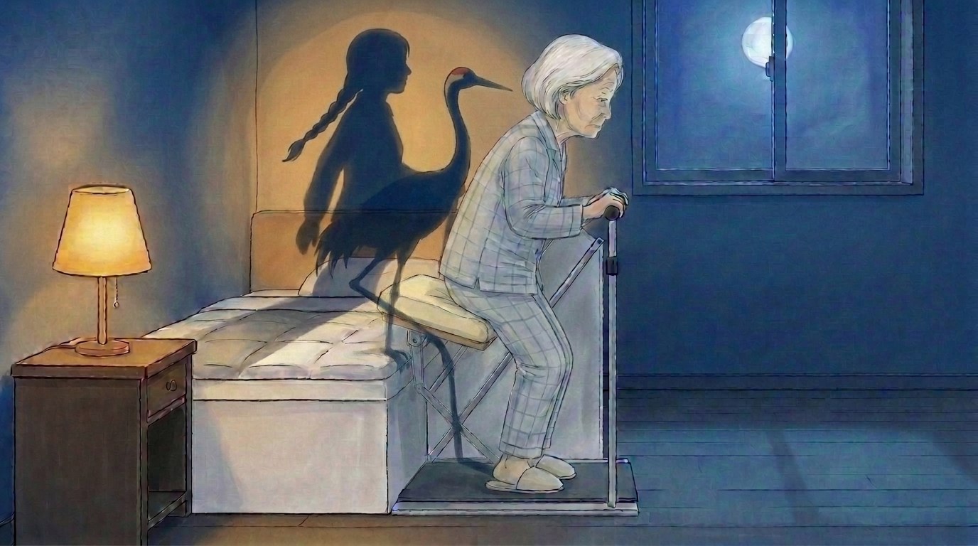
presentation/video/panels/Y5.jpg
