xiaweiyi0423/me5412-bedexit-proposal/presentation/video/panels/Y6.jpg

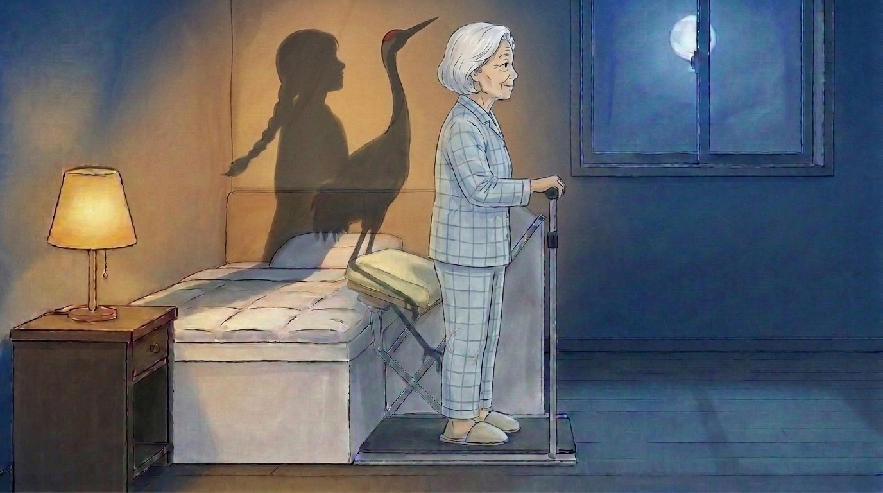
presentation/video/panels/Y6.jpg
