xiaweiyi0423/me5412-bedexit-proposal/presentation/video/panels/Y9.jpg

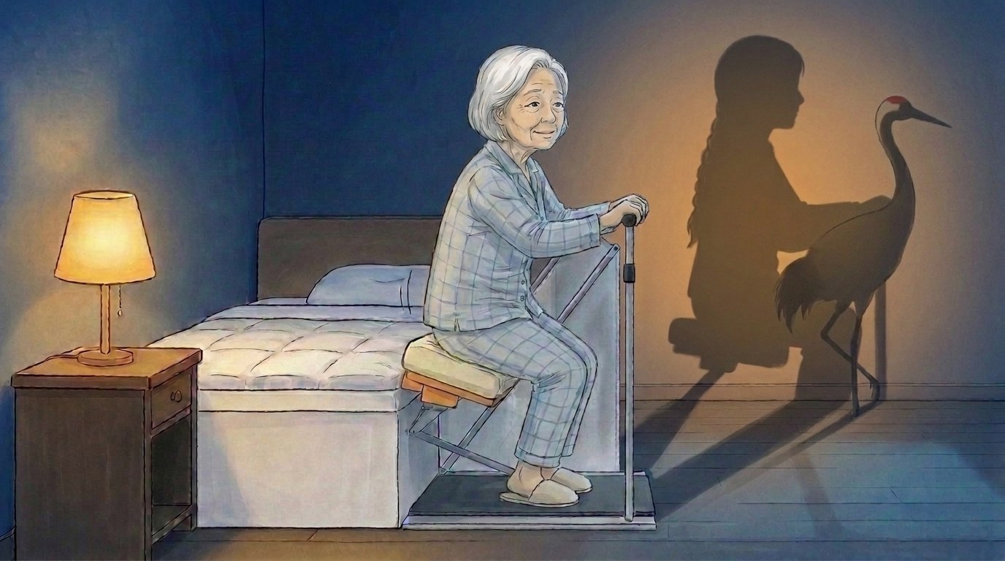
presentation/video/panels/Y9.jpg
