xiaweiyi0423/me5412-bedexit-proposal/presentation/video/panels/young_2d.jpg

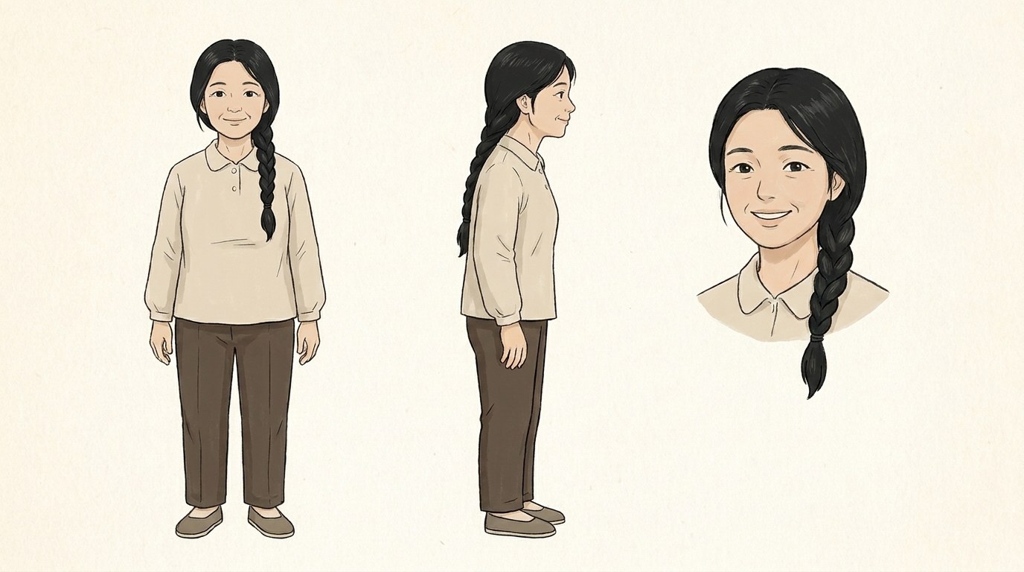
presentation/video/panels/young_2d.jpg
