xiaweiyi0423/me5412-bedexit-proposal/presentation/video/panels_sheet.jpg

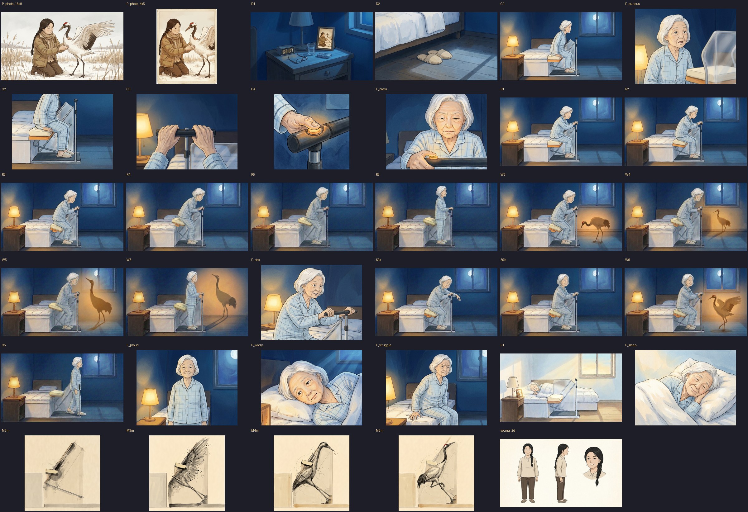
presentation/video/panels_sheet.jpg
