xiaweiyi0423/me5412-bedexit-proposal/presentation/video/pulse/styleframes.jpg

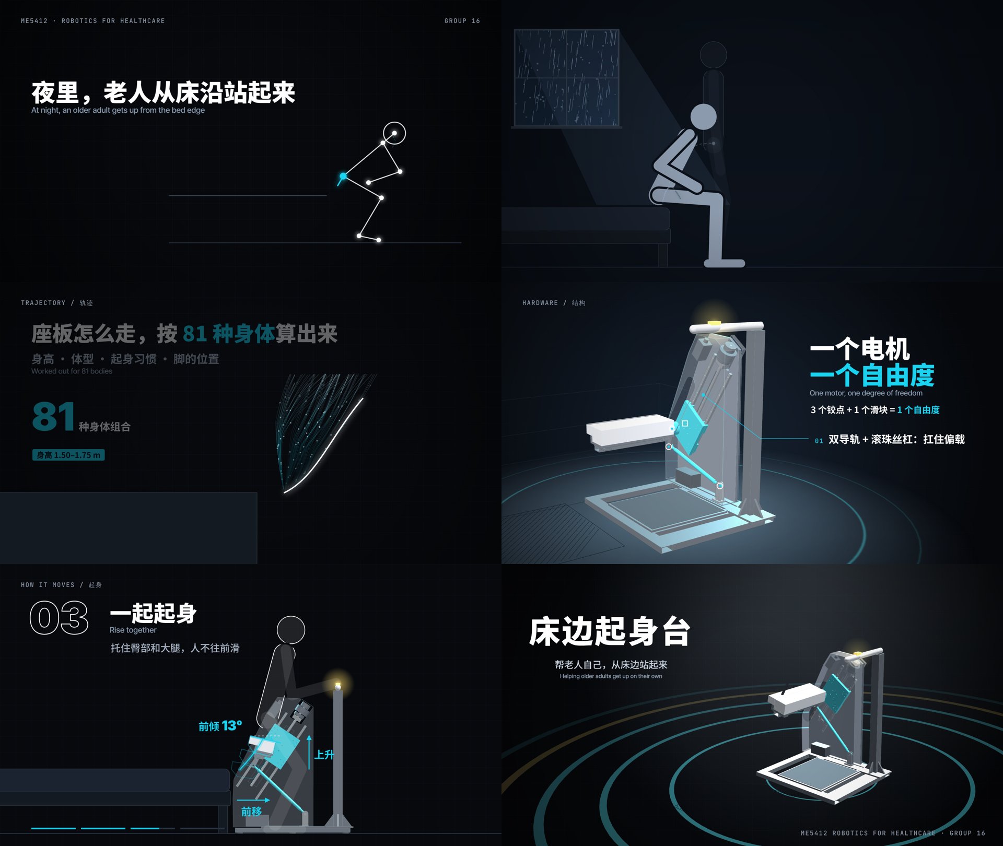
presentation/video/pulse/styleframes.jpg
