xiaweiyi0423/me5412-bedexit-proposal/presentation/video/storyboard_sheet.jpg

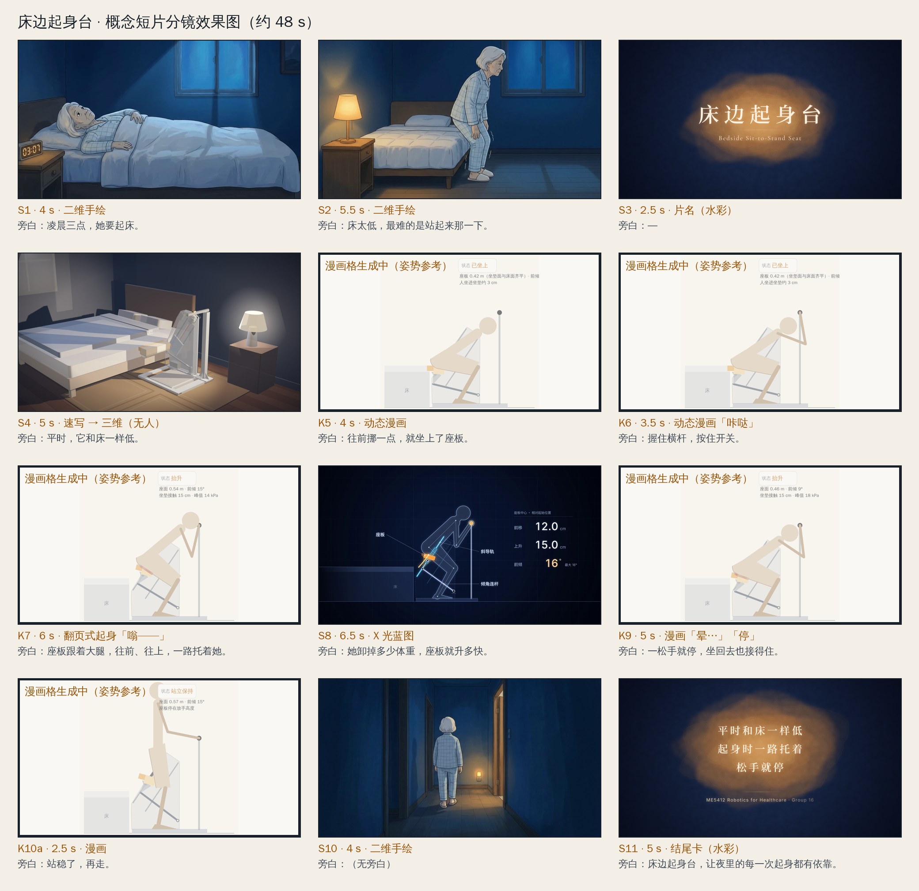
presentation/video/storyboard_sheet.jpg
