xiaweiyi0423/me5412-bedexit-proposal/cad/out/step/assembly_flush.step

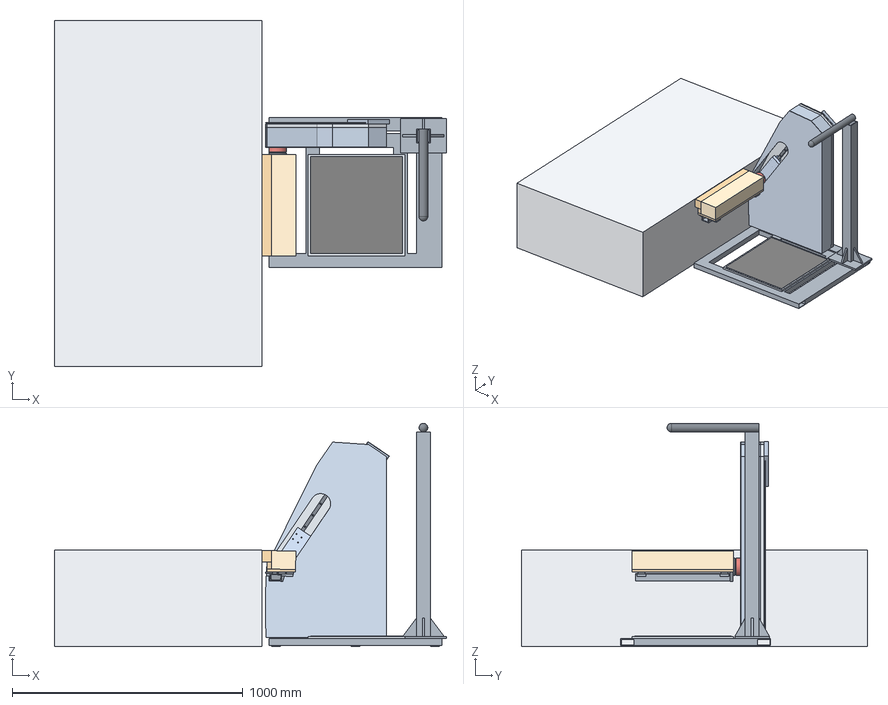
[picture p145: CAD file, 2026-10-27]
cad/out/step/assembly_flush.step
1700.0 x 1500.0 x 969.0 mm
S1
S2
S4
S4b
S5_1 x 4
S6_1 x 2
S7
S8
J1
J5
J4
C1
J3
J2_1 x 2
C2_1 x 4
C3
D2n
L1
L2_1 x 2
L3
D1_1 x 2
D2
D2a
D3
D4
D5
D6
H1
H2
H3
H4
H5
B1
B1a_1 x 6
B2
B2b
B4
B5
B7
BED
