xiaweiyi0423/me5412-bedexit-proposal/cad/out/step/D3.step

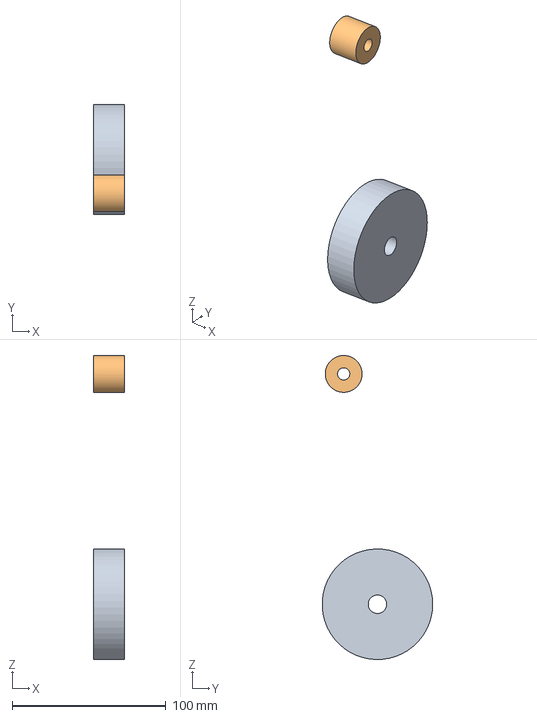
[picture p146: CAD file, 2026-10-27]
cad/out/step/D3.step
20.0 x 71.9 x 198.0 mm
