xiaweiyi0423/me5412-bedexit-proposal/cad/out/step/L3.step

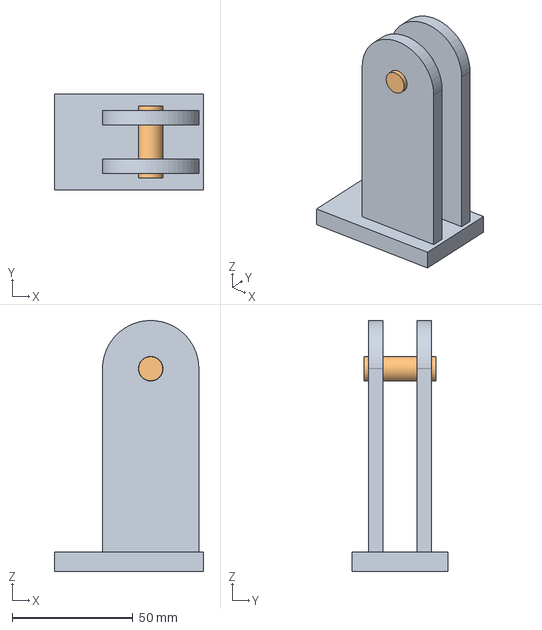
[picture p147: CAD file, 2026-10-27]
cad/out/step/L3.step
62.0 x 40.0 x 104.1 mm
