xiaweiyi0423/me5412-bedexit-proposal/cad/out/step/D2n.step

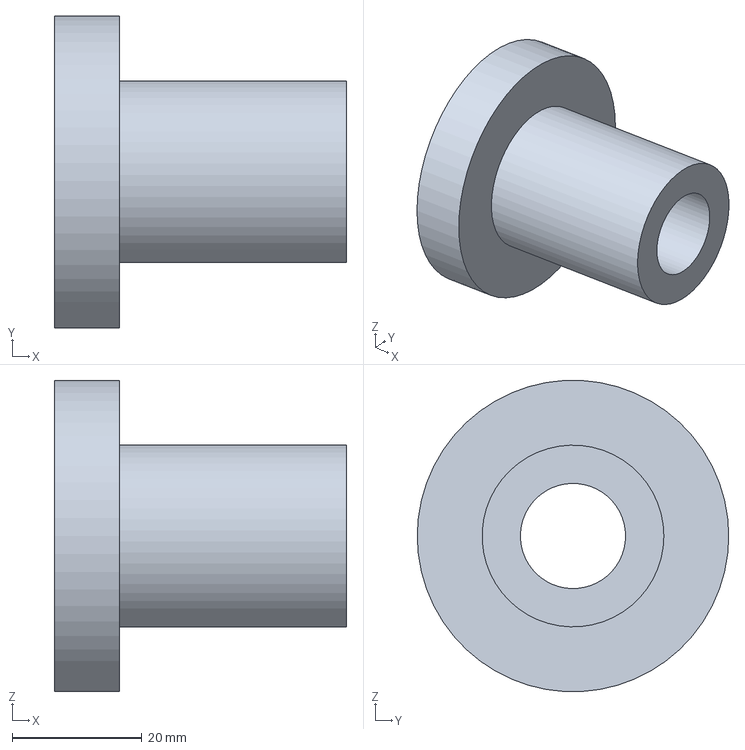
[picture p148: CAD file, 2026-10-27]
cad/out/step/D2n.step
45.0 x 48.0 x 47.9 mm
