xiaweiyi0423/me5412-bedexit-proposal/cad/out/step/S1.step

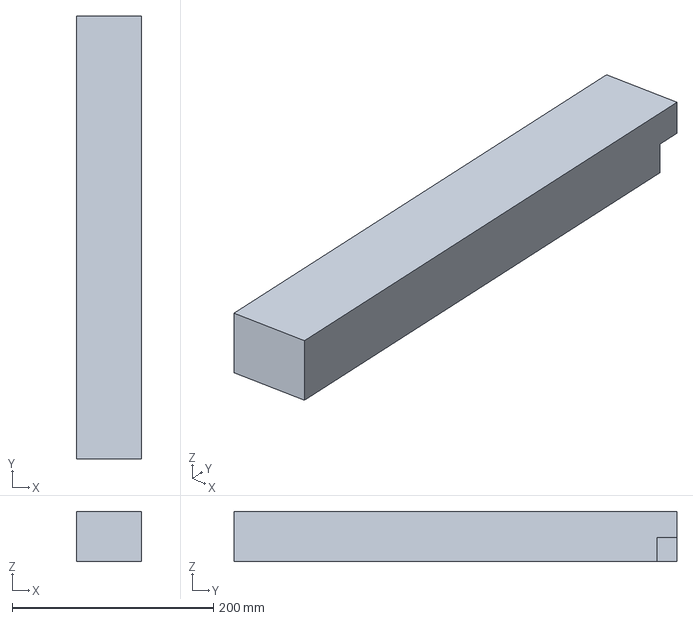
[picture p149: CAD file, 2026-10-27]
cad/out/step/S1.step
65.0 x 440.0 x 50.0 mm
