xiaweiyi0423/me5412-bedexit-proposal/cad/out/step/C1.step

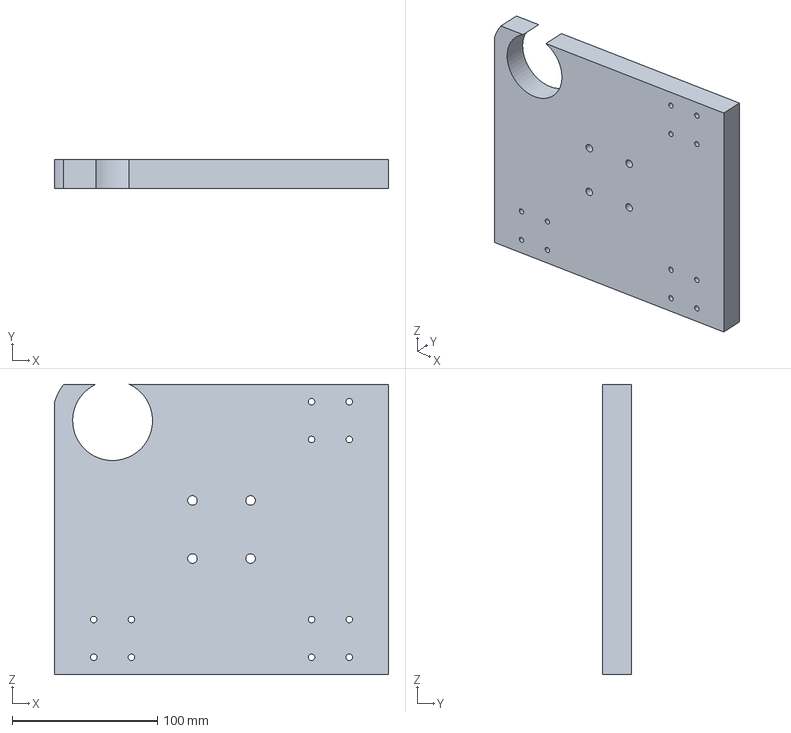
[picture p150: CAD file, 2026-10-27]
cad/out/step/C1.step
230.0 x 20.0 x 200.0 mm
