xiaweiyi0423/me5412-bedexit-proposal/cad/out/step/J4.step

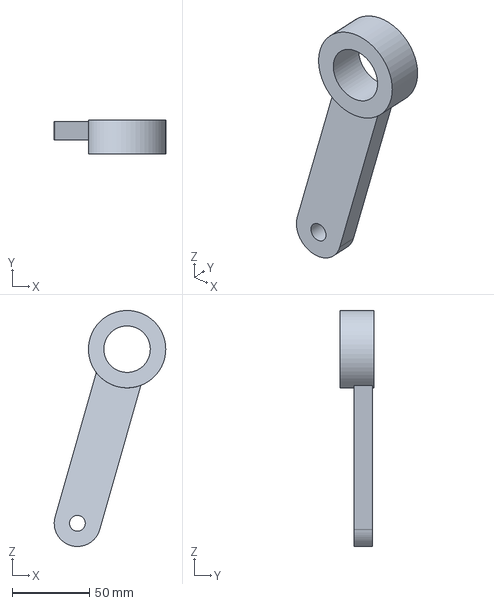
[picture p151: CAD file, 2026-10-27]
cad/out/step/J4.step
72.1 x 22.0 x 152.5 mm
