xiaweiyi0423/me5412-bedexit-proposal/cad/out/step/D5.step

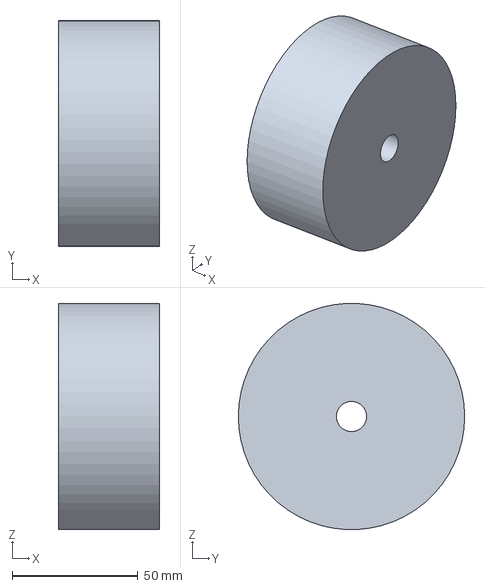
[picture p152: CAD file, 2026-10-27]
cad/out/step/D5.step
40.0 x 90.0 x 89.9 mm
