xiaweiyi0423/me5412-bedexit-proposal/cad/out/step/S4.step

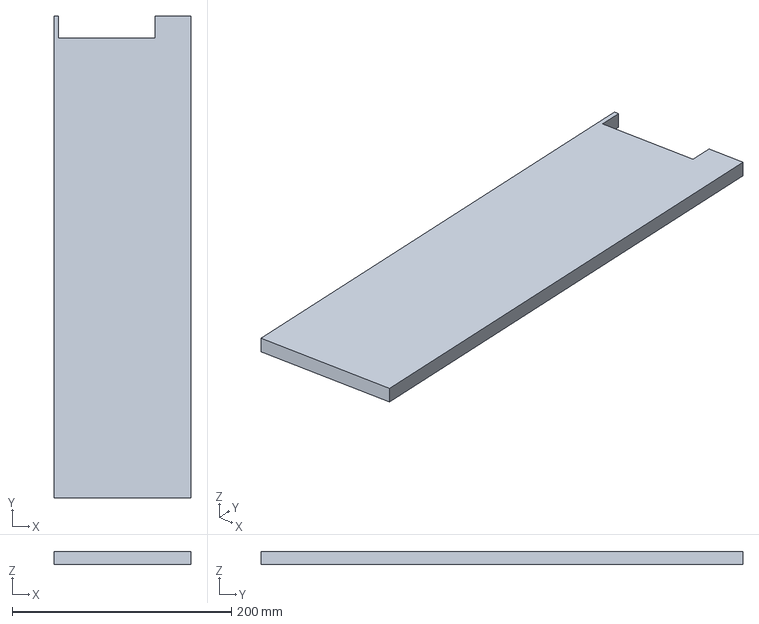
[picture p153: CAD file, 2026-10-27]
cad/out/step/S4.step
125.0 x 440.0 x 12.0 mm
