xiaweiyi0423/me5412-bedexit-proposal/cad/out/step/B7.step

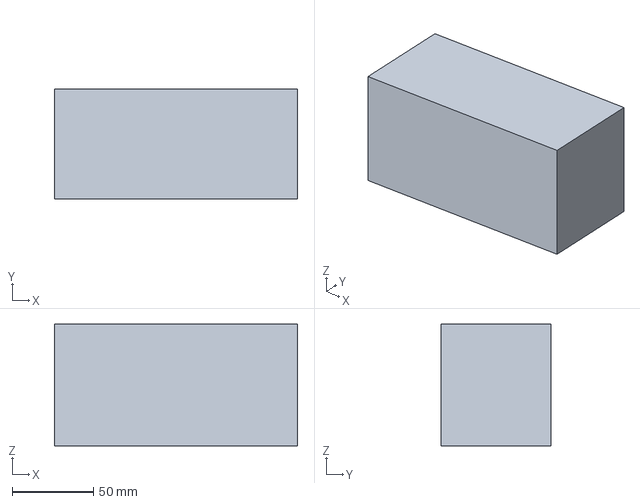
[picture p154: CAD file, 2026-10-27]
cad/out/step/B7.step
150.0 x 68.0 x 75.0 mm
