xiaweiyi0423/me5412-bedexit-proposal/cad/out/step/H1.step

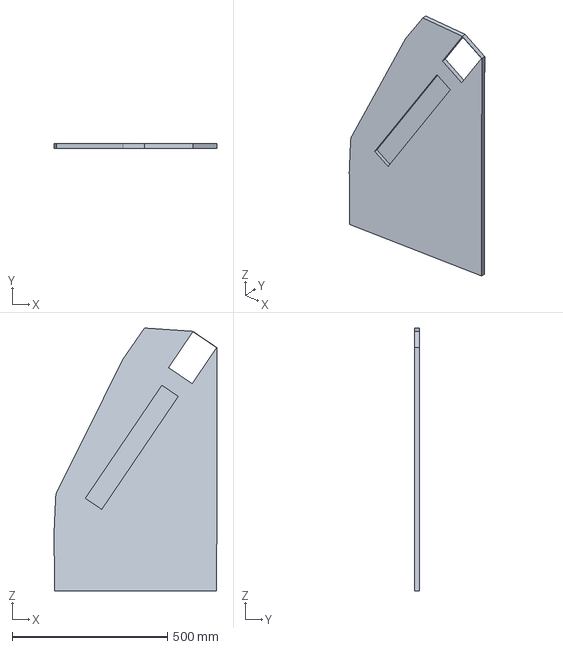
[picture p155: CAD file, 2026-10-27]
cad/out/step/H1.step
525.1 x 15.0 x 847.5 mm
