xiaweiyi0423/me5412-bedexit-proposal/cad/out/step/H4.step

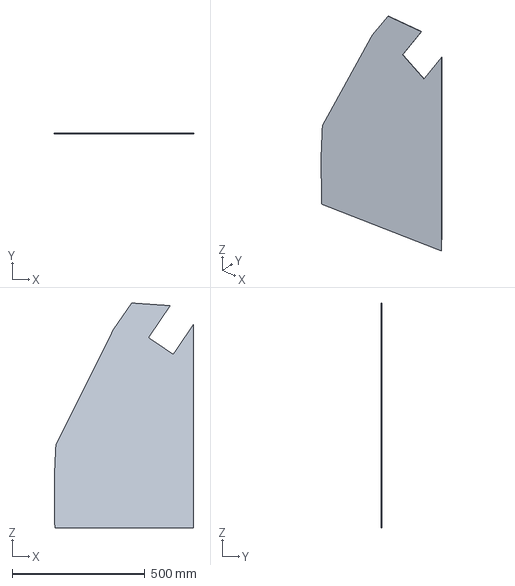
[picture p156: CAD file, 2026-10-27]
cad/out/step/H4.step
525.1 x 1.50 x 847.5 mm
