xiaweiyi0423/me5412-bedexit-proposal/cad/out/step/B2b.step

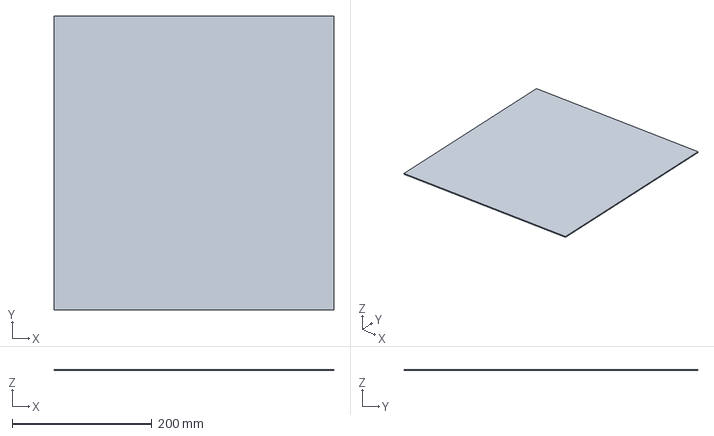
[picture p157: CAD file, 2026-10-27]
cad/out/step/B2b.step
400.0 x 420.0 x 2.00 mm
