xiaweiyi0423/me5412-bedexit-proposal/cad/out/step/S4b.step

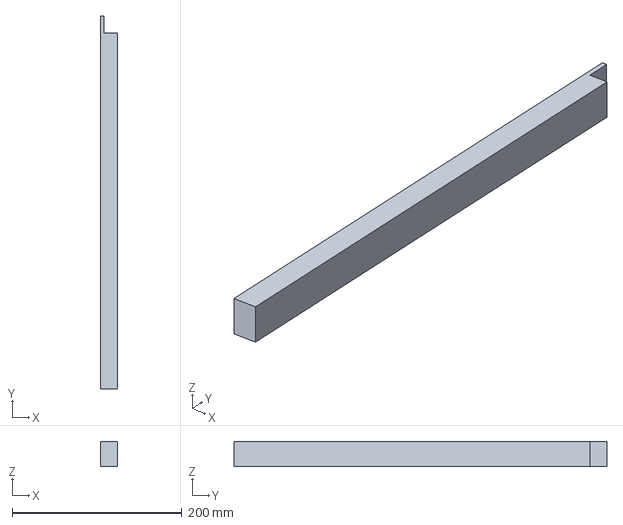
[picture p158: CAD file, 2026-10-27]
cad/out/step/S4b.step
20.0 x 440.0 x 30.0 mm
