xiaweiyi0423/me5412-bedexit-proposal/cad/out/step/D6.step

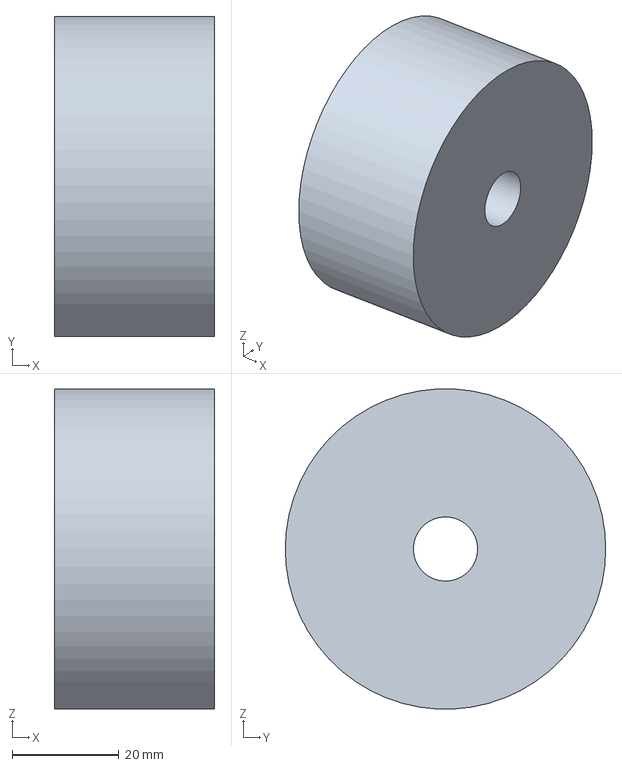
[picture p159: CAD file, 2026-10-27]
cad/out/step/D6.step
30.0 x 60.0 x 59.9 mm
