xiaweiyi0423/me5412-bedexit-proposal/cad/out/step/S5.step

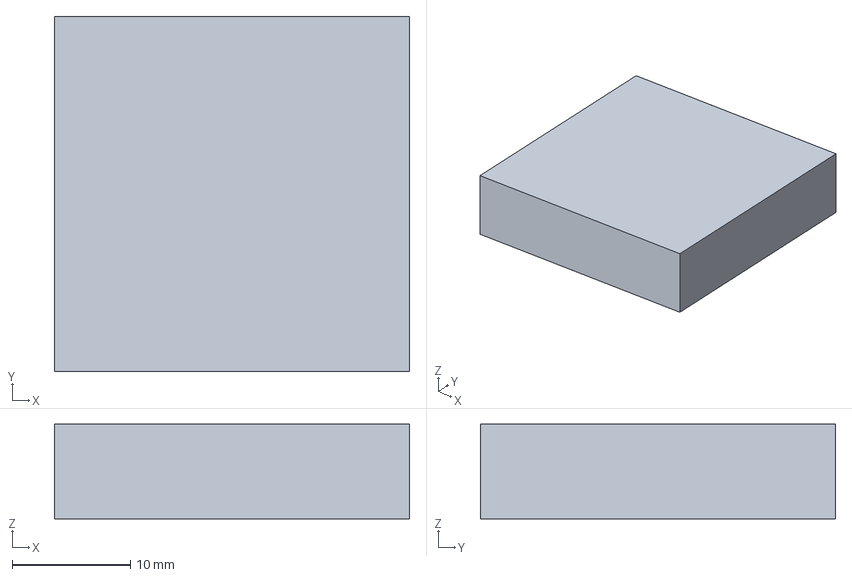
[picture p160: CAD file, 2026-10-27]
cad/out/step/S5.step
30.0 x 30.0 x 8.00 mm
