xiaweiyi0423/me5412-bedexit-proposal/cad/out/step/C3.step

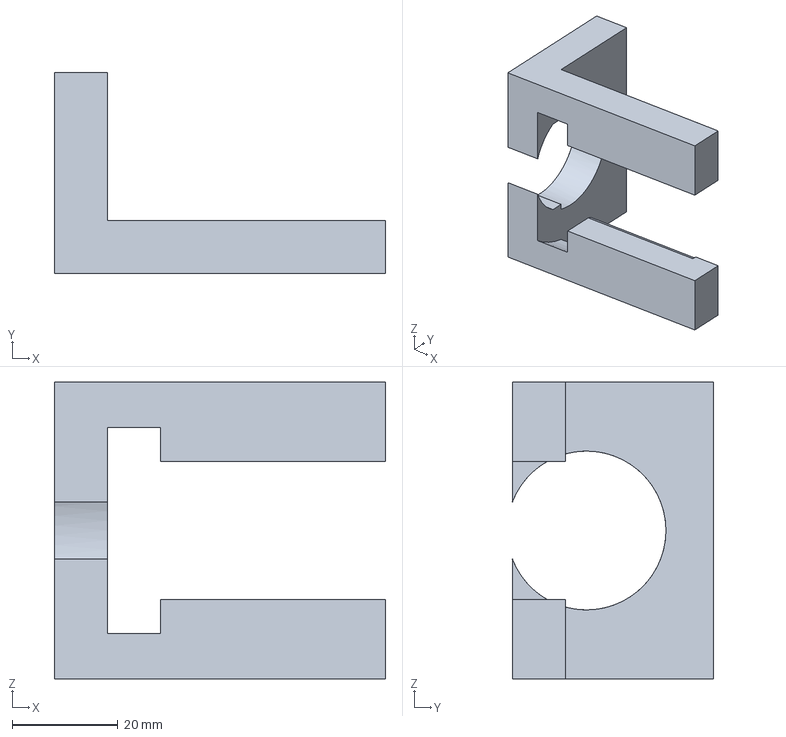
[picture p161: CAD file, 2026-10-27]
cad/out/step/C3.step
62.5 x 38.0 x 56.0 mm
