xiaweiyi0423/me5412-bedexit-proposal/cad/out/step/S8.step

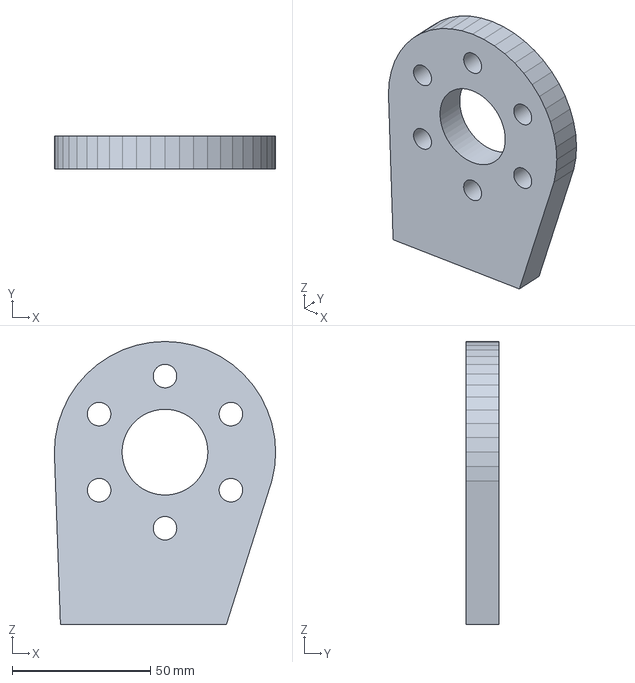
[picture p162: CAD file, 2026-10-27]
cad/out/step/S8.step
80.0 x 12.0 x 102.3 mm
