xiaweiyi0423/me5412-bedexit-proposal/cad/out/step/L2.step

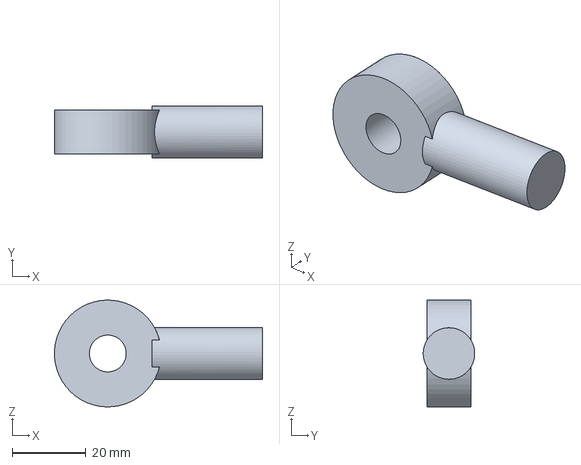
[picture p163: CAD file, 2026-10-27]
cad/out/step/L2.step
56.5 x 14.0 x 29.0 mm
