xiaweiyi0423/me5412-bedexit-proposal/cad/out/step/J1.step

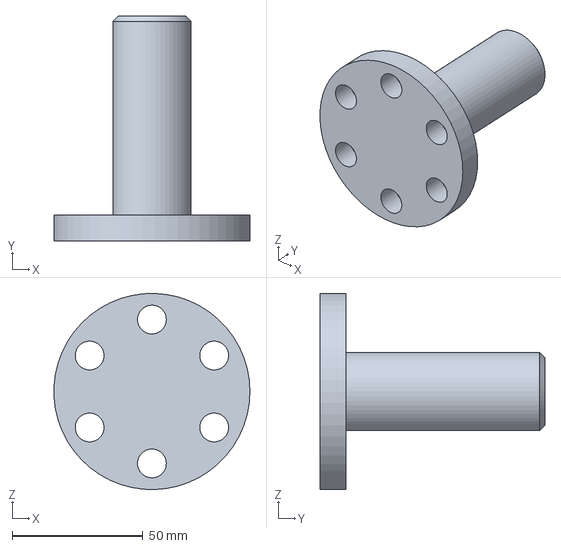
[picture p164: CAD file, 2026-10-27]
cad/out/step/J1.step
74.9 x 86.0 x 75.0 mm
