xiaweiyi0423/me5412-bedexit-proposal/cad/out/step/S6.step

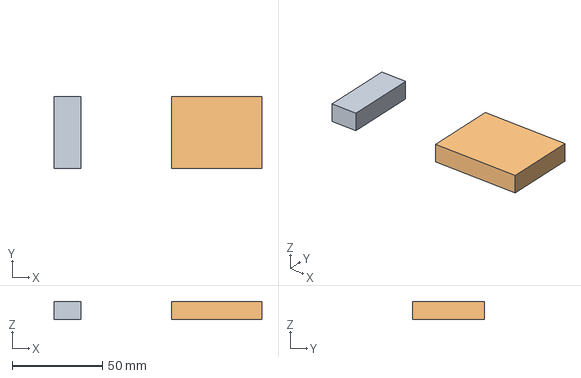
[picture p165: CAD file, 2026-10-27]
cad/out/step/S6.step
115.0 x 40.0 x 10.0 mm
