xiaweiyi0423/me5412-bedexit-proposal/cad/out/step/L1.step

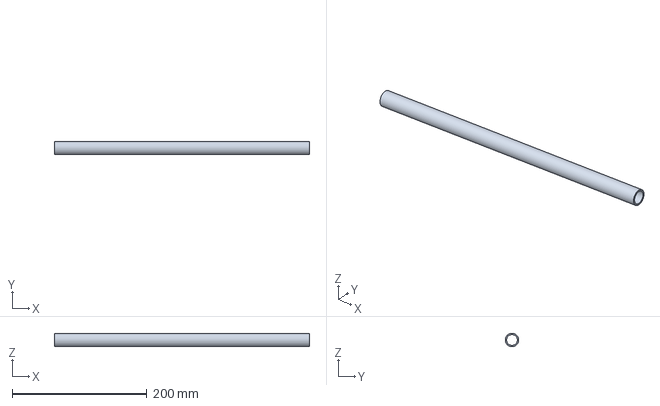
[picture p166: CAD file, 2026-10-27]
cad/out/step/L1.step
378.7 x 20.0 x 20.0 mm
