xiaweiyi0423/me5412-bedexit-proposal/cad/out/step/B1a.step

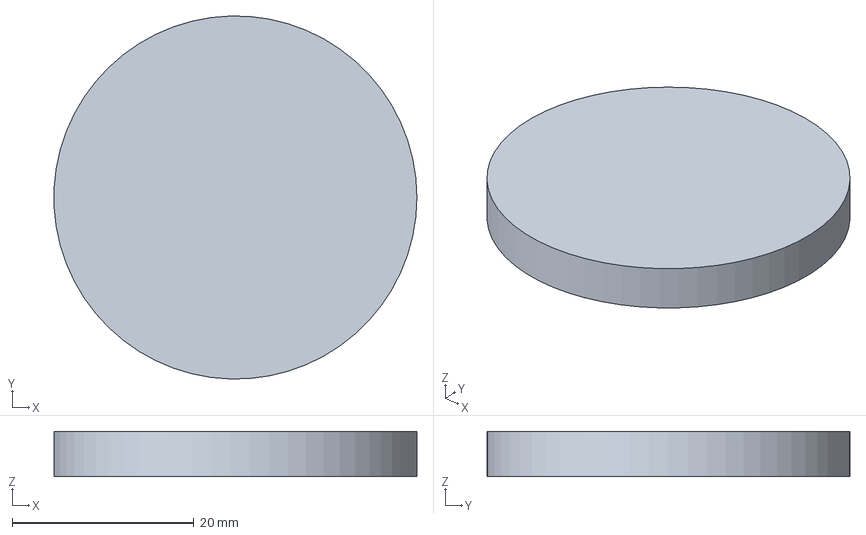
[picture p167: CAD file, 2026-10-27]
cad/out/step/B1a.step
40.0 x 40.0 x 5.00 mm
