xiaweiyi0423/me5412-bedexit-proposal/cad/out/step/B2.step

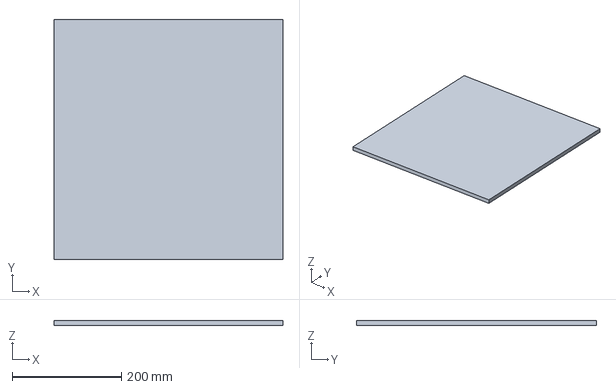
[picture p168: CAD file, 2026-10-27]
cad/out/step/B2.step
420.0 x 440.0 x 10.0 mm
