xiaweiyi0423/me5412-bedexit-proposal/cad/out/step/S2.step

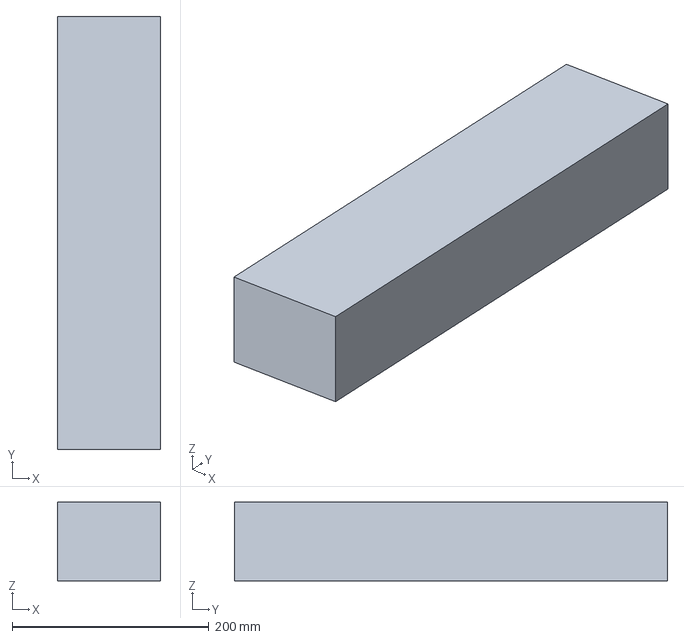
[picture p169: CAD file, 2026-10-27]
cad/out/step/S2.step
105.0 x 440.0 x 80.0 mm
