xiaweiyi0423/me5412-bedexit-proposal/cad/out/step/J2.step

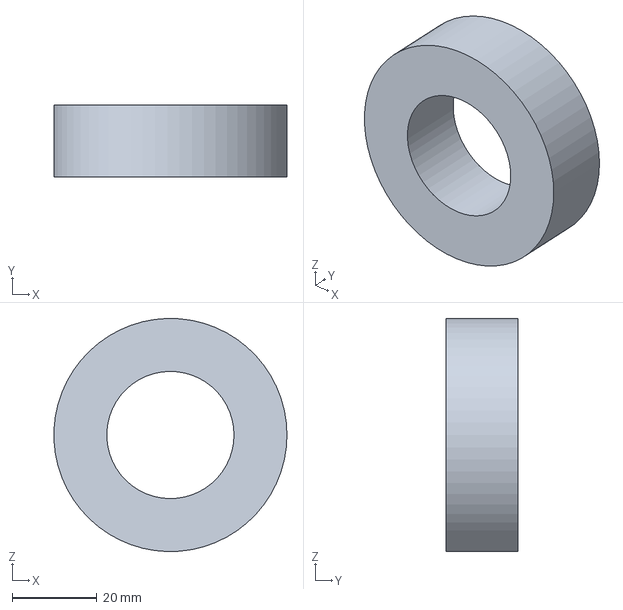
[picture p170: CAD file, 2026-10-27]
cad/out/step/J2.step
55.0 x 17.0 x 55.0 mm
