xiaweiyi0423/me5412-bedexit-proposal/cad/out/step/B1.step

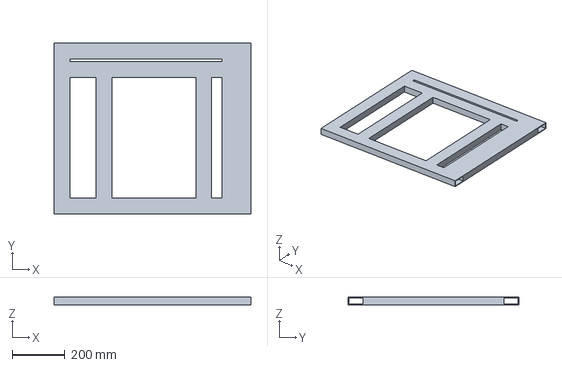
[picture p171: CAD file, 2026-10-27]
cad/out/step/B1.step
750.0 x 650.0 x 30.0 mm
