xiaweiyi0423/me5412-bedexit-proposal/cad/out/step/D2.step

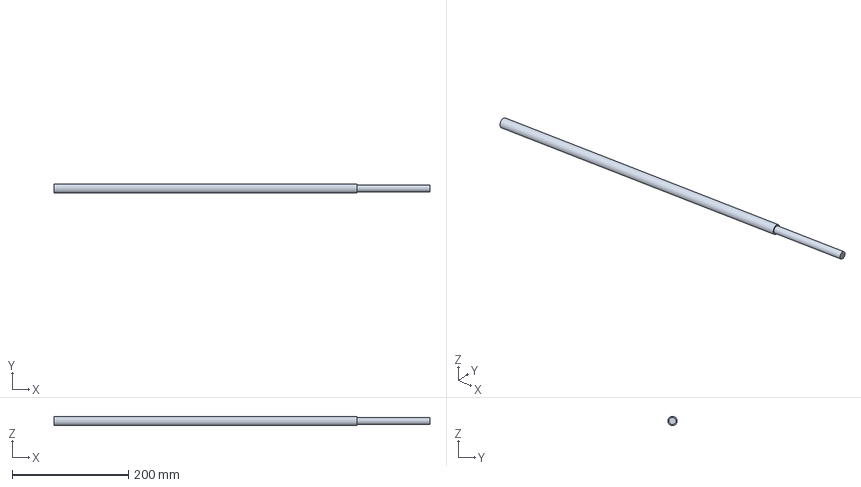
[picture p172: CAD file, 2026-10-27]
cad/out/step/D2.step
647.0 x 16.0 x 16.0 mm
