xiaweiyi0423/me5412-bedexit-proposal/cad/out/step/S7.step

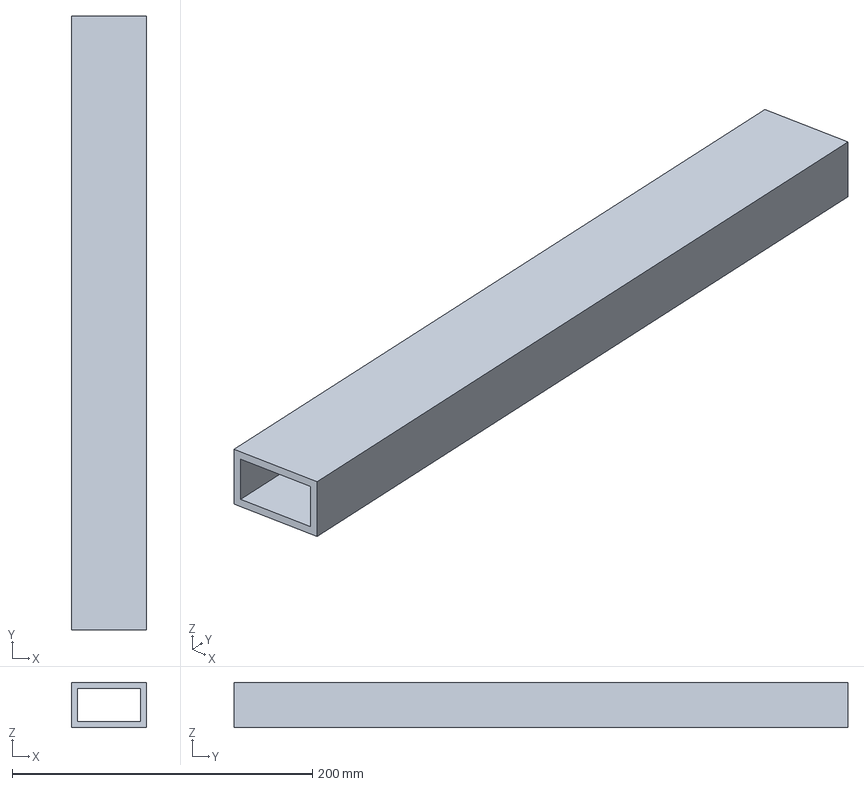
[picture p173: CAD file, 2026-10-27]
cad/out/step/S7.step
50.0 x 409.0 x 30.0 mm
