xiaweiyi0423/me5412-bedexit-proposal/cad/out/step/H3.step

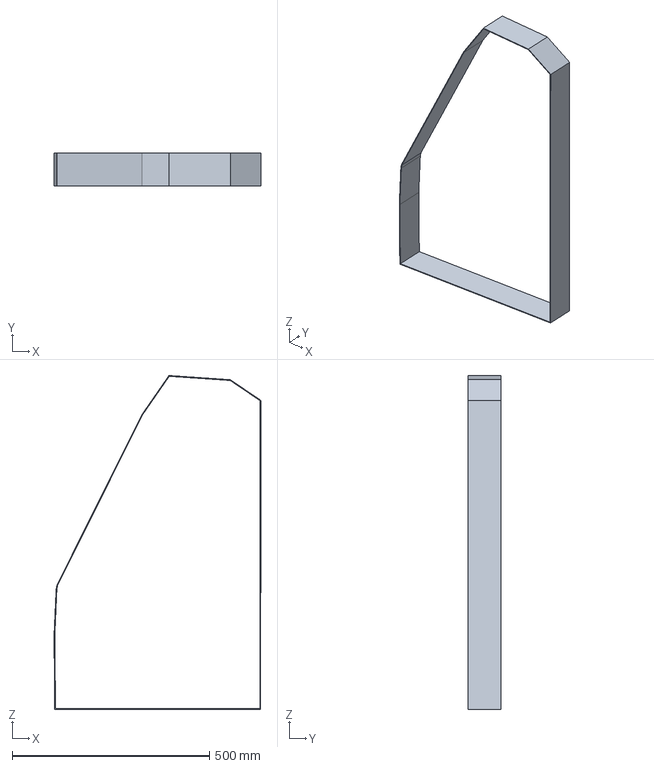
[picture p174: CAD file, 2026-10-27]
cad/out/step/H3.step
525.1 x 84.0 x 847.5 mm
