xiaweiyi0423/me5412-bedexit-proposal/cad/out/step/H2.step

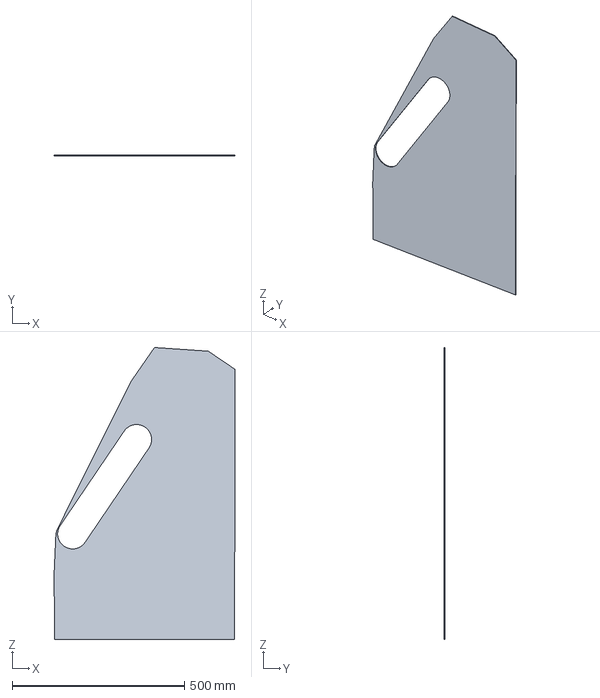
[picture p175: CAD file, 2026-10-27]
cad/out/step/H2.step
525.1 x 2.00 x 847.5 mm
