xiaweiyi0423/me5412-bedexit-proposal/cad/out/step/J3.step

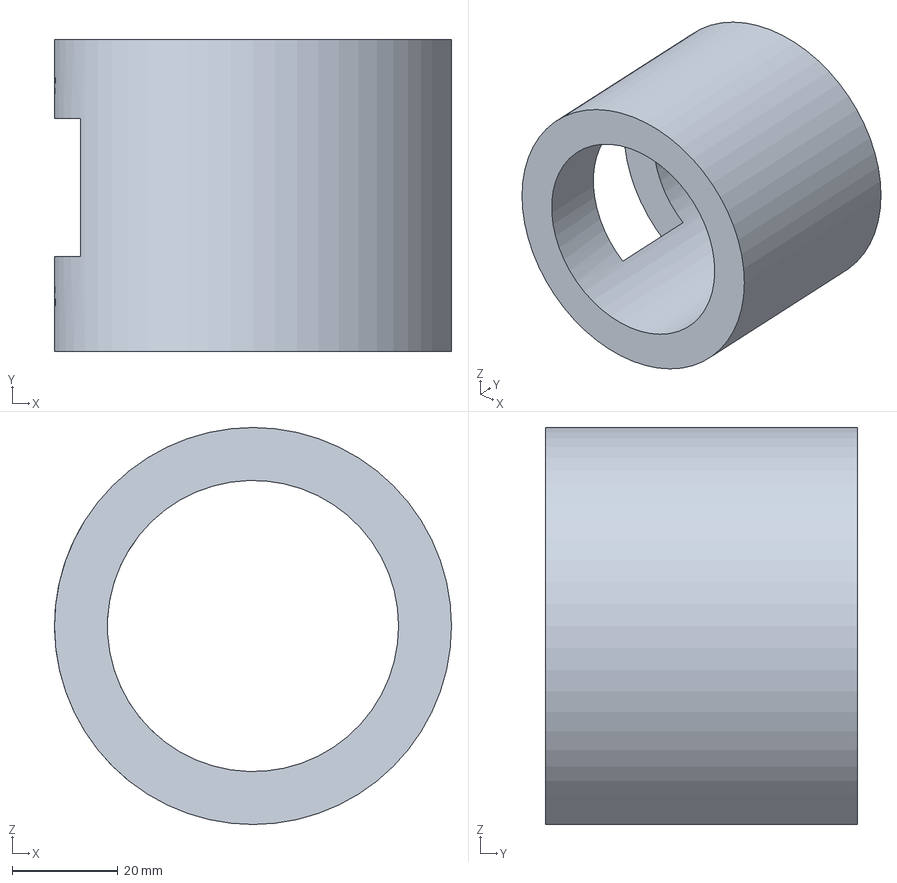
[picture p176: CAD file, 2026-10-27]
cad/out/step/J3.step
75.0 x 59.0 x 75.0 mm
