xiaweiyi0423/me5412-bedexit-proposal/cad/out/step/B4.step

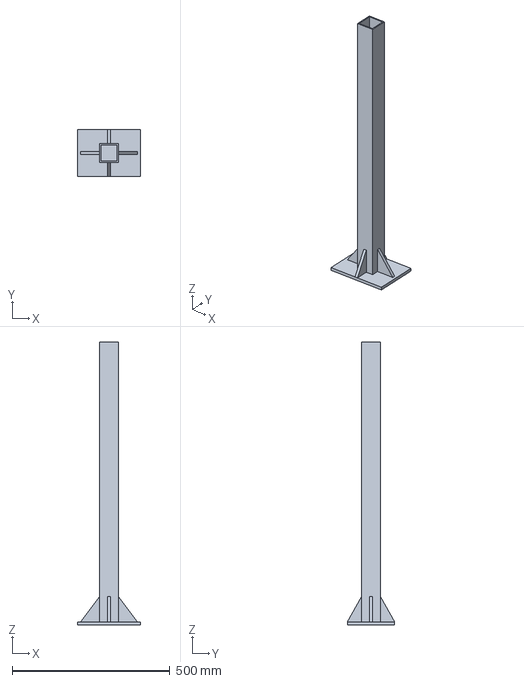
[picture p177: CAD file, 2026-10-27]
cad/out/step/B4.step
200.0 x 150.0 x 896.0 mm
