xiaweiyi0423/me5412-bedexit-proposal/cad/out/step/B5.step

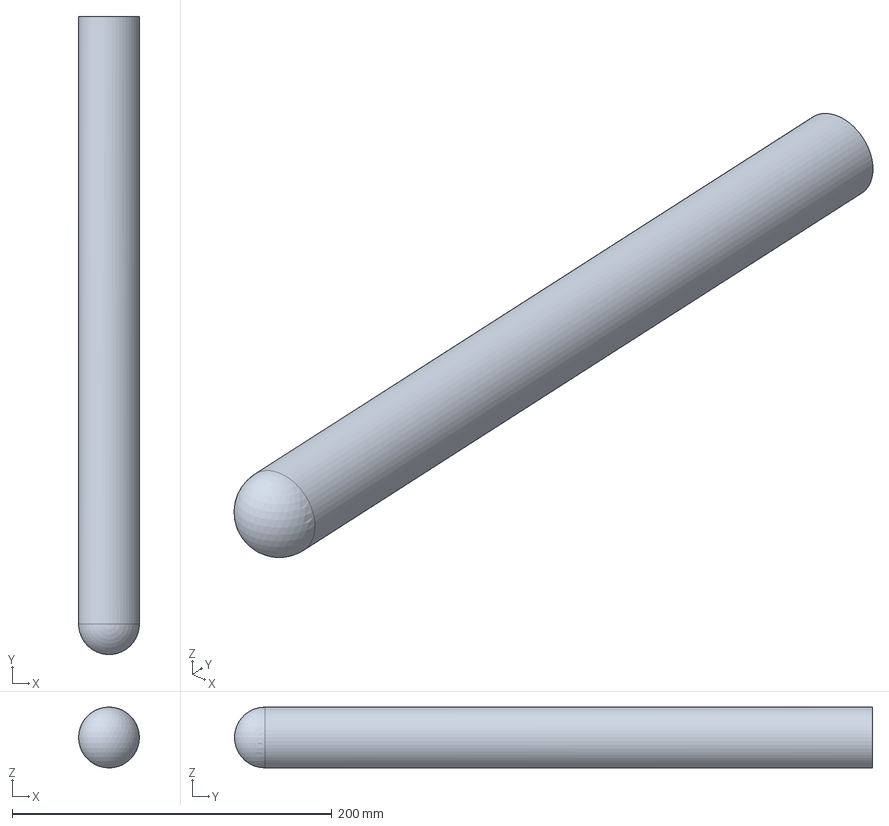
[picture p178: CAD file, 2026-10-27]
cad/out/step/B5.step
38.0 x 398.9 x 38.0 mm
