xiaweiyi0423/me5412-bedexit-proposal/cad/out/step/D2a.step

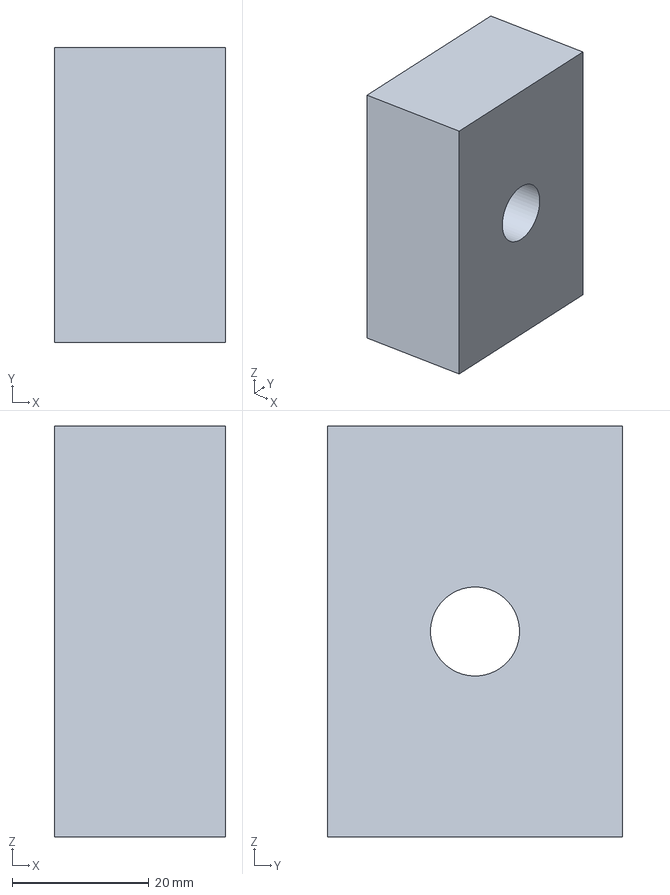
[picture p179: CAD file, 2026-10-27]
cad/out/step/D2a.step
25.0 x 43.0 x 60.0 mm
