xiaweiyi0423/me5412-bedexit-proposal/cad/out/step/BED.step

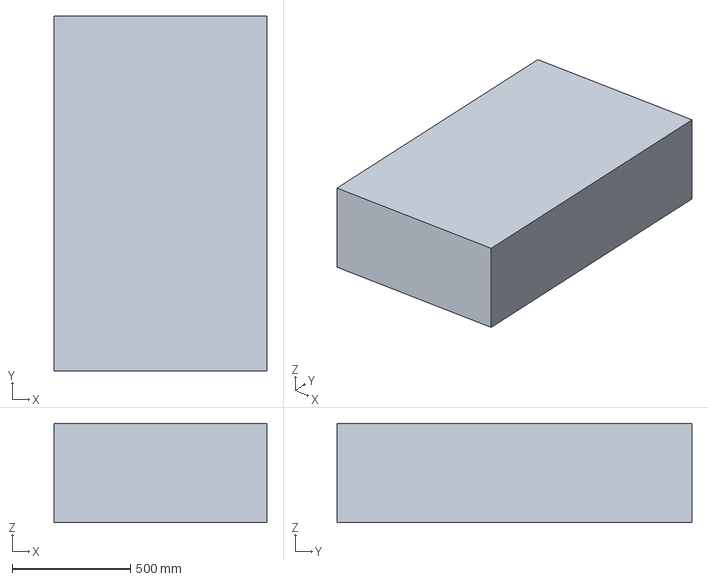
[picture p180: CAD file, 2026-10-27]
cad/out/step/BED.step
900.0 x 1500.0 x 420.0 mm
