xiaweiyi0423/me5412-bedexit-proposal/cad/out/step/D1.step

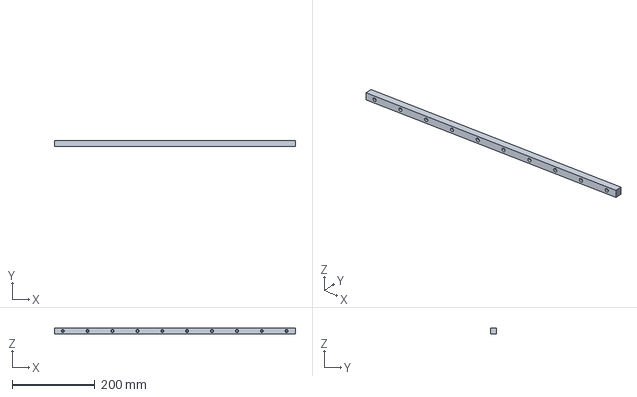
[picture p181: CAD file, 2026-10-27]
cad/out/step/D1.step
581.3 x 15.0 x 15.0 mm
