xiaweiyi0423/me5412-bedexit-proposal/cad/out/step/H5.step

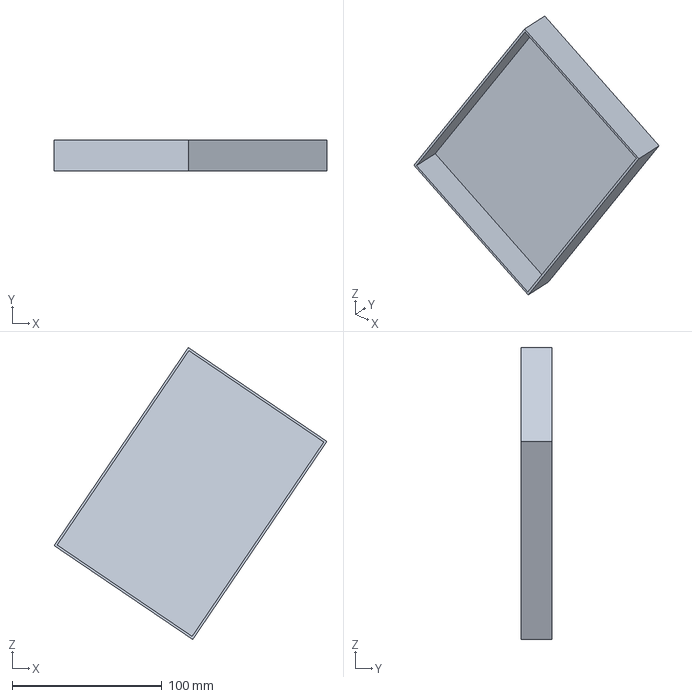
[picture p182: CAD file, 2026-10-27]
cad/out/step/H5.step
182.5 x 21.0 x 195.3 mm
