xiaweiyi0423/me5412-bedexit-proposal/cad/out/step/C2.step

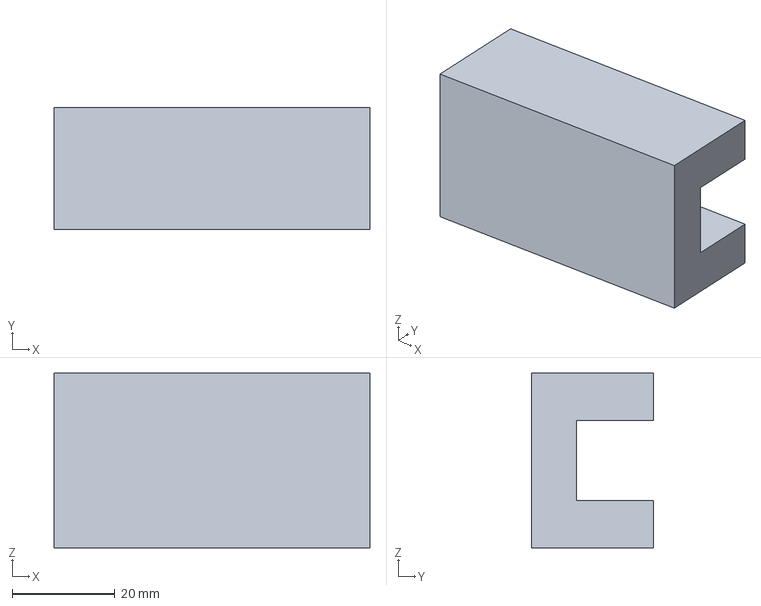
[picture p183: CAD file, 2026-10-27]
cad/out/step/C2.step
61.4 x 23.7 x 34.0 mm
