xiaweiyi0423/me5412-bedexit-proposal/cad/out/step/D4.step

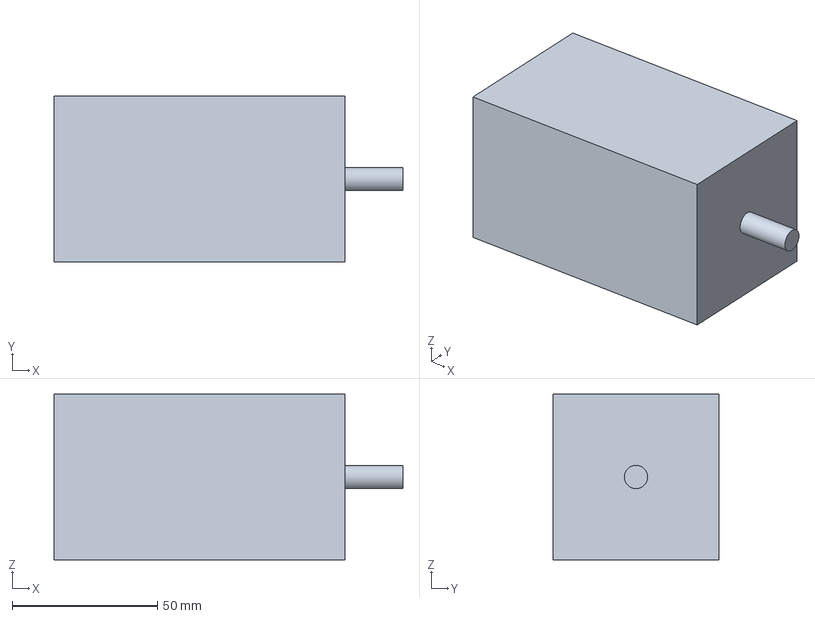
[picture p184: CAD file, 2026-10-27]
cad/out/step/D4.step
120.0 x 57.0 x 57.0 mm
