xiaweiyi0423/me5412-bedexit-proposal/cad/out/step/J5.step

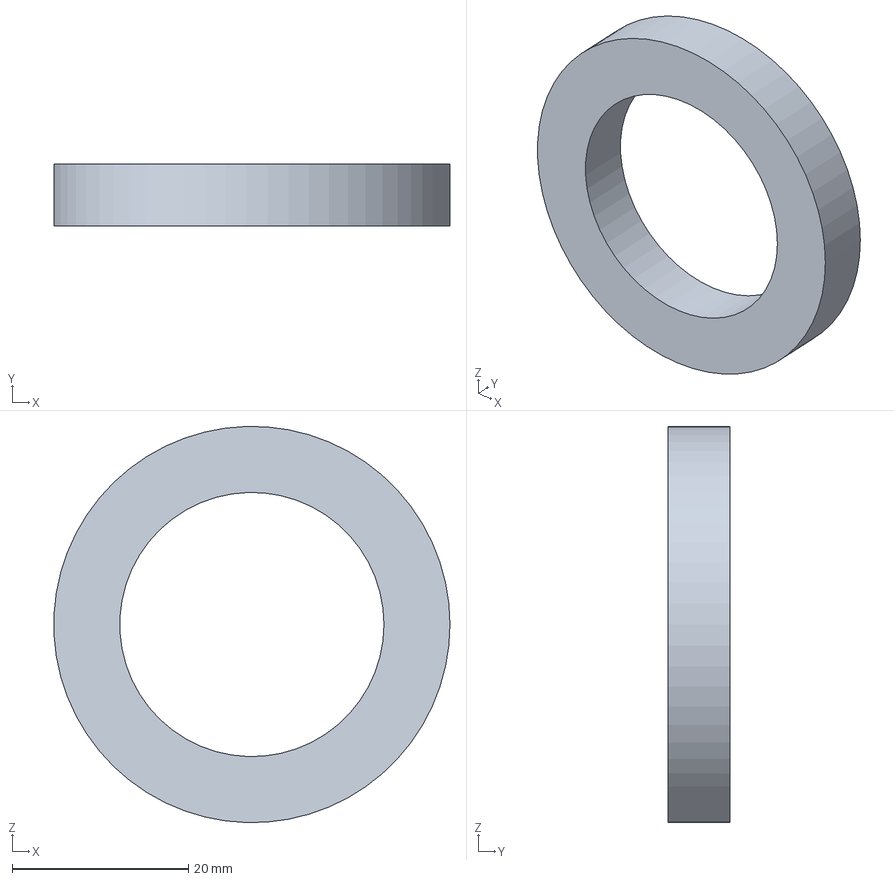
[picture p185: CAD file, 2026-10-27]
cad/out/step/J5.step
45.0 x 7.00 x 45.0 mm
