xiaweiyi0423/me5412-bedexit-proposal/(list of files, cad)

Other CAD files:
cad/out/step/assembly_top.step
