xiaweiyi0423/me5412-bedexit-proposal/presentation/tools/talk_guide.html

ME5412 GROUP 16 · 10/27 CONSULTATION

# 起身台汇报讲稿

10/28 更新（v6，15 分钟版）：封面后放 46 秒短片；“问题”和“用户”合成一页，“传感”和“速度”合成一页，“单侧悬臂”并入机构第三步；“一次完整的使用”“单侧悬臂”“速度规则与仿真”“离开踏板时摔倒”“建模和有限元”移到附录；“现有方案”和“方案比较”配了侧视简图，“方案比较”改成以“腿一软时接不接得住”为主线；运动演示和传感页放了短片里的循环片段；讲稿整体压缩约三分之一。
配合 29 页 slides 使用：19 页主讲、9 页附录，加 1 页只在沟通时用的问题页。

## 一眼看懂

正式汇报完整讲一遍

约 15 分钟

19 页主 slides（含 46 秒短片）合计约 14.8 分钟，按每分钟 230 字加指图时间估；附录不计时长。

时间紧时

约 9 分钟

只讲 11 页：封面 → 短片 → 问题 → 方案比较 → 选机构 → 机构 → 运动 → 传感 → 状态机 → 验证 → 结论。

待补

16 项

其中 2 项 11/3 必须有：有限元。CAD 运动动画已有（运动演示页），待老师确认是否够。

## 待补清单（明天给老师看的重点）

这些内容 slides 上已经留了位置、讲的时候说明“在做”。老师看完结构后，最值得问的是：这里面哪一项最重要，还有没有缺的。

在哪一页 | 还缺什么 | 谁做 | 什么时候
1 封面 | 填组员姓名 | 全员 | 11/3
2 46 秒短片 | 在汇报用的电脑上试播：点一下能否带声音播放；备一份离线 mp4（presentation/video/pulse/bedexit_pulse.mp4） | 全员 | 11/3
4 问题与用户 | 三个数字（一半、0.58 m、22%）打开原文再核对一次 | 角色 1 | 11/3
5 现有方案 | 附录：完整的现有技术表和引用格式 | 角色 1 | 11/3
10 运动演示 | CAD 运动动画：本页左图已是 CAD 零件按真实运动学驱动的动画；和老师确认是否还要 SolidWorks 运动算例 | 角色 3 | 11/3
11 稳定性 | 用 CAD 的真实质量和质心复核 | 角色 4（等角色 3 的 CAD） | 11/3
11 稳定性 | 固定件的具体形式（床腿夹或绕床架的对拉带） | 角色 3、4 | 11/3
14 风险和对策 | 附录：完整风险表（严重度、发生可能性、检测方式、对策） | 角色 4、5 | 11/3
15 防跌倒①：侧向摔倒 | 决定敞开侧对策：可翻下的挡板，或座板测力发现重心侧偏就停（后者要先仿真） | 角色 2、3、5 | 11/3
16 需求 → 验证 → 结果 | FEA：座板支架、滑块板和固定件在 1.5 倍体重下的应力和变形 | 角色 4 | 11/3 必须
16 需求 → 验证 → 结果 | 稳定性用真实质量复核后更新这一行 | 角色 4 | 11/3
19 分工与贡献 | 组员姓名和最终分工，明天组内讨论后填 | 全员 | 明天
23 附录：速度随人自适应 | 把全部 16 个场景的图（controller_seat_all.png）放进附录 | 角色 5 | 11/3
24 附录：离开踏板时摔倒 | 实测验证离开踏板的摔倒检测：志愿者软垫摔倒动作 + 老人正常离开（≥ 80% 检出、≤ 5 次误报 / 100 才继续） | 角色 5 | 11/3 之后
25 附录：建模和有限元 | FEA：四个部位的应力和变形（滑块板 + 轴承座焊接件、横梁焊缝、机构箱开槽侧板、扶手立柱；载荷、边界条件、判据在机构网页） | 角色 4 | 11/3 必须
28 附录：驱动选型 | 用厂家样本核对已初选的型号：丝杠 R16-10、导轨 HGR15 + 滑块 HGH15CA、轴承 32006 X、8 N·m 制动器、电机约 26 W | 角色 4 | 11/3

## 组装要讲的版本

slides 里的模块都保留着；这里只是选这一次讲哪些。勾选页面，下面的时长、主线和逐页讲稿会跟着变。选择只保存在你自己的浏览器里。

沟通：全部 29 页 11/3 正式汇报 时间紧（约 10 分钟）

### 页面

开场

1 封面 待补0.32 46 秒短片 待补0.93 汇报结构0.3

1 问题与用户

4 问题与用户 待补0.9

2 方案

5 现有方案 待补0.86 和其他起身方式比较1.2

3 机构与结构

7 机构设计①：座板该怎么走0.98 机构设计②：比了五种机构0.79 机构设计③：斜导轨 + 倾角连杆，单侧悬臂1.110 运动演示 待补0.711 稳定性 待补0.8

4 控制与安全

12 传感与速度0.913 状态机1.114 风险和对策 待补0.815 防跌倒①：侧向摔倒 待补0.9

5 验证与总结

16 需求 → 验证 → 结果 待补0.917 局限和后续工作0.518 结论0.719 分工与贡献 待补0.4

附录 · 本次沟通

20 附录目录附录21 附录：一次完整的使用附录22 附录：单侧悬臂怎么扛住附录23 附录：速度随人自适应 待补附录24 附录：离开踏板时摔倒 待补附录25 附录：建模和有限元 待补附录26 附录：零件编号附录27 附录：工程图附录28 附录：驱动选型 待补附录29 想请老师给个方向讨论

### 合并讲

“推杆选型”并进“机构”一起讲（约省 0.5 分钟） “状态机”并进“传感与交互”一起讲（约省 0.6 分钟）

讲述时长

—

页数

—

目标时长（分钟）

逻辑主线（虚线框 = 有待补；点击跳到讲稿）

## 逐页讲稿

按大约每分钟 230 字写，时长里加了指着图讲的时间。

只看有待补的页

第 1 页：封面

开场

第 1 页

### 封面

部分待补

这一页要让听众记住：一句话说清做什么：平时和床一样低；起身时座板跟着大腿前移、上升、前倾；速度跟着人，松手就停。

讲稿

大家好，我们是第 16 组，题目是“床边起身台”：帮腿力下降的老人夜里从床沿站起来。先请大家看一段 46 秒的短片。

- 待补：填组员姓名 · 全员 · 11/3

第 2 页：46 秒短片

开场

第 2 页

### 46 秒短片

内容齐

这一页要让听众记住：先用 46 秒把问题、产品、用法和安全过一遍，后面每页只讲细节。

讲稿

（点一下播放，46 秒，有声音；播放时不说话。）播完说：下面把片子里的每一步讲清楚。

- 待补：在汇报用的电脑上试播：点一下能否带声音播放；备一份离线 mp4（presentation/video/pulse/bedexit_pulse.mp4） · 全员 · 11/3

可能被问到

短片里的画面是真实的吗？

全部由代码生成，没有用 AI 生成画面：装置是 CAD 零件，按机构的真实运动学驱动；人物是扁平小人，姿态来自二维起身模型；画面里的三个数（81 种身体、轨迹误差 ≤ 8 mm、前倾角）都和模型一致。

为什么开场放短片？

15 分钟里先用不到 1 分钟让大家看到问题和产品，后面就不用再口头讲背景，每页直接讲依据。

第 3 页：汇报结构

开场

第 3 页

### 汇报结构

内容齐

这一页要让听众记住：五部分，主讲约 14 分钟（含 46 秒短片）；细节都在附录。

讲稿

汇报分五部分：问题和用户、方案比较、机构、控制与安全，最后用一张“需求—验证”表收尾。

第 4 页：问题与用户

1 问题与用户

第 4 页

### 问题与用户

部分待补

这一页要让听众记住：三个数说明矛盾：一半人从 38 cm 的床站不起来；床高上限约 0.58 m；22% 有体位性低血压。用户是能走、但从普通床起身困难的老人；六条设计要求最后逐条验证。

讲稿

片子里的问题背后有三个数：12 位老人里有一半从 38 厘米的床上不借助协助站不起来；居家防跌建议床高不超过约 0.58 米，再高坐着时脚就踩不实；约 22% 的社区老人有体位性低血压，站起来可能头晕。所以固定高度的床两头难兼顾。我们的用户是还能自己走或借助助行器走、但从普通床起身困难的老人。右边六条设计要求，最后逐条验证。

- 待补：三个数字（一半、0.58 m、22%）打开原文再核对一次 · 角色 1 · 11/3

可能被问到

这些数据可靠吗？

样本都不大（例如 12 人），我们只把它们当作方向性的证据；来源写在页面上，附录列出原文。

第 5 页：现有方案

2 方案

第 5 页

### 现有方案

部分待补

这一页要让听众记住：现有方案各有所长：借鉴“按住才动、断电用电池降”和受力互锁；不同在于放在床边、床不换，座板跟着大腿走。

讲稿

现有方案里，升降椅和马桶升降座能把人抬起来，我们借鉴了“按住才动、断电用电池降”，但它们要换家具。最便宜的是把床垫高加扶手，下一页定量比较。气弹簧座垫推力不能设上限。研究椅和 Panasonic 专利用座下和扶手受力判断人想起身，我们借鉴了这种受力互锁。我们的不同：放在床边、床不换，座板跟着大腿走。

- 待补：附录：完整的现有技术表和引用格式 · 角色 1 · 11/3

可能被问到

和东京大学那把辅助椅有什么本质区别？

那是一把椅子，要换家具；我们放在床边、床不改。控制上他们用压力中心触发抬升，我们另外加了推力上限和随人调速；那篇文章的作者自己也提到速度应该按人调整。

第 6 页：和其他起身方式比较

2 方案

第 6 页

### 和其他起身方式比较

内容齐

这一页要让听众记住：省力只和抬高床相当（再省约 10%，22/81 人略费力）；真正的差别在腿一软时：人起到一半臀部已在床沿外约 25 cm，座板一路跟在下面（直着落：床 15%，座板全程）。往后倒时床更好 → 后缘软包。

讲稿

这一页是主线。先说实话：只比省力，把床垫高到 0.58 米加好扶手已经不错；起身台比低床省约三分之一，和抬高床只差约 10%，还有 22 人略费力，所以省力上只是相当。真正的差别在腿一软的时候。上面四张图是同一时刻：人起到一半，臀部已在床沿外约 25 厘米，床够不着；竖直座板只往上走，臀部在它前面；只有曲线座板一路跟在下面。髋直着往下落，床只在起身最开始约 15% 接得住，竖直升降 43%，座板全程接得住；膝软往后落，座板 73%。但直挺挺往后倒时床更好，所以座板后缘要软包。

可能被问到

“接得住”是怎么算的？

起身中任一时刻假设腿一软，看臀部落点（髋后 4 cm）还在不在座面上。算了三种边界摔法：① 髋直着往下落；② 膝盖软、小腿不动，髋绕膝往后下落；③ 整个人绕脚踝直挺挺往后倒。真实的摔倒在它们之间。

膝盖一软人是往后坐的，床不就接住了吗？

这就是 ②。床要到快站直时才接得住：低床站直时 75/81，抬高床 45/81；起身中途（大腿还比较平的时候）髋绕膝往后转不了多远，臀部还在床沿外。整个起身过程里，床接得住的阶段中位只有 41%（低床）、32%（抬高床）。坐板在 ② 里 81 人都不会落到前面：73% 的阶段落在座板上，其余落到座板后缘或床上。

落在座板前缘附近，座板还前倾 15°，会不会滑下去？

站直时直着落，落点就在前缘附近（中位在前缘以内约 1 cm），这是坐板最弱的时候，我们不说它一定接得住。静力上摩擦系数大于 tan 16° ≈ 0.29 就不滑，面料按 μ ≥ 0.5 选；人手还握着身前的横杆。真实的冲击和睡衣打滑要样件实测，写在局限页。

往后倒会不会砸在座板后缘上？

会碰到：③ 里中位 72% 的阶段臀部越过座板后缘落到床上，② 快站直时也是。座板和床之间的缝只有 3–7 cm，比臀部窄，人不会掉进去，但会碰到后缘，所以后缘必须软包。

扶手不也能防摔吗？

扶手能抓住、稳住方向，但撑不住整个人：模型里两手合计最多出 1/4 体重。腿一软时需要有东西在臀部下面。

和抬高床只差一点，为什么还要做一台电动设备？

省力上相当或略好，价值在别处：0.58 m 的床对矮个子偏高，1.50 m 的人坐在床沿、脚踩地，大腿要往下倾约 42°，近乎半站着（0.42 m 时约 14°）；起身台平时 0.42 m。另外起身大半程有座板在臀部下面，这是抬高床和扶手做不到的。

为什么有 22 个人反而略费力？

差得很少；而且这是和抬高床“扶手放在对它最有利的位置”比，和同一副 L 形扶手比只有 7 人略差。

人在约 0.57 m 就离开座板，为什么导轨做到 0.69 m？

离座高度因人而异：中位 0.57 m，最高 0.68 m；顶上约 1 cm 是余量。离座以后座板就停在那里接人。

你们之前说腿一软全程接得住 81/81？

那是我们自己查出来的错误：起身路径的求解在大约三分之二处就停了，离座后站直的那一段没算。补全以后，直着往下落时坐板接得住起身的中位 100%（每人至少 86%），52/81 全程；床仍只有前 15% 左右。合格人数 81 → 80，竖直升降 19 → 11。机构没变，只是检查算全了。

81 个模拟用户体重都是多少？

都是 60 kg，关节力量也相同；身高只改各段长度，胖瘦只改臀部厚度。所以“个子高的更费力”主要来自力臂，不能当成真实人群的差别。但方案之间的比较不受影响：effort 是所需力矩除以最大力矩，体重和力量同比例变时它不变，只变体重时所有方案同乘一个系数，同一个人在床上和在起身台上的比值不变。

分区坐垫、推在骨盆附近，对最吃力的那一刻有用吗？

没有直接作用。最吃力的时刻是放手那一下（座板已经不托人），分区坐垫降低的是座板托着那一段的费力和压强。放手那一刻的数字取决于座板能跟到多高。

第 7 页：机构设计①：座板该怎么走

3 机构与结构

第 7 页

### 机构设计①：座板该怎么走

内容齐

这一页要让听众记住：先定路径再选机构：81 个人各自理想的座板路径都是先往前、再往上，竖直升降跟不上（11/81）；一个电机只能走一条路，选跟得上走得最靠前的人的那条，80/81 合格。

讲稿

机构设计分三步。第一步，先定座板该怎么走。我们用 81 位模拟用户——三种身高、胖瘦、起身习惯和脚位——算出每个人起身时座板的理想路径：一直托在臀腿交界，前倾不超过 15 度，再陡往回坐会顺坡滑。所有人都是先往前、再往上，所以竖直升降跟不上，只有 11 人合格。一个电机只能走一条路，我们选跟得上走得最靠前的人的那条，就是橙色这条，81 人里 80 人合格。

可能被问到

为什么选“最靠前”的那条，不选平均的？

座板走得比某人的理想位置靠前，只是托在他大腿更靠前处，人不会滑；走得靠后，臀部就从座板前缘滑出去。所以要跟得上走得最靠前的人。81 人逐个检查，80 人合格，差的那位前滑超了 4 mm。

前倾为什么限 15°？

人往回坐时，座板前倾越大越容易顺坡滑：不滑要求摩擦系数大于 tan 前倾，15° 时约 0.27。我们按高摩擦面料 μ ≥ 0.5 选，留了余量。

81 个人是真实数据吗？

不是。是 3 种身高 × 3 种臀厚 × 3 种起身习惯 × 3 种脚位组合出的模拟用户，起身动作由二维模型算出，要用真实起身动作数据核对。

第 8 页：机构设计②：比了五种机构

3 机构与结构

第 8 页

### 机构设计②：比了五种机构

内容齐

这一页要让听众记住：同一组约束、同样 81 人比了五种机构：竖直跟不上；四连杆放中间碰腿、放两侧挡回床、只放一侧扛不住偏载；斜导轨 + 倾角连杆轨迹最准、驱动力最小，代价是箱子高。

讲稿

第二步，在同一组约束、同样 81 个人下比了五种机构。竖直升降跟不上大腿。四连杆放座板正下方会碰小腿；放两腿外侧挡住回床，还要两个同步推杆；只放床头一侧，偏载扛不住，地面轴承约 25 千牛。斜导轨加倾角连杆轨迹只差 8 毫米，推力最小，床尾敞开；代价是机构箱高。

可能被问到

单侧四连杆箱子小一半，为什么不用？

座板挂在一侧，偏载要靠座板上两个相距 8 cm 的铰点形成力偶，再靠连杆面外弯曲传到地面，地面铰点轴承要承受约 25 kN，是导轨方案每个滑块的约 8 倍；站直时连杆还会碰小腿，70/81 合格。如果以后箱顶高度成了硬约束，它是备选。

带 * 的两种为什么没重算？

它们在“起身路径只算到三分之二”的问题修正之前，就因为碰腿、挡回床被淘汰了；修正只会让合格人数变少，不会改变结论。

箱顶 0.89 m 会不会挡住人？

机构箱在床头一侧，人坐在座板上时它在身体侧面，不在面前；扶手横杆在人正前方。主要影响是占地和外观。

第 9 页：机构设计③：斜导轨 + 倾角连杆，单侧悬臂

3 机构与结构

第 9 页

### 机构设计③：斜导轨 + 倾角连杆，单侧悬臂

内容齐

这一页要让听众记住：在座板上找两个点：轨迹近直线的走导轨，近圆弧的用连杆拉到 B；只搜 4 个数，最多差 8 mm。单侧偏载约 586 N·m 由一对圆锥滚子轴承接住，再交给双导轨（安全系数 3.2 / 2.5）。

讲稿

第三步定尺寸：让座板沿设计曲线走一遍，看座板上每个点的轨迹。接近直线的点装滑块走导轨，接近圆弧的点用连杆拉到圆心 B，只需搜 4 个数。结果导轨和竖直成 34 度、连杆 465 毫米，最多差 8 毫米；三个转动副加一个移动副，一个自由度。座板只挂在一侧怎么扛？最坏情况铰点 1 受约 586 牛米力矩，由一对圆锥滚子轴承接住，再交给两根导轨，安全系数 3.2 和 2.5，座板外缘下沉约 4 毫米。这些是手算，下一步用有限元核对。

可能被问到

导轨是不是只是为了稳？

第一根导轨不是：它就是那个移动副，规定铰点 1 只能走直线，丝杠推的也是它；去掉它座板就多一个自由度、定不住。第二根导轨和多出来的滑块才是只为稳：它们不增加约束，只把座板挂在一侧的扭矩变成一对力。

皮带是干什么的？

只是把电机折到丝杠旁边，省长度，传动比约 1:1。把转动变成直线运动的是滚珠丝杠。

为什么不用两根升降柱竖直升？

髋往前走得早的人，竖直座板跟不上，会往前滑出座面，坐回时还会坐空；81 位模拟用户里竖直升降只有 11 人两项都合格。

一个自由度怎么同时管位置和前倾？

座板上两个铰点：一个装在沿斜导轨走的滑块上，一个用连杆拉到底座。两点一定，位置和前倾就都定了；轨迹和要的曲线最多差 8 mm。

为什么不用四连杆？

试过三种。放座板正下方会碰小腿；两侧各一套会挡住回床转腿。只放床头一侧的四连杆箱子能小一半（箱顶 0.52 m），但偏载要靠相距 8 cm 的地面铰点轴承扛，约 25 kN，连杆还要面外受弯；导轨方案里受力最大的是铰点 1，同样 8 cm 间距约 8.9 kN，约三分之一，而且连杆不受弯。按补全的起身路径，单侧四连杆还有 11 人不合格、站直时连杆碰小腿。所以保留导轨。

双导轨是不是太占地方？

不是主要原因：两根导轨装在同一块侧板上，箱子厚度不变，侧视面积只多 7%。箱子大是因为导轨本身要装下行程，有约 0.58 m 长。滑块间距可从 150 mm 减到 100 mm，箱顶能降 4 cm。

单侧机构，座板是悬臂，扛得住吗？

见本页右下（完整校核在附录“单侧悬臂”页）：偏载在铰点 1 处约 586.0 N·m，由一对相距 45 mm 的圆锥滚子轴承接住（安全系数 3.2），再经滑块板交给 4 个滑块（最重的 5.18 kN，安全系数 2.5）。

左边的三维图是 CAD 吗？

是。用 CadQuery 按手算选定的尺寸建了 40 个零件，干涉检查只剩两处接触；STEP 文件、工程图都在机构网页上。

为什么不用交叉滚子轴承？

能扛住这个力矩的型号（RU85）外径 120 mm，装上后离床垫只剩 0.9 cm；小一号的 RU66 当量静载 20.9 kN，已经接近额定 22.3 kN。一对 32006 X（外径 55）背对背、相距 45 mm，装在 Ø75 的轴承座里，当量静载 13.6 kN，额定 44 kN。

座板外缘下沉 4 mm，人能感觉到吗？

约 4 mm 分布在座板外缘到铰点约 48 cm 的距离上，横向倾斜约 0.5°。其中横梁弯曲约 1.6 mm、轴承对约 0.7 mm（刚度是假设值，取决于预紧），其余来自轴、滑块和机构箱。轴承预紧要样件实测。

这些数靠得住吗？

是手算：三维静力平衡加梁公式，载荷取最坏组合（100 kg × 1.5、偏 10 cm、0.3 倍侧推）。焊缝和开孔附近的应力集中手算算不准，所以列为有限元的第一优先（“下一步”页）。轴承和滑块额定值来自经销商资料，要用厂家样本核对。

第 9 页的示意动画

动画

3 机构与结构

第 10 页

### 运动演示

部分待补

这一页要让听众记住：短片里的四步，CAD 零件按真实运动学驱动；前倾最大约 16°、离座时约 13°；右下二维模型：前半程托臀部、后半程托大腿，人不往前滑。

讲稿

这是短片里的四步，机构按真实运动学驱动：挪上座板、握紧开关、一起起身、松手即停。起身时座板往前、往上并前倾，读数最大约 16 度，离座时约 13 度。右下是二维模型：红色是坐垫接触区，前半程托臀部、后半程托大腿，所以人不往前滑。

- 待补：CAD 运动动画：本页左图已是 CAD 零件按真实运动学驱动的动画；和老师确认是否还要 SolidWorks 运动算例 · 角色 3 · 11/3

可能被问到

动画是按真实尺寸做的吗？

由二维模型直接画出：人体按 1.60 m 的比例，机构按计算出的铰点和导轨。右下角的三个位置是 CAD 模型截图，和动画用的是同一套尺寸。

动画里一开始座板为什么先往上走 3 cm、还前倾到 6°？

人坐着时把坐垫压下约 3 cm；开始抬升后，座板要先把人连同压缩的坐垫一起顶起约 3 cm，坐垫才托住 0.5 倍体重，这时座板已沿曲线走到约 0.44 m、前倾约 6°。之后才是起身本身。以前的动画省掉了“人坐进坐垫”这一步，所以看起来是座板一下跳高、和床不平；现在补上了。

左边的动画是 CAD 吗？

是。机构用 CAD 模型的零件网格，按斜导轨机构的运动学（丝杠行程 → 滑块、连杆、座板位姿）逐帧驱动；人物是扁平小人，姿态来自二维起身模型；前倾读数直接取自同一张行程表。

第 11 页：稳定性

3 机构与结构

第 11 页

### 稳定性

部分待补

这一页要让听众记住：人在台上不会翻；人不在台上时往床头方向推 156 N 就翻（台架按零件估约 85 kg），所以和床固定，固定件按 2211 N 设计。

讲稿

台架会不会翻？人在台上时，手拉扶手是人和台架之间的内力，翻不了，表里最不利的几种情况合力离边缘都有余量。真正的危险是人不在台上，比如夜里走回床边扶了一下横杆：台架只有约 85 公斤，往床头方向推 156 牛就翻。所以台架必须和床固定，固定件按扶手设计载荷的 1.5 倍、约 2200 牛设计，锁在床架或床腿上。

- 待补：用 CAD 的真实质量和质心复核 · 角色 4（等角色 3 的 CAD） · 11/3
- 待补：固定件的具体形式（床腿夹或绕床架的对拉带） · 角色 3、4 · 11/3

可能被问到

重重坐下的冲击呢？

座板按 1.5 倍体重算，冲击可以取 2–3 倍，之后用 FEA 校核。

固定件要多大力？

按扶手设计载荷 1112 N（ADA 609）、安全系数 1.5，固定件约需 2282 N 的拉力，要锁在床架或床腿上；床垫下的压板拉不住，不用。

站起来以后怎么走出去？

身后是座板、床头一侧是机构箱、身前是横杆，所以转向床尾一侧走下底座；助行器放在那一侧，底座边缘做斜坡。

回床怎么回？

按住横杆上的“降”，空座板先停在回床高度（默认 0.50 m）；坐上去，比坐到床面高度省约两成力（参考用户 0.32 对 0.40）；坐稳后再按住“降”，带着人降到床面，往后挪回床上，腿向床尾一侧转上床。空座板只在按住时动。

横杆在身前，回来、出去会不会挡路？

会有一点。出去时往床尾一侧走，横杆正好和行走方向平行，是一根扶手；挡的是往正前方直走。回来要从床尾一侧侧身走进座板和横杆之间约 0.46 m 深的空间，助行器进不去，最后一两步扶着横杆走。横杆末端做成圆头软包、带夜光。备选是可掀起的翻转横杆，写在局限页。

固定件 2.3 kN 是不是太大？床会不会被拉着走？

2.3 kN 是按扶手的结构设计载荷（ADA 1112 N × 1.5）定的强度，真人夜里扶一下大多在几百牛以内。固定后要防的是台架翻，不是整体滑：台架加床约 100 kg，地面摩擦按 0.3 算约 300 N 才滑，底座和床脚加防滑垫。另一个做法是把底座伸一块板压在床腿下面，用床的重量压住，不用夹紧床架；具体形式留给 CAD。

第 12 页：传感与速度

4 控制与安全

第 12 页

### 传感与速度

内容齐

这一页要让听众记住：握把是指令：握紧才升、松手就停。测力管两件事：升多快（人用力越多升越快，往回坐速度变 0；卸掉的力要在踏板上出现才提速）和自检（三处力之和 ≈ 体重）。

讲稿

控制分两条线。指令：握紧横杆上的开关才升，松手就停。测力管两件事：一是升多快——速度等于 k 乘以“推力上限减座板的力”，人自己用力越多升得越快，往回坐速度就变零；座板卸掉的力要在踏板上出现才提速，挂在横杆上就限速。二是自检：三处力之和应约等于体重。16 个仿真场景都落到安全状态，典型用户约 7 秒在 0.57 米离座。

可能被问到

“三处力之和 ≈ 体重”，体重从哪来？

在个人设置里输入（推力上限本来就按体重设）；装机时也可以让人站在踏板上、手离开横杆称一次。不用底座称，因为和床固定以后底座测不准。

握着开关不动，老人怎么知道为什么？

握把上的灯，加一句语音说明原因（比如“请往前坐一点”“脚踩到踏板上”）。夜里低头看不清灯，语音更直接。

为什么不做成全自动（检测到想起身就抬）？

按住式更安全、意图明确；压力中心前移作为第二个确认条件，这是借鉴东京大学那把辅助椅。

座板只测法向力，前倾时折算得准吗？

不完全准：座面上的摩擦力能沿座面 ± 0.5 倍法向力，法向力 × cos φ 会漏掉它的竖直分量，最多约座板力的 (1 − cos φ) + 0.5 sin φ，16° 时约 17%。所以自检的第一档容差随座板力和倾角放宽，而且只减速、语音提示；差超过 35% 才锁定。小腿碰到座板前缘、脚跟蹭到床，也只会触发第一档。

体重设错了会怎样？

推力上限和“卸掉的力要到脚上”都按设置的体重算。设重了，起步慢，推不动就停住（安全但难用）；设轻了，互锁变松。每次离座站稳时，踏板加横杆就是体重，和设置值差得多就提示更新。

人整个挂在横杆上，座板力也会变小，会不会被当成站起来了？

横杆受压超过 0.3 倍体重就只按 30% 速度升。仿真里这个人借横杆离开了座板，座板就停在原处接人。

速度公式会不会算出负数？

限在零到最快速度之间：力超过上限时速度为零，不会倒退。

仿真里改了什么？

用坐板的轨迹和倾角；去掉了“坐着不动就自动降”和两根立柱同步检查；“还坐着”的门槛从 0.15 降到 0.10 倍体重，因为坐板上的人起身中途可以把座板力降到 0.15，原来的门槛会让他坐偏后不能继续升。

刚坐着时座板力大于上限，速度不就是 0 吗？

是的，这是有意的：坐着时座板承担大半体重，人要先前倾、脚往下踩，把座板力降到上限（0.5 倍体重）以下，座板才开始动。参考用户做到这一步的 effort 约 0.16，比放手时（0.25）还低，所以不是难点；也保证了“人不发力，机器不会把人整个抬起来”。

仿真用的是什么用户？

1.60 m 的参考用户，沿坐板的实际轨迹和倾角、固定 L 形扶手。最多发力 0.28 的用户约 7 s 在 0.57 m 离座；0.24 的用户站不起来，座板到顶后停住，按住“降”回床面。

座板力变小，一定是人站起来了吗？

不一定：人往后靠回床垫、或把体重挂到横杆上，座板力也会变小。所以速度取两者的小值：座板卸掉的力，和踏板多承担的力（允许手上分 0.15 倍体重）。仿真里加了“握着开关却往后靠回床垫”：旧规则座板会升 8 cm，现在不动。这条规则之前只写在文字里、代码里没有，第四轮审计查出来后补上了。

第 13 页：状态机

4 控制与安全

第 13 页

### 状态机

内容齐

这一页要让听众记住：三条规则：松手或故障立即停住制动；只有按住“降”才往下动；离座后座板停住接人。“锁定”是传感器自检，不是处理腿软。

讲稿

状态机有三条规则：松手或任何故障，立即停住并制动；往下动必须有人按住“降”，久坐不动只提醒、呼叫家属，不自己降，因为虚弱的人在动着的座板上更容易滑落；人站起来后座板停在原处，坐回去也接得住。回床时空座板先停在 0.50 米，坐上后再按住“降”降到床面。要分清：松手停是人的指令；“锁定”是传感器自检——三处力之和和体重差 15% 到 35% 减速提醒，超过 35% 持续半秒才锁定，和人腿软无关；腿软往回坐靠速度规则，座板停住接人。

可能被问到

老人在半空晕过去了怎么办？

座板停住、制动抱住，接住人；系统提醒并呼叫家属，但不会自己把人降下去，因为一个瘫软的人在动着的座板上更容易滑落。

往回坐的一瞬间，座板力变小，会不会被当成离座？

离座要座板力低于 5% 体重并持续 0.3 秒；速度规则用的是低通滤波后的力，坐回的冲击只会让速度变成零。

断电怎么办？

失电制动器抱住，座板停住；用电池按住“降”慢慢降；控制器也坏了，用带护盖的拨杆。

一直握着“起”，但推不动或到顶了呢？

座板推力到上限还不动 2 s，或到顶 4 s 仍未离座，就转到“停住”：制动抱住，人可以按住“降”回去。仿真里发力不够的用户就是这样回到床面的。

回床时空座板停在 0.50 m，想直接降到床面呢？

松开再按住“降”，空座板就继续降到床面。比如想直接坐床沿、或者白天整理床铺时用。

“降”键坏了怎么办？

开关用双通道触点，一路坏了能检测出来并报警；按键都失效时，久坐不动 17 s 会自动呼叫家属，自己拉横杆拐角下的拨杆慢慢降，或等家属来。

回床怎么回？

按住横杆上的“降”，空座板先停在回床高度（默认 0.50 m）；坐上去，比坐到床面高度省约两成力（参考用户 0.32 对 0.40）；坐稳后再按住“降”，带着人降到床面，往后挪回床上，腿向床尾一侧转上床。空座板只在按住时动。

松手停和“锁定”有什么区别？

松手停是人的指令，立刻生效。锁定是传感器自检：抬升中三处力之和和体重差 15–35% 只减速提醒，超过 35% 并持续半秒才锁定（半秒用来排除读数的瞬时跳动），之后只能按住“降”慢慢下。人腿软往回坐不靠锁定，靠速度规则：座板的力一超过上限，速度就是 0，座板停在原处接住人。

第 15 页的示意动画

动画

4 控制与安全

第 14 页

### 风险和对策

部分待补

这一页要让听众记住：六个风险都有对策：机构全封闭、座板后缘软包、前倾 ≤ 16°、松手即停、只有按住才降、自检、电池和拨杆应急、和床固定。

讲稿

六个主要风险：夹手夹腿——机构封闭在床头一侧的箱子里，座板侧缘到箱壁 3 厘米；从座板滑落——前倾不超过 16 度、高摩擦面料；抬升中头晕——停住接人、不自动降；传感器失效——自检对不上先减速、再锁定；断电卡住——制动抱住，用电池或横杆下的拨杆慢慢降；扶一下拉翻——台架和床固定。

- 待补：附录：完整风险表（严重度、发生可能性、检测方式、对策） · 角色 4、5 · 11/3

可能被问到

为什么只列六条？

主 slides 只放最重要的六条；完整风险表（严重度、可能性、检测方式）放附录。

座板前倾 16°，坐回时会不会滑下来？

全程最大前倾 15.7°。静力学上摩擦系数大于 tan 16° ≈ 0.29 就不滑；考虑坐回冲击和滑的睡衣，面料按 μ ≥ 0.5 选；身前有横杆、脚在踏板上，人也不会直接滑到地上。睡衣和皮肤之间的相对滑动要样件实测。

座板往下降时夹到手或被子怎么办？

座板后缘软包；空座板只在按住“降”时动；下降中电机电流升高、或座板测力突然变化（空座板本该几乎为零），就停。带人往下降时，座板下面是机构箱和底座，脚在踏板上，前面没有能被压到的空间。

锁定以后怎么办？

锁定说明传感器明显不对，只允许按住“降”慢慢回到床面；回到床面后保持锁定，要维护复位，不让带故障继续用。差得不多（15–35%）不锁，只减速和语音提示。

老人会不会从座板侧面摔下去？有跌倒检测吗？

后两页专门讲：侧向摔倒做了一个比较模型；离开踏板时的摔倒，用现有的踏板和横杆测力检测，原理上可行但还要实测。

第 15 页：防跌倒①：侧向摔倒

4 控制与安全

第 15 页

### 防跌倒①：侧向摔倒

部分待补

这一页要让听众记住：侧向最弱的时刻是放开座板、只靠双脚（0.47 m/s），从床上站起来也一样；起身台多出的风险是坐着从敞开侧摔下时落差 0.63 m，和 0.58 m 的床差不多。

讲稿

侧向摔呢？左图是身体被侧推到多快才会倒，越长越稳。坐在起身台上和坐在低床沿差不多；最弱的时刻是放开座板、只靠双脚站，和从床上站起来一样，不是起身台带来的。起身台多出的风险在右图：坐在最高处往敞开侧摔，落差约 0.63 米，和 0.58 米的床差不多。备选对策是可翻下的挡板，或座板测力发现重心侧偏就停，还没定。模型是准静态的，只用来比较方案。

- 待补：决定敞开侧对策：可翻下的挡板，或座板测力发现重心侧偏就停（后者要先仿真） · 角色 2、3、5 · 11/3

可能被问到

“推到多快会倒”是什么意思？

把身体侧向推到这个速度，按“外推重心”判据（重心位置加上速度 × √(重心高度 / g)）就越过脚或坐垫的外缘。它是一个比较用的量：坐在低床沿约 0.91，坐在起身台上最弱约 0.80。“轻推一下约 0.1–0.3 m/s”是粗略估计，没有实测。

为什么横杆往敞开侧加长没用？

加长后两只手对称地握在身体两侧，往敞开侧倒时，手拉住的力臂反而变短（坐着 1.27 → 1.20）；而且横杆悬臂更长，Ø38×4 的管会超应力，要换 Ø42.4×4。

敞开侧加挡板会不会挡住回床？

所以只能做成可翻下的：坐着时立起，回床时放下。缺点和翻转横杆一样，可能忘了立起来，要加“已立起”检测。另一个办法是靠座板下的四个测力单元，发现压力中心往敞开侧偏就停、不抬，不加零件，但还没仿真。

坐着摔下来 0.63 m，有多危险？

比低床（0.41 m）高约 22 cm，和坐在 0.58 m 床沿摔下（0.57 m）差不多；站着侧摔的落差更大。所以起身台没有带来新类型的风险，但让坐着的阶段像坐在高床上。

模型漏了什么？

准静态、只看正面：没有迈步自救、没有肌肉反应，手按“抓得住”的上限算。它只能用来比较方案，不能预测真实摔倒的概率。

第 16 页：需求 → 验证 → 结果

5 验证与总结

第 16 页

### 需求 → 验证 → 结果

部分待补

这一页要让听众记住：第 4 页的六条逐条对上，外加“机构放得下”一行。1a：比低床省 33%，比抬高床再省约 10%；1b：80/81 不前滑、坐回接得住（竖直 11/81），腿一软起身大半程有座板接住。

讲稿

这张表把第 4 页的六条要求和验证一一对上。省力：比低床省 33%，和抬高床相当；座板跟着人走：80/81 人不往前滑、坐回接得住，竖直升降只有 11 人；腿一软直着落，座板全程接得住。推力上限、松手即停、速度跟着人、只有按住才降，都在状态机仿真里验证过。还在做的是：稳定性用真实质量复核，以及强度和悬臂变形的有限元。

- 待补：FEA：座板支架、滑块板和固定件在 1.5 倍体重下的应力和变形 · 角色 4 · 11/3 必须
- 待补：稳定性用真实质量复核后更新这一行 · 角色 4 · 11/3

可能被问到

没有实物，怎么证明设计可行？

这门课要求的是概念、设计和仿真；我们用模型、手算、FEA 和场景仿真逐条验证，实测列入后续工作。

81 个用户是怎么来的？

三种身高 × 三种胖瘦 × 三种起身习惯 × 三种脚位，组合成 81 人；起身习惯是模型里的代表情况，需要真实动作数据核对。

81 个模拟用户体重都是多少？

都是 60 kg，关节力量也相同；身高只改各段长度，胖瘦只改臀部厚度。所以“个子高的更费力”主要来自力臂，不能当成真实人群的差别。但方案之间的比较不受影响：effort 是所需力矩除以最大力矩，体重和力量同比例变时它不变，只变体重时所有方案同乘一个系数，同一个人在床上和在起身台上的比值不变。

第 17 页：局限和后续工作

5 验证与总结

第 17 页

### 局限和后续工作

内容齐

这一页要让听众记住：二维准静态、没有实物；挪上座板和回床往后挪要实测；横杆固定，回来要侧身走进约 0.46 m 的空间；站直时直着摔和往后摔是坐板的弱处（前缘、后缘）。

讲稿

局限：起身模型是二维、准静态的；没有实物和实测，阈值都是假设值；挪上座板、回床往后挪对老人是否可行，还没验证。下一步是动态模型、样机实测和不同床的适配。

第 18 页：结论

5 验证与总结

第 18 页

### 结论

内容齐

这一页要让听众记住：床不用垫高，省力达到抬高床；腿一软时起身大半程有座板接住；一个电机，机构封闭在床头一侧；只有按住才往下动。

讲稿

总结：平时和床一样低，起身时座板跟着大腿托一程。省力和抬高床相当；更重要的是腿一软时，起身大半程都有座板在臀部下面。机构是一个电机带斜导轨和倾角连杆，封闭在床头一侧；控制上松手即停、只有按住才降、速度跟着人走。

第 19 页：分工与贡献

5 验证与总结

第 19 页

### 分工与贡献

部分待补

这一页要让听众记住：五个角色对应装置的五个部分。

讲稿

最后是分工：按装置的部分分，五个角色分别负责问题和整合、起身模型、机构和 CAD、结构和风险、传感和控制，左图标出了各自的位置。谢谢大家。

- 待补：组员姓名和最终分工，明天组内讨论后填 · 全员 · 明天

第 20 页：附录目录

附录 · 本次沟通

第 20 页

### 附录目录

内容齐

这一页要让听众记住：附录不讲，被问到时翻出来；新增坐板设计网页。

讲稿

附录不在汇报中讲，被问到时翻出来。这一页列出我们计划放进附录的内容，以及每一项目前有没有材料。

第 21 页：附录：一次完整的使用

附录 · 本次沟通

第 21 页

### 附录：一次完整的使用

内容齐

这一页要让听众记住：坐到床沿、握住横杆 → 拉着横杆挪上和床齐平的座板 → 握紧开关，座板跟着大腿走 → 站稳，座板停住；机构都在床头一侧，床尾敞开。

讲稿

我们的方案叫床边起身台。它放在床的长边，床本身不改，台架和床固定。用的时候一共五步：先坐到床沿，往前倾一点就能握住身前的横杆；拉着横杆往前挪，坐上一块和床齐平的座板，想坐多久都可以；准备好了握紧“起”开关，座板不是竖直往上顶，而是跟着大腿一起往前、往上走，并且稍微前倾；人自己也在发力，坐垫托住臀部和大腿靠近臀部的那一段；站稳以后，座板停在放手时的位置，万一头晕坐回去，也接得住。机构全部装在床头一侧的一个封闭箱里，床尾一侧是空的，回床时腿可以转过去。

可能被问到

往前挪的时候手扶哪里？

先握横杆再挪。坐在床沿（髋在床沿上方或往里 5 cm），81 位模拟用户往前倾不超过 30° 都够得着横杆；往里 10 cm 时只有 54/81。所以第一步是先坐到床沿，抓住横杆，再拉着它往前挪。

要往前挪多远？为什么不能直接坐在座板上？

座板就紧贴床沿：从床沿内 3 cm 到床沿外 14 cm，和床齐平，后缘软边搭在床垫上。人从床沿往前挪到臀部在座板上，大约 10–20 cm，取决于原来坐得多靠里。是否容易做到要实测，已写进局限。

床垫边缘一坐就陷下去，座板会不会比床垫高一截？

会有这个问题。机构在齐平位以下留了 3 cm 行程，起始高度可以按床垫边缘压陷量设得比床垫面低 0–3 cm。

防滑面料会不会让人挪不上去？

会，这是一对矛盾：挪上去希望滑，起身和坐回希望不滑。目前先用高摩擦面料，挪动难度要样件实测，列入局限。

坐垫要和床面平齐吗？

要：起身前坐垫上表面和床垫面齐平（模型里座板顶面 0.41 m、床垫面 0.42 m），人横着挪过去没有台阶。人坐上去，坐垫被压下约 3 cm（分区坐垫托 0.5 倍体重时），床垫边缘也会被压下去，两边都往下沉，所以人感到的高度差取决于两者软硬是否接近；床垫边缘软得多时，可以用齐平位以下 3 cm 的行程把起始高度设低一点，后缘软唇边搭在床垫上补缝。床垫压陷量没有实测，是待核实的假设。

第 22 页：附录：单侧悬臂怎么扛住

附录 · 本次沟通

第 22 页

### 附录：单侧悬臂怎么扛住

内容齐

这一页要让听众记住：座板只挂在一侧：偏载力矩 586.0 N·m 由铰点 1 的一对圆锥滚子轴承（相距 45 mm）接住，安全系数 3.2；再经滑块板交给 4 个滑块（安全系数 2.5）。

讲稿

评审最容易问的一个问题是：座板只挂在一侧，会不会弯、会不会歪？这一页回答它。左边是从床尾方向看过去的剖面。人坐在座板敞开一侧的边上，体重离支撑点很远，在铰点 1 产生约 586 牛米的力矩。我们在铰点 1 放了一对背对背的圆锥滚子轴承，相距 45 毫米，装在一个直径 75 毫米的轴承座里，轴承座焊在滑块板上。力矩在这对轴承上变成一推一拉，最重的一只当量静载约 13.6 千牛，静安全系数 3.2。之前考虑过交叉滚子轴承，但能扛住这个力矩的型号外径 120 毫米，离床垫只剩 0.9 厘米，所以换成了圆锥滚子轴承对。后面的轴、横梁、滑块都按同一组最坏工况算过，有余量；座板外缘总下沉约 4 毫米。这些都是手算，下一步由建模和有限元的同学用 CAD 模型核对。

可能被问到

为什么不用交叉滚子轴承？

能扛住这个力矩的型号（RU85）外径 120 mm，装上后离床垫只剩 0.9 cm；小一号的 RU66 当量静载 20.9 kN，已经接近额定 22.3 kN。一对 32006 X（外径 55）背对背、相距 45 mm，装在 Ø75 的轴承座里，当量静载 13.6 kN，额定 44 kN。

座板外缘下沉 4 mm，人能感觉到吗？

约 4 mm 分布在座板外缘到铰点约 48 cm 的距离上，横向倾斜约 0.5°。其中横梁弯曲约 1.6 mm、轴承对约 0.7 mm（刚度是假设值，取决于预紧），其余来自轴、滑块和机构箱。轴承预紧要样件实测。

这些数靠得住吗？

是手算：三维静力平衡加梁公式，载荷取最坏组合（100 kg × 1.5、偏 10 cm、0.3 倍侧推）。焊缝和开孔附近的应力集中手算算不准，所以列为有限元的第一优先（“下一步”页）。轴承和滑块额定值来自经销商资料，要用厂家样本核对。

第 23 页：附录：速度随人自适应

附录 · 本次沟通

第 23 页

### 附录：速度随人自适应

部分待补

这一页要让听众记住：人卸掉多少体重，座板就升多快；卸掉的力要在踏板上出现才提速，人往后靠回床垫时座板不升；挂在横杆上就限速。

讲稿

抬升速度怎么定？我们用一条规则：速度等于 k 乘以“推力上限减去座板测到的力”，并且限在零到最快速度之间。人自己卸掉的体重越多，座板升得越快；人往回坐，速度变成零，不会倒退。座板卸掉的力必须同时出现在踏板上才提速，所以人往后靠回床垫时，座板不会升；座板会前倾，控制器按丝杠编码器知道的倾角，把座板的力折算成竖直方向；如果人把体重挂在横杆上，就限速。右边是按坐板实际轨迹重跑的仿真，一共 16 个场景，这里放三个：典型用户大约 7 秒在 0.57 米离座，座板停在那里；抬升中晕倒松手，座板停住接人，17 秒后提醒并呼叫家属，不会自己往下降；断电时制动抱住，按住“降”用电池慢慢降。其余场景放在附录。

- 待补：把全部 16 个场景的图（controller_seat_all.png）放进附录 · 角色 5 · 11/3

可能被问到

人整个挂在横杆上，座板力也会变小，会不会被当成站起来了？

横杆受压超过 0.3 倍体重就只按 30% 速度升。仿真里这个人借横杆离开了座板，座板就停在原处接人。

速度公式会不会算出负数？

限在零到最快速度之间：力超过上限时速度为零，不会倒退。

仿真里改了什么？

用坐板的轨迹和倾角；去掉了“坐着不动就自动降”和两根立柱同步检查；“还坐着”的门槛从 0.15 降到 0.10 倍体重，因为坐板上的人起身中途可以把座板力降到 0.15，原来的门槛会让他坐偏后不能继续升。

刚坐着时座板力大于上限，速度不就是 0 吗？

是的，这是有意的：坐着时座板承担大半体重，人要先前倾、脚往下踩，把座板力降到上限（0.5 倍体重）以下，座板才开始动。参考用户做到这一步的 effort 约 0.16，比放手时（0.25）还低，所以不是难点；也保证了“人不发力，机器不会把人整个抬起来”。

仿真用的是什么用户？

1.60 m 的参考用户，沿坐板的实际轨迹和倾角、固定 L 形扶手。最多发力 0.28 的用户约 7 s 在 0.57 m 离座；0.24 的用户站不起来，座板到顶后停住，按住“降”回床面。

座板力变小，一定是人站起来了吗？

不一定：人往后靠回床垫、或把体重挂到横杆上，座板力也会变小。所以速度取两者的小值：座板卸掉的力，和踏板多承担的力（允许手上分 0.15 倍体重）。仿真里加了“握着开关却往后靠回床垫”：旧规则座板会升 8 cm，现在不动。这条规则之前只写在文字里、代码里没有，第四轮审计查出来后补上了。

第 24 页：附录：离开踏板时摔倒

附录 · 本次沟通

第 24 页

### 附录：离开踏板时摔倒

部分待补

这一页要让听众记住：不加传感器：踏板和横杆测力里有区分摔倒的信息，合成数据上每 100 次正常离开误报 5 次时检出约 98%（最坏 80%）；但数据是我们自己生成的，必须实测；认出来只能报警。

讲稿

第二个防跌倒问题：用完起身台、离开踏板的时候摔倒，我们能不能知道？我们没有加新的传感器，只用设计里已有的踏板四个测力单元和横杆测力。正常迈下去，脚下的力是慢慢转移走的，压力中心停在支撑脚的中间；摔倒时，力卸得更快，压力中心先跑到脚的边上，腿软的话膝盖还会砸到踏板。单看任何一个信号都分不清，几个合起来，在我们生成的数据上，每一百次正常离开误报五次时能认出约 98% 的摔倒；把条件设得很不利，也有约 80%。要强调两点。第一，这些数据是我们自己用模型生成的，结果偏乐观，必须用真人数据验证：志愿者在软垫上做摔倒动作，再录老人的正常离开，检出率到 80%、误报不超过每百次五次才继续。第二，认出来以后只能报警、开灯、呼叫家属，挡不住这一次摔倒。人已经走下踏板以后再摔，这些传感器看不到，不在我们的范围。

- 待补：实测验证离开踏板的摔倒检测：志愿者软垫摔倒动作 + 老人正常离开（≥ 80% 检出、≤ 5 次误报 / 100 才继续） · 角色 5 · 11/3 之后

可能被问到

检测到以后能做什么？

只能报警：开灯、语音问一句、30 秒没回应就呼叫家属。挡不住这一次摔倒，但能缩短倒地后没人知道的时间。

98% 可信吗？

不可信到这个程度。摔倒过程是我们用倒立摆模型生成的，检测器又在同类数据上训练，结果偏乐观。它说明的是“现有传感器里有区分信息”，不是真实检出率。所以下一步是实测：志愿者在软垫上做摔倒动作、录老人的正常离开，检出 ≥ 80%、误报 ≤ 5 次 / 100 才继续。

会不会老误报？

按每晚起来 6 次估算，用简单的三条阈值规则（误报 3.9 次 / 100）大约每周 1.6 次语音询问，按一下握把按钮就取消。

哪种摔法最难认？

脚往侧面一滑（90%）和踩一步想救回来又摔倒（93%），因为它们开头像正常迈步。

人走下踏板后再摔呢？

这些传感器看不到，要用床边毫米波雷达或可穿戴报警器，不在本项目范围。

第 25 页：附录：建模和有限元

附录 · 本次沟通

第 25 页

### 附录：建模和有限元

部分待补

这一页要让听众记住：交给建模和有限元的四个部位：滑块板 + 轴承座焊接件、横梁焊缝、机构箱开槽侧板、扶手立柱。都是手算找出的薄弱处，还不是有限元结果。

讲稿

下一步交给建模和有限元的同学。我们手算找出四个最该先算的部位，注意这些还不是有限元结果。第一，滑块板和轴承座的焊接件：座板的力矩从这里进滑块板，要看轴承座根部的焊缝和中间那个 80 度窗口两侧。第二，座板横梁和节点板之间的焊缝，手算 113 兆帕，看焊缝和外缘下沉。第三，机构箱侧板：中间开了让支架伸出来的竖槽，要看槽两端的应力和整个箱子的扭转。第四，扶手立柱和底座：人整个挂在横杆上时根部弯矩约 1.5 千牛米。每个部位的载荷、边界条件、判据都已经写在机构网页上，零件模型和 STEP 文件也能直接下载。

- 待补：FEA：四个部位的应力和变形（滑块板 + 轴承座焊接件、横梁焊缝、机构箱开槽侧板、扶手立柱；载荷、边界条件、判据在机构网页） · 角色 4 · 11/3 必须

可能被问到

为什么是这四个？

按手算的应力比，以及手算算不准的程度排：焊缝和开孔附近有应力集中，梁公式算不出来；扶手立柱根部弯矩最大（约 1.5 kN·m）。

边界条件怎么给？

机构网页“有限元重点”一节里每个部位都写了：载荷向量（最坏工况）、固定面、要输出的量和判据；零件的 STEP 文件可以直接下载。

第 26 页：附录：零件编号

附录 · 本次沟通

第 26 页

### 附录：零件编号

内容齐

这一页要让听众记住：被问到某个零件时用这一页定位；编号和工程图一一对应。

讲稿

附录：零件编号。S 开头是座板上的零件，J 是铰点，C 是滑块板，L 是倾角连杆，D 是驱动，H 是机构箱，B 是底座。被问到某个零件时用这一页定位。

第 27 页：附录：工程图

附录 · 本次沟通

第 27 页

### 附录：工程图

内容齐

这一页要让听众记住：总装图和四张关键零件图；完整 23 张零件图和 STEP 在机构网页。

讲稿

附录：这是 CAD 模型的总装图和四张关键零件图。完整的 23 张零件图、STEP 文件和三维模型都在机构网页上，可以直接下载。

第 28 页：附录：驱动选型

附录 · 本次沟通

第 28 页

### 附录：驱动选型

部分待补

这一页要让听众记住：滚珠丝杠起身推力 ≤ 664 N，猛坐静载约 2.0 kN；失电制动抱住、离心限速应急下降；偏载 586.0 N·m 经铰点 1 轴承对到双导轨；型号已初选，待样本核对。

讲稿

这是驱动的第一版选型。座板由一根滚珠丝杠推着滑块走。左图是丝杠推力：起身时最多约 664 牛，100 公斤的人猛坐下来、再算上沿座面的力，约 2.0 千牛。右图是座板前倾，全程不超过 16 度。滚珠丝杠效率高，但不能自锁，所以加一个失电常闭制动器：平时和断电时都抱住。断电时先用电池，按住“降”慢慢降；如果控制器也坏了，拉横杆和立柱拐角下面带翻盖的拨杆，坐着就够得到，第一段行程先切断电机电源，再松开制动器，人的重量把座板慢慢压下去，丝杠轴上的离心限速器把速度限在每秒 3 厘米左右，全程大约 11 秒，一松手就停。机构在床头一侧，座板是悬臂，偏载时有约 586 牛米的力矩，它先经过铰点 1 才到滑块板，所以铰点 1 用一对相距 45 毫米的圆锥滚子轴承，再由两根导轨、四个滑块扛住；连杆两端用杆端轴承，只受拉压。型号都已初选，下一步用厂家样本核对。

- 待补：用厂家样本核对已初选的型号：丝杠 R16-10、导轨 HGR15 + 滑块 HGH15CA、轴承 32006 X、8 N·m 制动器、电机约 26 W · 角色 4 · 11/3

可能被问到

滚珠丝杠不自锁，断电怎么办？

失电常闭制动器：断电时抱住。先用电池按住“降”慢慢降；控制器也坏了，拉横杆拐角下带翻盖的拨杆：第一段行程断开电机电源，再松开制动，人的重量把座板压下去。

电机都断电了，靠什么把速度限在 3 cm/s？

丝杠轴上装一个离心限速器：转得比设定快时，里面的摩擦块被甩出去压住外壳，产生和转速相关的阻力，把座板限在约 3 cm/s（丝杠约 180 rpm，全程约 11 s）。前面算的 104 N 阻力只是为了确认最轻的人能让座板开始往下走，限速靠的是限速器。

最轻的人坐着能降下来吗？

最轻的用户沿导轨的下沉推力约 267 N：45 kg、座板上承担 0.75 倍体重、最不利位置的推力系数 0.56，再加座板自重的分量。阻力约 104 N（丝杠、导轨、毛刷，加电机被反拖约 31 N，要按电机样本核对），是 2.6 倍。

偏载会不会把丝杠别弯、卡死？

丝杠装在两根导轨之间，螺母用浮动接头连到滑块板，只传轴向推力；偏载力矩全部由导轨和滑块扛。选型时还要核对滑块的许用力矩。

拨杆为什么放在横杆拐角下面？

控制器坏了才需要拨杆；控制器坏了，“久坐 17 s 自动呼叫家属”也就没了，所以老人必须能自己拉到。放在横杆和立柱拐角下面、带翻盖：坐着沿横杆伸手够得到，又不在握把正下方，抓横杆时不会误拉。够不够得到要用 CAD 和真人核对。

猛坐时丝杠受多大力？

只算沿座面法向的载荷是 1773 N；人垂直落到前倾的座板上、或在座板上蹭动时还有沿座面的力，算进去约 2.0 kN。制动器按它的 2 倍选。

第 29 页：想请老师给个方向

附录 · 本次沟通

第 29 页

### 想请老师给个方向

内容齐

这一页要让听众记住：只问方向和程度，不问细节：差在哪、各块做多深、仿真验证够不够、汇报重点和时长。记下回答，当天发到群里。本次沟通用，正式汇报删去。

讲稿

这一页只在这次和老师沟通时用，正式汇报时删去。我们想请老师给个方向，主要是大概做到什么程度：第一，整体看这个方案离老师的期望还差在哪里，有没有方向就不对的地方；第二，机构、结构、控制、安全这几块，作为课程项目各做到多深合适，哪一块最值得多花时间；第三，我们没有做实物，验证以计算和仿真为主，这样行不行，老师更看重哪类证据；第四，正式汇报时老师最想听到什么，时长和详略怎么安排。

时长按讲稿字数加指图时间估算，实际以彩排计时为准。计算数字来自 GitHub 仓库 model/calc_v12（起身模型、控制仿真）和 model/calc_v13（单自由度坐板）；缩略图按 10/28 的 slides 渲染；动画由二维模型画出，三维图和工程图来自 CAD 模型（cad/model）。
