xiaweiyi0423/me5412-bedexit-proposal/presentation/animations/seat_step2_en.png

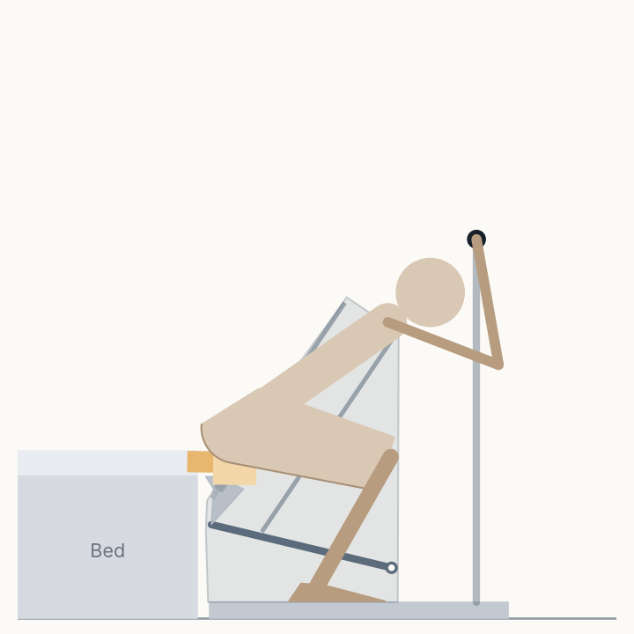
presentation/animations/seat_step2_en.png
