xiaweiyi0423/me5412-bedexit-proposal/presentation/animations/seat_step3.png

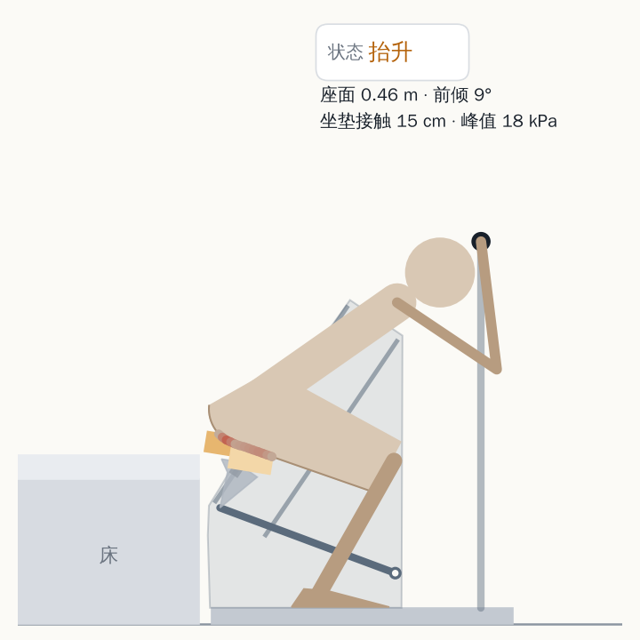
presentation/animations/seat_step3.png
