xiaweiyi0423/me5412-bedexit-proposal/presentation/animations/seat_step4.png

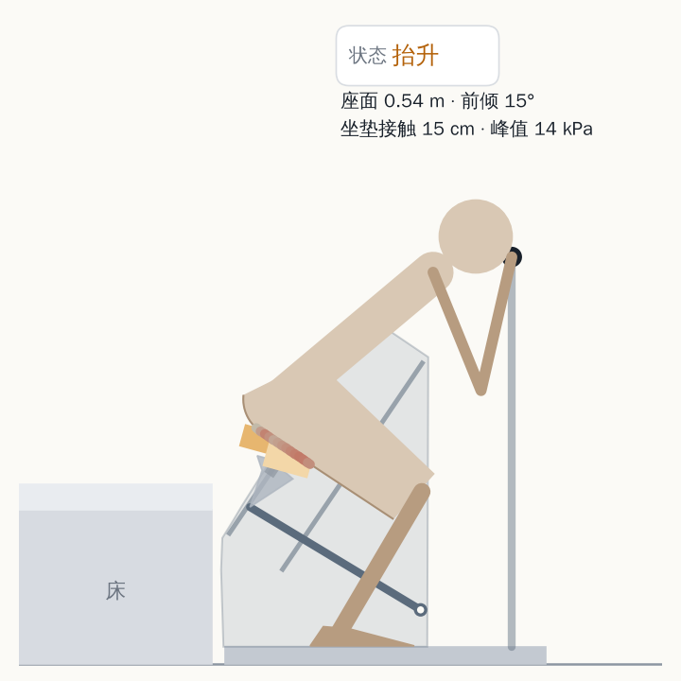
presentation/animations/seat_step4.png
