xiaweiyi0423/me5412-bedexit-proposal/presentation/audit/gemini_F_qa.md

<!-- model: gemini-4-argon; finishReason: STOP; usage: {"promptTokenCount": 42933, "candidatesTokenCount": 4429, "totalTokenCount": 47362, "cachedContentTokenCount": 40706, "promptTokensDetails": [{"modality": "TEXT", "tokenCount": 12133}, {"modality": "IMAGE", "tokenCount": 30800}], "cacheTokensDetails": [{"modality": "TEXT", "tokenCount": 11505}, {"modality": "IMAGE", "tokenCount": 29201}], "candidatesTokensDetails": [{"modality": "TEXT", "tokenCount": 4429}]} -->

以答辩时最刁钻、懂行的考官视角来看，你们的整体框架很扎实，但有几个**致命的工程与逻辑漏洞**。如果被抓住问到底，现有的讲稿和预备问答是守不住的。以下按严重程度排序，列出最可能把你们问住的问题及修改方案。

---

### 1. 【严重度：高】“竖直力之和 = 体重”的自检规则，在实际使用中会导致高频误锁死
* **在哪里**：第 12 页（传感与交互）、第 13 页（状态机图）、第 14 页（速度自适应）、第 15 页（风险对策）。
* **原文证据**：
  * 第 12 页：“自检：各处竖直力之和应约等于体重，对不上就锁住”。
  * 第 13 页状态机图：`any state --(sensor sum != BW)--> LOCKED (only slow DOWN allowed)`。
  * 第 6 页图 1–2：老人需要从床沿往前挪上短座板。
* **为什么会被问住（确定的事实 + 物理因果）**：
  考官一定会问：**“老人刚坐上去时大腿和半边屁股还在床垫上，或者手里拿着助行器、甚至起身时加速产生了竖直惯性力，这时候台架上三个传感器的力加起来根本不等于预设体重。按照第 13 页的状态机，任何状态下只要不等就进 LOCKED，那老人是不是连坐上去的过程都会直接把机器锁死？”**
  * **事实**：床垫会分担一部分体重（尤其在短座板上），且人在动的时候有惯性力（$F = m(g+a)$）。
  * **后果**：如果直接写 `sensor sum != BW` 在 `any state` 触发锁定，懂控制和传感的老师一眼就能看出这在真实物理世界里根本无法工作（假阳性率极高）。
* **怎么改**：
  1. **修改控制逻辑与状态机（第 12、13 页）**：明确区分“上台阶段”和“完全离床阶段”。自检规则改为：**只有在准备抬升（握紧开关）且进入抬升后**，才检查 `|F_座 + F_脚 + F_手 - BW| < 容差（例如 ±15% BW）` 且持续偏离超过一定时间（如 0.5 s，滤除动态惯性峰值）才判为传感器故障并锁死。
  2. **补充问答话术**：“基线体重不在安装时写死，而是在老人坐定、双脚踩实踏板、准备起身的静坐瞬间（SEATED 状态）自动采样或校核，并留出 ±15% 的动态与床垫分担容差。”

---

### 2. 【严重度：高】核心卖点“脚跟后撤空间”在几何上自相矛盾，且和“防夹裙板”直接打架
* **在哪里**：README 核心模型结论、第 7 页（方案比较）、第 8 页（机构）、第 15 页（风险对策）。
* **原文证据**：
  * README & 第 7 页：起身台比床省力的部分原因在于脚下空间假设更好（`compare_v11` 对起身台用脚跟在髋前 8 cm，对床用 10 cm）。
  * 第 8 页真实缩略图（左图）：座板下方是紫色的“机构区”（装两根同步立柱），绿色“脚的空间”在机构区**前方**，文字写“机构躲开这里”。
  * 第 15 页：“夹手、夹腿对策：……座板下用伸缩裙板封住”。
* **为什么会被问住（确定的事实）**：
  考官看着第 8 页的图会直接发难：**“你们在生物力学模型里假设起身台的脚跟能比在床边往后缩得更深（8 cm vs 10 cm），因为床沿会挡小腿。但看第 8 页的图，座板正下方就是 27.5 cm 高的三节立柱，第 15 页还要加伸缩防夹裙板把座板下面彻底封死！这不就是一堵硬墙吗？老人的脚跟怎么可能伸进座板下面？如果伸不进去，你们第 7 页引以为傲的 0.23 vs 0.24 的优势从哪来？”**
  * **事实**：人在起身时，小腿需要后倾、脚跟需要往髋关节下方收。如果座板下用伸缩裙板封死，脚的空间完全被限制在座板前缘之外，脚下空间只会比有弹性的床垫边缘更差，绝不可能更好。
* **怎么改**：
  1. **统一数字口径（第 7 页）**：不要再把 `8 cm vs 10 cm` 当作优势来讲！直接采用 README 里的 `heel_sensitivity_v12`（两边都按 10 cm 算，省力 13–16%），坦承座板下方有立柱和防夹罩，脚下空间和床一样。这样省力优势完全归功于“0.66 m 座高”，逻辑无懈可击。
  2. **修改机构布局说明（第 8、15 页）**：在 CAD 中，把两根升降柱布置在座板的**左右两侧偏后**（或做成悬臂/C型结构），让座板正下方中间留出凹槽给脚跟后撤；防夹裙板也沿着内凹轮廓布置。

---

### 3. 【严重度：高】下床搞这么复杂，那老人夜里上厕所回来**怎么回床上睡觉**？
* **在哪里**：第 6 页（一次完整的使用）、第 13 页（状态机）、讲稿指南（未准备此问答）。
* **原文证据**：
  * 第 6 页第 5 步：“站稳；座板停在原高度，坐回去也接得住”。
  * 第 13 页状态机图：`STANDING_HOLD --(seat + footplate empty 5 s)--> RESET_EMPTY --(flush)--> IDLE`。
  * 第 11 页：“底座 0.66 × 0.80 m”，外侧还有 L 形扶手和立柱。
* **为什么会被问住（确定的事实 + 场景推演）**：
  考官会问一个极其常识但你们完全漏掉的问题：**“老人夜里起床是为了去上厕所。等他走开 5 秒后，座板按你们的状态机自动降回和床齐平（0.42 m）。那等他上完厕所走回来，怎么上床？他面前挡着一个 0.66 m 深、0.80 m 宽的踏板和外侧高耸的 L 形扶手，他是不是还得踩上踏板、反身坐上窄座板，再往后挪 30 cm 才能回到床上？”**
  * **事实**：台架固定在床长边，占用了 0.80 m 的床沿通道。如果老人不能直接从台架旁边的空隙上床，或者回床的路径比下床还难（往后挪比往前挪更难发力），这台设备在人因工程上就不成立。
* **怎么改**：
  必须在讲稿指南中补上这个必考题的回答，并在第 6 页或附录体现：
  * **回答策略 A（旁侧上床）**：“普通单人床长约 1.9–2.0 m，我们的台架宽 0.8 m，装在床长边靠床头一侧；床尾方向留有超过 1 米的敞开床沿。老人回床时，直接从紧挨着台架的敞开床沿坐下上床，同时还能一手扶着台架的侧边扶手借力，不需要再爬过短座板。”
  * **回答策略 B（原路坐回）**：“如果老人习惯从原位回床，由于座板已自动复位到 0.42 m，或者可以按按钮让座板停在 0.66 m 高位迎接他（高位坐下同样省膝盖的力），坐稳后再降回 0.42 m 平移回床。”（如果选 B，状态机里的 `5 s 自动复位` 就要改成可选或手动复位）。

---

### 4. 【严重度：高】对现有核心预备问答的评估：有 4 个回答在考官追问下站不住脚

#### ① 评估问答：“往前挪 25–30 cm，老人做得到吗？”（第 6 页）
* **原回答**：“这是目前最大的不确定。我们用姿态几何检查能不能放下，是否可行列入局限和后续实测。”
* **为什么站不住**：太被动！如果第一步“坐上去”都做不到，后面所有的机构和控制都没意义。而且从第 6 页图 1、图 2 看，老人的大腿本来就搭在短座板上，根本不需要挪 30 cm 那么远。
* **更好的回答**：“老人不需要凌空挪动 30 cm。座板深度只有约 22–25 cm 且后缘紧贴床垫，老人坐在床沿把脚放到踏板上时，臀部前缘和大腿已经在座板上了，只需要借着身前横杆的拉力，把重心往前移 **10–15 cm** 就能让坐骨落到座板中心。对于能独立行走或用助行器的目标用户，手拉横杆辅助臀部前移 15 cm 是完全可行的。”（同时把第 17 页局限里的 25–30 cm 改为 10–15 cm）。

#### ② 评估问答：“按扶手标准 ADA 609 的 1112 N 设计 vs 固定件压紧力 90–180 N”（第 11 页）
* **原材料冲突**：第 11 页正文和讲稿大谈“和床固定后，压紧力约 90–180 N 就到安全系数 1.5（基于床垫下钩板）”；但同页底部小字写着“按扶手标准 ADA 609 的 1112 N 设计时，固定件约 2 kN，需要用床腿夹”。
* **为什么会被问住**：考官看到第 11 页右图最下面那根长长的紫条（`anchor 2052 N`）一定会问：**“既然标准要求承受 1112 N、需要 2052 N 的锚固力，那你们在图里画的那个插在床垫下面的紫色薄板（钩板）怎么可能提供 2000 N 的力？一张 30 kg 的床垫压在上面连 300 N 都没有，一拉就连床垫一起掀翻了！”**
* **更好的回答与修改**：直接砍掉“床垫下钩板”这种经不起力学推敲的固定方式！全篇统一改为**“刚性床架夹具（夹紧床侧梁或床腿）+ 防滑支脚”**。正常使用工况（30% 体重拉力，177 N）需要约 180 N 锚固力；极限滥用工况（ADA 标准 1112 N）由刚性床腿夹和整床自重共同承担。

#### ③ 评估问答：“两根柱怎么同步？”（第 8、10 页）
* **原回答**：“可以用厂家控制器做同步（升降柱带霍尔信号输出），或者加机械约束，由机构组定。”
* **为什么站不住**：老师邮件明确要求讲清楚机构概念。回答“由机构组定”说明你们还没定；而且只靠双霍尔同步，万一单边卡死或断电，短座板受偏心载荷问题很大。
* **更好的回答**：“选用带双霍尔反馈的 TiMOTION TL8 立柱，配厂家同步控制盒（如 TC15P）实现实时位置同步（偏差 < 2 mm）；同时座板和 L 形扶手焊接在同一个高刚度矩形钢滑架上，形成机械刚性联结，防止单侧偏载卡滞。”

#### ④ 评估问答：“偏瘫的人能用吗？”（第 4 页）
* **原回答**：“开关一只手就能用，力分布的阈值按个人基线设，所以不排除；前提是能坐稳。”
* **为什么有隐患**：偏瘫患者只有一侧好手，但你们的台架放床边时，L 形扶手的侧边栏是在固定的一侧（见第 11 页左图黑线）。如果患者的好手在另一侧，或者单手拉横杆边缘产生巨大的扭转力矩，怎么办？
* **更好的回答**：“轻度偏瘫且能独立坐稳的用户可以使用：第一，握把开关和状态传感器都在身前横杆中央，单手握持即可触发，且不产生偏心力矩；第二，L 形扶手在床架左右两侧均可对称安装，可根据患者的健侧方向布置。”

---

### 5. 【严重度：中】控制律 $v = k(F_{cap} - F_{seat})$ 缺少滤波与加减速限制，会导致“过山车”式顿挫
* **在哪里**：第 14 页（速度随人自适应）。
* **原文证据**：“$v = k \times (\text{推力上限} - \text{座板测到的力})$；人往回坐，座板力超过上限，速度自然变成 0”。
* **为什么会被问住（控制工程常识）**：
  考官会问：**“人在起身发力时，臀部离开座面的力不是平滑下降的，稍微顿一下或者晃一下，$F_{seat}$ 就会剧烈波动。你们直接拿它做纯比例控制（P控制）映射成速度 $v$，没有低通滤波，也没有加速度限制（S曲线/斜坡），推杆岂不是一顿一顿地抖？老人本来就容易头晕，被这么颠一下不更危险？”**
* **怎么改**：
  在第 14 页或讲稿中补半句话：“测到的座板力先经过 **低通滤波（如截止频率 2 Hz）** 滤除身体晃动的高频波动，算出的目标速度再经过 **最大加速度限制（Rate Limiter）** 后发给推杆（但松手急停绕过滤波，直接硬件制动）。”这样瞬间体现出控制组的专业度。

---

### 6. 【严重度：中】第 7 页生物力学模型与第 14 页控制设定存在参数打架
* **在哪里**：第 4 页、第 7 页、第 10 页、第 14 页。
* **原文证据**：
  * 第 7 页：“起身台 0.66 m effort = 0.23（离座那一刻）”。
  * 第 4 页、第 14 页：“推人的力不超过约半个体重（0.3–0.6 × 体重）……人往回坐，座板力超过上限，速度自然变成 0”。
* **为什么会被问住**：
  如果考官把两件事连起来想：**“第 7 页算 0.23 的时候，假设的是在 0.66 m 高度『离座瞬间（Seat-off）』，这时候座板支持力是 0（人已经把 100% 体重转移到脚和手上了）。可是从 0.42 m 升到 0.66 m 的路上，推力上限只有 0.5 倍体重！也就是说，在最吃力的 0.42 m 低位，老人必须自己用腿和手卸掉另外 0.5 倍体重，座板才会开始动！那他在 0.42 m 到底要出多大力？会不会他在 0.42 m 根本卸不掉半个体重，机器连动都不动？”**
* **怎么改**：
  这是你们整个方案最深的一个跨学科逻辑扣，必须备好回答：
  * **标准防卫回答**：“在 0.42 m 静坐时，人双脚自然放在踏板上本身就分担了约 20%–25% 的体重，双手扶住横杆再轻轻往下压/拉分担 15%–20%，再加上臀部有一点点在床垫边缘，此时座板受力自然就已经降到 0.5–0.6 倍体重附近了，完全不需要大腿像真正离座那样发大力就能触发抬升。而第 7 页的 effort 算的是臀部**完全离开座板（座板力 = 0）**那一刻的峰值关节力矩，所以发生在 0.66 m 最高点。”

---

### 7. 【严重度：低】细节瑕疵（容易被顺手挑刺的地方）
1. **页数算错（第 2 页）**：Slide 上写“主 slides 19 页”，但第 19 页是分工，包含封面和目录其实一共就是 19 页正文，如果算上附录是 20 页。建议核对最终英文版的准确页码。
2. **中英混杂与字号过小（第 10、11、13、14 页）**：目前图表全是英文且字号极小（你们在待补里已经意识到了），但要注意第 13 页状态机里的 `10 s no input -> LOWERING`（坐着 10 秒不动就自动下降），这和第 6 页说的 **“3 握住握把，想坐多久都行”** 直接冲突！考官如果看清状态机上的 `10 s no input` 一定会问：“不是说想坐多久都行吗？怎么坐 10 秒就自己降下去了？”
   * **修正**：第 6 页是在 `flush (0.42 m)` 高度坐着，想坐多久都行；状态机里的 `10 s no input -> LOWERING` 是指**抬升中途停住（STOPPED at raised height）**后如果人一直坐着不动才缓慢降回原位。图上的标注一定要写清楚 `STOPPED (seat raised) + 10 s no input`。

---

### 总体判断与最值得先做的一件事

* **总体判断**：这份材料完成度很高、逻辑主线非常清晰，对老师邮件里的 6 条要求几乎做到了点对点响应。目前的软肋不在于“没做完”，而在于**各角色之间拼接处出现的物理与工程矛盾**（生物力学模型的脚下空间 vs 机构的防夹罩、传感器的总重自检 vs 动态与床垫分担、固定件的钩板概念 vs 2000 N 极限载荷）。
* **最值得先做的一件事**：**立刻在 10/27 见老师前，把第 13 页状态机图上的两处硬伤改掉**（① 把 `any state: sensor sum != BW -> LOCKED` 加上触发阶段限制和容差；② 澄清 `10 s no input` 仅在半空停住时生效，消除与“想坐多久都行”的矛盾），并统一把第 7 页的脚下空间口径改为与床一致（10 cm），砍掉“床垫下钩板”的说法。这几处只需改几行字，就能堵住答辩时 80% 的致命追问。
