xiaweiyi0423/me5412-bedexit-proposal/presentation/audit/v3/gemini_F_qa.md

<!-- model: gemini-4-argon; finishReason: STOP; usage: {"promptTokenCount": 40412, "candidatesTokenCount": 5879, "totalTokenCount": 46291, "promptTokensDetails": [{"modality": "TEXT", "tokenCount": 17312}, {"modality": "IMAGE", "tokenCount": 23100}], "candidatesTokensDetails": [{"modality": "TEXT", "tokenCount": 5879}]} -->

作为答辩时最刁钻、懂机电控制与生物力学的提问者，我先给你们吃一颗定心丸：第二轮审计指出的致命硬伤（底座称重与床固定冲突、自动下降/自动复位危险、应急拨杆与电机顶牛等）在 v5.5 的页面上改得很干净。

但正因为你们把控制、传感和机械细节写得更具体了，**新的物理矛盾、逻辑死锁和未清理干净的旧版本残留**暴露了出来。以下是答辩时最可能把你们当场问住的 7 个问题，按杀伤力从高到低排列。

---

### 1. 【严重度：高】“三处力之和 ≈ 体重”的自检规则，存在兩個物理漏洞，实际运行必误报锁定

* **在哪里**：第 12 页（传感与交互）、第 13 页（状态机）、第 15 页（风险和对策）。
* **原文证据**：
  * 第 12 页文字与问答：“1 座板下测力……测的是垂直于座面的力，控制器用丝杠编码器知道当时的倾角（最大 15.7°），把它折算成竖直方向……自检：抬升中三处力之和 ≈ 体重……倾角带来的误差只有几个百分点，自检容差是 15%。”
  * 第 15 页讲稿指南问答：“静力学上摩擦系数大于 $\tan 16^\circ \approx 0.29$ 就不滑；考虑坐回冲击和滑的睡衣，面料按 $\mu \ge 0.5$ 选。”
* **刁钻提问（指南未准备）**：
  1. **第一个坑（知道等于多少？）**：“你们为了避免和床固定后测不准，取消了底座称重（第 12 页）。那控制器在对比 $F_{\text{座}} + F_{\text{脚}} + F_{\text{手}} \approx W$ 时，**等号右边的用户体重 $W$ 是从哪来的？** 人刚坐上座板时脚还踩在地上、甚至大腿还搭在床垫上，座板根本测不到完整体重！”
  2. **第二个坑（算错了竖直力）**：“你们在第 12 页问答里信誓旦旦地说，座板单轴传感器测法向力 $N$，折算成竖直力误差只有几个百分点（因为 $\cos 15.7^\circ \approx 0.963$）。但你们在第 15 页又强调座板是不滑的（$\mu \ge 0.5$）。**既然不滑，臀部和座板之间就有沿着座面向后的静摩擦力 $f = N \tan\theta$！** 真实的竖直支撑力是 $F_z = N\cos\theta + f\sin\theta = N/\cos\theta$。如果你只用单轴传感器测 $N$ 并乘以 $\cos\theta$，你算出来的是 $N\cos\theta$，直接漏掉了摩擦力的竖直分量（占座板受力的 $\sin^2 15.7^\circ \approx 7.3\%$），如果人在发力往前蹬，切向力更大，加上动态惯性力，15% 的容差瞬间就会被突破，机器会在半空无故报警锁死！”
* **怎么改**：
  * **补救话术/修改方案**：
    1. 明确**体重 $W$ 的获取方式**：在个人初次设置参数时输入体重（反正第 14 页本来就有按体重设推力上限的个人设置），或者规定在“已坐上、双脚踩上踏板、握住横杆准备起身的最初 0.5 秒静态时刻”采集三处力之和作为当次基准体重 $W_0$。
    2. 修正**第 12 页的倾角折算公式**：坦承座板有静摩擦力。如果不换二维力传感器，在准静态不打滑假设下，控制器应按 $F_{\text{座竖直}} \approx N / \cos\theta$（或直接补偿 $\tan\theta$ 摩擦项）来估算竖直力，而不是 $N \cos\theta$；同时说明为什么容差要设到 15% 甚至 20% 且持续 0.5 秒才触发（为了吸收动态加速度和切向摩擦力的不确定性）。

---

### 2. 【严重度：高】机械应急下降（3 cm/s）的力学账算错了：靠电机反拖限速在物理上不成立，且“最轻的人”前后两个体重标准打架

* **在哪里**：第 10 页（驱动选型）、第 11 页（稳定性）、第 15 页（风险）。
* **原文证据**：
  * 第 10 页文字与讲稿指南问答：“控制器也坏了，拉立柱侧带护盖的拨杆：第一段行程先断开电机电源，再松开制动，人的重量把座板压下去，限速约 3 cm/s……最轻的用户沿导轨的下沉推力约 267 N；阻力约 104 N（丝杠、导轨、毛刷，加电机被反拖的阻力约 31 N，按 0.05 N·m 估）……电机用皮带直连、不加减速器，才拖得动。”
  * 背景材料：“应急下降用滚珠丝杠 + 失电制动 + 离心限速。”
* **刁钻提问（评估指南已有回答：完全站不住脚）**：
  1. **怎么限速到 3 cm/s 的？** “你们在指南里说‘第一段行程先断电机电源，再松开制动’。电机电源都彻底断开了（开路），电机只剩 0.05 N·m 的恒定干摩擦（折算 31 N）。那当 100 kg 的壮汉坐着拉拨杆时，下沉推力高达五六百牛，阻力只有 104 N，**剩下的四五百牛净推力会让滚珠丝杠疯狂加速自由落体！到底是什么装置把速度限制在 3 cm/s 的？** 背景里提了一嘴‘离心限速’，但第 10 页和第 8 页三维图里根本没有离心限速器！如果靠把电机三相线短接产生电磁阻尼（能耗制动）来限速，那在 3 cm/s（对 10 mm 导程丝杠只有 **180 rpm，每秒 3 转**）的极低转速下，不加减速器的直连电机哪来的足够反电动势去憋住 100 kg 的人？”
  2. **267 N 怎么算出来的？** “你们说最轻用户沿导轨下沉推力约 267 N。但在第 10 页左图上，**60 kg 起身（0.5 倍体重，即 30 kg 载荷）时的丝杠推力曲线最低点已经到了约 360 N**！而在第 11 页稳定性表里，最轻用户是 **45 kg**。如果 45 kg 的人全部体重压在座板上，丝杠推力应该在 500 N 以上；如果只有 267 N，你们到底是按几公斤的人算的？”
* **怎么改**：
  * **机械限速原理必须闭环**：如果用**离心摩擦限速器（Centrifugal brake）**，必须在第 10 页正文写出来（例如“松制动后由同轴离心限速器或涡流阻尼器限速”），不能只写“先断电再松制动，限速 3 cm/s”；如果用**电机绕组短接能耗制动（Dynamic braking resistor）**，操作顺序是“拨杆将电机从驱动器切到短接电阻，再松抱闸”，且必须核算 180 rpm 下电机的阻尼常数 $K_t^2/R$ 够不够。
  * **统一最轻用户体重**：核对 267 N 的计算来源（是不是漏乘了虚功比，或者用了 20 多公斤的错误数字），与第 11 页的 45 kg、第 10 页左图的曲线对齐。

---

### 3. 【严重度：高】状态机在“人卡在半空站不起来”和“回床降落”两个环节存在死锁漏洞

* **在哪里**：第 4 页（设计要求）、第 13 页（状态机）、第 14 页（速度随人自适应）、第 16 页（验证）。
* **原文证据**：
  * 第 13 页状态机图（截图）：从 `抬升` 到 `停住` 的唯一箭头写着：“**松手 / 故障 / 断电**”；而 `下降` 状态只连接在 `已坐上` 和 `停住` 之间（`抬升` 没有箭头去 `下降`）。
  * 第 14 页讲稿指南问答：“0.24 的用户站不起来，座板到顶后停住，按住‘降’回床面。”
  * 第 4 页设计要求 6：“**只有确认有人坐着才下降**”；第 13 页状态机图上方长箭头：“回床：按住‘降’，**空座板降到回床高度（默认 0.50 m）停住**，坐上去；再按住‘降’降到床面。”
* **刁钻提问（指南未准备）**：
  1. **到顶怎么切换状态？** “看第 13 页的状态机图。如果遇到第 14 页问答里说的那个腿力太弱（0.24）的用户，他一直死死握着‘起’开关不松手，座板升到最高点（或升到他力竭、座板力等于上限导致 $v=0$）卡住了。此时他既没离座（去不了 `站立保持`），也没松手/故障/断电（去不了 `停住`），他会永远卡在绿色的 `抬升` 状态里！状态机漏掉了 **‘到达行程上限 / 抬升超时 ($v=0$ 持续 $N$ 秒)’ $\rightarrow$ `停住`** 的转换条件。”
  2. **回床时怎么在 0.50 m 停住再继续降？** “第 4 页要求 6 写着‘只有确认有人坐着才下降’，但第 13 页说回床时**空座板**也能按住‘降’往下走——这两句话本身就矛盾。更重要的是：老人在 `空座板停住`（比如 0.57 m）按住‘降’，空座板降到 0.50 m 自动停住。**请看状态机图，这个箭头直接指回了左上角的 `已坐上`！** 此时老人还站在地上没坐上去呢，怎么就变成 `已坐上` 了？而且如果他还没坐上去就松开手再按一次‘降’，空座板岂不是直接降回 0.41 m 床面了？如果规定在 0.50 m 必须检测到坐上（$F_{\text{座}} > 0.10 W$）才允许继续往 0.41 m 降，那万一一个高个子老人上次是在 0.48 m 离座的（低于 0.50 m），他回床按‘降’会发生什么？座板往上升到 0.50 m 吗？”
* **怎么改**：
  * **改第 4 页和第 16 页的文字**：把设计要求 6 的“只有确认有人坐着才下降”改为 **“只有人按住‘降’才下降（无自动下降）；离座后停住接人”**（与第 13 页正文一致）。
  * **改第 13 页状态机图**：
    * 在 `抬升` $\rightarrow$ `停住` 的箭头上加上 **“/ 到顶”**。
    * 把上方回床长箭头的终点改为指到 `停住`（或分两步：空载按住“降”降到 $\min(\text{当前高度}, 0.50\text{ m})$ 保持待坐，检测到坐上后才进入 `已坐上` 允许继续降到齐平）。

---

### 4. 【严重度：中】讲稿和页面里残留了多处旧版本数字，上台一念就会穿帮自相矛盾

* **在哪里**：第 6 页、第 7 页、第 8 页、第 9 页、第 17 页、第 20 页。
* **原文证据**：
  1. **“挪二三十厘米”没删干净**：背景材料明确说“‘往前挪 25–30 cm’是旧数字”。第 17 页（局限）slide 文字已经改成了“挪上座板约 **10–20 cm**”，但**第 17 页的讲稿（slide 备注）**里赫然写着：“**往前挪二三十厘米对老人是否可行，也还没有验证。**”上台照着讲稿一念，当场和屏幕上的 10–20 cm 打架！
  2. **“8 个场景” vs “15 个场景”**：第 14 页、第 16 页都说仿真了 **15 个场景**（待补清单里又写着 `controller_seat_all.png` 是 **14 个场景**），结果到了**第 20 页（附录目录）**，表格第 6 行还写着旧版的 **“8 个仿真场景的逐个说明”**！
  3. **座板起始高度和行程算术对不上**：
     * 第 8 页说座板“上升 **27.4 cm**”，背景说“到顶 **0.69 m**”，那起始高度是 $0.69 - 0.274 = \mathbf{0.416\text{ m}}$（即约 0.42 m 低床）。
     * 但看**第 6 页和第 9 页的动画截图**：状态框为“已坐上（尚未抬升）”时，上面印着 **“座面 0.44 m · 前倾 6°”**！平时和床齐平怎么会是 0.44 m 且自带 6° 前倾？到了第 6 页图 5（站稳保持），印着 **“座面 0.61 m · 前倾 13°”**，可第 7 页讲稿指南和第 14 页仿真都说 1.60 m 参考用户是在 **0.56–0.57 m** 离座停住！动画截图的参数跟第 10 页曲线（0.42 m 时前倾约 1°）和第 14 页仿真完全是两套模型！
  4. **effort 口径的“最佳扶手”残余**：背景和第 7 页讲稿都强调“同一个模型、**同一副 L 扶手**”，但**第 7 页截图的条形图标签**上写着：“低床 0.42 m + **L 扶手**” vs “抬高床 0.58 m + **最佳扶手**”。既然已经统一成同一副 L 扶手了，图上的“最佳扶手”为什么没改？
* **怎么改**：
  * 立刻修改第 17 页讲稿备注（改为 10–20 cm）、第 20 页附录目录（改为 15 个场景）、第 7 页条形图标签（改为 + L 扶手）。
  * 如果第 6、9、15 页的动画截图是因为“算上了坐垫厚度/压缩量”才显示 0.44 m 和 6°，必须在图注或讲稿指南里准备一句解释（例如：“图中 0.44 m 是加了未压缩坐垫前缘的表面高度，0.61 m 是较弱用户的离座位置”），否则评委一盯数字就会质疑你们造假。

---

### 5. 【严重度：中】“防跌 81/81 vs 抬高床 0/81”的核心卖点，建立在一个极不公平的假设上，极易被生物力学老师反杀

* **在哪里**：第 7 页（四种起身方式比较）。
* **原文证据**：
  * 第 7 页底部小字注：“②：起身中任一时刻髋部直着往下落，臀部落点（髋后 4 cm）在座面前缘以内算接住；**床按坐在床沿（髋在床沿上方）算**。”
  * 第 7 页讲稿指南问答：“床：人一站起来，臀部就在床沿外约 25 cm；坐板：离座后停在身后，落点还在前缘以内 7.5 cm。”
* **刁钻提问（评估指南已有回答：会被追问驳倒）**：
  * “你们把‘腿一软全程接得住（81/81 vs 床 0/81）’当成取代抬高床的最大理由。但请看你们底部的小字假设：**你们假设从床上起身的人，一开始是把髋关节正好卡在床沿最外缘（$x=0$）坐着的！** 正常人坐在床上，整个臀部和大腿后侧都在床垫里面（髋关节在床沿以内至少 10–15 cm）；而且人在床上发现腿软要往回坐时，只要膝盖一弯、屈髋往后坐，臀部自然会往后退 15–20 cm 坐回床垫上，谁会像木头桩子一样髋关节直上直下往地板上砸？反过来，在你们的起身台上，座板已经往前伸出了 18.5 cm，人如果往后退着坐，60% 的情况会直接越过座板后缘砸向后面的机构箱或床沿！你们是不是为了凑出 100% vs 15% 的漂亮数字，故意给床设了一个最蠢的坐姿和直上直下的假摔法？”
* **怎么改**：
  * **调整第 7 页的话术姿态，切忌把话说绝**：在讲稿指南里补充防御话术——承认“直着往下落（屈膝坍塌）”是偏保守的几何指标。之所以假设髋在床沿附近，是因为 0.42 m 低床如果坐得很靠里，小腿会被床沿挡住无法后撤（脚下无空间），老人为了站起来必须先挪到最床沿。同时主动指明第 7 页右下角已经算了第二种摔法（往后坐回/倒回）：那种情况下床 100% 接得住，而起身台因为座板紧贴床沿、且机构箱全在床头一侧（人正后方是空的床面，没有机构箱！这一点一定要在答辩时强调清楚），越过软包后缘也是落回安全的床垫上。

---

### 6. 【严重度：中】与床固定的 2282 N 拉力，工程实现上对家用床根本行不通

* **在哪里**：第 11 页（稳定性）。
* **原文证据**：
  * 第 11 页文字：“和床固定后，固定件需要的拉力（扶手设计载荷 1112 N × 1.5） **2282 N**……待补：固定件锁在床架或床腿上（床垫下的压板拉不住 2.3 kN，不用）。”
* **刁钻提问（指南准备不足）**：
  * “你们算出来固定件要承受 **2282 N（约 230 公斤）** 的水平拉力！请问普通家里的木质床框侧板、或者四个床腿，怎么让你在不改造床（第 6 页承诺‘床不改造’）的前提下，夹出一个能抗 230 公斤水平拉力的固定点？普通的家用单人床连床垫一共也就五六十公斤重，地面摩擦系数按 0.3 算，**只要水平拉力超过 180 N，整张床就会被你连着起身台一起拉得在地板上滑走，甚至把床侧板拉裂！** 既然 107 N 就会让台架翻，为什么不直接把台架底座往床底下伸进去一块 50 cm 长的扁平钢板（利用床腿或者自己踩上去配重），非要用 2.3 kN 的拉力去拽床架？”
* **怎么改**：
  * **工程逻辑纠偏**：你们算出 2282 N，是因为把 ADA 标准的极限静态扶手载荷 $1112\text{ N} \times 1.5 = 1668\text{ N}$ 全算成了人在台外水平猛拽横杆的力，再通过杠杆放大到了底座高度！
  * **更好的回答**：
    1. 区分“防倾翻”与“结构极限强度”：人在地上扶横杆借力，水平力通常在 200–300 N 以内；1668 N 是近 170 公斤的水平拉力，人站在光滑地板上自己早就滑倒了，根本拉不出这么大力。
    2. **最佳固定方案（11/3 必补）**：不要用悬空夹子去掰木床框。改成**“伸入床底的 L 形底板 + 绕过对侧床腿（或床架横梁）的拉紧织带（Ratchet strap）”**，或者底板直接压在近侧床腿下方！这样台架向外倾翻时，是试图把整张床往上掀（重力抗倾翻），而不是水平拉拽床框。

---

### 7. 【严重度：低】单侧悬臂座板受 150 kg 冲击时，远离机构箱的一侧会大幅下陷（倾斜感）

* **在哪里**：第 8 页（机构）、第 10 页（驱动选型）、第 16 页（验证）。
* **原文证据**：
  * 第 8 页文字：“所有机构都装在床头一侧……座板由悬臂托架伸出……床尾一侧敞开。”
  * 第 10 页文字：“双导轨、每轨两个滑块：偏载悬臂 659 N·m，每个滑块约 3.1 kN。”
* **刁钻提问（指南只答了滑块受力，没答刚度变形）**：
  * “你们为了回床转腿方便，把座板做成了长达四五十厘米的单侧悬臂梁。你们只算了滑块能承受 3.1 kN 不坏，但老人一屁股坐到床尾敞开那一侧时，悬臂托架、滑块板和导轨的弹性变形加起来，**座板外侧边缘会往下陷多少毫米？** 如果坐上去外侧咔嚓下沉 1–2 厘米（左右歪斜 2–3 度），老人夜里会觉得座板要塌了，而且你们的座板下测力单元受这么大的偏心弯矩，读数还会准吗？”
* **怎么改**：
  * **直接交给角色 4 的 FEA 待补项**：在做第 16 页的 FEA 时，除了看应力（Stress），**必须放一张最大位移（Displacement / Deflection）云图**，设定设计目标为“150 kg 偏载下座板外端竖直变形 $< 3\text{ mm}$（倾角 $< 0.5^\circ$）”。
  * **测力单元布置**：说明座板下装的是 **4 个角分布的贴片式/柱式测力单元**（夹在刚性悬臂托架上表面与座板底板之间），悬臂弯矩由下方的钢制托架承受，上面的 4 个传感器只受座板传下来的法向压力，且正好用这 4 个点的读数差来算第 12 页说的“压力中心（CoP）”。这样既答了结构刚度，又圆了第 12 页的压力中心怎么测出来的！

---

### 总体判断与最值得先做的一件事

**总体判断**：
这份 v5.5 材料已经非常扎实，逻辑主线（低床踩实 + 曲线跟腿防跌 + 按住才动 + 力控调速）完全命中了老师邮件里的全部 6 条要求，在同类课程设计中属于高分档。目前唯一的风险不在于大方向，而在于你们写了太多具体的数字和公式，导致内行评委很容易顺着“三处力之和自检”、“3 cm/s 断电限速”和“状态机箭头”抓到物理和逻辑漏洞。

**最值得先做的一件事（今天内花 30 分钟就能搞定）**：
**先把不需要做 CAD 就能改掉的“文字与逻辑乌龙”清理干净**：
1. 修正**第 13 页状态机图**（补上 `抬升` 到顶去 `停住` 的条件，理顺回床 0.50 m 的箭头）并统一第 4 页要求 6 的表述；
2. 修正**第 12 页自检的讲稿解释**（明确基准体重 $W$ 怎么来、考虑座板静摩擦力的折算）；
3. 清理**第 17 页讲稿**的“二三十厘米”、**第 20 页**的“8 个场景”和**第 7 页图上**的“最佳扶手”。然后再让角色 3 和 4 集中火力把 SolidWorks 动画、离心限速/电机阻尼核算和 FEA 位移图补齐。
