xiaweiyi0423/me5412-bedexit-proposal/presentation/audit/v2/gemini_F_qa.md

<!-- model: gemini-4-argon; finishReason: STOP; usage: {"promptTokenCount": 37465, "candidatesTokenCount": 4919, "totalTokenCount": 42384, "promptTokensDetails": [{"modality": "TEXT", "tokenCount": 14365}, {"modality": "IMAGE", "tokenCount": 23100}], "candidatesTokensDetails": [{"modality": "TEXT", "tokenCount": 4919}]} -->

作为答辩时最挑剔、最懂行的评委，我看完这份材料后的第一反应是：**你们非常诚实，但这份诚实把项目的核心物理矛盾直接暴露在了明面上。** 你们花大力气改成了“单侧斜导轨曲线坐板”，但随之带来的力学、控制和人机交互上的新漏洞，讲稿指南里几乎没有真正防住。

以下是我最可能把你们当场问住的 7 个问题，按杀伤力从高到低排列：

---

### 1. 【严重度：高】传感器交叉耦合与“底座测重自检”的逻辑死锁
* **在哪里**：第 11 页（稳定性）、第 12 页（传感与交互）、第 13 页（状态机）、第 14 页（速度自适应）。
* **原文证据**：
  * 第 12 页文字与问答：“座板下测力：只测垂直于座面的力……推了多少力（速度规则）”；“底座四角测力：对地总力减去台架自重就是体重……对不上就锁住”。
  * 第 11 页文字：“台架必须和床固定，固定件需要的拉力 2282 N”。
  * 第 13 页状态机图：触发 `LOCKED` 的条件是 `sensor sum != BW`（传感器总和 $\neq$ 体重）。
* **为什么会被问住（确定的力学事实）**：
  我会直接问你们两个问题：
  **第一，台架都和床死死固定了（能抗 2282 N 拉力），底座四角怎么可能测出人的真实体重？** 只要固定件（无论是夹床腿还是压床垫下）有刚度，它就会构成静不定结构，分担很大一部分竖直力（载荷分流）。老人一坐上去或者一拉扶手，力顺着固定件传给了床，底座四角测到的力立刻“和体重对不上”，按第 13 页的状态机，机器当场进入 `LOCKED`（锁死）状态！
  **第二，第 14 页的速度公式 $v = k \times (\text{推力上限} - F_{\text{座板}})$ 里，座板倾角变化和手拉扶手是怎么解耦的？** 当座板前倾 15.7° 时，人如果不滑下去，必然有沿座面向上的摩擦力和手拉横杆的力。座板下的单向传感器只测法向力 $F_n$。随着倾角 $\theta$ 变大，哪怕人根本没发力站起来，重力在法向的分量 $mg\cos\theta$ 也会自动变小，控制器会误以为“人自己卸掉了体重”而加速抬升！反过来，如果老人死死往下压扶手，座板法向力也会减小，机器也会猛升。
* **怎么改**：
  * **放弃“底座四角测体重自检”**：在固定台架上做对地总重闭环在工程上是走不通的。改为：用**座板 + 踏板 + 扶手**三处的传感器做粗略的“在位逻辑互锁”（例如：坐下时座板有力；抬升时座板力减小必须伴随踏板力或扶手力增大），而不是精确的体重加和等于常数。
  * **修正速度公式的表述**：在答辩预案和第 14 页备注里补一句：“座板测到的法向力会按当前编码器算出的座板倾角 $\theta$ 折算回竖直支撑力，再结合踏板受力增加来确认是腿在发力，而不是单纯因为座板倾斜或身体前滑导致的座板卸载。”

---

### 2. 【严重度：高】悬臂单侧滑轨的“卡死（Binding）”与滚珠丝杠受弯矩
* **在哪里**：第 8 页（机构）、第 10 页（驱动选型）。
* **原文证据**：
  * 第 8 页讲稿指南问答：“偏载时悬臂力矩约 659 N·m。用两根导轨（相距 150 mm）、每根两个滑块（相距 150 mm）……每个滑块约 3.1 kN，15 或 20 号导轨能承受。”
  * 第 10 页文字：“丝杠：起身时 ≤ 664 N，猛坐静载 ≤ 1773 N”。
* **为什么会被问住（确定的机械设计事实 + 预备问答评估）**：
  你们准备的回答**站不住脚**。你们只算了滑块的径向静载荷（$659 \text{ N}\cdot\text{m} / 0.15 \text{ m} \approx 4.4 \text{ kN}$，分摊到滑块约 3.1 kN），但完全漏掉了两个致命的机械问题：
  1. **滚珠丝杠不能承受弯矩和侧向力**。在单侧悬臂结构里，座板支架变形会导致滑块连接板倾斜。如果滚珠丝杠螺母和滑块板是刚性连接的，这 659 N·m 的巨大翻转力矩会直接掰弯丝杠，或者把丝杠螺母卡死！
  2. **倾角连杆的面外偏置力矩**。第 8 页说座板另一个铰点用一根连杆拉到底座。人在悬臂端坐下时，重力不仅由滑块承受，还会拉压这根倾角连杆（从第 10 页算出丝杠力 1773 N 可知连杆受力也在千牛级）。这个千牛级的连杆力也是单侧偏置的，它跟滑块力不在同一个平面内，会产生巨大的扭转力矩。
* **怎么改**：
  * **补充机械细节（防追问）**：在角色 3 和 4 的问答及 CAD 里明确指出：① 丝杠安装在两根导轨的正中间平面，且丝杠螺母通过**浮动接头（floating joint）或万向节**只传递轴向推力，绝不承受倾覆力矩；② 必须校核 20 号导轨滑块的**容许倾覆力矩（$M_r, M_p, M_y$）**，而不仅是额定动/静载荷 $C, C_0$。

---

### 3. 【严重度：高】核心价值崩塌：导轨上段废掉、甚至比免费方案更费力
* **在哪里**：第 4 页（设计要求）、第 7 页（方案比较）。
* **原文证据**：
  * 第 4 页：“设计要求 1：起身时座板跟着大腿升到约 0.69 m”。
  * 第 7 页：“比抬高床（0.58 m）只省 5–10%；72 人里 19 人反而略费力。原因：多数人在座板前倾最大（约 15°）时就离开坐垫，那时髋只比坐在 0.58 m 床上高约 4 cm；导轨上段没用来托人。”
* **为什么会被问住（评估讲稿指南的现有回答）**：
  讲稿指南里的预备回答是：“省力上优势不大，要说实话。它的价值在别处：9 位矮个用户脚踩不实、不往前滑、坐回接得住……是否值得，这一点我们没有数据。”
  **这个回答在答辩场上等于主动弃械投降！** 评委会立刻追问：
  1. “既然 1.60 m 和 1.75 m 的人（72 人）把床垫高到 0.58 m 就能解决，为什么不直接给那 9 个 1.50 m 的矮个子老人把床垫到 **0.48 m 或 0.50 m**（既能踩实地面，又能省一大部分力），反而要造一台几千块钱、重 45 kg、还要往外挪 30 cm 的电动机器？”
  2. “既然人在座板升到约 0.56 m（倾角 15.7°）就离开坐垫了，那你们为什么还要把行程做到 0.69 m、让机构箱高达 0.80 m？上半段行程除了挡人视线和增加成本，有什么用？”
  3. “为什么 19/72 的人用你们的机器**反而比普通高床更费力**？”（讲稿里完全没解释为什么会倒退！）
* **怎么改（给出站得住的硬核回答）**：
  * **重新定义 0.56 m 到 0.69 m 上半段行程的作用**：绝对不能说“导轨上段没用来托人”！要改口说：“0.56 m 是模型里**准静态最吃力瞬间（seat-off）**的高度；但真实起身是一个连续过程，0.56 m 之后座板回平并继续升到 0.69 m，一是为高个子用户（1.75 m）提供更高支撑，二是作为**站立后的近身防跌护垫（Catching platform）**——老人站起后一旦体位性低血压头晕，屁股只需往下落几厘米就能坐回水平、高达 0.69 m 的座板上，而不是跌落到 0.58 m 的床上。”
  * **解释为什么 19 人略费力**：明确查出这 19 人是谁（大概率是身高较高或特定脚位的用户，因为固定 L 形扶手横杆在 x=70 cm 对他们来说位置不如“最佳扶手”顺手，或者座板前移 18.5 cm 挤压了他们膝盖前倾的空间）。在附录里把这个原因写清楚。

---

### 4. 【严重度：中高】人机工程死穴：床边 0.80 m 高墙 + 悬空横移 30 cm + 回床怎么上床？
* **在哪里**：背景说明、第 6 页（一次完整使用）、第 16 页（验证表）、第 17 页（局限）。
* **原文证据**：
  * 背景与第 8 页：“机构箱顶高 0.80 m”；第 16 页：“机构箱离床 2.1 cm”。
  * 第 6 页问答：“问：往前挪 25–30 cm，老人做得到吗？答：这是目前最大的不确定……列入局限和后续实测。”
  * 第 6 页文字：“床尾一侧敞开，回床时腿能转过去。”
* **为什么会被问住（讲稿指南未准备的追问）**：
  把“挪动 25–30 cm 是否可行”推给后续实测太敷衍了。评委看一眼第 6 页和第 8 页的图就会发现三个物理障碍：
  1. **出床障碍**：床高 0.42 m，床头一侧紧贴着床（仅隔 2.1 cm）立着一个 **0.80 m 高的封闭大铁箱**（比床面高出近 40 cm！），人正前方 x=70 cm 是一根立柱。老人半夜迷迷糊糊醒来，必须精准地在铁箱和床尾之间找到座板，然后依靠手臂和屁股在没有侧扶手借力的情况下（横杆远在身前 70 cm 处），**跨过床垫软边和座板的缝隙往前蹭 30 cm**。腿力已经弱到站不起来的老人，核心肌群和手臂怎么完成这个动作？
  2. **踏板绊脚**：底座厚、带踏板测力，老人从床上挪到座板时，脚要跨上踏板；站起来走开时，脚要迈下踏板。这本身就是一个台阶（绊倒源）。
  3. **回床死循环（完全没讲！）**：第 6 页只讲了怎么起床，**那老人上完厕所回来怎么回床上睡觉？** 他坐上齐平的座板（离床沿外侧 30 cm），然后呢？机器又不会往后退！难道让他倒着往后蹭 30 cm 回床？而且你们说“床尾一侧敞开，腿能转过去”，但人坐在床外 30 cm 的座板上，就算腿往床尾转过去，上半身和屁股还在床外面的机器上，怎么躺回床中间？
* **怎么改**：
  * 必须准备好**“回床流程”的回答**：老人在夜里上完厕所回来，是**直接坐在床尾一侧的空床沿上**回床，还是坐上座板？如果直接坐床沿，那起身台占掉了床长边的多少宽度？剩下的床沿够不够坐？必须在第 6 页或附录里画一张**俯视图（Top View）**，标出床长（2.0 m）、机构箱厚度、座板宽度（如 45 cm）、剩余可上下床的床沿长度！

---

### 5. 【严重度：中】控制逻辑漏洞：头晕坐回时的“瞬间失重”与 10 秒自动下降陷阱
* **在哪里**：第 13 页（状态机）、第 14 页（速度随人自适应）。
* **原文证据**：
  * 第 13 页状态机图：在 `LIFTING` 状态下，只要 `seat load < 5% BW, 0.3 s` 就跳入 `STANDING_HOLD`；在 `STOPPED` 状态下，如果 `occupied and (DOWN or 10 s no input)` 就自动进入 `LOWERING`（下降）。
  * 第 14 页文字：“人往回坐，座板力超过上限，速度自然变成 0”。
* **为什么会被问住（讲稿指南未准备的追问）**：
  1. **坐回导致误触发离座**：如果老人在抬升途中（还没完全离开座板）突然腿软或头晕往回坐，由于身体向下加速（失重效应），在屁股砸向座板之前的 0.3 秒内，座板测到的力可能瞬間减小甚至小于 5% 体重；或者在冲击反弹瞬间小于 5%。而且第 14 页的公式 $v = k(F_{\text{cap}} - F_{\text{seat}})$ 是纯比例控制，没有阻尼项——人猛坐回来产生冲击力 $F_{\text{seat}} > F_{\text{cap}}$ 时，公式算出的 $v$ 是**负数**！你们写的是“速度变成 0”（即 $\max(0, \dots)$），但如果传感器噪声或动态冲击导致力波动，座板岂不是一顿一顿地抖动？
  2. **10 秒无操作自动下降非常危险**：状态机图里写着，在 `STOPPED` 状态下，只要有人坐着且 **10 秒没操作（`10 s no input`），机器就会自动带着人往下降（`LOWERING`）**！老人抬升到一半累了，松开手想喘口气歇 15 秒再继续升，结果刚歇到第 10 秒，座板突然自己往下掉！这完全违背了你们第 5 页借鉴的“按住才动（Hold-to-run）”安全原则。
* **怎么改**：
  * **删掉状态机里“10 s no input 自动带人下降”的条件**！带人下降必须且只能由用户主动按“降”按钮触发（或者护理人员操作）。
  * 在第 14 页公式上明确加上饱和限制：$v = \text{clip}(k(F_{\text{cap}} - F_{\text{seat}}), 0, v_{\text{max}})$，并说明对 $F_{\text{seat}}$ 做了低通滤波，且采用**单向锁死（棘轮逻辑）**：在一次握紧“起”的过程中，哪怕力瞬间变大導致速度归零，只要没松手、没按降，绝不允许反向或反复启停振荡。

---

### 6. 【严重度：中】机械应急下降（拉索拨杆 + 离心限速）的工程合理性
* **在哪里**：第 10 页（驱动选型）、第 15 页（安全风险）。
* **原文证据**：
  * 第 10 页：“应急下降：拉握把旁的拨杆，制动松开，离心限速约 10 cm/s，松手即停”。
  * 第 10 页问答：“问：最轻的人坐着能降下来吗？答：算过：最轻的用户沿导轨的下沉推力约 267 N，丝杠、导轨和毛刷的阻力约 73 N，是 3.7 倍。”
* **为什么会被问住（评估讲稿指南的现有回答）**：
  这个计算看起来很细致，但懂机电设计的评委会马上抓出两个漏洞：
  1. **反驱电机（Back-driving）的齿槽转矩和减速比没算**：73 N 只算了丝杠、导轨和毛刷的摩擦。但是滚珠丝杠上还连着**电机（甚至减速机）**！如果电机带行星减速机，反驱阻力极大，267 N 根本压不动；如果电机直连丝杠（比如导程 5 mm 或 10 mm，推 1773 N 静载需要电机扭矩 1.5–3 N·m，直连电机体积巨大），断电时人压座板反驱电机旋转，永磁同步/步进电机的**齿槽转矩（Cogging torque）**和绕组短路制动力矩算进去了吗？
  2. **10 cm/s 的下降速度太快了**：你们正常抬升最快才 1.5–4 cm/s（第 14 页），结果应急故障下降时，老人本来就惊慌或者头晕，一拉拨杆，座板以 **10 cm/s（正常速度的 3–6 倍！）** 往下掉，3 秒钟就到底，老人会感觉像坐跳楼机一样失控！而且既然已经有“电池慢降”（背景和第 13 页提到），为什么要搞这么复杂的一套纯机械拉索解抱闸 + 离心限速器？
* **怎么改**：
  * 把应急下降主推方案改为**“备用电池受控慢降（2 cm/s）”**；机械拨杆改成护理人员在机器侧面操作的纯维修/救援泄放阀，或者把离心限速/阻尼器的目标速度改口为 **2–3 cm/s**（可通过电机绕组接卸荷电阻实现电磁阻尼限速，比机械离心限速器便宜、安静且低速性能好得多！离心限速器在低速下根本张不开摩擦块，必须转很快才有阻尼）。

---

### 7. 【严重度：低】前后数据打架，容易被质疑严谨性
* **在哪里**：第 8 页、第 14 页、第 15 页。
* **原文证据**：
  * 座板最大倾角：第 8、10、15 页正文写“≤ 16°（15.7°）”，但第 15 页讲稿指南和问答里全写着“≤ 15°”、“tan 15°”。
  * 第 14 页右图（8 个仿真场景）：图里第 4 个子图标题写着 `Weak user (cannot stand even at 0.66 m)`，纵轴高度最高也只到 `0.61–0.66 m`。这明显是**旧版竖直升降（0.66 m）留下来的旧图**，根本没按新版曲线坐板（0.69 m）更新！
* **怎么改**：
  * 统一倾角数字为 16°（或 15.7°）。
  * 第 14 页的仿真图既然“待补重画大字号”，重画时务必把 `0.66 m` 改成新版参数，否则评委一眼看出你们控制仿真跟机械设计用的是两套不相干的参数。

---

### 总体判断与最值得先做的一件事

**总体判断**：
你们的汇报结构非常清晰，工作量充实，主动推翻旧版“竖直升降”并诚实汇报“比抬高床只省 5–10%”展现了极好的学术诚意。但目前最大的风险在于：**你们为了解决“前滑”而引入的“单侧悬臂斜导轨 + 固定床架”方案，在结构力学（悬臂卡死）、传感逻辑（固定后无法测总重）和日常使用动线（0.8 m 铁箱挡路与回床难题）上制造了新的硬伤**，而且第 7 页过于消极的定性会让评委怀疑整个立项的价值。

**最值得先做的一件事（今天之内完成）**：
**立刻修改第 12–14 页的传感器与状态机逻辑（问题 1 和 5），并重写第 7 页的问答话术（问题 3）。** 这不需要重做复杂的 CAD，只需改几行文字和状态机图：删掉“底座四角测总重自检”和“10 秒自动下降”，补上“座板倾角补偿”，并把导轨上半段（0.56→0.69 m）重新定义为“动态跟随 + 站立防跌高护垫”。这能立刻堵住答辩中最致命的三个逻辑死穴。
