xiaweiyi0423/me5412-bedexit-proposal/page/v13/audit/gemini_F_qa.md

<!-- model: gemini-4-argon; finishReason: STOP; usage: {"promptTokenCount": 78000, "candidatesTokenCount": 4634, "totalTokenCount": 82634, "promptTokensDetails": [{"modality": "TEXT", "tokenCount": 54169}, {"modality": "IMAGE", "tokenCount": 23831}], "candidatesTokensDetails": [{"modality": "TEXT", "tokenCount": 4634}]} -->

作为答辩现场最懂行也最挑剔的提问者，我仔细核对了你们的第 13 版网页源码、生物力学 LP 模型（`seat_support.py`）和状态机仿真代码（`controller_v13.py`）。

第 13 版为了补上第 12 版的漏洞（特别是起步发力计算、传感器自检误锁、回床流程），做了大量扎实的工作。但恰恰是**你们新写的代码和新加的规则，暴露出了几个更深层的物理和逻辑破绽**。如果在答辩现场被我抓住以下几点追问，你们很难圆场。

以下按致命程度从高到低排序：

---

### 1. 【严重度：高】回床坐高板（Step 9）和往后挪回床面（Step 11）形成了一个无法调和的物理死结
* **位置**：网页 `#night` 第 9 步、第 11 步（截图 `step_09.png`、`step_11.png`），以及 `#risk` 第 7 条。
* **证据**：
  * 第 9 步原文：“座板只有 14 cm 深；坐得太靠后会越过后缘，滑向低 0.2 m 的床垫。座板后缘要不要加软挡边，待定。”
  * 第 11 步原文：“手推横杆，身体往后挪回床垫，把腿收上床。”
* **为什么会被问住（确定的物理矛盾）**：
  * **刁钻提问**：“夜里老人迷迷糊糊回来，背对着一个只有 14 cm 深（比手掌还窄）、后面是 20 cm 悬崖的高台往下坐，怎么防他一屁股坐空跌进床垫？你们说‘加软挡边待定’——如果加了挡边把屁股兜住，降到 0.42 m 时（第 11 步），这个挡边就会卡在屁股和床垫之间，老人怎么往后平移滑回床上？如果不加挡边，怎么防高处滑落？”
  * **因果分析**：14 cm 的座深，人坐上去时坐骨结节离后缘只有几厘米。在高处（0.62 m）需要**阻挡**向后滑；而在低处（0.42 m）需要**顺畅**向后滑。固定形状的软挡边同时违背这两个要求中的一个。
* **怎么改 / 怎么回答**：
  * **改回床流程（最稳妥）**：不要让老人盲坐在 0.62 m 的悬崖边上！既然第 13 版已经有 `EMPTY_MOVE`（空座按住“降”以 1.5 cm/s 移动），回床流程可以改成（或作为主推选项）：老人回来扶住横杆，先按“降”把空座板降回 0.42 m（或 0.50 m 的安全高度），此时后面有床垫兜底，不存在跌落悬崖的风险，坐稳后再挪回床上。
  * **如果坚持坐高处**：机构上必须给出方案，比如“后缘软挡边在座板降到底部时，被床沿压平（弹性变形）”，并在 CAD 里画出来。

---

### 2. 【严重度：高】生物力学模型（`seat_support.py`）漏掉了座板摩擦力，起步省力的结论建立在“光滑冰面”假设上
* **位置**：`model/calc_v13/seat_support.py` 的 `lp_rows` 函数；网页 `#why`“模型的简化与局限”第 2 条。
* **证据**：
  * 代码 `seat_support.py` 第 37–59 行：变量是 `x = [Fx, Fz, Fs, t]`，其中 `Fs` 是纯竖直向上的座板托力。脚底约束为：`A.append([1, cfg.mu, cfg.mu, 0]); b.append(cfg.mu * W)`（即 $|F_x| \le \mu (W - F_z - F_s)$），但**座板处没有任何水平力**。
* **为什么会被问住（确定的建模错误）**：
  * **刁钻提问**：“我看你们的 `seat_support.py` 代码，你把座板支撑力 $F_s$ 设成了纯竖直力，水平分力是 0。这等于假设老人坐在一块涂满润滑油的铁板上！但你们在风险表第 12 条明明写着要用‘防滑座面’。如果座面防滑，当老人双手用力拉横杆（产生向后的水平力 $F_x$）时，是什么力在平衡这个水平力？如果座板分担了水平切向力，髋关节和膝关节的力矩方程全都会变，你们算出来的起步 effort = 0.155 还作数吗？”
  * **因果分析**：在现行代码里，手拉横杆的全部水平力 $F_x$ 都被迫由脚底摩擦力承担，这既限制了脚底力（尤其是座板还托着 0.5 BW 时，脚底正压力最多只剩 0.5 BW），又漏掉了座板对骨盆底部的水平力矩（座板表面在髋关节下方 `hip_above_seat = 0.09 m` 处，水平摩擦力会对髋关节产生 $0.09 \times F_{sx}$ 的力矩！）。
* **怎么改 / 怎么回答**：
  * **最快补救**：在 `seat_support.py` 中给座板加上水平摩擦力变量 $F_{sx}$（满足 $|F_{sx}| \le \mu_{seat} F_s$，作用点高度为座面高度 `cfg.bed_h`），重跑一次。因为多了一个自由度，LP 算出来的 effort 只会**更低或持平**，不会推翻结论，但能彻底堵住懂行评委的嘴。如果来不及改代码，必须在“模型局限”里明确写出：“忽略了座板切向摩擦力（保守假设：全部水平拉力由地面摩擦平衡）”。

---

### 3. 【严重度：高】传感器力之和自检（Sum Check）把横杆的“三维总力”当“竖直分力”加，实际一用就会误锁
* **位置**：`model/calc_v13/controller_v13.py` 第 52 行；网页 `#control` 和 `#changes` 第 1 条。
* **证据**：
  * `controller_v13.py` 第 52 行：`total = z["F_seat"] + z["F_feet"] + max(0.0, z["F_bar"])`，随后判断 `abs(total - P.BW) / P.BW > 0.15`。
  * 仿真脚本第 144 行：硬编码了 `F_bar = 60.0; F_feet = (BW - F_seat - F_bar - mat * BW)`。
* **为什么会被问住（确定的物理/控制漏洞）**：
  * **刁钻提问**：“你们为了修复 v12 的误锁，把自检改成了在抬升中检查 $F_{seat} + F_{feet} + F_{bar} \approx BW$。但在你们自己的生物力学模型里，老人并不是竖直往下压横杆的，而是**往后拉**横杆来帮身体前倾！如果老人双手用 25% 体重的力水平往后拉横杆（$F_x = 0.25 BW, F_z \approx 0$），此时竖直方向上 $F_{seat} + F_{feet} = 1.0 BW$。如果你们的 `F_bar` 测的是握把总力或单轴拉压力，加起来就是 $1.25 BW$，偏差 25% > 15%，0.5 秒后机器直接死锁！请问你们横杆上的传感器到底测哪个方向？如果是竖直方向，当老人向上拉横杆（$F_z < 0$）导致脚底压力变大（$F_{feet} > BW$）时，你们代码里写的 `max(0.0, z["F_bar"])` 把负号截断成 0，总和也会超过 1.15 BW 而误锁！”
  * **因果分析**：牛顿定律只在**同一方向（竖直 $z$ 轴）**上满足 $\sum F_z = BW$。控制器代码里的 `max(0.0, F_bar)` 是个明显的逻辑 bug：人往上提拉横杆时，人对横杆的竖直力向上（为负），反作用力把人往下压，导致 $F_{seat} + F_{feet} = BW + |F_{bar,z}|$。此时若把 $F_{bar}$ 截断为 0，算出来的 `total` 就会平白多出 $|F_{bar,z}|$！而在仿真里之所以没暴露，是因为你们在仿真脚本里用 `F_feet = BW - F_seat - F_bar` 作弊凑出了恒等式。
* **怎么改**：
  * 修改 `controller_v13.py` 第 52 行：去掉 `max(0.0, ...)`，直接写代数值求和 `total = z["F_seat"] + z["F_feet"] + z["F_bar_z"]`，并在网页文字中明确说明：“座板、踏板、横杆测的都是**竖直方向分力（Z轴）**的代数和（下压为正，上提为负）”。

---

### 4. 【严重度：中】传感器卡死（`stuck` 场景）锁定在 0.51 m 半空后，“按住降慢降”的恢复机制无法应对“读数卡低”的故障
* **位置**：`model/calc_v13/controller_v13.py` 第 88、107 行；网页 `#sims` 的“踏板传感器卡在高读数”图（截图 `05_sims.png` 左下角）。
* **证据**：
  * 截图 `05_sims.png` 中，“踏板传感器卡在高读数”最终停在 `锁定 · 座面 0.51 m`（斜纹红条到底），没有降回床面。而旁边的“不同步”和“断电”都降回了 0.42 m。
  * 代码第 107 行：`elif s == "LOCKED": if z["down"] and z["power"]: v_cmd = -P.v_down * 0.5`。
* **为什么会被问住（设计不一致与故障耦合）**：
  * **刁钻提问**：“第一，你们第 5 节大标题写着‘12 个场景，最后都落到安全状态’，为什么唯独‘传感器卡住’这一个场景，老人最后被锁在 0.51 m 的半空中下不来，别的故障却都降回 0.42 m 了？第二，你们规定‘有人坐着才降’是为了防夹人，可是进入 `LOCKED` 状态恰恰是因为**传感器坏了、不可信了**！如果故障是座板传感器断线（读数卡在 0），进 `LOCKED` 后你们还允不允许他按‘降’？你们代码第 107 行在 `LOCKED` 状态下根本没检查 `occupied` 就直接降了——这岂不是意味着只要机器一报错锁定，你们引以为傲的‘空座防夹保护’就失效了？”
* **怎么改**：
  * **仿真脚本**：在 `SCEN` 的 `stuck` 场景里加上 `down_from=14.0`（和 `sync` 一样），让图上展示出锁定后老人按住“降”安全回到 0.42 m 的完整过程。
  * **控制规则解释**：明确在 `LOCKED` 状态下，因为称重传感器已不可信，不能再依赖 `occupied` 判断；此时退化为**纯死人开关（Dead-man's switch）模式**，必须持续按住“降”且速度减半（1 cm/s），结合座板下方的物理触感安全边（Bumper switch，风险表第 9 条已提）来防夹。

---

### 5. 【严重度：中】“站不起来的人（effort 0.20）”在仿真中升到了 0.623 m 却站不起来，暴露了开环估算速度的缺陷
* **位置**：`model/calc_v13/controller_v13.py` 的 `tooweak` 场景；计算结果 JSON；截图 `05_sims.png` 第 2 行第 1 图。
* **证据**：
  * JSON 结果：`{"key": "tooweak", "name": "站不起来的人（0.20）", "max_height": 0.623, "events": [..., ["STOPPED", "松手或条件不满足：停住并制动"]]}`。
* **为什么会被问住（模型与控制规则的边界矛盾）**：
  * **刁钻提问**：“看 `tooweak` 这张仿真图：一个能力只有 0.20 的老人，根本不在你们的目标人群（0.23–0.29）里，连从 0.66 m 都站不起来。可是按照你们的推力上限（0.5 BW），他在 0.42 m 时能把座板力卸到 0.425 BW（小于 0.5），于是机器一路把他升到了 0.623 m，然后他在高处力竭坐回去了！这说明你们的‘自适应速度规则’在起步时**根本区分不出这个人到底能不能在 0.66 m 站起来**，反而把一个站不起来的虚弱老人举到了危险的 0.62 m 高空！你们在网页上还写‘控制器会在到顶后停住’（`#why` 的 `whoText`），可图上明明没到顶（0.66 m）而在 0.623 m 就停了，为什么图文不符？”
  * **因果分析**：
    1. **图文不符（事实错误）**：网页 `#why` 的脚本写着 `控制器会在到顶后停住`，但在 `controller_v13.py` 的 `tooweak` 场景中，座板升得太慢（因为 $F_{seat}$ 接近 0.5），到 $t = 24\text{ s}$ 时脚本触发了 `sitback=24.0`（人为设定的力竭坐回），此时高度才到 0.623 m，根本没触发 `t_top`（到顶停住）！
    2. **机制缺陷**：在 0.42 m 能卸掉 0.5 BW（只需 effort 0.155），不代表在 0.66 m 能卸掉 1.0 BW（需要 effort 0.233）。
* **怎么改**：
  * **改代码或文案使其一致**：要么在 `tooweak` 场景把 `sitback` 推迟到 30 s 以后，或者把该用户的推力上限调高，让他真的升到 0.66 m 触发 `到顶仍未离座：停住`，和网页文案对上；要么改网页文案，实话实说：“即使不在目标人群里的人误用了设备，当他在半途力竭无法继续卸力时，速度会自动归零并停住，按‘降’即可安全退回床面”。

---

### 6. 【严重度：中】网页有两处明显的图文遮挡 Bug，会直接在 consultation 时影响专业度
* **位置**：截图 `03_why.png`、截图 `04_control.png`、截图 `step_06.png`~`step_08.png`。
* **证据**：
  * 截图 `03_why.png` 顶部：标题“为什么要升到 0.66 m，谁真正受益”的下半截被 sticky 导航栏 `nav.top` 死死挡住。
  * 截图 `04_control.png` 上部：三条核心规则（“握紧才升，松手即停”等三个 `h3` 标题）被 sticky 导航栏完全盖住，只露出下面的正文。
  * 截图 `step_06.png`、`step_07.png`、`step_08.png` 右下角俯视图：橙色虚线路径直接穿过了“开口一侧 ↓”的文字，糊在一起。
* **为什么是问题**：
  * 这是全页截图时 `nav.top`（`position: sticky`）在滚动拼接或锚点跳转时的 CSS `scroll-margin-top` / 截图脚本问题，以及 SVG 文字坐标硬编码冲突。10/27 拿这个网页跟老师做 consultation，如果翻页跳转时标题被导航栏遮住，观感很差。
* **怎么改**：
  * 检查 `section { scroll-margin-top: 60px }` 是否足够（建议改到 `80px`），并在俯视图 SVG（`drawTop` 函数）中把 `开口一侧 ↓` 的 `y` 坐标往左或往下挪开，避开虚线箭头路径。

---

### 7. 【严重度：低】“偏瘫用户左右换装”与“双手握横杆、至少一只手按开关”的人机矛盾
* **位置**：网页 `#changes` 审计表第 5 条、参数表最后一行（“扶手侧：左右可换装，按偏瘫用户的健侧安装”）。
* **证据**：
  * 网页多处写“双手握住横杆上的握把”、“手拉横杆借力往前挪 25–30 cm”；同时又声称支持“偏瘫用户”。
* **为什么会被问住**：
  * **刁钻提问**：“你们说扶手可以按偏瘫老人的健侧换装。但偏瘫老人只有一只好手、一条好腿！第一，他只有一只手拉横杆，怎么完成你们最难的第 2 步（在床沿往前挪 25–30 cm）而不往患侧歪倒？第二，你们的 2D 模型（`P1 cap25` 和 `P2 arm x0.5`）代码里写的都是 `2 * sub.sh_flex`（双手对称发力），单手发力时不仅力量减半，还会产生巨大的冠状面扭转力矩，你们算过单手工况吗？”
* **怎么改**：
  * 不要为了显得面面俱到而给自己挖坑！在“目标人群”和参数表里，把“偏瘫用户”改成**“按卧室布局（床靠哪面墙）或用户习惯侧左右换装”**，并明确将“单侧肢体严重瘫痪（偏瘫无法双侧承重）者”列入不适用范围，或者说明 `P2 arm x0.5`（手臂力量折半）在数值上等效于单手发力（但忽略了三维扭矩）。

---

### 总体判断与最值得先做的一件事

* **总体判断**：第 13 版在逻辑闭环和工程细节上已经远超普通本科/研究生课程项目的水平，状态机对边界工况（压床垫、迈步离开）的修复非常漂亮。目前最大的软肋不在于“没做够”，而在于**为了补洞而新加的设定（14 cm 高处盲坐回床、纯竖直力的座板模型、截断负号的力之和自检）引入了新的物理矛盾**。
* **最值得先做的一件事（在 10/27 找老师之前）**：**立刻修改 `controller_v13.py` 里的 `total` 计算公式（去掉 `max(0.0, F_bar)`，改为竖直分力代数和）并调整回床话术（允许先按“降”把空座板降下来再坐，作为高处盲坐的保底替代）**。这两处只要改几行字和一行代码，就能直接拆掉答辩时最致命的两个炸弹。
