xiaweiyi0423/me5412-bedexit-proposal/(commit log)

2026-10-22 ME5412 bed-exit proposal: page, model scripts and prior-art notes (v11)
    Claude-Session: https://claude.ai/code/session_01Jwd4txHiyqShBu1GicGYud
2026-10-23 Add division-of-labour page; sync proposal page v11.2
    - plan/: group plan page (purpose per role, suggested methods, sources,
    figures) and the script that generates its figures
    - page/: v11.1-v11.2 changes (Cochrane note, tipping row in FMEA,
    RQ3/RQ4 without self-tests, timeline moved to plan page);
    build_v11.py uses relative paths again
    - README: plan folder, scope (no prototype or experiments), open
    lateral-tipping issue
    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
2026-10-26 Design v12: vertical lift, bed anchoring, revised control rules
    After the lecturer's reply and the fifth audit:
    - Seat lifts vertically; forward tilt dropped (a single-actuator linkage
    cannot hold height while returning level; the model never credited tilt)
    - Station anchored to the bed; stability framed as combined COG vs base;
    load cases at safety factor 1.5
    - Control: stop on release or fault, lower only when occupied, speed
    follows seat unloading (force cap and adaptive speed in one rule),
    grip switch, 4 load cells per plate, sensor-sum plausibility check
    - model/heel_sensitivity_v12: station re-run with the beds' heel
    clearance; headline now 13-20% vs raised bed, 26-40% vs low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
2026-10-26 Add calc_v12: lift sizing, stability and controller simulation baselines
    - lift_sizing: space under the seat, actuator force/stroke for scissor
    (horizontal / inclined actuator) vs inline actuator or column
    - stability: combined COG per posture, pull cases, anchor hold-down force
    for safety factor 1.5
    - controller_sim: state machine + admittance speed law over 8 scenarios,
    auto-generated state diagram (graphviz)
    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
2026-10-26 Plan page: meeting prep, handoff table, calc baselines, precedents
    - Agenda for the group meeting before the consultation, questions for
    the lecturer, suggested 13-slide main deck
    - Handoff table with default values so no role has to wait
    - calc_v12/lift_sizing: add twin three-stage lifting columns (TiMOTION
    TL8), which fit under the seat without force amplification
    - docs: similar projects, citable load standards, parts and tools
    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
2026-10-26 Slides: reframe 'why not raise the bed' as a comparison of four ways to rise
    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
2026-10-26 Design v13: start-effort model, controller fixes, return-to-bed, new proposal page
    - model/calc_v13/seat_support.py: sit-to-stand LP with a capped seat force.
    Starting the lift at 0.42 m with a 0.5 BW cap costs effort 0.155-0.166,
    below seat-off at 0.66 m (0.233-0.251); a 0.3 BW cap makes the start the
    bottleneck, so the cap range is narrowed to 0.4-0.6. Reproduces v12 seat-off
    values when the seat force is zero.
    - model/calc_v13/controller_v13.py: sensor-sum check only while moving above
    flush; no empty reset (seat waits for the return to bed); 20 s idle lowering
    with a chime; column sync lock; top speed 3 cm/s; "user left" needs seat
    < 5 % BW and feet off. User model driven b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
2026-10-26 Design 13.1: act on the Gemini audit of v13
    - seat_support.py: start effort with a forced forward lean (10/20/30 deg) and with a
    0.1 BW speed margin; the low start effort needs a near-upright trunk, and a 0.4 cap
    is too low once a speed margin is kept, so the cap range becomes 0.5-0.6.
    - controller_v13.py: signed vertical bar force in the sensor sum, occupancy hysteresis,
    hold-to-run lowering with a COP check, hard lock on column desync, return to bed by
    lowering the empty seat first (with a personal return height), 15 scenarios.
    - page: device overview, corrected handholds and step texts, revised rules/settings/
    risks, and a 13.1 section in the revision record listing accepted and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
2026-10-26 Seat trajectory: user-seat relative motion in the sagittal plane, 1-DOF vs follow
    Adds stage-by-stage sagittal sketches and a 27-user comparison of forward slip,
    sit-back margin and contact length for the vertical lift, fitted 1-DOF curves and
    real-time follow; summary in seat_trajectory_summary.md.
    Claude-Session: https://claude.ai/code/session_0189MFebuQQaozftdhaMXEmZ
2026-10-26 One-DOF seat design: user postures -> assist point -> seat curve -> two-track guide, with page
    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
2026-10-26 One-DOF seat v3: linkage placement study and pivoted linear actuator
    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
2026-10-26 One-DOF seat v4: bed-safe four-bar, support frame, 2-D interference check and 3-D layout views
    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
2026-10-26 Seat audit follow-up: tilt along the path, released-actuator sink, passive tilt latch and tilt-cap checks
    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
2026-10-26 Seat v5: tilt cap 15 deg, fixed handrail pole; four-bar layouts (mid, sides) and inclined rail + tilt link alternative
    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
2026-10-26 Seat v5: finalise one-side inclined rail + tilt link; structure/safety checks; cushion rerun; page data
    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
2026-10-26 Seat v5 page: one-side inclined rail + tilt link, layout/pinch/tipping/emergency checks, thigh-cushion contact patch per frame, v5 revision section
    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
2026-10-26 Seat v5.1: zoned cushion study (rear firm / front soft), distributed-load effort, rail extended 3 cm, cushion toggle and zoned section on the page
    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
2026-10-27 Seat v5.2 (in progress): slider re-synthesised to 0.69 m without back tilt, L-handrail study, cushion fixes and consistency check, housing/twin-rail/ball-screw checks, page and slide generators
    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
2026-10-27 Seat v5.2: round-2 audit fixes - re-synthesised rail (0.69 m, no back tilt), fixed L-handrail with one grip, cushion-consistent 81-user check, fair vertical baseline, closed housing with twin rails, 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
2026-10-27 Same-footing bed baseline; deck comparison/verify/conclusion use it; figure state labels
    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
2026-10-27 Add one-side four-bar kill test script (vs inclined rail)
    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
2026-10-27 5.3: one-side four-bar kill test (rail kept), page section 13, deck mechanism/whynot updates, guide Q&A
    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
2026-10-27 Talk guide: v5.3 numbers, four-bar and twin-rail Q&A, same-footing bed comparison
    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
2026-10-27 PPT audit v2 fixes: control/safety rules, emergency 3 cm/s with motor drag, top view, new state machine, release heights, honest comparison framing
    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
2026-10-27 Mechanism slide: labelled 3-D view; guide Q&A on the rail's role and the belt
    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
2026-10-27 Fix rise paths cut at two thirds (solve_s); re-run checks; three fall modes; deck audit round 3
    solve_s gave up whenever a 45 deg shank tilt had no pose, which is always true
    near standing, so every seat-side rise path stopped at about two thirds of the
    rise. The mechanism and bar position are kept (design curve frozen); all user
    checks, the fall-catch comparison (now with a knee-buckle mode), the controller
    simulation and the four-bar comparison are re-run on full paths. Slides, talk
    guide and the seat page (new section 15) carry the corrected numbers and the
    verified round-3 audit fixes; report in presentation/audit/v3/audit_report.md.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
2026-10-27 Animation: person sinks ~3 cm into the cushion at rest; seat and person rise together at lift start
    The seat top is flush with the mattress at rest; the old drawing kept the hip on
    the rigid-seat path, so the board appeared to jump 3 cm when lifting began.
    Talk guide gains Q&A on cushion vs bed height and the start of the lift.
    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
2026-10-27 Open audit round 4: joint-by-joint 3-D statics, controller interlocks, lever position; CAD dimension sheet
    - seat_1dof_cantilever3d.py: the seat's roll moment must pass through pin 1, so pin 1
    needs a moment-carrying bearing (crossed roller, or two bearings ~14 cm apart); link
    with rod ends; carriage loads incl. in-plane forces; load directions incl. vertical
    and along-seat; screw 2.0 kN, brake >= 6.3 N m
    - controller: shed load must reach the feet before the seat speeds up (was only in the
    text); graded sum check (15-35 % slow + voice, > 35 % lock), friction-aware tolerance;
    new lean-back scenario; 16 scenarios safe
    - emergency lever under the bar-post corner, reachable when seate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
    [key_poses.csv, travel_table.csv]
2026-10-27 Parts, materials and FEA focus for CAD; c1 as tapered roller pair; mechanism page with 3D, diagrams and Q&A
    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
2026-10-27 WIP: fixed-structure CAD parts (housing, base, handrail)
    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
2026-10-27 CAD model (CadQuery): 40 parts, STEP, drawings, mesh; integration fixes (drive stack, c1 bearings, B bracket); page gallery and owner-quota Q&A route
    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
    [B1.step, B1a.step, B2.step, B2b.step, B4.step, B5.step, B7.step, BED.step]
2026-10-27 Deck v5.7: CAD visuals, cantilever page, fall-prevention pages, FEA next steps, drawings appendix; talk guide; summary 5.10
    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
2026-10-27 Concept video: storyboard, comic panels, finished clips and assembly script (work in progress)
    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
2026-10-27 Concept video v2 (57 s): comic + 2D/3D cut with narration, music and sound effects
    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
2026-10-27 Concept video: Gemini reviews of the cut and story options
    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
2026-10-27 Concept video v3 (65 s): crane-kindness story, exploded CAD parts form a crane, comic re-cut, new narration and music
    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
2026-10-28 Concept video, pulse cut (36 s): beat-synced tech version with CAD assembly, motion path, how-to steps and sensing; code-rendered frames and synthesised score
    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
2026-10-28 Pulse cut v2 (46 s): points-and-lines opening, design-process block (81 paths, design curve, hinge traces -> rail and link, five mechanisms), re-timed score
    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
2026-10-28 Pulse cut v3 (45 s): show how one seat line is drawn, 81 lines as flowing strands, design curve picked worst-first, mechanisms filtered by three conditions instead of crosses; Gemini review notes
    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
2026-10-28 Pulse cut v4 (42 s): trajectory block in product voice (seat follows the thigh, path built for 81 bodies, rail + link, five structures), no step-by-step derivation
    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
2026-10-28 Pulse cut v5 (42 s): changes from Gemini's review of the cut - straight-up vs ours instead of five panels, key labels after the assembly, 81 lines draw in, sensing labels take focus in turn
    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
2026-10-28 Pulse cut v6 (44.5 s): rain-night mood after the failed rise (the hip line breaks into rain) and an echo ending at the same window with the seat (full line, rain stops, dawn)
    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
2026-10-28 Pulse cut v7 (47.5 s): hand-drawn in-the-room shot - lines gather into the bed, the camera follows a line up the rail to the switch and the seat fills in from line art
    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
2026-10-28 Pulse cut v8 (49 s): rise shot goes 2.5D to 2D, ending pulls out into the 3D room with sun through the window
    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
2026-10-28 Pulse cut v9 (49 s): ending keeps only the seat - no 3D person or bed - turning in a dopamine colour field with a ring per beat
    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
2026-10-28 Pulse cut v10 (44 s): motion and how-to merged into one four-step shot (2.5D to 2D); fixes from the director-style review - calmer palette at the end, grey problem panels, whole-rise sensing title, b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
2026-10-28 Pulse cut v10.1: the in-room ghost now gets out of bed (lying, turn, legs down over the open foot side, onto the seat); arrow and caption follow
    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
2026-10-28 Pulse video v11 (46 s): bilingual subtitles, three key numbers, hinge markers, fixes from second critique
    - English sublines under Chinese captions; numbers: 81 bodies (1.50-1.75 m), path error <= 8 mm, live seat tilt
    - Structure shot marks 3 hinges + 1 slider = 1 DoF; twin rails + ball screw take the offset load
    - Fix hip tube showing through the seat, head geometry near the handrail, sensing label overlap
    - Longer 81-bodies hold and sensing section; music_v11.py extends the score to 46 s
    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
2026-10-28 Pulse video v12: fewer captions, mention older adults, one continuous shot into step 01
    - English only under each shot's headline; drop repeated sublines and the brake label
    - Opening and ending name the older user; 'every rise is a line' removed (the line stays visual)
    - Bed-side shot ends with the figure on the bed edge at the step-01 camera; dark grid fades in, so the cut is seamless
    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
2026-10-28 Pulse video v13: continuous transition from sensing into the rainy-room echo
    - Sensing figure sits holding the bar (the echo's opening pose); summary moves to the right
    - Last 0.7 s: camera eases to the echo framing, a point draws the window, rain fills it, figure turns solid
    - Music: groove thins and rain leads in 0.5 s before the cut
    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
2026-10-28 Pulse video: sensing title now '起身之前，四处确认' to match the seated, ready-to-rise figure
    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
2026-10-28 Deck v6, 15-minute version: film after the cover, merged pages, pictograms, shorter notes
    - New film slide (46 s, plays on click with sound); motion and sensing pages loop clips from it
    - problem + users, sensing + speed and mechanism + cantilever merged; concept, cantilever, speed,
    fall_exit and nextsteps moved to the appendix
    - Prior-art and comparison pages get side-view pictograms; the comparison page leads with
    'effort is on par with a raised bed; the difference is whether the seat is still under you when the legs give way'
    - Speaker notes cut by about a third (about 15 min by the guide's estimate); state machine note separates
    the release stop from the sensor self-check lock
    - Ta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
2026-11-01 Deck: frame the dark video clips as player windows; shared local slide renderer
    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
2026-11-01 WIP: deck v7 stability top view with support polygon; housing label 0.89 m from parts.json
    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
2026-11-01 Deck v7 (zh): support-zone comparison, load-path figure, top-view stability with support polygon, risk anatomy, limits roadmap, current-design team figure, framed clips; published
    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
2026-11-01 English final deck published; PPTX with embedded English film and clips; English film (lang switch in pulse.js, rebuilt data.js inputs, vendored inputs untracked)
    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
2026-11-01 English deck: audit fixes (renumbered risk figure, team badges, step-1 on bed edge, clips without built-in titles, formula, conflict callout, pronouns, team before conclusion)
    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
2026-11-01 Teammate's part-5 slides: corrected rated load (100 kg), catch wording, stability caveat for mobile base, bounded floating seat, latched flip bar; concept figure redrawn in deck style
    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
